everettpenne/WHAM-CONTROLLERS/firmware/hbridge/docs/command_reference.md

# WHAM-HBRIDGE-PFMG474 — Serial Command Reference

USART2, **115200 8N1** (raised from 9600 on 2026-09-04 — see `docs/changelog.txt`; WHAM-HBRIDGE-PFMG474-only, the sibling PFM-STM32G474 project still uses 9600). Commands are terminated by `\r`, `\n`, or `\r\n`.

## Protocol conventions

Replies (`OK` / `OK <values>` / `ERR <n> <msg>`), the error codes, mnemonic matching (short and long forms, `?`
queries) and the strict argument rules are common to both controllers and are described once, in
[`docs/scpi_conventions.md`](scpi_conventions.md). Codes are never renumbered or reused. Each command's own
section below says which errors it can return and how many decimals its numbers have.

### Unsolicited `!BOOT` banner (every boot)

Added 2026-09-29 (ported from WHAM-XREX-PFMG474). Sent once per boot,
after all initialization and right before the main loop — the exact
signal that a reset (including `FWUPdate:SWAP`/`ROLLback`) has completed
and the command link is live. `!BOOT` never collides with a reply
(`OK`/`ERR`). Three lines:

```
!BOOT WHAM-HBRIDGE-PFMG474 v0.7 2c272540 BANK=1 BFB2=0 STATE=IDLE tick=0
!BOOT diag boot=1 prev: stage=0 fault=0@0 cfsr=00000000 hfsr=00000000 err=0@0 nmi=0@0 eccr=00000000 rst=
!BOOT Rise and shine, controller's awake and ready to work 🌞
```

- Line 1: board, firmware version, git commit (`-dirty` if built from an
  uncommitted tree), the running flash bank, the `BFB2` option bit, the
  operating state (`IDLE`, or `FAULT` if a fault was already present at
  boot), and
  `HAL_GetTick()` at that point.
- Line 2 (`src/drivers/boot_diag.h`, `.noinit` RAM — survives every reset
  but not a power cycle): `boot` counts boots that reached `main()`
  since power-up. Everything after `prev:` describes the PREVIOUS boot:
  the last stage it reached (`1` main, `2` HAL init, `3` clock, `4`
  GPIO, `5` HRTIM, `6` USART2, `7` app init, `8` main loop, `9` about to
  reload option bytes for a swap), and whether it ended in
  `HardFault_Handler` (`fault=count@stage`, with `CFSR`/`HFSR`),
  `Error_Handler` (`err=`) or `NMI_Handler` (`nmi=`, with `FLASH->ECCR`
  — a flash ECC double error raises an NMI). `rst=` lists the reset
  sources since the previous boot (`OBL` option-byte reload, `PIN`
  NRST, `BOR` brown-out/power-on, `SFT` software, `IWDG`/`WWDG`,
  `LPWR`); a normal `FWUPdate:SWAP` reports `OBL,PIN,`.
- Line 3: a friendly greeting. The emoji is sent as raw UTF-8 bytes.

The first line can arrive with a garbage byte in front of it: the reset
itself glitches the TX line. `python/fw_update.py` allows for this.

## Mnemonic syntax

See [`docs/scpi_conventions.md`](scpi_conventions.md) ("Mnemonic matching"); the parser itself is
`src/middleware/scpi/scpi_parser.c`.

## Commands

### `*IDN?`

Board and firmware identification.

```
> *IDN?
< OK WHAM-HBRIDGE-PFMG474 REVA v0.7 2c272540
  (or, built from an uncommitted working tree:)
< OK WHAM-HBRIDGE-PFMG474 REVA v0.7 2c272540-dirty
```

Since 2026-10-07 the reply ends with two more fields that say which
PHYSICAL board answered: `SN=<serial>` (`SN=UNSET` until a serial is
provisioned) and `UID=<24 hex>` (the MCU's factory-programmed 96-bit unique
ID, different on every board). Hosts that read the earlier fields by
position are unaffected. The same two fields end the `!BOOT` banner. Full
identity: `SYS:ID?` below; design: `docs/device_identity_and_host_service.md`
at the top of the repository.

```
< OK WHAM-HBRIDGE-PFMG474 REVA v0.9 ad9a18ba-dirty SN=UNSET UID=0055002B4232500220343558
```

Reports, space-separated: `HW_BOARD_NAME`, `HW_BOARD_REV`,
`FW_VERSION_STRING` (compile-time constants, `src/config/ctrlr_config.h`),
then `FW_GIT_COMMIT` (added 2026-09-29, ported from WHAM-XREX-PFMG474) —
the short git commit hash this exact build was made from, with a `-dirty`
suffix if the working tree had uncommitted changes, or `unknown` if
`build/generated/git_version.h` was never generated. This answers "which
commit is actually running on this board" independently of what you think
you last flashed. Before 2026-09-29 the reply had only the first three
fields.

`HW_BOARD_REV` is currently a placeholder (`REVA`); update it to match
the actual PCB silkscreen revision.

**Build with `python3 python/wham_build.py`** (not a bare `make`) to get
an accurate `FW_GIT_COMMIT`: it regenerates `build/generated/git_version.h`
first. `git_version.h` is gitignored, so a fresh checkout has none until
`wham_build.py` (or `gen_git_version.py`) runs once.

### `SYS:ID?`

Which physical board this is, as `key=value` fields on one line (added
2026-10-07, identical in both products).

```
> SYS:ID?
< OK serial=WB-0001-8 uid=0055002B4232500220343558 flashuid=E4653C34CB172E22 product=WHAM-HBRIDGE-PFMG474 hw=REVA fw=v0.9 commit=e34e12ad label=bench.sim verified=1 identity=ok
```

- `serial`: the board's serial number; `UNSET` until one is provisioned (`SYS:SERial`).
- `uid`: the MCU's factory unique ID (24 hex). `flashuid`: the W25Q128's factory unique ID (16 hex), read once and kept;
  `0000000000000000` if the chip did not answer. Both are read-only and need no provisioning.
- `product`, `hw`, `fw`, `commit`: the same values as `*IDN?`.
- `label`: the optional label (`-` = none). `verified`: 1 when the stored serial was written for THIS MCU and THIS flash
  chip; 0 for a board with no serial, or one whose flash chip was moved from another board or whose image was copied.
- `identity`: `unset` (nothing provisioned), `ok`, `corrupt` (something stored, no copy passes its checks: provision
  again), `nochip` (the flash chip did not answer).
- Parse by key, not by position: new keys will be added at the end.
- Reported only; nothing in the controller depends on it.

### `SYS:SERial <sn>` / `SYS:SERial?`

Writes the board's serial number ONCE into the identity region of the external flash and binds it to this MCU and
this flash chip; the query returns it (`OK UNSET` before). `<sn>` is 3-16 characters of `A-Z 0-9 -`, whole token.
Normally done by `host/provision_board.py` (see the repository's `docs/device_identity_and_host_service.md`), which
picks `WB-NNNN-C` serials with a check digit and keeps the registry; the firmware checks only the format.

| Reply | When |
|---|---|
| `OK` | written and read back |
| `ERR 12 serial must be 3-16 characters ...` / `... needs one argument` | bad format, missing or extra argument |
| `ERR 13 identity can be changed only while IDLE` | the write stalls the command link for tens of ms, as `*SAV` does |
| `ERR 19 a serial is already provisioned (SYS:ID:CLEar CONFIRM first)` | one exists: it is never overwritten |
| `ERR 7 ...` | the flash write failed or the chip's unique ID could not be read (the previous record is intact) |

The record is two alternating copies in two reserved sectors (`0xFFD000`, `0xFFE000`), each CRC-protected: a power
cut during a write leaves the previous record. Firmware updates, `*SAV`/`*RCL`, `CONFig:PROFile:CLEar` and
`QSPI:SELFtest` never touch it, and the flash driver refuses any other write to those sectors.

### `SYS:LABel <text>` / `SYS:LABel?`

An optional label, 1-32 characters of `A-Z a-z 0-9 . _ -` (no spaces, so `SYS:ID?` stays parseable); `-` clears it.
Needs a serial first (`ERR 19` otherwise); IDLE only (`ERR 13`). The query returns the label or `-`.

### `SYS:ID:CLEar CONFIRM`

Erases the stored identity (both copies): the board is `UNSET` again and can be provisioned. The word `CONFIRM` is
required (`ERR 12` without it); IDLE only. The registry keeps the board's serial, so provisioning it again with
`host/provision_board.py` restores the same one.

### `BOOT`

Resets the MCU into the STM32 ROM serial bootloader (System memory), so
a new `.bin` can be written over the same USART2 link with no physical
BOOT0/NRST access. See `docs/serial_reflash_guide.md` for the full
mechanism and usage via `python/wham_serial_flash.py`.

```
> BOOT
< OK ENTERING BOOTLOADER
  (link drops — MCU has reset into the ROM bootloader)
```

Present only when `BOOT_JUMP_FEATURE_ENABLED` (`Core/Inc/boot_jump.h`)
is nonzero (the default). When disabled, `BOOT` is simply unrecognized
(`ERR 1 Unknown command`), like any other unknown mnemonic — see that
header for exactly what disabling the module does.

Refused with `ERR 13` while `ARMED` or `FIRING` (resetting under load would
drop the outputs uncontrolled); allowed in `IDLE` and `FAULT`.

### `SHOT:BEGin`, `SHOT:STEP`, `SHOT:END`, `SHOT:CLEar`, `SHOT?`, `SHOT:POINt?`

A shot is a **time series of setpoints**. The operator uploads, for each
setpoint, a time, a carrier frequency and a duty; the firmware ramps
frequency and duty **linearly in time** between setpoints, one switching
period at a time. Open-loop shots run from about 10 ms to 1 s.

```
> CONFig:MODE HVPS
< OK
> SHOT:BEGin
< OK
> SHOT:STEP 0 20000 40          t_us  freq_hz  duty_pct  -- always t = 0 first
< OK
> SHOT:STEP 10000 15000 60      at 10 ms: 15 kHz, 60 %
< OK
> SHOT:END
< OK 2 10000                    setpoints, shot length in microseconds
> ARM
< OK
> FIRE
< OK
```

- **One duty per phase** (2026-10-13): a setpoint may give each phase its own duty,
  `SHOT:STEP <t_us> <freq_hz> <duty_U> <duty_V> <duty_W>`. The time and the carrier frequency stay shared (the
  three phases are locked to one master timer); each phase's duty ramps linearly to its own next value and is checked
  against the mode's duty limits on its own (`ERR 10 duty of phase V is above ...`). The three-value form gives every
  phase that duty, exactly as before, and a shot made only of those plays exactly as before (the same per-period
  numbers; checked by the tests). Forms can be mixed from one setpoint to the next. `SHOT:POINt? <i>` answers
  `OK <t_us> <freq_hz> <duty>` when all phases have the same duty at that setpoint, else
  `OK <t_us> <freq_hz> <duty_U> <duty_V> <duty_W>`.
- **Units on the wire:** time is an integer number of microseconds; frequency
  is in Hz with up to 3 decimals (`20000.5`); duty is in percent with up to 2
  decimals (`47.25`).
- **Rules:** the **first setpoint must be at t = 0** (the shot starts at the
  first slot's frequency and duty); times strictly increase; the last
  setpoint's time is the end of the shot and may be at most
  `SHOT_MAX_DURATION_US` (1 s); at least two setpoints are needed
  (`SHOT:END` refuses otherwise); at most `SHOT_SETPOINT_MAX` (500).
- **Limits are checked at upload, per setpoint**, against the selected supply
  mode (`CONFig:LIMits?`): `ERR 10` for a frequency or duty (of any phase) outside the mode,
  `ERR 4` for an ordering/format error or a time beyond the longest shot,
  `ERR 3` when full, `ERR 13` with no supply mode or while `FIRING`. A straight
  line between two setpoints inside the limits stays inside them; the
  generator additionally clamps every period onto the mode's exact limits
  (so a `75000 Hz` setpoint, which is not exactly representable, plays as the
  nearest legal period).
- **The shot ends at the first period that starts at or after the last
  setpoint's time** (so it overshoots by less than one period), and the last
  setpoint's own values are approached, not held.
- `SHOT:BEGin` discards the previous shot; `SHOT:CLEar` drops it; a supply
  mode change drops it. None of them work while `FIRING`.
- `SHOT?` — `OK <setpoints> <duration_us> <PROFILE|TABLE>`: the last field is
  which source `FIRE` will play (the last upload that finished). `SHOT:POINt?
  <i>` — `OK <t_us> <freq_hz> <duty_pct>` for setpoint *i* (from 0).
- **How it plays:** a generator (`shot_profile.c`) turns the setpoints into
  one `{per, cmp}` entry per period and keeps a **ring table** of
  `PFM_TABLE_SIZE` entries (100 by default) full: the whole ring is filled
  inside `FIRE` before the first period, the per-period interrupt plays it, and
  a software-triggered, lower-priority interrupt refills it as it drains. So a
  shot can be far longer than the table. If the refill ever falls behind (the
  ring runs empty before the shot is over) the shot is **stopped and latched as
  a fault** (`STATE?` → `FAULT GENERAL`, `FAULT:SOURces?` → `TABLE=1`, cleared
  by `FAULT:CLEAR`) rather than holding a stale step.
- **What the CPU can sustain** (simulator, project built at `-O2`): the refill
  gets only what the per-period interrupt leaves. With 100 entries, every shot
  tried completes: 1 s shots in both modes (up to 125,000 periods), all Limiter
  shots from 75 to 125 kHz including duty and frequency ramps, and a 50 ms
  duty triangle 5 - 95 - 5 % at 125 kHz. The one case that still empties a
  100-entry ring is a step applied every period at 125 kHz (duty 5 to 95 % in
  10 ms), which needs ~1,300 entries (a whole 10 ms shot at 125 kHz).
- **Compile-time sizes** (`ctrlr_config.h`, rebuild the `.bin` to change, with
  the measurements behind them): `SHOT_SETPOINT_MAX` (500, 12 bytes each),
  `SHOT_MAX_DURATION_US` (1 s), `PFM_TABLE_SIZE` (100, 8 bytes each).
- **`PFM:DIAG?`** (diagnostic, last shot) — `OK <periods played> <max gap cycles>
  <max gap us> <busiest interrupt cycles> <total interrupt cycles> <fewest ring entries
  ready> <refills> <entries generated> <refill wall cycles> <longest refill wall
  cycles> <ring fill cycles>`. The "fewest ready" is counted only while the generator
  is still running (4294967295 if it never was: the whole shot fit in the ring); 0
  would be an underrun. Cycles are 170 MHz CPU cycles.
- The host tool `python/pfm_shot_test.py` has an exact Python port of the
  generator (`generate_profile()`), held to the C code by both test suites.

### `TABLE:BEGIN`, `TABLE:STEP`, `TABLE:END`, `TABLE?` (bench use)

The per-period table, entered one entry at a time. Since 2026-10-01 it holds
at most `PFM_TABLE_SIZE` entries and plays once, with no refill: it is
the engine's input format kept for bench work, and `SHOT:*` above is how a
shot is normally defined. The last upload to finish (`SHOT:END` or
`TABLE:END`) is what `FIRE` plays.

Uploads a complete PFM shot profile (a sequence of `(per, cmp0, ...,
cmp(N-1))` steps, N = `HRTIM_NUM_CHANNELS` — see `Core/Inc/pfm.h`'s
`PFM_Step_t` and `Core/Inc/ctrlr_config.h`), built entirely
off-controller. This firmware has no on-device table *construction*
logic (no frequency/duty math, no sweep builder) — see `pfm.h`'s
"ADDED" header note for why that's a deliberate project decision, not
a gap waiting to be filled in here. `python/pfm_table_upload.py` is
the reference host-side builder — it queries `CONFig:CHANnels?` itself
before uploading, rather than assuming N.

```
> TABLE:BEGIN
< OK
> TABLE:STEP 1699 850 850 850
< OK
> TABLE:STEP 1699 850 850 850
< OK
  ... (repeat for every entry -- example above is N=3) ...
> TABLE:END
< OK 500
```

- **`TABLE:BEGIN`** — clears the table (`PFM_TableReset()`) and opens
  an upload session. Safe to call again mid-upload to start over.
  Needs a supply mode (`ERR 13` until `CONFig:MODE` has been sent).
- **`TABLE:STEP <per> <cmp0> ... <cmp(N-1)>`** — appends exactly one
  entry: `per` plus exactly one compare value per channel (N =
  `HRTIM_NUM_CHANNELS`, a compile-time constant — query
  `CONFig:CHANnels?` rather than assuming it). All values are
  `uint16_t` (0-65535). Each step is checked against the selected supply
  mode (see "Supply mode" below): the carrier `170 MHz / (per + 1)` and
  every channel's duty `cmp / per` must be inside the mode's range, else
  `ERR 10` with a message naming the limit. (The apply-time
  `HRTIM1_ClampCompare()` in `hrtim.c` remains a backstop.) Rejects with `ERR 2` if no
  `TABLE:BEGIN` is open, `ERR 3` if the table is already at
  `PFM_TABLE_SIZE` (5000) capacity, `ERR 4` for a malformed line
  (including the wrong token count for this board's N).
- **`TABLE:END`** — closes the upload session and reports the final
  entry count (`OK <count>`). Table stays exactly as uploaded even if
  you never send this — it just stops enforcing "must call
  `TABLE:BEGIN` first" for a stray `TABLE:STEP`.
- **`TABLE?`** — reports the current entry count at any time
  (`OK <count>`), upload session open or not.

### Supply mode: `CONFig:MODE`, `CONFig:MODE?`, `CONFig:LIMits?`

Added 2026-09-29 (`src/app/control/supply_mode.h`). The same firmware drives
two supplies, and the operator selects which with `CONFig:MODE`:

| Mode | Drive | Carrier | Duty (per channel) |
|---|---|---|---|
| `LIMITER` (`LIM`) | PWM | 75–125 kHz (`per` 1359–2265) | 5–95 % |
| `HVPS` | PFM | 10–30 kHz (`per` 5666–16999) | 40–60 % |

The values are the older PFM-STM32G474 project's bounds
(`ctrlr_config.h`). The modes only narrow the hardware envelope (16-bit
period, compare clamp, 100 ns dead time). The boundary is exact: a step
exactly on a limit is accepted, one `per` count outside is refused.

```
> CONFig:MODE?
< OK NONE
> TABLE:BEGIN
< ERR 13 No supply mode selected -- send CONFig:MODE LIMiter|HVPS first
> CONFig:MODE HVPS
< OK
> CONFig:LIMits?
< OK HVPS FREQ 10000 30000 DUTY 40 60
> TABLE:STEP 1699 850 850 850
< ERR 10 per 1699 is above the HVPS range (10000-30000 Hz)
```

- **Boot state is `NONE`**: no table can be uploaded until a mode is
  selected, so a table built for one supply is never accepted for the other
  by default. (Saved profiles will restore it in a later phase.)
- **`CONFig:MODE`** is only accepted in `IDLE` (`ERR 13` otherwise). A mode
  *change* discards the uploaded table (`TABLE?` reads 0), so a table never
  outlives the limits it was checked against; re-selecting the current mode
  changes nothing.
- **`CONFig:LIMits?`** — `OK <mode> FREQ <min> <max> DUTY <min> <max>` (Hz,
  percent), or `OK NONE`.
- Duty is compare / period, the same relation `python/pfm_table_upload.py`
  uses. `pfm_table_upload.py --mode LIMITER|HVPS` selects the mode first.
- **Verification caveat:** the HRTIM SET/RESET-collision fix was confirmed on
  a logic analyzer only up to 100 kHz. `LIMITER` allows up to 125 kHz;
  100–125 kHz has not been scoped on real hardware.

### `FIRE`

Starts playback of the shot (`SHOT:*`, or a `TABLE:*` table if that was
uploaded last) from its start. Playback advances automatically, one entry per
PWM period, driven by the HRTIM1 master-repetition interrupt
(`PFM_CycleBoundaryHandler()` in `pfm.c`), and stops on its own, at a
coherent period boundary, at the end of the shot. `ERR 5` when nothing has
been uploaded.

**A rising edge on PF15 starts the same shot** (`EXTernal:TRIGger`, below): both go through one routine, `ShotStart_Run()`, so the checks and the start
are identical (since 2026-10-20).

**Needs `ARMED`** (gated 2026-09-29; before that `FIRE` took effect
immediately in any state). `FIRE` moves the state to `FIRING`; when the
table ends the state returns to `IDLE`, so every shot needs its own `ARM`.
See "Operating state" below.

```
> ARM
< OK
> FIRE
< OK
> STATE?
< OK FIRING
  ... plays back every uploaded (per, cmp0, ..., cmp(N-1)) entry ...
> STATE?
< OK IDLE
```

Checked in this order: `ERR 6` a fault is latched, `ERR 13` not `ARMED`,
`ERR 5` the table is empty. There is no `STOP` command; a shot ends at the
end of the table, or at once on any fault (including `GENERAL:TEST:FAULT`).
The table can't be changed while `FIRING` (`TABLE:BEGIN`/`STEP` give
`ERR 13`).

### External shot trigger: `EXTernal:TRIGger`, `EXTernal:TRIGger?`, `EXTernal:TRIGger:INPut?`, `EXTernal:TRIGger:STATus?`

Added 2026-10-20 (source: `src/app/control/shot_trigger.c`, `shot_start.c`; same command names and meaning as XREX's). A **rising edge on PF15**
(`Fiber_Enable` in `docs/pin_mapping_v4.csv`) **while the controller is `ARMED`** starts the shot exactly as `FIRE` would: the same checks and the same
start (`ShotStart_Run()`, which `FIRE` now also uses), open or closed loop alike. **On at every boot** (`SHOT_TRIGGER_DEFAULT_ENABLED`, `ctrlr_config.h`);
`EXTernal:TRIGger 0` turns it off for a session. It is not stored in saved profiles.

**It is handled by interrupts, not by polling.** PF15 is a digital input with a pull-down (an unwired or floating pin reads LOW) and an interrupt on the **rising
edge only** (EXTI line 15, `board_io.c`). The edge interrupt (priority 1, the fault tier) does a few instructions: it counts the edge, ignores it unless the trigger
is enabled, the state is `ARMED` and the pin **still reads HIGH** (a glitch shorter than the interrupt latency is rejected), and pends a software interrupt (the
unused CORDIC's vector, priority 2). That one starts the shot. The start is not done in the edge interrupt itself because it takes a few hundred microseconds (it
fills the ring of period entries and starts the HRTIM) and the EXTI vector is shared with the gate-driver fault inputs at the priority of the per-period interrupt;
at priority 2 a fault stop and the first period of the shot can both preempt it.

```
> EXTernal:TRIGger?
< OK 1
> EXTernal:TRIGger:INPut?
< OK 0                              the raw level of PF15 right now (whether or not the trigger is on)
> ARM
< OK
  ... PF15 rises ...
> STATE?
< OK FIRING                         the shot is running; it ends by itself as after FIRE
> EXTernal:TRIGger:STATus?
< OK enabled=1 input=1 edges=1 started=1 ignored_disabled=0 ignored_state=0 ignored_glitch=0 refused=0 busy=0 last=STARTED
```

- **`EXTernal:TRIGger <0|1>`** -- `OK`; `ERR 12` for anything but `0` or `1`.
- **`EXTernal:TRIGger?`** -- `OK <0|1>`.
- **`EXTernal:TRIGger:INPut?`** -- `OK <0|1>`: the raw level of PF15.
- **`EXTernal:TRIGger:STATus?`** -- `key=value` fields (parse by key): `enabled`, `input`, and counters since boot: `edges` (rising edges seen), `started` (shots
  started by an edge), `ignored_disabled`, `ignored_state` (not `ARMED`: idle, a shot running, faulted), `ignored_glitch` (the pin was LOW again), `refused` (an
  edge tried to start a shot and was refused) of which `busy`; and `last`, the result of the latest attempt: `NONE` (never tried), `STARTED`, `FAULT`, `NOT_ARMED`,
  `NO_SHOT`, `CONTROL:<n>` (a closed-loop refusal, `n` the control-runtime result code), `BUSY`, `CHANGED`. This is the only record of *why* a trigger did not start a
  shot, because nobody is waiting for a reply.

**Rules.**
- **Edge-triggered.** A level already HIGH when `ARM` is sent produces no edge and starts nothing. After a **refused** start (nothing uploaded, a latched fault, a
  closed-loop refusal) the controller stays `ARMED` and a **new** rising edge is needed; the level staying HIGH is not one.
- **Only from `ARMED`.** An edge in `IDLE`, `FIRING` or `FAULT` is counted and ignored.
- **A `FIRE` and a trigger cannot start two shots.** A claim taken with interrupts masked lets only one start run; an edge that arrives while a `FIRE` command is
  being processed is refused as `BUSY` (the `FIRE` is already starting the shot).
- **Everything else is `FIRE`'s:** a latched fault, `ARM` first, a shot (or closed-loop target) uploaded, a usable supply mode; and the shot, and the state going back
  to `IDLE` at its end, are the same.
- **No interlock input.** Unlike XREX there is no external-*enable* input (PF13) in this firmware: the trigger is the only external input.
- **Not yet verified with a real signal** (see `docs/changelog.txt`, 2026-10-20).

### The CHARGE output: `CHARGE:FREQuency`, `CHARGE:FREQuency?`, `CHARGE:STATus?`

One **50 % square wave on PG0** (`GPOut_01` on the board), made by its own timer (TIM20), with **no relation to the HRTIM phase outputs**. It drives a
frequency-to-voltage converter that charges a capacitor bank: the operator turns it on, leaves it running, and turns it off.

```
> CHARGE:FREQuency 100000
< OK
> CHARGE:FREQuency?
< OK 100000
> CHARGE:STATus?
< OK freq=100000 running=1 actual=100000.000 psc=0 arr=1699 ccr=850
> CHARGE:FREQuency 0
< OK
```

- **`CHARGE:FREQuency <hz>`** -- whole hertz: **`0` = off**, otherwise `1` to `100000`. Anything else (a fraction, text, a negative number, more than 100 kHz, a missing or extra
  argument) is `ERR 12` and changes nothing. A new frequency while it runs takes effect at once (the cycle restarts: one short or long cycle at the change).
- **`CHARGE:FREQuency?`** -- `OK <hz>`: the setpoint, `0` when off.
- **`CHARGE:STATus?`** -- `key=value` fields (parse by key): `freq` (the setpoint), `running` (`1` while the pin is driven by the timer), `actual` (the frequency the timer really
  produces, in Hz with three decimals: the timer divides its 170 MHz clock into whole counts, so it is within about 0.03 % of the setpoint at 100 kHz and better below), and the timer
  settings `psc`, `arr`, `ccr` (`0` when off).

**Rules.**
- **Any state.** It can be switched on and off in `IDLE`, `ARMED`, `FIRING` and `FAULT`. Nothing here looks at the state machine. (The operator is expected not to turn it on during `FIRING`;
  nothing prevents it.)
- **A latched fault does not turn it off.** Neither do `DISARM`, a shot ending, `FAULT:CLEar` or a general or protection trip. If it must stop, send `CHARGE:FREQuency 0`.
- **Off at every boot, and not stored in profiles** (`*SAV`/`*RCL`). Anything that resets the controller turns it off: power, the emergency-stop fibre (which resets the chip), `BOOT`, a firmware swap.
- **Off is a driven LOW pin**, not a floating one. Until the firmware starts after a reset the pin floats, so the converter's input needs a pull-down.
- **Dangerous to the hub** (it charges the bank): a nonzero frequency is announced to everyone and logged; `CHARGE:FREQuency 0` is not.
- Not yet verified on the board's pin with a scope or logic analyser (see `docs/changelog.txt`, 2026-10-27).

### Operating state: `ARM`, `DISARM`, `STATE?`, `GENERAL:TEST:FAULT`, `DEBUG:FAULT:BYPASS`

Added 2026-09-29 (`src/app/control/state_machine.h`, mirroring
WHAM-XREX-PFMG474's state machine).

```
IDLE  --ARM-->  ARMED  --FIRE-->  FIRING  --table ends-->  IDLE
  ^               |
  +----DISARM-----+
any state --fault--> FAULT --FAULT:CLEAR (inputs healthy)--> IDLE
```

| Command | Reply |
|---|---|
| `ARM` | `OK`; `ERR 6` if a fault is latched, `ERR 13` if not `IDLE`. Nothing electrical happens on `ARM` |
| `DISARM` | `OK` (`ARMED` -> `IDLE`; a harmless no-op in any other state) |
| `STATE?` | `OK IDLE`, `OK ARMED`, `OK FIRING` or `OK FAULT GENERAL` |
| `GENERAL:TEST:FAULT` | `OK`; enters `FAULT` exactly as a real fault would (output force-stopped). A bench test of the fault path; it can only stop output. Cleared by `FAULT:CLEAR` |

| `DEBUG:FAULT:BYPASS <0\|1>` | `OK`; `ERR 12` if the argument is missing or not `0`/`1`. Bench-only, see below |
| `DEBUG:FAULT:BYPASS?` | `OK 0` or `OK 1` |

**`DEBUG:FAULT:BYPASS`** (added 2026-11-09, the XREX command of the same name, narrower) lets the controller be driven with
nothing wired to its fault inputs: a bench board's floating GateDriverStatus pins read as an instant fault. While it is `1`:

- PC10/HRTIM1_FLT6 and the 12 GateDriverStatus inputs no longer put the controller in `FAULT`, refuse `ARM`/`FIRE`/`SOURce:RUN`/the
  PF15 trigger (`ERR 6`), or stop the output (a bad GateDriverStatus pin no longer force-stops from its interrupt);
- `FAULT:CLEAR` succeeds even if those inputs still read bad;
- `GENERAL:TEST:FAULT` does nothing.

Not bypassed, deliberately: the HRTIM's own PC10 gating of the outputs (silicon, independent of the firmware), and the faults the
controller finds in itself -- the closed-loop `OVERVOLTAGE` and `FEEDBACK` faults and a table underrun -- because the closed-loop
run has already been torn down when those are reported, so ignoring them would leave the output running uncontrolled. `FAULT?` and
`FAULT:SOURces?` keep reporting the true state of every source, so `FAULT? = 1` with `STATE? = IDLE` is normal under bypass. It is
`0` at every boot, never saved in a profile, and turning it off re-scans the GateDriverStatus pins at once. **Never enable it where a
real fault condition is physically possible.** (XREX returns `ERR 11` for a value that is not 0/1; here it is `ERR 12`, this
product's convention for a bad flag.)

**One fault type.** Every fault source — PC10/HRTIM1_FLT6, any of the 12
GateDriverStatus inputs, and `GENERAL:TEST:FAULT` — puts the controller in
`FAULT GENERAL`, from any state. The response is an immediate force-stop of
the output (no ramp-down). The output is already safe before the state
changes (PC10 gates the HRTIM in hardware; a GateDriverStatus edge
force-stops from its interrupt); the state machine keeps it latched until
`FAULT:CLEAR`. `FAULT:CLEAR` re-checks both inputs and returns to `IDLE`
only if both are healthy — never straight back to `ARMED`. A fault already
present at boot shows in the `!BOOT` banner as `STATE=FAULT`.

### `FAULT?`, `FAULT:CLEAR`, `FAULT:SOURces?`

`FAULT:SOURces?` — `OK PC10=<0|1> GATEDRV=<0|1> TABLE=<0|1> TEST=<0|1>`: which
sources hold a fault latched behind the single `FAULT GENERAL` state. `TABLE`
is the per-period table running empty before the shot was over (see `SHOT:*`).

Status/clear for **two independent fault sources**, combined into one
answer here (`cmd_common.c`'s `AnyFaultLatched()`, plus the `FAULT` state) — from an operator's
perspective, "is there a fault, and can I `FIRE`" is one question, not
two, even though the two mechanisms underneath stay structurally
separate:

1. **PC10/HRTIM1_FLT6** — a real HRTIM1 hardware fault input
   (`Core/Inc/hrtim.h`), active-low. The peripheral forces every
   fault-enabled channel's outputs to a safe (inactive) level
   autonomously, in silicon, the instant the pin trips — no CPU,
   interrupt, or polling latency, and it keeps working even if the CPU
   is hung.
2. **GateDriverStatus_01..12 EXTI interrupt** (`PE0`-`PE11`,
   `Core/Inc/gate_driver.h`) — software/interrupt-driven. Re-reads all
   12 pins on any edge and evaluates them against the compile-time
   `GDS_FAULT_POLARITY` (`Core/Inc/ctrlr_config.h`); on a fault, forces
   HRTIM output off and latches. Needs the EXTI ISR to actually run,
   unlike PC10's autonomous hardware path — a boot-time explicit check
   (`main.c`) covers the one gap that leaves (a pin already faulted
   before the interrupt is even armed produces no edge of its own).

```
> FAULT?
< OK 0
> ARM
< OK
> FIRE
< OK
   ... (a fault trips mid-shot; outputs go safe immediately) ...
> STATE?
< OK FAULT GENERAL
> FAULT?
< OK 1
> FIRE
< ERR 6 Fault latched -- send FAULT:CLEAR first
> FAULT:CLEAR
< OK
> STATE?
< OK IDLE
```

- **`FAULT?`** — `OK 0` (healthy) or `OK 1` (in `FAULT`, or either source latched).
- **`FAULT:CLEAR`** — clears both latches (clearing a source that was
  never tripped is a harmless no-op) and returns the state to `IDLE` if
  both are healthy; the reply is `OK` either way, so check `STATE?`.
  Does **not** itself reconnect/restart outputs — that needs `ARM` and
  `FIRE`. For the GateDriverStatus source specifically, clearing
  immediately re-validates by re-checking all 12 pins: if any pin is
  still in its fault state, `FAULT:CLEAR` re-latches before its own
  `OK` reply even goes out, rather than reporting success while the
  physical condition persists — confirmed on real hardware (see
  `docs/changelog.txt`, 2026-09-08).
- Latched-until-cleared by design, both sources — a fault silently
  clearing itself, with output resuming unnoticed, is the hazard this
  avoids.
- **Verified on real hardware, end to end**: a genuine GateDriverStatus
  fault (GateDriverStatus_03/PE2, present at boot) was correctly
  caught by the boot-time check, correctly blocked `FIRE` with `ERR 6`,
  and correctly re-latched on `FAULT:CLEAR` while still physically
  present — the full sequence above, not just the command-layer shape
  of it. The PC10/HRTIM1_FLT6 path is verified idle-safe (doesn't
  spuriously trip) and does not yet have its own real low-drive bench
  trip confirmed on scope/DSLogic — see `docs/changelog.txt` for what
  specifically remains open there.

### `CONFig:CHANnels?`

Reports `HRTIM_NUM_CHANNELS` (`Core/Inc/ctrlr_config.h`) — the
compile-time HRTIM channel count this specific firmware build was
configured for (1-5; see that file for why not 6). Added 2026-09-08
alongside the channel-count generalization specifically so host
tooling can confirm what a board actually is instead of assuming a
value that could silently drift after a rebuild with a different
channel count.

```
> CONFIG:CHANNELS?
< OK 3
```

Not modifiable at runtime — there is no corresponding `SET` command,
by design. Changing it means editing `ctrlr_config.h`, rebuilding, and
reflashing.

### `DAC:OUTPut`, `DAC:OUTPut?` — the two analog outputs

PA4 (`AnalogOut_01`, DAC1 channel 1) and PA5 (`AnalogOut_02`, DAC1 channel 2) are
12-bit DAC outputs with the DAC's output buffer on. Both are enabled at boot at
0 V and are independent of the operating state, faults and `FIRE`.

```
> DAC:OUTPut 1 1.65          channel 1 (PA4) to 1.65 V
< OK
> DAC:OUTPut? 1
< OK 1.650 2048 2048         volts, code commanded, code in the DAC's output register
> DAC:OUTPut 2 3.301
< ERR 12 voltage must be 0 to 3.300 V
```

- Voltage in volts, up to 3 decimals; channel 1 or 2. The value is rounded to the
  nearest of 4096 steps (0.8 mV at 3.3 V).
- Full scale is `ANALOG_VREF_MV` (`ctrlr_config.h`; 2.900 V in the current build, earlier builds 2.500 V): the voltage the
  internal reference buffer puts on VREF+ (see "Analog reference" below). The
  default range is therefore 0 to `ANALOG_VREF_MV` (2.900 V now), not 3.3 V.
- The last field of the query is read back from the DAC hardware; it equals the
  commanded code once the DAC has taken the value.

### `ADC:INPut?`, `ADC:VREF?` — the four analog inputs

`AnalogIn_01` to `AnalogIn_04` are PA0, PA1, PC0 and PB0 (ADC1 channels 1, 2, 6,
15). 12 bits, single-ended, each reading the average of 16 conversions with a
5.8 us sampling time per conversion (about 100 us in all, blocking the main loop
briefly; shots are unaffected). Full scale is `ANALOG_VREF_MV`.

```
> ADC:INPut? 1
< OK 1.234 2021                 volts, 12-bit code
> ADC:VREF?
< OK 2.505 1990 1662            measured VREF+ in volts, VREFINT code, factory code
```

- `ADC:INPut? <1-4>` — a pin with nothing connected reads near 0 V here.
- `ADC:VREF?` — measures the real voltage on VREF+ from the internal bandgap
  (about 1.21 V) and the chip's own factory calibration (the code recorded with
  VREF+ = 3.0 V): VREF+ = 3.0 V x factory code / measured code. It needs no pin, so it
  checks the whole ADC path, and it is how `ANALOG_VREF_MV` is verified. Measured on
  the simulator: 2.505 V against the 2.500 V configured (+0.2 %, within the bandgap's
  tolerance), repeatable to 2 mV.

**Analog reference.** This board has no external reference: pin 43 is "VREF+
Capacitor" (`docs/pin_mapping_v4.csv`), so the chip's internal reference buffer
(`vref.c`) drives VREF+ at start-up, at `ANALOG_VREF_MV` (2048, 2500 or 2900). Left
off, as it is at reset, VREF+ sits near 0 V: every ADC conversion reads 4095 and the
DAC outputs are scaled to nothing. This reference is the full scale of both the ADC
inputs and the DAC outputs.

### Closed loop: `PID:*`, `SOURce:*`, `TARGet:*`, `LOG:*`, `CONFig:FEEDback:*`, `CONFig:CLOSEDloop:*`, `SIM:PLANT:*`

The controller can hold the supply's output voltage to a time-series **target** by
reading it back over an ADC input and adjusting the output (HVPS: frequency, duty
fixed; Limiter: duty, carrier fixed). The command layout follows the XREX controller's.
All voltages are in the loop's own units ("process volts"): the target, the measurement
and `CONFig:MAXVolts` are the same unit, set by the feedback calibration below (ADC volts
by default, real supply volts once `CONFig:FEEDback:RANGE` or `SCALE`/`OFFSet` is set).

**Three loops, one per phase** (2026-10-13). The loop number `<ch>` is the phase: **1 = U, 2 = V, 3 = W**;
`0` means all three where a command takes it. Each loop has its own mode (open or closed), gains, feedback
input and calibration, hold setpoint and target series. Their feedback inputs default to **U on PA0, V on PA1,
W on PB0** (`CONFig:FEEDback:CHANnel`). The shared settings (rate, limits, plant parameters, filter, clip time,
slew) are set once for all. The HVPS has ONE loop, loop 1: its actuator, the frequency, is shared by every
phase, so loops 2 and 3 apply to the Limiter only (their settings are kept, and ignored in HVPS mode).

**Running it.** `CONFig:MODE`, then `PID:LOOPMODE <ch> 1` for each phase to close, then a target
(`TARGet:*`), then `ARM` and `FIRE` (or `SOURce:RUN`, which runs a constant `SOURce:SETpoint` per loop
instead of a profile). A phase whose loop is open (`PID:LOOPMODE <ch> 0`, the default) follows its duty in the
open-loop shot (`SHOT:*`), so a run can MIX them: closed phases are driven by their controllers, open phases by the
shot, at one carrier -- the shot's frequency when any enabled phase is open, otherwise the fixed closed-loop
carrier (`CONFig:CLOSEDloop:FREQuency`). The run lasts as long as the shot when any phase follows it, otherwise as
long as the target; a closed phase whose target ends earlier holds its last value. Disabled phases (`PHASe:ENAble`)
take no part: their loops do not run and their feedback inputs are not checked. With every loop open `FIRE` plays
the open-loop shot as before. Errors: no shot for an open phase (`ERR 5`); `SOURce:RUN` needs every enabled phase
closed (`ERR 13`). *Behaviour change:* before the three loops existed `PID:LOOPMODE 1 1` closed the one loop that
drove all phases; now it closes phase U only, and the other phases follow the shot (`PID:LOOPMODE 0 1` closes all).
The loop ticks at `CONFig:PIDRate` (default 10 kHz, one tick per ADC block: the sampler
timer starts the ADC, DMA fills the scan buffer, the block interrupt runs all the loops). A run
ends when its profile ends: the HRTIM outputs are disabled at a period boundary.

```
> PID:LOOPMODE 1 1                 loop (1-3, 0 = all), 0 = open loop, 1 = closed loop
> PID:LOOPMODE? 0                  OK 1 0 0   the three loops' modes
> PID:GAINS 1 0.167 6.667 0        loop, kp ki kd, up to 3 decimals; Hz per V (HVPS), % duty per V (Limiter)
< OK
> TARGet:BEGin
> TARGet:STEP 0 0                  t_us volts (every phase); the first setpoint must be t = 0; linear between setpoints
> TARGet:STEP 25000 720            ... or  TARGet:STEP 25000 720 -300 500  = a target per phase U, V, W
> TARGet:END
< OK 3 25000                       setpoints, duration in us
> LOG:ARM 1 1000 1               loop (0 = all three), max samples (<= 1000; <= 333 for all three), decimation (ticks per sample)
> ARM
> FIRE
> LOG:DATA? 1 0 40               loop, start, count (<= 40 per reply, SUM= check value)
< OK 1000 10000 SUM=... 3 0 50638 ...   count, tick rate, then target mV, measured mV, output (milli-Hz or milli-%)
> SOURce:STATus? 1
< OK 0 -0.003 0.228 65.02          running, target, measured, output (of that loop; an open phase shows its shot duty as the output)
> PID:FAULT?                       OK 2 CLIPPED_LOW   which loop stopped the last closed-loop run, and why (OK 0 NONE; cleared when the next closed-loop run starts)
> PID:DIAG?                        OK <ticks> <longest tick> <mean tick> <cycles per tick period>   the control tick's cost in CPU cycles
```

`TARGet:STEP` takes ONE voltage for every phase or one per phase (U, V, W) on a shared time grid, and refuses a
voltage beyond `CONFig:MAXVolts` (naming the phase). `TARGet:POINt? <i>` answers `OK <t_us> <volts>` when the
phases agree, else `OK <t_us> <volts_U> <volts_V> <volts_W>`. Other target commands:
`TARGet:CLEar`, `TARGet?`. `SOURce:RUN`, `SOURce:STOP`, `SOURce:SETpoint <ch> <volts>` (loop 0 = all).

**Verified on the simulator board (2026-10-13):** per-phase open-loop duties measured on the three phases' edges
(programmed 20/50/80 % reads 18.1/48.1/78.0 %: the same ~1.9-point offset on every phase, the known dead time; a ramp with U rising,
V falling and W flat reads as programmed, correlation 0.99); three closed loops against the firmware plants with a different
target each (U to +594 V, V to -594 V, W holding 300 V: rms error 0.6 V or less); a mixed run (U closed at 300 V, V 30 % and
W 70 % from the shot, carrier ramping 100 -> 108 kHz); a loop's fault stops the run and names the loop (W, V and U each alone on a
dead real ADC input: `PID:FAULT?` = 3, 2, 1, `CLIPPED_LOW`); a closed loop on a disabled phase takes no part; saved profiles from
the older firmware recall, and a per-phase profile round-trips through the real flash. The control tick, three simulated loops
at the fastest carrier (125 kHz): longest 13,670 of 17,000 CPU cycles (80 %) -- the per-period interrupt alone takes 31 % of the
CPU there and preempts it, so the margin is real but not large (`PID:DIAG?`). NOT verified: loops on the real analog inputs (the
DAC-to-ADC path of the board read 0 on every input when tried) -- the real-ADC tests wait for a live feedback signal.

**Feedback input and calibration** (`CONFig:FEEDback:*`; defaults U = PA0, V = PA1, W = PB0). `CHANnel`, `SCALE`,
`OFFSet` and `RANGE` belong to a loop: with one argument they set loop 1 (as before there were three loops), with a loop
first (`CONFig:FEEDback:RANGE 2 900`) that loop, and loop 0 sets all three (`CONFig:FEEDback:RANGE 0 900`); their queries take
an optional loop the same way. `SOURce SIM` simulates every closed loop; `DAC` and `LOOP` (below) apply to loop 1 (phase U) only,
the other loops read their real ADC inputs.

| Command | Meaning |
|---|---|
| `CHANnel <1-6 or PA0 PA1 PC0 PB0 PC1 PB1>` | the ADC input used as feedback |
| `SCALE <x>`, `OFFSet <adc volts>` | process volts = (ADC volts - offset) x scale |
| `RANGE <Vmax>` | sets scale and offset for a bipolar output: -Vmax -> 0 V at the ADC, +Vmax -> full scale, zero at mid-scale (offset = vref/2, scale = 2 Vmax / vref). `RANGE?` returns the process volts at the top of the ADC range. |
| `FILTer <Hz>` | low-pass on the measurement (0 = off); the overvoltage check ignores it |
| `CLIPTime <ms>` | how long the ADC may sit at either end of its range before a fault (10 ms; 0 = off) |
| `SOURce ADC\|SIM\|DAC` | the real ADC input; the firmware's simulated plant (nothing wired); or `DAC`, hardware in the loop: the plant model's voltage goes out on DAC PA5 and comes back through the board's amplifier into the real ADC input (one tick later) |
| `SOURce LOOP` | loopback: the duty (Limiter) or carrier frequency (HVPS) the HRTIM really produces is measured on PFM_Input_01 (Phase U wired to it; TIM2 in PWM-input mode, no interrupt, `duty_meter.h`), the plant model (Limiter: V = vscale (2D-1); HVPS: the resonance curve) turns it into a voltage, `SIM:PLANT:TAU` is the digital low-pass, and the result goes out on DAC PA5 and back in through the real ADC input as for `DAC`. Refuses (ERR 13) while a PFMIN capture owns TIM2; faults (FB) if PFM_Input_01 stops toggling for 20 ms. |
| `DACRatio <x>` | for `SOURce DAC`: ADC volts per DAC volt of that loopback (0.05-2, default 0.5; measured 0.552 on the bench) |

The Limiter's output swings -Vmax..+Vmax and the ADC reads only 0 to `ANALOG_VREF_MV`, so
its divider is expected to put zero volts at mid-scale; `CONFig:FEEDback:RANGE 900` is the
one command for that. `FEEDBACK_VMAX_DEFAULT_V` in `ctrlr_config.h` makes it the power-on
default (0 = uncalibrated). For an HVPS the offset stays 0 (its feedback is 0 V at the
start of a shot).

**Protection.** (`FAULT:SOURces?` bits `OVP` and `FB`.) Overvoltage: the unfiltered
measurement beyond +-`CONFig:MAXVolts` (default 4, range up to 10000 process volts) stops the
output immediately. Clipping: the ADC at full scale for `CLIPTime`. Dead feedback line: the
ADC at the bottom of its range (code <= 5) for `CLIPTime`, checked only when the offset is not 0
-- on a mid-scale-zero range a reading of code 0 means -Vmax or a broken line, and the loop
would otherwise drive the output up on nothing real. All three raise `FAULT GENERAL`.
A closed-loop start also refuses if VREF+ is more than 3 % from `ANALOG_VREF_MV`.

**Plant models** (what the controller assumes, for its feedforward; the loop corrects the rest):
`CONFig:CLOSEDloop:` `DUTY` (HVPS duty, within the HVPS limits), `FREQuency` (Limiter carrier),
`RESonance` and `VPEAK` (HVPS curve), `VSCALE` (Limiter volts at |2D-1| = 1; with `RANGE`
this is the capacitor-bank voltage), `BRANCH ABOVE|BELOW` (which side of the HVPS peak to
run on; gains stay positive either way). `CONFig:PIDRate`, `CONFig:SLEWRate <per tick>`,
`CONFig:ADC:AVERage`, `CONFig:ADC:SAMPle` set the loop rate, the output slew limit and the
sampling.

**HVPS output is power.** The HVPS feedback voltage stands in for power: never negative (a
negative HVPS target is refused at `TARGet:STEP` and at start), highest at the resonant frequency
(about 19 kHz) and falling away on both sides. To raise the output the drive frequency moves
toward resonance; a run typically starts around 20 kHz. The controller turns a target voltage into a
frequency with a lookup table of (frequency, volts) points, linearly interpolated, on the branch
chosen by `BRANCH`. Until a measured table is loaded it is linear: zero at the edge of the mode's
band (30 kHz above, 10 kHz below), `VPEAK` at `RESonance`, a straight line between.

```
> CONFig:CLOSEDloop:CURVe:BEGin
> CONFig:CLOSEDloop:CURVe:STEP 19000 1.5     Hz volts (Hz to 1 decimal, volts to 3), frequency strictly increasing, volts >= 0
> CONFig:CLOSEDloop:CURVe:STEP 24000 0.8     up to 32 points; one peak (rising then falling)
> CONFig:CLOSEDloop:CURVe:END
< OK 21 19000.0 1.500                         points, peak frequency, peak volts (the table's peak replaces RESonance)
> CONFig:CLOSEDloop:CURVe?                    OK LINEAR | OK TABLE <n> <peakHz> <peakV>
> CONFig:CLOSEDloop:CURVe:POINt? 3            OK <Hz> <volts>
> CONFig:CLOSEDloop:CURVe:CLEar               back to the linear default
```

**Simulated plant** (`CONFig:FEEDback:SOURce SIM`): the firmware answers its own commands
through a first-order lag, so the loop runs with nothing wired. The plant starts at the run's first target voltage. `SIM:PLANT:SHAPE LINEAR|LORENTZ` (HVPS; default LINEAR, zero at the band's edges, matching the controller's default; LORENTZ is a nonlinear resonance, to test a loaded CURVe table against). `SIM:PLANT:TAU`, `GAIN`
(a mid-shot disturbance knob; `SIM:PLANT:GAIN <loop> <x>` for one plant, loop 0 for all, one argument = loop 1), `RESonance`, `WIDTH`, `VPEAK`, `VSCALE`
(these apply to every loop's simulated plant). Set the simulated
plant differently from the controller's model to test it against a supply it does not know.

### `GDS?`

Raw `HIGH`/`LOW` snapshot of the 12 GateDriverStatus_01..12 pins
(`PE0`–`PE11`, `GPIOE` — `docs/pin_mapping_v4.csv`), added 2026-09-08
as a diagnostic while investigating why a fault wasn't being
registered. Direct, uncached `GPIOE->IDR` read at the moment of the
query — no debounce, no polarity interpretation, no fault-latching of
its own. This command itself is read-only visibility and cannot stop
PWM output by itself. (These same 12 pins DO now gate PWM output, via
a separate mechanism — the GateDriverStatus EXTI fault interrupt, see
`FAULT?`/`FAULT:CLEAR` below, added the same day — `GDS?` is
unaffected by and independent of that mechanism either way, just a raw
snapshot.)

```
> GDS?
< OK 01=LOW 02=LOW 03=HIGH 04=LOW 05=LOW 06=LOW 07=LOW 08=LOW 09=LOW 10=LOW 11=LOW 12=LOW
```

One `OK` line, one `NN=HIGH` or `NN=LOW` token per pin, space
separated, `NN` = `01`–`12` matching the `GateDriverStatus_01`..`_12`
numbering (`01` = `PE0`, `12` = `PE11`). Kept to this project's
existing single-`OK <value>`-line response convention rather than the
sibling PFM-STM32G474 project's multi-line/bitmask `GDS?` reply
shapes.

### `GDS:LAST?`

Which gate-driver status input(s) were in their fault state when the **last GateDriverStatus fault latched**: a record kept in RAM by the
fault check (`GateDriver_CheckFault()`, `gate_driver.c`), added to find which input tripped on the bench. `FAULT:SOURces?` says only that the
`GATEDRV` source tripped; this says which of the 12 inputs. XREX has no equivalent (it reports the channel and category in `STATE?`).

```
> GDS:LAST?
< OK 101 7
```

Reply: `OK <pins> <checks>`.

- `<pins>`: the **raw levels of all 12 pins** at the instant the fault latched, as hex digits with no `0x` prefix and at least three digits
  (`%03X`). Bit 0 is `GateDriverStatus_01` (`PE0`) and bit 11 is `GateDriverStatus_12` (`PE11`). A set bit is a pin that read HIGH, **not**
  necessarily one in its fault state: which level is the fault is the build's `GDS_FAULT_POLARITY` (`ctrlr_config.h`), currently
  `GDS_NORMALLY_LOW`, so under the current build a set bit **is** a faulted input. `101` above means inputs 01 (`PE0`) and 09 (`PE8`) were HIGH.
- `<checks>`: how many times the fault check has run since boot (every edge interrupt on the 12 pins, plus the explicit calls at boot and from
  `FAULT:CLEAR`), a rough measure of how active the pins have been.
- A `<pins>` of `000` means no gate-driver fault has latched since boot (`OK 000 <checks>`). The value is **not** cleared by `FAULT:CLEAR`: it keeps the
  record of the last latch until the next one overwrites it or the controller resets. If `FAULT:CLEAR` finds a pin still faulted and latches again,
  the record is overwritten with the pins as they read then.
- It reflects only the GateDriverStatus source. A fault from `PC10`, `TABLE`, `TEST`, `OVP` or `FB` (see `FAULT:SOURces?`) does not change it.
- Read-only, any state. Compare with `GDS?`, which is the live levels, not the levels at the last latch.
- The pin-to-phase wiring is not recorded anywhere in the firmware or in `docs/pin_mapping_v4.csv` (the pins are named only
  `GateDriverStatus_01`..`_12`), so this identifies the input, not the phase or gate driver it belongs to.

Typical use after `STATE?` reports `FAULT GENERAL` with `FAULT:SOURces?` showing `GATEDRV=1`: send `GDS:LAST?`, then read `<pins>` as a bit mask,
lowest bit = input 01.

### `DIAGnostic:LEDs?`

Which front-panel LEDs the firmware is driving lit (`led_indicators.h`; pins in `docs/pin_mapping_v4.csv`: `UART_TX_LED` PD2,
`UART_RX_LED` PD3, `STATE_IDLE_LED` PF14, `STATE_ARMED_LED` PF2, `STATE_FIRING_LED` PC3, `STATE_FAULT_LED` PC2). It reads the
output register, not the pin, so it works with no LEDs fitted.

```
> DIAGnostic:LEDs?
< OK TX=0 RX=1 IDLE=1 ARMED=0 FIRING=0 FAULT=0
```

- Exactly one of `IDLE`/`ARMED`/`FIRING`/`FAULT` is 1 and it is the state `STATE?` reports (all 0 only before start-up completes).
- `TX`/`RX` are the activity LEDs: lit by serial traffic and turned off 30 ms (`LED_ACTIVITY_MS`) after the last byte by a
  timer and DMA, not by the CPU. The query's own request lights `RX`, so a query sent right after another shows `RX=1` (and `TX=1` from
  the previous reply); one sent more than 30 ms later is likely to show `RX=1` only for its own request.
- All zeros when the firmware is built with `LED_INDICATORS_ENABLED 0`.

### `FWUPdate:*` — in-application firmware update (dual-bank)

Added 2026-09-29 (ported from WHAM-XREX-PFMG474, where it was verified on
both boards). Updates the firmware over this same serial link at 115200
8N1, so it works through the ethernet serial bridge, which can't carry the
ROM bootloader's 8E1. Host tool: `python/fw_update.py` (`--status`,
`--no-swap`, `--rollback`).

The STM32G474 runs in dual-bank mode (`OPTR.DBANK=1`, 2 x 256 KB). The
running bank is always mapped at `0x08000000` and the other ("inactive")
bank at `0x08040000`. A new image — the same `.bin` that would be flashed
at `0x08000000`, no relinking — is written into the inactive bank,
CRC-checked and sanity-checked, then booted by setting `OPTR.BFB2`: the ROM
bootloader's dual-bank boot starts that bank with the banks swapped. The
previous image stays in the other bank; `FWUPdate:ROLLback` boots it again.

Strict stop-and-wait: `uart.c` holds one line at a time, so wait for each
reply before sending the next line.

| Command | Reply | Notes |
|---|---|---|
| `FWUPdate:BEGin <size> <crc32hex>` | `OK ERASED <n> PAGES BANK <b>` | Needs `STATE IDLE`. `size` = image length padded with `0xFF` to a multiple of 8, at most 262144. CRC = standard CRC-32 (`zlib.crc32`) of the padded image. Erases only the inactive bank, then checks it reads blank |
| `FWUPdate:DATA <offsethex> <hex>` | `OK` | 8-48 bytes, a multiple of 8, offsets strictly in order from 0 |
| `FWUPdate:END` | `OK VERIFIED CRC=<crc>` | CRC over the written bank, then checks the initial stack pointer is in SRAM, the reset vector is a Thumb address inside the image, and the image contains this build's NUL-terminated product name (`HW_BOARD_NAME`), so another product's image can't be loaded |
| `FWUPdate:SWAP` | `OK SWAPPING -- rebooting into bank <b>` | Needs a verified image and `STATE IDLE`. Programs `BFB2`, then reloads option bytes (a full reset) |
| `FWUPdate:ROLLback` | same as `SWAP` | Boots the image already in the other bank, after the same sanity checks (no CRC — there's no reference). Refused mid-transfer |
| `FWUPdate:ABORt` | `OK` | Forgets a transfer. The inactive bank is left as is |
| `FWUPdate:STATus?` | `OK BANK=<1\|2> BFB2=<0\|1> DBANK=<0\|1> STATE=<IDLE\|RECEIVING\|VERIFIED> RX=<n>/<size>` | `BANK` = physical bank currently running |

Errors: `ERR 12` bad arguments/offset, `ERR 13` wrong state (not `IDLE`,
no transfer, nothing verified), `ERR 17` flash/CRC/image/option-byte
failure. Nothing before the final swap can affect the running image.

**Before flashing with the ST-Link**, check `FWUPdate:STATus?` shows
`BANK=1 BFB2=0` (or `fw_update.py --rollback` until it does). With
`BFB2=1` the board boots physical bank 2, so a normal ST-Link write to
`0x08000000` would not be the image that runs. **The board needs a firm
NRST pull-up for the swap's reset to be reliable** — see AGENTS.md,
hard-won invariant 4.

**Recovery with an ST-Link** if a swapped-to image won't run: clear `BFB2`
so the board boots physical bank 1 normally, then reflash bank 1. Attach with
SWD only (leave the ST-Link's NRST wire off) and `reset_config none`.

### `DIAGnostic:OPTBytes?`

Reports the boot-source bits of the live `FLASH->OPTR`:

```
> DIAGnostic:OPTBytes?
< OK OPTR=BBEFF8AA nBOOT0=1 nSWBOOT0=0 nBOOT1=1
```

`nSWBOOT0=1` means boot0 is read from the physical `BOOT0`/`PB8` pin;
`0` means boot0 is taken entirely from `nBOOT0` and the pin is never
sampled. `nBOOT0` is the option-byte boot0 value, used only when
`nSWBOOT0` is `0`; `nBOOT1` combines with the effective boot0 to pick the
boot target.

### `DIAGnostic:UART?`

`OK OVERRUN=<n> FRAMING=<n> NOISE=<n> PARITY=<n> REARMED=<n>` -- serial **receive** errors since boot (added
2026-11-09). A nonzero `OVERRUN` means the serial interrupt was served too late and a byte was lost: the partial
line is dropped and reception restarts (`REARMED` counts the restarts). Before 2026-11-09 an overrun switched
reception off until a power cycle: the controller kept sending its own `!EVT` lines but never answered again, and
the hub reported "the controller is not connected". Replies of `ERR 1 Unknown command` to a valid command are the
other symptom of a lost byte. All zero on a healthy link; read it after a shot.

### `DIAGnostic:RSTCause?` / `DIAGnostic:RSTCause:CLEar`

`RSTCause?` reports the `RCC->CSR` reset-cause flags:

```
> DIAGnostic:RSTCause?
< OK CSR=00000000 BOR=0 PIN=0 SFT=0 IWDG=0 WWDG=0 LPWR=0 OBL=0
```

`RSTCause:CLEar` zeroes them (`OK`). The boot banner already captures and
clears these flags at every boot, so this mostly shows resets since then.

### `QSPI:ID?`

QUADSPI connectivity test against the W25Q128JVS NOR flash wired to
`PE12`-`PE15`/`PB10`/`PB11` (all AF10 — `docs/pin_mapping_v4.csv`),
added 2026-09-08 as an **easily removable** module
(`Core/Src/Inc/qspi_test.c/.h`) — see `QSPI_TEST_FEATURE_ENABLED` in
`qspi_test.h`; when disabled, this command is entirely absent from the
table (`ERR 1 Unknown command`, like any unrecognized mnemonic), the
same removability pattern `BOOT` uses. Deliberately narrow: issues the
chip's standard JEDEC Read ID instruction (`0x9F`, plain 1-line mode,
no Quad Enable bit required) and reports the 3 raw ID bytes as
uppercase hex — nothing else. No program/erase, no memory-mapped
access.

```
> QSPI:ID?
< OK EF 40 18
```

No expected value is hardcoded or asserted anywhere in this
command — it reports whatever the chip actually says; compare against
the W25Q128JVS datasheet's own JEDEC ID table yourself (`EF` = Winbond
manufacturer ID; the other two bytes are memory type/capacity). `ERR 7`
on any `HAL_QSPI` command/receive failure or timeout — e.g. no chip
present, a wiring fault, or a wedged bus.

**Verified on real hardware**: `OK EF 40 18` — correct Winbond
manufacturer ID and correct W25Q128 memory type/capacity bytes,
confirmed repeatable (3x) after reflashing. A real bug was found and
fixed getting here: the first attempt returned a stable "DE 80 30"
instead, traced to a QUADSPI sample-timing setting
(`SampleShifting`) — see `docs/changelog.txt` and `qspi_test.c`'s own
bugfix comment for the full diagnosis (an exact 1-bit shift of the
correct value, not random noise) and fix.

### `PHASe:ENAble`, `PHASe:SELect` -- which phases drive their outputs

The H-bridge has three phases, U, V and W (each a main output and its complement with dead time). By default all
three run. These commands choose any combination -- U and W, only W, only V, ...

```
> PHASe:ENAble UW 1         switch phases U and W on; the others are left as they are
< OK
> PHASe:ENAble V 0          switch V off
> PHASe:ENAble ALL 0        switch every phase off
> PHASe:SELect W            exactly W on, U and V off
> PHASe:SELect NONE         every phase off (same as ENAble ALL 0)
> PHASe:ENAble?
< OK U=1 V=0 W=1
> PHASe:ENAble? V           one phase: OK <0|1>
< OK 0
> PHASe:SELect?             the enabled phases as letters
< OK UW                     (OK NONE if there are none)
```

- `<phases>` is letters in any order and case (`U`, `UW`, `wu`), channel numbers (`1`, `13`, `1,3`), or `ALL`
  (`NONE` as well for `SELect`). Letters and numbers are not mixed. `ERR 12` for anything else.
- **IDLE only** (`ERR 13` otherwise): the choice is read when a shot starts (`FIRE`, `SOURce:RUN`), so it cannot
  change a shot already running. Queries work in any state.
- `ARM` refuses (`ERR 13`) while no phase is enabled, so a shot never runs with nothing to drive.
- A disabled phase's outputs are never connected to the pins when a shot starts, so its gate drivers see no
  switching at all; its timer keeps running in step with the others, so the enabled phases keep their own places in
  the cycle (U at 0, V at 1/3, W at 2/3 of a period) whichever of the others are on. All three are enabled at every
  boot and the choice lasts until reset. It is **not part of a saved profile**: a recall must never change which legs
  of the bridge are driven.
- `SOURce LOOP` (the loopback test) measures Phase U on PFM_Input_01, so it refuses to start with U disabled.
  A PFM_Input capture of a disabled phase simply sees no edges.
- The twelve gate-driver status inputs (`GDS?`) are **not** masked for disabled phases: the pin map does not say
  which input belongs to which phase, so every one still raises a fault.

**Verified on the simulator** (PFM_Input 1/2/3 = U/V/W): for UVW, UW, W, V, U, VW and ALL, exactly the enabled
phases' inputs saw edges (300 of a 300-period capture, the others 0) and no combination faulted.

### `QSPI:SELFtest`

Bench proof of the external-flash driver (`nvstore.h`) against the real W25Q128JVS, ported from XREX
(2026-10-05). IDLE only. It works on the reserved scratch sector (the last 4 KiB of the chip) and leaves it erased:
reads the status registers, erases, programs a 300-byte pattern that crosses a page boundary, reads the whole
sector back (pattern plus everything else still `0xFF`), erases again.

```
> QSPI:SELFtest
< OK PASS sr=00,02,60 erase=59ms prog=1ms read=8ms
```

`ERR 7 selftest <step>: <reason>` names the first step that failed; `ERR 13` if not IDLE.

### Saved profiles: `*SAV`, `*RCL`, `CONFig:PROFile:*`

Eight numbered slots (1-8) in the external flash keep the operator-configurable settings **and** the shot,
target and HVPS-curve tables. Same commands and rules as XREX; design, what is stored and the differences:
`docs/saved_profiles.md`. Loading is always explicit -- nothing is applied at boot. `*SAV`, `*RCL` and `CLEar`
work only in IDLE (they erase or write flash, or change live settings); the read-only commands work in any
state. A save or recall takes a fraction of a second, during which the serial link is not serviced.

```
> *SAV 1 bench                     save everything live into slot 1 (label optional: 1-15 characters, no spaces)
< OK
> CONFig:PROFile:CATalog?
< OK 1=bench/v0.9 2=empty 3=empty 4=empty 5=empty 6=empty 7=empty 8=empty     <label>/<firmware that saved it>
> CONFig:PROFile? 1                preview: every saved value, then the tables' point counts
< OK label=bench fw=v0.9 MODE=2 PIDRate=8000 ... hvps.kp=4000 lim.kp=0.167 ... shot=500 target=8 curve=21
> CONFig:PROFile:DIFF? 1           what *RCL would change: <name>=<live>><saved>, or SAME
< OK PIDRate=10000>8000 ... shot=0>500 target=0>8 curve=0>21
> *RCL 1
< OK APPLIED=23 FAILED=0           [<names of what was refused>] [IGNORED=<records skipped>]
> CONFig:PROFile:CLEar 1
< OK
```

In `DIFF?` a table is compared by point count (`shot=500>500*` means the same count but different points);
`curve=0` is the linear default. `ERR 18` for an empty or corrupt slot or a flash failure, `ERR 12` for a bad slot
number or label, `ERR 13` when not IDLE. A recall that refuses a value still applies the rest; a table that fails
part way is left empty.

**Not saved:** run state (`ARM`, `FIRE`, `SOURce:*`), the DAC outputs, and the bench-simulation settings
(`CONFig:FEEDback:SOURce`, `DACRatio`, `SIM:PLANT:*`).

## Adding a command

From `cmd_parser.c`'s own header comment:

1. Implement the handler in `commands.c`.
2. Declare it in `commands.h`.
3. Add a `{ "PATTern:MNEMonic?", handler }` row to `command_table[]` in
   `cmd_parser.c`.

Nothing else changes — the table is flat, so a new leaf or a whole new
subsystem is always just one more row. Update this document when you do.
