everettpenne/WHAM-CONTROLLERS/firmware/xrex/docs/reports/memory_report.html

WHAM-XREX-PFMG474 · STM32G474QET6

# Memory footprint

As of ebe3098611-dirty — XREX: the live !EVT stream is off by default (SYS:EVENT 0 at every boot) · tracked every commit since 2026-09-09

Flash (512 KiB)

24.6%

125.9KB used

128,892 / 524,288 bytes

386.1 KB remaining

RAM (128 KiB)

85.0%

108.8KB used

111,368 / 131,072 bytes

19.2 KB remaining

Utilization over project lifetime

37 commits · 2026-09-09 – 2026-11-09

Flash

RAM

## Current breakdown by module

Flash — 125.9 KB

RAM — 108.8 KB

## Full history

Commit | Date | Subject | Flash | Flash % | RAM | RAM %

Generated by python/memory_report.py report from docs/memory_history.csv. Regenerate after any commit that changes flash/RAM usage: python3 memory_report.py history then python3 memory_report.py report, and commit both the CSV and this file. Per-module sizes are read from the linked ELF's own retained symbol table (arm-none-eabi-nm), not summed .o files, so dead code the linker strips (--gc-sections) is never counted.
