everettpenne/WHAM-CONTROLLERS/firmware/hbridge/docs/reports/memory_report.html

WHAM-HBRIDGE-PFMG474 · STM32G474QET6

# Memory footprint

As of 7577bf7d41-dirty — Serial receive can no longer be switched off by an overrun (XREX and HBRIDGE); USART2 priority raised; DIAGnostic:UART? · tracked every commit since 2026-09-09

Flash (512 KiB)

20.6%

105.5KB used

108,008 / 524,288 bytes

406.5 KB remaining

RAM (128 KiB)

91.6%

117.3KB used

120,104 / 131,072 bytes

10.7 KB remaining

Utilization over project lifetime

23 commits · 2026-09-09 – 2026-11-09

Flash

RAM

## Current breakdown by module

Flash — 105.5 KB

RAM — 117.3 KB

## Full history

Commit | Date | Subject | Flash | Flash % | RAM | RAM %

Generated by python/memory_report.py report from docs/memory_history.csv. Regenerate after any commit that changes flash/RAM usage: python3 memory_report.py history then python3 memory_report.py report, and commit both the CSV and this file. Per-module sizes are read from the linked ELF's own retained symbol table (arm-none-eabi-nm), not summed .o files, so dead code the linker strips (--gc-sections) is never counted.
