everettpenne/WHAM-CONTROLLERS/hardware/PFM-Controller_V4/PFMV4_Prelim_Files-main/V3_PDR/HVPS_V3_PDRz_260226.pdf

Everett Penne, Feb 26 ‘26

# HVPS V3 Controller

Preliminary Design Review

# Requirements

- Maintain & improve upon V2 controller functionality
- 3-phase PWM near 20kHz
- More adjustable dead time
- Better output on/off control
- Improved EMI compatibility
- MCU directly on-board
- Increased digital & analog I/O protection

# MCU Selection

STM32G474QET6

- 170 MHz clock (V2 STM32L4 has 80MHz clock)
- HRTIM functionality

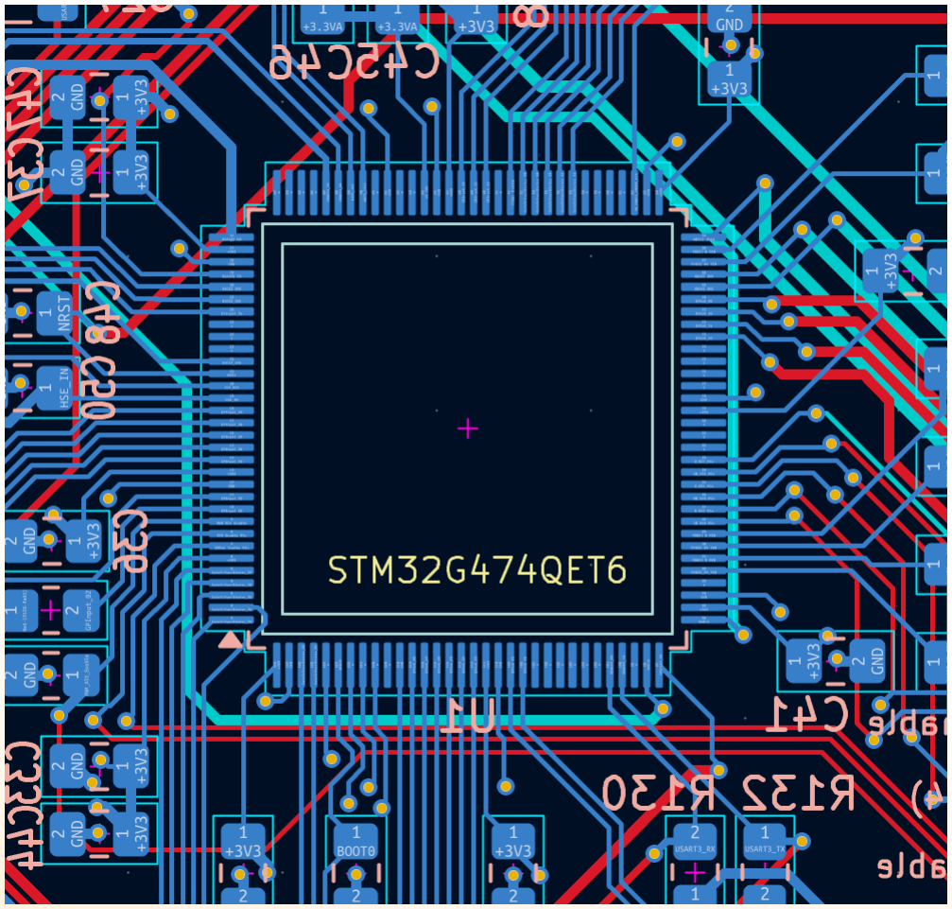
[picture p16: figure]

- 12 HR PWM outputs configurable for up to 6 complementary PWM outputs (eg: A, AN, B, BN, C, CN)
- Multiple 12-bit ADCs (we need 8 channels)
- 107 available GPIO pins (including ADC & Timer pins)
- 3 full USART serial communication channels

# V2 PWM Imperfections

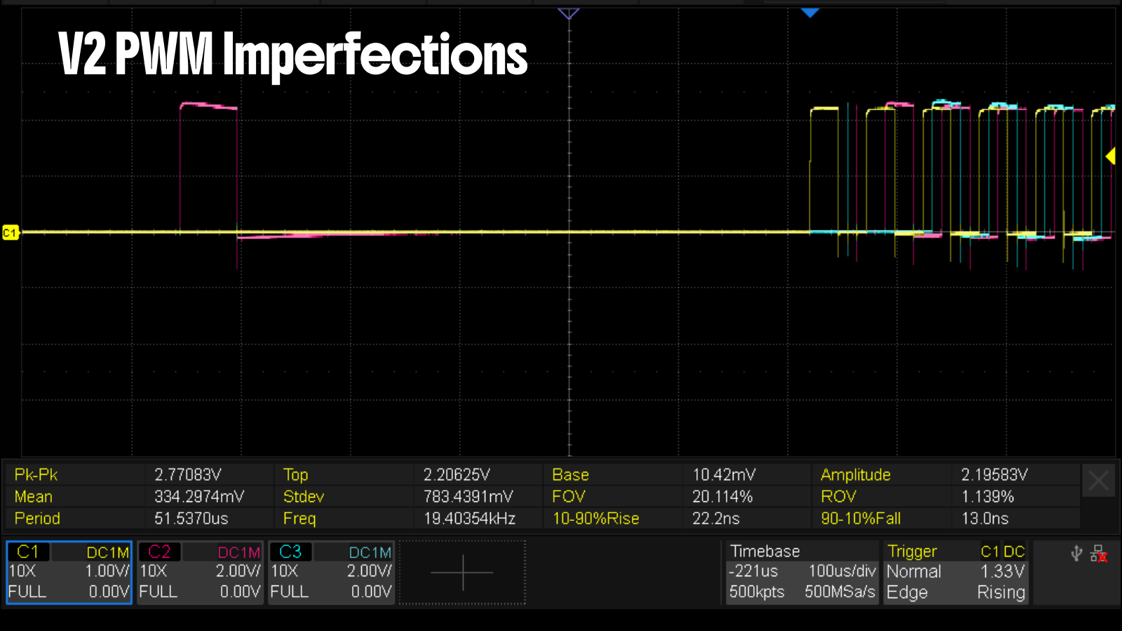
[picture p17: page 4]

# HRTIM (High-Resolution Timer)

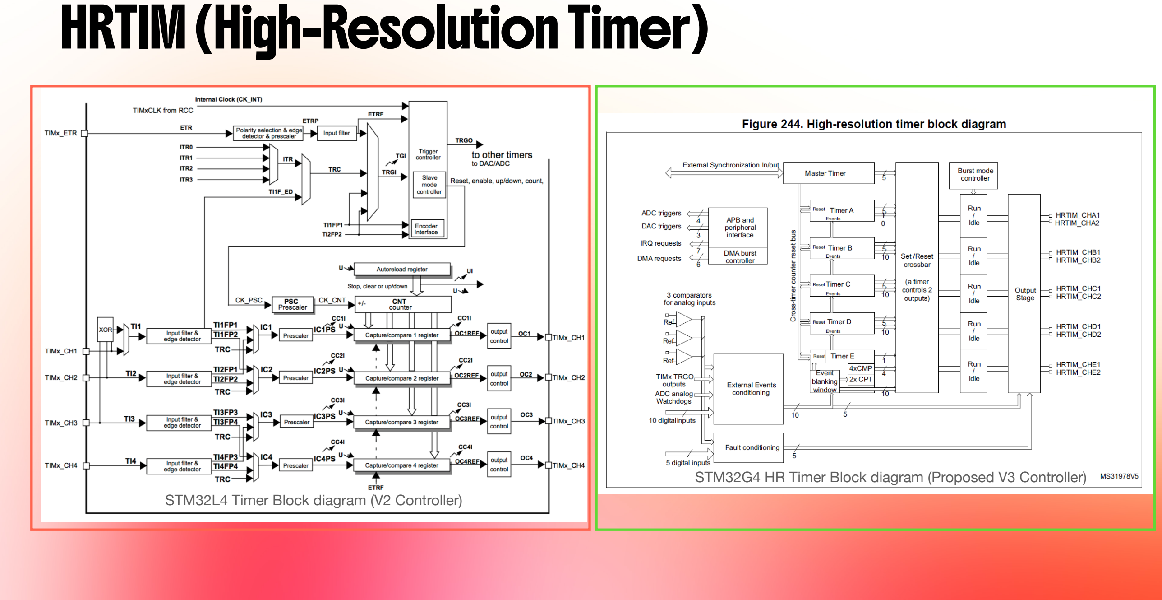
[picture p18: page 5]

STM32L4 Timer Block diagram (V2 Controller)

STM32G4 HR Timer Block diagram (Proposed V3 Controller)

# Better Output On/Off Control

- Connect PWM Fiber Output Gate Driver enable to pin + pull-down resistor on MCU
- Adds option to directly gate output with software

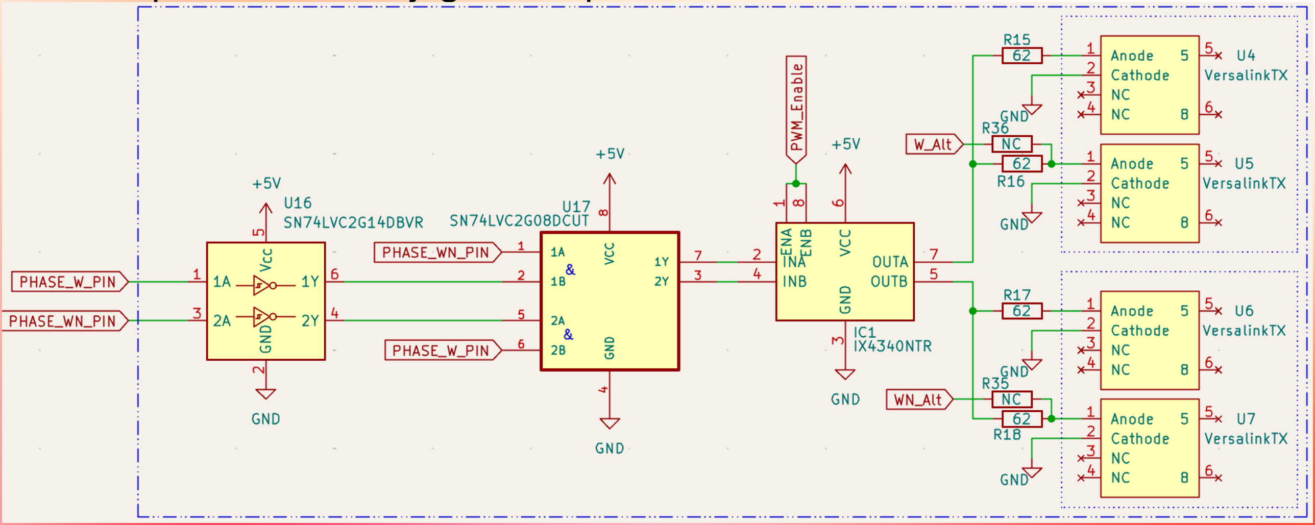
[picture p19: figure]

# GDStatus Fault Handling

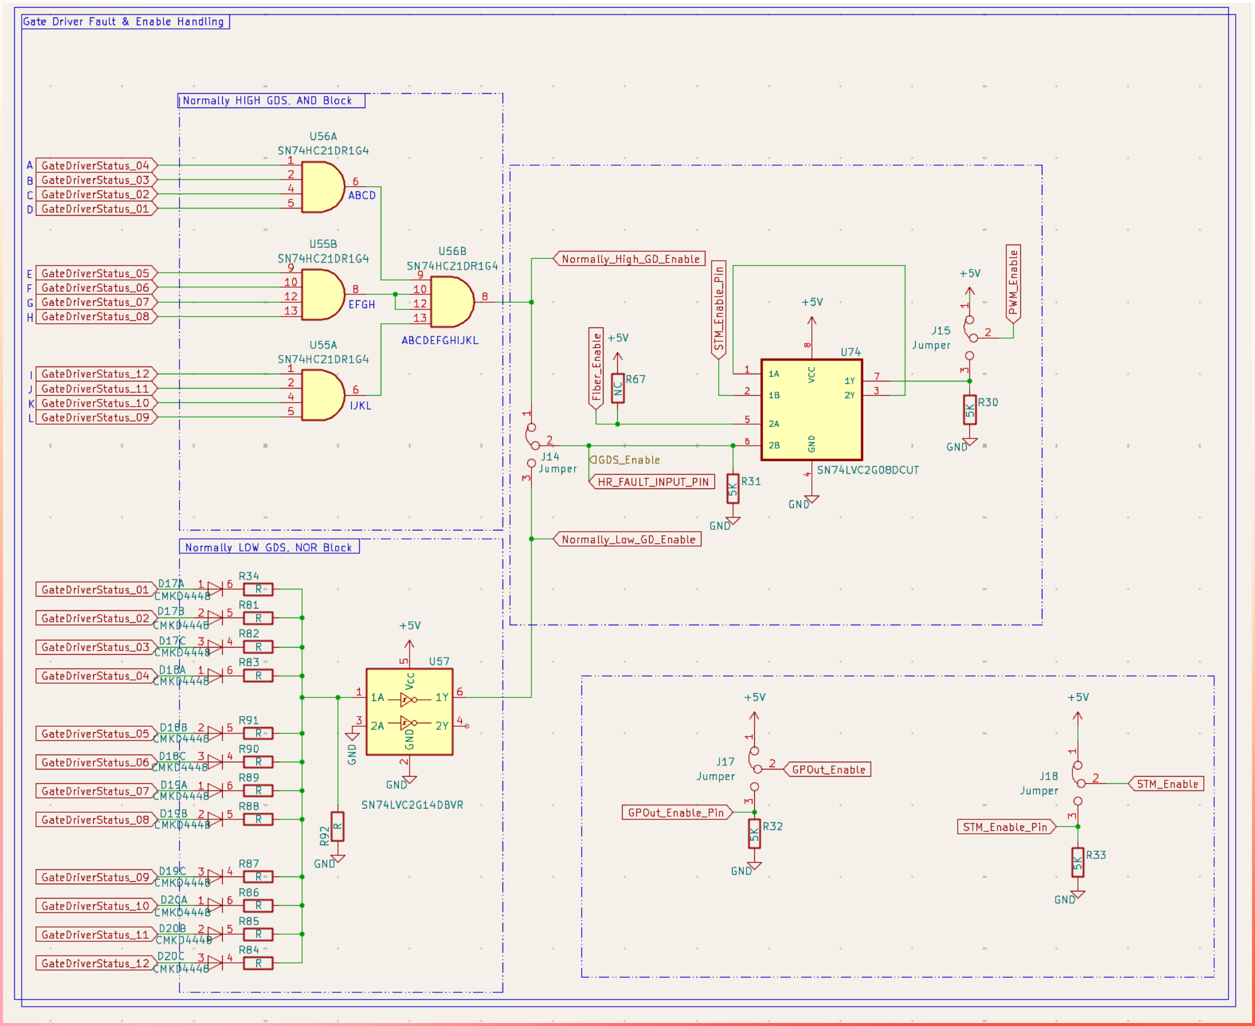
[picture p20: figure]

Many options now available

- Select for normally high, low or bypass
- Software fault disable available as well
- Fault handling is physically configurable

# Improved EMI Compatibility

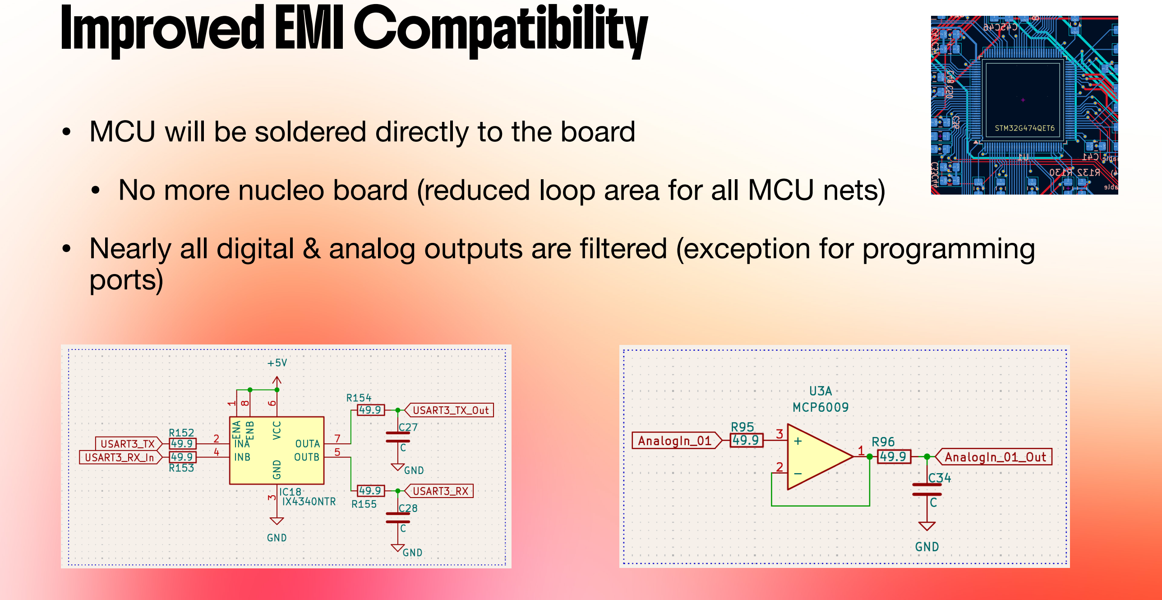
[picture p21: page 8]

- MCU will be soldered directly to the board
- No more nucleo board (reduced loop area for all MCU nets)
- Nearly all digital & analog outputs are filtered (exception for programming ports)

# V2 Actual vs V3 Model

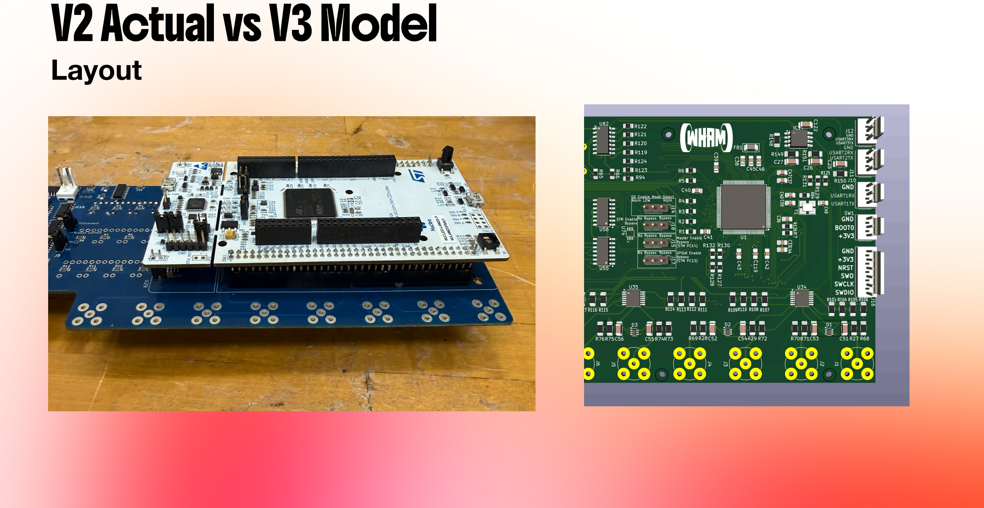
[picture p22: page 9]

Layout

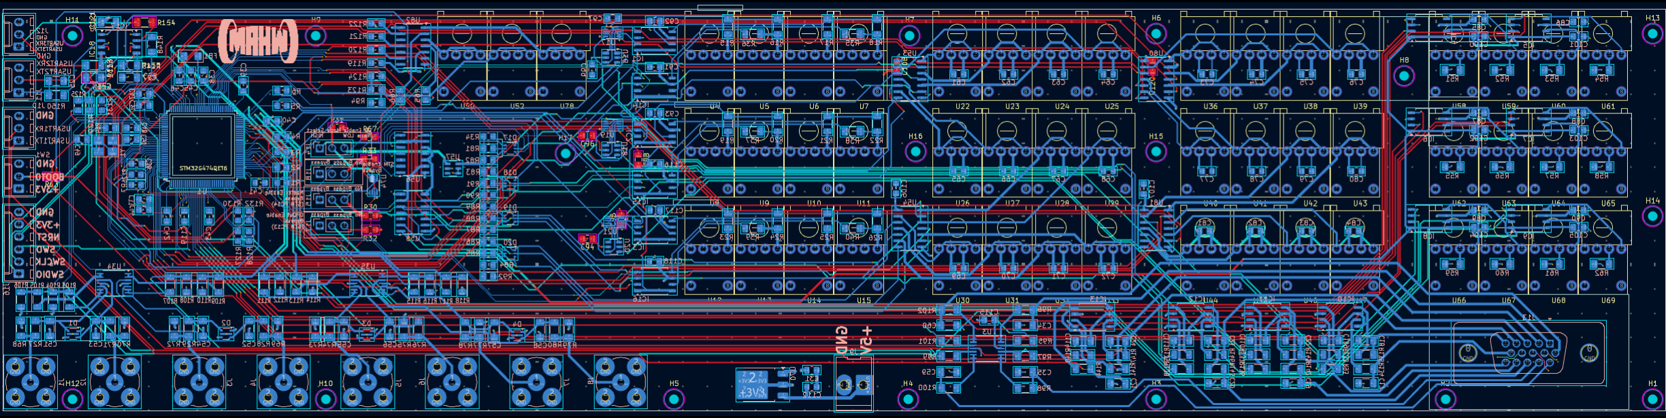
[picture p23: figure]
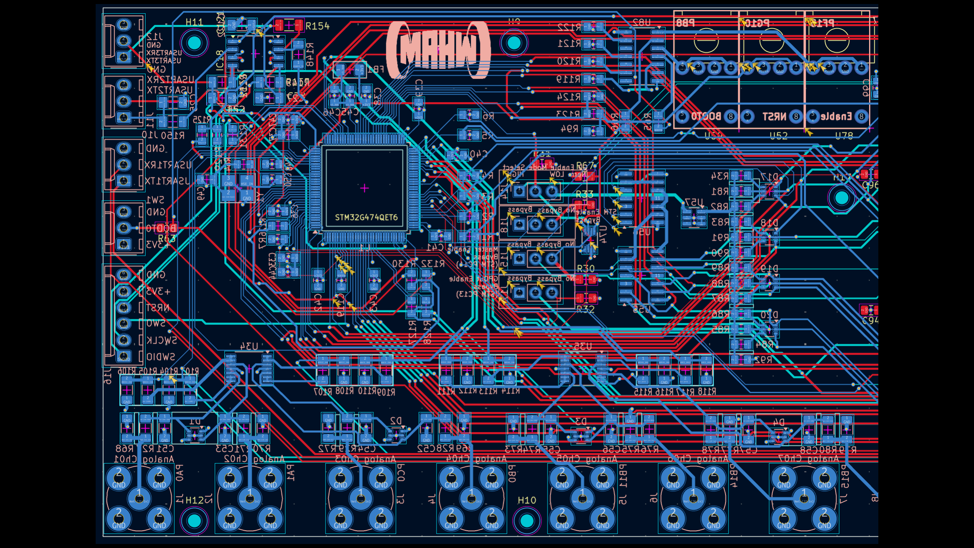
[picture p24: page 11]
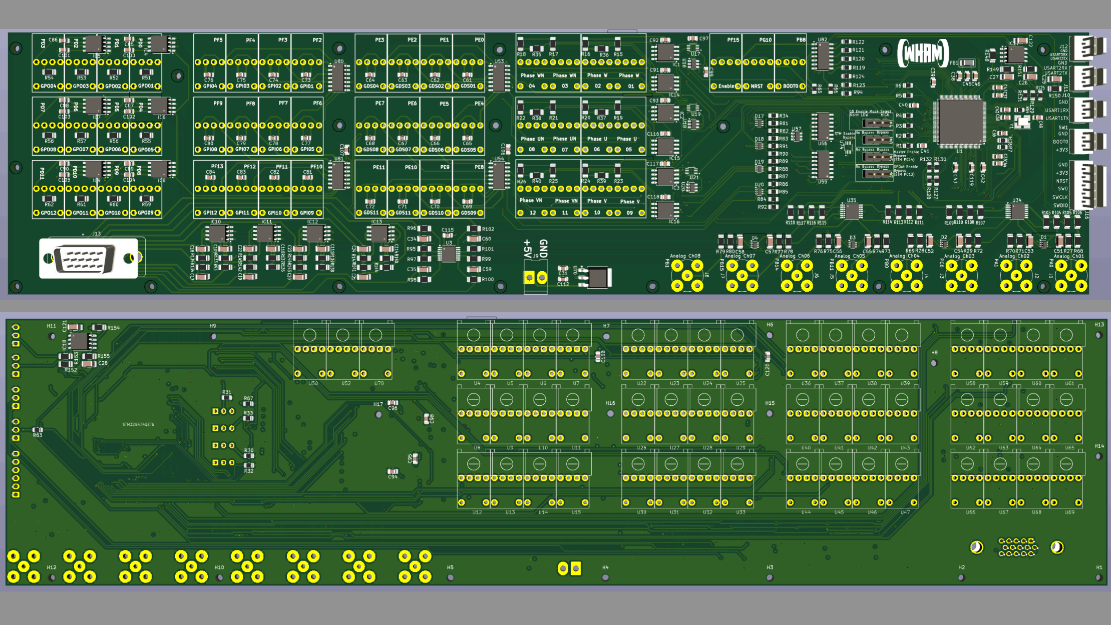
[picture p25: page 12]

# Other features not mentioned

- Potential to program over ethernet (the hardware is designed in, so this is theoretically possible)
- Dedicated fiber optic ENABLE
- Fiber optic BOOT0 signal (allows for MCU reset with fiber optic signal)
- Dedicated fiber optic channels for serial communication
- No more designing extra boards to handle this
- Physical hardware is reconfigurable to free up paired PWM fiber outputs for unique purposes
- Increases flexibility and application for other areas of the lab

# Unknowns/Possible Issues

- No built-in ST-LINK
- Have not attempted programming an MCU using external ST-LINK
- Design follows ST Application Note 5093 section 6
- HRTIM is designed for 3-phase motor control, power conversion, etc
- Programming should be simpler than V2 controller, but needs to be put into practice
- PCB design is extremely complicated

## Have a question?

### I have an answer, let’s see if they match!
