everettpenne/WHAM-CONTROLLERS/hardware/PFM-Controller_V4/jlc_fabrication/bom(1).xls

Comment | Designator | Footprint | JLCPCB Part #
1u | C45,C47 | 0603 | C15849
100n | C113,C119,C123,C33,C36,C37,C38,C39,C40,C41,C42,C43,C48 | 0603 | C14663
20 | R45 | 0603 | C22950
SN74LVC2G08DCUT | U17,U19,U21,U49,U71,U73,U74 | SOP50P310X90-8N | C91872
1N4148W | D5 | D_SOD-123 | C81598
110R@30MHz | FB10,FB11,FB12,FB13,FB14,FB15,FB16,FB17,FB18,FB19,FB2,FB20,FB21,FB22,FB23,FB24,FB25,FB26,FB27,FB3,FB4,FB5,FB6,FB7,FB8,FB9 | Ferrite_1206_3216Metric_Pad1.42x1.75mm_BigPads | C16902
10u | C44 | 0603 | C19702
5K | R104,R106,R108,R110,R112,R114,R117,R119,R27,R28,R29,R32,R33,R46,R47,R7,R71,R74,R76 | 1206 | C870818
R | R103,R105,R107,R109,R111,R113,R116,R118,R182,R183,R103,R105,R107,R109,R111,R113,R116,R118,R182,R183 | 1206 | C34577
74HC14 | U53,U54,U80,U81,U82 | SOIC-14_3.9x8.7mm_P1.27mm | C5356103
10n | C46 | 0603 | C57112
AMS1117CD-3.3 | U70 | TO-252-3_TabPin2 | C347249
100n | C106,C107,C108,C120 | 1206 | C24497
16pF | C49,C50 | 0805 | C519920
IX4340NTR | IC1,IC10,IC11,IC12,IC13,IC14,IC15,IC16,IC17,IC18,IC19,IC2,IC20,IC21,IC3,IC4,IC5,IC6,IC7,IC8,IC9 | SOIC-8_3.9x4.9mm_P1.27mm | C7588209
0 | R212,R49,R50 | 1206 | C17888
Conn_01x16_Pin | J22 | PinHeader_2x08_P2.54mm_Vertical | C68234
100n | C100,C101,C102,C103,C104,C105,C112,C116,C117,C118,C124,C125,C126,C127,C129,C130,C31,C61,C62,C63,C64,C65,C66,C67,C68,C69,C70,C71,C72,C73,C74,C75,C76,C77,C78,C79,C80,C81,C82,C83,C84,C85,C86,C87,C88,C89,C90,C91,C92,C93,C94,C95,C96,C97,C98,C99 | 0805 | C5137467
62 | R120,R121,R122,R133,R136,R137,R138,R139,R140,R141,R148,R149,R152,R153,R217,R219,R221,R222,R223,R224,R34,R66,R81,R82,R83,R84,R85,R86,R87,R88,R89,R90,R91,R93,R94 | 0805 | C17784
0 | R145,R147,R156,R157,R158,R159,R160,R161,R162,R163,R164,R165,R166,R167,R168,R169,R170,R171,R172,R173,R174,R175,R176,R177,R178,R179,R180,R181,R186,R187,R188,R189,R190,R191,R193,R194,R197,R198,R201,R202,R206,R213,R216,R64 | 0805 | C17477
BAV99S | D1,D2,D3,D4,D6,D7,D8,D9 | SOT-363_SC-70-6 | C20416655
STM32G474QET6 | U1 | LQFP-128_14x14mm_P0.4mm | C730129
SN74HC21DR1G4 | U55,U56 | SOIC-14_3.9x8.7mm_P1.27mm | C75398
Conn_01x30_Pin | J21 | PinHeader_2x15_P2.54mm_Vertical | C56496
SN74LVC2G14DBVR | U16,U18,U20,U48,U51,U57,U72 | SOT-23-6 | C19829673
CMKD4448 | D17,D18,D19,D20 | SOT-363_SC-70-6 | C5362113
62 | R100,R101,R102,R115,R123,R124,R15,R16,R17,R18,R19,R20,R204,R205,R207,R21,R22,R23,R24,R25,R26,R51,R52,R53,R54,R55,R56,R57,R58,R59,R60,R61,R62,R68,R69,R70,R72,R73,R75,R77,R78,R79,R80,R95,R96,R97,R98,R99 | 1206 | C17971
5K | R1,R10,R11,R12,R13,R14,R2,R209,R3,R30,R31,R4,R41,R5,R6,R63,R65,R9,R92 | 0805 | C2828783
W25Q128JVS | U2 | SOIC-8_5.3x5.3mm_P1.27mm | C97521
