everettpenne/WHAM-CONTROLLERS/hardware/PFM-Controller_V4/PFMV4_Prelim_Files-main/production/bom.csv

Designator | Footprint | Quantity | Value | LCSC Part #
C100, C101, C102, C103, C104, C105, C112, C116, C117, C118, C124, C125, C126, C127, C129, C130, C31, C61, C62, C63, C64, C65, C66, C67, C68, C69, C70, C71, C72, C73, C74, C75, C76, C77, C78, C79, C80, C81, C82, C83, C84, C85, C86, C87, C88, C89, C90, C91, C92, C93, C94, C95, C96, C97, C98, C99 | 0805 | 56 | 100n
C106, C107, C108, C109, C110, C111, C114, C120, C131, C132, C133, C134, C135, C136, C137, C147, C148, C149, C150, C151, C152, C153 | 1206 | 22 | 100n
C113, C119, C123, C33, C36, C37, C38, C39, C40, C41, C42, C43, C48 | 0603 | 13 | 100n
C44 | 0603 | 1 | 10u
C45, C47 | 0603 | 2 | 1u
C46 | 0603 | 1 | 10n
C59 | 1206 | 1 | 10n
C60 | 1206 | 1 | 1u
D1, D2, D3, D4, D6, D7, D8, D9 | SOT-363_SC-70-6 | 8 | BAV99S
D17, D18, D19, D20 | SOT-363_SC-70-6 | 4 | CMKD4448
D5 | D_SOD-123 | 1 | 1N4148W
IC1, IC10, IC11, IC12, IC13, IC14, IC15, IC16, IC17, IC18, IC19, IC2, IC20, IC21, IC3, IC4, IC5, IC6, IC7, IC8, IC9 | SOIC-8_3.9x4.9mm_P1.27mm | 21 | IX4340NTR
J13 | Molex_KK-396_5273-04A_1x04_P3.96mm_Vertical | 1 | Conn_01x04_Pin
J21 | PinHeader_2x15_P2.54mm_Vertical | 1 | Conn_01x30_Pin
J22 | PinHeader_2x08_P2.54mm_Vertical | 1 | Conn_01x16_Pin
R1, R10, R11, R12, R13, R14, R2, R209, R3, R30, R31, R4, R41, R5, R6, R63, R65, R9, R92 | 0805 | 19 | 5K
R100, R101, R102, R115, R123, R124, R15, R16, R17, R18, R19, R20, R204, R205, R207, R21, R22, R23, R24, R25, R26, R51, R52, R53, R54, R55, R56, R57, R58, R59, R60, R61, R62, R68, R69, R70, R72, R73, R75, R77, R78, R79, R80, R95, R96, R97, R98, R99 | 1206 | 48 | 62
R103, R105, R107, R109, R111, R113, R116, R118 | 1206 | 8 | 2.5K
R104, R106, R108, R110, R112, R114, R117, R119, R27, R28, R29, R32, R33, R46, R47, R7, R71, R74, R76 | 1206 | 19 | 5K
R120, R121, R122, R133, R136, R137, R138, R139, R140, R141, R148, R149, R152, R153, R217, R219, R221, R222, R223, R224, R34, R66, R81, R82, R83, R84, R85, R86, R87, R88, R89, R90, R91, R93, R94 | 0805 | 35 | 62
R145, R147, R156, R157, R158, R159, R160, R161, R162, R163, R164, R165, R166, R167, R168, R169, R170, R171, R172, R173, R174, R175, R176, R177, R178, R179, R180, R181, R186, R187, R188, R189, R190, R191, R193, R194, R197, R198, R201, R202, R206, R213, R216 | 0805 | 43 | 0
R182, R183 | 1206 | 2 | R
R212, R49, R50 | 1206 | 3 | 0
R42 | 1206 | 1 | 10K
R43, R44 | 1206 | 2 | 100K
R45 | 0603 | 1 | 20
U1 | LQFP-128_14x14mm_P0.4mm | 1 | STM32G474QET6
U10, U11, U12, U13, U14, U15, U4, U5, U6, U7, U8, U9 | Versalink-Vertical | 12 | VersalinkTX
U16, U18, U20, U48, U51, U57, U72 | SOT-23-6 | 7 | SN74LVC2G14DBVR
U17, U19, U21, U49, U71, U73, U74 | TSSOP-8_4.4x3mm_P0.65mm | 7 | SN74LVC2G08DCUT
U2 | SOIC-8_5.3x5.3mm_P1.27mm | 1 | W25Q128JVS
U22, U23, U24, U25, U26, U27, U28, U29, U30, U31, U32, U33, U36, U37, U38, U39, U40, U41, U42, U43, U44, U45, U46, U47, U50, U52, U78, U79 | Versalink-Vertical | 28 | VersalinkRX
U3, U34, U35, U75, U76, U77 | TSSOP-14_4.4x5mm_P0.65mm | 6 | MCP6009
U53, U54, U80, U81, U82 | SOIC-14_3.9x8.7mm_P1.27mm | 5 | 74HC14
U55, U56 | SOIC-14_3.9x8.7mm_P1.27mm | 2 | SN74HC21DR1G4
U58 | Versalink-Vertical | 1 | GPOut_01
U59 | Versalink-Vertical | 1 | GPOut_02
U60 | Versalink-Vertical | 1 | GPOut_03
U61 | Versalink-Vertical | 1 | GPOut_04
U62 | Versalink-Vertical | 1 | GPOut_05
U63 | Versalink-Vertical | 1 | GPOut_06
U64 | Versalink-Vertical | 1 | GPOut_07
U65 | Versalink-Vertical | 1 | GPOut_08
U66 | Versalink-Vertical | 1 | GPOut_09
U67 | Versalink-Vertical | 1 | GPOut_10
U68 | Versalink-Vertical | 1 | GPOut_11
U69 | Versalink-Vertical | 1 | GPOut_12
U70 | TO-252-3_TabPin2 | 1 | AMS1117CD-3.3
