everettpenne/WHAM-CONTROLLERS/hardware/HVPS_Controller_V3/production/bom.csv

Designator | Footprint | Quantity | Value | LCSC Part #
C100, C101, C102, C103, C104, C105, C106, C107, C108, C112, C115, C116, C117, C118, C119, C120, C31, C33, C36, C37, C38, C39, C40, C41, C42, C43, C48, C61, C62, C63, C64, C65, C66, C67, C68, C69, C70, C71, C72, C73, C74, C75, C76, C77, C78, C79, C80, C81, C82, C83, C84, C85, C86, C87, C88, C89, C90, C91, C92, C93, C94, C95, C96, C97, C98, C99 | 0805 | 66 | 100n
C109, C110, C111, C114, C121, C122, C17, C18, C19, C20, C21, C22, C23, C24, C25, C26, C27, C28, C34, C35, C59, C60 | 1206 | 22 | 100n
C44 | 0805 | 1 | 10u
C45, C47 | 0805 | 2 | 1u
C46 | 0805 | 1 | 10n
D1, D2, D3, D4 | SOT-363_SC-70-6 | 4 | BAV99S
D17, D18, D19, D20 | SOT-363_SC-70-6 | 4 | CMKD4448
IC1, IC10, IC11, IC12, IC13, IC14, IC15, IC16, IC17, IC18, IC2, IC3, IC4, IC5, IC6, IC7, IC8, IC9 | SOIC-8_5.3x5.3mm_P1.27mm | 18 | IX4340NTR
J14 | PinHeader_1x03_P2.54mm_Vertical | 1 | Jumper
J9 | Molex_KK-396_5273-02A_1x02_P3.96mm_Vertical | 1 | Molex 01x02
R1, R124, R2, R3, R30, R31, R32, R33, R4, R5, R6, R63, R65, R7, R8, R92, R94 | 0805 | 17 | 5K
R100, R101, R102, R133, R134, R135, R136, R137, R138, R139, R140, R141, R142, R143, R144, R145, R146, R147, R148, R149, R15, R150, R151, R152, R153, R154, R155, R16, R17, R18, R19, R20, R21, R22, R23, R24, R25, R26, R51, R52, R53, R54, R55, R56, R57, R58, R59, R60, R61, R62, R68, R69, R70, R72, R73, R75, R77, R79, R93, R95, R96, R97, R98, R99 | 1206 | 64 | 62
R103, R105, R107, R109, R111, R113, R115, R117 | 1206 | 8 | 2.5K
R104, R106, R108, R110, R112, R114, R116, R118, R27, R28, R29, R71, R74, R76, R78, R80 | 1206 | 16 | 5K
R119, R120, R121, R122, R125, R126, R127, R128, R129, R130, R131, R132, R34, R66, R81, R82, R83, R84, R85, R86, R87, R88, R89, R90, R91 | 0805 | 25 | 62
R123 | 0805 | 1 | 2.5K
U1 | LQFP-128_14x14mm_P0.4mm | 1 | STM32G474QET6
U10, U11, U12, U13, U14, U15, U4, U5, U6, U7, U8, U9 | Versalink-Vertical | 12 | VersalinkTX
U16, U18, U20, U57 | SOT-23-6 | 4 | SN74LVC2G14DBVR
U17, U19, U21, U74 | SOP50P310X90-8N | 4 | SN74LVC2G08DCUT
U22, U23, U24, U25, U26, U27, U28, U29, U30, U31, U32, U33, U36, U37, U38, U39, U40, U41, U42, U43, U44, U45, U46, U47, U50, U52, U78 | Versalink-Vertical | 27 | VersalinkRX
U3, U34, U35 | TSSOP-14_4.4x5mm_P0.65mm | 3 | MCP6009
U53, U54, U80, U81, U82 | SOIC-14_3.9x8.7mm_P1.27mm | 5 | 74HC14
U55, U56 | SOIC-14_3.9x8.7mm_P1.27mm | 2 | SN74HC21DR1G4
U58 | Versalink-Vertical | 1 | GPOut_01
U59 | Versalink-Vertical | 1 | GPOut_02
U60 | Versalink-Vertical | 1 | GPOut_03
U61 | Versalink-Vertical | 1 | GPOut_04
U62 | Versalink-Vertical | 1 | GPOut_05
U63 | Versalink-Vertical | 1 | GPOut_06
U64 | Versalink-Vertical | 1 | GPOut_07
U65 | Versalink-Vertical | 1 | GPOut_08
U66 | Versalink-Vertical | 1 | GPOut_09
U67 | Versalink-Vertical | 1 | GPOut_10
U68 | Versalink-Vertical | 1 | GPOut_11
U69 | Versalink-Vertical | 1 | GPOut_12
U70 | TO-252-3_TabPin2 | 1 | AMS1117CD-3.3
