everettpenne/WHAM-CONTROLLERS/hardware/PFM-Controller_V4/PFMV4_Prelim_Files-main/jlc_fabrication/cost-estimate.png

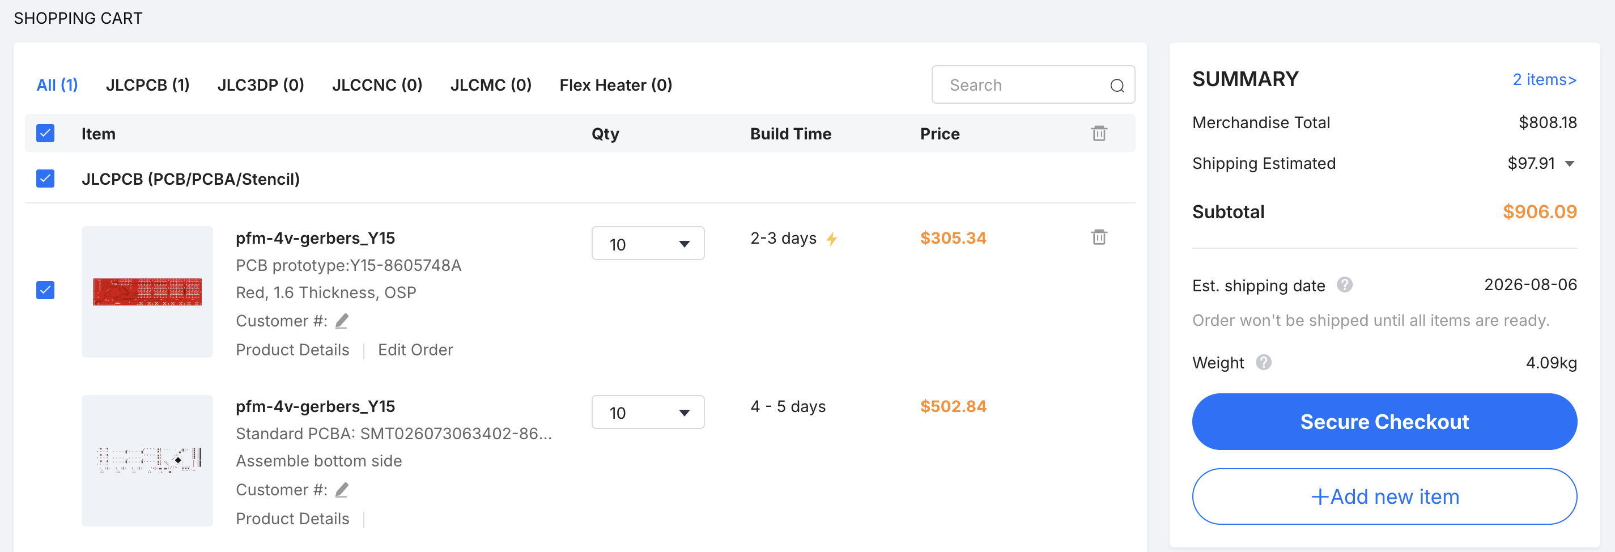
hardware/PFM-Controller_V4/PFMV4_Prelim_Files-main/jlc_fabrication/cost-estimate.png
