everettpenne/WHAM-CONTROLLERS/hardware/PFM-Controller_V4/PFMV4_Prelim_Files-main/KiCAD/PFM-Controller_V4/PFM-Controller_V4.step

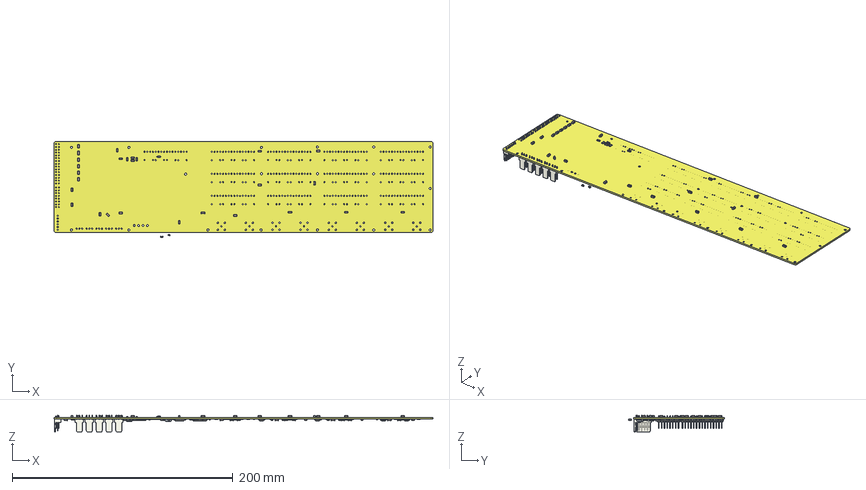
[picture p28: CAD file, 2026-10-29]
hardware/PFM-Controller_V4/PFMV4_Prelim_Files-main/KiCAD/PFM-Controller_V4/PFM-Controller_V4.step
343.6 x 87.2 x 15.3 mm
C_1206_3216Metric x 40
R_1206_3216Metric x 92
D_SOD-123
R_0805_2012Metric x 126
SOIC-14_3.9x8.7mm_P1.27mm x 7
C_0805_2012Metric x 58
SOT-363_SC-70-6 x 12
C_0603_1608Metric x 13
SOIC-8_5.3x5.3mm_P1.27mm
L_1206_3216Metric x 27
SOT-23-6 x 7
SOIC-8_3.9x4.9mm_P1.27mm x 21
TSSOP-14_4.4x5mm_P0.65mm x 6
TSSOP-8_4.4x3mm_P0.65mm x 7
LQFP-128_14x14mm_P0.4mm
Crystal_SMD_3225-4Pin_3.2x2.5mm_HandSoldering
PinHeader_2x15_P2.54mm_Vertical
R_0603_1608Metric x 5
Molex_KK-254_AE-6410-03A_1x03_P2.54mm_Vertical x 5
Molex_KK-254_AE-6410-06A_1x06_P2.54mm_Vertical
PFM-Controller_V4 1.412.1
PinHeader_2x08_P2.54mm_Vertical
PFM-Controller_V4_PCB
