everettpenne/WHAM-CONTROLLERS/hardware/PFM-Controller_V4/PFMV4_Prelim_Files-main/jlc_fabrication/product-detail.png

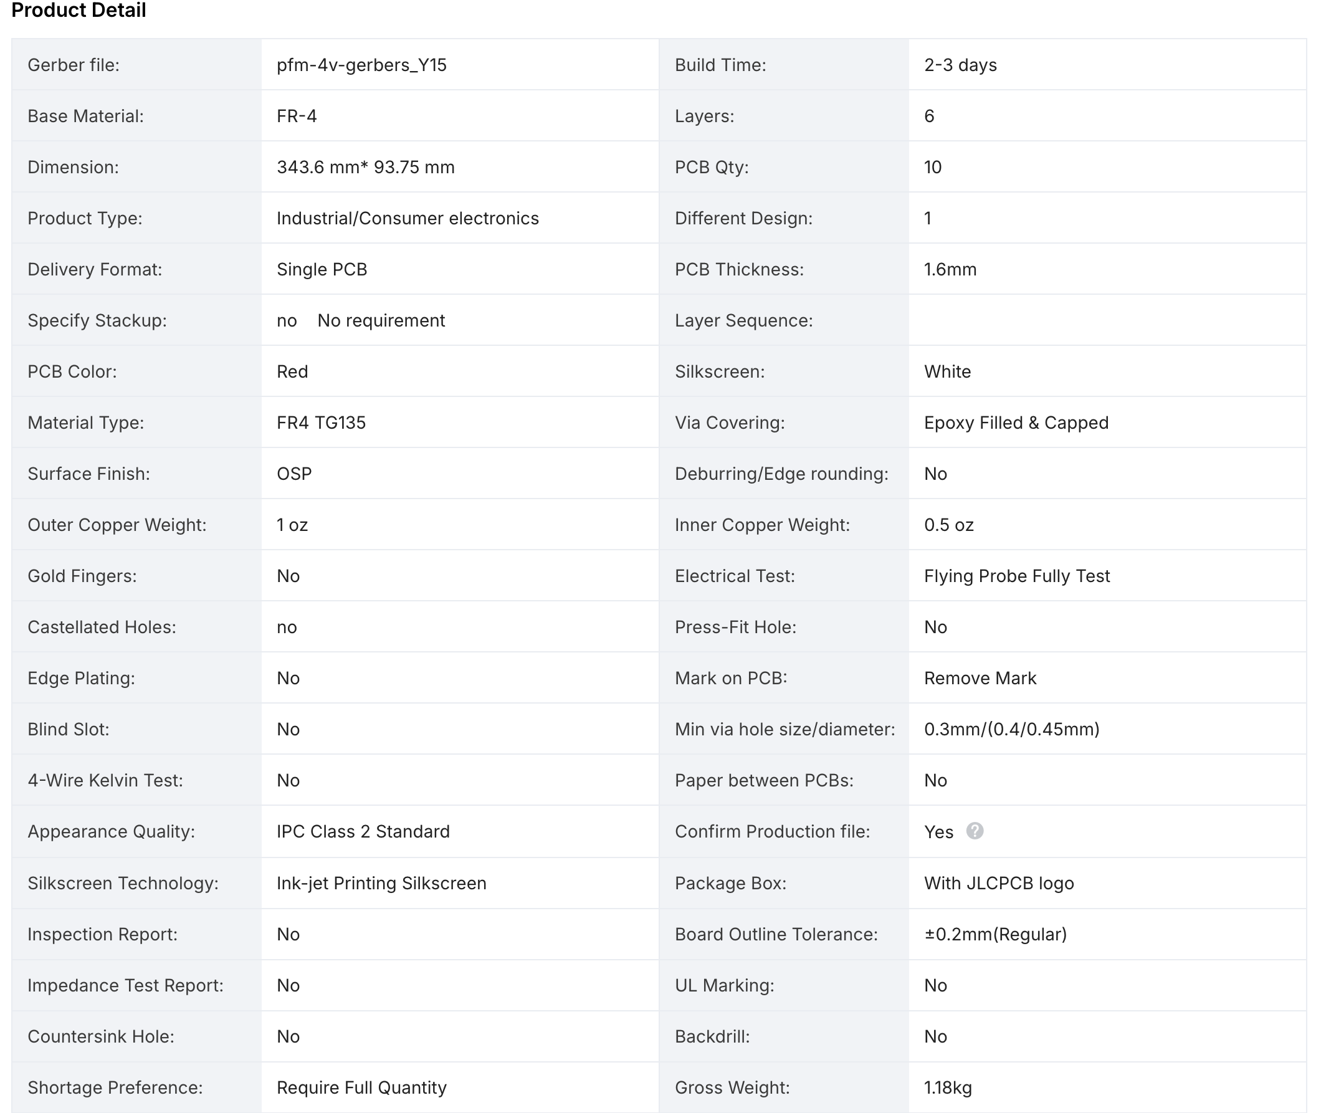
hardware/PFM-Controller_V4/PFMV4_Prelim_Files-main/jlc_fabrication/product-detail.png
