everettpenne/WHAM-CONTROLLERS/firmware/hbridge/docs/examples/limiter_per_phase_duty_shot/measured_duty.csv

phase | cycle | time_us | period_us | high_us | measured_duty_pct | measured_carrier_hz | programmed_duty_pct | flag
U | 0 | 0.0 | 15.7 | 7.5235 | 47.921 | 63694.3 | 20.0 | startup
U | 1 | 15.7 | 10.0 | 1.8176 | 18.176 | 100000.0 | 20.094
U | 2 | 25.7 | 9.9941 | 1.8176 | 18.187 | 100058.9 | 20.154
U | 3 | 35.694 | 9.9941 | 1.8235 | 18.246 | 100058.9 | 20.214
U | 4 | 45.688 | 9.9882 | 1.8353 | 18.375 | 100117.8 | 20.274
U | 5 | 55.676 | 10.0 | 1.8412 | 18.412 | 100000.0 | 20.334
U | 6 | 65.676 | 9.9941 | 1.8412 | 18.423 | 100058.9 | 20.394
U | 7 | 75.671 | 9.9941 | 1.8471 | 18.481 | 100058.9 | 20.454
U | 8 | 85.665 | 9.9941 | 1.8529 | 18.54 | 100058.9 | 20.514
U | 9 | 95.659 | 9.9941 | 1.8588 | 18.599 | 100058.9 | 20.574
U | 10 | 105.653 | 9.9941 | 1.8647 | 18.658 | 100058.9 | 20.634
U | 11 | 115.647 | 9.9941 | 1.8706 | 18.717 | 100058.9 | 20.694
U | 12 | 125.641 | 9.9941 | 1.8765 | 18.776 | 100058.9 | 20.754
U | 13 | 135.635 | 9.9941 | 1.8824 | 18.835 | 100058.9 | 20.814
U | 14 | 145.629 | 9.9941 | 1.8882 | 18.893 | 100058.9 | 20.874
U | 15 | 155.624 | 9.9941 | 1.8941 | 18.952 | 100058.9 | 20.934
U | 16 | 165.618 | 9.9941 | 1.9 | 19.011 | 100058.9 | 20.994
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
