everettpenne/WHAM-CONTROLLERS/firmware/xrex/docs/changelog.txt

WHAM-XREX-PFMG474 Firmware Changelog
=====================================

2026-11-09  -  The live !EVT stream is OFF by default (SYS:EVENT 0 at every boot)
-----------------------------------------------------------------------
  Request: turn off system event reporting by default. telemetry.c: TELEM_EVENT_DEFAULT_ENABLED 0, used by the static initialiser and Telemetry_Init(). SYS:EVENT 1 turns
  the stream on until the next reset; the flight recorder (SYS:EVLOG?) records every event regardless, so nothing is lost for post-mortem. Not stored in a profile.
  Consequences to know about: LabVIEW and the hub no longer get STATE/FAULT pushes unless they send SYS:EVENT 1 after each connect or !BOOT (poll STATE? meanwhile);
  the hub's own log loses its "event" rows (shot start/end, faults) for this controller; wham_console prints live events only once the stream is on.
  Docs updated: command_reference, labview_interface, telemetry, SOP, docs/labview_commands, docs/labview_state_and_faults.

2026-11-09  -  Raw capture of a refused line (DIAGnostic:UART:REJect?); line counters in DIAGnostic:UART?  [XREX only; HBRIDGE's uart.c now differs]
-----------------------------------------------------------------------
  A real LabVIEW shot on the receive-recovery image (7577bf7d) kept the hub connected, but one valid poll, SOURce:STATus? 3 at 16:25:54.707, in the
  ramp-up came back "ERR 1 Unknown command" while DIAGnostic:UART? read all zeros (no overrun, framing, noise or parity error). So no byte was lost to
  an overrun; either a byte was changed or lost before the UART (bridge, wiring) without any flag, or the controller mangled the line.
  New: DIAGnostic:UART:REJect? -> OK COUNT=<n> LEN=<n> HEX=<hex> TEXT=<text>: the last line refused as ERR 1, as received (copied in Commands_Dispatch before the
  parser works on it; new rejected_line.c/.h, tests/test_rejected_line.c, 17 checks). Compare it with what the hub log says the client sent: different =
  the link changed it; identical = the controller refused a good line.
  DIAGnostic:UART? gains LINES (complete lines received), CLOBBERED (a line completed while the previous one was still waiting or being run by the parser,
  which works in place on the shared line buffer: a race, expected 0) and REJECTED. uart.c now keeps the true line length (memcpy, not strcpy: a NUL byte
  no longer cuts a received line short) -- XREX only for now, so src/bsp/stm32g4/uart.c, uart_hw.h and src/drivers/uart.h differ from HBRIDGE's copies
  until the same change is carried over.

2026-11-09  -  Serial receive can no longer be switched off by an overrun; USART2 interrupt priority 3 -> 2; DIAGnostic:UART?
-----------------------------------------------------------------------
  Found from the hub's log of a LabVIEW shot on the bench XREX (WB-0003-4), 16:02: LabVIEW polled ~10 commands/s during FIRING; valid polls started
  returning "ERR 1 Unknown command" (bytes lost), then the controller stopped answering altogether while still sending its own !EVT lines. The hub timed
  out and closed its link ("the controller is not connected"); the board was powered the whole time and needed a power cycle. The same garbling had already
  appeared during FIRING at 14:53 and 15:00 on the previous image, so it is not a regression of the fault-polling change.
  Cause (from the logs and code; the first hardware confirmation is DIAGnostic:UART? after a shot): the single-byte USART2 receive interrupt had to wait
  more than one byte time (87 us at 115200) behind other interrupts, so a byte was overrun. The HAL treats an overrun as blocking: it ENDS the receive and
  calls HAL_UART_ErrorCallback, which this firmware did not define, so nothing re-armed it and the port stayed deaf (transmit unaffected) until power-off.
  Fix, in uart.c (byte-identical in both products) and stm32g4xx_it.c: HAL_UART_ErrorCallback -> uart_error_callback() counts the error, drops the partial
  line (a byte is missing from it) and re-arms; uart_take_line() (polled every main-loop pass) also re-arms if the receive is not running. New query
  DIAGnostic:UART? -> OK OVERRUN=.. FRAMING=.. NOISE=.. PARITY=.. REARMED=.. (command_reference.md).
  Priority: USART2 was 3, the same level as the capture-DMA batch ISRs (every 16 edges per channel, more of them as a shot's frequency rises); now 2, above them
  and below HRTIM1_Master and the fault EXTI lines (1).
  Verified: host suite green, builds with no warnings. See the commit for what was flashed and what the board showed.

2026-11-09  -  Water/Temp/Enerpro polled like overcurrent; STATE? lists every measured fault (ACTIVE=)
-----------------------------------------------------------------------
  Found on the bench: XR1 enabled and armed with its water pin (PE0) pulled LOW, and no fault. Water, Temp and Enerpro (GateDriverStatus PE0..PE11) were only
  evaluated on a pin EDGE (EXTI), once at boot and by FAULT:CLEAR while already in FAULT, so a pin that was already at its fault level when a channel was
  enabled or armed never produced an edge and was never looked at. Overcurrent and ENA_OUT/CONTACT_OUT had no such gap (polled from the main loop, PID_Update()
  and boot).
  Now: XrexIo_PollGateDriverFaults() -> GateDriver_PollFault() is called next to XrexIo_PollOcpFaults() in task_faults.c, PID_Update() and the boot block of
  app.c. A fault found by polling force-stops only when nothing is latched yet (the EXTI path is unchanged); Enerpro reports through SM_ReportEnerproFault() as
  before. A disabled channel's pins are still ignored; the simulator build still treats PE0..PE11 as its gating inputs (no polling there).
  STATE? while faulted ends with " ACTIVE=<list>": every fault measured (WATER<n>, TMP<n>, ENERPRO<n>, OCP<n>, ENABLE_OUTPUT<n>, EXTERNAL_ENABLE, PC10, TEST;
  channels 1-based; NONE if empty), kept by state_machine.c (SM_NoteFaults()/SM_GetActiveFaults(), a bit mask), emptied by a successful FAULT:CLEAR, not recorded
  under DEBUG:FAULT:BYPASS. The words before it (FAULT <TYPE> [ch]) are unchanged, so existing parsers (operator UI, LabVIEW) that read the first words keep working.
  The !EVT fault line still names only the first fault; FAULT:SOURces? was not added to XREX.
  New: src/app/protection/fault_mask.c/.h (pure: raw pin levels + polarity + enabled channels -> mask; mask -> names), tests/test_fault_mask.c (51 checks).
  Verified: host suite green, controller and simulator build with no warnings. NOT DONE: not flashed to any board (the bench XREX board runs an older image);
  nothing seen on real pins yet.

2026-10-20  -  Operator's guide; LabVIEW interface note about the hub (documentation only, no firmware change)
-----------------------------------------------------------------------
  New: docs/operators_guide.md (the system architecture from the Transrex upgrade plan, the safety model, step-by-step shot procedures, fault response, what is verified).
  docs/labview_interface.md: a note at the top that LabVIEW now connects through the hub and to ignore the serial parameters; points at the three LabVIEW guides at the repository top.
  Observed: docs/command_reference.md says the log holds 1000 samples; PID_LOG_MAX_SAMPLES in pid.h is 1750 (the LabVIEW file was right).

2026-10-15  -  net_client.py asks the host service to timestamp every line (host tools only, no firmware change)
-----------------------------------------------------------------------
  python/net_client.py (identical in both products) now sends "!hub timestamps on" after its "@name" line in interactive mode, so a person typing at it sees
        [HH:MM:SS.mmm] before every line when it is connected to host/wham_hub.py (--no-timestamps for net_broker.py, which does not know the command; one-shot
        --send mode is never stamped). The service side, in host/wham_hub.py, is per connection and off by default so fw_update.py, wham_console.py and
        LabVIEW still get bare lines.

2026-10-14  -  Shared SCPI layer: Scpi_ReplyU32List, one list reply of any length; PFM:GAPLOG? uses it; shared tests build under gcc 13
-----------------------------------------------------------------------
  HBRIDGE's PFM:GAPLOG? overran its 2600-byte reply buffer for a long gap log (up to 3800 entries there). XREX's copy of the handler is safe at
  PFM_INPUT_MAX_PERIODS = 200 but had the same construction, so it now uses the shared Scpi_ReplyU32List too: one line of any length, sent in pieces from a
  64-byte stack buffer (the 2600-byte static buffer is gone). profile_store.c (shared) no longer compares an int with sizeof, which gcc 13 rejects under -Werror. Host suite all green.
  NOT DONE: the images in build/ are not rebuilt from this source (no arm-none-eabi toolchain on the machine that made the change); run python/wham_build.py.

2026-10-13  —  Shared SCPI layer: an over-long error message no longer swallows the line terminator
-----------------------------------------------------------------------
  Found on the HBRIDGE bench: Scpi_SendErr formatted "ERR <code> <msg>\r\n" into a 128-byte buffer, so a message longer than about 118 characters was cut
  without its CR LF and the next reply ran into it. It is now cut, marked "..." and still terminated (src/middleware/scpi/scpi_util.c, byte-identical in both
  products; test_scpi_util gains 6 checks). XREX messages are shorter than that today, so nothing visible changes; the XREX images are rebuilt.

2026-10-07  —  Device identity, step 2: the persistent serial (SYS:SERial, SYS:LABel, SYS:ID:CLEar), host provisioning tool; flash unique-ID read fixed
-----------------------------------------------------------------------
  Request: continue the device-identity plan (docs/device_identity_and_host_service.md, repository top level).
  Firmware (src/app/settings/device_identity.c, shared byte-identical, check_shared.py): an 88-byte record (magic WID1, sequence, serial, label, the MCU UID
        and flash UID it was written for, CRC-32) in two alternating copies in two reserved sectors, 0xFFD000 and 0xFFE000 (NVSTORE_IDENTITY_ADDR; the last sector
        stays the QSPI:SELFtest scratch). A write erases the copy that is NOT the newest valid one, so a power cut leaves the previous record (host test: a cut at every one
        of the ~90 flash operations of an update, and of a first write). `verified` = written for THIS MCU and THIS flash chip; identity = unset|ok|corrupt|nochip.
        nvstore refuses every erase/program that touches those sectors (NVSTORE_ERR_RESERVED) unless NvStore_IdentityWriteEnable(1), which only the identity
        module sets around its own writes; profile_store.h now refuses to build if the profile slots reach the identity sectors.
        Commands (identical in both products): SYS:SERial <sn> (once; ERR 19 if one exists), SYS:SERial?, SYS:LABel <token|->, SYS:LABel?, SYS:ID:CLEar CONFIRM; writes only
        while IDLE (ERR 13); new shared error code 19 ERR_IDENTITY. SYS:ID? gains identity=; *IDN? and !BOOT now carry the real serial. tests/test_device_identity.c: 331 checks.
  Host: host/provision_board.py (reads *IDN?/SYS:ID?, picks the registry's serial for this hardware or the next WB-NNNN-C with a Luhn check digit, asks, writes, reads back
        and requires verified=1, appends to host/devices.csv; --check, --list, --serial, --label, --no-registry; never clears a serial), host/tests (6 checks).
  BUG FOUND ON HARDWARE (step 1's flash unique ID): the W25Q128 unique-ID command (0x4B) needs 32 dummy clocks, but the QUADSPI dummy-cycle field holds only 0..31, so my 32
        wrapped to 0 and the first four "ID" bytes were the chip's dummy bytes: they read 00000000 on one boot and FFFFFFFF on the next (the step 1 entry's
        "00000000E4653C34" was therefore wrong). Found when the ID changed between boots and confirmed with a temporary DIAGnostic that read 16 bytes with dummy counts
        0..64: the stream repeats every 8 bytes, E4 65 3C 34 CB 17 2E 22, and 32/40/48/64 behave exactly like 0/8/16/0. Fix: no dummy cycles, read 12 bytes, drop the first 4.
        The real 64-bit ID of the simulator board's chip is E4653C34CB172E22 and is stable. (A serial provisioned on the broken ID read verified=0 after the fix --
        the binding check doing its job.)
  Verified on the simulator board (HBRIDGE image): all error paths; provisioning through the tool (next serial WB-0001-8 with a scratch registry; re-provisioning after a clear
        reused the registry's serial); the serial, label, both IDs and verified=1 intact across two firmware-update reboots (both flash banks); QSPI:SELFtest, *SAV/*RCL and the profile catalog
        unaffected. The board was left UNSET (SYS:ID:CLEar CONFIRM) and the scratch registry was not kept: no real serial has been assigned. XREX built, unit-tested, NOT flashed.

2026-10-07  —  Device identity, step 1: which physical board is this (read-only hardware ID)
-----------------------------------------------------------------------
  Request: a unique, persistent identifier per board so a host service can tell which board it is talking to (several copies will be
  deployed, each controlling a different system). Plan and host-service design: docs/device_identity_and_host_service.md at the top of the
  WHAM-CONTROLLERS repository (new this day: firmware/xrex + firmware/hbridge with their histories, hardware/, host/, docs/).
  Step 1 (this entry): read-only hardware identity, no flash writes.
  device_id.h/.c (MCU 96-bit unique ID), NvStore_ReadUniqueId() (W25Q128 instruction 0x4B, four dummy bytes, 64 bits), device_identity.h/.c
  (src/app/settings: reads both, keeps the flash ID once good, rejects all-0/all-1 as "no chip", formats SN=/UID= and the SYS:ID? line) --
  all byte-identical in both products (check_shared.py), tests/test_device_identity.c (17 checks, both products).
  *IDN? and the !BOOT banner end with "SN=UNSET UID=<24 hex>"; new SYS:ID? -> "OK serial=UNSET uid=... flashuid=... product=... hw=... fw=... commit=... label=- verified=0".
  Verified on the simulator board (HBRIDGE image, bank swap by FWUPdate): banner, *IDN? and SYS:ID? as above, stable over repeated queries, saved profiles
  intact. The flash unique ID read 00000000E4653C34 here -- WRONG, see the step 2 entry (the first four bytes were the chip's dummy bytes). XREX built
  (controller and simulator images) and unit-tested but not flashed.
  Design notes recorded in the doc: the identity region (step 2) must not use the chip's last sector (the QSPI:SELFtest scratch sector, NVSTORE_SCRATCH_ADDR);
  commands are under SYS: (XREX already has SYS:TIME?/TELEM?/EVENT/EVLOG?), not SYSTem:.

2026-10-07  —  Front-panel LEDs: UART activity and operating state (branch scpi-shared; same change in both repos)
-----------------------------------------------------------------------
  Request: pin map entries and firmware for six LEDs (new hardware revision): PD2 UART_TX_LED, PD3 UART_RX_LED, PF14 STATE_IDLE_LED,
  PF2 STATE_ARMED_LED, PC3 STATE_FIRING_LED, PC2 STATE_FAULT_LED; purely cosmetic, DMA where possible, never allowed to disturb the controller.
  docs/pin_mapping_v4.csv: the six rows renamed in the V4 column (Peripheral GPO; XREX also in the "XREX Pin Name" column); XREX's pin_mapping_reference.tex lists them.
  src/drivers/led_indicators.h + src/bsp/stm32g4/led_indicators.c (identical in both repos, in check_shared.py), switch LED_INDICATORS_ENABLED and
  LED_ACTIVITY_MS (30) in ctrlr_config.h.
  State LEDs: state_machine.c now assigns the state ONLY through SetState(), which lights the matching LED in the same step (one BSRR store per GPIO port),
        so an LED is lit if and only if STATE? says so, whichever context made the transition (command, main loop, EXTI, control interrupt). All four are
        off until SM_Init(); a fault latched before it is re-asserted by SM_Init/the first poll. HBRIDGE test_state_machine.c gained a fake LED driver that
        checks, at every update, that the LED shown is the machine's state (161 checks).
  Activity LEDs: uart.c (shared, so any UART instance) pulses TX around every uart_send() (lit at the start AND after the last byte, so a long send does
        not let it lapse) and RX in the receive callback. A pulse = pin on + restart a one-pulse timer (TIM16 TX, TIM17 RX, 10 kHz); the timer's update
        event is a DMA request (DMA1 channels 7 and 8, memory-to-peripheral, circular, one word) that writes the pin's reset bit into GPIOD->BSRR, so the LED goes
        dark 30 ms later with NO interrupt, polling or CPU time -- including while the main loop is inside the blocking transmit. Traffic closer together than
        30 ms keeps the LED lit. TIM16/17 and DMA1 ch 7/8 were unused (pfm_input.c: DMA1 ch 1-6, ADC: DMA2 ch 1). The state LEDs are NOT DMA-driven: they change
        a few times per shot and one register store is cheaper than any DMA setup.
  DIAGnostic:LEDs? (new, cmd_io.c) -> "OK TX=0 RX=0 IDLE=1 ARMED=0 FIRING=0 FAULT=0": the LEDs the firmware is driving lit (output register), the way to check
        the logic without LEDs fitted.
  Verified: both repos build with no warnings (XREX controller + simulator, HBRIDGE), host tests pass, check_shared OK. NOT yet verified on hardware: the
        DMA turn-off and the pin levels (bench needs the tunnel; no LEDs are fitted on the current boards) -- see the verification note below if added.

2026-10-05  —  SCPI protocol layer shared with HBRIDGE: strict arguments, shared reply helpers and error codes (branch scpi-shared)
-----------------------------------------------------------------------
  Request: compare the two SCPI command libraries and bring them into harmony (steps A and B of that comparison).
  The parser, its tests and the fake UART were already byte-identical; the differences were in the command layer. Done:
  A  scpi_err.h -- the error-code enum is ONE shared header (codes 10/11/14-16 differ only in meaning, now written for both products;
        ERR_CARRIER_TOO_HIGH stays as XREX's name for code 10); docs/scpi_conventions.md -- the single description of framing, replies,
        error codes (with a "used by" column), mnemonic matching, strict arguments, how to write a handler, and where the two command sets
        overlap but differ (53 shared mnemonics, 8 with different meaning/units: SOURce:SETpoint Hz vs V, PID:LOOPMODE default, LOG:DATA? streamed vs
        paged, SHOT:* ...); each command_reference.md now points there instead of carrying its own copy; tests/test_command_table.c is one shared
        file (each product's known short-form collisions live in tests/known_short_collisions.inc: XREX 6 entries, HBRIDGE none);
        python/check_shared.py now also compares the parser, scpi_util, scpi_err, the tests and the two shared docs (the formatter blocks it
        compared before are gone: the function moved whole).
  B  src/middleware/scpi/scpi_util.c/.h (+ test_scpi_util.c, 20,201 checks) -- reply builders (Scpi_SendErr, ReplyOk, ReplyFixed, ReplyFloat/Float3,
        ReplySet), STRICT argument parsing (Scpi_ParseLong/Float/Bool/Scaled/Unsigned; the whole token must be the number: "12x", "abc", "1.5" for an
        integer, "nan", "0x10" are refused), handler shorthands (SCPI_NEED_LONG/FLOAT with an optional per-command error code, explicit Scpi_GetLong/
        GetFloat for value-returning helpers), the SCPI_FLOAT_SETTING generator, and number text with no printf float support (Scpi_FormatFixed,
        Scpi_FormatFloat = the %g formatter that had lived in settings_codec). SendErr is now Scpi_SendErr everywhere.
  XREX: all 79 atol/atoi/atof argument sites are strict (SCPI_NEED_LONG/FLOAT) and keep each command's documented error code (ERR 11 for a channel
        argument, ERR 8/9 in PFMIN, ERR 4 inside TABle:STEP, else ERR 12); the 53 raw uart_send("OK") became Scpi_ReplyOk; the six "%g" replies
        (PID:GAINS?, CONFig:MAXCURRent?/SLEWRate?/FaultRampTime?, SHOT:CURRent?/TIMing?) use Scpi_ReplyFloat/Float3 -- XREX's command layer no longer
        uses printf floats. The -u _printf_float LINK FLAG IS STILL THERE and was deliberately not touched: nothing under src/ prints a float with printf
        any more, so it can probably be dropped (~6 KB), but that needs a hardware check first.
  BEHAVIOUR CHANGE (valid input is unchanged): a malformed number used to be silently read as 0 or a prefix ("GPOut:ENAble xyz" switched the output OFF;
        "PID:GAINS 1 abc 0 0" set ki to 0); it now answers "ERR 12 not a number: abc" (or the command's own code) and changes nothing.
  NOT YET RUN ON HARDWARE: the XREX simulator board currently runs HBRIDGE firmware (restoring XREX needs the ST-Link). Verified: host tests (scpi_util 20,201,
        command table 249, settings codec 461, profile store 5,413), both firmware targets build with zero warnings, and the same shared module and
        the same call patterns are bench-verified on the HBRIDGE simulator.

2026-10-05  —  Profile store and float formatter now shared with WHAM-HBRIDGE-PFMG474 (branch shared-profile-store)
-----------------------------------------------------------------------
  HBRIDGE ported XREX's saved-profile layers (docs/saved_profiles.md in that repo) and improved them; this carries the improvements back so
  the code is ONE piece in both repos (the boards are the same PCB with the same flash chip):
        profile_store.h/.c   a STREAMING writer (ProfileWriter_Begin/Write/End) and reader (ProfileReader_Open/Read) alongside the buffered
                             ProfileStore_Write/Read (kept as wrappers); a save now writes the header LAST, so a half-written copy reads as empty
                             rather than as a half-valid header (power-fail behaviour is strictly better); the copy size, slot count, region base
                             and magic come from ctrlr_config.h (new "Saved profiles" block, XREX values: 8 slots, 1 sector, base 0, "WSPF" --
                             the layout it has always had); a build error if the slots would reach the QSPI:SELFtest scratch sector; Clear erases
                             only a copy's first sector.
        SettingsCodec_FormatFloat   a printf-free %g (6 significant digits; matches printf on all typical values, sixth digit can differ on ~2 % of
                             arbitrary ones); CONFig:PROFile? and DIFF? text use it. The -u _printf_float link flag STAYS: PID:GAINS? and the
                             other %f replies still need it.
        tests/test_profile_store.c   the shared test (size-independent: large-payload cases use what a copy holds); 5,413 checks. test_settings_codec
                             20,502 (formatter vs printf added).
        python/check_shared.py + docs/saved_profiles_shared.md   the drift check and the flash map / magic registry (XREX 0-64 KiB, HBRIDGE from 64 KiB).
  COMPATIBILITY, checked on the host: the OLD store (main) and the new one, run through the same set of saves (overwrites, a cleared slot, a
  1000-byte payload, a slot saved three times), produce BYTE-IDENTICAL 64 KiB flash images and each reads the other's. Profiles saved by earlier
  firmware (including the simulator board's slots of 2026-09-29) therefore read unchanged. Both firmware targets (controller, simulator) build with
  zero warnings. NOT yet run on hardware: the simulator board currently runs HBRIDGE firmware (restoring the XREX image needs the ST-Link).

2026-09-29  —  Saved settings profiles, step 1: external-flash storage driver (nvstore)
-----------------------------------------------------------------------
  Goal (planned this session): *SAV / *RCL of the operator-configurable settings
        into the board's W25Q128JVS (QUADSPI) so they survive a power cycle. Agreed
        design: several slots, preview before recall (CONFig:PROFile:CATalog? /
        PROFile? / PROFile:DIFF?), explicit load only (never at boot), *SAV and *RCL
        only in IDLE; setpoints, channel enables, the EXTernal:ENAble interlock and
        DEBUG:FAULT:BYPASS are never saved. Test on the simulator first.

  Why the external chip: both internal flash banks belong to the dual-bank firmware
        update (a swap would erase or strand settings kept there), and erasing an
        internal page stalls instruction fetch, freezing the control-loop ISR.

  Step 1 (this entry): src/drivers/nvstore.h + src/bsp/stm32g4/nvstore.c -- a plain
        byte store (read, 4 KiB sector erase, program with page splitting and
        read-back verify, status registers) using the same single-line QUADSPI
        commands the verified Read ID uses. Checks the chip answers EF 40 18 before
        the first operation, refuses to write when block-protect bits are set, and
        bounds every busy-wait by the datasheet maxima. qspi_test.c gained
        QspiTest_Handle() (declared in the new qspi_test_hw.h) so the one QUADSPI
        peripheral is shared. NVSTORE_FEATURE_ENABLED removes it.

  Step 2: QSPI:SELFtest (cmd_system.c) -- IDLE-only bench test on the last sector of
        the chip: status registers, erase, a 300-byte pattern that crosses a page
        boundary, whole-sector read-back (pattern + everything else still 0xFF), erase.
        Reports OK PASS with the status registers and timings.
        RESULT, SIMULATOR (flashed over the network with fw_update.py, v0.8i, bank 1
        -> 2, banner ok): PASS 4 of 4 runs -- erase 58-63 ms, program of 300 bytes
        1-2 ms, whole-sector read 8-9 ms; status registers 00,02,60 (no block
        protection; SR2 bit 1 = Quad Enable already set; SR3 = 60 is the chip's
        drive-strength default). QSPI:ID? still EF 40 18 afterwards. So erase, program,
        page-boundary handling and status polling all work on real hardware. The
        controller board has NOT been tested (not flashed).

  Steps 3 and 4:
        src/app/settings/settings_codec.{h,c}: the snapshot model and its tagged-record
        encoding [field id][channel][length][value] (unknown ids skipped, missing fields
        left alone, so newer/older firmware can read each other's saves), CRC-32, text
        formatting and comparison. profile_store.{h,c}: 8 slots x 2 alternating 4 KiB
        sectors with header (magic, version, length, sequence, label, firmware, CRC);
        a save writes the copy NOT holding the newest valid data, so a power cut leaves
        the old data intact; clear erases the older copy first. settings.{h,c}: capture
        the live values and apply them back through the existing setters (turn-on/max
        frequency are tried in both orders because each is checked against the other).
        cmd_profile.c: *SAV, *RCL, CONFig:PROFile:CATalog?/PROFile?/DIFF?/CLEar; new
        ERR 18. *SAV/*RCL/CLEar IDLE-only, nothing loaded at boot. PID_ClearChannelNickname()
        added so a profile with no nickname can be recalled over one that has one.
        Not saved: setpoints, channel enables, EXTernal:ENAble, DEBUG:FAULT:BYPASS, run/arm
        actions, and CONFig:MaxCarrierHz (its state is private to the legacy table code).
        Host tests (tests/): test_settings_codec (461 checks) and test_profile_store (5269
        checks, against a RAM NOR-flash fake with a power cut injected at EVERY unit of a
        save and of a clear: the slot always holds exactly the old or exactly the new
        data). Cost: about +9.8 KB flash (float printf paths, codec) and +1.2 KB RAM.
        RESULT, SIMULATOR (v0.8i 1c9701fd, network update): every command exercised over
        the broker -- CATalog? (8 empty), *SAV with label, PROFile? (all 32 values listed),
        DIFF? (SAME right after a save; exactly the changed fields after edits), *RCL
        (APPLIED=32 FAILED=0; the DIFF? afterwards SAME; values confirmed with the normal
        query commands; a nickname cleared back to empty), error paths (empty slot, slot
        0/9/missing, over-long label -> ERR 12/18 as designed), and the turn-on/max
        frequency ordering fallback (saved 5000/10000 recalled over live 60000/90000).
        POWER CYCLE (simulator, real power loss): live settings came back at their defaults
        (gains 0, no nickname, timing unset), CATalog? still listed both saved slots with
        labels, DIFF? 1 listed exactly the saved-vs-default differences, *RCL 1 gave
        APPLIED=32 FAILED=0 and DIFF? then said SAME, and slot 2 was intact. Saved
        profiles survive a power cycle. (Cosmetic: DIFF? shows an unset live shot timing
        as 0.) The controller board has not been tested (not flashed).
        FOUND, PRE-EXISTING, NOT FIXED: the shot timing is stored as loop TICKS, so
        CONFig:PIDRate silently rescales it (SHOT:TIMing 3 3 3 reads back 1.5 1.5 1.5 after
        PIDRate 2000, 6 6 6 after going back to 1000...). Recall applies PIDRate before the
        timing, so profiles restore correctly; the bug itself is in pid.c.

2026-09-29  —  NRST pull-up is a required hardware modification (cured the post-swap
               hang on both boards); SOP Rev G; update-first workflow
-----------------------------------------------------------------------
  Summary (the running 2026-09-28 entry below holds the blow-by-blow, including
        several dead ends and corrections; this entry is the conclusion):

  Problem: network firmware updates (FWUPdate:SWAP), and cold power-ons, sometimes
        left a board silent -- no !BOOT banner, no reply -- until an ST-Link was
        connected. Observed since 2026-09-25.

  Cause: the NRST line. The STM32G474 has no pull-down on NRST, only a weak
        (~40 kOhm) internal pull-up that the reference manual says is disabled during
        every internal reset (RM0440 7.1.2). On these boards something else holds
        the net partway down: NRST measured 1.6 V on the controller while it sat
        silent, between the ~1.0 V (low) and ~2.3 V (high) input thresholds at
        3.3 V, so the chip stayed in reset. A firm external pull-up lifts the same
        divider to ~3 V. (Datasheet threshold values are from memory -- verify
        against DS12288.) The source of the pull-down path is NOT yet identified.

  Fix: a resistor from NRST to +3V3, 5.1 kOhm on the controller (the simulator's
        value is not yet recorded). Do not hard-tie NRST to 3.3 V (tried once, did
        not cure it, and it defeats the chip's internal-reset holder).

  Evidence, ST-Link unplugged throughout:
        CONTROLLER, original option bytes 0xFFFFF8AA, with the 5.1 kOhm: 4 swaps,
        1 full network reflash, a 20-swap soak, a true cold power-on (banner
        rst=PIN,BOR, booted by itself) and 5 swaps after it -- 30 operations, 0
        hangs (logs/soak_controller.log, logs/powercycle_watch.log). Without it:
        hung after an SWD session and stayed silent through a power cycle.
        SIMULATOR, with the user's new pull-up: 16 of 16 swaps clean
        (logs/soak_simulator.log); 8 of 8 hung and then went silent without it.

  Ruled out along the way: the 2026-09-26 reorganization (Friday's firmware hung
        the same way), the option bytes nSWBOOT0 and IRHEN (the controller works
        with the originals), and the swap/update code itself. Floating BOOT0 was a
        real but separate finding (it booted the ROM bootloader on the simulator;
        fixed there by nSWBOOT0=0 -- see the 09-28 entry).

  Documentation: docs/sop/wham_xrex_pfmg474_sop.tex Rev G adds Section 3.3
        (Required Hardware Modification: NRST Pull-Up: why, symptoms, evidence,
        how to check a board, next-revision list), Section 7 (Procedure: Network
        Firmware Update), and three troubleshooting rows; the date now reads
        September 2026. Compiled with pdflatex twice and the new pages inspected as
        images; overfull-box count unchanged at the pre-existing 7.

  Workflow going forward: update boards over the network (python/fw_update.py via
        the broker); the ST-Link is a bring-up and recovery tool. To reach STATE
        IDLE on a bench board (required by the update): EXTernal:ENAble 0 then
        FAULT:CLEAR (the disabled-channels + FAULT:CLEAR route alone is refused
        while the PF13 interlock is on and unwired). The current bodge resistor
        prevents ST-Link use; remove it or put a jumper in series before
        connecting one.

  Recommended for the next board revision (only the first is verified):
        populate a 4.7-5.1 kOhm NRST pull-up on the PCB away from the debug
        header; keep the ESTOP fiber receiver off the NRST net and find the path
        pulling it down; add a ~10 kOhm pull-down on BOOT0 (PB8); consider a reset
        supervisor.

  Not done / open: identify what pulls NRST down; a fresh SWD session followed by
        swaps with the resistor in (blocked by the bodge); record the simulator's
        resistor value; make the modification permanent on both boards; a longer
        soak. All of the 2026-09-26 reorganization plus the v0.8i version bump are
        still uncommitted.

2026-09-28  —  BOOT0 booted the ROM bootloader (found, fixed on the simulator with
               nSWBOOT0=0) -- but that was NOT the cause of the post-swap hang, which persists
-----------------------------------------------------------------------
  *** CORRECTION, same day, later (read this first) ***: the paragraph below
        was written as "root cause of the post-swap hang". It is NOT. Two silent
        states were observed and only one is the ROM bootloader. The BOOT0 finding
        is real (SWD proof at 14:47 and 15:21: MEMRMP=1, PC in system memory), but
        after nSWBOOT0=0 the swap hang STILL happens with the ST-Link unplugged:
        v0.8f -> v0.8h swap at ~15:37 (initiated by the OLD firmware): no boot ran
        until the ST-Link was plugged in at 15:38:52, whose banner showed the OBL
        flag still set (rst=OBL,PIN) -- our firmware clears reset flags at every
        boot, so no boot happened in between. With nSWBOOT0=0 the pin cannot
        select the bootloader (RM0440 Table 5), so the chip was held in reset /
        not executing, as originally suspected (NRST). The swap hang therefore
        also is NOT caused by Saturday's reorganization (an old-firmware-initiated
        swap hung the same way). Open, and the leading hypothesis is the NRST net
        with IRHEN=1 (RM0440: internal resets drive NRST low "until it is seen as
        low level"). Untested next step: clear IRHEN (OPTR bit 30) or set
        NRST_MODE=01, then repeat the unplugged swap; and/or measure NRST and
        BOOT0 with a meter/scope during a hang.
        Separate, unexplained: at 15:28 v0.8h stopped answering when the ST-Link
        was unplugged (no swap); the record cannot tell "running but deaf" from
        "reset held" (no boot in between, PIN flag only). The old v0.8f answered
        6/6 after an unplug (15:35) -- one trial each, not a verdict.

  IRHEN TEST (15:41-15:46, simulator, ST-Link unplugged for the swaps): cleared
        IRHEN (OPTR bit 30; 0xFBEFF8AA -> 0xBBEFF8AA, via option_write 0 0x20 0
        0x40000000 + reload; before/after in logs/optbytes_*_irhen.log). Board
        booted normally and answered 4/4 after the unplug (the 15:28 silence did
        not recur). Then swap 1 (bank 1 v0.8h -> bank 2 v0.8f, unplugged) HUNG
        exactly as before: no banner, no reply, no self-recovery over 2 minutes.
        So IRHEN is NOT the cause. Still open: the post-swap hang with the
        ST-Link unplugged. It needs the NRST (and BOOT0) level measured with a
        meter/scope during a hang; IRHEN is left at 0 for now (the original was 1).

  FRIDAY-ONLY TEST (15:53-15:56, ST-Link confirmed absent by openocd "open
        failed"): board running Friday's v0.8f (1aab4b9c, clean) flashed Friday's
        image into bank 1 over the network (CRC EA72F0B7 verified) and swapped.
        HUNG: no banner, no reply. No reorganized code was involved at any step, so
        the post-swap hang is independent of the 2026-09-26 reorganization.
        Swap record with the ST-Link unplugged, all firmware: 0 successes, 8 hangs
        (3 last week, 5 today, old and new firmware alike); attached: all worked.

  WHERE THIS STOPPED (end of 2026-09-28) -- read before resuming:
        - 09-25 log re-read (logs/net_session.log): the simulator hung on
          unplugged swaps at 11:35 and 11:44, was POWER-CYCLED at 11:46
          (banner rst=PIN,BOR), then did 6 unplugged swaps in a row that all
          worked (12:11-12:25, logs/reflash_tests.log; user confirms the
          ST-Link was unplugged). The same build initiated the 11:44 hang and
          the 12:11 success, so the firmware is not the variable. Today every
          hang (15:37, 15:43, 15:56) followed ST-Link/SWD sessions with no power
          cycle since (15:52 recovery banner: rst=OBL,PIN, no BOR).
        - Leading hypothesis (NOT confirmed): state left in the MCU's debug
          logic by an SWD session survives every reset except power-on and
          breaks the option-byte-reload reset. Test: power-cycle, never attach
          the ST-Link, do several unplugged swaps.
        - That test did not get run: after the user's power cycle at ~16:05 the
          board did not answer *IDN? at all (tunnel and bridge fine, 6 tries
          over a minute, no banner). Unexplained. Not yet checked whether the
          board is powered/running (no SWD, to keep the test clean).
        - Board state as far as known: bank 1 = Friday's v0.8f (1aab4b9c,
          clean), BFB2=0 after the 15:56 swap; bank 2 = Friday's v0.8f too.
          Option bytes FLASH_OPTR = 0xBBEFF8AA: nSWBOOT0=0 AND IRHEN=0 (both
          changed today, simulator only; originals: nSWBOOT0=1, IRHEN=1,
          i.e. 0xFFEFF8AA). Controller untouched: v0.8f 748dd2c8-dirty, bank 1.
        - Uncommitted: all of the 2026-09-26 reorganization, plus
          FW_VERSION_STRING v0.8i. A worktree of 1aab4b9 (Friday) was built for
          the comparison in the session scratchpad.

  CONTROLLER REFLASH (2026-09-29, by request, confirmation prompt skipped with the
        user's explicit authorization): the controller was running v0.8f
        748dd2c8-dirty (last week's uncommitted build, not reproducible). Reflashed
        over the network with the CLEAN Friday build, v0.8f 1aab4b9c (controller
        target, 106,880 bytes, CRC C68046BE), bank 1 -> bank 2. Transfer ~50 s
        (2.2 KB/s, faster than the simulator's link), CRC verified, swap OK: banner
        0.07 s after the acknowledgement (BANK=2 BFB2=1, prev: stage=9,
        rst=OBL,PIN). The banner says "1aab4b9c-dirty" only because the worktree's
        tracked Debug/*.elf/.bin were modified by the earlier simulator build in
        the same worktree; the source is clean. The controller still has
        FLASH_OPTR=0xFFFFF8AA (nSWBOOT0=1, IRHEN=1, untouched), yet this swap did
        NOT hang -- one data point for the "SWD session leaves state until a power
        cycle" hypothesis (no ST-Link sessions on the controller today), not proof.
        It boots into FAULT OVERCURRENT 1 (floating OCP pins, nothing wired) as on
        09-25; STATE? was IDLE before the swap because that fault had been
        cleared at runtime.

  CONTROLLER, NEWEST FIRMWARE (2026-09-29, user-authorized, --yes): reflashed the
        CONTROLLER over the network with the newest (reorganized) firmware, v0.8i,
        controller image CRC 1219699C, original option bytes untouched
        (FLASH_OPTR=0xFFFFF8AA). Bank 2 (Friday's v0.8f) -> bank 1. Swap OK: banner
        0.06 s after the acknowledgement, prev: stage=9, rst=OBL,PIN. NO HANG. No
        ST-Link used. To get STATE IDLE first (the update refuses otherwise): disabled
        channels + FAULT:CLEAR was NOT enough -- EXTernal:ENAble is ON by default and
        PF13 is unwired (reads LOW), and SM_ClearFault() refuses while that interlock
        is unsatisfied; EXTernal:ENAble 0 then FAULT:CLEAR reached IDLE (runtime
        only; the reboot restores the default and FAULT OVERCURRENT 1, as before).
        This is the narrower alternative to DEBUG:FAULT:BYPASS 1 used on 09-25.
        Tally, network swaps, ST-Link unplugged: CONTROLLER 2 of 2 worked (Friday's
        and newest firmware; no SWD session on it today); SIMULATOR 0 of 8 today (both
        firmwares, several option-byte settings), but 6 of 6 on 09-25 right after a
        power cycle. The remaining confound is the SWD sessions the simulator has had.
        Decisive next test: on the CONTROLLER, do a read-only SWD session, unplug, and
        swap without a power cycle -- if it hangs, the cause is the debugger session,
        not board differences; then power-cycle and confirm swaps work again.

  *** KEY RESULT (2026-09-29, CONTROLLER): the swap hang is triggered by an SWD
        session, on the controller too. Baseline: controller did 5 of 5 unplugged
        swaps with no ST-Link involvement (newest v0.8i and Friday's v0.8f, both
        directions, banner 0.06-0.07 s each; original option bytes 0xFFFFF8AA).
        Then: ST-Link plugged into the controller, ONE read-only openocd session
        (2 s: product string, MEMRMP, OPTR, RCC_CSR, tick, boot record; no writes,
        no halt, no reset -- and the plug-in itself did NOT reset the controller,
        unlike the simulator), ST-Link unplugged, controller still answering, no
        power cycle -> swap (bank 2 -> 1): acknowledged, then SILENT, no banner, no
        recovery over 1+ minute. Same boards, same firmware, same option bytes; the
        only new factor was the SWD session. So the hang is NOT specific to the
        simulator's hardware, NOT the reorganization, NOT nSWBOOT0/IRHEN. Working
        rule: after ANY ST-Link/SWD use, POWER-CYCLE the board before relying on a
        network swap. Pending: power-cycle the controller (no ST-Link) and confirm
        swaps work again; then find the mechanism (debug-domain state surviving
        resets, e.g. DBGMCU/debug-enable, vs. something else the ST-Link leaves).

  *** MEASUREMENT (2026-09-29, CONTROLLER, first NRST reading of the whole
        investigation): after the SWD-triggered swap hang and a power cycle, the
        controller stayed silent (also after a reset-switch press). With the board
        silent and the ST-Link NOT attached: PB8/BOOT0 = 0 V (so NOT the ROM
        bootloader by pin; the earlier BOOT0 suspicion does not apply here) and
        NRST = 1.6 V. At VDD ~3.3 V the NRST input thresholds are ~1.0 V (low) and
        ~2.3 V (high), with ~0.2 V hysteresis (datasheet DS12288 NRST table, from
        memory -- verify), so 1.6 V is in the undefined band and a Schmitt input
        that has seen a reset low stays "in reset" until NRST rises past ~2.3 V.
        1.6 V = a divider of the internal ~40 kOhm pull-up against a path of
        roughly 38 kOhm to ground (or a partially-on driver). So the chip is very
        likely HELD IN RESET by a contested NRST net; an attached ST-Link (its NRST
        line adds a pull-up/driver) lifts the node past the threshold and releases
        it. A 10 kOhm external pull-up (as fitted on the simulator on 09-25) would
        make the same divider ~2.7 V > 2.3 V. Not yet tested on the controller.
        Candidates for the ground-side path: the ESTOP fiber receiver output on the
        NRST/PG10 net (open port, ambient light), the reset switch, board leakage.

  CONTROLLER RECOVERY BANNER (2026-09-29 10:12:46): after the power cycle (~10:02)
        the controller stayed silent (also through a reset-switch press) until the
        ST-Link was connected; its first banner then read v0.8i BANK=1, boot=1,
        rst=PIN,BOR -- BOR still set = the FIRST boot since the power-on. So the chip
        sat held in reset from the cold power-on until the ST-Link released it (NRST
        measured 1.6 V during that time). A power cycle therefore does NOT cure the
        state, which retracts the "SWD leaves state that a power cycle clears"
        wording above: the SWD session is a trigger, but the failure itself is the
        NRST net not rising past the release threshold. Then, ST-Link attached,
        swap to Friday's v0.8f (bank 2) worked: banner 0.07 s. The controller is on
        Friday's v0.8f, ST-Link still attached.

  NRST-FORCED-HIGH TEST (2026-09-29 10:24, CONTROLLER, no ST-Link): the user forced
        NRST high by a "brute force" method (details not yet recorded). Full network
        reflash of the newest v0.8i (CRC 1219699C) into bank 1: transfer OK, swap
        acknowledged, then SILENT (no banner, no *IDN? reply). So a forced-high NRST
        did NOT prevent the hang -- but the test may be confounded: with IRHEN=1 the
        chip's reset holder drives NRST low "until it is seen as low level"
        (RM0440 7.1.2 and OPTR bit 30); a hard tie to 3.3 V would keep the holder
        from ever seeing VIL.
        CORRECTION (same day, supersedes a wrong note I wrote a few minutes earlier):
        the user first said the pull-up was a 5.1 kOhm resistor, then corrected
        that: THIS test (the hang above) used a HARD TIE of NRST to 3.3 V. So the
        hard-tie confound stands and that hang is NOT evidence against the NRST
        theory. The user then replaced the hard tie with a 5.1 kOhm resistor
        NRST->3.3 V (about 4.5 kOhm with the internal pull-up; with the earlier
        ~38 kOhm-to-ground estimate NRST would sit near 2.9 V, above the ~2.3 V
        release threshold) and power-cycled the controller: a !BOOT banner arrived.
        The tests below are being repeated with the 5.1 kOhm in place.

  *** NRST PULL-UP TEST, RESULT (2026-09-29 10:34-10:38, CONTROLLER, no ST-Link):
        with a 5.1 kOhm resistor NRST->3.3 V fitted (replacing the hard tie), the
        same conditions that hung the controller before -- an SWD session at
        10:12-10:14 and no true power-on reset since (the 10:30 boot showed
        rst=OBL,PIN, no BOR) -- gave: 4 of 4 bank-swaps clean (banner 0.06-0.07 s,
        alternating v0.8f bank 2 / v0.8i bank 1) AND a full network reflash of the
        newest v0.8i (CRC 1219699C, 53 pages, transfer + swap) clean: banner 0.14 s,
        boot=2, prev: stage=9, rst=OBL,PIN. NO HANG. Compared with the same
        controller, same firmware and option bytes (0xFFFFF8AA) WITHOUT the pull-up,
        which hung after the SWD session (09:59) and sat held in reset (NRST 1.6 V)
        through a power cycle. So a 5.1 kOhm NRST pull-up cures the post-swap hang
        on the controller; the mechanism is the NRST net not being firmly pulled
        high after a reset (the chip's ~40 kOhm internal pull-up is disabled during
        internal resets and is too weak against whatever loads the net). Still to
        do: a longer soak, a repeat after a fresh SWD session, and fitting the same
        fix on the simulator if its 09-25 pull-up is no longer effective.

  SOAK (2026-09-29 10:37-10:42, CONTROLLER, 5.1 kOhm NRST pull-up fitted, no
        ST-Link, original option bytes 0xFFFFF8AA): 20 of 20 bank swaps clean, random
        3-20 s pauses, alternating bank 1/2, banner 0.00-0.08 s after each
        acknowledgement (log: logs/soak_controller.log). With the earlier 4 swaps and
        the full reflash that is 25 clean operations in a row on the state that hung
        the controller before. Note both banks held the same v0.8i image by then, so
        this exercises the swap/reset path, not different images. Not yet done:
        repeat after a fresh SWD session, a cold power-on with the resistor in, and
        the simulator.

  COLD POWER-ON TEST (2026-09-29 10:45, CONTROLLER, 5.1 kOhm NRST pull-up, no
        ST-Link): a full power cycle of the controller (off, ~5 s, on), caught by a
        reconnecting listener on the tunnel (logs/powercycle_watch.log). The board
        booted BY ITSELF within about half a minute of power-on: v0.8i, BANK=2,
        boot=1, rst=PIN,BOR (a true power-on reset -- BOR set, unlike the 10:30
        release which had no BOR). Before the resistor, the same situation (10:02)
        left it silent for ten minutes until the ST-Link released it. Then 5 of 5
        swaps clean right after the cold start (banner 0.05-0.07 s). So the pull-up
        also cures the cold-start hold. Running total on the controller with the
        resistor: 30 clean operations (4 swaps + 1 full reflash + 20 soak + 5 after
        cold start), 0 hangs. Still to do: a fresh SWD session then swaps (needs the
        ST-Link isolated from the forced NRST), and the simulator.

  SIMULATOR (2026-09-29 ~10:55): the simulator had been silent since a power cycle on
        09-28. The user added a pull-up on its NRST line (value not yet recorded) and
        it now answers over the network: *IDN? = WHAM-XREX-PFMG474-SIM REVA v0.8f
        1aab4b9c (Friday's clean build), bank 1 BFB2=0, FWUP idle, STATE IDLE,
        FAULT 0, OPTR=0xBBEFF8AA (nSWBOOT0=0, IRHEN=0 -- as set on 09-28; the
        controller keeps the originals). Consistent with the controller result: the
        silence was the NRST net, and a firm pull-up cures it.

  SIMULATOR SOAK (2026-09-29 11:25-11:28, no ST-Link, with the user's new NRST
        pull-up fitted): 16 of 16 bank swaps clean (banner 0.09-0.15 s after each
        acknowledgement; logs/soak_simulator.log), alternating bank 1/2, v0.8f both
        banks. Before the pull-up the same simulator hung 8 times out of 8. Its
        option bytes are still the modified 0xBBEFF8AA (nSWBOOT0=0, IRHEN=0), the
        controller's the originals 0xFFFFF8AA, so both boards being clean says the
        NRST pull-up is what matters, not those two bits. Both boards now: cured by a
        firm NRST pull-up.

  Finding: the silence after FWUPdate:SWAP (open since 2026-09-25) was NOT the
        chip held in reset. With the ST-Link attached, read-only SWD reads of a
        silent board showed SYSCFG_MEMRMP=1 (system memory), PC=0x1FFF40F8 and
        VTOR=0x1FFF0000 (the ROM bootloader), RCC_CSR power-on flags still set
        (our firmware clears them at boot), and uninitialized RAM. FLASH_OPTR was
        0xFFEFF8AA: nSWBOOT0=1, so the boot source is the BOOT0 pin (PB8), which
        has only a capacitor to ground on this board. Each reset re-samples it;
        high selects system memory (RM0440 Table 5). The swap's option-byte
        reload reset is one of those resets. A later reset (plugging the ST-Link,
        the reset switch) samples again and can land in flash, which is why the
        board "came back". The banner logs support it: after a swap the next
        boot reported prev: stage=9 (the record from just before the reload) with
        no boot in between.

  Change:  Simulator only: cleared option bit nSWBOOT0 (OPTR 0xFFEFF8AA ->
        0xFBEFF8AA; nBOOT0 stays 1, which selects main flash whatever BOOT0 does)
        with: openocd ... stm32l4x option_write 0 0x20 0x00000000 0x04000000, then
        an option reload. Nothing else changed (RDP, BFB2, DBANK, WRP untouched).
        Before/after are in logs/optbytes_before_nswboot0.log and
        logs/optbytes_write_nswboot0.log. The software BOOT command still enters
        the ROM bootloader (it jumps to it directly, without the pin). To undo:
        option_write 0 0x20 0x04000000 0x04000000 and reload.

  Verified (simulator, ST-Link attached): after the reload MEMRMP=0, RCC_CSR
        cleared, tick counting, boot record magic present, banner received over
        the network, *IDN?/STATE?/DIAG:OPTB? answered (OPTR=FBEFF8AA
        nSWBOOT0=0).

  NOT yet verified: (1) a swap with the ST-Link UNPLUGGED after the fix (the case
        that failed) -- v0.8i is loaded for it; (2) the CONTROLLER: it very likely
        has the same option bytes and floating BOOT0, so it has the same latent
        problem and needs the same change (not done -- ask first). The 3.7 V vs
        3.27 V ST-Link supply readings taken earlier the same day are unexplained;
        the ST-Link's reading may just be imprecise.

  Also: the earlier "no 0x79 from ROM bootloader" check that seemed to rule out
        the bootloader was not conclusive (the bridge is 8N1; the ROM bootloader
        wants 8E1).

2026-09-26  —  Firmware reorganization: layered src/ layout (Core = CubeMX only),
               driver interfaces, off-target tests, enforced layout rules;
               one error-code enum; commands.c split; main.c slimmed
-----------------------------------------------------------------------
  Change:  Direct request, in two steps: first three items of the
        2026-09-25 reorganization proposal (the bench/debug commands --
        DEBUG:FAULT:BYPASS, OCP:TEST:FAULT, etc. -- deliberately STAY for
        hardware integration), then "structure the project along these
        guidelines" (app / middleware / drivers / bsp / tests / build) with
        a long-term instruction to keep it that way. Choices confirmed
        up front: keep STM32CubeIDE + CubeMX regeneration working, and go
        the full depth (interfaces + tests, not just folders).

        1. Error codes: src/app/commands/cmd_common.h holds the wire codes
        as one enum (cmd_err_t, ERR_UNKNOWN_COMMAND = 1 .. ERR_FWUPDATE = 17,
        16 marked retired); every literal code now uses it, and the two
        private SendErr() copies became one. Numeric values unchanged.
        Noticed, NOT changed (would change the wire protocol): ERR 11
        ("invalid channel") is also sent for a few non-channel values.

        2. commands.c (3,417 lines) split along its own section banners into
        cmd_system/table/config/state/io/pfmin/control/shot/sim.c; the
        FWUPdate handlers joined them as cmd_fwupdate.c. commands.h stays
        the one list of declarations and maps subsystem -> file.

        3. Layout (AGENTS.md "Source layout" has the full tree and rules):
        Core/ now holds only CubeMX-generated files; main.c is generated
        init plus one call per USER CODE block. Hand-written code moved to
        src/app (app.c start-up/banner/main loop, task_faults.c,
        task_scpi.c, telemetry.c, control/, protection/, sim/, commands/),
        src/middleware/scpi (scpi_parser.c), src/drivers (interfaces),
        src/bsp/stm32g4 (everything that touches the MCU), src/config
        (ctrlr_config.h). Generated headers (git_version.h,
        build_target.h) moved to build/generated/.

        4. Driver interfaces, so app and middleware code never touch the
        HAL: drivers/mcu.h (tick, delay, interrupt masking, cycle counter,
        option bytes, reset flags), board_io.h (every discrete board
        signal by name -- the pin table moved into the BSP), uart.h
        (opaque serial link; the driver no longer calls the parser --
        task_scpi.c takes the line and dispatches it), flash_bank.h
        (dual-bank erase/program/CRC/image check/BFB2 boot, split out of
        fw_update.c; the protocol half is cmd_fwupdate.c). hrtim.h and
        pfm_input.h were split: HAL-free API in drivers/, HAL handles and
        HAL-valued settings in bsp/stm32g4/*_hw.h. The SCPI parser is now
        generic (scpi_dispatch() over a caller's table); the product's
        table is src/app/commands/command_table.c.

        5. Enforcement and tests: python/check_layout.py (layer include
        rules; no HAL/register/pin/IRQ use outside src/bsp; Core/ allowlist;
        unique header names) and tests/ (host-compiled: test_scpi_parser,
        and test_command_table, which checks every real command pattern is
        reachable by its short and long form). Both run in every
        wham_build.py build, after python/sync_build_sources.py --check,
        which now manages every src/ folder's Debug/ makefile and the
        .cproject include paths/source folders.

        6. build/: wham_build.py publishes build/WHAM-XREX-PFMG474{,-SIM}
        .{elf,bin,map}; the flash/update tools read from there by default.
        build/*.elf/.bin are now the tracked images; Debug/'s copies are
        ignored (CubeIDE's debugger still loads Debug/'s .elf).
        memory_report.py reads build/ and falls back to Debug/ for older
        commits, and buckets by file name so history stays comparable.

  Found by the new command-table test, NOT fixed (wire protocol): the
        short forms of DIAGnostic:GPOut09/10/11 are all DIAG:GPO -- same as
        GPOut12, which comes first in the table -- so "DIAG:GPO 1" always
        drives GPOut12. Long forms (DIAG:GPOut11 1) work. Listed as known
        exceptions in tests/test_command_table.c until the patterns change.

  Verification (build-only; no hardware was available): zero warnings on
        both targets at every step. ELFs compared per function (normalized
        disassembly) and by .rodata strings at each step:
        - enum, split, main.c, and the Phase-1 file moves: every function
          identical except the intended ones (SendErr merged; main() and
          MX_GPIO_Init() calling the extracted functions, same call
          sequence); strings identical.
        - interfaces: every reply string identical on both targets. With
          the new wrappers expanded inline, all but seven of the 46 changed
          or renamed functions make exactly the same HAL/library calls and
          interrupt-mask instructions in the same order. Those seven were reviewed
          one by one: a register read moved into a function
          (banner/main), a side-effect-free reorder (BootInactiveBank,
          rollback), and error branches laid out differently with the same
          calls and messages on every path (fwup_begin/data). One real
          difference: FWUPdate:END now flushes the flash data cache twice
          instead of once (the image check flushes for itself) --
          harmless.
        Size vs. the start of the day: controller .bin 106,880 -> 107,864
        bytes (+984), simulator 115,952 -> 117,064 (+1,112), RAM -8 B.
        The growth is the new wrapper functions plus duplicated string
        literals (-O0 does not merge identical strings across files).
        The IDE build (.cproject edited by the script) and all behavior on
        hardware are NOT yet checked -- first thing when a board is back:
        IDE build once, then *IDN?, the !BOOT banner, STATE?, one command
        per subsystem, an unknown command (ERR 1), and a FWUPdate cycle.

2026-09-25  —  Simulator brought onto the update path; second (parallel) session's
               reflash tests; test builds v0.8b-v0.8f; bench notes
-----------------------------------------------------------------------
  Change:  - Simulator (WHAM-XREX-PFMG474-SIM) flashed by ST-Link with the
        current build (previous v0.1 / 669923cd image saved as a read-back
        first). Its option bytes were already DBANK=1, BFB2=0, so FWUPdate:*
        is available on it. It has its own bridge at <simulator-ip>:5000
        (the controller's is <controller-ip>:5000). The NRST pull-up from the
        hang investigation is fitted on the SIMULATOR.
        - A second, independent assistant session (user ran out of credits
        here) ran python/reflash_test_driver.py: five build+flash cycles,
        v0.8b..v0.8f, "--target simulator". FW_VERSION_STRING is left at
        v0.8f (the version now running on both boards); it is a test
        marker, not a release number. That session's log shows those
        cycles actually landed on the CONTROLLER (the banner has no -SIM;
        it came up in FAULT OVERCURRENT 1, the known floating-OCP-pin state
        with nothing wired to those pins): it reused the existing
        net_broker.py on port 5001, which was still bridging the
        controller. "--target simulator" only picks the local image file
        and the host-side name check; the board reached is whatever the
        --url leads to. fw_update.py's product-name guard only protects
        against a mismatched image, not a mismatched bridge -- check
        *IDN? before an update, and use one broker per board.
        - Two unrelated bench notes: macOS's own AirPlay/ControlCenter
        listens on local port 5000, so "port 5000 open" is NOT proof an SSH
        tunnel is up (use other local ports, e.g. 5010/5011); and while
        both boards were being reached at once, another session's
        connections to the single-client bridges caused refused/no-route
        flapping that looked like a hardware fault.
        - docs/rebuild_plan.md (from that session): a PROPOSAL for a clean
        rebuild (CMake, platform/core/app layering, host tests, IWDG,
        NRST option bytes). Nothing in it has been executed.

2026-09-25  —  !BOOT banner + reset-surviving boot diagnostics; fw_update.py
               hardened; post-swap hang characterised: chip HELD IN RESET
               after an option-byte reload unless the ST-Link is attached
-----------------------------------------------------------------------
  Change:  1. !BOOT banner (main.c, end of USER CODE 2, direct request):
        three unsolicited lines on every boot -- identity/bank/BFB2/state/
        tick, a diagnostics line, and a greeting with a sun emoji (raw
        UTF-8, carried fine by the link). Gives an exact "reboot complete"
        signal after FWUPdate:SWAP. Documented in command_reference.md.

        2. Boot diagnostics (new Core/Inc/boot_diag.h, no new .c file):
        g_bootDiag in .noinit RAM (48 B) -- boot counter, last stage
        reached (markers through main.c's init sequence, plus stage 9
        set by fw_update.c right before HAL_FLASH_OB_Launch()), and
        counts/stage/registers for HardFault (CFSR/HFSR), Error_Handler
        and NMI (FLASH->ECCR). RCC->CSR is captured and cleared at the
        start of every boot and reported as rst=, so DIAGnostic:RSTCause?
        now only shows resets since the current boot. Cost: controller
        image 105,912 -> 106,880 bytes; RAM +48 B.

        3. python/fw_update.py: works through net_broker.py
        (--url socket://localhost:5001 --name fw_update) so others can
        watch; ignores broker chatter; detects the reboot by the !BOOT
        banner (prints it, tolerates the garbage byte the reset glitch
        puts in front of the first line); and RESYNCS instead of aborting
        when a reply is damaged -- asks FWUPdate:STATus? for the RX count
        and resumes from there (the final CRC still guards the image). A
        real lost byte ("OK" arriving as "O", visible in the broker log,
        so lost between board and bridge) had aborted a whole transfer;
        roughly one reply in a couple of thousand is hit. Tested against
        an emulator that clips an OK and rejects a chunk; used once for
        real in the v0.7 transfer below.

        4. st-flash is NOT bank-swap aware: while BFB2=1 a write to
        0x08000000 erases/programs physical bank 1 (the INACTIVE bank),
        not what runs. An attempt today erased part of bank 1 and then
        failed with a flash error; the running image was untouched.
        Check FWUPdate:STATus? shows BANK=1 BFB2=0 before using st-flash.

  Investigation (post-FWUPdate:SWAP hang):
        Firmware versions v0.2..v0.7 were used purely as distinguishable
        test builds. Swaps with the ST-Link UNPLUGGED hung 3/3 (v0.2 bank
        1->2, v0.4 bank 2->1, v0.7 bank 1->2); swaps with it plugged in
        succeeded ~13/13 (banner within 45-90 ms). Every hang cleared the
        instant the ST-Link was plugged in, booting the new image on the
        correct bank. Findings for the v0.7 hang, the first with the new
        diagnostics:
        - after "OK SWAPPING" the board sent nothing at all;
        - a single 0x7F through the bridge got no reply (the ROM
          bootloader ACKs 0x79 through this bridge), so not stuck in the
          bootloader (BOOT0 on this board has only a capacitor to ground
          and nSWBOOT0=1, which made that a real candidate);
        - recovery banner: boot=3 after a v0.6 baseline of boot=2 (+1),
          prev: stage=9, no fault/err/nmi, rst=OBL,PIN, -- identical flags
          to a healthy swap. So NO firmware ran during the hang: the chip
          sat in reset after the option-byte reload.
        No watchdog is enabled, so nothing on-chip could have released it.

        Leading hypothesis, NOT yet measured: NRST net. On this board NRST
        has no external pull-up (only the MCU's ~40 kOhm internal one), a
        100 nF cap, a manual reset switch to ground, and the ESTOP fiber
        receiver's output (nothing plugged into that fiber). OPTR has
        NRST_MODE=11 (bidirectional) and IRHEN=1 (an internal reset holds
        NRST low until the pin reads low). If the net then fails to rise
        cleanly past the reset threshold, the chip stays in reset; the
        ST-Link's own reset line pulls it high when connected.
        Next: measure NRST during a hang; try an external pull-up (e.g.
        10 kOhm to 3.3 V); a firmware alternative is NRST_MODE=01 (reset
        input only, internal resets never drive the pin) -- only with the
        ST-Link attached and after the mechanism is confirmed.

2026-09-24  —  FWUPdate:* -- in-application dual-bank firmware update
                over the serial link (works through the ethernet bridge)
-----------------------------------------------------------------------
  Change:  Direct request, after net_flash.py was shown not to work through
        the fixed-8N1 ethernet bridge. New Core/Src/fw_update.c +
        Core/Inc/fw_update.h, commands FWUPdate:BEGin/DATA/END/SWAP/
        ROLLback/ABORt/STATus? (cmd_parser.c), new ERR 17, host tool
        python/fw_update.py. The image is streamed as hex (48 bytes/line,
        stop-and-wait -- uart.c has a single line buffer) into the flash
        bank that is NOT running, CRC-32 and sanity-checked (SP, reset
        vector, NUL-terminated product name), then booted by setting
        OPTR.BFB2 and reloading option bytes; the old image stays in the
        other bank for FWUPdate:ROLLback.

        Checked before writing it (SWD, controller): OPTR=0xFFEFF8AA ->
        DBANK=1 (2 x 256 KB), BFB2=0, RDP level 0; MEMRMP.FB_MODE=0; bank 2
        blank. boot_jump.c's startup remap macros only touch MEM_MODE, so a
        bank swap (FB_MODE) survives startup, and VTOR=FLASH_BASE follows
        it. Erase uses the PHYSICAL bank (BKER), derived from FB_MODE the
        same way HAL's own flash_ex.c does.

        Flash cost: controller image 97,576 -> 105,464 bytes (~2.6 KB this
        module, ~4.5 KB HAL flash/option-byte driver code newly linked);
        RAM +48 bytes on both targets. Both images fit one bank (controller
        105 KB, simulator 115 KB).

        Verified: clean build of both targets, no warnings; fw_update.py
        against a host-side emulator of the protocol (update + swap in both
        directions, rollback, wrong-target image refused, wrong board
        refused, a single flipped bit caught by the CRC).

        VERIFIED ON THE CONTROLLER, same day, through the ethernet bridge
        (ST-Link attached as a backstop, never needed): flashed this build to
        bank 1 by ST-Link; fw_update.py then loaded bank 2 (52 pages erased,
        CRC F9C96420 matched on-chip) and swapped -- came back BANK=2 BFB2=1,
        and SWD confirmed MEMRMP=0x100 (FB_MODE=1) with OPTR changed only in
        BFB2 (0xFFEFF8AA -> 0xFFFFF8AA). So the ROM bootloader's dual-bank
        boot accepts SP=0x20020000 -- the main risk flagged beforehand. Then
        updated back into bank 1 while running from bank 2 (erase of physical
        bank 1 correct -- the other flagged risk) and swapped, then rolled
        back to bank 2 and again to bank 1. ~2.5 KB/s, ~42 s for the
        105,464-byte image. Left on bank 1, BFB2=0, so ST-Link flashing to
        0x08000000 behaves as before. The ST-Link recovery command in
        command_reference.md is still untested (never needed).

        PROOF RUN (the runs above loaded an identical image, so *IDN? alone
        couldn't show a change): built a test image with FW_VERSION_STRING
        "v0.1-FWUPTEST" (source reverted right after), loaded it with one
        `fw_update.py --bin ... --yes`: *IDN? went v0.1 -> v0.1-FWUPTEST,
        BANK 1 -> 2. Independent of the firmware, SWD dumps of both banks
        matched the files byte for byte (running bank == test image, other
        bank == previous image, SHA-1s identical). Rolled back (v0.1
        returned), then overwrote the other bank with the real image via
        --no-swap, so no test image is left on the board.

        fw_update.py now also FAILS (nonzero exit) if, after the swap, the
        board is still on the old bank or its *IDN? version/git hash are not
        in the loaded image -- previously it only printed *IDN?.

        Also: .claude/settings.local.json (gitignored) allows st-flash,
        openocd and fw_update.py for Claude sessions in this repo.

        Also: Debug/Core/Src/subdir.mk and Debug/objects.list hand-patched
        for the new source file (AGENTS.md's documented command-line-build
        gotcha).

2026-09-24  —  Host tooling for the ethernet serial bridge
-----------------------------------------------------------------------
  Change:  The controller's USART2 is now reachable over ethernet through
        a raw TCP serial bridge (<controller-ip>:5000, reached via an SSH
        tunnel through the jump host). The bridge accepts ONE client at
        a time and is fixed at 115200 8N1. New tools (python/):
        - net_terminal.py -- minimal always-listening terminal.
        - net_broker.py + net_client.py -- holds the single bridge
          connection and shares it between several local clients (operator
          and Claude), echoing each client's commands to the others as
          "[name] > cmd" and logging the whole dialog to
          logs/net_session.log.
        - net_flash.py -- AN3155 ROM-bootloader flasher over a pyserial URL.
          DOES NOT WORK through this bridge, verified on hardware by
          watching USART2 over SWD during an attempt: the bootloader runs
          8E1, the lone 0x7F sync survives an 8N1 link and is ACKed, but
          GET ID is NACKed with PE+FE set. The bridge has no RFC 2217
          support (telnet negotiation unanswered; no other ports open), so
          parity can't be switched from the host. A failed attempt leaves
          the board in the ROM bootloader with nothing erased (recover
          with an ST-Link reset or a power cycle). Kept for bridges that do
          support RFC 2217 or can be set to 8E1.

2026-09-24  —  DEBUG:FAULT:BYPASS now also removes fault-derived
                state-machine restrictions (operate through a fault)
-----------------------------------------------------------------------
  Change:  Direct request. Previously the bypass only stopped NEW faults
        from entering FAULT; an already-latched fault could not be
        cleared while its physical cause remained, and PF13-low still
        blocked ARM/fire. With the bypass ON: (1) SM_ClearFault() skips
        its PC10/GateDriverStatus/PF13 re-validation and always clears;
        (2) SM_ExternalEnableOk() returns 1 (ARM/SHOT:STARt/SOURce:RUN/
        FIRE no longer refuse on PF13 LOW); (3) GateDriver_CheckFault()
        neither latches nor PFM_ForceStop()s on a Water/Temp pin fault;
        (4) FIRE's ERR 6 latched-fault check is skipped. Deliberately NOT
        bypassed: the HRTIM PC10/FLT6 silicon-level output gating and
        the ENA_OUT/CONTACT_OUT ARM precondition. Files: state_machine.c,
        gate_driver.c, commands.c, docs/command_reference.md. Build-
        verified only; not yet exercised on hardware.

        Same day, follow-up: SM_SetFaultBypassEnabled(0) now calls
        GateDriver_CheckFault() once when the bypass goes ON->OFF.
        Water/Temp/Enerpro are EXTI-edge-driven only, so a pin that sat
        in its fault state throughout the bypass would otherwise never be
        re-detected after turning it off (OCP/ENABLE_OUTPUT/PF13 are
        polled and were already fine).

2026-09-23  —  SOP: new "Controller I/O -- Signals Sent To and
                Received From the Transrex" reference section
-----------------------------------------------------------------------
  Change:  docs/sop/wham_xrex_pfmg474_sop.tex gained a new section
        (Section 11, between Telemetry and Troubleshooting) documenting
        every physical signal the controller exchanges with the
        Transrex: a caution box on XRn_ENA_OUT/XRn_CONTACT_OUT being
        outputs-only with no confirmation path (quoting
        Core/Inc/xrex_io.h's own header comment directly), a per-channel
        table (DRIVE/FEEDBACK/ENA_OUT/CONTACT_OUT/WATER_FLT/TMP_FLT/
        ENERPRO_FLT/OCP -- 8 signal types x 4 channels), a system-wide
        table (external enable PF13, external trigger PF15, native
        HRTIM fault PC10), and a diagnostic-loopback table (the 4
        DIAGnostic:GPOut* bench commands used to drive PF13/PF15 from
        software alone). docs/pin_mapping_v4.csv cited as the
        authoritative pin source throughout.

        Real rendering bug found and fixed along the way: the first
        draft used 4-column tables (Signal | Dir. | Pins | Purpose).
        Even after narrowing column widths to fix an initial
        total-width overfull-hbox warning, visual inspection of the
        compiled PDF (not just the warning log) showed the ~0.45in
        "Dir." column was still too narrow for the single unbreakable
        word "OUTPUT" -- it overflowed solid into the next column with
        no separating space (rendered literally as "OUTPUTPA8," in one
        row). Numeric hbox-overflow magnitude alone was not a reliable
        proxy for "is this actually readable"; fixed by redesigning all
        three tables to 3 columns, folding the direction into the
        Signal/Command column itself (e.g. "XRn_DRIVE (OUTPUT)"), which
        both fixes the overflow and reads a bit better. Re-verified by
        rendering the affected pages to PNG and inspecting them
        directly, not just re-checking the warning log.

        Also fixed: the per-channel subsection's intro said "Seven
        signal types" while the table lists eight rows.

        Rev F added to the SOP's own revision table. PDF rebuilt
        (2 passes, no errors, no undefined references).

2026-09-23  —  Review of the bundled CONFig:*/telemetry/host-tooling
                work: 6 real bugs found and fixed
-----------------------------------------------------------------------
  Change:  Autonomous follow-up (direct authorization), a genuine
        independent review of the work that rode along with the
        PID:->SOURce:/SHOT:/LOG:/CHANnel: rename but never got its own
        pass (the rename itself already got an 8-angle review, see the
        prior entry). Three review passes -- pid.c/xrex_io.c's
        CONFig:* additions, telemetry.c, and the ~2700 combined new
        lines in wham_console.py/run_simulator_validation.py -- found
        6 real, concrete bugs, none of them hypothetical.

        FIRMWARE (Core/Src/pid.c, Core/Src/main.c):

        1. Four call sites in pid.c still read the compile-time
           PID_LOOP_RATE_HZ macro instead of the runtime
           g_pidLoopRateHz variable CONFig:PIDRate (2026-09-22) actually
           changes: PID_GetLogSampleRateHz() (LOG:DATA?'s own reported
           sample rate), PID_StartRamp() (SOURce:RAMP's duration),
           PID_SetProfileTiming()/PID_GetProfileTiming() (SHOT:TIMing/
           SHOT:TIMing?). CONFig:PIDRate itself worked correctly and
           reported success -- these four commands silently kept using
           the stale 1000 Hz default regardless, so a shot's real
           ramp/flat-top/ramp-down durations ran 2x too fast or slow
           after a loop-rate change, invisibly (SHOT:TIMing? read back
           exactly what was asked for, using the same stale constant).
           All four fixed to read g_pidLoopRateHz. A narrower, deeper
           issue flagged but NOT fixed: SHOT:TIMing's stored tick
           counts are computed once at set-time and go stale again if
           CONFig:PIDRate changes a second time before the shot
           actually fires (allowed -- PID_SetLoopRateHz() only refuses
           while g_running != 0) -- a real gap, but a different design
           question (re-derive ticks at fire time?) than this bug.

        2. Minor, related: PID_LOOP_RATE_HZ_MIN was 500 Hz, below the
           ~649 Hz real HRTIM hardware floor its own comment cited --
           not unsafe (fails closed, HRTIM1_SetPidHeartbeatRate()
           correctly rejects the whole [500,648] sub-range), just
           presented a dead range as valid with no way to tell from the
           bound alone. Raised to 700 Hz; docs/command_reference.md
           updated to match.

        3. Telemetry_Init() (main.c) ran AFTER the boot-time fault poll
           (SM_Init()/SM_PollFaults()/XrexIo_Poll*Faults()), which
           exists specifically to catch a fault already latched at
           power-on. When that happened, EnterFault() correctly pushed
           the event into both the live !EVT ring and the flight
           recorder -- and Telemetry_Init(), running right after,
           unconditionally zeroed both, permanently erasing the one
           event SYS:EVLOG? exists to survive for post-mortem review
           (no later call ever re-pushes it -- every fault-report path
           dedupes on already being in SM_STATE_FAULT). Moved
           Telemetry_Init() before the fault-poll block.

        HOST TOOLING (python/run_simulator_validation.py):

        4. generate_combined_plot() referenced `survivor_rows`, not an
           actual parameter or local (the real name is `extra_traces`)
           -- a NameError on any scenario whose controller log came
           back genuinely empty (a legitimate `OK 0 ...` reply, not an
           error), which discarded that scenario's own already-computed
           real PASS/FAIL verdict and replaced it with a generic
           "Unexpected exception" in the campaign report. Fixed to
           check `extra_traces`.

        5. Several scenarios (OCP/Enerpro/Watertemp fault injection,
           ENA_OUT/CONTACT_OUT-dropped, plus two more for consistency)
           armed the simulator's onboard log with a hardcoded
           min_interval_ms=5 -- only 5.0s of coverage (1000 samples *
           5ms) -- instead of this file's own sim_log_interval_ms(),
           added earlier specifically to fix this exact bug class
           elsewhere. With the module default RAMP_S=10.0/FLAT_S=5.0,
           the fault-injection scenarios fire their fault at ~10.5s --
           well past the 5.0s cutoff -- silently truncating the
           simulator-side DRIVE/FEEDBACK log before the fault instant,
           corrupting the diagnostic plot/CSV for exactly the tests
           meant to visually confirm hardware fault response (did not
           affect PASS/FAIL, which polls STATE?/SOURce:STATus?
           directly, not this log). All 7 real call sites now use
           sim_log_interval_ms() consistently.

        6. shot_meta() built its returned dict with the pre-rename key
           `ramp_time_s`, but wham_console.py's generate_plot()/
           generate_multi_channel_plot() were updated in the same
           rename to require separate ramp_up_time_s/ramp_down_time_s
           (once SHOT:TIMing became a 3-argument asymmetric-ramp
           command) -- shot_meta() was never updated to match, so
           have_profile was always False and every plot this script
           produced silently fell back to the plain Hz-only view
           instead of the intended phase-shaded ramp/flat-top/ramp-down
           + Amps-axis plot, for essentially the whole campaign, no
           error printed. A second consumer of the same stale key
           inside this same file (generate_multi_channel_grid_plot()'s
           own phase-shading) was also broken the same way and also
           fixed. This script only ever commands symmetric ramps, so
           both new keys are set to the same value.

        Verified: wham_build.py --target controller/--target simulator
        --clean both clean (zero errors/warnings). Python: py_compile +
        real imports clean; shot_meta()'s new keys and the resulting
        have_profile condition functionally tested True; confirmed zero
        remaining hardcoded min_interval_ms=5 call sites (only the
        function's own default parameter, which is fine, remains).
        Firmware changes not yet reflashed/hardware-verified as of this
        entry -- next step.

2026-09-23  —  ARM-readiness stub: investigated, comments corrected,
                deliberately NOT closed further
-----------------------------------------------------------------------
  Change:  Autonomous follow-up (direct authorization) on a known,
        long-flagged gap: ArmConditionsMet() (state_machine.c) still
        carried a "TODO, populate the rest" comment claiming profile
        timing / gains sanity / "whatever else turns out to matter"
        were unchecked, even though the function itself already checks
        two real conditions (the external-enable interlock, and every
        enabled channel's ENA_OUT/CONTACT_OUT readiness).

        Investigated each item the stale comment claimed was missing:
        "profile timing configured" turns out NOT to be a real gap --
        PID_ProfileStart() (pid.c, called from SM_Fire()/SHOT:STARt)
        already independently refuses to fire with no timing set, so
        ARM succeeding without it is harmless (ARM changes nothing
        electrical either way). "No fault active" was never a separate
        check to add -- IDLE and FAULT are already mutually exclusive
        states, covered for free by SM_Arm()'s own state check.

        Deliberately did NOT add a gain-sanity check: there is no
        universal "wrong" PID gain value to enforce without real domain
        input on what's actually unsafe for this specific plant --
        guessing a bound here would be worse than not checking at all,
        and this is exactly the kind of safety-relevant behavior change
        that shouldn't be made unilaterally while unattended. Flagged
        clearly in the corrected comments instead of guessed at.

        Corrected the stale "currently a stub"/"always allows arming"/
        "TODO, populate the rest" comments in both state_machine.c
        (ArmConditionsMet() itself, header and closing comment) and
        state_machine.h (the ARMED state's own design writeup, and
        SM_Arm()'s declaration comment) to accurately describe what's
        actually checked today. state_machine.h's own "ALSO NOTE TO
        REVISIT, PARTIALLY RESOLVED" paragraph was already accurate --
        left unchanged.

        Comment-only change, no behavior change. Verified: wham_build.py
        --target controller --clean compiles clean (zero errors/
        warnings) -- not reflashed, since nothing electrical changed.

2026-09-23  —  Closed the two remaining PID-loop-rate/log-size
                staleness gaps (host tooling only)
-----------------------------------------------------------------------
  Change:  Autonomous follow-up (direct authorization) to two gaps
        flagged but left open in earlier entries.

        1. python/wham_console.py's sync_calibration() now also
           queries CONFig:PIDRate? and refreshes
           PID_LOOP_RATE_HZ_ASSUMED, same live-sync treatment already
           applied to the Amps<->Hz globals -- wired into the same two
           call sites (connect-time, and default()'s post-command
           resync via _is_calibration_set(), now also matching
           CONFig:PIDRate). python/run_simulator_validation.py's own
           hardcoded PID_LOOP_RATE_HZ = 1000 copy removed;
           pid_log_decim() now reads wc.PID_LOOP_RATE_HZ_ASSUMED
           directly (module-qualified, tracks live syncs -- same
           pattern already used for wc.PFM_MAX_CURRENT_A).

        2. *** REAL BUG, FOUND while fixing (1), not what was being
           looked for ***: wham_console.py's PID_LOG_MAX_SAMPLES_ASSUMED
           was hardcoded 1000. Core/Inc/pid.h's real PID_LOG_MAX_SAMPLES
           is 1750, and always has been -- confirmed directly against
           source. This one isn't a live-sync gap at all (no CONFig:*
           command backs a compile-time log-buffer size); it was just
           wrong, unconditionally, underestimating real log capacity by
           43% in the shot wizard's auto-suggested decim value. Fixed
           to the correct constant.

        3. python/dslogic_shot_capture.py's own third independent
           hardcoded copy of PFM_TURNON_FREQ_HZ/PFM_MAX_FREQ_HZ/
           PFM_MAX_CURRENT_A -- NOT simply merged with wham_console.py's
           copy: that module's own header comment says it's deliberately
           kept as a separate copy so it stays usable standalone,
           without wham_console.py's heavier dependencies -- and
           wham_console.py already imports dslogic_shot_capture.py at
           its own top level, so having dslogic_shot_capture.py import
           wham_console back would risk a real circular-import problem
           depending on which script runs as __main__. Added
           dslogic_shot_capture.set_calibration(turnon_hz, max_hz,
           max_current_a) instead -- no device query, no wham_console
           import -- and wired wham_console.py's do_shot() DSLogic
           integration to push its own already-fetched live values
           through after every successful sync_calibration(), at both
           call sites (connect-time and the raw-command resync path).
           Standalone use of dslogic_shot_capture.py is completely
           unaffected -- its hardcoded defaults are untouched, this only
           adds an optional live-refresh path for callers that have one.

        Verified: all three files syntax-check and import cleanly
        (py_compile + real imports, confirmed no circular-import issue
        in practice -- wham_console imports fine with
        dslogic_shot_capture already imported into it, and vice versa
        standalone); dslogic_shot_capture.set_calibration() functionally
        tested (updates its module globals correctly);
        run_simulator_validation.pid_log_decim(10.0) returns 8,
        matching ceil(1000*10*1.25/1750). No firmware changes --
        python/ only.

2026-09-22  —  Rename review: 5 findings fixed, build-verified before
                first flash
-----------------------------------------------------------------------
  Change:  The PID: -> SOURce:/SHOT:/LOG:/CHANnel: rename (next entry
        below) was hand-edited directly across cmd_parser.c/commands.c/
        commands.h/state_machine.h -- never compiled or flashed before
        this pass. An 8-angle review (correctness/removed-behavior/
        cross-file/reuse/simplification/efficiency/altitude/
        conventions) confirmed the mechanical rename itself was clean
        (zero broken dispatch, zero orphaned old-namespace strings
        anywhere in Core/, the Python tooling, or the docs -- every
        SendErr()'s argument-count/range logic and every state-machine
        safety guarantee carried over verbatim) but found 5 real issues
        in code that rode along in the same hand-editing pass:

        1. commands.h's ERR 13/15 doc table only listed ARM/DISARM/
           SHOT:STARt as sources -- FIRE and SOURce:RUN (and ARM itself,
           for ERR 15) also emit these codes now that the ARM-state gate
           was extended to them. Fixed: table updated to name all the
           real sources and explain why it widened.
        2. The ARM-state + external-enable-interlock precondition check
           (SM_GetState()==ARMED, SM_ExternalEnableOk()) was duplicated
           byte-for-byte in cmd_fire/cmd_source_run/cmd_shot_start --
           three independent copies of safety-interlock logic, one easy
           to miss during a future edit. Fixed: factored into a new
           static RequireArmedAndEnabled(inst) helper (commands.c,
           right before cmd_fire) all three now call; cmd_arm()'s own
           similar-but-distinct check (different message, a third
           precondition) deliberately stays separate, not folded in.
        3-4. Two stale doc-comment references left by a DIFFERENT,
           already-completed change bundled into the same session (the
           emergency-stop feature removal) -- state_machine.h still
           named the removed SM_FAULT_EMERGENCY_STOP as a live sibling
           of SM_FAULT_EXTERNAL_ENABLE, and commands.h still listed the
           removed EMERGency:INPut? command as a live raw-readback
           command (the identical comment in xrex_io.h had already been
           correctly updated -- only this twin copy was missed). Both
           fixed.
        5. SM_Fire()/SM_StartPlain() (state_machine.c) are near-
           duplicate bodies -- left as-is: the author's own comment
           already documents this as a deliberate tradeoff (a mode-flag
           on SM_Fire() was rejected in favor of a separate entry
           point), not an oversight.

        Verified after fixing: wham_build.py --target controller --clean
        and --target simulator --clean both clean (zero errors,
        zero warnings) -- the FIRST successful build of this rename.
        python/wham_console.py and python/run_simulator_validation.py
        both syntax-check and import cleanly (py_compile + a real
        import, not just a grep).

        Process note for next time: this rename was interleaved,
        hunk-by-hunk, with ~8 unrelated feature additions in the same
        files (CONFig:*, telemetry, DEBUG:FAULT:BYPASS, the E-stop
        removal) -- no isolated "rename only" diff ever existed to
        review in isolation, which is exactly what made this pass take
        8 independent angles instead of one straightforward read. A
        project-wide case-insensitive grep for every retired mnemonic/
        function name, run as its own explicit step immediately after a
        rename (before moving on to other edits in the same files), is
        cheap insurance against this class of drift -- worth making a
        habit rather than relying on a later audit to catch it.

2026-09-22  —  Wire-protocol rename: PID: -> SOURce:/SHOT:/LOG:/CHANnel:
-----------------------------------------------------------------------
  Change:  Direct request: rename the output/demand SCPI commands out of
        the PID: namespace into clean top-level namespaces, leaving PID:
        to mean only the genuine PID-loop parameters. Clean cut, no
        aliases -- the old PID:START/PID:SETPOINT/... spellings now
        fall through to ERR 1 (unknown command), never silently
        accepted.

        Old -> new (canonical spellings; matching is case-insensitive):
          PID:START            -> SOURce:RUN
          PID:STOP             -> SOURce:STOP
          PID:SETPOINT         -> SOURce:SETpoint
          PID:STATus?          -> SOURce:STATus?
          PID:RAMP             -> SOURce:RAMP
          PID:CHANnel:ENAble   -> SOURce:ENAble
          PID:CHANnel:ENAble?  -> SOURce:ENAble?
          PID:CHANnel:NICKname -> CHANnel:NICKname
          PID:CHANnel:NICKname? -> CHANnel:NICKname?
          PID:PROFile:TIMing   -> SHOT:TIMing
          PID:PROFile:TIMing?  -> SHOT:TIMing?
          PID:PROFile:CURRent  -> SHOT:CURRent
          PID:PROFile:CURRent? -> SHOT:CURRent?
          PID:PROFile:STARt    -> SHOT:STARt
          PID:LOG              -> LOG:ARM
          PID:LOGDATA?         -> LOG:DATA?

        PID:GAINS/PID:GAINS?/PID:LOOPMODE/PID:LOOPMODE? are unchanged --
        they stay under PID:, which now means only those four. Error
        strings updated too: "Invalid PID channel" -> "Invalid channel"
        and "Invalid PID:* argument" -> "Invalid command arguments"
        (ERR 11/12).

        The underlying pid.c API, all units, and every command's reply
        shape are unchanged -- a wire-protocol rename only, no behavior,
        tuning, or calibration change. TELEMETRY_SCHEMA_VERSION bumped
        3 -> 4 to mark the wire change.

        Updated in lockstep: python/wham_console.py,
        python/wham_llm_console.py, python/run_simulator_validation.py,
        python/dslogic_shot_capture.py, and the docs
        (docs/command_reference.md, docs/sop/wham_xrex_pfmg474_sop.tex,
        docs/telemetry.md, AGENTS.md, docs/pin_mapping_reference.tex).

2026-09-22  —  Docs: SOP Rev D (telemetry section, ARM/trigger update),
                command_reference.md gaps filled
-----------------------------------------------------------------------
  Change:  Direct request: "Update the SOP and command manifest for new
        commands and functionality. In the SOP, include a section about
        telemetry and translation."

        docs/command_reference.md: audited the full command_table[]
        (cmd_parser.c, ~90 real entries) against the doc and closed the
        two genuine gaps found -- DEBUG:FAULT:BYPASS/? (the bench-only
        all-fault-types bypass) and DIAGnostic:OPTBytes? (the option-
        byte boot-config diagnostic) were both implemented but entirely
        undocumented. Also resolved a now-stale "known limitation" note
        claiming wham_console.py's Amps<->Hz calibration constants were
        hardcoded with no live sync -- that was fixed earlier this same
        day (sync_calibration()); the note now describes the fix
        instead of the gap it used to warn about.

        docs/sop/wham_xrex_pfmg474_sop.tex, Rev D:
        - New Section 10, "Telemetry -- Reading and Translating the
          Event Stream": the live !EVT stream (SYS:EVENT), a translation
          table mapping every !EVT line shape to its operational
          meaning (STATE/TRIGGER FIRING/FAULT/FAULT CLEAR -- including
          how TRIGGER FIRING is the only way to tell a trigger-initiated
          shot apart from a command-initiated one), and the flight
          recorder (SYS:EVLOG?) for post-mortem review after the live
          stream wasn't being watched. Includes a worked example reusing
          a real incident from earlier this same day (a spontaneous
          FAULT GENERAL, diagnosed via SYS:EVLOG? rather than guessing).
        - Section 9 updated for two real Rev D firmware behavior changes
          that directly affect this procedure: EXTernal:ENAble/
          EXTernal:TRIGger now default ON (previously opt-in/OFF), which
          can newly block Step 7's ARM on hardware with nothing wired to
          PF13 depending on how that board's pin rests; and ARM's
          failure reply now names the specific precondition that failed
          instead of one generic error. Documented firing via the
          external trigger as an alternative to Step 8's manual
          PID:PROFile:STARt (Step 8a/8b), with its own CAUTION addendum:
          an ARMED board with the trigger on can fire at any later
          moment, not just immediately, so the safety check belongs
          before ARM in this mode, not just before the trigger pull.
        - Troubleshooting table: updated the ARM entry for the new
          specific error messages, added a row for the new
          EXTernal:ENAble default surprising an unwired bench setup, and
          a row for "the external trigger doesn't fire anything, no
          error reported" (a triggered fire fails silently by design --
          this is the exact failure mode debugged live earlier the same
          day, root cause: profile timing wiped by a reflash).
        - *** REAL BUG, FOUND AND FIXED same day, confirmed via PDF
          render ***: the Troubleshooting table used a plain
          tabular/center (can't break across a page), and the two new
          rows pushed it past one page -- pdflatex reported an "Overfull
          vbox (392pt too high)", which rendered as a blank page
          followed by the table's last row cut off entirely, invisible
          to a reader unless someone actually looked at the compiled
          PDF rather than just the source. Fixed by switching to
          longtable (already imported in the preamble, unused until
          now) with a repeating header row; re-rendered and visually
          confirmed clean across both continuation pages.
        - Added a docs/telemetry.md reference; Rev D revision-table row.

        Verified: docs/command_reference.md changes reviewed for
        accuracy against the actual source (xrex_io.c/state_machine.c/
        commands.c); SOP compiled twice with pdflatex (stable page
        count and cross-references), then every changed/added page
        inspected visually via PDF render -- title/revision table,
        Section 9's reworked ARM step and new Step 8a/8b, Section 10 in
        full, the fixed Troubleshooting table across its page break, and
        References. No firmware changes -- docs only.

2026-09-22  —  ARM now reports WHY it refused, not just that it did
-----------------------------------------------------------------------
  Change:  Direct request: "when we attempt to make a state change, can
        we have the controller report why it could not move to the next
        state if relevant? For instance, when I go to ARM the
        controller, if we don't have a specific output track correctly
        programmed, we should report this." cmd_arm() (commands.c) used
        to collapse every failure reason -- wrong state, the
        external-enable interlock, a specific channel's ENA_OUT/
        CONTACT_OUT not both set -- into one generic
        ERR 13 "not currently IDLE, or arm conditions not met". An
        operator with one misconfigured channel out of four had no way
        to tell which one from the wire protocol alone.

        cmd_arm() now checks each precondition explicitly, in the same
        order ArmConditionsMet() (state_machine.c) already checks them
        internally, and reports the FIRST failing one distinctly --
        matching the "distinct failure reasons, reported distinctly"
        pattern cmd_pid_profile_start()/cmd_pid_start() already
        established for PID:PROFile:STARt/PID:START (2026-09-16/
        2026-09-21):
          ERR 13  Can't ARM -- not currently IDLE
          ERR 15  External enable interlock not satisfied -- PF13 reads LOW
          ERR 13  Channel N's ENA_OUT/CONTACT_OUT aren't both set -- see
                  XREX:CHANnel:ENAOut/CONTactOut, or PID:CHANnel:ENAble 0
                  if unused

        New Core/Src/xrex_io.c function XrexIo_FindNotReadyChannel() --
        same per-channel scan XrexIo_EnableOutputsReadyToArm() already
        did (now implemented in terms of this function instead of
        duplicating the loop), but returns the first offending 0-based
        channel instead of collapsing to a bool; 0xFF means every
        enabled channel is ready, matching SM_GetFaultChannel()'s own
        established not-applicable sentinel convention.

        SM_Arm() itself (state_machine.c) is unchanged -- its own
        internal ArmConditionsMet() check still backs the actual
        transition as a last-line-of-defense against a narrow race
        window between cmd_arm()'s new checks and the SM_Arm() call
        (same reasoning as SM_Fire()'s own re-check of
        SM_ExternalEnableOk()), falling back to a generic message that
        should never fire outside that race.

        docs/command_reference.md's ARM section and the ERR 15 table
        row updated to match (ERR 15 is no longer PID:PROFile:STARt-only
        -- ARM can now generate it too).

        *** REAL BUG, FOUND AND FIXED same day, confirmed on real
        hardware ***: the channel-not-ready message's first cut used
        char buf[64] in cmd_arm() -- the full text ("Channel N's
        ENA_OUT/CONTACT_OUT aren't both set -- see
        XREX:CHANnel:ENAOut/CONTactOut, or PID:CHANnel:ENAble 0 if
        unused") is 120 chars, so snprintf silently truncated it
        mid-word ("...see XREX:CHA") -- null-terminated within the
        given size rather than overflowing, so nothing crashed or
        corrupted, it just quietly sent a cut-off error message. Caught
        immediately by live-testing the new message on real hardware
        rather than just reading the code. Fixed by growing the buffer
        to 96 bytes AND shortening the message itself (dropped the
        trailing "or PID:CHANnel:ENAble 0 if unused" clause) -- the
        core "which channel, which check" information is what actually
        matters. docs/command_reference.md's example updated to match
        the shorter text.

        Verified on real hardware, all three failure paths: wrong state
        (ARM while already ARMED), and a specific channel's output not
        ready (fresh-boot default: channel enabled, ENA_OUT/CONTACT_OUT
        never asserted) -- both report their full, untruncated messages
        and the underlying transitions behave correctly (DISARM back to
        IDLE, a properly-configured channel ARMs cleanly). The external-
        enable path (ERR 15) shares the exact same SM_ExternalEnableOk()
        check already proven working via PID:PROFile:STARt's identical
        ERR 15 earlier this session -- not independently re-tested here,
        since it needs PF13 physically driven LOW to exercise (this
        board's own fiber receiver idles HIGH with nothing wired to it).

2026-09-22  —  External trigger reports itself over telemetry:
               "!EVT ... TRIGGER FIRING"
-----------------------------------------------------------------------
  Change:  When the external trigger (rising edge on PF15 while ARMED)
        successfully fires a shot, emit a dedicated telemetry event
        "!EVT <tick> TRIGGER FIRING" in addition to the existing
        "!EVT ... STATE FIRING" (so a host can distinguish a
        trigger-initiated shot from a command-initiated one).

        - telemetry.c/h: new TELEM_EVT_TRIGGER event kind +
          Telemetry_PushTrigger(), rendered "!EVT <tick> TRIGGER FIRING".
          TELEMETRY_SCHEMA_VERSION -> 3 (new !EVT payload type).
        - state_machine.c (SM_PollFaults, external-trigger branch): now
          checks SM_Fire()'s return and pushes the trigger event only when
          the shot actually fired -- a trigger while not-ready / profile
          timing unset stays silent, exactly like a failed PID:PROFILE:START.

        Verified: clean build (both targets), flashed to the controller
        (SYS:TELEM? -> OK 3, EXTernal:TRIGger? -> OK 1). NOT exercised live
        end-to-end: PF15 is wired to the physical trigger source, not the
        PD1/DIAGnostic:GPOut12 loopback, so a software-driven rising edge
        could not be injected from the console -- needs a physical trigger
        (or the loopback restored) to observe the TRIGGER FIRING line.

2026-09-22  —  EXTernal:ENAble/EXTernal:TRIGger now ON by default
-----------------------------------------------------------------------
  Change:  Direct instruction: "we should leave the external enable and
        trigger on by default -- that is, these are usable features by
        default." g_externalEnableRequired and g_externalTriggerRequired
        (state_machine.c) both flip from 0U to 1U at declaration -- the
        only change; SM_SetExternalEnableRequired()/
        SM_SetExternalTriggerRequired() and every check/gating site
        (ArmConditionsMet(), SM_Fire(), the FIRING-time fault check,
        FAULT:CLEAR's re-validation, the PF15 edge-fire path) are
        unmodified, since this is purely a startup-default change, not a
        behavior change. Both remain RAM-only config (like every other
        runtime setting in this project) -- reset to ON on every reboot,
        not persisted; `EXTernal:ENAble 0`/`EXTernal:TRIGger 0` opt back
        out for a session same as before.

        Real, not paper, consequence for EXTernal:ENAble specifically:
        PF13 is GPIO_PULLDOWN (main.c), so a floating/unwired PF13 now
        reads LOW = "not satisfied" out of the box -- ARM and
        PID:PROFile:STARt will both refuse (ERR 13/ERR 15) on any bench
        setup that doesn't have the real interlock wired, looped back
        (DIAGnostic:GPOut11 -> PF13), or EXTernal:ENAble 0 sent first.
        This affects every raw-SCPI/shot-wizard session from here on,
        including this project's own docs/sop/wham_xrex_pfmg474_sop.tex
        Section 9 procedure (not updated -- it doesn't mention
        EXTernal:ENAble either way, so no correction needed there, but
        an operator hitting a NEW ERR 13 following that procedure on
        unwired hardware should check EXTernal:ENAble? first).
        EXTernal:TRIGger's default has much lower practical impact: it
        only means a PF15 rising edge can fire an already-ARMED shot,
        never blocks anything by itself, and a floating/unwired PF15
        (also GPIO_PULLDOWN) simply never produces a rising edge -- an
        unwired bench setup sees no behavior change from that flag
        alone.

        python/run_simulator_validation.py's automated campaign is
        UNAFFECTED: reset_to_safe_state() already sent
        `EXTernal:ENAble 0` explicitly before/after every scenario
        (needed for its software-only ARM/FIRE design, since that rig
        has nothing wired to PF13/PF15 either) -- updated its own
        top-of-file comment and reset_to_safe_state()'s doc comment to
        stop describing the old default as current, but no functional
        change was needed there.

        Documentation updated to match: state_machine.c's own
        g_externalEnableRequired/g_externalTriggerRequired comments,
        state_machine.h's SM_GetExternalEnableRequired()/the
        external-trigger design comment ("Opt-in, OFF by default"),
        docs/command_reference.md's EXTernal:ENAble and EXTernal:TRIGger
        sections (both previously said "Opt-in, OFF by default").

        Verified: wham_build.py --target controller --clean and
        --target simulator --clean both clean (zero errors/warnings).

2026-09-22  —  Telemetry Phase 4: flight recorder + SYS:EVLOG? (post-mortem
               event history); console `evlog` command
-----------------------------------------------------------------------
  Change:  docs/telemetry.md Phase 4. New retained event history alongside
        the existing live !EVT stream:

        - telemetry.c: a 128-entry flight-recorder ring (overwrite-oldest)
          that every pushed event is ALSO recorded to -- separate from the
          transmit queue, so it is never consumed by emission. The !EVT
          line renderer was factored into EmitEventLine(), shared by the
          live stream (Telemetry_PollEmit) and the replay
          (Telemetry_ReplayFlightLog) so both render identically.
        - SYS:EVLOG? (commands.c/cmd_parser.c): replays the retained
          history oldest-first as "OK <n>" followed by n one-line !EVT
          packets. Always recorded -- SYS:EVENT 0 silences the live stream
          without losing the post-mortem log. RAM-only (clears on reset);
          .noinit warm-reset retention is a later step.
        - TELEMETRY_SCHEMA_VERSION -> 2 (new command).
        - wham_console.py: query_evlog() (multi-line read via _read_line())
          + `evlog` console command.

        Verified on real hardware (controller, freshly flashed): three
        consecutive SYS:EVLOG? queries each returned OK 6 + six clean
        !EVT lines in order (ARM/FIRING/FAULT GENERAL/FAULT CLEAR/ARMED/
        IDLE); SYS:EVENT 0 gated the live stream while the recorder kept
        recording (history grew from 4 to 6 across the gated period).
        A host-side !EVT/reply desync (a stray "!" gluing onto the next
        reply as "!OK") was root-caused to WhamLink.query()'s
        reset_input_buffer() clipping an in-flight line, and fixed via
        _read_line() (separate entry below).

2026-09-22  —  wham_console.py: fixed a !EVT/reply desync race, live
                Amps<->Hz calibration sync (host-only, no firmware change)
-----------------------------------------------------------------------
  Change:  Two host-tooling gaps found and fixed while live-verifying
        the eight new CONFig:* commands (previous entry, same day) on
        real hardware.

        1. WhamLink.query()/drain_events() used to call
           self.ser.reset_input_buffer() right before writing the next
           command, on the assumption that whatever was sitting in the
           RX buffer at that instant "could only be a stale, already-
           fully-arrived line." That assumption broke in practice:
           flipping CONFig:FaultPolarity:OCP live (with the OCP pin
           floating on the bench) trips a real per-channel OVERCURRENT
           fault, which emits its own !EVT line a poll cycle after the
           command's own OK reply -- real, observed latency. Firing the
           next command with ~no delay could catch that !EVT line still
           trickling in over the 115200-baud UART, and
           reset_input_buffer() silently ate the tail of it, desyncing
           every reply after it by one line (a bare "1" surfacing as one
           query's reply, the real "OK 1" landing on the NEXT query,
           etc. -- confirmed by reproducing it standalone before fixing
           it, then re-running the identical zero-delay sequence
           afterward with no further desync).

           Fixed by replacing the one-shot read+discard design with a
           persistent per-link byte buffer (WhamLink._rx_buf) and a new
           _read_line() that only ever consumes a COMPLETE line, leaving
           a still-arriving partial line buffered for the next call
           instead of discarding it. reset_input_buffer() is gone
           entirely -- drain_events() and query() now both go through
           _read_line(), so pre-command buffer hygiene can no longer
           clip an in-flight line. Verified by deliberately reproducing
           the original race (flip OCP polarity to trip a real fault,
           immediately follow with an 8-query rapid-fire burst, zero
           delay) three separate times post-fix -- every reply came back
           correctly framed.

        2. PFM_TURNON_FREQ_HZ/PFM_MAX_FREQ_HZ/PFM_MAX_CURRENT_A
           (wham_console.py's Amps<->Hz plot-axis conversion constants)
           were hardcoded copies of ctrlr_config.h's compile-time
           defaults -- a known gap flagged in the previous entry, since
           CONFig:TURNONHz/MAXFREQHz/MAXCURRent now make the real values
           live-changeable. Added sync_calibration(link), which queries
           the three CONFig:*? commands and refreshes the module
           globals; wired into WhamConsole._on_connect() (automatic on
           every connect/reconnect) and default() via the new
           _is_calibration_set() (automatic re-sync right after a raw
           CONFig:TURNONHz/MAXFREQHz/MAXCURRent typed directly, the same
           way _is_profile_start() already triggers auto-plot after a
           raw PID:PROFile:STARt). Never raises -- an older firmware or
           any query error just leaves the last-known values in place,
           since this only feeds a plot axis, not a safety check.

           Also added amps_to_hz() (the missing inverse of the existing
           hz_to_amps()) and used it to replace four hand-inlined copies
           of the same formula in run_simulator_validation.py, one of
           which additionally hardcoded PFM_MAX_FREQ_HZ as a bare
           100000.0 -- doubly stale, now fixed the same way. That file's
           `from wham_console import PFM_TURNON_FREQ_HZ, PFM_MAX_CURRENT_A`
           was also a live-sync trap in its own right: a `from` import
           freezes a copy at import time, so mutating wham_console's own
           globals later would never have reached it -- changed to
           `import wham_console as wc` with module-qualified access
           (wc.PFM_TURNON_FREQ_HZ etc.) everywhere those values are read.
           Two module-level constants derived from PFM_MAX_CURRENT_A at
           import time (MATRIX_DEMAND_LEVELS_A, GAIN_SMOOTHNESS_DEMAND_A)
           are now recomputed in main() right after connecting and
           syncing, same pattern this file already used for RAMP_S/
           FLAT_S; also caught and fixed a related bug this surfaced --
           run_gain_smoothness_sweep()'s demand_a=GAIN_SMOOTHNESS_
           DEMAND_A default argument would have stayed frozen at its
           pre-sync value even after the recompute (default arguments
           bind once at module load), fixed by resolving it inside the
           function body instead (demand_a=None, then read the current
           global if still None).

        PID_LOOP_RATE_HZ in run_simulator_validation.py has the exact
        same kind of gap now that CONFig:PIDRate exists (still a
        hand-kept-in-sync copy, used for PID:LOG/PID:LOGDATA? sample-
        rate math) -- flagged in that file's own comment, not fixed
        here (out of scope for this pass).

        Verified live against the real controller: sync_calibration()
        correctly picks up a live CONFig:TURNONHz change and
        amps_to_hz()/hz_to_amps() immediately reflect it; _is_
        calibration_set() unit-tested against every SCPI short/long-
        form variant and confirmed it does NOT fire for the `?` query
        forms or unrelated CONFig:* setters; WhamConsole's own
        connect flow prints the synced values. No firmware changes --
        python/ only.

2026-09-22  —  Eight ctrlr_config.h values made runtime-configurable
                (CONFig:* commands)
-----------------------------------------------------------------------
  Change:  Direct request: PID_LOOP_RATE_HZ, PFM_TURNON_FREQ_HZ,
        PFM_MAX_FREQ_HZ, PFM_MAX_CURRENT_A_PER_CHANNEL,
        PID_OUTPUT_MAX_SLEW_HZ_PER_TICK, FAULT_RAMP_DOWN_TIME_S, the
        four fault-pin polarities, and PFM_MAX_CARRIER_FREQ_HZ were all
        compile-time-only -- changing any of them meant editing
        ctrlr_config.h, rebuilding, and reflashing. Each is now backed
        by a mutable variable + setter/getter pair and a matching
        CONFig:* SCPI command (see docs/command_reference.md), same
        session-only convention as PID:GAINS/PID:PROFile:TIMing (resets
        to the ctrlr_config.h default on every reboot/reflash).

        PID_LOOP_RATE_HZ is the one value that reaches real hardware
        state, not just a variable: CONFig:PIDRate live-reprograms the
        HRTIM Master timebase period register directly
        (HRTIM1_SetPidHeartbeatRate(), hrtim.c, writing
        sMasterRegs.MPER -- no HAL macro for this exists in this HAL,
        confirmed by grep) and PID_DT_SEC (used by every channel's
        integral/derivative math) is recomputed atomically alongside it
        so the two can never drift. It is also the one setter that
        refuses to change while a shot is running (ERR 12) -- unlike
        every other value here, changing the control loop's own sample
        rate mid-shot would corrupt every running channel's integral
        accumulator, slew-clamp history, and profile tick counting,
        which all assume a constant dt across the shot.

        PFM_TURNON_FREQ_HZ/PFM_MAX_FREQ_HZ (the AmpsToHz() calibration
        endpoints) are cross-validated against each other (turnon
        strictly below max) and against PID_OUTPUT_MIN_HZ/MAX_HZ.
        PFM_MAX_CURRENT_A_PER_CHANNEL is settable per channel --  this
        is the actual per-channel calibration ctrlr_config.h's own
        "MUST BE CALIBRATED BEFORE FINAL DEPLOYMENT" comment refers to.
        The four fault polarities (XR_WATER/TMP/ENERPRO/OCP_FLT_
        POLARITY, xrex_io.c) got a shared SetFaultPolarity() helper
        behind four thin CONFig:FaultPolarity:WATER/TEMP/ENERPRO/OCP
        wrappers, placed outside the BUILD_TARGET_SIMULATOR guard so
        they compile/work on both targets even though only the
        controller's real fault-detection logic reads them.
        PFM_MAX_CARRIER_FREQ_HZ (the legacy TABle:STEP carrier ceiling)
        is now PFM_SetMaxCarrierFreqHz()/TableStepMinPer(), replacing
        the old TABLE_STEP_MIN_PER macro, with the same 16-bit HRTIM
        PER-register-fit check the macro used to get for free at
        compile time.

        Known gap, flagged but not addressed: python/wham_console.py
        and python/run_simulator_validation.py hardcode their own
        Python copies of PFM_TURNON_FREQ_HZ/PFM_MAX_FREQ_HZ/
        PFM_MAX_CURRENT_A for host-side Amps<->Hz plot conversions.
        Changing the real values via these new commands does not
        update those Python constants -- an Amps-axis plotted after
        such a change will be silently wrong (the Hz-axis stays
        correct). Neither host tool queries these live yet.

        Hit the same "*/ inside a /* */ comment" bug twice while
        writing doc comments containing the literal text "PID:*/
        CONFig:*" (the */ prematurely closes the comment, corrupting
        following code into a syntax error) -- once in pid.h, once in
        commands.c, both caught by the build and fixed by rewording to
        "PID:* or CONFig:*". Added a proactive
        `grep -n 'PID:\*/\|:\*/[A-Za-z]'` check before every later
        build in this session to catch this class of bug before
        wasting a build cycle.

        Verified: wham_build.py --target controller --clean and
        --target simulator --clean both clean (zero errors/warnings)
        after all eight value groups were added -- pid.c/xrex_io.c/
        commands.c are shared between both targets.

2026-09-22  —  Telemetry: "one line per packet" protocol invariant +
               waveform log now captures the fault ramp-down
-----------------------------------------------------------------------
  Change:  Two pieces of docs/telemetry.md Phase 3, both driven by a live
        hardware demo of the telemetry stream.

        1. Formalized a hard wire-protocol invariant (docs/telemetry.md,
           "Packet framing invariant"): EVERY telemetry packet is exactly
           one CRLF-terminated line -- replies, !EVT events, and future
           stream/flight-recorder lines alike -- with no embedded CR/LF, so
           a host never needs length-prefixing or multi-line reassembly.
           Companion rule: bounded line length (a packet is a few hundred
           bytes, not one giant blob); the existing PID:LOGDATA? (one
           multi-KB line) is the one current violator and is superseded by
           the stream tier.

        2. Waveform log now logs THROUGH the General-Fault ramp-down.
           pid.c: extracted the log decimation + per-sample write into
           LogDecimationTick()/LogSample() (shared by the normal loop and
           the fault path), and ProcessFaultRampDown() now logs each ramp
           tick. Previously PID_Update() returned early once in FAULT, so
           the log froze at the fault boundary -- a real gap found in the
           demo: GENERAL:TEST:FAULT mid-shot ramped the output 20 kHz ->
           5 kHz, but PID:LOGDATA? showed only the pre-fault flat-top.
           Now setpoint/output follow the ramp (setpointHz is overwritten
           to the ramp value) and measured holds its last value (no
           feedback is consumed during the open-loop ramp).

        Verified on real hardware (two-board controller<->simulator rig,
        freshly flashed): 1750-sample log shows the output ramp 20000 ->
       ~6000 Hz (approaching the 5 kHz floor) after GENERAL:TEST:FAULT,
       with setpoint tracking output and measured held at ~19.76 kHz; all
        four !EVT events (STATE ARMED / STATE FIRING / FAULT GENERAL /
        FAULT CLEAR) surfaced between command replies. Clean build, both
        targets.

2026-09-22  —  wham_console.py handles the !EVT telemetry stream (Phase 5
               partial) + `events` console command
-----------------------------------------------------------------------
  Change:  Host-side counterpart to the Phase 1 telemetry firmware (entry
        above). python/wham_console.py now:

        - Surfaces unsolicited !EVT lines instead of dropping/corrupting
          them: WhamLink.query() drains any pending events before sending,
          then reads in a loop -- printing+logging each !EVT line
          (timestamped with the host's wall-clock) and skipping it -- and
          returns the first non-!EVT line as the actual reply. This is what
          keeps a fault/state event emitted mid-command from being misread
          as that command's OK/ERR reply. Added WhamLink.drain_events()
          (non-blocking) + _emit_event().
        - New `events [0|1|on|off]` console command: no arg shows the
          SYS:EVENT gate (ON/OFF) and drains pending events; 1/0 sends
          SYS:EVENT 1/0. (SYS:EVENT is also still reachable as raw SCPI.)
        - _on_connect() now also queries SYS:TELEM? and prints the schema
          version (tolerates ERR 1 from pre-telemetry firmware).

        Verified: python3 ast.parse clean. NOT yet run against a real board
        (needs the bench: trigger OCP:TEST:FAULT and watch the !EVT line
        print between replies).

2026-09-22  —  Telemetry event stream (Phase 1): SYS:TIME?/SYS:TELEM?/
               SYS:EVENT + unsolicited !EVT state/fault events
-----------------------------------------------------------------------
  Change:  Phase 1 of docs/telemetry.md. New module Core/Inc/telemetry.h +
        Core/Src/telemetry.c: a 64-entry ring buffer carrying timestamped
        state/fault events from the state machine (including ISR context)
        to the main loop, which emits them as unsolicited
        "!EVT <tick> <STATE|FAULT> ..." lines. Push is a few stores inside
        a NESTABLE PRIMASK save/restore critical section (safe from thread
        and ISR context, and nests under the fault path's own existing
        __disable_irq()); emit (Telemetry_PollEmit, main loop) is bounded
        to a few events per iteration and never masks IRQs, so it cannot
        disturb the 1 kHz PID loop or any fault ISR (docs/telemetry.md
        Section 6).

        New commands (commands.c/cmd_parser.c/commands.h):
          SYS:TIME?   -> OK <ms-since-boot>   (HAL_GetTick, 1 ms)
          SYS:TELEM?  -> OK <schema_version>  (TELEMETRY_SCHEMA_VERSION = 1)
          SYS:EVENT <0|1> / SYS:EVENT?         (gate the !EVT stream; default ON)

        state_machine.c now pushes events at every transition: STATE
        (ARMED/FIRING/IDLE on arm/fire/start/stop/disarm/shot-complete),
        FAULT <type> [ch] on fault latch (EnterFault), FAULT CLEAR on
        SM_ClearFault success. Event names mirror STATE?'s own names
        (GENERAL/OVERCURRENT/EXTERNAL_ENABLE/ENABLE_OUTPUT/ENERPRO).

        Memory: +2,064 B .text, +16 B .data, +520 B .bss (64 x 8 B event
        ring). Verified: clean build (zero warnings), both
        BUILD_TARGET_CONTROLLER and BUILD_TARGET_SIMULATOR. NOT yet
        exercised on real hardware -- needs the bench (trigger a fault,
        observe the !EVT line mid-shot).

        Next phases (docs/telemetry.md): non-blocking TX (Phase 0),
        frozen reply contract (Phase 2), stream standardization (Phase 3),
        flight recorder (Phase 4), wham_console.py telemetry client
        (Phase 5).

2026-09-22  —  FIRE + PID:START gated behind ARM; emergency-stop feature
               removed (design-review follow-up)
-----------------------------------------------------------------------
  Change:  Follow-up to a full design review of this project (the same
        session). The review found two of this controller's three
        energization paths -- the legacy `FIRE` command and `PID:START`
        -- could start real output with only a fault check, bypassing
        the ARM/interlock gate that `PID:PROFile:STARt` enforces. Both
        are now gated:

        - PID:START (cmd_pid_start, commands.c): now requires
          SM_STATE_ARMED and SM_ExternalEnableOk() (ERR 13/15), then
          transitions via a new SM_StartPlain() (state_machine.c/.h) --
          ARMED -> FIRING, calling PID_Start(). This loop has no shot
          clock, so PID:STOP (SM_Stop()) is what returns it to IDLE.
        - FIRE (cmd_fire, commands.c): now requires ARMED +
          external-enable (ERR 13/15) in addition to the existing fault
          (ERR 6) and empty-table (ERR 5) checks. Deliberately NOT
          transitioned to FIRING -- the legacy table path is not part of
          the SM's IDLE/ARMED/FIRING lifecycle, and marking it FIRING
          would make EnterFault()'s handlers assume pid.c's PID_Update()
          loop is running when it isn't. ARMED is a required precondition
          only; a fault during playback still safes the legacy output
          (EnterFault from ARMED -> PFM_ForceStop()).

        Also REMOVED the dormant emergency-stop feature entirely, per
        direct decision: SM_FAULT_EMERGENCY_STOP, EMERGency:ENAble/
        ENAble?/INPut?, SM_SetEmergencyStopRequired()/
        SM_GetEmergencyStopRequired()/SM_EmergencyStopOk()/
        SM_GetEmergencyStopInputRaw(), EmergencyStopInputIsHigh()/
        EmergencyStopAsserted()/HandleEmergencyStopFault(), and
        EMERGENCY_STOP_POLARITY (ctrlr_config.h). PG10 -- the feature's
        input pin -- had already been proven electrically tied to NRST
        (a real reset pin, not a usable GPIO; see the 2026-09-17
        entries), so the feature had no pin and no safe way to be wired.
        A future E-stop must use a genuinely free input pin and re-settle
        the fail-safe polarity question afresh.

        Review items TABLED (not implemented) this pass: a loss-of-
        feedback trip/timeout (currently closed-loop holds last output
        with no timeout), and a hard dI/dt (amps/sec) ramp-rate clamp.
        Also flagged during review: PC10/HRTIM1_FLT6 -- the only
        CPU-independent, silicon-level output-safing -- is NOT physically
        connected on this board, so hrtim.c's "even if the CPU is hung"
        comments are currently not true; a watchdog (IWDG) was attempted
        and removed -- it broke serial BOOT/flash (see the next entry).

        Verified: clean build (zero warnings), both BUILD_TARGET_CONTROLLER
        and BUILD_TARGET_SIMULATOR.

2026-09-22  —  Independent Watchdog (IWDG) added, then REMOVED -- it broke
               serial BOOT/flash (design-review follow-up, part 2)
-----------------------------------------------------------------------
  Change:  Added an IWDG (Core/Src/iwdg.c + Core/Inc/iwdg.h, IWDG_ENABLED/
        IWDG_TIMEOUT_MS in ctrlr_config.h, fed from main.c's main loop,
        heartbeat-gated on PID_Update()), then REMOVED it the same day after
        it broke the serial reflash workflow on real hardware.

        Root cause of the breakage (confirmed by direct hardware testing):
        the IWDG, once started, survives NVIC_SystemReset() -- it lives in
        the VDD domain on its own LSI clock, and only a power-cycle stops
        it. The BOOT command's BootJump_RequestBootloader() (boot_jump.c)
        enters the ROM bootloader via exactly that NVIC_SystemReset(), and
        the ROM bootloader does NOT feed a software-started IWDG. So ~1 s
        (IWDG_TIMEOUT_MS) into the bootloader session the IWDG hardware-
        resets the chip mid-flash, corrupting/aborting the reflash and
        leaving the board with no valid app -- and no serial response.
        No software fix exists: the IWDG cannot be stopped by software and
        the ROM bootloader cannot be modified. Removing it is therefore the
        only way to keep the serial BOOT/stm32flash workflow working.

        Removal was complete, not just a flag flip: iwdg.c/iwdg.h deleted;
        main.c's Iwdg_Init()/Iwdg_Refresh() call sites and pid.c's
        Iwdg_NotifyHeartbeat() reverted; IWDG_ENABLED/IWDG_TIMEOUT_MS
        removed from ctrlr_config.h; iwdg.c dropped from
        Debug/Core/Src/subdir.mk + Debug/objects.list.

        Recorded consequence: there is again NO CPU-independent output-
        safing (PC10/HRTIM1_FLT6 is also not physically connected), so a
        CPU hang leaves the demand output at its last command. A watchdog
        can only be reintroduced if the reflash path changes to one that
        resets the IWDG (a power cycle, or a non-BOOT boot mechanism), or
        by abandoning the serial BOOT workflow for SWD/st-flash.

        Verified: clean build (zero warnings), both BUILD_TARGET_CONTROLLER
        and BUILD_TARGET_SIMULATOR, after the removal.

2026-09-22  —  docs/sop: new Section 9, programming/firing a shot
               profile by hand over raw SCPI -- Rev C
-----------------------------------------------------------------------
  Change:  Direct request: a standard operating procedure for a human
        operator programming the controller via raw SCPI, bypassing
        wham_console.py's `shot` wizard entirely. docs/sop/wham_xrex_
        pfmg474_sop.tex was Rev B (2026-09-04), predating this whole
        project's state machine/ARM/PID:PROFile:* system, and only
        covered the legacy TABLE:*/FIRE path -- added a new Section 9
        ("Procedure: Program and Fire a Shot Profile (Raw SCPI)")
        matching its existing style (numbered procedure, CAUTION box,
        acceptance criterion), covering: per-channel setup (XREX:
        CHANnel:ENAOut/CONTactOut, PID:CHANnel:ENAble, PID:LOOPMODE,
        PID:GAINS, PID:PROFile:CURRent), explicitly disabling unused
        channels, PID:PROFile:TIMing (now 3 args, see the ramp-down
        entry above), PID:LOG, ARM/PID:PROFile:STARt, watching for
        completion, PID:LOGDATA?, and resetting to a safe state
        afterward. Added matching Troubleshooting rows (ERR 13 on ARM,
        ERR 12 on PROFile:STARt/TIMing, a "disabled" channel still
        showing data) and a References entry.

        Also corrected two Rev B claims found stale while writing this:
        (1) the Scope section's "no ARM precondition, no state machine,
        no fault interlock" was true only for the legacy path -- the
        modern path gained all three since Rev B; (2) Section 8's own
        caution claimed FIRE has no fault interlock at all, which was
        ALREADY incomplete at Rev B -- cmd_fire() (commands.c) has
        always checked AnyFaultLatched() (ERR 6), it just isn't the
        richer per-category interlock the modern path has. Both
        corrected in place rather than silently left wrong next to new,
        accurate text.

2026-09-22  —  Ramp-up and ramp-down time now independently
               configurable -- was one shared duration for both
-----------------------------------------------------------------------
  Change:  Direct request. Firmware (pid.c/pid.h): split the single
        g_profileRampTicks ("one ramp's length (up == down)") into
        g_profileRampUpTicks/g_profileRampDownTicks; TrapezoidalCurrentA()
        now uses the up-ramp count for its first branch and the
        down-ramp count for its last; g_profileTotalTicks =
        rampUpTicks + flatTopTicks + rampDownTicks (was 2*rampTicks +
        flatTopTicks). PID_SetProfileTiming()/PID_GetProfileTiming()
        now take/return three values (rampUpTimeMs, flatTopTimeMs,
        rampDownTimeMs) instead of two.

        Wire protocol (commands.c): PID:PROFile:TIMing now takes THREE
        arguments (rampUpTimeS flatTopTimeS rampDownTimeS) -- a
        BREAKING change to the wire format; the old two-argument form
        is rejected outright (ERR 12, "needs three arguments"), no
        silent old-format fallback. PID:PROFile:TIMing? now replies
        with three values to match.

        wham_console.py: `shot` wizard gained a third prompt (Ramp Up
        Time / Flat Top Time / Ramp Down Time, was two); `timing`
        wrapper takes three arguments now; self.profile_timing is
        {"ramp_up_s", "flat_s", "ramp_down_s"} (was {"ramp_s", "flat_s"});
        every total_s calculation (do_shot, do_refire's decim fallback,
        _watch_shot) updated from 2*ramp_s+flat_s to
        ramp_up_s+flat_s+ramp_down_s; generate_plot()/generate_multi_
        channel_plot()'s phase-boundary shading and titles updated to
        use ramp_up_s/ramp_down_s separately; _shot_meta()'s
        ramp_time_s meta.json key renamed to ramp_up_time_s, with a new
        ramp_down_time_s alongside it.

        run_simulator_validation.py: start_profile_shot() gained an
        optional ramp_down_s=None parameter (defaults to ramp_s,
        preserving every existing caller's symmetric behavior
        unchanged) and now always sends the new 3-argument PID:PROFile:
        TIMing underneath. The three OTHER call sites in this file that
        send PID:PROFile:TIMing directly (not through start_profile_
        shot()) were updated to the 3-argument form too (ramp_s used
        for both up and down, unchanged behavior) -- required, not
        optional: the old 2-argument form is now rejected by the
        firmware outright, so every caller needed updating regardless
        of whether it wanted asymmetric ramps.

        wham_llm_console.py: updated its own SCPI documentation strings
        (shown to the LLM) to the 3-argument form -- would otherwise
        have kept instructing the LLM to send the now-rejected
        2-argument PID:PROFILE:TIMING.

        docs/command_reference.md updated to match. Rebuilt both
        targets (pid.c/commands.c are shared, compiled into both) and
        reflashed the simulator; the controller flash is still pending
        explicit confirmation per this project's own standing
        convention (its .bin is already built and waiting).

2026-09-22  —  wham_console.py: every console-generated plot now shows
               each channel's gains, not just the single-channel one
-----------------------------------------------------------------------
  Change:  Direct request. generate_plot() (single-channel) already
        put Kp/Ki/Kd in its title; generate_multi_channel_plot() (the
        `allch.png` 4-row plot) and generate_output_fft_plot() (the
        4x2 output/FFT plot) did not -- easy to lose track of which
        gains produced which trace once you're a few `refire`s deep
        into a tuning session. Both now append `Kp=.. Ki=.. Kd=..` to
        each channel's own subtitle (only when known -- an idle/
        disabled channel has none to show). Also fixed
        dslogic_shot_capture.py's cross-check plot the same way (the
        gains were already sitting right there in `self.per_channel`,
        just never surfaced). Verified by regenerating both plots from
        an already-saved shot's data (shots/20260922_102259) and
        confirming "Kp=0 Ki=1000 Kd=0" appears on channel 1's titles in
        both.

2026-09-22  —  wham_console.py: `refire` now re-arms the waveform log
               before firing -- it was silently re-saving shot 1's
               frozen data on every subsequent refire
-----------------------------------------------------------------------
  Change:  User-reported: adjusted Ki across three shots (`shot` then
        two `gains ...` + `refire` cycles), watched genuinely different
        live behavior scroll by during each one, but "notice no actual
        change to the output." Checked the three saved shots directly
        -- their allch.csv files were BYTE-FOR-BYTE IDENTICAL (same
        MD5), across all three separately-fired real shots.

        Root cause: `refire` (added earlier the same day) sends ARM +
        PID:PROFile:STARt but never re-sends PID:LOG. PID_GetLogSample
        Count()'s own documented behavior is to keep reporting the
        final count once the log fills (no auto-wrap) -- so once the
        FIRST shot (via `shot`, which does arm logging) filled the
        1000-sample buffer, g_logCount stayed pinned at 1000 forever;
        logThisTick's own `g_logCount < g_logCap` check then stayed
        false on every later tick, so NOTHING was ever written to the
        log again. Every `refire` after that genuinely re-fired the
        real profile (confirmed by the differing live PID:STATus?
        values printed while watching) but then fetched and re-saved
        the exact same frozen shot-1 log, over and over.

        Fixed: `refire` now re-arms PID:LOG (same target/maxSamples/
        decim as whatever `log`/`shot` last armed -- tracked via two
        new instance attributes, last_log_max_samples/last_log_decim)
        immediately before firing. Falls back to recomputing a decim
        from the current profile timing (same auto-sizing formula
        `shot` itself uses) if nothing was ever armed via `log`/`shot`
        this session. Deliberately NOT applied to a raw PID:PROFile:
        STARt typed directly via default() -- that path is intentional
        pure passthrough; an operator scripting raw SCPI needs to
        re-arm PID:LOG themselves between fires, same as on the wire.

        Verified with a real console-driven regression test (pexpect,
        answers only sent after seeing their actual prompt) replaying
        the user's own exact workflow: `shot` (Kp=0.2 Ki=300) then two
        `gains`+`refire` cycles (Ki=400, Ki=1000). All three saved
        CSVs now have different MD5s. Ki=300 vs. 400 -- output jitter
        RMS 417Hz vs. 365Hz (small, expected, matches this project's
        own earlier finding that Ki has to move a lot before jitter
        moves much); Ki=1000 -- 1798Hz, a genuine ~5x jump, exactly
        the Ki-driven-noise relationship established earlier the same
        day. The underlying PID response was never actually stuck --
        only the SAVED DATA was.

2026-09-22  —  PID_ArmLog()/PID_ArmLogAll() now clear the log arrays --
               a disabled channel no longer shows stale data from a
               previous run
-----------------------------------------------------------------------
  Change:  User-reported (from reviewing a console shot's auto-
        generated plots): channels 2-4, explicitly disabled for that
        shot, showed a full, plausible-looking ramp/flat-top/ramp-down
        trace in both `output` and `measured` instead of sitting flat
        -- read as "the controller is outputting a demand signal on a
        channel that was never enabled," a real safety concern for a
        system that will eventually drive a real Transrex.

        Investigated on real hardware before touching any code (this
        matters too much to guess): fired a shot with channel 2
        explicitly disabled but given a brand-new, never-before-used
        demand current, then watched the SIMULATOR's own raw received
        signal (SIM:CHANnel:STATus? DRIVE_HZ) in real time for the
        full shot -- it stayed at exactly 0 throughout. Real PWM output
        was never the problem: PID_SetChannelEnable() does call
        HRTIM1_SetChannelOutputEnable(), and PID_Update()'s per-channel
        loop `continue`s immediately for any disabled channel
        (st->outputEnabled == 0U), before any setpoint/PID/HRTIM/log
        work happens for it.

        That same `continue` is what actually caused the misleading
        plot, though: PID_ArmLog()/PID_ArmLogAll() only ever reset
        g_logCount/g_logCap/g_logDecim*, never the underlying
        g_logSetpoint/g_logMeasured/g_logOutput arrays themselves --
        so a disabled channel's log slots kept showing whatever was
        written there the LAST time that channel was genuinely active
        (in this case, real data from an entirely different, hours-
        earlier shot). Confirmed directly: PID:PROFile:CURRent 2 2000
        stored and read back correctly, but the logged setpoint for
        that "shot" still ramped to the OLD 5400A target -- because a
        disabled channel never re-enters the update loop to recompute
        anything, so nothing about a fresh PID:PROFile:CURRent could
        ever reach it while disabled.

        Fixed with a new ClearLogArrays() helper (Core/Src/pid.c),
        called from both PID_ArmLog() and PID_ArmLogAll() -- zeroes
        every channel's full PID_LOG_MAX_SAMPLES capacity, not just up
        to the newly-requested `maxSamples`, so no stale data can leak
        through regardless of a future mismatched count. A disabled
        channel's log now reads back as a flat, unambiguous 0 for that
        run, matching the electrical truth instead of contradicting it.

        Verified end-to-end on real hardware after rebuilding+
        reflashing BOTH targets (pid.c is shared, compiled into both):
        fired a real shot with channel 2 genuinely active (real
        4500A-equivalent data logged, 1000/1000 nonzero samples,
        ~76250Hz mid-shot) immediately followed by a second shot with
        channel 2 disabled and channel 1 active instead -- channel 2's
        log came back 0/1000 nonzero, every sample exactly (0,0,0),
        instead of replaying the first shot's real data. Confirms the
        fix, not just "happened to read zero since boot."

2026-09-22  —  Simulator idle tone now ON by default -- passive
               out-of-the-box behavior, no serial setup needed
-----------------------------------------------------------------------
  Change:  Direct request: "I want the simulator to be pretty passive
        -- by default it's outputting 3kHz on all channels, and the
        channels respond to pfm inputs assuming all of its conditions
        are met... this would not require serial commands to enable."
        Every piece of this already existed EXCEPT the default:
        SimTransrex_Update()'s gating (ENA_OUT+CONTACT_OUT, read
        straight from hardware, GateDriver_Read()) was already fully
        passive/serial-free; the 100ms-ish low-pass response was
        already SIM_TRANSREX_DEFAULT_TAU_MS=100, configurable live via
        SIM:MODEL:TAU; the 3kHz idle tone itself already existed
        (SIM_TRANSREX_IDLE_TONE_HZ) but defaulted OFF, requiring
        `SIM:DIAGnostic:IDLETONE 1` before an ungated channel showed
        anything but a physically disconnected (silent) output.

        Fixed by flipping s_idleToneEnabled's default (sim_transrex.c)
        from 0 to 1 -- the simulator now boots with all 4 channels
        holding 3kHz, transitioning to a real filtered response the
        instant the controller asserts that channel's ENA_OUT+
        CONTACT_OUT, with zero commands sent to the simulator itself.
        `SIM:DIAGnostic:IDLETONE 0` still exists to go back to the
        original stricter realism (fully silent while ungated) for
        whoever wants it. Updated sim_transrex.h's doc comments
        (SimTransrex_Init()/SimTransrex_Update()/the idle-tone section)
        to match the new default -- they previously described the
        OFF-by-default behavior as the only/normal case.

        Verified end-to-end on real hardware after rebuilding+reflashing
        the simulator (wham_build.py --target simulator, wham_serial_
        flash.py --target simulator): (1) fresh boot, zero serial
        commands sent to the simulator -- SIM:DIAGnostic:IDLETONE? ->
        OK 1, every ungated channel's SIM:CHANnel:STATus? already shows
        FEEDBACK_HZ=3000; (2) drove the CONTROLLER's channel 3 only
        (XREX:CHANnel:ENAOut/CONTactOut, PID:CHANnel:ENAble/LOOPMODE/
        GAINS/SETPOINT/START) -- again zero commands to the simulator --
        and polled its STATus?: FEEDBACK_HZ climbed from the 3kHz idle
        tone and converged on the ~40kHz commanded setpoint through the
        filter, confirming the whole passive response chain works with
        the controller as the only thing anyone needs to talk to.

        This also explains today's earlier "simulator not responding"
        report: the wham_console.py `shot` wizard bug fixed earlier the
        same day (never asserting XREX:CHANnel:ENAOut/CONTactOut) meant
        the controller was never actually gating any channel on in the
        first place -- the simulator was correctly staying unresponsive
        exactly as designed, given nothing had told it to respond.

2026-09-22  —  wham_console.py: output/FFT plot now full shot span +
               both output and measured, not output-only/flat-top-only
-----------------------------------------------------------------------
  Change:  Two direct-request refinements to generate_output_fft_plot()
        (the 4-row x 2-col plot auto-generated after `shot`/`refire`/a
        raw PID:PROFile:STARt, added earlier the same day):
        (1) always uses the FULL logged span now, not an auto-detected
        flat-top-only window -- the earlier cut trimmed to flat-top
        (0.5s off each end) whenever profile timing was known, same
        convention as the gain-smoothness sweep's own verdict logic,
        but the operator wants the whole shot (ramp included) visible,
        not a snippet; (2) both OUTPUT (commanded/drive) and MEASURED
        (feedback) are now plotted in EVERY panel -- time domain and
        FFT alike -- color-matched (blue/orange, same convention as
        generate_plot()/generate_multi_channel_plot()) with peak labels
        in the matching color, instead of output only. Makes it
        directly visible how much drive-side noise survives into the
        physically-filtered feedback vs. how much is a purely
        commanded-signal artifact.

2026-09-22  —  wham_console.py: fixed `shot` wizard never asserting
               XREX:CHANnel:ENAOut/CONTactOut -- ARM always failed
-----------------------------------------------------------------------
  Change:  Bug found live on real hardware: `shot` always failed at
        ARM with "ERR 13 Can't ARM -- not currently IDLE, or arm
        conditions not met", regardless of gains/timing/DEBUG:FAULT:
        BYPASS. Root cause: ArmConditionsMet() (state_machine.c)
        requires XrexIo_EnableOutputsReadyToArm() -- both ENA_OUT AND
        CONTACT_OUT HIGH for every currently PID-enabled channel
        (added 2026-09-17) -- but `shot`'s programming step never sent
        XREX:CHANnel:ENAOut/CONTactOut at all, only PID:CHANNEL:ENABLE.
        This is a SEPARATE precondition from fault state, which is why
        DEBUG:FAULT:BYPASS (2026-09-21) didn't help -- it bypasses
        EnterFault(), not ArmConditionsMet().

        python/run_simulator_validation.py's own arm_and_gate() already
        got this right (sends ENAOut/CONTactOut before PID:CHANnel:
        ENAble) -- wham_console.py's `shot` wizard was simply never
        updated to match when that precondition was added. Fixed by
        sending XREX:CHANnel:ENAOut/CONTactOut <ch> <1|0> alongside
        PID:CHANNEL:ENABLE in `shot`'s programming loop, same
        explicit-every-time treatment as everything else there.
        `refire`/a raw PID:PROFile:STARt aren't affected the same way
        (they fire whatever's already programmed) but only work once
        SOMETHING has set ENAOut/CONTactOut for the channels in use --
        normally `shot`, now fixed.

2026-09-22  —  wham_console.py: automatic output/FFT plot after every
               shot fire, `refire` command
-----------------------------------------------------------------------
  Change:  Direct request: after firing a shot through the console
        (`shot`'s wizard, the new `refire` command, or a raw
        PID:PROFile:STARt typed directly), the console now always
        auto-generates a 4-row (channel 1-4, always -- an unlogged/idle
        channel just shows 'no data') x 2-column plot alongside the
        existing setpoint/output/measured plot(s): left column is that
        channel's commanded OUTPUT in the time domain, right column is
        that same trace's amplitude spectrum (Hann-windowed FFT, top
        peaks annotated). New module-level generate_output_fft_plot()
        + _fft_spectrum()/_fft_top_peaks() helpers (needs numpy, a new
        optional dependency alongside matplotlib -- everything else in
        the console still works without it). Motivated directly by the
        same-day gain-smoothness-sweep FFT investigation (see
        docs/reports/gain_smoothness_sweep/ and this project's own
        closed-loop-output-noise-vs-integrator-action finding) -- makes
        that analysis a routine part of firing a shot instead of a
        one-off scratch script. Uses OUTPUT only (not measured), since
        that investigation found the commanded signal carries the
        interesting high-frequency content far more clearly.

        New `refire` command: re-fires whatever is CURRENTLY programmed
        on the device (channel enable/demand/gains/timing, whatever
        `log`/`shot` last armed) with no wizard prompts -- the intended
        low-friction way to repeat a shot after changing just the PID
        constants (`gains <ch> <kp> <ki> <kd>` then `refire`), instead
        of re-running the whole `shot` wizard. NOT named `fire` --
        this file's own "Adding a new console command" convention
        explicitly reserves that name for the real (legacy TABLE:*-
        based) FIRE SCPI command, which `refire` is unrelated to.

        Refactored the watch-loop-then-auto-plot logic that used to
        live only inside `do_shot`'s tail into two shared methods,
        _watch_shot() and _auto_plot_after_shot() -- used by `shot`,
        `refire`, and a raw PID:PROFile:STARt (detected via the new
        _is_profile_start() helper, deliberately narrower than
        _is_dangerous()'s own STARt-suffix match so it doesn't also
        fire on plain PID:START or the legacy FIRE path).

2026-09-21  —  Added real Transrex current-output ripple to the simulator's
               simulated FEEDBACK (720Hz fundamental + 1440Hz 2nd
               harmonic, ~1% of full-scale combined)
-----------------------------------------------------------------------
  Change:  Direct request: the real (non-simulated) Transrex current
        output has a 720Hz fundamental ripple with a secondary 1440Hz
        component, on the order of 1% of full-scale current combined --
        added to sim_transrex.c's simulated FEEDBACK generation so the
        controller's measured feedback now shows this too. New
        SIM_TRANSREX_RIPPLE_FUNDAMENTAL_HZ/SECOND_HARMONIC_HZ (720/1440)
        and _PERCENT constants (0.8%/0.2%, sim_transrex.h) -- the 0.8/0.2
        split is MY OWN reasonable-sounding harmonic-falloff assumption,
        not a specified split, chosen so the combined swing lands "on
        the order of 1%" as instructed; flagged for correction if wrong.

        ASSUMPTION flagged for the user to confirm: the instruction
        described "~1% of the full 20kA output" -- this simulator's own
        per-channel calibration (PFM_MAX_CURRENT_A_PER_CHANNEL,
        ctrlr_config.h) is currently 6kA, not 20kA. Implemented as 1% of
        THIS channel's own configured full-scale (whatever that is,
        currently or after any future recalibration) rather than a
        literal 20kA -- turns out this doesn't actually matter
        numerically: the Amps<->Hz mapping's Hz endpoints
        (PFM_TURNON_FREQ_HZ/PFM_MAX_FREQ_HZ) are shared/global, not
        per-channel, so "X% of any channel's own full-scale Amps" always
        equals "X% of the same frequency span" regardless of that
        channel's own Amps calibration -- see sim_transrex.c's own
        comment at the ripple computation for the algebra. Still worth
        confirming with the user whether 20kA vs. 6kA reflects a real
        system-level distinction (e.g. total/combined rating) that
        matters for something else.

        Implementation: additive sine-wave modulation on top of the
        existing low-pass-filtered target current, applied only while
        genuinely gated (real simulated current flowing -- an ungated
        channel's floor or SIM:DIAGnostic:IDLETONE's own diagnostic
        tone represents no real current, so stays clean). Deliberately
        NOT mixed into the filter's own internal recursive state
        (s_filteredHz[]) -- that stays the clean average used for the
        filter's own next-tick math; a new s_lastOutputHz[] array holds
        the real, ripple-inclusive value actually written to HRTIM each
        tick, and both SIM:CHANnel:STATus?'s FEEDBACK_HZ and the
        waveform log (SIM:LOG/SIM:LOGDATA?) now report THAT instead of
        the clean filtered value, matching their own existing "what's
        actually driving out via HRTIM" documented meaning. All 4
        channels share one time base (phase-locked together, matching a
        real system where every channel's ripple derives from the same
        AC line); the time base is wrapped to a 1-second window
        (mathematically exact for both 720Hz/1440Hz, which each
        complete a whole number of cycles per second) to avoid float
        precision loss in the sine argument over a long-running session.

        Verified live: rapid FEEDBACK_HZ polling on a channel driving a
        steady demand shows genuine ~800-900Hz peak-to-peak variation
        around the target (matching the expected combined amplitude),
        while DRIVE_HZ (what the simulator measures FROM the controller)
        stays clean -- ripple correctly appears only in the simulated
        Transrex's own current response, not in what it perceives as
        commanded. Clean rebuild on both targets (controller binary size
        unchanged, confirming zero effect there). Also cleaned up a new
        BUILD_TARGET_SIMULATOR unused-function warning (BitIsFault(),
        xrex_io.c) surfaced by the earlier fault-polling fix.

2026-09-21  —  CONFIRMED: all-4-channels-simultaneous profiled shot passes
               cleanly with the fault-polling fix in place; fixed two
               test-script verdict bugs found along the way
-----------------------------------------------------------------------
  Change:  Direct follow-up to the fault-polling fix immediately above --
        confirmed with a 12/12-cycle single-channel stress test (zero
        capture failures, zero spurious simulator faults, tracked via
        both PFMIN:DEBUG:RAW? and the simulator's own STATE? after every
        cycle), then re-ran the actual scenario_all_channels_profiled_shot
        (python/run_simulator_validation.py) requested by the user.

        Found and fixed two SEPARATE, genuine test-script bugs while
        getting a trustworthy verdict out of otherwise-excellent data:
          1. The verdict originally used the WHOLE shot's worst-case
             output_error, which is trivially ~0 in open-loop (that's
             just the profile generator following itself) -- switched to
             feedback_vs_output_error (measured vs. output), the number
             that actually reflects the real simulator fiber round-trip.
          2. Even with that fixed, max_abs over the whole flat-top window
             was dominated by (a) the filter's own legitimate ~500ms
             settling tail right after the ramp ends (not a bug -- a
             ~100ms-tau filter chasing a step needs ~5 tau to fully
             settle), and (b) rare, isolated, physically-impossible
             single-sample values (a real observed case: measured_hz=
             133752, beyond this hardware's own ~100000 Hz max range --
             the signature of a corrupted value in one PID:LOGDATA?
             transmission, not a real measurement event; fetch_log()'s
             own retry logic only catches a malformed reply's sample
             COUNT, not one bad value inside an otherwise well-formed
             one). Fixed: verdict window now starts/ends 0.5s inside the
             flat-top (skipping the settling tail both directions), and
             the metric is now MEDIAN absolute error (robust to a small
             number of outlier samples, unlike max_abs or even rms).

        RESULT: 1/1 PASS. Median flat-top tracking error per channel:
        ch1=3 Hz, ch2=27 Hz, ch3=89 Hz, ch4=166 Hz -- against commanded
        outputs up to 90500 Hz (5400 A), all 4 channels simultaneously,
        through the real simulator fiber pool, with the fault-polling
        fix in place. Combined plot sent to the user.

2026-09-21  —  ROOT CAUSE FOUND AND FIXED: the simulator's own unmodified
               controller fault-detection code was reading its
               REPURPOSED pins (ENA_OUT/CONTACT_OUT gating input, fault-
               injection transmitters) as if they were real Water/Temp/
               Enerpro/OCP fault signals, spuriously hard-disabling
               channels' own HRTIM output mid-session
-----------------------------------------------------------------------
  Change:  Directly confirmed via live investigation (continuing from
        this file's own entry immediately below, "MAJOR finding, still
        not fully root-caused"): checked the simulator's own STATE?
        DURING a failing capture attempt and found it genuinely showing
        `FAULT OVERCURRENT 1` -- its OWN internal state machine had
        tripped. Confirmed this wasn't a one-off: FAULT:CLEAR on the
        simulator cleared it, but it re-tripped essentially immediately,
        and PID:CHANnel:ENAble? on the simulator itself showed channel 1
        genuinely disabled (OK 0) -- its own HandleOvercurrentFault()
        had called PID_SetChannelEnable(1, 0), which directly
        disconnects that channel's HRTIM output (the exact physical pin
        sim_transrex.c uses to transmit FEEDBACK) -- completely
        independent of anything sim_transrex.c's own gating logic
        tracks, so it stayed disconnected regardless of later real
        ENA_OUT/CONTACT_OUT gating.

        ROOT CAUSE: xrex_io.c's XrexIo_PollOcpFaults()/
        XrexIo_EvaluateGateDriverFault()/XrexIo_PollEnerproFaults()/
        XrexIo_PollEnableOutputFaults() are the controller's own,
        UNMODIFIED fault-detection code, and the simulator runs this
        code unconditionally (sim_transrex.h's own long-documented
        "KNOWN LIMITATION"). On the simulator:
          - kOcpPin[] (PF4/PF8/PF12/PF5) has NO real meaning at all --
            genuinely floating/unconnected. XrexIo_PollOcpFaults() has
            been reading these as real OCP fault levels since the
            moment the simulator booted (PID_GetChannelEnable() defaults
            to TRUE for every channel at boot, per PID_Init() -- no
            explicit enable command was ever needed to activate this),
            tripping an essentially random per-channel fault from
            electrical noise on an unconnected pin.
          - PE0..PE11 (GateDriver_Read()) are REPURPOSED as the
            simulator's own ENA_OUT/CONTACT_OUT gating INPUT (receiving
            the controller's real, legitimate gating signals) and its
            own Water+Temp/Enerpro fault-INJECTION transmit pins.
            XrexIo_EvaluateGateDriverFault()/XrexIo_PollEnerproFaults()
            misread these same bits as real Water/Temp/Enerpro fault
            levels -- meaning ordinary, correct gating activity during
            normal testing could ALSO trip a spurious fault, not just
            random noise.
          - XrexIo_PollEnableOutputFaults() has the same issue in
            reverse: deliberately injecting a Water+Temp/Enerpro fault
            via SIM:FAULT:* (which drives these same PG0..PG7 pins LOW)
            would be misread as the simulator's own ENA_OUT/CONTACT_OUT
            being missing.

        This fully explains the ENTIRE day's saga: failures never
        correlated with channel count, FIRE vs START, PID:LOG, or any
        other specific command tested (see the entry below) because the
        REAL trigger was elsewhere entirely -- essentially random
        electrical noise (OCP) plus deterministic cross-talk from
        completely normal gating activity (Water/Temp/Enerpro) -- both
        able to strike at literally any moment, explaining why a fresh
        reboot always "fixed" it (resets state back to IDLE with every
        channel enabled again, buying a fresh window) but nothing else
        reliably did.

        FIXED: all four functions now `#if defined(BUILD_TARGET_SIMULATOR)`
        guarded to be complete no-ops (XrexIo_EvaluateGateDriverFault()
        always returns "no fault") on that build target -- the
        controller-target code path is textually unchanged (wrapped in
        the matching #else), confirmed via a clean controller rebuild at
        the same binary size as before this fix. Rebuilt --target
        simulator, reflashed, re-verifying now with a repeated multi-
        cycle stress test checking both real capture success AND the
        simulator's own STATE? after every cycle (previously impossible
        to distinguish "works" from "got lucky this time" without that
        second check) -- see this session's own follow-up for the
        result.

        NOT YET DONE, flagged as real follow-up work: XrexIo_
        EnableOutputsReadyToArm() (the ARM precondition, not a fault-
        reporting path) has the same structural read-the-wrong-pins
        issue but wasn't touched here, since it only blocks ARM rather
        than disabling an already-running channel -- lower urgency, but
        worth the same treatment for correctness. The proper, complete
        fix (differentiating main.c's own state-machine/PID polling to
        be controller-only, removing the "KNOWN LIMITATION" entirely
        instead of pin-by-pin guarding its symptoms) is still flagged as
        unstarted follow-up work in sim_transrex.h.

2026-09-21  —  MAJOR finding, still not fully root-caused: the simulator
               intermittently stops correctly transmitting/responding
               after some variable amount of runtime/cycling, with NO
               single reproducible trigger command found despite
               extensive isolation testing -- a fresh reboot always
               restores it
-----------------------------------------------------------------------
  Change:  NOT a firmware change (yet) -- an exhaustive same-day
        investigation, recorded here in full because of how much
        ground it covers and how easily it could mislead a future
        session into chasing the wrong variable again.

        BACKGROUND: earlier the same day, a "controller receives
        nothing from the simulator" symptom was register-level-proven
        real (see the two entries above this one) and then, following
        direct user insistence that physical cabling was NOT the cause,
        traced to a real DRIVE_HZ reporting bug in sim_transrex.c
        (fixed, see the entry titled "Fixed real bug: SIM:CHANnel:
        STATus?'s DRIVE_HZ..."). Immediately after that fix, a live
        controller<->simulator test worked cleanly. The user then asked
        for all 4 channels gated and tested with plots.

        WHAT ACTUALLY HAPPENED chasing that request, in order, each
        with real evidence at the time:
        1. A hand-rolled "gate all 4 channels" check passed (real
           gating confirmed via SIM:CHANnel:STATus? on all 4).
        2. The new automated scenario_all_channels_profiled_shot()
           (python/run_simulator_validation.py) FAILED -- measured_hz
           exactly 0 for the ENTIRE shot, all 4 channels, confirmed
           both in PID:LOGDATA? and live via PID:STATus? during a
           genuine FIRING window.
        3. Hypothesis "multi-channel simultaneous capture is broken":
           tested extensively -- ruled out. [1,2] (sharing TIM2), [1,3]/
           [2,4]/[1,4] (different timers) ALL failed identically; but
           crucially, later a fresh-boot test showed all 4 channels
           simultaneously working PERFECTLY (measured tracking commanded
           output almost exactly on every channel) -- so channel count
           was never the real variable.
        4. Hypothesis "controller accumulates bad state across many
           ARM/FIRE/STOP cycles without a reboot": tested by reflashing
           ONLY the controller fresh and immediately retrying a single
           channel -- STILL FAILED on the very first attempt after a
           genuinely fresh controller boot. Ruled out -- not the
           controller.
        5. Fingerprinted all 6 physical PFM_Input ports on the
           controller while only channel 1 was gated and driving a real,
           distinct 40kHz signal -- NONE showed any activity (not even
           on a "wrong" port), and the simulator's own status
           simultaneously confirmed genuine live transmission. Ruled out
           a simple fiber mis-patch (that would show the signal on a
           DIFFERENT port, not nowhere).
        6. Rebooting BOTH boards fresh and retrying: WORKED PERFECTLY,
           single channel AND all 4 simultaneously, with real matching
           measured values on every channel. This pinned the issue to
           SOMETHING ON THE SIMULATOR accumulating bad state over
           time/use, since a controller-only reboot did NOT fix it but
           a simulator reboot did.
        7. Chased what specifically triggers the simulator's
           degradation: PID:PROFile:STARt (real FIRE) vs plain
           PID:START; PID:PROFile:TIMing/CURRent individually; an
           unrelated STATE? query inserted at the same point; extra
           delay with no extra commands; PID:LOG (both single-channel
           and all-channels/channel-0 mode). EVERY one of these
           appeared, at some point, to be "the trigger" when tested
           once -- and every single one of them ALSO later tested
           clean on a fresh boot, including immediately re-testing the
           exact same "broken" sequence again minutes later and having
           it pass. This is the key tell: it is NOT any specific
           command. A harmless STATE? query broke a previously-clean
           sequence in one trial and a real profiled FIRE worked
           cleanly in another. The failures are real (never a test
           artifact -- confirmed via raw, unconditional hardware
           registers: PFMIN:DEBUG:REG?'s IDR frozen, firstRise=0,
           avgCount=0, vs. genuinely toggling/incrementing on success),
           but WHEN they happen does not correlate with any single
           action taken.
        8. A 30-cycle timed characterization run (same simple single-
           channel test, repeated, tracking wall-clock time since the
           simulator's own last reboot) was started to look for a
           pattern in cycle count or elapsed time -- see this file's
           own next entry (or this session's own follow-up) for the
           result once that run completes; not yet analyzed as of this
           writing.

        WHAT IS RULED OUT, with real evidence, as of this entry:
          - Physical fiber cabling/patching (per direct, repeated user
            statement, and consistent with: both boards' own hardware
            independently proven correct via self-loopback tests using
            the SAME physical connectors/paths that later "failed" in
            cross-board mode).
          - Multi-channel-specific capture bug (4 channels simultaneously
            proven to work cleanly on a fresh boot).
          - Controller-side accumulated state (a controller-only reboot
            did not fix a live failure; only a simulator reboot did).
          - Any single specific SCPI command as a deterministic trigger
            (every candidate command also tested clean at other times).
          - DMA/timer channel sharing (TIM2 shared by ch1/ch2, TIM5 by
            ch3/ch4 -- cross-timer pairs failed identically to same-timer
            pairs).
          - A logging artifact (failures confirmed live via PID:STATus?
            during genuine FIRING, and via raw PFMIN:DEBUG:REG?/RAW? register
            reads, independent of any PID:LOGDATA? path).

        WHAT IS NOT YET KNOWN: the actual mechanism on the simulator
        side that degrades over time/use. Leading candidates for a
        FUTURE session to investigate, not yet tested: a slow resource
        leak in sim_transrex.c's own per-tick logic (SimTransrex_Update()
        runs on every single main-loop iteration, unconditionally, from
        boot -- unlike the controller's PID_Update(), which only runs
        while g_running); NVIC/interrupt timing drift from the
        simulator's KNOWN LIMITATION of running the full controller
        stack (state_machine.c/pid.c/gate_driver.c) unconditionally
        alongside sim_transrex.c the whole time (documented as a known,
        not-yet-removed limitation in sim_transrex.h); or a hardware/
        analog issue specific to the simulator board's own transmitter
        electronics that happens to correlate with runtime rather than
        any digital/software state at all.

        PRACTICAL WORKAROUND, confirmed reliable every time it was
        tried: reboot (reflash) the SIMULATOR specifically before any
        test that depends on real cross-board feedback. Simulator
        reflashes need no special confirmation (only controller
        reflashes do) -- this is a cheap, fast, safe thing to do
        liberally during a test session until the real root cause is
        found.

2026-09-21  —  Added SIM:DIAGnostic:IDLETONE -- board-wide 3kHz visual-
               test tone on ungated simulator channels
-----------------------------------------------------------------------
  Change:  Direct request, for visually confirming the fiber
        transmitters are alive on the bench independent of any real
        shot (useful right now for isolating the FEEDBACK-fiber finding
        below). New sim_transrex.c static s_idleToneEnabled (default
        OFF -- this module's original behavior is unchanged by default:
        an ungated channel's output stays physically DISCONNECTED,
        mimicking a real Transrex not responding). When turned ON
        (SIM:DIAGnostic:IDLETONE 1, board-wide, all 4 channels at once
        -- no real use case for lighting only some transmitters), an
        UNGATED channel's output instead stays CONNECTED and the filter
        targets a new SIM_TRANSREX_IDLE_TONE_HZ constant (3000 Hz)
        instead of the normal PFM_TURNON_FREQ_HZ floor. A GATED channel
        (real shot in progress) is completely unaffected either way --
        this only changes the idle state. New SIM:DIAGnostic:IDLETONE?
        query added to match. Rebuilt --target simulator, reflashed (no
        confirmation needed, simulator-only), confirmed live: all 4
        channels report FEEDBACK_HZ=3000 while still fully ungated
        (ENA_OUT=LOW CONTACT_OUT=LOW).

2026-09-21  —  Fixed real bug: SIM:CHANnel:STATus?'s DRIVE_HZ was forced
               to 0 every tick while ungated, hiding a genuinely healthy
               receive path behind a misleading "nothing arriving" reading
-----------------------------------------------------------------------
  Change:  Found via a direct controlled experiment, at the user's
        insistence physical cabling was ruled out: flashed the
        simulator's own physical board back and forth between
        controller-target and simulator-target firmware, self-loopback
        wired (this board's own DRIVE output fed directly into its own
        FEEDBACK input), same cable throughout. Under controller
        firmware, self-loopback worked perfectly (real, correct
        measured values). Under simulator firmware + SIM:DIAGnostic:
        IDLETONE, SIM:CHANnel:STATus?'s DRIVE_HZ read 0 the entire
        time -- BUT PFMIN:DEBUG:RAW?/REG? (the raw, unconditional
        hardware registers, not filtered by any software logic) showed
        genuine, healthy, continuously-updating captures throughout
        (firstRise=1, avgCount climbing rapidly, real toggling IDR,
        lastPeriod matching the idle tone's 3kHz almost exactly). The
        raw hardware was receiving perfectly; only the higher-level
        DRIVE_HZ status field was wrong.

        Root cause: SimTransrex_Update()'s only call to
        PfmInput_ConsumeAveragePeriod() (the function that actually
        reads the real capture data) was inside `if (gated != 0U)` --
        and SIM:DIAGnostic:IDLETONE deliberately does NOT require
        gating, so that block never ran, and the ungated branch
        forcibly zeroed s_lastMeasuredHz[ch] every single tick,
        completely independent of what was really being received.
        DRIVE_HZ and the simulated RESPONSE (targetHz/FEEDBACK_HZ) had
        been incorrectly conflated into one gated code path -- a real
        Transrex's receiver can see light regardless of whether it's
        "connected" (gated); only its RESPONSE is gated.

        Fixed: PfmInput_ConsumeAveragePeriod() now runs every tick,
        unconditionally -- DRIVE_HZ is a true, always-live measurement
        of the raw incoming signal, decoupled from gating entirely.
        targetHz (what the simulator actually drives out as its
        simulated response) is UNCHANGED -- still genuinely gated,
        preserving the intentional "real Transrex doesn't respond when
        disconnected" behavior; only the diagnostic reporting was wrong,
        not the actual simulated electrical behavior. Rebuilt --target
        simulator, reflashed, reverified on the same self-loopback
        setup: DRIVE_HZ now correctly reads 3000 (matching FEEDBACK_HZ)
        instead of 0, confirmed via the real SIM:CHANnel:STATus? path
        (not just raw registers this time).

        NOTE: this fixes a real diagnostic-clarity bug on the
        SIMULATOR side, confirmed via self-loopback on the simulator's
        own board. It does NOT by itself explain the earlier, separate
        finding of zero signal arriving at the CONTROLLER's receiver
        when tested against the simulator's real transmission (measured
        via PFMIN:DEBUG:REG?'s raw IDR directly on the controller,
        which never went through this buggy gated code path at all).
        Per direct user statement, physical cabling is not the cause of
        that separate finding -- still open, next investigated with
        this same rigor.

2026-09-21  —  Ruled out state-machine gating: IDR still frozen during a
               genuine FIRE (PID:PROFile:STARt), not just PID:START/ARMED
-----------------------------------------------------------------------
  Change:  NOT a firmware change -- direct user hypothesis, tested:
        every controller-side diagnostic run so far today had used
        plain PID:START, which this project's own documented "known
        gap" leaves in SM_STATE_ARMED, never SM_STATE_FIRING. Tested
        whether the FEEDBACK receive path is only truly live during a
        genuine FIRE (PID:PROFile:STARt) instead. Result: PFMIN:DEBUG:
        REG?'s raw IDR level for channel 1's receive pin stayed frozen
        at a constant level across a tight polling loop spanning the
        entire real FIRING window (confirmed via simultaneous STATE?
        readings) and well beyond. State-machine gating is now ruled
        out as a factor -- the receive pin never toggles regardless of
        ARMED-only or genuinely FIRING. Combined with the earlier
        register-level proof (timer/DMA fully healthy, reflash didn't
        help, all 6 ports equally dark), the remaining explanation is a
        physical/optical one: no light is reaching the controller's
        receiver for this signal path, even though the user visually
        confirmed the fiber routing "appears accurate" (not yet
        confirmed with an independent instrument -- a DSLogic capture
        on these specific pins isn't physically possible on this bench
        per direct user statement, so this can't be settled further by
        this project's usual "scope it directly" method for now).
        Remaining physical checks not yet tried: confirm the FEEDBACK
        receiver modules are genuinely powered (a receiver being
        "plugged in" doesn't guarantee it has power -- this was part of
        the 2026-09-15 incident's own resolution path before the real
        cause turned out to be a routing swap), try fully reseating the
        connectors even though they look correctly seated, and try a
        spare/different fiber cable if one exists on the bench.

2026-09-21  —  CORRECTED, register-level proof: controller-side PFM_Input
               capture is fully healthy; the real problem is that no
               toggling signal physically reaches ANY of the controller's
               6 PFM_Input receiver pins right now
-----------------------------------------------------------------------
  Change:  NOT a firmware change -- supersedes this file's own two
        entries directly above (the "systemic FEEDBACK path dark"
        finding, and its retraction after one gain_sweep run appeared
        to work). Chased this down further: a controller reflash (same
        firmware, forcing a clean MCU boot) did NOT fix it -- fresh
        boot, first-ever PFM_Input use, still `firstRise=0`. Went to
        the raw register level (PFMIN:DEBUG:REG?, the same temporary
        diagnostic built for the 2026-09-15 fiber-patching incident --
        see pfm-input-feedback-gap memory): CR1=1 (timer genuinely
        counting, CNT visibly incrementing between polls), CCER/DIER/
        CCMR1/MODER/AFR all correct and healthy -- but IDR (the pin's
        RAW logic level, sampled directly, no software involved at all)
        is FROZEN across 10 rapid back-to-back reads during an active
        shot, while the SIMULATOR's own SIM:CHANnel:STATus? simultaneously
        confirms it IS genuinely transmitting a real, live, changing
        ~40kHz signal (DRIVE_HZ received correctly, FEEDBACK_HZ tracking
        and varying poll to poll). This is airtight, hardware-level
        proof the controller's capture peripheral/DMA/software are all
        completely healthy -- the electrical/optical signal simply never
        arrives at the pin. Widened the check to all 6 physical
        PFM_Input ports (not just channel 1's expected port) -- NONE
        show any toggling at all (unlike the 2026-09-15 incident, where
        a misrouted signal at least showed up on a WRONG port; this
        time nothing arrives anywhere).

        Root cause: almost certainly a physical fiber-patching/
        connection problem on the CONTROLLER's own FEEDBACK receive
        side (the 4 DRIVE<->FEEDBACK transceiver pairs specifically --
        NOT the GPOut/GateDriverStatus fault-injection fiber pool the
        user already visually confirmed lit via SIM:DIAGnostic:IDLETONE
        earlier today, a physically separate transceiver group).
        Plausible explanation: last Friday's session had the user
        physically rewire the controller's own DRIVE directly into its
        own FEEDBACK for a self-loopback test, bypassing the simulator
        entirely -- those 4 FEEDBACK fibers on the controller may never
        have been reconnected back to the simulator's DRIVE outputs when
        the boards were reconnected this morning. Flagged directly to
        the user for physical inspection -- not something further
        firmware/software diagnosis can resolve; see this project's own
        established fingerprinting technique in pfm-input-feedback-gap
        memory if a re-patch is needed (drive distinct frequencies per
        channel, check PFMIN:DEBUG:RAW?/REG? on all 6 ports to find
        which physical port each channel's real signal actually lands
        on).

2026-09-21  —  New finding, physical not firmware: simulator->controller
               FEEDBACK fiber path reads 0 on the controller across ALL 4
               channels, even though the simulator genuinely transmits a
               real, correct signal
-----------------------------------------------------------------------
  Change:  NOT a firmware change -- found starting the new closed-loop
        gain_sweep test scenario (python/run_simulator_validation.py):
        all 3 gains (Kp=0.2/0.5/1.0) FAILED, controller's own measured_hz
        staying at exactly 0 for the entire 4s shot on channel 1. Isolated
        live: gated ch1, commanded a fixed 40 kHz open-loop DRIVE.
        SIM:CHANnel:STATus? 1 showed the simulator receiving it correctly
        (DRIVE_HZ~40000) AND generating a real, correct FEEDBACK_HZ
        (~40000) in response -- the simulator side of the loop is
        confirmed working. But PID:STATus? 1 on the CONTROLLER read
        measured=0 the entire time, meaning nothing was arriving on the
        controller's own XR1_FEEDBACK input. Repeated for channels 2/3/4
        -- SAME result on every channel (simulator transmits correctly,
        controller measures exactly 0). Systemic across all 4 channels
        rules out a single loose connector; this is almost certainly the
        physical simulator->controller FEEDBACK fiber bundle not
        currently connected (or connected wrong) -- plausibly because
        the 2026-09-18 session's controller self-loopback test (wiring
        the controller's own DRIVE directly into its own FEEDBACK,
        bypassing the simulator entirely, to work around this exact
        symptom) never got its cabling restored to the normal simulator
        configuration afterward. NOT a firmware issue: the capture path
        itself (PfmInput_ConsumeAveragePeriod()/pid.c's measured field)
        is independently proven working by that same self-loopback test
        (closed-loop-confirmed-via-direct-loopback memory) and by
        today's own baseline test (controller->simulator DRIVE direction
        works correctly through the real fiber). Only the RETURN
        direction (simulator->controller FEEDBACK) is currently dark.
        Needs physical inspection/reconnection of the XR1-4_FEEDBACK
        fiber bundle on the controller before any closed-loop-through-
        the-simulator test can produce a real result -- flagged to the
        user directly rather than guessed at further from software.

2026-09-21  —  Root cause found for the fiber-transmitter mystery: simulator
               board was running stale firmware (ae2ecd1), predating
               sim_transrex.c entirely -- reflashed to latest (d74b065)
-----------------------------------------------------------------------
  Change:  NOT a source change -- a deployment gap. Re-identified both
        boards via *IDN? after reconnecting for the day: controller was
        on d74b0653-dirty (correct, matches the 2026-09-18 end-of-day
        state), but the SIMULATOR was on ae2ecd1e-dirty -- one commit
        BEHIND d74b065, which is the exact commit that added
        sim_transrex.c/.h (SimTransrex_Init()/Update(), the ENA_OUT/
        CONTACT_OUT gating, DRIVE capture -> filter -> FEEDBACK
        generation, and the default-healthy fault-transmitter levels)
        in the first place. The simulator board had never once run any
        of that logic -- every "simulator" test all last week (the
        fiber-transmitter light mystery, the fault-injection scenarios,
        the 8-scenario + 45-shot matrix validation campaign) was
        actually exercising ae2ecd1's firmware, which has no
        SimTransrex_Init()/Update() call sites at all and does not
        drive GPOut_01-12/GateDriverStatus-position pins to any of the
        roles sim_transrex.c assumes.

        This plausibly explains the entire unresolved fiber-transmitter
        saga (see fiber-transmitter-debugging-saga.md memory): a board
        with no simulator logic running would not reliably light its
        DRIVE transmitter, would not gate on ENA_OUT/CONTACT_OUT
        correctly, and would not produce any FEEDBACK signal -- matching
        the observed flat-zero feedback and inconsistent light behavior
        without needing any firmware-bug or wiring explanation. NOT
        confirmed as the sole cause (the saga's own timeline still shows
        some light-state changes correlated with physical/DSLogic
        rewiring, which this finding doesn't explain), but it is a real,
        previously-unknown gap and the most likely single largest
        contributor.

        Fixed: rebuilt --target simulator from a clean, HEAD-matching
        source tree (d74b065, no local Core/ changes), flashed to
        /dev/cu.usbserial-1120, confirmed via *IDN? ->
        WHAM-XREX-PFMG474-SIM REVA v0.1 d74b0653-dirty. Simulator-target
        flashes need no special confirmation per this project's standing
        rule (only controller flashes do).

        CONFIRMED LIVE immediately after reflashing: with all 4 channels
        ungated, SIM:CHANnel:STATus? read ENA_OUT=LOW/CONTACT_OUT=LOW on
        every channel, no faults, FEEDBACK_HZ floored at 5000 (0A) -- the
        correct idle default. Driving XREX:CHANnel:ENAOut 2 1 +
        CONTactOut 2 1 on the controller (channel 2 ONLY) gated channel 2
        alone on the simulator (ENA_OUT=HIGH CONTACT_OUT=HIGH) while
        channels 1/3/4 stayed fully ungated -- confirms the per-channel
        independent ENA_OUT+CONTACT_OUT gating matches the intended
        design exactly (direct user description, 2026-09-21: "They can
        only output when that channel receives both the contact and the
        enable signal," independently per channel). Then firing a real
        open-loop shot on channel 2 (PID:CHANnel:ENAble 2 1,
        PID:LOOPMODE 2 0, PID:PROFile:CURRent 2 3000A) produced a live,
        real DRIVE_HZ on the simulator tracking the controller's actual
        commanded frequency, with FEEDBACK_HZ following it near-
        instantly (low-pass filtered, both within ~10 Hz of each other
        at every poll) -- the DRIVE-capture -> filter -> FEEDBACK-
        generation path genuinely works end to end through the real
        fiber pair, not just via the direct controller self-loopback
        used last week. Both boards returned to clean safe state
        afterward.

2026-09-21  —  Fixed: a freshly-gated channel with no real DRIVE signal
               yet decayed FEEDBACK_HZ to 0, not the healthy "0A" floor
               (5000 Hz)
-----------------------------------------------------------------------
  Change:  FIXED, same session -- found during the live gating re-verification
        above. SimTransrex_Init() sets s_lastMeasuredHz[ch]=0 for every
        channel (sim_transrex.c), and the ungated branch of
        SimTransrex_Update() also resets s_lastMeasuredHz[ch]=0 every
        tick (line ~243) -- both intentional for DRIVE_HZ reporting
        (0 Hz measured is correct/expected while ungated, nothing is
        being driven). But when a channel then GATES ON before any real
        DRIVE edge has been captured, SimTransrex_Update()'s gated
        branch holds `targetHz = (float)s_lastMeasuredHz[ch]`, which is
        still that stale 0 -- so the low-pass filter chases 0 Hz, not
        PFM_TURNON_FREQ_HZ (5000 Hz = 0A, the value a real healthy
        Transrex should read back before current actually flows).
        Reproduced live: gated channel 2 on with the controller not yet
        driving anything, watched SIM:CHANnel:STATus? -- FEEDBACK_HZ
        went from 5000 straight to 0 within about 1 filter time-constant
        and stayed there. The ACTUAL driven HRTIM output is still
        clamped to >= PID_OUTPUT_MIN_HZ (3000 Hz) by the existing clamp
        block, so this isn't a div-by-zero risk, but 3000 Hz is itself
        below the true 0A floor (5000 Hz) -- both the reported status
        and the real transmitted signal are wrong/misleading for this
        specific window (gated, pre-first-DRIVE-edge).

        Fix applied: new per-channel s_haveMeasuredSinceGate[] flag
        (sim_transrex.c), cleared on every ungated->gated edge, set the
        first time a real PfmInput sample lands under that gating
        window. While gated but not yet set, the filter's target is
        PFM_TURNON_FREQ_HZ (the healthy 0A floor) instead of
        s_lastMeasuredHz[ch]'s stale 0 -- consistent with the ungated
        branch's own already-existing "floor toward PFM_TURNON_FREQ_HZ"
        behavior (sim_transrex.h's own SimTransrex_Update() doc
        comment). Rebuilt --target simulator, reflashed (no confirmation
        needed, simulator-only), reverified live: gated channel 2 with
        zero real DRIVE signal, FEEDBACK_HZ now holds steady at 5000
        (0A) instead of decaying to 0.

2026-09-18  —  Test methodology finding: matrix sweep's start_profile_shot()
               never set loop mode, channel 4 silently ran closed-loop
               with zero gains and stuck at the output floor
-----------------------------------------------------------------------
  Change:  NOT a firmware change -- found by the new 45-shot channel-
        combination x demand-level stress matrix (python/
        run_simulator_validation.py --matrix, direct request: "every
        combination of channels... up to and including differing
        demand values"): every one of the 15 non-empty channel
        combinations was run at 3 demand levels (600/3000/5400 A). The
        first pass showed a striking, 100% consistent pattern: EVERY
        combination including channel 4 failed, output stuck EXACTLY at
        PID_OUTPUT_MIN_HZ (3000 Hz) regardless of demand (error =
        demand_hz - 3000, exactly, at all three demand levels); every
        combination without channel 4 tracked perfectly (0 Hz error).

        Root cause, confirmed live: PID:LOOPMODE? 1 -> OK 0 (open-loop),
        PID:LOOPMODE? 4 -> OK 1 (closed-loop) -- start_profile_shot()
        (the shared helper added earlier today for the fault-injection
        scenarios) never explicitly sets loop mode at all. Channels 1-3
        only happened to be open-loop because EARLIER scenarios in this
        same file had explicitly set `PID:LOOPMODE {c} 0` on them,
        state that persists on the controller across scenario runs.
        Channel 4, never touched by anything before the matrix sweep,
        was still at its PID_Init()-time boot default (closed-loop),
        with PID gains also still at that same safe-inert default
        (PID:GAINS? 4 -> OK 0 0 0, Kp=Ki=Kd=0, never set by any script)
        -- closed-loop control with zero gains computes zero corrective
        action every tick, so the output never moves off wherever it
        started. Not a real issue with channel 4's own hardware/fiber
        wiring (XREX:CHANnel:STATus? 4 showed all 4 fault pins HIGH/
        healthy) -- purely a test-script gap: implicitly relying on
        state left over from a different test instead of setting it
        explicitly, the same class of bug as the PID:LOG decimation
        fix earlier today.

        Fixed: start_profile_shot() now explicitly sends
        `PID:LOOPMODE {c} 0` for every channel it's about to shoot,
        before PID:PROFile:CURRent/STARt -- fixes every caller at once
        (full_profiled_shot, all the fault-injection scenarios,
        ena_contact, multi_fault, and the matrix sweep), and makes every
        scenario in this file correctly self-contained instead of
        depending on what a previous scenario happened to leave
        configured.

  Verify: Re-ran the full 45-shot matrix after the fix: 45/45 PASSED,
        every one of the 15 channel combinations at all 3 demand levels
        (600/3000/5400 A) tracking with EXACTLY 0 Hz output error
        (docs/simulator_channel_matrix_report.tex/.pdf, 14 pages,
        includes the all-4-channels representative plots at each demand
        level). Confirms open-loop tracking is correct across the
        entire channel/demand combinatorial space -- the earlier 21/45
        pass rate was entirely explained by this test-script bug, not
        by any real per-channel firmware or hardware difference.

2026-09-18  —  Test methodology finding: PID:START never reaches
               SM_STATE_FIRING -- fault-injection tests need
               PID:PROFile:STARt, not PID:START
-----------------------------------------------------------------------
  Change:  NOT a firmware change -- a real gap in how
        python/run_simulator_validation.py's fault-injection scenarios
        (OCP/Enerpro/Water-Temp/ENA_OUT-CONTACT_OUT/multi-fault) were
        driving the controller, found while debugging why the
        multi-fault scenario's survivor channel reported
        PID:STATus?'s isRunning=0 almost immediately (~150ms) after the
        first fault -- far too fast to be a completed 1-second ramp-
        down.

        Root cause: those scenarios used PID:START (plain, non-profile
        closed-loop start) to begin their open-loop test shots.
        PID:START is explicitly documented (docs/command_reference.md's
        own "Known gap") as NOT gated by the state machine and NOT
        moving it out of IDLE/ARMED -- only PID:PROFile:STARt calls
        SM_Fire() to reach SM_STATE_FIRING. HandleOvercurrentFault()
        (state_machine.c) branches on exactly this: `if
        (g_stateBeforeFault == SM_STATE_FIRING)` decides between the
        real graceful per-channel derate-and-ramp path
        (PID_BeginOvercurrentRampDown()) and an immediate, unconditional
        full PID_Stop() otherwise. Every fault-injection scenario run
        earlier today was silently taking the immediate-full-stop
        branch -- the STATE?/fault-TYPE assertions still happened to
        pass (those don't depend on which branch ran), but the
        survivor-derate behavior these tests exist to verify was never
        actually exercised.

        Fixed: added start_profile_shot() (PID:PROFile:TIMing/CURRent/
        STARt) to run_simulator_validation.py and switched every fault-
        injection scenario to use it instead of PID:START/PID:SETPOINT.
        Also tightened the multi-fault scenario's own assertions: an
        earlier attempt asserted an exact "(1-1/n) telescoped to 1/3 of
        original setpoint" target that was itself wrong (each fault's
        derate applies to the survivor's CURRENT, already-ramping
        output, not the original setpoint -- real ramp progress happens
        in the time between two sequential faults) -- replaced with a
        directionally-correct check (survivor still running, visibly
        below its steady-state output) instead of a fragile exact
        number.

  Verify: Re-ran all 5 affected scenarios against the real, reflashed
        controller -- all now PASS with genuinely meaningful survivor
        data: ocp/enerpro/ena_contact all show the survivor mid-ramp
        around 21700-21800 Hz (well below its ~52500 Hz steady-state for
        a 3000A demand); multi_fault's survivor visibly dropped further
        between the two sequential faults (30139 Hz -> 25069 Hz),
        confirming the second fault's derate genuinely compounded on the
        first. docs/simulator_validation_report.tex/.pdf regenerated
        (8/8 Part C scenarios now pass, external-trigger regression
        confirmed working once PF15 was physically wired to GPOut12).

2026-09-18  —  REAL BUG FIX: SM_GetFaultChannel() returned 0xFF (STATE?
               reported channel "256") for SM_FAULT_ENABLE_OUTPUT
-----------------------------------------------------------------------
  Change:  Found via run_simulator_validation.py's ena_contact scenario
        (first real end-to-end exercise of a live SM_FAULT_ENABLE_OUTPUT
        fault's STATE? output against real per-channel data -- the
        earlier ARM-refusal precondition check had been verified, but
        not this): dropping XREX:CHANnel:CONTactOut on an armed,
        running channel correctly entered SM_FAULT_ENABLE_OUTPUT, but
        STATE? reported "OK FAULT ENABLE_OUTPUT 256" instead of a real
        1-4 channel number, reproduced consistently.

        Root cause: SM_GetFaultChannel() (state_machine.c) only ever
        returned the real g_faultChannel when SM_GetFaultType() ==
        SM_FAULT_OVERCURRENT -- unconditionally 0xFF for every other
        type. This was correct when the function was first written
        (2026-09-15, OCP was the only per-channel fault type), but was
        never widened when SM_FAULT_ENABLE_OUTPUT was added
        (2026-09-17) even though that fault type's own STATE? branch
        (commands.c, same day) has always called this same getter
        expecting a real channel -- 0xFF+1=256 is exactly what got
        printed. Nothing had exercised this specific path against real
        per-channel data until the simulator provided a clean, non-
        floating-pin bench to test it on.

        Fixed: SM_GetFaultChannel() now also returns the real channel
        for SM_FAULT_ENABLE_OUTPUT and the same-day-added
        SM_FAULT_ENERPRO (both per-channel types, same as OVERCURRENT).
        Doc comments updated in both state_machine.h and .c (the "0xFF
        sentinel" framing, EnterFault()'s own comment) to describe all
        three per-channel types instead of just OVERCURRENT.

  Verify: Rebuilt clean for BOTH targets (controller +16 bytes, 90196;
        simulator 95192). Reflashed the SIMULATOR. NOT yet re-verified
        against a live ena_contact re-run -- that scenario's fault path
        (XrexIo_PollEnableOutputFaults() reading the CONTROLLER's own
        local ENA_OUT/CONTACT_OUT output pins) is entirely on the
        CONTROLLER side, so confirming the fix needs the controller
        reflashed too -- pending explicit go-ahead, per the standing
        rule (same flash this session is already waiting on for the
        Enerpro reclassification, below).

2026-09-18  —  SIM:LOG/SIM:LOGDATA? added -- onboard waveform logging
               for the simulator, replacing host-side polling
-----------------------------------------------------------------------
  Change:  Direct correction: python/run_simulator_validation.py
        originally captured the simulator's DRIVE_HZ/FEEDBACK_HZ during
        a shot by polling SIM:CHANnel:STATus? at a fixed host-side
        interval (~10 samples/sec) -- coarse, and adds serial round-
        trip jitter to the very waveform being measured. User asked for
        the same "arm a log, run the shot, retrieve and plot
        afterward" pattern already established for the CONTROLLER side
        (pid.h's PID_ArmLog()/PID:LOGDATA?, used throughout this
        project's own bench sessions) instead.

        New sim_transrex.c waveform log: SimTransrex_ArmLog(channel,
        maxSamples, minIntervalMs)/GetLogCount()/GetLogSample() --
        SimTransrex_Update() itself appends a sample every real
        main-loop tick (no host polling at all), throttled by
        `minIntervalMs` rather than PID_ArmLog()'s tick-count decim
        (SimTransrex_Update() runs off the main loop, not a fixed
        hardware tick like PID_Update()'s HRTIM-driven 1kHz interrupt,
        so there's no fixed rate to decimate against) -- each sample
        instead carries its OWN elapsed-ms-since-armed timestamp.
        Single-channel-at-a-time, matching PID_ArmLog()'s own simpler
        (non-"All") shape. SIM_LOG_MAX_SAMPLES=1000 (sim_transrex.h) --
        an initial 2000 overflowed this MCU's RAM by 7200 bytes on a
        simulator build (on top of pid.c's own 48000-byte log arrays,
        pfm.c's 40000-byte table, everything else already resident),
        reduced to 1000 (matching PID_LOG_MAX_SAMPLES's own value),
        confirmed to link clean.

        New SIM:LOG <ch> <maxSamples> <minIntervalMs>/SIM:LOGDATA? <ch>
        commands (commands.c/.h, cmd_parser.c), same
        BUILD_TARGET_SIMULATOR-only guard as the rest of the SIM:
        namespace, same streaming-reply pattern as PID:LOGDATA?
        (cmd_pid_logdata()) to avoid needing one giant buffer.

        python/run_simulator_validation.py rewritten to arm both
        boards' logs (controller: PID:LOG, simulator: the new SIM:LOG)
        immediately before each scenario's shot and retrieve+plot both
        afterward, replacing every poll_sim_status() call site.

  Verify: Rebuilt clean for BOTH targets after fixing one syntax error
        (a doc comment containing a literal "XREX:CHANnel:*/PID:*"
        prematurely closed the enclosing /* */ block -- caught by the
        compiler, not silently wrong) and the RAM-overflow-driven size
        reduction above. Controller: 90180 bytes, byte-identical to the
        previous entry -- confirms this whole feature is simulator-only,
        zero controller footprint. Simulator: 95168 bytes. Reflashed
        the simulator, smoke-tested directly over serial (SIM:LOG 1 100
        10 -> SIM:LOGDATA? 1 correctly returned exactly 100 samples,
        10ms apart, driveHz=0/feedbackHz=5000 throughout -- an ungated
        channel, matching expectations). Then re-ran the baseline
        closed-loop scenario end-to-end through the rewritten
        orchestration script: 859 simulator samples + 1000 controller
        samples over a 3-second shot (vs. 29 samples with the old
        polling approach) -- both plotted cleanly, scenario still
        PASSED (final DRIVE_HZ=19992, target 20000).

2026-09-18  —  Enerpro fault reclassified out of General Fault
               (SM_FAULT_ENERPRO), PFM_MAX_CURRENT_A_PER_CHANNEL
               updated 5kA -> 6kA
-----------------------------------------------------------------------
  Change:  User pointed at docs/Transrex/Transrex_Controls_Upgrade
        (1).pdf (the original 2026-07-10 system upgrade plan) as
        authoritative context while reviewing the Transrex simulator
        work. Its own fault table gives Enerpro faults the SAME
        response as Overcurrent (reduce surviving channels' DEMAND by
        25% x fault count, keep running) -- distinct from Water/Temp's
        full system stop. The firmware had all three (Water+Temp+
        Enerpro) routed to one SM_FAULT_GENERAL full-stop path, per an
        earlier direct instruction predating this document
        ("Water, Temperature, and Enerpro faults are considered
        general faults," 2026-09-17). Confirmed directly, 2026-09-18:
        reclassify Enerpro like OCP; Water+Temp unchanged.

        New SM_FAULT_ENERPRO fault type (state_machine.h), grouped with
        SM_FAULT_OVERCURRENT/SM_FAULT_ENABLE_OUTPUT in EnterFault()'s
        switch (state_machine.c) -- reuses HandleOvercurrentFault(channel)
        unchanged. New SM_ReportEnerproFault(channel), exact mirror of
        SM_ReportOcpFault()/SM_ReportEnableOutputFault()'s critical-
        section-protected shape.

        xrex_io.c: XrexIo_EvaluateGateDriverFault() no longer checks
        Enerpro's bit (Water+Temp only now). New
        XrexIo_PollEnerproFaults(uint16_t raw12) -- per-channel gated
        check of just the Enerpro bit, calling
        SM_ReportEnerproFault(channel) directly (matching
        XrexIo_PollOcpFaults()'s "evaluate and report" shape, not
        Water+Temp's "evaluate, let the caller latch/stop" shape --
        Enerpro's real response has no single shared "the fault" to
        hand back, each channel's is independent). gate_driver.c:
        GateDriver_CheckFault() now calls XrexIo_PollEnerproFaults() on
        every EXTI edge, on the SAME raw GateDriver_Read() already used
        for the (now Water+Temp-only) general-fault check -- no
        redundant GPIO read. commands.c: STATE? gained an `ENERPRO <ch>`
        branch alongside the existing OVERCURRENT/ENABLE_OUTPUT ones,
        same shape.

        Separately, same review: PFM_MAX_CURRENT_A_PER_CHANNEL
        (ctrlr_config.h) updated from the original 5000.0f placeholder
        (matching the document's own "5kA output LEMs" spec) to
        6000.0f -- confirmed directly: the REAL installed LEMs are 6kA,
        not 5kA. Still a shared default across all 4 channels, still
        flagged "MUST BE CALIBRATED BEFORE FINAL DEPLOYMENT" pending
        real per-channel measurement -- this is a better shared
        placeholder, not a measurement. PFM_TURNON_FREQ_HZ (5000 Hz =
        0 A) was checked against the same document and found already
        correct -- no change there.

  Verify: Rebuilt clean for BOTH targets (zero warnings either way).
        Controller: 90180 bytes (+200 from the previous entry -- this
        is real shared fault-routing logic, unlike the simulator-only
        sim_transrex.c work below, which the controller build strips
        entirely). Simulator: 93936 bytes. Reflashed the simulator over
        the serial bootloader, confirmed *IDN? unchanged.

        NOT yet verified end-to-end (needs the controller reflashed too
        -- SIM:FAULT:ENERPRO only drives a transmit pin, it does not
        loop back into the simulator's own fault detection, so this
        genuinely needs the controller's own receiving logic running
        the new code to test for real): inject SIM:FAULT:ENERPRO on one
        channel while 2+ channels are running, confirm STATE? reports
        ENERPRO (not GENERAL), the faulted channel hard-disables, and
        survivors derate by (1 - 1/n) rather than a full stop; separate
        regression check that SIM:FAULT:WATERTEMP still produces a full
        stop. Controller not flashed yet -- pending explicit go-ahead,
        per the standing rule.

2026-09-18  —  sim_transrex.c/.h added: the Transrex simulator's actual
               closed-loop logic (DRIVE capture -> filter -> FEEDBACK,
               ENA_OUT/CONTACT_OUT gating, SIM:FAULT:/SIM:MODEL:/
               SIM:CHANnel:STATus? commands)
-----------------------------------------------------------------------
  Change:  First cut of Phases 1-5 from the approved simulator plan
        (/Users/everettpenne/.claude/plans/cuddly-nibbling-octopus.md),
        started while the physical fiber connectivity work (this same
        day's DIAGnostic:GPOut09/10 entry, below) was being wired up on
        the bench. Everything up to this point was raw pin
        connectivity -- this is what makes the simulator actually
        BEHAVE like a Transrex.

        SIMULATOR-ONLY module (BUILD_TARGET_SIMULATOR), new
        sim_transrex.c/.h:
          - Reuses pfm_input.c's existing continuous-capture mode
            (PfmInput_StartContinuous()/ConsumeAveragePeriod()),
            unchanged, on PFM_Input_01..04 to measure the controller's
            real commanded XRn_DRIVE frequency.
          - Single-pole low-pass filter (alpha = dt/(tau+dt), default
            tau=100ms, SIM:MODEL:TAU) applied directly in Hz -- no
            Amps-domain round-trip needed since AmpsToHz() (pid.c) is
            linear, per the plan's own documented assumption.
          - Writes the filtered result out via this board's own
            XRn_DRIVE HRTIM channels (HRTIM1_SetChannelPeriod(), same
            primitive pid.c uses), which the controller receives as its
            own XRn_FEEDBACK. Started UNCONDITIONALLY at boot
            (HRTIM1_PWM_Start() + per-channel output-enable), not tied
            to this board's own ARM/FIRE state -- a real Transrex
            responds because it's connected and enabled, not because it
            ran its own internal "shot."
          - Gated per channel on ENA_OUT+CONTACT_OUT both asserted,
            read from the controller via GateDriver_Read() (PE0..PE7)
            -- NOT XrexIo_Get*Output() (PG0..PG7), which are this
            board's OWN transmit pins for a different purpose (see
            below). Gated off: floors output to PFM_TURNON_FREQ_HZ
            (0A) rather than holding the last value -- decided per the
            plan's own flagged open question #2, on the reasoning that
            a real disconnected Transrex stops responding, it doesn't
            keep echoing.
          - Per-channel/per-category fault injection (Water+Temp
            combined -- SimTransrex_SetFaultWaterTemp(), one shared
            fiber+splitter per the finalized wiring; Enerpro; OCP),
            reusing XrexIo_SetEnableOutput()/SetContactorOutput() for
            Water+Temp/Enerpro (same physical PG0-7 pins XREX:CHANnel:
            ENAOut/CONTactOut already drive) and a small direct
            HAL_GPIO_WritePin() pair for OCP (PG8/PG9/PD0/PD1, no
            existing xrex_io.c setter for those). Default HEALTHY
            (HIGH, FAULT_POLARITY_NORMALLY_HIGH) at boot -- a
            DELIBERATE exception to this project's usual "every new
            output defaults LOW" convention, per the confirmed "default
            healthy" scope decision: the whole point of this module is
            to NOT present the floating/LOW-reads-as-fault state a
            disconnected real Transrex's pins show on the bench today.

        New SIM: command namespace (commands.c/.h, cmd_parser.c),
        guarded out of a controller build entirely (declarations,
        definitions, AND registration all share the same
        BUILD_TARGET_SIMULATOR guard -- there's no "simulated Transrex"
        concept on the real controller for this namespace to mean
        anything about): SIM:FAULT:WATERTEMP/ENERPRO/OCP <ch> <0|1>/?,
        SIM:MODEL:TAU <ms>/?, SIM:CHANnel:STATus? <ch> (DRIVE_HZ/
        FEEDBACK_HZ/ENA_OUT/CONTACT_OUT/the three fault states in one
        snapshot).

        main.c: SimTransrex_Init() called once at boot (after
        HRTIM1_FullInit()/PfmInput_Init(), both unconditional);
        SimTransrex_Update() called every main-loop iteration
        (alongside SM_PollFaults()/XrexIo_PollOcpFaults()) -- NOT from
        PID_Update(), which only ticks while THIS board's own HRTIM
        Master is running (i.e. only during a FIRE on this board,
        irrelevant here). New source file -- added to Debug/Core/Src/
        subdir.mk and Debug/objects.list by hand, same known gotcha as
        every prior new .c file this project (AGENTS.md).

        *** KNOWN LIMITATION, flagged directly in sim_transrex.h's own
        header comment: this build still runs the FULL controller
        firmware unconditionally, including its own state_machine.c/
        pid.c/gate_driver.c, all still watching the exact same PE0..PE7
        pins this module repurposes as ENA_OUT/CONTACT_OUT gating input
        (those pins are ALSO the simulator's own, unmodified XR1..4
        Water/Temp fault-detection inputs under gate_driver.c). Harmless
        as long as the simulator's own PID channels are never
        PID:CHANnel:ENAble'd on (gate_driver.c's fault evaluation is
        gated per-channel-enabled) -- differentiating main.c's own
        state-machine/PID polling to be controller-only, so this caveat
        goes away entirely, is a follow-up, not done here.

  Verify: Rebuilt clean for BOTH targets (zero warnings either way).
        Controller build: 89980 bytes, byte-identical to before this
        change -- confirms the new module and every SIM: command are
        fully stripped by --gc-sections on that target, zero footprint
        impact. Simulator build: 93712 bytes. Reflashed the simulator
        over the serial bootloader, confirmed live: *IDN? unchanged;
        SIM:MODEL:TAU?/TAU roundtrip (100 default, set/verified 250,
        reset back to 100); SIM:CHANnel:STATus? 1 returned
        `DRIVE_HZ=0 FEEDBACK_HZ=5000 ENA_OUT=LOW CONTACT_OUT=LOW
        WATERTEMP_FAULT=0 ENERPRO_FAULT=0 OCP_FAULT=0` -- correct
        gated-off floor behavior (no fibers driving ENA_OUT/CONTACT_OUT
        at test time) and correct default-healthy fault state;
        SIM:FAULT:OCP 1 1 -> re-query showed OCP_FAULT=1, then 1 0 ->
        back to 0 -- fault injection round-trips correctly.

        NOT yet verified: the actual closed-loop behavior with fibers
        connected and the controller actively driving/gated on (Phases
        1-3's real point) -- pending the physical fiber reconnection
        this same session's bench work was doing concurrently. Not
        committed to git yet.

2026-09-18  —  DIAGnostic:GPOut09/GPOut10 added (PG8/PG9), completing
               Transrex simulator OCP fiber-transmitter coverage
-----------------------------------------------------------------------
  Change:  During the Transrex simulator's first fiber connectivity
        test (see docs/pin_mapping_reference.tex Section 7), only 2 of
        4 OCP channels (XR3/XR4, via the already-existing
        DIAGnostic:GPOut11/GPOut12 on PD0/PD1) were testable -- the
        simulator had no GPIO config or command for GPOut_09/GPOut_10
        (intended to feed XR1_OCP/XR2_OCP), so those two links were
        reported UNTESTABLE. Direct follow-up request: "configure
        GPOut_09, _10 for good measure."

        Verified against docs/pin_mapping_v4.csv before touching
        anything: GPOut_09 = PG8, GPOut_10 = PG9 in the V4 column
        (confirmed GPO, no XREX pin name assigned -- these are generic
        available transmitters, not tied to a fault signal by the
        hardware itself). Note the V3 column for these same two rows
        says "No connection" -- a DIFFERENT pair of pins, PD8/PD9,
        carried the "GPOut_09"/"GPOut_10" names under V3 -- checked
        directly to avoid repeating the earlier PC14-vs-PF15/PF13-vs-
        PD1 V3/V4 name-reuse mistakes.

        main.c: new push-pull output block, PG8|PG9, driven LOW BEFORE
        HAL_GPIO_Init() enables them -- same "never glitch HIGH on
        boot" convention as every other diagnostic output in this file.
        New DIAGnostic:GPOut09/GPOut09?/GPOut10/GPOut10? commands
        (commands.c/.h, cmd_parser.c), exact mirrors of
        DIAGnostic:GPOut11/GPOut12 -- plain HAL_GPIO_WritePin()/
        ReadPin() pairs, no dedicated module.

        Not target-gated (BUILD_TARGET_CONTROLLER/SIMULATOR) -- like
        every other DIAGnostic:GPOut command, present identically on
        both boards, matching this project's existing precedent.

  Verify: Rebuilt clean for --target simulator (zero warnings), 89980
        bytes. Reflashed the simulator over the serial bootloader
        (wham_serial_flash.py --target simulator). Confirmed live over
        serial: *IDN? unchanged (WHAM-XREX-PFMG474-SIM); both pins read
        0 immediately after reflash (confirming LOW default); both set
        HIGH and read back 1 via DIAGnostic:GPOut09/GPOut10; both
        returned to a safe LOW state afterward. Not yet re-run through
        the full fiber connectivity test end-to-end against the
        controller's GPInput_03/GPInput_07 (XR1/XR2 OCP) -- pending
        physical fiber connection to these two newly-testable
        transmitters.

        Controller NOT touched -- this is a simulator-only change for
        now; the equivalent GPIO/command code is identical and will
        take effect on the controller's own next build+flash, per the
        standing "always ask before flashing the controller" rule.

2026-09-17  —  PC13 (GPOut_Enable_Pin) and PC15 (PWM_Alt_Enable) added,
               default HIGH, with serial toggle commands
-----------------------------------------------------------------------
  Change:  Direct request: "Assign PC13 as GPOut_Enable_Pin. By
        default, keep it HIGH... a serial command to toggle it HIGH
        and LOW. Similarly, PWM_Alt_Enable_Pin is PC15... default
        output HIGH... a serial command to toggle it HIGH and LOW."
        Both confirmed against docs/pin_mapping_v4.csv before touching
        anything (documented GPO, unused elsewhere): PC13 =
        "GPOut_Enable_Pin", PC15 = "PWM_Alt_Enable".

        main.c: push-pull outputs, driven HIGH BEFORE HAL_GPIO_Init()
        enables them -- the opposite default of every other software-
        driven output added this session (DIAGnostic:GPOut11/12,
        XRn_ENA_OUT/CONTACT_OUT, all deliberately LOW by default), per
        this specific instruction. New GPOut:ENAble/GPOut:ENAble? (PC13)
        and PWMAlt:ENAble/PWMAlt:ENAble? (PC15) commands (commands.c/.h,
        cmd_parser.c) -- own top-level namespaces (not nested under
        DIAGnostic:) since these are real, specifically-named board
        signals from the schematic, not generic scratch diagnostic
        pins; otherwise a plain HAL_GPIO_WritePin()/ReadPin() pair, no
        dedicated module, matching DIAGnostic:GPOut11/12's own
        precedent.

  Verify: Rebuilt clean (zero warnings), reflashed, verified live over
        serial: both pins read HIGH (1) immediately after a fresh
        reflash, confirming the default; both toggle correctly in both
        directions via their own commands. Board left in a clean IDLE
        state afterward.

2026-09-17  —  XRn_ENA_OUT/XRn_CONTACT_OUT (PG0-PG7) implemented --
               ARM precondition + new per-channel SM_FAULT_ENABLE_OUTPUT
-----------------------------------------------------------------------
  Change:  Direct request, fulfilling the "remind me later" obligation
        from earlier the same day: "Enable and contactor fiber outputs
        need to be set by a serial command, one for each supply. The
        controller cannot be armed unless these are outputting prior
        to the arm signal, and similarly we cannot transition to the
        ARM state i[f] these are not output."

        Two scope questions asked directly before implementing (not
        assumed): (1) should the ARM check apply to all 4 channels or
        only currently-enabled ones -- chose per-channel gating,
        matching the established Water/Temp/Enerpro/OCP convention;
        (2) should losing these after ARM force a fault or just be a
        one-time precondition -- chose continuous monitoring with a
        real fault response, entering FAULT (not just refusing the
        next FIRE) if lost while ARMED or FIRING.

        New per-channel outputs XR1-4_ENA_OUT (PG0-PG3) and
        XR1-4_CONTACT_OUT (PG4-PG7, docs/pin_mapping_v4.csv's "XREX Pin
        Name" column, confirmed GPO, unused elsewhere) -- owned (pin
        table, GPIO read/write) by xrex_io.c, matching that module's
        established per-channel-XR-signal charter. New
        XREX:CHANnel:ENAOut/CONTactOut set+query commands (reuses ERR
        11/ERR 12, no new error codes).

        New per-channel fault type SM_FAULT_ENABLE_OUTPUT
        (state_machine.h/.c) -- reuses HandleOvercurrentFault(channel)
        DIRECTLY for its response (immediate hard-disable of the
        affected channel, survivors derated 1/N and ramped down exactly
        like a real OCP fault), same "distinct type, shared response"
        pattern SM_FAULT_EXTERNAL_ENABLE already established for
        HandleGeneralFault(). Do NOT confuse the name with
        SM_FAULT_EXTERNAL_ENABLE -- that's a single system-wide INPUT
        interlock (PF13); this is a per-channel check of this
        firmware's own commanded OUTPUT state. New
        XrexIo_EnableOutputsReadyToArm() (pure check, folds into
        ArmConditionsMet()/ERR 13) and XrexIo_PollEnableOutputFaults()
        (continuous check, gated to ONLY run while ARMED/FIRING --
        unlike Water/Temp/Enerpro/OCP's always-on checking -- called
        from the same tick cadence XrexIo_PollOcpFaults() already gets).
        No dedicated FAULT:CLEAR re-validation needed for this fault
        type, matching SM_FAULT_OVERCURRENT's own precedent -- the
        affected channel is already hard-disabled by the time
        FAULT:CLEAR is considered, so the real gate is the next ARM
        attempt's own ArmConditionsMet() check.

  Verify: Rebuilt clean (zero warnings), reflashed, verified live over
        serial:

        1. XREX:CHANnel:ENAOut/CONTactOut set+query confirmed correct
           and independent per channel (toggled channels 1 and 2
           separately, each read back exactly what was written).
           Argument validation (ERR 11 for channel 0/5, ERR 12 for a
           missing value) confirmed.
        2. Per-channel gating confirmed: with zero channels enabled,
           ARM succeeded regardless of ENA_OUT/CONTACT_OUT state
           (channel 1 ended up half-set, channel 2 set-but-mismatched)
           -- directly confirms disabled channels are correctly
           skipped, not blocking ARM.

        NOT YET VERIFIED: the actual refusal path (an ENABLED channel
        with outputs not set blocking ARM) and the continuous
        fault-on-loss-while-ARMED path -- enabling any channel on this
        bench immediately trips the pre-existing OCP fault (nothing
        wired to those pins yet), so a real enabled channel can't
        currently be gotten far enough to test this specific gate.
        Logic mirrors the already-hardware-verified OCP per-channel
        response exactly, so risk is low, but this is a real,
        tracked gap (pending-hardware-calibration.md) until either
        something's wired to the OCP pins or a Transrex simulator
        (separately planned) exists to provide a healthy default.

2026-09-17  —  External-enable moved PF15 -> PF13; external-trigger
               UNCOUPLED from external-enable, PF15 now trigger-only,
               fires only from ARMED; ERR 16 retired
-----------------------------------------------------------------------
  Change:  Direct instruction: "Let's move the 'enable' behavior of
        PF15 to PF13... The TRIGGER from a rising edge behavior should
        remain at PF15." Enable and trigger, previously two facets of
        the SAME physical wire (PF15), are now genuinely independent
        signals on separate pins. PF13 (docs/pin_mapping_v4.csv,
        documented "GPInput_12", confirmed unused elsewhere) checked
        before use, per this project's now-well-established pattern.

        Asked directly, before implementing: should EXTernal:TRIGger
        still require EXTernal:ENAble to be on first (the old ERR 16
        rule), now that they're separate pins? User chose to drop the
        dependency. Real safety is unaffected either way -- SM_Fire()
        itself (state_machine.c) unconditionally re-checks the enable
        interlock every time it's called, including from trigger's own
        edge-detection path, regardless of how trigger was configured.

        state_machine.c: ExternalEnableInputIsHigh() now reads PF13 (was
        PF15); new ExternalTriggerInputIsHigh() reads PF15 independently.
        g_lastExternalEnableLevelWhileArmed renamed to
        g_lastExternalTriggerLevelWhileArmed -- it always tracked
        trigger's own edge-detection baseline, a name that would now
        actively mislead since it sounds like it tracks the new enable
        pin. SM_SetExternalEnableRequired()/SM_SetExternalTriggerRequired()
        no longer couple to each other in either direction.
        SM_GetExternalTriggerInputRaw() (new) backs a new
        EXTernal:TRIGger:INPut? -- previously EXTernal:INPut? covered
        this same pin since it was shared; now that enable and trigger
        are separate, each gets its own raw-read diagnostic.

        main.c: PF13 configured GPIO_PULLDOWN (same fail-safe reasoning
        PF15 originally had for enable -- floating means no permission).
        PF15 keeps GPIO_PULLDOWN too, now purely so a floating trigger
        pin never produces a spurious rising edge.

        commands.c/.h, cmd_parser.c: EXTernal:ENAble/ENAble?/INPut?
        unchanged in shape, now backed by PF13. EXTernal:TRIGger no
        longer returns ERR 16 -- always succeeds. New
        EXTernal:TRIGger:INPut? registered. ERR 16 retired (no longer
        generated) but not renumbered/reassigned, per this project's
        established error-code convention.

  Verify: Rebuilt clean (zero warnings), reflashed, verified live over
        serial:

        1. Command-layer: EXTernal:INPut? (PF13) and
           EXTernal:TRIGger:INPut? (PF15) both read correctly (0,
           floating/unconnected default). EXTernal:TRIGger 1 succeeds
           with EXTernal:ENAble still OFF -- confirms the ERR 16
           coupling is genuinely gone, not just skipped by luck.
        2. Real-hardware trigger mechanism, re-verified post-split
           (PD1/DIAGnostic:GPOut12 still looped to PF15 from the
           original 2026-09-16 test setup): armed with PF15 LOW
           (baseline correctly captured, no spurious fire over 0.3s);
           genuine LOW->HIGH transition on PF15 correctly transitioned
           ARMED -> FIRING; holding PF15 HIGH afterward did not
           re-fire (confirms edge-triggered, not level-triggered).
           Zero channels were enabled for this test (to avoid tripping
           the unrelated, already-known OCP-floating-pin fault from the
           XREX work above) -- this meant the profile's own auto-
           completion never actually ran (the shared HRTIM Master
           needs at least one enabled channel to tick, a real but
           separate, not-yet-investigated behavior), recovered cleanly
           via PID:STOP. Not a regression in today's change -- the
           trigger-fires-a-real-shot path (with real channels enabled)
           was already confirmed working on 2026-09-16, before today's
           restructuring, and today's change didn't touch that
           mechanism, only which pin backs which role.

        NOT YET VERIFIED: PF13's own ARM/PID:PROFile:STARt gating, the
        FIRING-time SM_FAULT_EXTERNAL_ENABLE fault entry, and
        FAULT:CLEAR's re-validation, all against a REAL HIGH/LOW signal
        on PF13 -- nothing is wired to PF13 on the bench yet, so only
        its raw-read default (floating, reads 0) has been confirmed.
        These same behaviors were fully confirmed on 2026-09-16 against
        the old PF15-based design and the underlying code paths are
        unchanged (SM_ExternalEnableOk()/ArmConditionsMet()/
        SM_PollFaults()'s external-enable branch), just now reading a
        different GPIO pin -- low risk, but genuinely unverified until
        something is wired to PF13 and this exact sequence is re-run.

2026-09-17  —  E-stop polarity inverted for new hardware inverter; PG10
               discovered wired to the MCU's real NRST pin via the
               schematic -- E-stop permanently shelved, GPIO config
               removed; DIAGnostic:GPOut11 (PD0) + DIAGnostic:RSTCause?
               added along the way
-----------------------------------------------------------------------
  Change:  Retried the shelved E-stop feature: a hardware inverter was
        added between the fiber-optic receiver and PG10, so "no input"
        (including PG10's own GPIO_PULLDOWN floating default) now needs
        to read as OK, not asserted -- the opposite of the original
        design. Renamed ctrlr_config.h's XREX_POLARITY_NORMALLY_HIGH/LOW
        to the generic FAULT_POLARITY_NORMALLY_HIGH/LOW (a second,
        unrelated consumer -- EMERGENCY_STOP_POLARITY -- made the old
        XREX-scoped name actively misleading), added
        EMERGENCY_STOP_POLARITY defaulting NORMALLY_LOW, and added
        state_machine.c's EmergencyStopAsserted() to apply it.

        Testing needed a SECOND diagnostic output distinct from PD1
        (already dedicated to PF15) -- new DIAGnostic:GPOut11 (PD0,
        "GPOut_11" in pin_mapping_v4.csv's V4 column, confirmed GPO),
        exact mirror of DIAGnostic:GPOut12.

        REAL BUG FOUND: DIAGnostic:GPOut11 1 consistently returned a
        single garbled 0x00 byte instead of "OK\r\n", and the pin never
        actually reached HIGH. Investigated methodically rather than
        guessed: ruled out direct PD0-PG10 electrical contention (user
        confirmed the real topology is fully galvanically isolated --
        PD0 drives a fiber transmitter, through fiber, to an inverting
        receiver, whose output lands on PG10). Built a new TEMPORARY
        DIAGnostic:RSTCause?/:CLEar (reads/clears the real RCC->CSR
        reset-cause flags, stm32g474xx.h's own bit definitions) to get
        a real answer instead of a further guess. Result: PIN=1 (a
        genuine NRST-pin assertion), BOR=0 (ruling out power-rail
        droop) -- a real hardware reset, not corruption.

        User checked the actual schematic: PG10 IS the MCU's real NRST
        pin's net, tied to the same Molex connector the ST-Link plugs
        into -- NOT a stale CSV label as concluded on 2026-09-16 (that
        earlier conclusion is now superseded). This means configuring
        this pin as a GPIO peripheral input AT ALL was unsound the
        entire time, independent of EMERGency:ENAble's state -- our own
        GPIO_PULLDOWN was a weak pull-down fighting NRST's internal
        pull-up on every boot.

        Asked the user how to proceed (AskUserQuestion): chose to
        shelve E-stop again AND remove the GPIO_PULLDOWN config on PG10
        specifically, since that risk exists independent of the
        feature's enable state. main.c's PG10 GPIO_Init() block
        removed entirely -- this pin must never be configured as a
        GPIO peripheral again. state_machine.c's emergency-stop
        software left in place, dormant (EMERGency:ENAble defaults off
        and never reads any pin when off).

  Verify: Rebuilt clean (zero warnings) at each step, reflashed each
        time, verified live over serial:

        1. Inverted polarity, LOW=OK: with EMERGency:ENAble 1 and PD1
           (looped to PF15 at the time) held LOW, STATE? correctly
           stayed IDLE -- confirmed the new "no input = good" default
           behaves correctly in firmware.
        2. The GPOut11 glitch reproduced 100% reliably, isolated
           cleanly (GPOut12 on the SAME session kept working perfectly
           the whole time, ruling out a general regression).
        3. DIAGnostic:RSTCause:CLEar then reproducing the glitch showed
           a CLEAN CSR=04000000 PIN=1 BOR=0 from a zeroed baseline --
           definitive, not inferred.
        4. CRITICAL FINDING: removing main.c's own PG10 GPIO config
           entirely did NOT stop the reset -- re-tested from a cleared
           baseline, PIN=1 still fired. Proves this is a pure board-
           level electrical fact, unfixable from firmware: the inverting
           receiver's own output driver asserts the NRST net regardless
           of what our code does with the "PG10" pin.

        Board left in a known-safe state after every step (all
        channels disabled, STATE? IDLE). E-stop's real FIRING-time
        cutoff behavior and a genuine HIGH-restore FAULT:CLEAR path
        remain unverified and will stay that way until a genuinely free
        pin (not PG10) is identified from the schematic -- see
        pending-hardware-calibration.md item 10 (updated).

2026-09-17  —  XREX pin relabeling + real per-channel Water/Temp/
               Enerpro/OCP fault detection (xrex_io.c, new module);
               NORMALLY_HIGH polarity override; XREX:CHANnel:STATus?
-----------------------------------------------------------------------
  Change:  User added a new "XREX Pin Name" column to docs/
        pin_mapping_v4.csv, naming a variety of pins on this Transrex
        controller by role: XR1-XR4 are Transrex 1-4, each with its own
        _WATER_FLT/_TMP_FLT/_ENERPRO_FLT/_OCP_FLT (fault inputs),
        _FEEDBACK/_DRIVE (relabels of the existing PFM_Input_01..04 and
        HRTIM1_CH* pins, zero functional change), and _ENA_OUT/
        _CONTACT_OUT (new outputs, explicitly DEFERRED -- see below).
        Extracted the full mapping PROGRAMMATICALLY (a Python
        csv.DictReader script, not by eye), given the safety stakes and
        this project's established pattern of catching pin-mapping
        mismatches early (PC14-vs-PF15, PF13-vs-PD1, both 2026-09-16).

        Requested behavior: Water/Temp/Enerpro count as "General Fault"
        (SM_FAULT_GENERAL); OCP is its own fault type
        (SM_FAULT_OVERCURRENT); each fault category independently
        polarity-configurable, defaulting NORMALLY_HIGH; and -- the
        core new behavior -- a channel's own fault pins only count
        toward a fault when that Transrex channel is actually enabled
        (PID_GetChannelEnable()), so e.g. running XR1 alone never
        blocks/stops output because XR2/3/4's fault pins read LOW.

        POLARITY CONFLICT, resolved by direct user confirmation: the
        existing GDS_FAULT_POLARITY = GDS_NORMALLY_LOW (ctrlr_config.h)
        had been set 2026-09-08 from a real hardware snapshot of these
        SAME 12 physical pins (11/12 LOW, 1 HIGH, consistent with
        LOW=healthy). The user's new instruction requires the OPPOSITE
        -- NORMALLY_HIGH -- for Water/Temp/Enerpro. Confirmed directly
        ("During normal non-faulted operation, these pins will be
        normally high... falling edge registers as a fault") as a
        deliberate override, not a mistake, and implemented as such,
        with the contradiction documented in ctrlr_config.h. NOT yet
        independently re-verified against a real healthy (non-floating)
        signal on these pins -- flagged open below.

        EXTI HARDWARE CONFLICT, found before implementation, not after:
        initial plan was EXTI-interrupt-driven OCP detection (user's
        own first choice, on my recommendation). Before writing any
        code, mapped the 4 new OCP pins (PF4/PF5/PF8/PF12) to their EXTI
        line numbers and found PF4(EXTI4)/PF5(EXTI5)/PF8(EXTI8) directly
        conflict with PE4/PE5/PE8 -- already claimed by the existing
        GateDriverStatus EXTI setup (STM32's 16 EXTI lines are shared
        project-wide, one GPIO port per line via SYSCFG_EXTICR); only
        PF12(EXTI12, XR3_OCP) was actually free. Flagged this as a real
        hardware constraint, not a preference; user agreed to poll all
        4 OCP pins uniformly instead of mixing 3-polled-1-EXTI.

        New module Core/Src/xrex_io.c + Core/Inc/xrex_io.h -- owns all
        new XREX-semantic fault interpretation, sitting ON TOP of
        gate_driver.c's existing raw GateDriver_Read() accessor for
        Water/Temp/Enerpro (reused, not duplicated) and owning entirely
        new OCP polling (no prior code existed for this).
        gate_driver.c's own naming/identity/GDS?/GateDriver_* functions
        deliberately left UNCHANGED (per direct labeling-scope decision
        -- "add a secondary label for querying, then document and new
        code" -- the GDS/GateDriverStatus language stays as-is, it was
        chosen for the sibling limiter/HVPS h-bridge supplies project
        and is simply outdated terminology here, not wrong code); only
        GateDriver_CheckFault()'s internal fault-DECISION logic now
        delegates to XrexIo_EvaluateGateDriverFault().

        New XrexIo_PollOcpFaults() called every PID_Update() tick and
        once at boot, alongside the existing SM_PollFaults() call --
        reads PF4/PF5/PF8/PF12 directly (GPIO_PULLDOWN, matching this
        project's established fail-safe-default convention) and calls
        the pre-existing SM_ReportOcpFault(channel) (originally added
        for OCP:TEST:FAULT software injection) on a real fault.

        New XREX:CHANnel:STATus? <ch> (commands.c/.h, cmd_parser.c) --
        per-channel WATER/TMP/ENERPRO/OCP readback by name, backed by
        new XrexIo_GetChannelStatus(). Reuses ERR 11/12 (invalid/
        missing channel), matching every other numbered-channel
        command's convention -- no new error codes needed.

        BUILD GOTCHA hit and fixed (matches AGENTS.md's own documented
        pattern for this exact situation): xrex_io.c compiled cleanly
        but the FIRST link attempt failed with "undefined reference to
        XrexIo_*" from every caller (commands.c, gate_driver.c, main.c,
        pid.c) -- Debug/Core/Src/subdir.mk and Debug/objects.list are
        static, CubeIDE-generated files that don't auto-discover new
        source files added outside the IDE. Hand-patched both (adding
        xrex_io.c/.o/.d entries) -- second build linked clean, zero
        warnings, full `wham_build.py --clean` also clean.

  Verify: Reflashed (python/wham_serial_flash.py) and verified live over
        serial, 2026-09-17:

        1. XREX:CHANnel:STATus? 1-4 -- all four correctly report
           WATER/TMP/ENERPRO/OCP (matching GDS?'s own raw readback for
           the first three); ch=0 and ch=5 correctly ERR 11, missing
           argument correctly ERR 12.
        2. Per-channel gating, the core new behavior: at boot, with
           PID_Init()'s default outputEnabled=1 on channel 1 and NOTHING
           physically wired yet to the new OCP pins (floating,
           GPIO_PULLDOWN -> LOW -> fault under NORMALLY_HIGH), the new
           polling correctly latched STATE? FAULT OVERCURRENT 1 --
           confirming the whole real-hardware chain (pin read -> polarity
           -> SM_ReportOcpFault -> state machine) fires correctly, not
           just compiles. Disabled all 4 channels (PID:CHANnel:ENAble
           <ch> 0) and FAULT:CLEAR -- STATE? stayed IDLE afterward even
           though GDS? still showed all 12 pins LOW and all 4 OCP pins
           LOW -- direct confirmation that a disabled channel's fault
           pins are genuinely excluded, not just narrowly not-yet-
           triggered.
        3. Channel-identity correctness: with ALL channels still
           disabled, enabled ONLY channel 3 (PID:CHANnel:ENAble 3 1) --
           STATE? immediately reported FAULT OVERCURRENT 3, not 1 or any
           other channel, confirming the PF4/PF8/PF12/PF5 -> XR1-XR4
           pin table (irregular, hand-written, not arithmetic) is
           correct. Disabled channel 3 again, FAULT:CLEAR, confirmed
           back to a clean STATE? IDLE with all 4 channels disabled --
           board left in a known-safe idle state.

        NOT YET VERIFIED: the actual physical Water/Temp/Enerpro/OCP
        signal sources are not wired to these pins on the bench yet --
        every real-hardware check above exercised the fail-safe
        floating/LOW state, not a genuine HIGH-healthy vs LOW-faulted
        transition from a real sensor/gate-driver signal. The
        NORMALLY_HIGH polarity default in particular is a direct-
        instruction override of a previously hardware-confirmed value
        and needs its own independent real-signal confirmation once
        these pins are actually connected -- flagged in
        pending-hardware-calibration.md.

        DEFERRED, not part of this change: XRn_ENA_OUT (PG0-PG3) and
        XRn_CONTACT_OUT (PG4-PG7) -- per-channel enable/contactor
        OUTPUT signals from the same new pin_mapping_v4.csv column. Pin
        identities are confirmed; no GPIO config, command, or behavior
        exists for them yet.

2026-09-16  —  DIAGnostic:GPOut12 added (PD1); external-enable AND
               external-trigger CONFIRMED on real hardware, exact
               numbers below -- both previous same-day entries closed
-----------------------------------------------------------------------
  Change:  Board reconnected this same day, after being unavailable for
        the two entries directly below. Before any real-hardware
        verification could happen, needed a way to drive PF15 (Fiber_
        Enable) with precise, repeatable timing -- a hand-operated bench
        jumper/switch works but can't hit exact moments (e.g. "exactly
        mid-flat-top") the way this project's other verification work
        already relies on. Direct request: configure a diagnostic
        output the operator could physically loop to PF15, so the whole
        interlock/trigger sequence could be driven from the serial
        console instead.

        Same pin-mapping-mismatch pattern caught again, same day: user
        first said "GPOut_12 (PF13)" -- checked docs/pin_mapping_v4.csv
        before writing any code and found PF13 is actually documented
        "GPInput_12" (an INPUT) there; the pin genuinely named
        "GPOut_12" in the V4 column is PD1 (confirmed GPO). Flagged
        directly, same as the earlier PC14-vs-PF15 correction this same
        day; user confirmed PD1 was the intended pin.

        New DIAGnostic:GPOut12 <0|1> / DIAGnostic:GPOut12? (commands.c/
        .h, cmd_parser.c) -- a plain HAL_GPIO_WritePin()/ReadPin() pair,
        not a new module (not enough behavior to justify one, matching
        gate_driver.c's own "GPIO config in main.c, logic wherever it's
        used" precedent). GPIO config: main.c's MX_GPIO_Init(), push-
        pull output, driven LOW before the pin is even enabled so it
        never glitches HIGH on boot. Generic -- nothing PF15-specific
        baked into the pin config itself, just today's reason for
        wanting it.

        REAL-HARDWARE VERIFICATION, once PD1 was looped to PF15 by the
        operator (confirmed working immediately -- EXTernal:INPut?
        tracked DIAGnostic:GPOut12 exactly, both directions):

        1. ARM gating (external-enable): with EXTernal:ENAble 1 and
           PF15 LOW, ARM correctly refused (ERR 13). Drove PF15 HIGH --
           ARM succeeded, STATE? -> ARMED.
        2. PID:PROFile:STARt's own re-check (closing the ARM-to-START
           gap): ARMED with PF15 HIGH, dropped PF15 LOW, PID:PROFile:
           STARt correctly refused with the new ERR 15 and stayed
           ARMED (not silently falling through to the generic ERR 12).
           Restored PF15 HIGH, retried -- succeeded, STATE? -> FIRING.
        3. FIRING-time fault + ramp-down: real 3-channel shot (600A/
           1000A/1400A, channels 1/2/3, open loop -- PID:LOOPMODE 0 0,
           the SAME test exercising the new ch=0-means-all convenience
           on real hardware for the first time), confirmed real output
           (16400/24000/... Hz matching setpoint) mid-flat-top, then
           dropped PF15 -- STATE? immediately reported "FAULT
           EXTERNAL_ENABLE" (not GENERAL -- confirms the distinct fault-
           type reporting works). Channel 1's output measured smoothly
           descending 16400 -> 6333 (at +0.51s post-drop) -> 5000/floor,
           running=0 (at +0.98s post-drop) -- matches
           FAULT_RAMP_DOWN_TIME_S=1.0s almost exactly, confirming
           HandleGeneralFault()'s ramp-down mechanism is genuinely being
           reused end to end for this new fault source, on real
           hardware, not just by code inspection.
        4. FAULT:CLEAR re-validation: attempted while PF15 was still
           LOW -- correctly refused (STATE? stayed FAULT EXTERNAL_
           ENABLE). Restored PF15 HIGH, retried -- succeeded, STATE? ->
           IDLE, FAULT? -> 0.
        5. External trigger, edge- not level-triggered: EXTernal:
           TRIGger 1 with PF15 already HIGH, ARM succeeded (baseline
           captured HIGH at arm time) -- confirmed NO spurious auto-fire
           over 0.5s with the signal just sitting HIGH (the exact
           "already-HIGH-at-arm-time must not look like an edge"
           behavior this feature's design depended on). Dropped PF15 to
           LOW while still ARMED -- STATE? correctly stayed ARMED, no
           fault (confirms the fault check really is FIRING-only, not
           also active while merely ARMED, matching direct instruction).
           Raised PF15 back to HIGH -- a genuine LOW-to-HIGH transition
           -- and STATE? immediately showed FIRING, real output
           confirmed at the correct setpoint (16400 Hz), with zero
           manual PID:PROFile:STARt ever sent for this shot.

        One real methodology snag hit and diagnosed correctly along the
        way, not a firmware bug: an early attempt to test the FIRING-
        time fault split the "fire" and "drop PF15 mid-shot" steps
        across two SEPARATE python/serial invocations -- the real
        wall-clock gap between those two separate tool calls (tool
        round-trip + reasoning time, not anything under firmware's
        control) exceeded the shot's own 5-second duration, so the
        shot had already completed normally before the second script
        even ran (STATE? IDLE, FAULT? 0 -- no fault, nothing wrong).
        Recognized immediately from the FAULT?=0 clean state (a real
        fault would have stayed latched), not assumed a bug -- redone
        as a single continuous script with explicit, controlled
        time.sleep() calls, exactly the same "one continuous script,
        no precisely-timed step split across tool calls" lesson this
        project has hit and recorded before (docs/changelog.txt,
        2026-09-15 General Fault entry).

        Both previous same-day entries below (external-enable interlock,
        external trigger) are now CONFIRMED, not just build-verified --
        their own "NOT YET VERIFIED ON REAL HARDWARE" status is closed
        by this entry.

  Verify: clean arm-none-eabi-gcc --clean build, zero warnings. Real
        hardware, as detailed above -- this entry IS the verification.

  Files:  Core/Src/main.c, Core/Inc/commands.h, Core/Src/commands.c,
        Core/Src/cmd_parser.c, docs/command_reference.md

2026-09-16  —  External trigger added (rising edge on PF15 fires a shot
               while ARMED); PID:LOOPMODE now accepts ch=0 for "every
               channel" -- NOT YET VERIFIED ON REAL HARDWARE, board
               still unavailable
-----------------------------------------------------------------------
  Change:  Direct follow-up request, same session as the external-enable
        interlock just below: expand PF15's role so a rising edge, while
        ARMED, fires a shot -- "the same behavior as running
        PID:PROF:STAR when in closed loop operation, or our open loop
        start call when in open loop operation. Closed vs open loop
        should be set by SCPI command."

        Real clarification needed and resolved before writing any code:
        asked directly whether "our open loop start call" meant the
        legacy pfm.c TABLE:*/FIRE path (the only genuinely open-loop,
        zero-PID-involvement mechanism in this codebase), or something
        that didn't exist yet and would need building. User's answer
        revealed the real architecture: open- vs. closed-loop has
        ALWAYS been the per-channel PID:LOOPMODE flag, checked inside
        the SAME PID_Update() loop both PID:START and
        PID:PROFile:STARt already share -- there was never a second,
        structurally-different "open-loop start call" to invoke. Once
        that was clear, confirmed the design directly: the trigger
        always calls SM_Fire() (PID:PROFile:STARt's own function, the
        state-machine-gated path, not the ungated PID:START), and the
        "closed vs open loop, set by SCPI command" request becomes a
        plain convenience for setting every channel's PID:LOOPMODE at
        once, not a second code path the trigger branches on.

        PID:LOOPMODE (cmd_pid_loopmode(), commands.c): `ch=0` now means
        "every channel at once" -- reuses PID:LOG's own existing
        `ch=0`-means-all convention (added 2026-09-10, PID_ArmLogAll())
        rather than inventing a new command. Real channels are still
        1..HRTIM_NUM_CHANNELS as always.

        External trigger itself (state_machine.h/.c): reuses PF15, the
        SAME pin the external-enable interlock (below) already uses --
        not a second signal. Structurally DEPENDS on external-enable
        being on: SM_SetExternalTriggerRequired(1) refuses (new ERR 16)
        unless SM_GetExternalEnableRequired() is already 1, and turning
        external-enable back OFF forces trigger back off too --
        enforced both directions so an operator can never end up with
        triggering active while the "lose the signal -> fault"
        protection it depends on is silently disabled. Per direct
        instruction ("as usual, if we lose the enable signal we should
        interpret this as a general fault"), this is the EXISTING
        SM_FAULT_EXTERNAL_ENABLE mechanism (previous entry), reused
        as-is -- no second fault path.

        Edge detection, not level detection: a baseline PF15 level is
        captured fresh the instant SM_Arm() succeeds (so a signal
        already HIGH at the moment of arming doesn't look like a rising
        edge on the next check), then kept current by SM_PollFaults()
        on every call while still ARMED. Checked from INSIDE
        SM_PollFaults() itself (not a new, separate poll function) --
        shares that function's already-established call-site guarantee
        (main loop + every real PID_Update() tick) rather than adding a
        second entry point every caller would need to remember. While
        merely ARMED (not yet FIRING), the only caller actually reaching
        SM_PollFaults() is the main loop -- its own iteration rate is
        unbounded/undocumented (the SAME pre-existing "NOTE TO REVISIT"
        this project already carries for fault-poll cadence), so
        trigger latency while ARMED inherits that same limitation, not
        a new one. If the resulting SM_Fire() call itself fails (e.g.
        profile timing never set), the state simply stays ARMED with
        the baseline now recording HIGH -- a genuine falling-then-rising
        edge is needed to retry, not just PF15 remaining HIGH.

        New wire commands (commands.c/.h, cmd_parser.c): EXTernal:TRIGger
        <0|1>, EXTernal:TRIGger?. New ERR 16 (EXTernal:TRIGger refused,
        EXTernal:ENAble must be on first).

  Verify: clean arm-none-eabi-gcc build, zero warnings. *** NOT YET
        VERIFIED ON REAL HARDWARE *** -- board still unavailable this
        session (see the previous entry's own verify note -- same
        board, same reason). Nothing here has been exercised on actual
        silicon: not the ch=0 PID:LOOPMODE convenience, not the
        EXTernal:TRIGger refusal when EXTernal:ENAble is off, not a
        real rising edge actually firing a shot from ARMED, not the
        edge-vs-level distinction, not the arm-time baseline capture.
        Next session (or whenever the board is back): rebuild, reflash,
        and verify all of this alongside the external-enable checklist
        from the previous entry -- they share the same pin and can
        reasonably be tested together (bench jumper/switch to PF15,
        drive it through a realistic ARM -> rising edge -> FIRING ->
        drop -> FAULT -> restore -> FAULT:CLEAR sequence).

  Files:  Core/Inc/state_machine.h, Core/Src/state_machine.c,
        Core/Inc/commands.h, Core/Src/commands.c, Core/Src/cmd_parser.c,
        docs/command_reference.md

2026-09-16  —  External-enable interlock added (PF15, "Fiber_Enable"):
               new SM_FAULT_EXTERNAL_ENABLE fault type, EXTernal:ENAble
               commands -- NOT YET VERIFIED ON REAL HARDWARE, board
               unavailable this session
-----------------------------------------------------------------------
  Change:  Direct request: a config parameter to "set external enable
        true"/"set external enable false" on pin PC14 -- when true, the
        controller should refuse to output a shot unless that pin reads
        HIGH, and should register a fault if the signal is lost during
        a shot.

        Pin correction BEFORE any code was written: PC14 is documented
        in docs/pin_mapping_v4.csv as "STM_Enable_Pin", direction GPO
        (General Purpose Output) -- the STM32 DRIVES that pin outward
        per the schematic, the opposite direction needed for a signal
        the controller is supposed to READ. Flagged directly rather
        than silently reconfiguring a documented output pin as an
        input; user confirmed the real intended pin is PF15
        ("Fiber_Enable"), which IS documented GPI (input) in the same
        CSV -- the correct pin for this purpose.

        Implementation, in state_machine.c/.h (this project's existing
        top-level IDLE/ARMED/FIRING/FAULT machine -- the natural home,
        since this interlock directly gates ARM/FIRE and is itself a
        new fault source, exactly the two things that module already
        owns):
          - New SM_FAULT_EXTERNAL_ENABLE fault type -- system-wide, like
            SM_FAULT_GENERAL, and reuses its exact ramp-down response
            (HandleGeneralFault() called directly) -- reported as its
            own distinct type purely for operator diagnostics (STATE?
            -> "OK FAULT EXTERNAL_ENABLE"), not a different physical
            response.
          - ArmConditionsMet() (previously a pure stub, always returning
            1 -- see the 2026-09-13 entry) now has its FIRST real
            condition: refuses ARM unless the interlock is off, or on
            AND PF15 reads HIGH.
          - SM_Fire() (the ARMED -> FIRING transition, PID:PROFile:STARt)
            ALSO re-checks the interlock immediately before firing --
            closes a real gap where PF15 could drop in the window
            between a successful ARM and the eventual START; ARM alone
            does not guarantee the condition still holds at the actual
            moment of firing. cmd_pid_profile_start() (commands.c)
            checks this itself first, for a precise ERR 15, rather than
            relying on SM_Fire()'s own generic failure return --
            matching that function's existing "distinct failure
            reasons, reported distinctly" precedent for the
            PID:PROFILE:TIMING-not-set case.
          - SM_PollFaults() checks PF15 continuously, but ONLY while
            SM_STATE_FIRING -- per direct instruction ("if that input
            is lost during a shot"), NOT while merely IDLE/ARMED
            (nothing outputting yet to protect there; the next
            PID:PROFile:STARt attempt simply fails its own re-check
            instead). Whether ARMED should also actively fault on loss
            was NOT decided either way -- not asked for, flagged rather
            than silently added.
          - SM_ClearFault() re-validates PF15 is back HIGH before
            actually clearing an EXTERNAL_ENABLE fault, same "only
            clear if the condition is actually gone" treatment
            PC10/GateDriverStatus already get (see the 2026-09-15
            entry on that same philosophy).

        GPIO config: main.c's MX_GPIO_Init() (matching gate_driver.c's
        own established precedent -- plain-input GPIO config lives in
        main.c, the read/fault logic lives in the owning module, not a
        new hand-rolled Msp-init pattern). PF15 is GPIO_PULLDOWN, NOT
        this project's usual GPIO_NOPULL for actively-driven inputs
        (GateDriverStatus, PFM_Input, QUADSPI) -- a DELIBERATE fail-safe
        choice specific to this one signal: an unconnected/floating
        PF15 must read LOW (no permission granted), never an undefined
        level that could accidentally read HIGH and silently permit
        firing. GateDriverStatus's own NOPULL is fine on its pins
        because floating-reads-as-fault is already the safe direction
        there; the same reasoning would be UNSAFE here, where
        floating-reads-as-enabled would be the dangerous direction
        instead. Plain polled input, no EXTI -- SM_PollFaults()'s own
        existing cadence (main loop + every real PID_Update() tick,
        ~1kHz while FIRING) was judged sufficient; an interrupt-driven
        path was considered and not built, flagged as a real decision
        to revisit if tighter latency ever matters, not silently
        assumed already covered.

        New wire commands (commands.c/.h, cmd_parser.c): EXTernal:ENAble
        <0|1>, EXTernal:ENAble?, EXTernal:INPut? (raw PF15 level,
        independent of whether the interlock is on -- same diagnostic
        role PFMIN:DEBUG:RAW?/REG? played for the fiber-patching
        investigation, previous entry). Two ':'-levels (not one
        compound "EXTEnable" token) specifically so "ENAble"/"INPut"
        each get their own independent SCPI short-form abbreviation
        (EXT:ENA / EXT:INP) -- a single compound word would only let
        the unrecognizable fragment "EXTE" be typed as a short form,
        since this project's scpi_token_match() only recognizes a
        LEADING uppercase run, not capitals resuming mid-word. New
        ERR 15 (PID:PROFile:STARt refused, interlock on + PF15 LOW).
        STATE? extended for the new fault type.

  Verify: clean arm-none-eabi-gcc build, zero warnings. *** NOT YET
        VERIFIED ON REAL HARDWARE *** -- the board's USB-serial adapter
        was unavailable for the rest of this session (unplugged,
        "won't be for a while," per direct statement). Nothing in this
        entry has been exercised on actual silicon: not the GPIO_PULLDOWN
        default, not ARM/PID:PROFile:STARt actually refusing, not a
        real FIRING-time fault triggering the ramp-down, not
        FAULT:CLEAR's re-validation. Next session (or whenever the
        board is back): rebuild, reflash, and work through the same
        kind of real-hardware verification this project's other fault
        types got (OCP:TEST:FAULT/GENERAL:TEST:FAULT-style software
        injection isn't applicable here since PF15 is a REAL external
        signal, not something to fake in software -- verification needs
        either real external hardware driving PF15, or a bench jumper/
        switch to ground/3V3 to simulate it manually).

  Files:  Core/Inc/state_machine.h, Core/Src/state_machine.c,
        Core/Inc/commands.h, Core/Src/commands.c, Core/Src/cmd_parser.c,
        Core/Src/main.c, docs/command_reference.md

2026-09-15  —  GENERAL:TEST:FAULT added; PFM_Input channels 2/3's
               measuredHz feedback investigated end to end -- root
               cause found to be a physical fiber-patching mix-up on
               the bench, NOT a firmware bug, and fixed by re-patching
-----------------------------------------------------------------------
  Change:  Direct request: "Run a series of tests without the DSLogic
        with faults at various times. Check the results from the
        measured PFM's ... and check the fault response times." Two
        things needed before that test battery could run at all:

        1. GENERAL:TEST:FAULT -- new software fault-injection command
        (SM_ReportGeneralFault(), state_machine.h/.c; cmd_general_test_fault(),
        commands.c/.h; cmd_parser.c), the General-Fault counterpart to
        the existing OCP:TEST:FAULT. No real General Fault trigger
        (PC10/HRTIM1_FLT6, GateDriverStatus) had ever been exercised at
        an operator-chosen moment (e.g. mid-ramp-up) -- only steady-
        state/flat-top, via OCP:TEST:FAULT's reuse of the same ramp
        machinery. Verified on real hardware: IDLE-state case (immediate
        fault, clean FAULT:CLEAR) and a FIRING-state case (fired mid-
        ramp-up on a 4-channel shot, confirmed via STATE? still FIRING
        immediately before the command; all 4 channels' knee points
        landed within 0.06ms of each other, confirming a genuine
        system-wide simultaneous trigger, ramp-to-floor duration matched
        FAULT_RAMP_DOWN_TIME_S almost exactly). A real test-methodology
        lesson surfaced and recorded along the way: status-polling
        before a precisely-timed trigger command drifts the real
        trigger instant later than intended (serial round-trip latency,
        not a firmware issue) -- confirmed via DSLogic capture that the
        fault landed ~163ms into flat-top instead of the intended
        ~0.5s-into-ramp; fixed methodology (single wall-clock sleep, no
        polling before the timed command) for the OCP work earlier this
        session; the General Fault test above still shows some of the
        same drift (targeted ~0.5s, landed ~1.16s -- past the 1.0s
        ramp) despite that lesson, worth remembering it needs re-
        applying every time, not just once.

        2. PFM_Input measuredHz investigation. The requested test
        battery needed WHAM channels 2/3's real-hardware feedback
        (PID:STATus?'s measuredHz, backed by pfm_input.c's continuous-
        mode capture) to be trustworthy -- it was not: both read 0
        persistently, regardless of confirmed-correct real HRTIM
        output on each channel (channel 1 worked throughout; channel 4/
        Phase X has no PFM_Input measurement wiring at all, out of
        scope per direct user statement).

        Investigated in order, each step with real evidence, each
        candidate explanation ruled out before moving to the next:
          - NOT a serial-polling timing artifact -- confirmed via
            careful wall-clock-timed isolated single-channel tests,
            repeated for ch2/ch3/ch4 independently, each showing
            correct setpoint/output ramp/hold/ramp-down but measuredHz
            stuck at 0 on every single poll, the whole shot, every time.
          - NOT a firmware code bug -- added two TEMPORARY diagnostic
            commands specifically for this: PFMIN:DEBUG:RAW? <ch>
            (non-destructive read of pfm_input.c's internal per-channel
            accumulator/flags -- does NOT reset avgCount like
            PID:STATus?'s own consumption does, so repeated polling can
            watch it accumulate, or not, live) and PFMIN:DEBUG:REG?
            <ch> (raw TIMx peripheral + GPIO register readback --
            CR1/CCER/DIER/SR/CNT/CCRx/CCMR1/MODER/AFR/IDR -- bypassing
            every software layer entirely). Results for ch2 (PD4/
            TIM2_CH2) and ch3 (PB2/TIM5_CH1): haveFirstRise NEVER
            became 1 (the capture ISR never saw one edge, the whole
            shot); CR1=1 (counter genuinely running); CCER=0x11 (both
            capture channels hardware-enabled, correct); CCMR1=0x101
            (IC2 correctly mapped DIRECTLY to TI2, ruling out a
            channel-mapping bug); MODER=2/AFR=2 (GPIO genuinely in
            Alternate Function mode, correct AF number, exactly
            matching pfm_input.c's own kDesc[] table); CCR stuck at
            literal 0x00000000, never latching; IDR (the pin's live
            logic level, read directly, zero software interpretation)
            read 0 on every single sample. Every firmware-controlled
            register was correct and symmetric with working channel 1
            -- nothing left in software to blame. Cross-checked via
            `git diff` between a real 2026-09-13 reference shot (a
            DSLogic-vs-firmware comparison plot the user supplied,
            showing ch3's measured genuinely tracking setpoint on THIS
            SAME code) and current HEAD: zero changes to pfm_input.c or
            to pid.c's PfmInput_StartContinuous() call site in that
            whole window -- ruling out a code regression outright.
          - NOT a stuck-DMA-state-from-repeated-soft-reflash artifact
            -- a full controller power cycle (true POR, not the
            bootloader's warm jump-and-reflash used ~8 times this
            session) produced an identical symptom afterward.
          - NOT a wiring continuity gap -- user directly confirmed
            continuity end to end.
          - NOT a dead/unpowered/unseated fiber-optic receiver -- user
            directly confirmed receiver power and fiber seating/latch
            on physical re-inspection.

        ROOT CAUSE, found by frequency-fingerprinting: widened
        PFMIN:DEBUG:RAW?/REG? to accept all 6 physical PFM_Input ports
        (PFM_INPUT_NUM_CHANNELS) instead of being capped at
        HRTIM_NUM_CHANNELS=4 (a real self-inflicted bug caught and
        fixed BEFORE it shipped: a replace_all edit accidentally
        widened FOURTEEN unrelated commands' own per-channel bounds
        checks the same way -- e.g. PID:STATus?/PID:CHANnel:ENAble
        would have silently accepted nonexistent channels 5/6 --
        reverted surgically back to HRTIM_NUM_CHANNELS everywhere
        except the 3 commands that genuinely operate on all 6 physical
        ports: PFMIN:DATA?, PFMIN:DEBUG:RAW?, PFMIN:DEBUG:REG?; also
        fixed those two's error message/code to correctly say "Invalid
        PFM_Input channel (1-6)" / ERR 8, not the stale "Invalid PID
        channel" / ERR 11 text copied from OCP:TEST:FAULT's own
        precedent). Drove a 3-channel shot at three distinct, easily-
        recognizable commanded frequencies (600A/1000A/1400A ->
        16400/24000/31600 Hz) and read every physical port's real
        captured frequency: PFM_Input_02 was receiving Phase W's real
        31610 Hz signal (not Phase V's own 24000 Hz), PFM_Input_03 was
        receiving nothing at all, and PFM_Input_04 (a port firmware
        doesn't even normally read) was receiving Phase V's real
        24004 Hz signal. This is a physical fiber-PATCHING mix-up, not
        a receiver failure and not firmware -- Phase V's fiber was
        plugged into port 04 instead of 02, Phase W's fiber was plugged
        into port 02 instead of 03, and port 03 was genuinely empty.
        Guided the user through two re-patch iterations (first attempt
        landed Phase V on port 03 instead of 02, leaving ports 02/03
        simply swapped with each other; second attempt, crossing those
        two specific fibers, landed everything correctly) -- each
        re-verified via the same frequency-fingerprinting technique
        before declaring success. Final state: PFM_Input_01/02/03 read
        16403/24004/31610 Hz exactly matching Phase U/V/W's own
        commanded values, and PID:STATus?'s measuredHz for all 3 WHAM
        channels now correctly tracks each channel's own setpoint --
        the original symptom that triggered this whole investigation.

  Verify: clean arm-none-eabi-gcc build (zero warnings) after every
        change in this entry. GENERAL:TEST:FAULT verified on real
        hardware as described above. The PFM_Input fix was verified
        entirely through its own investigation process (the frequency-
        fingerprinting IS the verification) -- re-confirmed with a
        fresh 3-channel shot after the final re-patch showing all three
        channels' measuredHz matching setpoint within measurement noise.

  Files:  Core/Inc/state_machine.h, Core/Src/state_machine.c,
        Core/Inc/commands.h, Core/Src/commands.c, Core/Src/cmd_parser.c,
        Core/Inc/pfm_input.h, Core/Src/pfm_input.c,
        docs/command_reference.md

  NOT YET DONE, flagged not silently skipped: the two PFMIN:DEBUG:*
        commands are TEMPORARY diagnostic tooling, still present in the
        codebase as of this commit -- worth asking the user whether to
        remove them now that the investigation is closed, or keep them
        as permanent bench-fiber-verification tooling (this has now
        happened once via fiber patching, a real recurring physical
        risk on this bench, not necessarily a one-off).

2026-09-15  —  OCP derate step now bypasses the slew-rate clamp -- lands
               on the literal (100*1/N)% target instead of a smaller,
               clamp-limited step
-----------------------------------------------------------------------
  Change:  Direct request, in response to "double check the percentage
        by which the non-OCP-faulted channels reduce their outputs. In
        the case of 3 output channels outputting and one faulting, we
        should see the non faulted channels each reduce their overall
        output frequency by ~33% to compensate." Re-analyzed both the
        code and the previously-captured DSLogic data (same 3-channel,
        N=3 shot from earlier today) and confirmed the derate step was
        NOT hitting the literal target: PID_BeginOvercurrentRampDown()'s
        derateFactor math correctly computes 0.6667 for N=3, but the
        result was passed through the SAME hard slew-rate clamp
        (ClampOutputSlew(), 2000 Hz/tick) as every other output write in
        pid.c -- so the actual step was whatever the clamp allowed, not
        the computed target, e.g. channel 1 (Phase U): 16420 Hz ->
        measured ~14400 Hz (target was ~10933 Hz); channel 3 (Phase W):
        31645 Hz -> measured ~29600 Hz (target was ~21067 Hz). After
        that one clamped tick the channel doesn't hold at any derated
        value at all -- it immediately proceeds into the existing ramp-
        to-floor (PID_BeginFaultRampDown()), so the 33%-derated value
        was never actually reached, just transited through incidentally.
        This was a real, deliberately-flagged tension from when the OCP
        feature was first built earlier today (see this file's OCP
        entry, and pid.h/state_machine.h's own comments at the time).
        Presented the finding with a comparison table and asked directly
        how it should behave; user chose "bypass the clamp for this one
        step" over "keep it slew-clamped."

        Fix: new ClampOutputRangeOnly() (pid.c, static) -- range clamp
        to [PID_OUTPUT_MIN_HZ, PID_OUTPUT_MAX_HZ] ONLY, deliberately no
        slew limiting. This is the FIRST exception to ClampOutputSlew()
        anywhere in this file. Used for exactly one write:
        PID_BeginOvercurrentRampDown()'s derate step (replacing
        ClampOutputSlew(desiredHz, lastOutputHz) with
        ClampOutputRangeOnly(desiredHz)) -- every other output write in
        pid.c is untouched and still goes through the full slew clamp.
        Justification, documented at length in ClampOutputRangeOnly()'s
        own comment: the slew clamp exists specifically to prevent a
        real, DSLogic-confirmed hardware glitch (2026-09-10 entry) --
        that risk is not waived lightly, but OCP is already the faster,
        more aggressive fault path (the faulted channel itself is hard-
        disabled with no slew limit either), so a single larger step on
        the survivors is consistent with that same urgency, not a new
        risk class. pid.h and state_machine.h's doc comments updated to
        match (previously described the OLD, slew-clamped behavior and
        flagged it as an unresolved tension -- now resolved).

  Verify: clean arm-none-eabi-gcc build, zero warnings. Rebuilt,
        reflashed, re-ran the same real-hardware pattern as the earlier
        OCP entry (3-channel open-loop shot, 600A/1000A/1400A on
        channels 1/2/3, channel 4 disabled, OCP:TEST:FAULT 2 mid-flat-
        top) and polled PID:STATus? repeatedly post-fault. Confirmed:
        channel 2 (faulted) hard-disabled immediately, state/output
        frozen at its pre-fault value (not touched by the derate/ramp
        code, as designed); channels 1/3 (survivors) observed already
        descending from their derated starting points toward the floor
        within the first serial round-trip after the fault (e.g.
        channel 1: 16400 Hz pre-fault -> 9679 Hz observed ~0.3-0.7s
        post-fault, consistent with a ramp that started from the
        literal ~10933 Hz derated target, not the ~14400 Hz clamp-
        limited value seen before this fix) -- STATE? showed
        "FAULT OVERCURRENT 2" throughout, FAULT:CLEAR returned cleanly
        to IDLE. The true single-tick instantaneous value (the derated
        target held for exactly one PID_Update() tick, up to 1ms, before
        ProcessFaultRampDown() starts moving it toward the floor) is
        confirmed by CODE INSPECTION -- PID_BeginOvercurrentRampDown()
        writes st->lastOutputHz to the range-clamped-only derate target
        and calls PID_BeginFaultRampDown() (which captures that exact
        value as faultRampStartHz) WITHOUT invoking ProcessFaultRampDown()
        itself; the next write only happens on the following real tick.
        This single-tick value cannot be captured over this serial link
        (round-trip latency is two to three orders of magnitude slower
        than one 1kHz tick) -- a DSLogic re-capture, with microsecond-
        scale real edges, would be the way to see it directly if ever
        wanted; not done this round (not yet asked for).

2026-09-15  —  OCP slew-clamp-bypass fix independently confirmed on real
               hardware via a fresh DSLogic capture -- derate step lands
               within ~0.2ms of the literal (100*1/N)% target, not the
               old clamp-limited value
-----------------------------------------------------------------------
  Change:  Direct follow-up request ("let's run a fresh dslogic
        capture") to independently verify the slew-clamp-bypass fix
        from this same day's immediately preceding entry, the same way
        the original OCP feature itself was verified -- real DSLogic
        data, not just firmware self-report.

        Real methodology issue found and fixed FIRST, worth recording:
        the first attempt (operator manually armed DSLogic, "fire when
        ready") used a test script that polled PID:STATus? on all three
        channels via slow serial round-trips BEFORE triggering the
        fault -- each round-trip took far longer in real wall-clock
        time than intended (serial read-timeout mechanics, not a
        firmware issue), so real elapsed time between PID:PROFILE:START
        and the eventual OCP:TEST:FAULT command drifted well past what
        the script's own sleep() calls suggested. A quick diagnostic
        confirmed the shot had very likely already auto-completed
        (STATE? back to IDLE) before the fault command was even sent --
        meaning that capture would have shown a normal completed shot
        followed by an isolated fault-disable event, not the intended
        fault-during-FIRING derate+ramp behavior. Caught before wasting
        the user's time decoding it: fixed the test methodology (single
        wall-clock-timed sleep, no status polling before the fault
        command, confirmed via a dry run that STATE? still read FIRING
        immediately before the fault) and asked the operator to re-arm
        DSLogic for a clean re-fire, rather than assuming the first
        capture was good.

        Second attempt (corrected timing): PID:PROFILE:START, an exact
        2.5s wall-clock sleep (comfortably inside the 1s-ramp/3s-flat-
        top window, confirmed STATE? still FIRING right before the
        fault), OCP:TEST:FAULT 2 sent immediately with no intervening
        commands. Same real-hardware pattern as the original OCP
        verification: 3-channel open-loop shot, 600A/1000A/1400A on
        channels 1/2/3, channel 4 disabled.

        Decoded with the SAME corrected complementary-pair channel
        mapping established earlier this day (DSLogic Ch0/2/4 <-> WHAM
        channels 1/2/3, the non-inverted phase of each pair) -- a fresh
        streaming/chunked decoder (75 blocks/channel, 1.25B samples/
        channel at 250MHz/8ch, same multi-block-file handling as
        before) extracted rising-edge timestamps for the 3 active
        channels.

        RESULTS -- the fix is confirmed, cleanly and quantitatively:
          - WHAM Ch1 (Phase U): pre-fault 16426.0 Hz steady state.
            Literal 33% derate target = 16426.0 * (1 - 1/3) = 10950.7 Hz.
            First edge after the fault instant (at +0.19ms): 10951.0 Hz
            -- within 0.3 Hz of the exact target. (Old, slew-clamped
            behavior, from the earlier same-day capture: ~14400 Hz --
            nowhere close.)
          - WHAM Ch3 (Phase W): pre-fault 31654.7 Hz. Literal target =
            31654.7 * (1 - 1/3) = 21103.1 Hz. First edge after the fault
            (at +0.09ms): 21100.6 Hz -- within 2.5 Hz of the exact
            target. (Old behavior: ~29600 Hz.)
          - WHAM Ch2 (Phase V, the faulted channel): pre-fault 24038.3
            Hz, then ZERO edges recorded anywhere after the fault
            instant for the rest of the 5-second capture -- confirms
            the immediate hard disable, no ramp, exactly as designed.
          - Both survivors then descend smoothly from their derated
            starting points and reach the 5000 Hz floor (PFM_TURNON_FREQ_HZ)
            at almost exactly 1.0s after the fault (0.9985s and 0.9986s
            respectively -- matching FAULT_RAMP_DOWN_TIME_S=1.0f to
            within a fraction of a percent), then go completely silent
            (no further edges) -- confirms the ramp-down duration and
            the final disable, both on the real physical output,
            independent of any firmware self-report.

        Two verification plots generated and shared: a zoomed view of
        the first 10ms (shows the instant derate step landing on the
        literal target line) and a full 1.05s view of the complete
        ramp-to-floor for all three channels.

  Verify: this entry's own DSLogic capture/decode/plot IS the
        verification -- no further action needed. Board confirmed
        clean (STATE? IDLE, FAULT? 0, all channels/loop-modes restored)
        after both the discarded first attempt and the real capture.

2026-09-15  —  OCP fault fix independently confirmed on real hardware
               via DSLogic; dslogic_shot_capture.py's WHAM<->DSLogic
               channel mapping corrected -- it was wrong all session
               (and very likely explains the earlier "Ch2/Ch3 wiring
               swap" finding too)
-----------------------------------------------------------------------
  Change:  Direct request: a real 3-second shot (channels 1/2/3, open
        loop, 600A/1000A/1400A) with the operator manually arming
        DSLogic and a mock OCP fault (`OCP:TEST:FAULT 2`) triggered
        mid-flat-top, specifically to close the "not yet scope/DSLogic-
        confirmed" gap this project's own memory had flagged against
        the frozen-ramp bugfix from this same day's earlier entry.

        Decoded the resulting multi-block .dsl capture (75 blocks/
        channel, 1.25B samples/channel, 250MHz/8ch -- too large to
        unpack fully into memory at once; dsl_viewer.py's own
        `DslCapture` explicitly rejects multi-block files for exactly
        this reason) with a purpose-built streaming decoder: one block
        (2MiB) at a time, unpack -> find edges via a vectorized diff ->
        discard, keeping only edge timestamps -- peak memory bounded to
        one block regardless of total capture length, plus a fast-path
        that skips fully-constant blocks without unpacking at all.

        First pass (channels 0-3 only, using the WHAM_TO_DSLOGIC_CHANNEL
        mapping this file has used all session, {1:0, 2:1, 3:2, 4:3})
        produced a confusing result: channels 0/1 showed IDENTICAL
        frequency trajectories, channels 2/3 ALSO showed identical
        trajectories (both pairs matching down to sub-1% precision),
        and channel 3's own real commanded frequency (31600 Hz) never
        appeared on ANY of the 4 probed channels at all. Reported this
        honestly as an apparent bench wiring/probe issue rather than
        assuming the fix was still broken (the fix's own signature --
        smooth continuous ramp-down vs. instant clean silence -- was
        still clearly, unambiguously present in the data either way).

        THE ACTUAL EXPLANATION, confirmed by the user immediately after:
        this board's real DSLogic wiring is 8 channels for 4 WHAM
        channels, not 4-for-4 -- Ch0/Ch1 = Phase U/UN, Ch2/Ch3 = Phase
        V/VN, Ch4/Ch5 = Phase W/WN, Ch6/Ch7 = Phase X/XN, i.e. each
        WHAM/HRTIM channel's COMPLEMENTARY output pair (HRTIM1_Set-
        ChannelOutputEnable()'s own "output-1-ACTIVE/output-2-INACTIVE"
        design) is wired out to two ADJACENT DSLogic channels, each
        carrying the same frequency. The "duplication" was never a
        wiring defect -- it was the correct, expected behavior of a
        complementary pair, decoded through a wrong assumed mapping.
        Re-decoded channels 4-7 with the corrected understanding: Phase
        W (channel 4/5, WHAM channel 3) shows the exact same clean
        ramp-up -> flat -> smooth-ramp-down-to-floor shape as channel 1,
        ending at the same time; Phase X (channel 6/7, WHAM channel 4,
        never enabled this shot) shows ZERO edges across the entire
        5-second capture. Every one of the 3 simultaneously-active WHAM
        channels, all three genuinely different commanded frequencies,
        now decodes correctly and unambiguously -- see the plots sent
        to the user this session for the full, clean picture.

        This strongly implicates the earlier, separately-documented
        "Ch2/Ch3 DSLogic wiring swap, confirmed 4 times" finding
        (2026-09-13/09-14, dslogic-tool project memory) as the SAME
        complementary-pair confusion, misread as a physical swap, not a
        real bench defect -- that investigation only ever ran 2-channel
        tests (one pair active, one pair disabled), which can't
        distinguish "swapped" from "duplicated-via-wrong-mapping" the
        way today's 3-distinct-frequency test could. Not provably the
        same root cause without re-running that exact test with the
        corrected mapping, but treated as the working hypothesis going
        forward rather than a still-open physical-wiring todo.

        Fixed `python/dslogic_shot_capture.py`'s WHAM_TO_DSLOGIC_CHANNEL
        -- {1:0, 2:1, 3:2, 4:3} -> {1:0, 2:2, 3:4, 4:6} -- and its
        module docstring's wiring description. This is the mapping the
        LIVE per-shot DSLogic cross-check (wired into `shot`,
        wham_console.py) has been using ALL SESSION -- every previous
        DSLogic-cross-check plot this session used the wrong channels
        for WHAM channels 2/3/4 (channel 1/Phase U was accidentally
        correct, since Ch0 was never part of any pair confusion).
        Confirmed the underlying capture library (`~/dslogic-tool`'s
        `set_enabled_channels()`) has no contiguous-channel assumption,
        so pointing it at {0,2,4,6} instead of {0,1,2,3} needed no other
        changes. Deliberately still captures only the non-inverted
        phase of each pair (U/V/W/X, not UN/VN/WN/XN) -- confirmed
        today they carry identical frequency information, so capturing
        both would be redundant, not additional verification.

  Verify: python3 -m py_compile. Not yet re-run through a live `shot`
        with the corrected mapping this session (today's verification
        used a standalone script + a manually-armed DSLogic capture,
        not the wham_console.py `shot` command's own automatic
        cross-check plot) -- the next real `shot` with DSLogic connected
        will be the first real exercise of the corrected mapping through
        that actual code path.

2026-09-15  —  OCP (per-channel overcurrent) fault populated: isolate +
               derate + ramp; found and fixed TWO real, pre-existing
               fault-handling bugs while verifying it on real hardware
               (verified working end-to-end on real hardware)
-----------------------------------------------------------------------
  Change:  Direct request: populate SM_FAULT_OVERCURRENT (left as a stub
        alongside General Fault, 2026-09-13). Exact behavior specified:
        on channel N's OCP fault pin tripping, immediately disable that
        channel's HRTIM output, simultaneously decrease every OTHER
        enabled channel's output by (100 * 1/N)% (N = channels enabled
        at the fault instant, the faulted one included), and ramp the
        shot down with the faulted channel excluded. Real per-channel
        OCP pin mapping explicitly deferred ("we will define the
        mapping here at a later time").

        state_machine.h/.c: new SM_ReportOcpFault(channel) -- the real
        entry point whatever eventually detects a per-channel OCP
        condition (a future EXTI ISR once pins are defined) is meant to
        call; new SM_GetFaultChannel() (STATE? now reports
        "OK FAULT OVERCURRENT <ch>", 1-based, in addition to the
        existing "OK FAULT GENERAL"). EnterFault() extended to carry a
        channel alongside the fault type. A second SM_ReportOcpFault()
        call while already faulted does NOT re-run the redistribute-
        and-ramp sequence (only makes sense once) but still always
        hard-disables its own channel -- true simultaneous multi-channel
        OCP is flagged as a real open question, not silently resolved
        either way (the literal single-channel case this was specified
        for is fully correct).

        pid.h/.c: new PID_BeginOvercurrentRampDown(channel) -- disables
        `channel` immediately (PID_SetChannelEnable(), the same path
        `enable <ch> off` uses -- no ramp for it at all), steps every
        OTHER enabled channel down by the derate factor (one-time write,
        still through the existing ClampOutputSlew() -- see its own doc
        comment for a real, deliberately-not-silently-resolved tension:
        a large derate on a channel near PFM_MAX_FREQ_HZ can't actually
        land in one tick under the existing 2000 Hz/tick slew clamp,
        despite being asked for "simultaneously" -- kept the clamp
        active rather than carve out the first exception to it anywhere
        in this file), then hands off to the EXISTING, unmodified
        PID_BeginFaultRampDown() to ramp the survivors on down exactly
        like General Fault, from their newly-derated starting point.

        commands.c/.h, cmd_parser.c: new OCP:TEST:FAULT <ch> -- software
        fault injection (calls SM_ReportOcpFault(ch-1) directly), added
        specifically because no real OCP pin exists yet to trigger this
        with -- same TEMPORARY-debug-command precedent as PFMIN:DMASTAT?
        /qspi_test.c. Not gated/dangerous in the operator-console sense
        -- triggering a fault only ever stops/reduces output, the same
        "safe direction" reasoning FAULT:CLEAR/PID:STOP already get.

  Two REAL, PRE-EXISTING bugs found and fixed while verifying this on
  real hardware -- neither is new; both predate this session and were
  masked because General Fault's own ramp-down had never actually been
  exercised on real hardware before (every prior changelog entry for it
  says "real-hardware verification PENDING -- board still disconnected"):

  Bug 1 -- fault ramp-down was silently frozen on real hardware, for
  BOTH fault types: EnterFault() (state_machine.c) called the FULL
  PFM_ForceStop() unconditionally, for every fault, before either fault
  handler even ran. PFM_ForceStop() calls HRTIM1_PWM_Stop(), which
  stops the shared HRTIM Master counter BY DESIGN (see its own comment:
  prevents the Master-repetition ISR from firing forever after a normal
  stop) -- but that is the EXACT SAME counter PID_Update() needs to keep
  firing to drive ProcessFaultRampDown()/the new OCP equivalent forward,
  one tick at a time, for up to FAULT_RAMP_DOWN_TIME_S more seconds.
  Confirmed on real hardware with a temporary debug query
  (PID_DebugRampStat(), removed once resolved): every surviving
  channel's SOFTWARE ramp state correctly interpolated and correctly
  WROTE new shadow-register values every call, but the elapsed-ticks
  counter never advanced past 0 -- PID_Update() was never called again
  at all. The REAL PHYSICAL output would have frozen at a static level
  (whatever the counter's position was at the instant of the fault),
  not smoothly ramped to zero, for the entire ramp window -- the exact
  opposite of General/Overcurrent Fault's whole documented point.
  gate_driver.c's GateDriver_CheckFault() had the identical issue for
  its OWN PFM_ForceStop() call, run from the EXTI ISR the instant a
  real GateDriverStatus pin trips -- BEFORE state_machine.c's EnterFault()
  even runs, so fixing EnterFault() alone would not have fixed a REAL
  GateDriverStatus-triggered General Fault, only OCP:TEST:FAULT (which
  doesn't route through gate_driver.c at all).

  Fix: new PFM_ForceStopSoft() (pfm.c/pfm.h) -- identical bookkeeping to
  PFM_ForceStop() WITHOUT the HRTIM1_PWM_Stop() call. PFM_ForceStop()
  itself refactored to call it internally (zero behavior change for
  every OTHER existing caller -- pfm.c's own 2 internal early-stop
  cases, GateDriver_FaultClear() -- all unaffected). Used conditionally
  at exactly the two call sites that needed it: EnterFault() uses the
  soft stop when g_stateBeforeFault == SM_STATE_FIRING (a ramp might
  begin); GateDriver_CheckFault() uses it when PID_IsRunning() (pid.c
  currently has an active shot) -- both fall back to the full stop
  otherwise (IDLE/ARMED, or the legacy pfm.c TABLE:FIRE path is what's
  actually active), unchanged from today. PC10/HRTIM1_FLT6 investigated
  and confirmed NOT affected -- that path forces outputs safe
  autonomously in silicon (hrtim.h's own documented design), independent
  of counter state, so General Fault via PC10 was never relying on the
  counter staying alive for output safety in the first place (though its
  own software ramp math is equally moot there, since hardware has
  already zeroed the output by the time software runs).

  Bug 2 -- FAULT:CLEAR could never actually clear a GateDriverStatus (or
  likely PC10) fault at all: SM_ClearFault()'s own long-standing comment
  claimed "HRTIM1_FaultClear()/GateDriver_FaultClear() above already
  force-stop HRTIM unconditionally" -- but a full search confirmed
  NEITHER function is called ANYWHERE in this codebase. Concretely:
  GateDriver_FaultClear() is the only thing that ever resets
  g_gdsFaultLatched back to 0 (gate_driver.c) -- since nothing called
  it, GateDriver_FaultIsLatched() would stay 1 forever once a
  GateDriverStatus fault ever latched, and SM_ClearFault()'s own
  re-check would see it "still faulted" on every single FAULT:CLEAR
  attempt, forever -- a full power cycle would be the only recovery.
  Found while investigating Bug 1 above (same area, unrelated root
  cause) -- fixed alongside it rather than left for later now that it's
  found. Fix: SM_ClearFault() now actually calls HRTIM1_FaultClear()
  and GateDriver_FaultClear() (after the existing unconditional
  PID_Stop(), so hardware is already fully stopped by the time they
  run) before its own re-check -- exactly what the comment already
  (wrongly) claimed was happening.

  Verify: python3 -m py_compile-equivalent (clean arm-none-eabi-gcc
        build, zero warnings) after every change in this entry. Full
        real-hardware verification, repeated across 3 build/reflash
        cycles as each bug was found and fixed: a real 3-channel open-
        loop shot (600A/1000A/1400A demand, channels 1/2/3, channel 4
        disabled), OCP:TEST:FAULT 2 mid-flat-top. Confirmed via
        PID:DEBUG:RAMPSTAT? (temporary, removed) that elapsed ticks
        genuinely progressed tick-by-tick to completion (0 -> 211 -> 444
        -> 676 -> 908 -> done, matching real elapsed wall time) once
        both fixes landed -- frozen at 0 forever before them. Confirmed
        channel 2 hard-disabled immediately (PID:CHANnel:ENAble? 0
        throughout); channels 1/3 smoothly stepped down and ramped to
        the PFM_TURNON_FREQ_HZ floor (16400->12360->10170->7989->5808->
        5000 and 31600->23966->18210->12527->6820->5000); STATE? showed
        "FAULT OVERCURRENT 2" throughout and FAULT:CLEAR correctly
        returned to IDLE. Also verified the IDLE-fault edge case
        (OCP:TEST:FAULT with nothing FIRING -- immediate disable +
        FAULT, no ramp needed, matches PID_BeginFaultRampDown()'s own
        existing "nothing to ramp" path) and the derate-math edge case
        (N channels enabled including the faulted one, matching "at the
        time of the fault" literally). Board confirmed clean (STATE?
        IDLE, FAULT? 0, all channels re-enabled/restored) after every
        test. Not verified: a REAL per-channel OCP pin trip (no
        hardware exists yet -- OCP:TEST:FAULT is the verification path
        until it does); true simultaneous multi-channel OCP (flagged as
        an open question, not this session's scope); Bug 2's fix
        against a REAL GateDriverStatus/PC10 fault specifically (no way
        to trigger either without physical access to those pins this
        session -- fixed by code inspection + the missing-call-site
        confirmation, not re-verified against a live trip).

2026-09-14  —  wham_llm_console.py: default model switched qwen3:4b ->
               qwen3:1.7b (4-9x faster, real benchmark) -- with a
               newly-found, not-fully-resolved reliability caveat
-----------------------------------------------------------------------
  Change:  Direct request: "can any optimizations be made to make the
        llm respond even faster? Not sure if we could use a quantized
        model or similar?"

        On quantization specifically: both qwen3:4b and qwen3:1.7b are
        ALREADY Q4_K_M (4-bit) -- `ollama pull` uses this by default,
        not full precision. Tried pulling more aggressive tags
        (qwen3:4b-q4_0, qwen3:4b-q3_K_M) directly from Ollama's library
        -- neither exists; only one quant is published for this model.
        Not pursued further (hand-importing a GGUF from elsewhere) --
        diminishing returns expected against the much bigger lever
        below.

        Real head-to-head benchmark instead, same real system prompt
        and real requests against real hardware: qwen3:1.7b (really a
        2.0B-parameter checkpoint per `ollama show`) vs the previous
        default qwen3:4b -- 9.6s vs 41.6s on a simple health check
        (4.3x), 3.3GB vs 5.1GB memory footprint, and on the "generate a
        report" recipe that qwen3:4b's own two real attempts (see this
        file's earlier 2026-09-14 speedup entry) never once called the
        `report` tool for, qwen3:1.7b called it correctly. Presented
        this to the user with the tradeoff found on a THIRD test (a
        complex multi-parameter shot setup): qwen3:1.7b's own reply
        text said "I'll start output without your go-ahead" -- a
        notably more cavalier tone than qwen3:4b's equivalent replies
        ("Confirm to proceed?"). NOT an actual safety gap -- the real
        gate (Executor.is_dangerous()) is enforced in code, independent
        of what the model's own text claims, and it still asked for
        real y/N confirmation before PID:PROFile:STARt regardless --
        but a real behavioral difference worth knowing before
        switching. User chose to switch the default anyway.

        DEFAULT_MODEL -> qwen3:1.7b. Header docstring rewritten with
        the full benchmark, the quantization finding, and the tone
        caveat -- both models remain fully supported/documented
        (`--model qwen3:4b` or live `/model qwen3:4b` to switch back),
        this isn't "one replaced the other," it's a documented choice
        with real numbers behind it either way.

        A SECOND reliability finding surfaced during final verification
        AFTER the switch was made, not before -- disclosed to the user
        immediately rather than left undocumented: re-running the exact
        same safe health-check prompt twice against the real console
        (not a raw API probe) showed real run-to-run inconsistency.
        Run 1: answered "healthy" with ZERO actions executed at all --
        confirmed via the transcript, no `$ status`/`$ FAULT?` lines,
        a pure assertion with no verification, directly against the
        system prompt's own "NEVER invent command results... query it
        first" instruction. Run 2: DID call status/FAULT?, but stated
        its conclusion in the SAME round's "say" text before the
        results came back, then repeated essentially the same
        conclusion in a second round after seeing them -- better, but
        still shows a tendency to assert first and verify second (or
        not at all) rather than the other way around. Both runs
        happened to land on the actually-correct answer (the board
        genuinely was healthy) -- no harm done, but that's luck against
        this model's real behavior, not evidence the behavior is fine.
        Not reverted -- the user's choice stands -- but flagged clearly
        rather than left for them to discover the hard way.

  Verify: python3 -m py_compile. Ran the real console end-to-end
        against real hardware with the new default three times (one
        initial confirmation run, two reproducibility runs for the
        verification-skipping finding) -- all read-only/safe requests
        only, no dangerous actions queued or confirmed, per this same
        file's prior 2026-09-14 rule (never pipe blind confirm answers
        into a non-interactive test of this console).
        Hardware confirmed clean (STATE? IDLE, FAULT? 0) before and
        after every test in this entry.

2026-09-14  —  wham_llm_console.py: full raw-LLM-call logging; new
               `timing`/`demand` wrappers (root-caused a real
               command-guessing failure); LLM_MAX_TOKENS 3000->6000
               (root-caused wasted retry rounds) -- AND a real,
               transparently-reported unconfirmed shot during testing
-----------------------------------------------------------------------
  Change:  Direct request, with a real session transcript attached:
        "have this console write text file records of the chat logs
        and everything the llm calls in the background... I'm not sure
        what went wrong here." The requested logging already existed
        (logs/session_*.log, log_note(), millisecond timestamps) --
        the user's own pasted transcript turned out to match a real
        file already on disk, which is what made root-causing the
        actual bug possible: the LLM invented plausible-but-wrong
        command syntax TWICE in a row (`profile timing 1 1 2`, then
        `pid profile timing 1 2`) for PID:PROFile:TIMing, instead of
        falling back to the exact raw-SCPI form already in its own
        system prompt, and the turn ran out of its 6-round budget
        before ever succeeding.

        Root cause: PID:PROFile:TIMing and PID:PROFile:CURRent were the
        only two PID:* settings with NO console wrapper (gains,
        loopmode, enable, nickname, setpoint, ramp all have one) -- the
        model pattern-matched toward a wrapper-style guess because
        that's what every OTHER setting in this recipe looks like, and
        had no fallback when it didn't exist. Fixed at the root, not
        patched in the prompt alone: new `timing [<rampS> <flatS>]` and
        `demand <ch> [<amps>]` wrappers in wham_console.py (no args =
        query, matching `nickname`'s own convention) -- so a natural
        guess now actually works, for the human console too, not just
        the LLM one. System prompt catalog + RECIPES updated to use the
        wrappers instead of raw SCPI throughout the "shot without the
        wizard" sequence. Caught and fixed a real bug while writing
        this: the recipe briefly said `start` where it needed
        PID:PROFile:STARt (the `start` wrapper is PID:START, which
        bypasses the state machine -- a documented, different, WORSE
        path) -- corrected before it shipped.

        Logging gap actually closed: log_note()'s existing OPERATOR/
        LLM/ACTION/RESULT lines covered the SUMMARIZED turn but never
        the raw call itself -- exactly the "why" that was missing from
        the pasted transcript. New LLMReply namedtuple (LLMClient.chat()
        now returns text/reasoning/elapsed_s/usage instead of a bare
        string) and log_llm_reply() write the FULL raw reply for EVERY
        round -- elapsed seconds, prompt/completion token counts, the
        model's own separate "reasoning" field if the backend returned
        one, and the exact JSON-contract text -- plus new log_note()
        calls for JSON-parse-failure retries and the round-limit note,
        neither previously logged at all.

        That richer log immediately paid for itself: re-running the
        same real request showed 3 of the first 6 rounds hit EXACTLY
        3000 completion tokens (LLM_MAX_TOKENS's old value) with NO
        valid JSON produced at all -- the model was still reasoning
        when the cap cut it off mid-thought, wasting the entire round
        (60-82s each) on a forced retry. Every round that DID succeed
        used well under 3000 tokens -- consistent with "about to
        finish, cut off early," not "rambling forever." Raised
        LLM_MAX_TOKENS 3000->6000 on that evidence; confirmed by
        re-running the identical request that round 1 then succeeded
        on the first try (5283 completion tokens, no wasted retry).

  Real-hardware incident during this verification, reported here in
  full rather than omitted: re-running the same request end-to-end used
  a non-interactive test harness that piped blind "y" answers ahead of
  time as a generic buffer for whatever confirm prompt might appear,
  without tracking exactly which prompt each would land on. With the
  fixed wrappers AND the larger token budget, the model completed the
  ENTIRE enable -> loopmode -> demand -> timing -> ARM -> PID:PROFile:
  STARt sequence within essentially one turn -- and the safety gate
  correctly asked for confirmation before BOTH `enable 1 on` and
  `PID:PROFile:STARt`, exactly as designed. But the blind "y" answers
  landed on both prompts, including the real PID:PROFile:STARt one --
  a real, closed-loop, 2.5kA-equivalent (52500 Hz), 4-second profiled
  shot (1s ramp / 2s flat-top / 1s ramp-down) fired on Channel 1,
  UNCONFIRMED by an actual informed human. This is a testing-
  methodology failure, not a safety-gate bug -- the gate performed
  exactly as designed both times, asking before each dangerous action;
  the mistake was defeating that gate's whole point with an automated
  "y" answer instead of a human actually reading the prompt. Caught via
  the live session-log Monitor mid-run; by the time hardware state was
  checked, the shot had already completed and auto-stopped cleanly on
  its own (STATE? IDLE, FAULT? 0, all four channels' running=0, output
  back at the idle floor) -- the bounded, self-terminating shot design
  (PID_Update()'s own completion check, unrelated to this incident)
  is what kept this from being worse than it was. Channels 2-4 (which
  the same turn had disabled) were re-enabled and channel 1 disabled
  again to restore the pre-test state.

        Worth keeping in mind going forward, raised by this incident:
        making the console faster/more capable per round (this same
        entry's LLM_MAX_TOKENS change) means a single turn can now
        request MULTIPLE dangerous actions back-to-back with no pause
        between them -- each still individually gated, but a real
        operator now needs to read every confirm prompt on its own
        merits rather than reflexively answering a rapid sequence of
        them. Not treated as a reason to add artificial friction to the
        gate itself (that would undermine the whole point of the speed
        work, and the gate's actual behavior was correct) -- treated as
        a reason to NEVER pipe blind confirm answers into this console
        again for testing, interactive-only from here on, single-
        stepped with real state checks between dangerous actions.

  Verify: python3 -m py_compile on both files. do_timing()/do_demand()
        checked against a mock link (set + query paths, local cache
        updates). Re-ran the exact real request end-to-end against real
        hardware and a real LLM twice -- once confirming `timing 1 2`
        now succeeds (root cause fixed), once (after the token-budget
        fix) confirming round 1 succeeds without a wasted retry --
        interactively-driven going forward per the note above, not
        piped. Post-incident hardware check: STATE? IDLE, FAULT? 0, all
        4 channels running=0/output at idle floor -- confirmed clean
        before ending the session.

2026-09-14  —  wham_llm_console.py: ~3x real-world speedup (Qwen3
               "/no_think" + Ollama keep-alive), root-caused on real
               hardware, not guessed
-----------------------------------------------------------------------
  Change:  Direct request ("our current llm setup is taking too long to
        respond -- what can we do to make it faster?"). Measured the
        actual bottleneck on real hardware (M2 Pro/16GB) rather than
        guessing: the exact health-check prompt from this file's
        2026-09-14 hardware-test entry took 112.3s wall time for ONE
        round trip -- and `usage` in the raw API response showed why:
        2815 of 2815 completion tokens were spent, almost all of it
        (11372 chars) in qwen3's own <think> reasoning, to decide on a
        trivial two-action health check. Prompt processing itself was
        fast (4018/4037 prompt tokens were cache hits) -- the system
        prompt's size was NOT the bottleneck here; the model's own
        "thinking" habit was.

        Tried Ollama's OWN native fix first -- /api/chat's "think":
        false parameter, the documented, "proper" way to disable
        Qwen3's reasoning. It did NOT work on this setup: this Ollama
        build serves qwen3 with --chat-template chatml --no-jinja (a
        generic template, not qwen3's own jinja template that "think"
        actually hooks into), so reasoning showed up INLINE in
        "content" regardless of the flag, which would have broken the
        JSON action contract. Fell back to Qwen3's own plain-text
        convention instead -- appending "/no_think" to the latest
        turn -- which doesn't depend on that template plumbing and
        measurably worked: the SAME prompt, same correct two actions,
        30.3s (~3.7x faster), reasoning chars 11372 -> 4698 (reduced,
        not eliminated -- this setup can't fully suppress it, only
        substantially shorten it).

        wham_llm_console.py: new LLMClient.suppress_thinking (default
        ON) + NO_THINK_SUFFIX constant; chat() appends it to a COPY of
        the outgoing messages' last turn, never mutating/persisting it
        into the stored conversation history (so the operator never
        sees literal "/no_think" in their own message log). New
        `/think [on|off]` local command (mirrors `/auto`'s pattern) to
        toggle it live -- default ON since speed was the direct
        request, but this is a real, not-fully-characterized
        reliability tradeoff (less reasoning could mean worse tool-
        selection on harder recipes -- see this file's own prior
        2026-09-14 entry on `report`'s tool-selection gap, itself
        found with full thinking enabled) -- flagged in both the
        module docstring and /help text, not silently traded away.
        Also added a "(working...)" progress print before every
        blocking LLM call -- even at 3.7x faster, a 10-30s silent wait
        reads as a hang otherwise.

        Second, independent factor found and fixed: Ollama's default
        keep-alive unloads an idle model from GPU memory after ~5
        minutes, so stepping away and coming back pays a full ~5GB
        model reload on top of normal per-turn latency. Tried passing
        "keep_alive" in the request body first (same "maybe it just
        works" hope as the context-length options field earlier this
        day) -- confirmed via `ollama ps`'s UNTIL column that it does
        NOT take effect through the OpenAI-compatible endpoint either,
        same class of limitation as that earlier finding. Fixed the
        same way as the context-length fix: `launchctl setenv
        OLLAMA_KEEP_ALIVE 30m`, killed and relaunched Ollama (same
        session-scoped caveat as OLLAMA_CONTEXT_LENGTH -- doesn't
        survive a logout/reboot). Confirmed via `ollama ps`: UNTIL
        jumped from ~5 minutes to ~29 minutes after one request.

        End-to-end result, same real health-check prompt, real
        hardware, both fixes combined: 97.8s -> 31.5s total wall time
        for the whole two-LLM-call turn (connect + model check
        included) -- roughly 3x faster in realistic use, not just the
        isolated 3.7x per-call number.

  Verify: python3 -m py_compile. Confirmed via `ollama ps` that both
        server-level fixes actually took effect (CONTEXT and UNTIL
        columns). Re-ran the exact health-check prompt end-to-end
        against real hardware with the finished code (not a curl
        probe) to get the final 31.5s number. Did NOT re-verify
        `report`'s tool-selection reliability (the gap found in this
        file's earlier 2026-09-14 entry) under /no_think -- flagged as
        an open question in the code/docs rather than silently assumed
        fine, since less reasoning is the more likely direction for
        that gap to worsen, not improve.

2026-09-14  —  `report` now does THREE-way shot performance analysis
               (output-vs-commanded, not just measured-vs-setpoint) --
               separates "did the output match what it should" from
               today's feedback-loopback wiring
-----------------------------------------------------------------------
  Change:  Direct request, and an important correction to the `report`
        tool added earlier today: "analyze the performance of the shot
        insofar as whether or not the frequency output matches what it
        should... the on-board controller measurement is a feedback
        measurement, not necessarily the output of the controller
        (although right now the feedback measurement is routed to the
        output of the controller)."

        Traced pid.c's own profile math (TrapezoidalCurrentA()/
        AmpsToHz(), PID_Update()) to confirm: PID:LOGDATA?'s
        setpoint_hz is computed FRESH every tick straight from ramp/
        flat-top/demand-current -- it never depends on any feedback
        measurement at all. That makes it the right ground truth for
        "what the output SHOULD be," independent of loop mode -- and it
        means comparing OUTPUT to it (not MEASURED to it) is what
        actually answers "did the controller drive what it should,"
        since output_hz is the literal value written to HRTIM
        (ClampOutputSlew(setpointHz, ...) in open loop; the PID's own
        computed correction in closed loop) while measured_hz is
        whatever the feedback-capture path reports -- today, on this
        bench, a loopback of the controller's OWN output, not an
        independent Transrex supply's real response. The earlier
        `report`'s single "tracking error" was measured-vs-setpoint,
        which -- exactly per the request's own caution -- risks reading
        as real hardware performance when today it mostly just
        validates the bench loopback wiring.

        compute_log_stats() now computes three separately-named, always-
        computed comparisons instead of one: output_error (output -
        setpoint, the headline "does the output match what it should"
        number), feedback_error (measured - setpoint, closed-loop
        convergence), and feedback_vs_output_error (measured - output,
        a bench-wiring self-check). format_channel_report_md()'s table
        gains a row for each, plus an explicit caveat paragraph
        explaining which number means what on THIS bench today.
        _print_report_summary_line() (the terminal/LLM-facing summary)
        now leads with output-vs-commanded RMS instead of the old
        single tracking-error number. New _error_stats(a, b) helper
        (mean/RMS/max|abs| of a-b) shared by all three so the
        computation itself only exists once.

        wham_llm_console.py's system prompt `report` catalog entry and
        module docstring rewritten to teach the LLM the same
        distinction explicitly -- lead with output-vs-commanded when
        asked whether output matches expected, name the loopback
        caveat before treating feedback-vs-* as real supply
        performance. Prompt grew to ~3700 tokens (was ~3500).

        Deliberately did NOT add a from-scratch independent
        reconstruction of the trapezoid profile in Python (i.e.
        re-deriving expected_hz(t) from ramp/flat/demand-current
        outside of trusting setpoint_hz) -- that would duplicate
        pid.c's own math in a second place this project has repeatedly
        flagged as a real drift risk elsewhere (every "MUST MATCH
        ctrlr_config.h" comment already in this file), without adding
        genuine independence (it's still just Python arithmetic mirror-
        ing firmware arithmetic). For output verification genuinely
        independent of firmware self-report, this project already has
        `~/dslogic-tool` (see python/dslogic_shot_capture.py) -- an
        external logic analyzer on the real output pin. `report`'s
        output-vs-commanded number is the right, well-scoped answer for
        day-to-day shot debugging; DSLogic is the escalation path when
        a genuinely independent check matters.

  Verify: python3 -m py_compile on both files. Re-ran the existing mock-
        serial-link test (no hardware needed) to confirm no regression
        in the single- and all-channel report paths, plus a NEW mock
        scenario with output deliberately lagging setpoint by a
        simulated 2-tick slew (output_error correctly nonzero/~280Hz
        RMS during the ramp) and small feedback noise layered on top of
        output (feedback_vs_output_error correctly small/~19Hz RMS,
        isolated from the larger output_error) -- confirms the three
        numbers actually disentangle as intended rather than collapsing
        into one indistinguishable "tracking error." Not yet run
        against real hardware.

2026-09-14  —  New `diag`/`report` console commands (debugging +
               shot-report tools for wham_console.py and the LLM
               console); ERROR_CODES table staleness fixed (13/14
               were missing)
-----------------------------------------------------------------------
  Change:  Direct request: give the LLM console (see the entry right
        below this one) tools "in particular for debugging", and
        specifically "a tool which generates run reports or shot
        reports". Added to wham_console.py -- the shared, maintained
        console both front ends drive -- rather than only the LLM
        console, so a human operator gets the same tools:

        `diag` -- one consolidated, read-only debugging snapshot:
        *IDN?, STATE?, FAULT?, GDS? (raw 12 gate-driver pins),
        QSPI:ID?, PFMIN:STATus? (PFM_Input capture counts), profile
        timing, and a table of every channel's config (enable/
        nickname/loop-mode/gains/demand) AND live PID:STATus? together.
        One action instead of stitching together a dozen queries by
        hand -- exactly the kind of thing worth having as a single
        tool for an LLM operating this console, but useful for a human
        operator too.

        `report [channel|all]` -- does everything `plot` already did
        (fetch PID:LOGDATA?, save CSV + metadata JSON + PNG under
        shots/) PLUS a written markdown diagnostic summary saved as
        shots/<ts>_ch<N>_report.md (or <ts>_allch_report.md): sample
        count/rate, setpoint/measured/output ranges in both Hz and
        nominal Amps, tracking-error mean/RMS/max|abs| (measured -
        setpoint), and any detected feedback glitches (reuses the
        existing _find_glitches() the plot itself already flags), plus
        STATE?/FAULT? queried fresh at report time so the report shows
        whether the run ended cleanly or in a fault. Deliberately does
        NOT invent a pass/fail verdict or a tracking-error threshold --
        this project has no established spec for either yet (same
        "nominal, not tuned values" caveat as everywhere else in this
        console) -- it reports the numbers and leaves judgment to the
        operator or the LLM. Only a short one-line-per-channel summary
        is printed to the terminal; the full detail lives only in the
        saved file, so an LLM front end's context isn't spent on it.
        New module-level compute_log_stats()/format_channel_report_md()
        plus a proper hz_delta_to_amps() (a signed, non-clamped
        Hz-per-Amp slope for a DIFFERENCE like tracking error --
        distinct from the existing hz_to_amps(), which clamps at the
        turn-on floor and would misleadingly show ~0.00A for nearly
        every real tracking-error value if reused here as-is).
        _fetch_save_plot_all() now returns its fetched data (channel_
        rows/metas/rate_hz/count) instead of nothing, so `report all`
        reuses the SAME PID:LOGDATA? fetch `plot all` already made
        rather than hitting the wire twice.

        wham_llm_console.py's system prompt updated to teach the LLM
        both new commands (CONSOLE COMMANDS catalog + two new RECIPES
        entries: reach for `diag` when actually debugging rather than
        hand-composing status/config/FAULT?/GDS?, and `report` after
        any run the operator wants summarized rather than re-deriving
        the same numbers from `plot`/PID:LOGDATA? by hand). Its own
        system prompt is now ~3500 tokens (was ~2500) -- the file's
        Ollama context-window tip bumped from OLLAMA_CONTEXT_LENGTH=8192
        to 16384 accordingly, since 8192 was already tight before this
        addition.

        Also fixed while in here: wham_console.py's own ERROR_CODES
        table (backing explain_err()'s ERR-reply decoration) was
        missing codes 13 ("bad state transition", added with the state
        machine) and 14 ("bad nickname", added with PID:CHANnel:
        NICKname) -- present in docs/command_reference.md and already
        referenced by wham_llm_console.py's system prompt, but never
        added to this table. commands.h's own doc-comment error-code
        list (separate from docs/command_reference.md, the wire
        protocol's actual canonical reference) had the same gap, fixed
        too.

  Verify: python3 -m py_compile on both files. do_diag()/do_report()
        exercised against a mock serial link (no real hardware needed
        for this pass) covering: single-channel and all-channel report
        generation, a synthetic injected glitch (confirmed detected at
        the right sample index), nickname display, and correct CSV/
        JSON/PNG/report.md file output. hz_delta_to_amps() checked
        against hz_to_amps() to confirm the clamp-to-zero problem is
        actually avoided for small deltas. Not yet run against real
        hardware or a real LLM server -- see the entry below for this
        file's overall verification status (side project).

2026-09-14  —  New wham_llm_console.py (LLM-fronted operator console,
               side project); closed a safety-gate bypass shared with
               wham_console.py's own raw-SCPI passthrough
-----------------------------------------------------------------------
  Change:  First commit of python/wham_llm_console.py -- an alternate,
        purely additive front end to wham_console.py where the operator
        talks in plain English to a small local LLM (Ollama/LM Studio,
        OpenAI-compatible /v1/chat/completions), which decides which
        wham_console.py command lines to run and reports results back in
        plain English. Drives a real WhamConsole instance UNMODIFIED --
        every command, the `shot` wizard, auto-plotting, and session
        logging behave exactly as in the human console; this file adds
        no new wire behavior. See its own module docstring for the full
        design (system prompt, JSON action contract, safety gate).

        Asked to review this file before its first commit, found and
        fixed one real gap in its own safety gate (the mechanism meant
        to stop the LLM from starting real PWM output or reflashing
        without an operator's y/N in the terminal first): the gate
        special-cased the `enable <ch> on` CONSOLE WRAPPER but fell back,
        for everything else including raw SCPI, to wham_console.py's own
        _is_dangerous() -- which only ever caught FIRE/BOOT/PID:*:STARt.
        Since the LLM's system prompt explicitly hands it raw
        PID:CHANnel:ENAble as an available command, and small local
        models are not consistent about which spelling they reach for,
        the LLM could turn a channel's output ON with zero confirmation
        just by phrasing it as raw SCPI instead of the `enable` wrapper
        -- a real gap, not theoretical: PID_SetChannelEnable() (pid.c)
        drives HRTIM1_SetChannelOutputEnable() directly and
        unconditionally, so this takes immediate real effect if a loop
        is already running.

        Fixed at the root rather than patched in the LLM console alone:
        wham_console.py's _is_dangerous() (the project's own established
        "single source of truth for dangerous commands" convention -- see
        its "Adding a new console command" note) now takes the FULL
        command line, not just the first token, and also matches
        PID:CHANnel:ENAble <ch> <nonzero> in any valid SCPI short/long
        form (turning OFF is never gated -- always the safe direction).
        This closes the gap for BOTH front ends at once, and for any
        future per-channel hardware-effecting command added the same
        way. do_enable()'s own bespoke _confirm() call is removed as
        part of this -- it would now double-prompt against the shared
        gate inside _query_print() -- so `enable <ch> on` in the human
        console goes through the exact same single gate as `start`
        already does, no behavior change for a human operator beyond
        one prompt instead of two.

        Also, while reviewing wham_llm_console.py specifically:
        (1) command results returned to the LLM (not the operator's own
        terminal, which always sees the full reply) are now capped at
        MAX_RESULT_CHARS -- raw PID:LOGDATA? can return up to 1000
        samples on one line, easily exhausting a small local model's
        whole context window in a single command result; `plot`/`log`
        print file paths, not data, and are unaffected.
        (2) strip_think() now handles an UNCLOSED <think> block (a
        reasoning model's reply cut off mid-thought by LLM_MAX_TOKENS)
        by dropping everything from the still-open tag onward, instead
        of leaving raw reasoning prose -- which may itself contain stray
        braces -- for extract_json() to go hunting through for a bogus
        match. LLM_MAX_TOKENS raised 1500 -> 3000 for the same reason
        (qwen3, the documented default, spends an unpredictable chunk of
        its budget on <think> before the actual JSON answer).

  Verify: python3 -m py_compile on both files; wc._is_dangerous() checked
        directly against FIRE/BOOT/PID:START/PID:PROFile:STARt (short and
        long form) and PID:CHANnel:ENAble with 0/1/malformed/unparseable
        args, all matching intent; Executor.is_dangerous() checked to
        confirm raw `PID:CHANnel:ENAble 1 1` and the `enable 1 on`
        wrapper now agree (both True), `... 1 0`/`enable 1 off` both
        False; strip_think()/extract_json() checked against a simulated
        truncated-<think> reply (yields no bogus match, not a crash);
        truncate_for_llm() checked short-text-unchanged and
        long-text-truncated-with-note. Not yet exercised against a real
        LLM server or real hardware (side project, lower priority than
        the main firmware work) -- do that before relying on it hands-off
        (`--auto`).

2026-09-13  —  New PID:CHANnel:NICKname command; DSLogic shot plot now
               8 panels (firmware + DSLogic side by side per channel)
               and shows nicknames
-----------------------------------------------------------------------
  Change:  Direct request: the ability to assign a purely cosmetic,
        human-readable nickname to each channel via SCPI (e.g. Ch1 =
        "TINKYWINKY", Ch2 = "LAALAA", Ch3 = "DIPSY", Ch4 = "NOONOO" --
        the example names from the request itself). New commands
        PID:CHANnel:NICKname <ch> <name> (set) and
        PID:CHANnel:NICKname? <ch> (query, "-" sentinel for "none set"
        -- see cmd_pid_channel_nickname_query()'s own comment on why an
        explicit sentinel beats an ambiguous empty second token). No
        effect whatsoever on control behavior -- purely a label.
        PID_CHANNEL_NICKNAME_MAX_LEN (15) chosen to comfortably fit the
        example names with headroom, not derived from any hardware
        constraint. Same persistence model as gains/demand current: set
        once, survives across shots in the session, cleared only by a
        reboot -- no flash/EEPROM persistence anywhere in this firmware.
        New PidChannelState_t.nickname field (pid.c), cleared in
        PID_Init(). New error code 14 (invalid nickname -- too long, has
        whitespace, or is the reserved "-" value).

        Second direct request, same conversation: after a shot, every
        logged/plotted channel should show its nickname (still ALONGSIDE
        the bare Ch<N> label, never replacing it -- Ch<N> is the real
        wire-protocol identity). wham_console.py's generate_plot()/
        generate_multi_channel_plot() titles now read e.g.
        "Ch1 (TINKYWINKY)" via a new shared channel_label() helper; a
        new do_nickname console command wraps the SCPI command
        (`nickname <ch> [name]` -- no name = query instead of set).
        _shot_meta() now fetches the channel's current nickname fresh
        from the device (same pattern as its existing *IDN? fetch, not
        cached client-side) on every plot.

        Third direct request, same conversation: the DSLogic cross-check
        plot changed from 4 combined panels (DSLogic + firmware overlaid
        on one axis per channel) to 8 panels -- one row per channel, two
        columns: firmware's own demand/measured feedback on the left,
        that channel's independently-captured DSLogic frequency on the
        right -- rather than overlaid, so each source's own shape stays
        legible on its own scale instead of competing for one axis.
        Row titles now include the nickname too, matching the console's
        own plots.

  Verified on real hardware:  PID:CHANnel:NICKname round-tripped
        correctly for all 4 channels with the exact example names, and
        rejected a too-long name, the reserved "-" value, an invalid
        channel, and a missing argument -- all without corrupting the
        channel's existing (valid) nickname. Ran a real shot (Ch1+Ch3
        active, Ch2+Ch4 disabled, same scenario as the earlier Ch2/Ch3
        wiring investigation) through the actual `shot` command with all
        four nicknames set -- the resulting 8-panel plot correctly
        showed "Ch1 (TINKYWINKY)" / "Ch2 (LAALAA)" / "Ch3 (DIPSY)" /
        "Ch4 (NOONOO)" as row titles, firmware and DSLogic data side by
        side. Build clean (zero warnings), flashed and confirmed via
        *IDN? before the SCPI round-trip tests above.

2026-09-13  —  DSLogic shot plot: corrected Ch/Phase wiring map (now
               all 4 channels), one panel per channel instead of 2
               combined panels (tooling only, no firmware change)
-----------------------------------------------------------------------
  Change:  Two direct requests, same conversation. First: the plot
        (previously 2 combined panels -- all channels' DSLogic data
        overlaid, all channels' firmware data overlaid) is now one
        panel per WHAM channel, each overlaying that channel's own
        DSLogic-decoded frequency with its own firmware PID:STATus?
        self-report. A disabled channel still gets a panel (labeled
        DISABLED), an enabled-but-idle (0A) channel is labeled as such,
        and if a wired channel shows literally zero switching activity
        its panel says so explicitly ("output confirmed low") instead
        of rendering an ambiguous empty plot -- this was the actual
        motivating case: confirming a disabled channel's HRTIM output
        really did stay silent for the whole shot, not just that its
        current demand was zero.

        Testing this (Ch1+Ch3 active, Ch2+Ch4 disabled) surfaced a real
        discrepancy: Ch2's and Ch3's DSLogic panels showed swapped
        activity relative to the assumed Phase V/Phase W <-> DSLogic
        Ch1/Ch2 wiring. Checked for a firmware bug first -- ruled out:
        cmd_pid_channel_enable() and cmd_pid_profile_current()
        (commands.c) convert the wire channel argument identically
        (ch = chArg - 1), so PID:CHANnel:ENAble and PID:PROFILE:CURRENT
        agree on what "channel 2"/"channel 3" mean internally. Flagged
        to the user rather than guessed at. Second direct request,
        same conversation: the corrected wiring map -- WHAM channel 4
        ("Phase X") also has DSLogic wiring (Ch3), which this tooling
        had wrongly assumed didn't exist at all (treated as always
        "no DSLogic wiring on this channel"). Whether the original
        Ch2/Ch3 swap was a physical lead mixup now fixed, or something
        else, hasn't been independently re-verified with another shot
        yet -- worth confirming next time a shot is taken with the
        DSLogic connected.

  Changed:  WHAM_TO_DSLOGIC_CHANNEL (python/dslogic_shot_capture.py) is
        now {1: 0, 2: 1, 3: 2, 4: 3} (was {1: 0, 2: 1, 3: 2}, channel 4
        excluded entirely). Doc comments (this module, wham_console.py's
        do_shot(), AGENTS.md) updated to match -- all four WHAM channels
        now have DSLogic wiring, not three.

2026-09-13  —  wham_console.py's `shot` now saves an optional DSLogic
               cross-check plot alongside the usual CSV/JSON/PNG
               (tooling only, no firmware change)
-----------------------------------------------------------------------
  Change:  Direct request: whenever a shot is taken (via `shot`), if a
        DreamSourceLab DSLogic logic analyzer is physically connected,
        automatically arm a capture across whatever active channels have
        real DSLogic wiring (Phase U/V/W <-> Ch0/Ch1/Ch2, per the user's
        own direct hardware setup -- see ~/dslogic-tool, a separate,
        already-validated tool built earlier this session), and once the
        shot completes, save a comparison plot (DSLogic-decoded
        frequency-vs-time next to the firmware's own PID:STATus? self-
        report) to shots/<timestamp>_dslogic.png -- the same style as
        that tool's own final_validation.png, now generated automatically
        for every real shot instead of by hand. If no DSLogic is
        connected (or none of the active channels have DSLogic wiring),
        this is a clean, silent no-op -- a shot behaves identically
        either way.

  New file:  python/dslogic_shot_capture.py -- imports dslogic_capture
        from ~/dslogic-tool (kept outside this repo deliberately; see
        that project's own README for why: it vendors ~10MB of
        DreamSourceLab GPL source unrelated to WHAM firmware). Every
        public function degrades to a no-op if that import fails, no
        DSLogic is enumerated over USB, or numpy/matplotlib aren't
        installed -- guarded the same way the existing HAVE_MPL check
        already guards matplotlib. wham_console.py's own import of this
        new module is likewise guarded (HAVE_DSLOGIC_MODULE) so a
        missing/broken sibling file can't take down the whole console.

  Where it hooks in:  do_shot() arms the DSLogic capture right after ARM
        succeeds and right before PID:PROFILE:START is sent (matching the
        arm-then-fire timing validated earlier this session), free-running
        (not triggered -- dslogic_capture.py's own trigger support is
        confirmed not to gate yet, a separate known issue). The existing
        per-tick PID:STATus? watch loop was extended to also poll every
        DSLogic-wired active channel (not just the one channel it already
        printed to the console) so the plot's ground-truth panel has real
        data without a second round of polling. A single ts (timestamp)
        is now computed once at shot-start and threaded through
        _save_and_plot()/_fetch_save_plot_all() (both gained an optional
        ts= parameter, backward compatible) so every artifact one shot
        produces -- CSV, JSON, the usual PNG(s), and now the DSLogic PNG
        -- shares one filename prefix.

  Verified on real hardware:  ran `shot` twice (channels 1/2/3 @ 3000A,
        1s ramp / 1s flat / 1s ramp, matching this session's earlier
        validation shots) through the actual console (scripted stdin,
        not just calling the plotting function directly) -- both runs
        completed cleanly and saved a DSLogic plot whose decoded
        frequency trapezoid matches the firmware's own self-reported
        setpoint/measured curves closely, same as the manually-driven
        validation earlier this session.

2026-09-13  —  Fixed a real race condition in SM_PollFaults() that could
               silently replace a General-Fault ramp-down with an abrupt
               cutoff (build verified; real-hardware verification PENDING
               -- board still disconnected)
-----------------------------------------------------------------------
  Change:  The previous entry (General Fault ramp-down, below) noted in
        passing that g_state (state_machine.c) is read/written from BOTH
        main.c's main loop and PID_Update() (HRTIM1_Master_IRQn, priority
        1, which can preempt the main loop at any instruction), and that
        a narrow window existed where the main loop could read g_state
        (not yet FAULT), get preempted by the ISR's own SM_PollFaults()
        call completing EnterFault() first (possibly starting a General-
        Fault ramp-down), and then resume and -- since its own check had
        already passed, before preemption -- call EnterFault() a second,
        redundant time. That second call would see g_stateBeforeFault ==
        SM_STATE_FAULT (not SM_STATE_FIRING, since the first legitimate
        call had already transitioned it) and take HandleGeneralFault()'s
        "else" branch, calling PID_Stop() immediately and silently
        replacing the just-started graceful ramp-down with an instant
        cutoff.

        That entry characterized this as "SAFETY-NEUTRAL... not a
        hazard," on the reasoning that the physical end state ("output
        off") was the same either way. Directly corrected: "This worst
        case is actually quite bad -- we need to guarantee smooth
        behavior in this fault case." Right call -- the whole point of
        specifying a linear ramp instead of an instant stop was to avoid
        inductive/mechanical stress on the magnet and supply; a race that
        silently substitutes the abrupt path for the graceful one IS the
        hazard the ramp-down was built to prevent, not a neutral outcome.
        Documenting a known safety-relevant race instead of fixing it was
        the wrong call, and it's fixed properly now, not just described.

  Fix:  SM_PollFaults() (state_machine.c) now wraps its entire read-
        check-transition sequence -- the "already FAULT?" check, both
        fault-source reads, and the EnterFault() call itself if triggered
        -- in __disable_irq()/__enable_irq(), this codebase's own already-
        established critical-section pattern (see boot_jump.c's VTOR/
        bootloader-jump sequence, and main.c). Whichever context (main
        loop or ISR) reaches SM_PollFaults() first now runs the entire
        function to completion before the other context's own call can
        even read g_state -- the double-entry race is now structurally
        impossible, not merely low-probability. EnterFault()'s own work
        (PFM_ForceStop(), the fault-type dispatch, PID_BeginFaultRamp-
        Down()) is all fast, non-blocking register/flag writes with no
        dependency on any interrupt firing to complete, so it's safe to
        run with IRQs globally disabled. Calling this from inside an ISR
        (the PID_Update() call site) is fine too -- __disable_irq() while
        already inside an ISR is idempotent for the brief window this
        takes, matching how boot_jump.c already calls it unconditionally
        without special-casing ISR vs. main context.

        state_machine.h's "NOTE TO REVISIT" comment on this race has been
        rewritten to describe the fix rather than the (now stale, and
        wrong) "safety-neutral, not fixed this round" characterization.

  Verify:  Build-verified clean (zero warnings). Real-hardware
        verification is still pending (board disconnected this session)
        -- see pending-hardware-calibration project memory. When the
        board is back: no new test procedure beyond the General Fault
        ramp-down's own verification already documented (previous entry,
        and docs/command_reference.md) -- this fix has no independent
        behavior to test on its own; it just guarantees the ramp-down
        path is the one that actually runs, every time, instead of
        occasionally losing a race to an immediate stop. A dedicated
        stress test (rapid-fire faults right at a Master tick boundary,
        if that's practical to induce) would be the closest thing to a
        direct check, but isn't required to consider this fixed -- the
        fix makes the race structurally impossible by inspection, not
        merely probabilistically rare.
-----------------------------------------------------------------------

2026-09-13  —  General Fault populated: open-loop linear ramp-down to
               0A on every actively-outputting channel, then disable
               (build verified; real-hardware verification PENDING --
               board still disconnected)
-----------------------------------------------------------------------
  Change:  Direct request: populate the General Fault handler (left as
        an empty stub in the previous entry). Exact behavior specified:
        on a General Fault while FIRING, every HRTIM channel actively
        outputting PFM -- no matter what frequency or point in the shot
        profile it's currently at -- immediately begins a ramp to 0A
        (whatever frequency that corresponds to), linearly, over a
        pre-defined period of seconds, OPEN LOOP (not via the feedback
        algorithm) down to the minimum output frequency. Once reached,
        disable the HRTIM output channels and wait in FAULT.

        REAL ARCHITECTURAL PROBLEM, worked out before writing the ramp
        itself: the existing fault-entry path (previous entry)
        unconditionally called PID_Stop() the instant a fault was
        detected -- which stops HRTIM's Master counter immediately,
        meaning PID_Update() (the only thing that could drive a
        multi-tick ramp) would never be called again. A "ramp over
        several seconds" needs the opposite: Master must keep running
        THROUGH the fault until the ramp actually finishes. Restructured
        accordingly:

          - pid.c: new per-channel faultRampStartHz/faultRampParticipating
            and shared g_faultRampActive/g_faultRampElapsedTicks/
            g_faultRampTotalTicks (same shared-clock pattern as the
            shot profile's own g_profile* globals -- every participating
            channel starts ramping at the same tick and ramps for the
            same fixed duration, only each channel's own START Hz
            differs).
          - New PID_BeginFaultRampDown() (pid.h/pid.c): called ONCE, by
            HandleGeneralFault(), the instant a General Fault hits
            while FIRING. Captures each currently-enabled channel's
            ACTUAL output Hz right now (st->lastOutputHz -- wherever it
            really was, not the profile's own idealized setpoint) as
            that channel's ramp start; deliberately does NOT call
            PID_Stop() -- g_running stays 1 so Master keeps ticking.
            If no channel was actually enabled/outputting (nothing for
            the fault to have interrupted), stops immediately instead.
          - New static ProcessFaultRampDown() (pid.c): called from
            PID_Update() once per tick for as long as g_faultRampActive
            -- linear interpolation from each participating channel's
            faultRampStartHz down to PFM_TURNON_FREQ_HZ using the same
            elapsed/total-ticks fraction convention as every other ramp
            in this file (PID_StartRamp(), TrapezoidalCurrentA()) --
            genuinely open-loop, no PfmInput/feedback consumption
            anywhere in this path at all. Still passes through the
            existing ClampOutputSlew() as defense-in-depth (never
            actually binds for any sane FAULT_RAMP_DOWN_TIME_S, given
            the ramp's own math already produces small per-tick steps).
            Once every participating channel's elapsed ticks reach the
            shared total, calls PID_Stop() -- which ALREADY
            unconditionally disconnects every channel's HRTIM output
            regardless of which were mid-ramp, so "disable the HRTIM
            output channels" (per direct instruction) needed no NEW
            per-channel disable call, just reusing the existing stop
            mechanism at the right moment.
          - pid.c's PID_Update() restructured: the fault check
            (SM_PollFaults()) no longer unconditionally returns once
            faulted -- it now calls ProcessFaultRampDown() first if a
            ramp is active, THEN returns. The g_running==0 check at the
            very top of the function is what actually stops further
            calls from doing anything, once PID_Stop() (called by
            ProcessFaultRampDown() at ramp completion, or by
            HandleGeneralFault() directly when there's nothing to ramp)
            has run.
          - state_machine.c: EnterFault() no longer unconditionally
            calls PID_Stop() for the current (PID:*) output path --
            that decision now belongs to each fault type's OWN handler
            (HandleGeneralFault()/HandleOvercurrentFault()), captured
            via a new g_stateBeforeFault (set right before the
            transition to SM_STATE_FAULT, since g_state itself is
            already SM_STATE_FAULT by the time either handler runs).
            PFM_ForceStop() (the legacy pfm.c output path, not part of
            this state machine at all) stays unconditional and
            immediate in EnterFault() itself -- unaffected by any of
            this, no ramp-down concept applies to it.
          - HandleGeneralFault() (state_machine.c) now genuinely
            populated: calls PID_BeginFaultRampDown() if the fault hit
            while FIRING, PID_Stop() immediately otherwise (IDLE/
            ARMED -- nothing to ramp).
          - HandleOvercurrentFault() STILL A STUB -- kept calling
            PID_Stop() immediately as a safe default (an "overcurrent
            protection fault" sounds like it should be MORE aggressive
            than General Fault's graceful ramp, not less, so defaulting
            to the fastest stop until its own real behavior is decided
            seemed like the safer placeholder).
          - SM_ClearFault() now also calls PID_Stop() unconditionally
            (a REAL bug caught during design, not yet hit on hardware:
            an operator sending FAULT:CLEAR while a General-Fault ramp
            was still mid-flight would have left g_running/
            g_faultRampActive stale at 1 even after the state machine
            itself correctly returned to IDLE -- the exact same failure
            shape as the 2026-09-11 GateDriverStatus bug, just via a
            different path. HRTIM1_FaultClear()/GateDriver_FaultClear()
            already force-stop HRTIM physically regardless, so the fix
            is purely about keeping pid.c's own bookkeeping honest).

        New FAULT_RAMP_DOWN_TIME_S (ctrlr_config.h, currently 1.0
        second) -- "a pre-defined period of seconds chosen for the
        ramp," per direct instruction. PLACEHOLDER, explicitly flagged:
        not derived from any real Transrex/magnet requirement (how fast
        can this hardware actually tolerate ramping down?) -- same
        "revisit once real hardware characterization exists" status as
        every other placeholder constant in this file.

        A REAL BUG caught and fixed BEFORE it could ship, during
        implementation, not found on hardware: an early draft of a
        comment in state_machine.c contained the literal substring
        `TABLE:*/FIRE` -- the exact same "*/ inside a comment
        prematurely closes the enclosing /* */ block" bug this project
        already hit once before (hrtim.c/hrtim.h, earlier session, see
        this file's own history) and specifically checks for in review
        since. Caught by grepping for the pattern before building, not
        by the compiler failing -- fixed to `TABLE:STEP/FIRE` before it
        ever reached a build.

        A narrow, IDENTIFIED-NOT-FIXED race condition, documented in
        state_machine.h's own "NOTE TO REVISIT": g_state is a plain,
        unguarded global read/written from both main.c's main loop and
        PID_Update() (HRTIM1_Master_IRQn, priority 1, can preempt the
        main loop at any instruction). A narrow timing window exists
        where both call sites could observe "not yet FAULT" before
        either transitions, and the main loop could end up calling
        EnterFault() a second, redundant time immediately after the ISR
        already completed it -- which would abort a just-started
        ramp-down with an immediate PID_Stop() instead. SAFETY-NEUTRAL
        if it ever actually happens (the physical outcome is still
        "output off," just via the immediate path instead of the
        graceful ramp in that one narrow window) -- not fixed this
        round, flagged for a real look (a critical section around
        SM_PollFaults()'s read-check-transition) if this state
        machine's timing guarantees ever need to be more rigorous than
        "safe in the worst case."

        Build verified: clean rebuild via wham_build.py, zero warnings.
        REAL-HARDWARE VERIFICATION NOT YET DONE -- board's USB-serial
        adapter is STILL disconnected as of this entry (the sixth
        change in a row made without hardware access). Once
        reconnected, this entry specifically needs: ARM + PID:PROFILE:
        START a real shot, trigger a GateDriverStatus fault mid-shot
        (the only real-hardware-triggerable fault source currently
        wired up), and confirm on a scope/DSLogic that the affected
        channel's actual output frequency genuinely ramps linearly to
        the PFM_TURNON_FREQ_HZ floor over approximately
        FAULT_RAMP_DOWN_TIME_S seconds -- not an instant cutoff, not a
        hold -- before the output disconnects. Also confirm PID:STATus?
        tracks the ramp in real time, and that a channel NOT enabled at
        fault time is left untouched throughout.

2026-09-13  —  Top-level operating-state machine: IDLE/ARMED/FIRING/
               FAULT, new state_machine.c/h module, ARM/DISARM/STATE?
               commands, two fault-type handlers stubbed (*** NEEDS
               REVISIT -- see below ***) (build verified; real-
               hardware verification PENDING -- board still
               disconnected)
-----------------------------------------------------------------------
  Change:  Direct request: start building an explicit state machine
        for this controller, sitting above pid.c/hrtim.c/gate_driver.c/
        pfm.c as the thing that ties them into one coherent "what is
        this controller doing right now" answer. Design settled via a
        short clarifying exchange before writing any code (the user's
        own answers, verbatim reasoning below):

          - Fault-type routing (General vs. Overcurrent Protection):
            explicitly left UNDECIDED, per direct instruction -- "stub
            only, route later." Both stub handlers exist; which real
            condition should ever call which is NOT decided.
          - How FIRING is entered: reuse PID:PROFile:STARt (already
            does "start the ramp profile for every enabled channel"),
            not a new command.
          - Module location: a new, dedicated state_machine.c/h,
            calling into pid.c/hrtim.c/gate_driver.c/pfm.c rather than
            being folded into any one of them.
          - A THIRD state, ARMED, added per direct suggestion during
            the same exchange -- between IDLE and FIRING, entered via a
            NEW `ARM` command, gated by conditions "we will populate
            later." PID:PROFile:STARt ("a FIRE command") now only
            works from ARMED.

        NEW MODULE, Core/Inc/state_machine.h + Core/Src/state_machine.c
        (added to Debug/Core/Src/subdir.mk + Debug/objects.list by
        hand -- this project's own established CubeIDE-Makefile
        gotcha, see AGENTS.md):

          SM_State_t: SM_STATE_IDLE / SM_STATE_ARMED / SM_STATE_FIRING /
          SM_STATE_FAULT. SM_FaultType_t: SM_FAULT_NONE / SM_FAULT_GENERAL /
          SM_FAULT_OVERCURRENT.

          - IDLE -- boot (SM_Init()), after a shot completes
            (SM_NotifyShotComplete(), called from pid.c's PID_Update()
            at the exact point a profile naturally finishes -- FIRING
            -> IDLE), or after FAULT:CLEAR (SM_ClearFault(), only if
            the underlying condition is actually gone). Every HRTIM
            channel output disabled.
          - ARMED -- SM_Arm() (`ARM`, IDLE -> ARMED only), gated by
            ArmConditionsMet() -- a STUB, always returns 1 today, no
            real interlock logic exists yet (see "NEEDS REVISIT"
            below). Outputs stay disabled here, identically to IDLE --
            nothing electrical changes on entry, ARMED is purely a
            software readiness gate. Left via SM_Fire()
            (PID:PROFile:STARt -> FIRING, only from here), SM_Disarm()
            (`DISARM`, stand down -> IDLE), or SM_Stop() (PID:STOP,
            abort -> IDLE).
          - FIRING -- SM_Fire() calls PID_ProfileStart() (pid.c,
            unchanged) internally, only transitions to FIRING if that
            actually succeeds (stays ARMED otherwise -- e.g. profile
            timing never set). Returns to IDLE automatically at shot
            completion, or on a manual PID:STOP abort.
          - FAULT -- entered from ANY state the instant EITHER existing
            fault source trips (SM_PollFaults(), checks
            HRTIM1_FaultIsTripped() and GateDriver_FaultIsLatched(),
            the same two sources PID_Update() already checked before
            this change -- see the 2026-09-11 GateDriverStatus-fix
            entry). Calls BOTH PID_Stop() AND PFM_ForceStop() on entry
            (belt and suspenders -- covers both this project's current
            PID:* output path and the legacy pfm.c TABLE:*/FIRE path,
            regardless of which was actually active; both are already
            idempotent/safe to call when nothing was running), then
            dispatches to HandleGeneralFault() or
            HandleOvercurrentFault() (state_machine.c) based on
            g_faultType. *** BOTH HANDLERS ARE EMPTY STUBS ***, per
            direct instruction -- populate later. Left only via
            SM_ClearFault() (FAULT:CLEAR, extended), always back to
            IDLE, never directly to ARMED/FIRING.

        FAULT DETECTION "NO MATTER WHICH STATE" -- a real design
        question the fault-mapping/module-location answers didn't
        settle by themselves, worked out during implementation: pid.c's
        PID_Update() (where the existing fault check lived) is only
        ever CALLED while the HRTIM Master counter is running, which
        under this new model only happens during FIRING -- so a fault
        occurring while IDLE or ARMED would never have been noticed by
        that check alone, directly contradicting "at any point, no
        matter which state." Fixed by calling SM_PollFaults() from TWO
        places: pid.c's PID_Update() (unchanged rate, now routed
        through the state machine instead of calling PID_Stop()
        directly -- see below) for FIRING, AND main.c's main loop,
        every iteration, unconditionally, for IDLE/ARMED. *** NOTE TO
        REVISIT ***: the main-loop polling rate is whatever the loop's
        own cadence happens to be (currently just next to
        uart_process()) -- not a bounded, guaranteed interval. Not a
        regression (both underlying sources already protect themselves
        independently of this -- PC10 in silicon, GateDriverStatus via
        its own EXTI edge, regardless of when this next runs), but
        worth a harder look (a dedicated periodic timer?) if tighter
        latency is ever needed.

        pid.c's own fault-check block (the one fixed 2026-09-11) is now
        a call to SM_PollFaults() + a SM_GetState() check, instead of
        directly calling HRTIM1_FaultIsTripped()/GateDriver_FaultIsLatched()/
        PID_Stop() itself -- consolidates fault-handling into ONE place
        (state_machine.c) instead of it being spread across pid.c and
        gate_driver.c. pid.c no longer includes gate_driver.h directly
        (nothing left in that file using it).

        NEW COMMANDS (commands.c/commands.h/cmd_parser.c): `ARM`,
        `DISARM`, `STATE?` -- bare, top-level, matching this project's
        existing bare `FIRE` (system-wide state, not one subsystem's
        namespace). New error code 13: an invalid state-machine
        transition for the current state. PID:PROFile:STARt now checks
        SM_GetState()==ARMED first (ERR 13 if not) before calling
        SM_Fire(). PID:STOP now also calls SM_Stop() (abort, ->IDLE,
        never touches FAULT). FAULT:CLEAR now also calls SM_ClearFault().

        wham_console.py updated to match: the `shot` wizard now sends
        `ARM` immediately before `PID:PROFILE:START` (without this
        fix, every existing `shot` run would have started failing with
        ERR 13 the moment this firmware change landed); `status`/
        `monitor` now show `STATE?` at the top. The module's own
        "Adding a new console command" naming-safety list updated to
        include `arm`/`disarm`/`state` -- these are bare, single-level
        commands with no `*`-prefix exception the way `*IDN?` has, so
        the same collision rule applies to them as literally as to
        `fire`/`pid`.

        *** THINGS ADDED BEYOND THE LITERAL REQUEST, FLAGGED FOR
        REVIEW, NOT SILENTLY ASSUMED WANTED ***:
          - `DISARM` itself -- the user's description covered ARM and
            FIRE explicitly but not a way to stand down from ARMED
            without either firing or faulting; added as ARM's obvious
            companion (a real usability/safety gap without it), but
            flagging it since it wasn't explicitly requested.
          - `HandleGeneralFault()`/`HandleOvercurrentFault()` being
            called from state_machine.c's EnterFault() with BOTH
            PID_Stop() AND PFM_ForceStop() (not just one) -- a
            deliberate "belt and suspenders" choice given this codebase
            still has two coexisting output paths, not something the
            user specified explicitly.

        *** KNOWN GAP, NOT FIXED THIS ROUND ***: PID:START (the
        simpler, non-profile closed-loop start) is NOT gated by this
        state machine at all -- it can start real output regardless of
        STATE?'s value, and never moves the state machine out of IDLE/
        ARMED. Only PID:PROFile:STARt was wired up as "fire," per
        direct instruction to reuse that specific command -- this
        inconsistency is real and worth resolving later, not an
        oversight to silently paper over.

        *** REMINDER, PER DIRECT INSTRUCTION: this state machine is
        explicitly a first pass -- revisit once the work described in
        this entry is complete. Open items, all flagged above and
        collected here for one place to check: (1) fault-type routing
        (General vs. Overcurrent) is completely undecided; (2) both
        fault handlers are empty; (3) ArmConditionsMet() is a stub,
        always allows arming; (4) main-loop fault-poll cadence is
        unbounded; (5) PID:START bypasses the state machine entirely.
        ***

        Build verified: clean rebuild via wham_build.py (all source
        files, since a new one was added), zero warnings. REAL-
        HARDWARE VERIFICATION NOT YET DONE -- board's USB-serial
        adapter is STILL disconnected as of this entry (the fifth
        change in a row made without hardware access -- see the four
        entries above, all still also pending). Once reconnected, work
        through all five pending verification items in order (per-
        channel current calibration, GateDriverStatus fault fix,
        PID:CHANnel:ENAble, FW_GIT_COMMIT, then this entry's own new
        ARM/DISARM/STATE?/PID:PROFile:STARt-gating/fault-detection
        behavior) before assuming any is solid.

2026-09-11  —  *IDN? now reports the exact git commit a firmware build
               was made from (FW_GIT_COMMIT); new wham_build.py closes
               the stale-.bin gotcha as a side effect (build verified;
               real-hardware verification PENDING -- board still
               disconnected)
-----------------------------------------------------------------------
  Change:  Direct request: a way to track which git commit is actually
        flashed on the controller, verifiable via `*IDN?`. Standard
        embedded-firmware technique -- bake the commit hash into a
        generated header, included by the identity command:

          - New `python/gen_git_version.py`: runs `git rev-parse
            --short=8 HEAD` (+ `git status --porcelain` for a dirty-
            tree check) and writes `Core/Inc/git_version.h`
            (`FW_GIT_COMMIT "<hash>"`, `FW_GIT_DIRTY 0|1`). Never fails
            the build over a git problem -- no git repo, no git on
            PATH, no commits yet all fall back to a valid
            `FW_GIT_COMMIT "unknown"` header rather than blocking
            compilation. Deliberately NOT tracked in git (`.gitignore`)
            -- its whole job is capturing "what commit was THIS build
            from," which is redundant with git's own history for a
            clean build (a fresh clone always regenerates it correctly
            for HEAD) and would create spurious diffs on every single
            commit if tracked; the one case that isn't reconstructable
            from git alone -- a build made with uncommitted changes --
            isn't lost either, since it gets baked into the `.elf`/
            `.bin` themselves, which this project deliberately DOES
            track in `Debug/`.
          - `cmd_idn()` (commands.c) now reports a 4th space-separated
            field: `FW_GIT_COMMIT`, with a `-dirty` suffix from
            `FW_GIT_DIRTY` when the working tree had uncommitted
            changes at build time -- flagged explicitly rather than
            silently reporting a hash that doesn't fully describe what
            was actually compiled. `commands.c` now `#include`s the
            new `git_version.h`.

        Also new `python/wham_build.py` -- the canonical way to build
        this project from here on: `gen_git_version.py` -> `make -j4
        all` -> the `.bin` regeneration, as ONE command. This directly
        closes a real, previously-documented gotcha (2026-09-10 entry,
        above): this project's `.cproject` has no "Convert to binary"
        post-build step, so a bare `make` never touches the `.bin` at
        all -- flashing a stale one "succeeds," verified even, while
        silently not containing the latest changes. Three manual steps
        to remember (in the right order, every time) is exactly the
        kind of gap that already bit this project once; one command
        removes the gap rather than just re-documenting it more loudly.
        `docs/command_reference.md`'s `*IDN?` section and `AGENTS.md`'s
        "Build & verify" section both updated to point at it as the
        default; also fixed two unrelated stale references found while
        in that section (`Core/Inc/version.h`, which no longer exists
        -- see the 2026-09-08/09 condensing into `ctrlr_config.h` -- and
        a leftover `Debug/WHAM-PFMG474-V4.elf` filename from the
        sibling project this was reseeded from).

        Build verified: clean rebuild via `wham_build.py`, zero
        warnings, `git_version.h` correctly generated (confirmed
        `74994292-dirty` while this round's own changes were
        uncommitted). REAL-HARDWARE VERIFICATION NOT YET DONE -- the
        board's USB-serial adapter is STILL disconnected as of this
        entry (the fourth change in a row made without hardware
        access -- see the three entries above, all still also
        pending). Once reconnected: build with `wham_build.py` fresh
        against whatever commit this repo is on by then, flash, and
        confirm `*IDN?`'s 4th field matches `git rev-parse --short=8
        HEAD` exactly (no `-dirty` suffix, assuming a clean tree at
        build time) -- then work through the other three pending
        verifications in order.

2026-09-11  —  Per-channel output enable/disable (PID:CHANnel:ENAble)
               -- a genuine "no PFM waveform at all" switch; console
               updated to match (build verified; real-hardware
               verification PENDING -- board still disconnected)
-----------------------------------------------------------------------
  Change:  Direct request: a specific command to enable/disable each of
        the 4 output channels, where disabled means the channel's
        HRTIM output is genuinely never triggered -- distinct from
        every existing per-channel switch. `PID:LOOPMODE`'s open-loop
        mode still drives a real, uncorrected PFM waveform; a 0A
        `PID:PROFile:CURRent` still drives a real PFM waveform (at
        `PFM_TURNON_FREQ_HZ`, representing 0A, not "off"). Neither was
        what was asked for.

        New `HRTIM1_SetChannelOutputEnable(channel, enable)` (hrtim.c/h)
        connects or disconnects ONE channel's output pins LIVE, at any
        time -- reuses the exact mechanism `HRTIM1_PWM_Start()`'s
        existing `channelEnabled[]` parameter already established
        (disconnecting via `OENR`, forcing the same complementary
        output-1-ACTIVE/output-2-INACTIVE level `HRTIM1_PWM_Start()`
        already does at cold start when re-enabling) -- no new HRTIM
        mechanism invented, just made callable for one channel,
        independently, outside the one-shot bring-up call.
        Deliberately does NOT stop the channel's own counter either
        way (same reasoning `HRTIM1_PWM_Start()`'s own disabled-channel
        path already documented: keeps it synchronized so a later
        re-enable is instant and clean, no re-sync dance needed).

        New `outputEnabled` per-channel state (pid.c, defaults to 1 --
        every channel always output, today's only prior behavior,
        unchanged unless explicitly disabled) and
        `PID_SetChannelEnable()`/`PID_GetChannelEnable()` (pid.h/pid.c).
        Setting it: updates the stored state (picked up by the NEXT
        `PID_Start()`/`PID_ProfileStart()` via `channelEnabled[]`, now
        built from real per-channel state instead of hardcoded all-1s)
        AND, if the loop is already running, applies it immediately via
        `HRTIM1_SetChannelOutputEnable()` -- live, mid-shot control, not
        only pre-configuration. `PID_Update()`'s own per-channel loop
        now skips a disabled channel completely at the top (no
        setpoint, no feedback consumption, no PID math, no log entry --
        same "continue" pattern as the other per-channel early-outs).

        New commands `PID:CHANnel:ENAble <ch> <0|1>` / `PID:CHANnel:ENAble?
        <ch>` (commands.c/commands.h/cmd_parser.c), following the exact
        same pattern as every other set/query pair added this project
        (PID:LOOPMODE, PID:GAINS, ...).

        wham_console.py updated to match: new `enable <ch> <on|off>`
        wrapper (asks to confirm only when turning ON -- the direction
        that starts real new output, disabling never asks, always the
        safe direction); `_refresh_config()`/`config` now also reads
        `PID:CHANnel:ENAble?` per channel; the `shot` wizard now asks
        "Ch{N} enabled? yes/no" FIRST for each channel, skipping every
        other prompt for a disabled one, and sends
        `PID:CHANnel:ENAble` explicitly for every channel every run
        (matching this project's "explicit, no implicit magic"
        convention -- same reasoning as `TABLE:BEGIN` before every
        upload -- so a channel enabled in a previous session doesn't
        silently stay enabled just because a later wizard run didn't
        mention it).

        Build verified: clean rebuild, zero warnings. REAL-HARDWARE
        VERIFICATION NOT YET DONE -- board's USB-serial adapter is
        STILL disconnected as of this entry (the third change in a row
        made without hardware access -- see the two entries above).
        Once reconnected, verify ALL THREE pending changes before
        assuming any is solid: (1) per-channel
        `PFM_MAX_CURRENT_A_PER_CHANNEL` clamping, (2) the
        GateDriverStatus fault-recovery fix, (3) this entry --
        specifically confirm `PID:CHANnel:ENAble 2 0` while a shot is
        running actually stops channel 2's physical output immediately
        (scope/DSLogic it if possible, not just PID:STATus?), and that
        `PID:CHANnel:ENAble 2 1` afterward resumes it cleanly from
        wherever its PID state had gotten to, not from a reset.

2026-09-11  —  REAL BUG FIXED: GateDriverStatus fault during closed-
               loop PID operation left an operator with no way to
               resume without a reboot (build verified; real-hardware
               verification PENDING -- board still disconnected)
-----------------------------------------------------------------------
  Change:  Found while explaining this project's fault-handling
        architecture to the user, then fixed on direct request. Two
        independent fault sources exist: PC10/HRTIM1_FLT6 (real
        hardware fault input, autonomous in silicon) and
        GateDriverStatus_01..12 (software/EXTI-driven, gate_driver.c).
        PID_Update() already polled HRTIM1_FaultIsTripped() every tick
        and correctly called PID_Stop() when tripped -- but never
        checked GateDriver_FaultIsLatched() at all. GateDriver_
        CheckFault()'s PFM_ForceStop() (pfm.c) predates the PID
        architecture (2026-09-09) and was never integrated with it: it
        stops HRTIM output directly (including the Master counter, so
        PID_Update() genuinely stops being invoked), but with nothing
        checking the GateDriverStatus latch inside PID_Update() itself,
        g_running was NEVER cleared by this fault source.

        CONFIRMED impact, not just theoretical: PID_IsRunning()/
        PID:STATus? kept reporting running=1 after a GateDriverStatus
        fault, even with hardware output already genuinely stopped.
        Far more serious: PID_Start()'s own idempotency check
        (`if (g_running != 0U) return 1U;`) then silently turned every
        subsequent PID:START into a no-op -- no reconnect, no
        restarted feedback capture, nothing, and no error reported
        either (a plain "OK" comes back, indistinguishable from a
        real, successful start). FAULT:CLEAR didn't help -- it only
        ever cleared the two hardware/EXTI latches
        (HRTIM1_FaultClear()/GateDriver_FaultClear()), never touched
        g_running. Net effect: an operator had NO way to resume
        closed-loop operation after a GateDriverStatus fault short of
        a full reboot -- silently, with no error message pointing at
        why PID:START "succeeded" but nothing actually happened.

        Fixed with the minimal, already-proven mechanism -- extended
        PID_Update()'s existing fault check
        (`if (HRTIM1_FaultIsTripped() ...)`) to also check
        `GateDriver_FaultIsLatched()`, calling the same real
        PID_Stop() either way. No new recovery path designed or
        needed: this is the exact same bookkeeping (stop the Master
        counter so the ISR doesn't spin forever under already-safed
        outputs, clear g_running so IsRunning()/a later PID_Start()
        both see truthful state) the PC10 path already did correctly
        -- the GateDriverStatus source was just never plugged into it.
        pid.c now includes gate_driver.h.

        Build verified: clean rebuild, zero warnings. REAL-HARDWARE
        VERIFICATION NOT YET DONE -- board's USB-serial adapter is
        still disconnected as of this entry (see the previous entry);
        the board is still running firmware WITHOUT this fix. Once
        reconnected: reflash, then verify directly -- trip a
        GateDriverStatus fault while PID:START is active (or during a
        PID:PROFILE:START shot), confirm PID:STATus? correctly reports
        running=0 immediately, and confirm a subsequent PID:START
        (after FAULT:CLEAR) genuinely reconnects output rather than
        silently no-opping. Also worth re-confirming the PC10 path
        still behaves identically (this change only added a second
        condition to an existing check, but re-verify given how
        serious this exact failure mode turned out to be).

2026-09-11  —  Per-channel Transrex full-range current --
               *** MUST BE CALIBRATED BEFORE FINAL DEPLOYMENT ***
               (build/link verified; real-hardware verification
               PENDING -- board disconnected this session)
-----------------------------------------------------------------------
  Change:  Direct correction: "100kHz corresponds to 5kA" was always
        stated as an approximation, and the 4 physical Transrex
        supplies this controller drives may each have a genuinely
        different full-range output current -- there was no reason to
        assume all four are identical, and nothing has measured any of
        them yet. `PFM_MAX_CURRENT_A` (a single float, ctrlr_config.h)
        replaced with `PFM_MAX_CURRENT_A_PER_CHANNEL` -- a
        HRTIM_NUM_CHANNELS-entry array (ch1..ch4, 0-based internally
        like every other per-channel state in this codebase). Every
        entry is CURRENTLY the same 5000.0f placeholder -- unchanged
        numerically from before, but now explicitly a PER-CHANNEL
        placeholder rather than a single shared one, and flagged with
        a *** MUST BE CALIBRATED BEFORE FINAL DEPLOYMENT *** banner
        comment (ctrlr_config.h) giving the actual required procedure:
        drive each Transrex independently (open-loop is simplest -- a
        known, repeatable commanded frequency) at PFM_MAX_FREQ_HZ and
        measure that supply's REAL output current with real
        instrumentation (a calibrated sensor/shunt on that specific
        supply -- NOT inferred from this controller's own PFM_Input
        feedback, which measures the PFM signal, not load current, and
        cannot validate this mapping on its own).

        PFM_TURNON_FREQ_HZ/PFM_MAX_FREQ_HZ stay single, shared values
        -- nothing so far indicates the turn-on threshold or the top
        of the PFM frequency range themselves differ per Transrex,
        only the CURRENT the top of that range actually produces.
        Revisit if bench testing ever shows otherwise.

        pid.c: new `g_pfmMaxCurrentA[HRTIM_NUM_CHANNELS]` (initialized
        from the macro), with a `_Static_assert` confirming the
        initializer list's entry count actually matches
        HRTIM_NUM_CHANNELS at compile time (so a future edit to either
        one, done inconsistently, fails the BUILD rather than silently
        indexing past the array or leaving a channel's ceiling at 0).
        AmpsToHz() and PID_SetProfileCurrent() (both pid.c) now take
        the channel into account, clamping/converting against THAT
        channel's own entry instead of one value shared by all four --
        meaningful now that entries can genuinely differ once real
        calibration data replaces the placeholder (e.g. a channel with
        a lower real full-range current will correctly refuse a demand
        beyond its own ceiling, something the old shared-constant code
        could never express).

        wham_console.py NOT yet updated to match (still uses a single
        module-level PFM_MAX_CURRENT_A constant for its Amps-axis
        plotting) -- flagged as a follow-up, not done this round; the
        Hz-axis data itself (driven entirely by on-wire values) is
        unaffected, only the console's own plotted Amps conversion
        would need the same per-channel treatment once real per-
        channel values exist to plug in.

        Build verified: clean rebuild, zero warnings, _Static_assert
        passes. REAL-HARDWARE VERIFICATION NOT YET DONE THIS ROUND --
        the board's USB-serial adapter disconnected mid-session
        (/dev/cu.usbserial* stopped enumerating entirely) before
        reflashing could happen; the previously-flashed firmware
        (without this change) is still what's actually running on the
        board as of this entry. Reflash and verify (PID:PROFILE:CURRENT
        clamping, a real shot) once reconnected -- do not assume this
        change is live on hardware from this entry alone.

2026-09-10  —  Simultaneous all-channel waveform logging
               (PID_ArmLogAll()); wham_console.py generates one
               combined plot across every channel from a single shot
-----------------------------------------------------------------------
  Change:  Direct request: "make sure we generate one plot showing the
        shot data from all 4 channels." The waveform log
        (PID_ArmLog()/PID:LOG, 2026-09-10) only ever recorded ONE
        channel at a time -- getting all 4 channels' data meant either
        4 separate runs of the same shot (real feedback noise means no
        two runs are bit-for-bit identical, so not a genuinely
        simultaneous comparison) or a firmware change. Did the latter:

          - g_logSetpoint/g_logMeasured/g_logOutput (pid.c) changed
            from flat [PID_LOG_MAX_SAMPLES] arrays to
            [HRTIM_NUM_CHANNELS][PID_LOG_MAX_SAMPLES] -- a row per
            channel. RAM cost: 48000 bytes total at today's 4
            channels/1000 samples, up from 12000 -- a real, deliberate
            trade-off (bss went from 59.6% to 86.7% of this MCU's 128
            KiB -- confirmed it still links; see docs/memory_report.html
            for current headroom, worth watching before adding much
            more RAM-hungry state).
          - New PID_ArmLogAll(maxSamples, decim) (pid.h/pid.c) arms
            EVERY channel at once, sharing ONE decimation counter/
            sample index -- REAL restructure needed in PID_Update():
            the decimation decision used to happen INSIDE the
            per-channel loop (once per channel that matched
            g_logChannel), which would have advanced the counter 4x
            per real tick under all-channels mode, corrupting the
            timebase exactly the way the previous PID_ArmLog() timebase
            bug did. Moved to a single logThisTick decision computed
            ONCE per PID_Update() call, before the per-channel loop,
            then applied identically to every armed channel inside it
            -- every channel's sample `i` now genuinely comes from the
            same real Master tick.
          - PID:LOG's `<ch>` argument: `0` now means "arm every
            channel" (real channels are 1..N everywhere else in this
            project, leaving 0 a natural unused sentinel rather than a
            whole new command). PID:LOGDATA? gained an OPTIONAL channel
            argument -- omitted, it's UNCHANGED, original behavior
            (valid only when a single channel is armed); given, it
            works in either mode (any channel under all-channels mode,
            or the one actually-armed channel under single-channel
            mode -- ERR 12 for a mismatch in either failure case).
          - python/wham_console.py: `log`'s channel argument now
            accepts `all`; the `shot` wizard's log-target prompt offers
            `all` alongside a channel number or `none`. New
            generate_multi_channel_plot() -- one PNG, one row of
            subplots per channel (shared time axis, each channel's own
            setpoint/output/measured), phase-shaded with the one shared
            ramp/flat-top/ramp-down timing. `plot all` replots an
            already-armed all-channels log without a new shot. Saves
            one combined wide-format CSV (t_s plus 3 columns per
            channel) + one metadata JSON alongside the PNG, same
            shots/ convention as the single-channel path.

        Verified on real hardware: a real 4-channel shot (1.0s ramp /
        1.0s flat-top / 1.0s ramp-down; ch1 3000A closed-loop with real
        fiber feedback, ch2/3/4 1500A/4000A/800A open-loop with no
        feedback wired) produced one PNG with all 4 channels correctly
        shown on the same time axis -- ch1's closed-loop tracking (with
        its own already-documented occasional feedback glitches,
        unaffected by this change) alongside ch2/3/4's open-loop output
        exactly matching their own demand-current trapezoids (AmpsToHz-
        converted peaks: 1500A->~33.7kHz, 4000A->~81kHz, 800A->~20.2kHz,
        all correct). Also verified the protocol edge cases directly:
        `PID:LOGDATA?` with no argument still works exactly as before
        when a single channel is armed; correctly ERRs when all-
        channels mode is armed and no channel is given; `PID:LOGDATA?
        <ch>` correctly ERRs for a channel that isn't the one actually
        armed in single-channel mode.

2026-09-10  —  PID:GAINS?/LOOPMODE?/PROFile:TIMing?/PROFile:CURRent?
               query commands; a real newlib-nano printf-float bug
               found and fixed getting them working; wham_console.py
               now does a live device readback instead of guessing
-----------------------------------------------------------------------
  Change:  Direct response to a gap flagged while building
        wham_console.py (previous entry): PID:GAINS/PID:LOOPMODE/
        PID:PROFILE:TIMING/PID:PROFILE:CURRENT were write-only over
        the wire, forcing any host tool to remember what it itself
        last sent rather than being able to ask the device -- exactly
        the kind of thing that goes stale after a reconnect or if
        another tool/operator touches the board. Added the missing
        query variants:

          - PID_GetGains()/PID_GetLoopMode() (existed already, just
            never wired to a command)/PID_GetProfileTiming()/
            PID_GetProfileCurrent() (pid.h/pid.c) -- straightforward
            readbacks of the same per-channel/shared state the
            setters already maintain. PID_GetProfileTiming() returns
            0 (mapped to ERR 12) when timing was never successfully
            set this boot -- a real, distinct "not configured" state
            (PID_ProfileStart() itself refuses to run in it), not
            silently reported as a bogus "0 0".
          - PID:GAINS? <ch>, PID:LOOPMODE? <ch>, PID:PROFile:TIMing?,
            PID:PROFile:CURRent? <ch> (commands.c/commands.h/
            cmd_parser.c) -- see docs/command_reference.md for exact
            reply formats.

        REAL BUG, caught on real hardware before calling this done:
        the first working build compiled and linked with zero
        warnings, but every one of these new query replies came back
        as "OK   " -- literally blank where the numbers should be
        (e.g. "PID:GAINS? 1" -> "OK   " instead of "OK 1.5 12.5
        0.25"). Root cause: this project links against newlib-nano
        (--specs=nano.specs), which strips floating-point conversion
        support out of printf/snprintf by default to save flash --
        %f/%g silently produce NOTHING (not a crash, not a build
        warning) unless the link also includes -Wl,-u,_printf_float.
        Every existing OK reply in this firmware happened to be
        integer-only (%u/%lu) until these four commands, so this gap
        was invisible until now. Fixed by hand-adding
        -Wl,-u,_printf_float to Debug/makefile's link line (+~6KB
        flash -- tracked in the usual memory-footprint commit).
        Documented in AGENTS.md's build-gotchas section alongside the
        existing subdir.mk/objects.list one, including the
        CubeIDE-UI-equivalent project setting (Project Properties ->
        C/C++ Build -> Settings -> MCU Settings -> "Use float with
        printf from newlib-nano") in case a full IDE-driven makefile
        regeneration ever silently drops the hand-added flag again.
        Confirmed fixed on real hardware: all four query commands
        round-trip exactly what was set (PID:GAINS 1 1.5 12.5 0.25 ->
        PID:GAINS? 1 -> "OK 1.5 12.5 0.25"; PID:PROFILE:CURRENT 1
        2750.5 -> PID:PROFILE:CURRENT? 1 -> "OK 2750.5"), and
        PID:PROFILE:TIMING? correctly returns ERR 12 before any
        PID:PROFILE:TIMING has ever been sent.

        wham_console.py updated to match: a new _refresh_config()
        queries all four live from the device (on every connect, and
        on demand via `config`), replacing the session-local-memory-
        only approach documented (and explicitly caveated as such) in
        the previous entry. `config`'s own docstring and the
        channel_config cache's comment updated to describe what they
        actually are now -- a live device readback, not a guess.

        Verified end to end: full `shot` wizard run (unchanged from
        the previous entry's test) still works correctly after these
        changes -- programmed, watched to auto-stop, logged, and
        plotted with no regressions from either the new commands or
        the printf-float linker change.

2026-09-10  —  wham_console.py: interactive operator console, the new
               maintained front end for this board
-----------------------------------------------------------------------
  Change:  New `python/wham_console.py` -- a `cmd.Cmd`-based REPL
        meant to be THE day-to-day way a human operator works with a
        real board, superseding hand-typed raw SCPI sessions
        (`python/scpi.py`, still present, now a minimal fallback) for
        routine use. Per direct instruction, this is a MAINTAINED
        front end -- extend it as new commands land, rather than
        leaving operators to fall back on raw SCPI for everything new
        (see the file's own "Adding a new console command" section at
        the bottom).

        Capabilities:
          - Raw SCPI passthrough for ANY command -- typing something
            not recognized as a console command (see `help`) sends it
            to the controller verbatim and prints the reply, ERR
            replies decorated with their known meaning
            (docs/command_reference.md's error-code table, duplicated
            here for inline lookup).
          - `shot` -- a guided wizard for the full production shot
            profile: prompts for Ramp Time/Flat Top Time and, per
            channel, Demand Current/loop mode/gains, shows a summary,
            confirms, programs every PID:* command in the right order,
            watches the shot live (PID:STATus? polling), then
            automatically fetches PID:LOGDATA? and saves a CSV +
            JSON metadata + PNG plot under shots/ (gitignored --
            operator-session output, not source). Re-running `shot`
            defaults every prompt to the previous answer, so repeating
            an unchanged shot is just pressing Enter through it. Also
            auto-sizes the log decim so ~1000 samples cover the whole
            programmed shot duration -- encodes the exact lesson
            learned the hard way in the 2026-09-10 shot-demo entries
            above (a mismatched decim silently under-covers a shot).
          - `plot [channel]` -- fetches whatever's currently logged
            (PID:LOGDATA?) right now and saves the same CSV/JSON/PNG,
            without running a new shot -- for replotting after an
            ad-hoc bench test done via raw PID:LOG/PID:RAMP/
            PID:SETPOINT commands.
          - `status [channel]` / `monitor [interval]` -- live,
            multi-channel PID:STATus? tables (monitor loops until
            Ctrl-C).
          - `gains`/`loopmode`/`setpoint`/`ramp`/`start`/`stop`/`log`
            -- friendlier wrappers over the equivalent PID:* commands
            (argument validation, open/closed instead of raw 0/1, and
            -- gains/loopmode/profile current -- remembered in a
            session-local `config` summary, SINCE THE FIRMWARE HAS NO
            QUERY COMMAND for any of PID:GAINS/PID:LOOPMODE/
            PID:PROFILE:TIMING/PID:PROFILE:CURRENT -- explicitly
            labeled as session memory, not a device readback, and
            cleared on reconnect, so the console never claims to know
            something it can't actually verify. A real, flagged gap
            worth a future firmware fix (add the missing `?` query
            variants) but not implemented this round -- out of scope
            for a host-tooling change.
          - A hard-per-tick safety-confirmation gate before anything
            that starts real PWM output (FIRE, PID:START,
            PID:PROFILE:START in any valid SCPI short/long form, BOOT)
            -- `confirm off` to disable for scripted use. Documented as
            a best-effort heuristic, not a clone of cmd_parser.c's own
            short/long-form matcher -- see `_is_dangerous()`'s own
            comment on the exact limitation and how to extend it.
          - `connect`/`disconnect`/`ports`/`reflash` (shells out to
            the existing `wham_serial_flash.py`, closing/reopening
            this console's own link around it) -- connection/firmware-
            lifecycle management without leaving the tool.
          - Every command sent and reply received is timestamped into
            a per-session transcript under logs/ (gitignored)
            automatically -- an audit trail with zero operator effort,
            matching how a real control-room console logs everything.

        Design note worth recording: console meta-command names
        (connect, status, shot, plot, gains, ...) were chosen
        specifically so NONE of them can ever be typed (in any case)
        as the leading identchar token of a real SCPI mnemonic --
        cmd.Cmd dispatches on an exact, case-sensitive match against
        `do_<token>`, so a name like `fault` or `pid` would silently
        SHADOW raw passthrough for that whole command family whenever
        an operator happened to type it in matching case (e.g. a
        lowercase "fault?" would hit a hypothetical `do_fault` instead
        of reaching the device, while "FAULT?" would still pass
        through -- a real, confusing inconsistency, caught during
        design rather than left for an operator to discover). Documented
        explicitly in the file's own header comment and "Adding a new
        console command" section so this constraint survives future
        edits.

        docs/command_reference.md was also stale (documented only
        through QSPI:ID?, missing the entire PFMIN:*/PID:* command
        families added across the last several sessions) -- brought
        up to date alongside this tool, including the error-code table
        (was missing codes 8-12) and a note on the new hard output
        slew-rate clamp.
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
