everettpenne/WHAM-CONTROLLERS/firmware/hbridge/docs/changelog.txt

WHAM-HBRIDGE-PFMG474 Firmware Changelog
========================================

2026-11-09  -  Same fix as XREX: serial receive can no longer be switched off by an overrun; USART2 priority 3 -> 1; DIAGnostic:UART?
-----------------------------------------------------------------------
  Found from the hub's log of a LabVIEW shot on the bench XREX (WB-0003-4), 16:02: LabVIEW polled ~10 commands/s during FIRING; valid polls started
  returning "ERR 1 Unknown command" (bytes lost), then the controller stopped answering altogether while still sending its own !EVT lines. The hub timed
  out and closed its link ("the controller is not connected"); the board was powered the whole time and needed a power cycle. The same garbling had already
  appeared during FIRING at 14:53 and 15:00 on the previous image, so it is not a regression of the fault-polling change.
  Cause (from the logs and code; the first hardware confirmation is DIAGnostic:UART? after a shot): the single-byte USART2 receive interrupt had to wait
  more than one byte time (87 us at 115200) behind other interrupts, so a byte was overrun. The HAL treats an overrun as blocking: it ENDS the receive and
  calls HAL_UART_ErrorCallback, which this firmware did not define, so nothing re-armed it and the port stayed deaf (transmit unaffected) until power-off.
  Fix, in uart.c (byte-identical in both products) and stm32g4xx_it.c: HAL_UART_ErrorCallback -> uart_error_callback() counts the error, drops the partial
  line (a byte is missing from it) and re-arms; uart_take_line() (polled every main-loop pass) also re-arms if the receive is not running. New query
  DIAGnostic:UART? -> OK OVERRUN=.. FRAMING=.. NOISE=.. PARITY=.. REARMED=.. (command_reference.md).
  Whether the HBRIDGE boards actually lose bytes is NOT known: the same uart.c and the same priority 3 were there, so the same failure was possible.
  Priority here is 1, not XREX's 2: the heavier HBRIDGE interrupts (ADC DMA, the software table refill on the FMAC vector) are at 2, so 2 would only tie with
  them. 1 ties with HRTIM1_Master and the fault EXTI lines; the USART2 handler is a few microseconds, at most one per 87 us.

2026-11-09  -  DEBUG:FAULT:BYPASS on the HBRIDGE controllers (Limiter, ECH-HVPS)  [host-tested, builds clean; NOT YET FLASHED]
-----------------------------------------------------------------------
  Request: add the XREX fault bypass to the Limiter and ECH-HVPS controllers (both run this firmware). Bench boards with nothing wired to PC10 / the 12 GateDriverStatus pins latch FAULT at boot.
  DEBUG:FAULT:BYPASS <0|1> / DEBUG:FAULT:BYPASS? (cmd_state.c). RAM-only, 0 at every boot, not in profiles. While 1 (state_machine.c g_faultBypass):
    - the state machine ignores PC10/HRTIM1_FLT6 and GateDriverStatus: no FAULT, no ERR 6 on ARM/FIRE/SOURce:RUN/PF15 trigger (ShotStart_FaultLatched()), a shot finishes normally even though a source is latched;
    - GateDriver_CheckFault() neither force-stops nor latches; FAULT:CLEar succeeds with the input still bad; GENERAL:TEST:FAULT is ignored (not latched, so it cannot appear when the bypass goes off);
    - turning it off re-scans the GateDriverStatus pins once (they are edge-triggered), as XREX does.
  DELIBERATELY NARROWER THAN XREX ("nothing behaves as faulted regardless of source"): the closed-loop OVERVOLT and FEEDBACK faults and a table underrun still fault. When control_runtime.c reports an OVP/feedback fault it has already ended
  the run (EndRun), and it relies on the state machine to stop the output; ignoring the report would leave the output running with no control. The bypass exists for missing external fault wiring, which these are not.
  Not bypassed either: the HRTIM's own PC10 output gating (silicon). FAULT? now reads SM_GetFaultSources() (the true latches), so FAULT? can be 1 while STATE? is IDLE under bypass; FAULT:SOURces? is unchanged.
  Error code for a bad argument is ERR 12 (this product's flag convention; XREX uses ERR 11 for a non-0/1 value).
  Tests: test_state_machine (TestFaultBypass: external inputs ignored, shot completion, own faults still fault, clear, re-scan on disable), test_shot_trigger (start check under bypass). All host tests pass; the ARM build is clean.
  NOT YET DONE: flash to the Limiter (WB-0002-6) and ECH-HVPS (WB-0001-8) and try it on the bench; no version bump yet (v0.11 string unchanged) -- bump it when the image is released.

2026-10-27  -  CHARGE output: a 50 % square wave on PG0 for the capacitor-bank charger (CHARGE:FREQuency), v0.11  [host-tested, builds clean; NOT YET FLASHED, NOT YET SEEN ON THE PIN]
-----------------------------------------------------------------------
  Request: for the Limiter, a single PWM output at 50 % duty, independent of the HRTIM outputs, driving a frequency-to-voltage converter that charges a capacitor bank. The operator turns it on,
  leaves it on in any state (not expected during FIRING), turns it off in any state. 0 Hz (off) to ~100 kHz. Pin choice: PG0 (user's decision after the survey below). Name: CHARGE. A fault leaves it ON (user's decision).
  Pin survey (CubeMX database, STM32G474QETx): of PG0-PG7 and PD9-PD12 only PG0..PG3 reach a timer output (TIM20_CH1N..CH4N; AF2 on PG0-PG2, AF6 on PG3). PG4-PG7, PD9, PD10, PD11 have none
  (PD11's TIM5_ETR is an input); PD12 is TIM4_CH1 but is the PFM_Input_06 capture input. PG0 = GPOut_01 (docs/pin_mapping_v4.csv). Nothing in the HBRIDGE firmware used port G or TIM20 before.
  Design: TIM20 channel 1, complementary output only (CC1NE=1, CC1E=0, no dead time: the pin carries OC1REF, PWM mode 1, so CCR1 = period/2 is 50 %), MOE=1; counter clock = APB2 timer clock (170 MHz).
    - src/drivers/charge_out.h + src/bsp/stm32g4/charge_out.c: pin and timer. Off = the pin switched to a plain output at LOW FIRST, then the timer stopped (the pin can never stay HIGH because the counter
      stopped mid-cycle). Start/retime writes PSC, ARR, CCR1 (buffered) and forces an update event so the new frequency applies at once, even from 1 Hz.
    - src/app/control/charge.c: Charge_Plan() turns Hz into psc/arr/ccr (rounded counts per period; the smallest prescaler that fits a 16-bit period; 100 kHz = 1700 counts exactly, 850 high; 1 Hz = psc 2593);
      Charge_SetFrequency(0..100000). Whole hertz. No state-machine, fault or HRTIM dependency, so it works in IDLE/ARMED/FIRING/FAULT and a latched fault, DISARM, a shot ending and FAULT:CLEar leave it alone.
    - src/app/commands/cmd_charge.c: CHARGE:FREQuency <hz> (0 = off; anything else outside 1-100000, or not a whole number, is ERR 12), CHARGE:FREQuency?, CHARGE:STATus? (freq, running, actual in Hz, psc, arr, ccr).
    - Off at every boot (Charge_Init() in App_Init()); not stored in profiles. The hub treats a nonzero CHARGE:FREQuency as dangerous (host/dangerous_commands.py); 0 is not.
  Tests: tests/test_charge.c (160 checks): every frequency in a sweep from 1 Hz to 100 kHz within 0.05 %, 16-bit period, a 50 % high count, the refusals, off/stop, re-timing a running output, the start-up state.
  Build: clean; the image is 107,324 bytes (was 106,032). FW_VERSION_STRING v0.10 -> v0.11.
  NOT YET DONE: flash to a board; look at PG0 with a scope or logic analyser (the complementary-only mode and the 50 % duty are from the reference manual, not yet seen); check the converter's input has a pull-down.

2026-10-23  -  Firmware version v0.10; first image for a new board (ECH-HVPS)
-----------------------------------------------------------------------
  FW_VERSION_STRING v0.9 -> v0.10 (ctrlr_config.h: bump on every release). The PF15 shot trigger (2026-10-20 below) had been flashed to the bench simulator board
  as "v0.9", the same string as the image before it, so two different images carried one version; the commit hash in *IDN? told them apart, the version did not.
  The first board to receive v0.10 is a new, blank controller (ECH-HVPS, a gyrotron controller): flashed over the ST-Link with openocd (image built clean, commit
  ad7483f1, 106,032 bytes, verified), then given serial WB-0001-8 and label ECH-HVPS by host/provision_board.py (first entry of host/devices.csv). Read back after a
  reset: identity=ok verified=1, STATE IDLE, FAULT 0, EXTernal:TRIGger on, PF15 low. Bank 2 is still blank. Also: gen_git_version.py now marks an image dirty only for
  uncommitted changes under the product's own folder (it used to count the whole repository).

2026-10-20  -  External shot trigger: a rising edge on PF15 while ARMED starts the shot (interrupt-driven)  [FLASHED to the bench board; command layer verified; NOT YET TESTED WITH A REAL EDGE]
-----------------------------------------------------------------------
  Request: the HBRIDGE should fire on a rising edge at PF15 like the XREX; handled as an interrupt, not polled; "assuming all shot conditions are met".
  Design (src/app/control/shot_trigger.c, shot_start.c; board_io.c, mcu.c, Core/Src/stm32g4xx_it.c):
    - PF15 (Fiber_Enable): input, pull-down (floating reads LOW), interrupt on the RISING edge only, EXTI line 15 on the EXTI15_10 vector shared with
      the gate-driver inputs PE10/PE11 (priority 1). The handler clears the line and calls ShotTrigger_OnEdge(): count the edge, ignore it unless the trigger
      is enabled, the state is ARMED and the pin still reads HIGH (rejects a glitch shorter than the interrupt latency), then pend a software interrupt.
    - The start runs in that software interrupt (the unused CORDIC's vector, priority 2, Mcu_StartIrqInit/Pend), NOT in the edge handler: the start fills
      the ring of period entries (~200 us) and starts the HRTIM, and the EXTI vector is at the priority of the per-period interrupt, so doing it there would
      hold up a gate-driver fault stop and the first period of the shot. At priority 2 both preempt it.
    - cmd_fire()'s body moved to ShotStart_Run() (shot_start.c) so FIRE and the trigger run the SAME checks and start: a latched fault, ARMED, closed loop
      (Control_Prepare / SM_Fire / Control_Go) or the open-loop shot (PFM_RestoreOpenSource / PFM_ShotReady / SM_Fire). A claim flag taken with interrupts masked
      lets only one start run: a trigger arriving while a FIRE command is being processed is refused as BUSY. AnyFaultLatched() is now ShotStart_FaultLatched().
    - EXTernal:TRIGger <0|1>, EXTernal:TRIGger?, EXTernal:TRIGger:INPut? (raw PF15), and EXTernal:TRIGger:STATus? (counters and the last result: the only
      record of why a trigger did not start a shot). On at every boot (SHOT_TRIGGER_DEFAULT_ENABLED = 1, ctrlr_config.h), as on XREX; not stored in profiles.
    - Not ported: the external ENABLE interlock (PF13). XREX is unchanged (it still POLLS PF15 in its 1 kHz control tick).
  Tests: tests/test_shot_trigger.c (50 checks): the order and results of ShotStart_Run, closed loop and its rollback, one start at a time (a nested start is BUSY), an edge
        starts nothing itself (the software interrupt does), disabled / not ARMED / glitch edges ignored, a refused start leaves it ARMED and needs a new edge, a trigger
        during FIRE is BUSY. All host tests pass; wham_build.py clean (the image is 106,048 bytes, was 104,684).
  Flashed 2026-10-20 to the bench board (the simulator board running HBRIDGE) through the hub with fw_update.py, user-confirmed bench check first: CRC verified, bank 2,
        back in 0.16 s, bb7f3af5-dirty. Verified on it: EXTernal:TRIGger? = 1 at boot; :INPut? = 0 with nothing connected; :STATus? all zero and last=NONE (no spurious edge at boot);
        EXTernal:TRIGger 0/1 and the short form EXT:TRIG:STAT?; ERR 12 for a bad or missing argument. The old image is still in bank 1 (python/fw_update.py --rollback).
  NOT DONE: a test with a real rising edge on PF15 (needs a source: a wire from a 3.3 V output, or the fibre receiver's signal); the memory report; the commit.

2026-10-20  -  LabVIEW interface guide and operator's guide (documentation only, no firmware change)
-----------------------------------------------------------------------
  New: docs/labview_interface.md (the front-end contract for this controller, the HBRIDGE counterpart of XREX's file of the same name) and docs/operators_guide.md
        (architecture, safety model, procedures, fault response, verification status; site-specific tables left to fill in).
  Corrected in docs/command_reference.md: the analog full scale is ANALOG_VREF_MV, 2.9 V in the current build (the DAC/ADC section still said 2.500 V).
  New: docs/examples/limiter_per_phase_duty_shot/ -- a worked example for operators: a Limiter shot with a different duty profile on each phase, run through the hub on the simulator
        board (script, plot, measured data, client transcript and the hub's own log). Measured duty reads ~2 points below programmed on every phase (the known dead-time offset), constant across
        the shot, spread 0.02-0.04 points. One cycle of phase V (cycle 222, ~2.2 ms) has a 20 us period (a missing edge): not understood, flagged in the data, no fault raised.
  Found while writing: ARM does not check the supply mode (cmd_arm refuses on a latched fault, not IDLE, or no phase enabled); with no mode there is no shot, so FIRE answers ERR 5.

2026-10-15  -  net_client.py asks the host service to timestamp every line (host tools only, no firmware change)
-----------------------------------------------------------------------
  python/net_client.py (identical in both products) now sends "!hub timestamps on" after its "@name" line in interactive mode, so a person typing at it sees
        [HH:MM:SS.mmm] before every line when it is connected to host/wham_hub.py (--no-timestamps for net_broker.py, which does not know the command; one-shot
        --send mode is never stamped). The service side, in host/wham_hub.py, is per connection and off by default so fw_update.py, wham_console.py and
        LabVIEW still get bare lines.

2026-10-15  -  GDS:LAST? documented (docs only, no firmware change)
-----------------------------------------------------------------------
  GDS:LAST? existed in the command table and cmd_io.c (added while chasing the bench fault of 2026-10-13) but was in neither command_reference.md nor the
        operator documents. It answers "OK <pins hex, %03X> <fault checks since boot>": the raw 12 GateDriverStatus levels (bit 0 = input 01 = PE0) when the
        last gate-driver fault latched. Now in command_reference.md after GDS?, and in docs/labview_state_and_faults.md (section 4.4) at the top of the repository.
        It is not cleared by FAULT:CLEAR, covers only the GateDriverStatus source, and cannot name a phase (no pin-to-phase map exists).

2026-10-14  -  PFM:GAPLOG? streams its reply, so a long gap log no longer overruns RAM; shared tests build under gcc 13
-----------------------------------------------------------------------
  BUG: cmd_pfm_gaplog built "OK <count> <gap> ..." in a 2600-byte buffer sized for XREX's 200 entries, but HBRIDGE logs up to PFM_INPUT_MAX_PERIODS (3800)
        gaps of about 5-6 digits each. Past about 450 entries snprintf truncated, the remaining size underflowed and later entries were written past the buffer
        (RAM corruption), and the reply went out with no CR LF, so the next reply ran into it. The handler now sends the list through Scpi_ReplyU32List
        (src/middleware/scpi/scpi_util.c, shared): one line of any length, sent in pieces from a 64-byte stack buffer; the 2600-byte static buffer is gone.
  Shared: profile_store.c compared an int with sizeof, which gcc 13's -Wsign-compare rejects under -Werror, so the host tests did not build there.
  Tests: host suite all green (test_scpi_util 20,211 checks, incl. a 300-value list checked against the reference string, one line). check_shared OK.
  NOT DONE: the images in build/ are not rebuilt from this source (no arm-none-eabi toolchain on the machine that made the change); run python/wham_build.py.

2026-10-13  —  Independent per-channel duty profiles and three closed loops (U on PA0, V on PA1, W on PB0)   (branch per-channel-profiles)
-----------------------------------------------------------------------
  Request: each channel should be able to output its own PWM duty profile, in open loop and in closed loop with its own feedback: phase U on the ADC at PA0,
  V on PA1, W on PB0.
  Open loop: SHOT:STEP <t> <f> <duty> (all phases, as before) or <t> <f> <dU> <dV> <dW>; time and frequency stay shared (one master timer). shot_profile.c
        generates a compare per channel (a fast path when the channels are equal), checked per channel against the one-duty generator it must equal; the
        per-period numbers of an ordinary shot are unchanged (the old GOLDEN values still hold). ShotEval_At() evaluates the shot at any time (mixed runs);
        the live mailbox PFM_LiveSet(per, cmp[]) is a two-buffer ping-pong published by one byte store. python/pfm_shot_test.py has the matching Python port.
  Closed loop: control_runtime.c now runs CTL_LOOPS = 3 loops (one closed_loop_t per phase, own mode, gains, feedback input and calibration, hold setpoint, simulated
        plant); the shared plant settings are copied to all. A run may MIX them: closed phases from their controllers, open phases from the shot, the carrier from the
        shot when any phase is open (else CONFig:CLOSEDloop:FREQuency); the run lasts as long as the shot, else as long as the target. TARGet:STEP takes one voltage per
        phase on a shared time grid. The HVPS keeps ONE frequency loop (loop 1). Commands take the loop 1-3 (0 = all): PID:LOOPMODE, PID:GAINS, SOURce:SETpoint/STATus?,
        LOG:ARM/DATA? (one pool: 1000 samples for one loop, 333 for all three), CONFig:FEEDback:CHANnel/SCALE/OFFSet/RANGE (optional loop, default loop 1). New PID:FAULT?
        (which loop stopped the run) and PID:DIAG? (the control tick's cost in cycles). The loop controllers are compiled at -O2 like the generator.
  BEHAVIOUR CHANGE: PID:LOOPMODE 1 1 used to close the one loop that drove every phase; it now closes phase U only and the other phases follow the shot
        (PID:LOOPMODE 0 1 closes all three). The default feedback input of loop 1 is PA0 (was PA1).
  Saved profiles: loop 1 keeps its ids; loops 2 and 3 have ids 19-22 and 35-37; shot and target have per-phase formats (ids 70-73) used only when the phases differ, so
        ordinary profiles are saved byte for byte as before. Worst case (both series full, different on every phase, plus the HVPS curve): 15,656 of 16,336 bytes.
  Tests: host suite all green (shot 47,853 checks incl. per-channel equality with the one-duty reference and the evaluator; target 668; codec 570; settings 355 incl.
        per-phase round trip, old-format recall into every phase, the worst case). Firmware builds with no warnings: RAM +7 KB (bss 122,216; about 7 KB free), flash 104,248.
  VERIFIED ON THE SIMULATOR BOARD (same day, real hardware through the tunnel): open loop -- each phase plays its own duty (programmed 20/50/80 %
        measured 18.1/48.1/78.0 % from the PFM_Input edges, the same ~1.9-point dead-time offset on every phase; a ramp U up, V down, W flat measures as
        programmed, correlation 0.99); closed loop against the firmware plants, a different target on each phase -- U to +594 V, V to -594 V, W holding 300 V,
        rms error <= 0.6 V; a mixed run (U closed at 300 V, V 30 % and W 70 % open from the shot, carrier 100 -> 108 kHz) measured 64.8 / 28.0 / 68.0 %;
        FIRE with an open phase and no shot -> ERR 5, SOURce:RUN with an open phase -> ERR 13; each loop alone on a dead real ADC input stops the run and
        PID:FAULT? names it (3, 2, 1: CLIPPED_LOW); a closed loop on a disabled phase takes no part; the two profiles saved by the OLDER firmware recall with
        0 failures, a per-phase profile saves and recalls identically through the real flash (CONFig:PROFile:DIFF? SAME). Control tick (PID:DIAG?): three
        simulated loops at 125 kHz, longest 13,670 of 17,000 cycles (80 %), mean 12,718; the per-period interrupt uses 31 % of the CPU at 125 kHz (PFM:DIAG?).
        Compiling BuildStep/OnBlock at -O2 changed nothing measurable and was dropped. NOT verified: loops on the real analog inputs -- every ADC input read
        exactly 0 with the DAC at 0.5-2 V (VREF 2.906 V and the sampler were fine), i.e. the board's DAC-to-ADC path is not live at the moment.
  BUG FOUND AND FIXED (shared SCPI layer, both products): Scpi_SendErr formatted into a 128-byte buffer, so an error message longer than ~118 characters lost its
        CR LF and the next reply ran into it (several existing messages were that long; the new closed-loop ones made it visible). Now a long message is cut,
        marked "..." and still ends its line; test_scpi_util 20,207 checks. XREX gets the same file.

2026-10-07  —  Device identity, step 2: the persistent serial (SYS:SERial, SYS:LABel, SYS:ID:CLEar), host provisioning tool; flash unique-ID read fixed
-----------------------------------------------------------------------
  Request: continue the device-identity plan (docs/device_identity_and_host_service.md, repository top level).
  Firmware (src/app/settings/device_identity.c, shared byte-identical, check_shared.py): an 88-byte record (magic WID1, sequence, serial, label, the MCU UID
        and flash UID it was written for, CRC-32) in two alternating copies in two reserved sectors, 0xFFD000 and 0xFFE000 (NVSTORE_IDENTITY_ADDR; the last sector
        stays the QSPI:SELFtest scratch). A write erases the copy that is NOT the newest valid one, so a power cut leaves the previous record (host test: a cut at every one
        of the ~90 flash operations of an update, and of a first write). `verified` = written for THIS MCU and THIS flash chip; identity = unset|ok|corrupt|nochip.
        nvstore refuses every erase/program that touches those sectors (NVSTORE_ERR_RESERVED) unless NvStore_IdentityWriteEnable(1), which only the identity
        module sets around its own writes; profile_store.h now refuses to build if the profile slots reach the identity sectors.
        Commands (identical in both products): SYS:SERial <sn> (once; ERR 19 if one exists), SYS:SERial?, SYS:LABel <token|->, SYS:LABel?, SYS:ID:CLEar CONFIRM; writes only
        while IDLE (ERR 13); new shared error code 19 ERR_IDENTITY. SYS:ID? gains identity=; *IDN? and !BOOT now carry the real serial. tests/test_device_identity.c: 331 checks.
  Host: host/provision_board.py (reads *IDN?/SYS:ID?, picks the registry's serial for this hardware or the next WB-NNNN-C with a Luhn check digit, asks, writes, reads back
        and requires verified=1, appends to host/devices.csv; --check, --list, --serial, --label, --no-registry; never clears a serial), host/tests (6 checks).
  BUG FOUND ON HARDWARE (step 1's flash unique ID): the W25Q128 unique-ID command (0x4B) needs 32 dummy clocks, but the QUADSPI dummy-cycle field holds only 0..31, so my 32
        wrapped to 0 and the first four "ID" bytes were the chip's dummy bytes: they read 00000000 on one boot and FFFFFFFF on the next (the step 1 entry's
        "00000000E4653C34" was therefore wrong). Found when the ID changed between boots and confirmed with a temporary DIAGnostic that read 16 bytes with dummy counts
        0..64: the stream repeats every 8 bytes, E4 65 3C 34 CB 17 2E 22, and 32/40/48/64 behave exactly like 0/8/16/0. Fix: no dummy cycles, read 12 bytes, drop the first 4.
        The real 64-bit ID of the simulator board's chip is E4653C34CB172E22 and is stable. (A serial provisioned on the broken ID read verified=0 after the fix --
        the binding check doing its job.)
  Verified on the simulator board (HBRIDGE image): all error paths; provisioning through the tool (next serial WB-0001-8 with a scratch registry; re-provisioning after a clear
        reused the registry's serial); the serial, label, both IDs and verified=1 intact across two firmware-update reboots (both flash banks); QSPI:SELFtest, *SAV/*RCL and the profile catalog
        unaffected. The board was left UNSET (SYS:ID:CLEar CONFIRM) and the scratch registry was not kept: no real serial has been assigned. XREX built, unit-tested, NOT flashed.

2026-10-07  —  Device identity, step 1: which physical board is this (read-only hardware ID)
-----------------------------------------------------------------------
  Request: a unique, persistent identifier per board so a host service can tell which board it is talking to (several copies will be
  deployed, each controlling a different system). Plan and host-service design: docs/device_identity_and_host_service.md at the top of the
  WHAM-CONTROLLERS repository (new this day: firmware/xrex + firmware/hbridge with their histories, hardware/, host/, docs/).
  Step 1 (this entry): read-only hardware identity, no flash writes.
  device_id.h/.c (MCU 96-bit unique ID), NvStore_ReadUniqueId() (W25Q128 instruction 0x4B, four dummy bytes, 64 bits), device_identity.h/.c
  (src/app/settings: reads both, keeps the flash ID once good, rejects all-0/all-1 as "no chip", formats SN=/UID= and the SYS:ID? line) --
  all byte-identical in both products (check_shared.py), tests/test_device_identity.c (17 checks, both products).
  *IDN? and the !BOOT banner end with "SN=UNSET UID=<24 hex>"; new SYS:ID? -> "OK serial=UNSET uid=... flashuid=... product=... hw=... fw=... commit=... label=- verified=0".
  Verified on the simulator board (HBRIDGE image, bank swap by FWUPdate): banner, *IDN? and SYS:ID? as above, stable over repeated queries, saved profiles
  intact. The flash unique ID read 00000000E4653C34 here -- WRONG, see the step 2 entry (the first four bytes were the chip's dummy bytes). XREX built
  (controller and simulator images) and unit-tested but not flashed.
  Design notes recorded in the doc: the identity region (step 2) must not use the chip's last sector (the QSPI:SELFtest scratch sector, NVSTORE_SCRATCH_ADDR);
  commands are under SYS: (XREX already has SYS:TIME?/TELEM?/EVENT/EVLOG?), not SYSTem:.

2026-10-07  —  Front-panel LEDs: UART activity and operating state (branch scpi-shared; same change in both repos)
-----------------------------------------------------------------------
  Request: pin map entries and firmware for six LEDs (new hardware revision): PD2 UART_TX_LED, PD3 UART_RX_LED, PF14 STATE_IDLE_LED,
  PF2 STATE_ARMED_LED, PC3 STATE_FIRING_LED, PC2 STATE_FAULT_LED; purely cosmetic, DMA where possible, never allowed to disturb the controller.
  docs/pin_mapping_v4.csv: the six rows renamed in the V4 column (Peripheral GPO; XREX also in the "XREX Pin Name" column); XREX's pin_mapping_reference.tex lists them.
  src/drivers/led_indicators.h + src/bsp/stm32g4/led_indicators.c (identical in both repos, in check_shared.py), switch LED_INDICATORS_ENABLED and
  LED_ACTIVITY_MS (30) in ctrlr_config.h.
  State LEDs: state_machine.c now assigns the state ONLY through SetState(), which lights the matching LED in the same step (one BSRR store per GPIO port),
        so an LED is lit if and only if STATE? says so, whichever context made the transition (command, main loop, EXTI, control interrupt). All four are
        off until SM_Init(); a fault latched before it is re-asserted by SM_Init/the first poll. HBRIDGE test_state_machine.c gained a fake LED driver that
        checks, at every update, that the LED shown is the machine's state (161 checks).
  Activity LEDs: uart.c (shared, so any UART instance) pulses TX around every uart_send() (lit at the start AND after the last byte, so a long send does
        not let it lapse) and RX in the receive callback. A pulse = pin on + restart a one-pulse timer (TIM16 TX, TIM17 RX, 10 kHz); the timer's update
        event is a DMA request (DMA1 channels 7 and 8, memory-to-peripheral, circular, one word) that writes the pin's reset bit into GPIOD->BSRR, so the LED goes
        dark 30 ms later with NO interrupt, polling or CPU time -- including while the main loop is inside the blocking transmit. Traffic closer together than
        30 ms keeps the LED lit. TIM16/17 and DMA1 ch 7/8 were unused (pfm_input.c: DMA1 ch 1-6, ADC: DMA2 ch 1). The state LEDs are NOT DMA-driven: they change
        a few times per shot and one register store is cheaper than any DMA setup.
  DIAGnostic:LEDs? (new, cmd_io.c) -> "OK TX=0 RX=0 IDLE=1 ARMED=0 FIRING=0 FAULT=0": the LEDs the firmware is driving lit (output register), the way to check
        the logic without LEDs fitted.
  Verified: both repos build with no warnings (XREX controller + simulator, HBRIDGE), host tests pass, check_shared OK. NOT yet verified on hardware: the
        DMA turn-off and the pin levels (bench needs the tunnel; no LEDs are fitted on the current boards) -- see the verification note below if added.

2026-10-05  —  SCPI protocol layer shared with XREX: strict arguments, shared reply helpers and error codes (branch scpi-shared)
-----------------------------------------------------------------------
  Request: compare the two SCPI command libraries and bring them into harmony (steps A and B of that comparison).
  The parser, its tests and the fake UART were already byte-identical; the differences were in the command layer. Done:
  A  scpi_err.h -- the error-code enum is ONE shared header (codes 10/11/14-16 differ only in meaning, now written for both products;
        ERR_CARRIER_TOO_HIGH stays as XREX's name for code 10); docs/scpi_conventions.md -- the single description of framing, replies,
        error codes (with a "used by" column), mnemonic matching, strict arguments, how to write a handler, and where the two command sets
        overlap but differ (53 shared mnemonics, 8 with different meaning/units: SOURce:SETpoint Hz vs V, PID:LOOPMODE default, LOG:DATA? streamed vs
        paged, SHOT:* ...); each command_reference.md now points there instead of carrying its own copy; tests/test_command_table.c is one shared
        file (each product's known short-form collisions live in tests/known_short_collisions.inc: XREX 6 entries, HBRIDGE none);
        python/check_shared.py now also compares the parser, scpi_util, scpi_err, the tests and the two shared docs (the formatter blocks it
        compared before are gone: the function moved whole).
  B  src/middleware/scpi/scpi_util.c/.h (+ test_scpi_util.c, 20,201 checks) -- reply builders (Scpi_SendErr, ReplyOk, ReplyFixed, ReplyFloat/Float3,
        ReplySet), STRICT argument parsing (Scpi_ParseLong/Float/Bool/Scaled/Unsigned; the whole token must be the number: "12x", "abc", "1.5" for an
        integer, "nan", "0x10" are refused), handler shorthands (SCPI_NEED_LONG/FLOAT with an optional per-command error code, explicit Scpi_GetLong/
        GetFloat for value-returning helpers), the SCPI_FLOAT_SETTING generator, and number text with no printf float support (Scpi_FormatFixed,
        Scpi_FormatFloat = the %g formatter that had lived in settings_codec). SendErr is now Scpi_SendErr everywhere.
  HBRIDGE: cmd_control.c's private ParseUnsigned/Fixed/ReplyOk/ReplyFixed/ReplySet and the FLOAT_SETTING macro are gone in favour of the shared ones
        (FLOAT_SETTING is now a one-line alias of SCPI_FLOAT_SETTING); ShotProfile_ParseScaled was the same code as Scpi_ParseScaled and is removed
        (its checks moved to test_scpi_util); the 7 remaining atol sites (PFMIN, TABle:STEP) and the slot parser are strict, keeping their own error codes.
  Verified on the simulator: the full profile round trip (30 queried values, shot/target/curve points) is identical before/after; bad arguments now
        answer e.g. "PFMIN:DATA? 1x -> ERR 8 not a number: 1x", "PFMIN:CAPTURE abc -> ERR 9 ...", "TABle:STEP 1 2 x 4 -> ERR 4 ...", "*RCL 1x -> ERR 12";
        valid forms, set/query pairs, DAC/ADC/PHASe/SHOT commands unchanged. Flash 92.6 KB (was 97 KB: the formatter and helpers deduplicated).

2026-10-05  —  PHASe:ENAble / PHASe:SELect: choose which of the three phases U, V, W drive their outputs
-----------------------------------------------------------------------
  Branch phase-enable. Request: a command so an operator can output with only U and W, only W, or any combination.
  The mechanism already existed (pfm.c's durable per-channel enable array -> HRTIM1_PWM_Start(), which leaves a disabled
  channel's pins unconnected while its timer keeps running in step with the Master); nothing exposed it. Added:
        PHASe:ENAble <phases> <0|1> / PHASe:ENAble? [<phase>]   switch the named phases, others unchanged; OK U=1 V=0 W=1 or OK <0|1>
        PHASe:SELect <phases> / PHASe:SELect?                   exactly these on, the rest off; OK UW / OK NONE
        <phases>: letters in any order/case (UW, wu), channel numbers (13, 1,3), ALL (NONE for SELect). phase_mask.c: the pure parser and
        formatter, host-tested (48 checks); PFM_GetPhaseMask/SetPhaseMask.
  Rules: IDLE only for changes (the mask is read at shot start), queries any time; ARM refuses while no phase is enabled (ERR 13);
  all three on at every boot; NOT saved in profiles (a recall must not change which legs are driven); SOURce LOOP (measures Phase U)
  refuses to start with U disabled. GDS fault inputs are NOT masked per phase: the pin map does not say which input belongs to which phase.
  Verified on the simulator with PFM_Input 1/2/3 = U/V/W: for UVW, UW, W, V, U, VW, "1,3" and ALL, exactly the enabled phases' inputs saw edges
  (300 of 300 periods, the others 0), no combination faulted; ENAble/SELect adding and removing, NONE refusing ARM, IDLE gating (ERR 13 while
  ARMED) and argument errors (ERR 12) as designed; the loopback refused with U disabled and ran with it. Not done: a scope check of the phase
  angles for each combination (the design keeps each phase at its fixed place; only the edge counts were measured).

2026-10-05  —  Saved profiles in the external flash (nvstore, QSPI:SELFtest, *SAV / *RCL / CONFig:PROFile:*), ported from XREX
-----------------------------------------------------------------------
  Branch flash-profiles. Design, what is stored and the XREX comparison: docs/saved_profiles.md.
  Step 1-2: nvstore (read / 4 KiB sector erase / page program + verify on the W25Q128, shared QUADSPI handle) and QSPI:SELFtest ported
        unchanged from XREX. Real chip: QSPI:ID? EF 40 18, SELFtest PASS (sr=00,02,60, erase 59 ms, program 1 ms, read 8 ms) -- the same numbers XREX saw.
  Step 3: profile_store (slots, alternating copies, 48-byte header with CRC) generalized: copy size in sectors, region base and product
        magic are config (PROFILE_COPY_SECTORS 4, PROFILE_STORE_BASE 64 KiB, magic "HSPF"); a STREAMING writer (header written LAST) and
        reader so a payload need not fit in RAM (free RAM is ~14 KB). settings_codec: HBRIDGE's scalar snapshot (18 system fields, kp/ki/kd per
        plant, frozen ids) in the same tagged-record framing, plus chunked table records (shot 64/65, target 66/67, HVPS curve 68/69).
  Step 4: settings (capture, apply through the same setters as the commands, streamed table save/recall), cmd_profile (same commands,
        replies and rules as XREX), ERR 18. The closed-loop plant setters moved from cmd_control.c into control_runtime.c and per-plant gain
        accessors were added so commands and profiles share them. Recall order: mode, ADC/PIDRate (retried in the other order when refused
        against each other), calibration/limits/plant parameters, gains, loop mode, then tables; a rejected value is named, the rest apply;
        a table failing part way is left EMPTY; a good shot recall selects the PROFILE source like SHOT:END (found on the bench: without it
        the recalled shot would not have played on FIRE).
  Not saved: run state, DAC outputs, bench-simulation knobs (SOURce/DACRatio/SIM:PLANT:*) -- a profile must not switch a real loop onto a model.
  Also: SettingsCodec_FormatFloat, a printf-free %g (the first bench run of CONFig:PROFile? printed blanks for every float: the newlib-nano
        printf-float trap AGENTS.md documents for XREX; no linker flag added). HBRIDGE and XREX now use separate flash regions and magics
        (XREX 0-64 KiB, HBRIDGE from 64 KiB) so a board that ran both keeps both products' profiles.
  Host tests: test_profile_store 5,567 checks (RAM fake flash; a power cut at every step of small saves and at a spread of steps of a 9 KB
        multi-sector save; streaming, magic, usage errors), test_settings_codec 20,366 (frozen ids, round trip, stream reader, float text vs printf),
        test_settings 260 (whole-profile round trip incl. a 500-point shot, failure rules, timing-order retry, a cut during a save).
  Real flash (simulator board, v0.9): the whole test state -- 20 scalars, a 500-point shot, an 8-point target and a 21-point curve -- saved to slot 2
        (*SAV 173 ms; CATalog/PROFile?/DIFF? SAME), every setting scrambled, *RCL 2 -> APPLIED=23 FAILED=0 (65 ms), DIFF? SAME, and all 30 queried values
        (including shot points 0/1/250/499, target and curve points) identical. A saved slot survived three firmware updates (each reboots the
        board): after one, the live state was back at defaults, DIFF? listed exactly the differences, *RCL restored everything. The recalled shot
        played for its full 0.998 s on FIRE (FIRING for 1.02 s, no fault). Error paths (empty slot, slot 0/9/missing, bad label -> ERR 12/18) and IDLE
        gating (ERR 13 in ARMED for *SAV/*RCL/CLEar, CATalog? still answers) as designed; three saves into one slot alternate copies and the newest
        wins; CLEar empties it. Cost: about +12 KB flash, +0.6 KB RAM. The controller board has not been tested.

2026-10-05  —  HVPS output is power: frequency -> volts lookup table (CONFig:CLOSEDloop:CURVe:*), linear default, no negative targets
-----------------------------------------------------------------------
  Everett's description of the HVPS plant: the feedback voltage stands in for POWER, which is never negative, peaks at the resonant
  frequency (about 19 kHz) and falls on both sides; raising the output means moving the drive frequency toward resonance (typically a
  start around 20 kHz); the relationship may be assumed linear for now, but a lookup table will be needed because the real one is
  nonlinear and cannot be measured yet.
  Found: the controller's feedforward was ALREADY linear (V = 0 at the band's far edge, Vpeak at resonance); the Lorentzian curve was
  only in the simulated plant, so the earlier HVPS loopback (129/85 mV rms above/below) was a linear controller against a nonlinear
  plant. Changes:
        hvps_curve.h/.c   a table of (Hz, volts) points (up to 32, frequency strictly increasing, volts >= 0, one peak), linear
                          interpolation, inversion on either branch (HvpsCurve_FreqFor), and the linear default builder.
                          Host test test_hvps_curve (125 checks); closed-loop tests added for a loaded table and for refusal.
        CONFig:CLOSEDloop:CURVe:BEGin/STEP/END/CLEar and CURVe? / CURVe:POINt? <i>   (mirrors TARGet:*): a loaded table replaces
                          the linear default for the feedforward and its peak defines where the band starts (RESonance is then
                          ignored); an invalid table is refused at start.
        negative HVPS targets   refused at TARGet:STEP (ERR 4) and again at start (Cl_Start); the Limiter's bipolar target is unchanged.
        SIM:PLANT:SHAPE LINEAR|LORENTZ   default LINEAR (zero at the HVPS band's edges, set from the mode's limits at each start);
                          LORENTZ is the old nonlinear shape, to test a loaded table against.
        simulated plant starts at the first target voltage instead of 0 V (no 20 ms start-up transient in HVPS runs; the DAC loopback
                          sets that level before the first tick).
  HVPS loopback, ABOVE resonance, target 1.0 -> 1.4 -> 0.6 -> 1.4 -> 1.0 V over 100 ms, gains 4000 Hz/V / 200000 unchanged, tau 3 ms,
  Phase U -> PFM_Input_01 -> model -> DAC PA5 -> amplifier -> ADC PA1; all ended IDLE, no fault (error after 5 ms):
        linear plant, linear table       51 mV rms / 78 mV max   (output 19.4-26.0 kHz)   [BELOW: 48 / 77 mV, 13.3-18.7 kHz]
        nonlinear plant, linear table   110 mV rms / 254 mV max  (reaches the 19 kHz floor; overshoots and undershoots)
        nonlinear plant, matching table  37 mV rms / 69 mV max   (19.4-23.0 kHz)
  The matching table (a Lorentzian sampled every kHz, uploaded over CURVe:*) cut the error to a third of the linear-table figure with
  the same gains: the lookup table is what a nonlinear plant needs; gains were not touched.

2026-10-05  —  HVPS loopback: SOURce LOOP now works for the HVPS (measured carrier frequency -> resonance model -> DAC -> real ADC)
-----------------------------------------------------------------------
  The loopback source (entry of 2026-10-02) was Limiter-only (duty). For the HVPS the duty meter's frequency output feeds the
  resonance model, V = gain x vpeak / (1 + ((f - resonance) / width)^2), then the plant lag, the DAC and the real ADC input
  (SimPlant_HvpsSteady; the Limiter/HVPS choice follows the supply mode). Same wiring: Phase U -> PFM_Input_01, DAC PA5 -> amplifier
  -> ADC PA1 (re-checked after the overnight gap: 0.552 x DAC, +18 mV).
  Run: HVPS, SCALE 1 / OFFSet 0, controller and plant VPEAK 1.5 V at 19 kHz (the amplifier path only reaches 1.6 V at the ADC), width
  3 kHz, tau 3 ms, gains 4000 Hz/V / 200000 (untuned, as in the simulated runs), target 0.5 -> 1.2 -> 0.5 -> 1.2 -> 0.5 V over 100 ms.
  Both branches ended IDLE with no fault. ABOVE (output 19.7-24.6 kHz): 129 mV rms / 322 mV max after 5 ms; BELOW (13.9-18.1 kHz):
  85 mV rms / 224 mV max. Both include a start-up transient (the model plant starts at 0 V, the target at 0.5 V; it takes about 20 ms to
  catch up). From 25 ms on: ABOVE 98 mV rms / 198 mV max, BELOW 67 mV rms / 141 mV max; the feedback lags the demand by up to about
  100-200 mV mid-ramp and overshoots the demand by up to 157 mV (ABOVE) / 124 mV (BELOW) at the second 1.2 V peak. The loop is stable;
  the gains are simply not tuned for this plant (nonlinear: gain falls toward the peak and rises away from it).
  Not tested: HVPS duty other than the 50 % default; PFMIN captures and this meter cannot run together (as before).

2026-10-02  —  Loopback test with a stronger low-pass (SIM:PLANT:TAU 6 and 10 ms)
-----------------------------------------------------------------------
  Same loopback run as the entry below (Phase U -> PFM_Input_01 -> model -> DAC PA5 -> amplifier -> ADC PA1, Limiter, +-0.5 V
  triangle over 100 ms, gains 214.286 / 8571.429 unchanged), with the plant low-pass lengthened. No faults in any run.
        tau 3 ms    error 30 mV rms / 44 mV max    duty 8.7-95.0 %
        tau 6 ms    error 46 mV rms / 75 mV max    duty 5.0-95.0 % (touches both limits)
        tau 10 ms   error 59 mV rms / 137 mV max   duty at 95 % for about 5 ms before each positive peak and at 5 % for about 6 ms
                    before each negative one; the feedback only reaches about +0.40 / -0.44 V of the +-0.5 V target
  The limit is physical, not tuning: a 12.5 ms ramp of 1 V through a 10 ms lag needs more than a 95 % duty can deliver, so the
  output saturates and the loop is blind to the rest. Anti-windup behaved: after each saturated stretch the error recovers in a few
  ms with no overshoot. A longer lag needs a slower target (or a bigger vscale), not different gains.

2026-10-02  —  Loopback test: the plant measured off the controller's own output (CONFig:FEEDback:SOURce LOOP)
-----------------------------------------------------------------------
  Bench: Phase U wired to PFM_Input_01 (PA15); DAC PA5 -> amplifier -> ADC PA1 as before. The loop commands the Limiter duty; the
  HRTIM produces it on Phase U; the firmware measures that duty on PFM_Input_01, turns it into a voltage with the Limiter model
  (V = gain x vscale x (2D - 1)), applies the digital low-pass (the plant model's lag, SIM:PLANT:TAU 3 ms), puts it on the DAC, and
  the loop reads it back through the real ADC input. Everything but the supply is real.
  New: duty_meter.h / bsp duty_meter.c -- TIM2 in PWM-input mode on PA15 (TI1FP1 resets the counter, CCR1 = period, CCR2 = high
  time), read by polling, no interrupt, no DMA; it borrows TIM2 from the PFM_Input capture and saves/restores TIM2's registers
  around a run (Start refuses while a capture has TIM2's DIER on). SimPlant_StepSteady / SimPlant_LimiterSteady split out of
  SimPlant_Step. SOURce LOOP faults (FB) if no new period arrives for 20 ms, releases the meter whenever a run ends.
  Run: Limiter, SCALE 1 / OFFSet 0.8, VSCALE 0.7, DACRatio 0.552, gains 214.286 / 8571.429, +-0.5 V triangle, 100 ms: ended IDLE,
  no fault, error 30 mV rms / 44 mV max after 5 ms (the constant ramp lag of a PI loop plus the 3 ms plant lag). The duty ran
  8.7-95.0 %, reaching the 95 % limit at the peaks: the 3 ms low-pass makes the loop lead it. Measured duty recovered from the logged
  feedback (inverting the 3 ms lag) = 1.003 x commanded - 2.2 points: slope 1, a constant offset of the order of the dead time
  (open-loop PFM_Input demos showed -1.4 points). Not a test of HVPS; PFMIN captures and this meter cannot run together.

2026-10-02  —  Closed loop on the real ADC path: CONFig:FEEDback:SOURce DAC (hardware in the loop), first real-ADC run
-----------------------------------------------------------------------
  Bench: DAC PA5 -> buffer amplifier(s) with a divider -> ADC PA1 (AnalogIn_02). Sweep after the amplifier was fixed: PA1 =
  0.552 x DAC (+18 mV at 0 V), linear to 11 mV, 1.60 V at the DAC's 2.9 V; the other five inputs read 0. (Earlier iterations of this
  wiring read 0.47 x DAC, a constant 1.66 V, and all-mid-rail; PA1 confirmed as ADC:INPut? 2 with a known voltage for the first time.)
  The loop's actuator is the HRTIM output, which the DAC is not connected to, so a real-ADC test needs the plant emulated:
        CONFig:FEEDback:SOURce DAC   each tick the firmware plant model (SIM:PLANT:*) computes the supply voltage, puts it on
                                     DAC PA5 (process volts -> ADC volts by the feedback calibration -> DAC volts by DACRatio),
                                     and the loop reads the REAL ADC input; the ADC, the amplifier path and the loop are real,
                                     only the supply is a model. It reaches the ADC one tick later than SOURce SIM would.
        CONFig:FEEDback:DACRatio <x> ADC volts per DAC volt of the loopback (default 0.5, 0.05-2; 0.552 measured here)
  Run: Limiter, SCALE 1 / OFFSet 0.8 (the amplifier path only reaches 1.6 V at the ADC, so zero sits at 0.8 V), plant and model
  VSCALE 0.7, gains 214.286 / 8571.429, a +-0.5 V triangle (12.5 ms/ramp, 100 ms). Ended IDLE, no fault; tracking error 30 mV rms,
  43 mV max after 5 ms; the error is the usual constant ramp lag of a PI loop (about +-30 mV, sign flipping with the slope),
  not noise. Duty swung 6.9-93.4 % (the model says 14-86 %): the real path's gain/delay differs from the model, which the loop
  absorbed. Logged with LOG:ARM/LOG:DATA? and plotted (demand vs feedback). Not yet done on this path: HVPS.

2026-10-02  —  Bipolar feedback range (CONFig:FEEDback:RANGE) and the dead-feedback-line fault; the bench fault was miscabling
-----------------------------------------------------------------------
  The "every shot ends in FAULT GENERAL (PE0/PE8 high)" bench problem recorded in the entry below was a MISCABLING on the
  bench, found and fixed by Everett; no firmware change was involved. Re-verified the same day on the simulator, closed-loop
  build: 5 x 50 ms Limiter shots, 0 faults; closed-loop Limiter and HVPS (both branches) against the simulated plant ran to
  IDLE with FAULT:SOURces? all 0 (Limiter 23 mV rms on a 0.8 V triangle; HVPS above/below 125/76 mV rms with untuned gains);
  open-loop HVPS and Limiter 50 ms demos measured on the PFM inputs matched the programmed frequency (mean error < 3 Hz) and
  duty (about -1.4 points).
  Everett's correction of the Limiter feedback: V_out = V_cap (2D - 1) with V_cap about 900 V, and the divider maps -Vmax -> 0 V,
  +Vmax -> 2.9 V (zero volts at 1.45 V), so the ADC never sees a negative voltage. The existing scale/offset calibration already
  expresses this; tested on the simulator with scale 2 Vmax / 2.9 and offset 1.45: a +-720 V triangle in a +-900 V range tracked
  to 20 V rms, 34 V max, shot ended IDLE. Added (decided with Everett: keep every voltage in the loop's own units):
        CONFig:FEEDback:RANGE <Vmax> / RANGE?   one command for the calibration above (scale 2 Vmax / vref, offset vref / 2);
                                                 RANGE? = process volts at the top of the ADC range
        FEEDBACK_VMAX_DEFAULT_V (ctrlr_config.h) compile-time default for it; 0 (uncalibrated) for now -- the real divider
                                                 does not exist yet
        low-end clip fault   an ADC reading at code <= 5 for CLIPTime (10 ms) faults (FAULT:SOURces? FB), but ONLY when the
                             offset is non-zero. On a mid-scale-zero range code 0 means -Vmax or a dead/shorted/wrong-channel
                             feedback line, which the loop would read as a huge negative voltage and answer by driving the output
                             up with nothing behind it. HVPS (offset 0, feedback 0 V at the start of every shot) is not affected.
        CONFig:MAXVolts range raised from 1000 to 10000 (it is in process volts and a 900 V supply needs it above 900).
  Verified on hardware (simulator): RANGE 900 -> SCALE 620.6897, OFFSet 1.4500; bipolar closed loop as above; ADC source with
  nothing wired + RANGE 900 -> FAULT GENERAL with FB=1 after exactly 10 ms (duty had run up to 95 % in that time -- lower
  CLIPTime for a real supply); HVPS with offset 0 and the same unwired ADC -> no fault, ran to IDLE. Host tests added to
  test_feedback (range, low clip counted only with an offset) and test_closed_loop (+-900 V triangle, 52 V worst / 35 V rms =
  exactly the 1 V version times 900; low-clip fault and its reset). Note for tests: +-800 V against Vscale 900 is 98.8 % of what
  a 95 % duty reaches, so the output saturates at the turnarounds; use targets inside about +-0.9 x Vscale x 0.9.
  Gotchas found: FIRE follows PID:LOOPMODE (leave it at 1 0 for open-loop shots, or the closed-loop target plays instead);
  gains are per process volt, so for a 900 V range they are about 900 times smaller than for a 1 V range.
  Closed-loop commands are now documented in command_reference.md.

2026-10-02  —  Closed-loop control: ADC DMA sampler, PID, target profile, live output (hardware outputs were blocked by a bench fault -- miscabling, see the entry above)
-----------------------------------------------------------------------
  Branch closed-loop. Decisions of 2026-10-02 (Everett): reference 2.9 V if possible else 2.5 V; six inputs PA0 PA1 PC0 PB0 PC1 PB1
  with an operator-chosen feedback channel, default PA1; sampling time in config AND settable at run time; HVPS duty fixed
  (default 50 %, within the mode's range) and frequency controlled; HVPS peaks near 19 kHz and falls either side (operate on one
  branch); Limiter V ~ 2D - 1; hard overvoltage 4 V = immediate stop; a closed-loop shot ends by disabling the HRTIM outputs; the
  target voltage is a SEPARATE command set (TARGet:*) because open loop may be used alone.
  Built (all hardware-independent parts host-tested, 3,300+ checks):
        pid_core.c        PID, fixed dt, derivative on the measurement, back-calculation anti-windup at the hard limit and
                          conditional integration at the slew limit (back-calculating at the slew limit stalls the ramp: found by test)
        feedback.c        raw ADC code -> process volts (scale, offset for a bipolar output, low-pass), full-scale clip count
        target_profile.c  target voltage time series (signed, t=0 first, linear, limit per setpoint)
        closed_loop.c     feedforward + PID per supply (HVPS: frequency, either branch of the resonance, polarity from the branch;
                          Limiter: duty, V = Vscale (2D - 1)), overvoltage and clipping faults, profile end. Against simulated plants:
                          Limiter tracks +-0.8 V triangle to 58 mV, both HVPS branches settle to ~5 mV, a 30 % mid-shot plant-gain
                          loss is absorbed.
        shot_profile.c    ShotProfile_StepFor(): the same period/duty clamp the open-loop generator uses (one shared helper; a refactor
                          advanced time by the unclamped period at a mode limit: caught by the test count changing 22017 -> 22016)
  Hardware layer:
        adc.c (rewritten) TIM6-triggered scan of 7 channels (6 inputs + VREFINT) -> DMA2 ch1 circular, block-complete interrupt =
                          the control tick; sampling time settable; VERIFIED on the simulator: 9,999 ticks/s for 10,000 configured,
                          VREFINT 2.906 V, unwired inputs read 0.
        pfm.c             PFM_SOURCE_LIVE: no ring, the per-period interrupt applies the last {per, cmp} the controller stored (one
                          atomic 32-bit store); a stop request ends the shot at a period boundary
        control_runtime.c the loop's runtime, settings, logging; sim_plant.c a firmware plant model so the whole loop runs with nothing
                          wired (CONFig:FEEDback:SOURce SIM)
        Commands (XREX pattern): PID:LOOPMODE, PID:GAINS, SOURce:RUN/STOP/SETpoint/STATus?, TARGet:*, LOG:ARM/DATA? (paged, SUM),
                          CONFig:PIDRate/SLEWRate/MAXVolts/FEEDback:*/ADC:SAMPle/AVERage/CLOSEDloop:*, SIM:PLANT:*; FIRE plays the
                          shot closed-loop when PID:LOOPMODE is 1. New faults OVP and FB in FAULT:SOURces?.
  Reference: VREFBUF at 2.9 V works on this board: VREF+ measured 2.907 V (+0.24 %). It needs VDDA >= 3.15 V; Control_Prepare() refuses a
        closed-loop start on the ADC if VREF+ is more than 3 % from ANALOG_VREF_MV.
  FOUND, NOT RESOLVED -- a bench fault blocks every shot on the simulator today: GateDriverStatus_01 (PE0) and _09 (PE8) read HIGH
        (GDS:LAST? = 0x101) within 40 ms of FIRE, in both modes, open loop or closed, so every shot ends in FAULT GENERAL. The LAST
        KNOWN-GOOD IMAGE (commit 58e8951, which ran shots cleanly yesterday) does the same, and the fault is independent of the ADC
        scan rate and of the 2.9 V reference, so it is NOT this firmware: something on the bench changed. The inputs read LOW whenever
        the outputs are off. Not bypassed: PE0/PE8 may be wired to something real. Needs the user.
  Not yet done: the closed-loop run with REAL output verified through the PFM_Input capture (blocked by the above), the demo/plot tool,
        the closed-loop section of docs/command_reference.md, memory report.

2026-10-02  —  PA0 / PA1 / PB0 / PC0 configured as the four ADC inputs; the analog reference found and fixed
-----------------------------------------------------------------------
  Change:  AnalogIn_01..04 = PA0 (ADC1_IN1), PA1 (IN2), PC0 (IN6), PB0 (IN15). src/drivers/adc.h,
        src/bsp/stm32g4/adc.c (GPIO analog, ADC12 clock HCLK/4, regulator, calibration,
        enable; 12 bit, single-ended, software-triggered, 16x hardware oversampling with a
        4-bit shift, 247.5-clock sampling; registers, no HAL ADC driver),
        src/app/commands/cmd_adc.c: ADC:INPut? <1-4> and ADC:VREF? (the internal bandgap
        against the factory calibration: the real VREF+). Adc_Init() from App_Init().
        New src/drivers/vref.h + src/bsp/stm32g4/vref.c: the internal reference buffer
        (VREFBUF), enabled in App_Init() before the DAC and ADC.
  FINDING -- the board has no external analog reference. docs/pin_mapping_v4.csv: pin 43
        VREF+ is "VREF+ Capacitor". VREFBUF is off at reset, which left VREF+ near 0 V:
        every ADC conversion, even the internal 1.2 V reference, read 4095, a perfectly flat
        value (found with a register read-back: the conversions ran, EOC set, correct
        channel -- the reference was the problem). It also means the DAC change earlier today
        (PA4/PA5, entry below) could not have produced meaningful voltages: its reference was
        the same VREF+, and I had ASSUMED 3.3 V. Corrected here: ANALOG_VREF_MV
        (ctrlr_config.h, 2500) replaces DAC_VREF_MV and ADC_VREF_MV and is the full scale of
        both; the DAC range is 0-2.500 V, not 0-3.3 V.
  Verified on the simulator: ADC:VREF? 2.505 V (30 reads, 2.504-2.506) against 2.500 V
        configured, +0.2 %; unwired inputs read 0.000-0.002 V; bad channel rejected with ERR
        12; DAC full scale 2.500 V, 2.501 V rejected; 14 ADC reads during a 500 ms shot left it
        untouched (10,000 periods played, ring minimum 51); the HVPS reference ramp still gives
        residual -1 tick and exact duty movement.
  A mistake worth recording: I first programmed VREFBUF's voltage select with 2.5 V and 2.048 V
        swapped (code 00 is 2.048 V on the G4, 01 is 2.5 V). ADC:VREF? measured 2.053 V against
        2.5 V configured, which is how it was caught; a DAC scaled for 2.5 V would have been
        22 % wrong.
  NOT verified: any voltage applied to the four input pins (none are driven on this bench) and
        the DAC pin voltages (no meter): the DAC code reaching its output register and the
        reference it scales to are both now verified, the analog pins themselves are not.

2026-10-02  —  PA4 / PA5 configured as the two DAC outputs
-----------------------------------------------------------------------
  Change:  PA4 (AnalogOut_01, DAC1_OUT1) and PA5 (AnalogOut_02, DAC1_OUT2) are analog
        outputs. src/drivers/dac.h (interface), src/bsp/stm32g4/dac.c (GPIO analog, DAC1
        clock, channels 1 and 2 enabled, output buffer on, no trigger/DMA, 0 V at boot --
        driven through the registers like hrtim.c; the HAL DAC driver is not in the
        project), src/app/commands/cmd_dac.c: DAC:OUTPut <1|2> <volts> and DAC:OUTPut?
        <1|2> (volts, code commanded, code read back from the DAC output register).
        Dac_Init() is called from App_Init(). DAC_VREF_MV (ctrlr_config.h) is the full
        scale.
  Verified on the simulator: both outputs at 0 V after boot; 1.65 V -> code 2048, 3.3 V
        -> 4095, 0.5 V -> 620, channels independent; out-of-range voltage and bad
        channel/arguments rejected with ERR 12 and nothing changed; a 0-3.3 V sweep in
        50 mV steps found the DAC output register equal to the commanded code at every
        point (0 mismatches).
  CORRECTION (same day, see the ADC entry above): DAC_VREF_MV = 3.3 V was WRONG. This board has
        no external reference (pin 43 is a capacitor); the internal buffer must drive VREF+ and
        the DAC full scale is ANALOG_VREF_MV = 2.5 V. Not verified at the pin (no meter). The .ioc does not know about the DAC (hand-written, like HRTIM).

2026-10-02  —  Global -O2 build; PFM_Input capture holds a full 50 ms shot; 50 ms demonstrations
-----------------------------------------------------------------------
  Change:  - The project is now built at -O2 (CubeIDE Debug configuration; .cproject and
        every Debug/**/subdir.mk, which sync_build_sources.py takes its flags from).
        Image 74 kB -> 50 kB. Verified on the simulator after the switch: boot and
        update path, the 20->15 kHz HVPS ramp (residual -1 tick, duty movement exact),
        the LIMITER worst cases, both-edge capture, the 1 s shots. The per-function
        -O2 attributes added on 2026-10-01 are now redundant and left in place.
        - Effect on the ring table: with -O2 a 100-entry ring (the original request)
          sustains every shot tried, including 125->75.5 kHz ramps with 10->90 % duty
          in 10 ms and a 5 -> 95 -> 5 % duty triangle over 50 ms at 125 kHz. Only a
          step applied EVERY period at 125 kHz (duty 5 -> 95 % in 10 ms) still empties
          it (309 of 1250 periods, fault TABLE=1); that needs ~1,300 entries. So the
          default PFM_TABLE_SIZE is back to 100.
        - PFM_Input capture depth: PFM_INPUT_MAX_PERIODS (ctrlr_config.h) 200 -> 3,800.
          Timestamps are stored as 16 bits (the DMA's memory size is HALFWORD: it reads the
          capture register as a word and stores the low half; a period is always far below
          65,536 clocks, so differences are taken modulo 65,536), arrays exist only for the
          active inputs (PFM_INPUT_ACTIVE_CHANNEL_MASK now 0x0F = inputs 1-4), and the
          period cache is gone (periods are differences, computed when read). 61 kB for
          4 inputs; RAM 92 kB of 128 kB, 35 kB left above it for heap and stack.
          PFMIN:DATA? pages like PFMIN:RAW? (PFMIN:DATA? <ch> [<start> [<count>]], at most
          400 values per reply) and its reply gained SUM= after OVERCAP=. pfm_shot_test.py
          reads pages and checks every SUM.
        - python/pfm_profile_demo.py: the two 50 ms demonstrations below.
  Demonstrations (simulator, fibre loop, both-edge capture on inputs 1-3, every page
        checksum-verified; regenerate the plots with the tool):
        HVPS  -- duty 50 %, frequency a triangle 10 -> 30 -> 10 kHz, four cycles in
          50 ms (9 setpoints): 1,000 periods played, ring never below 51, 18 refills. U
          follows the programmed frequency to a mean error of +3 Hz (worst 5 Hz); V and W
          show a +-100 Hz offset that flips with the ramp direction, the phase lock
          shifting those phases' edges while the period changes (the same effect the
          residual model in pfm_shot_test.py accounts for), 0.3 % at 30 kHz.
        LIMITER -- 75 kHz, duty a triangle 5 -> 95 -> 5 %, four cycles in 50 ms: 3,752
          periods played, ring never below 51, 55 refills. All three phases follow the
          programmed duty with a constant -1.41 / -1.50 / -1.45 point offset (U/V/W) and
          no spread: the high time is the programmed compare minus the fixed 32-34 clocks
          already established (output SET on CMP3 + dead time).
        W is captured by a different timer than U and V, so its phase to them is not
        measured; the plots say so.

2026-10-01  —  Time-series shot (SHOT:*), interpolating generator, per-period ring table
-----------------------------------------------------------------------
  Change:  A shot is now uploaded as time/frequency/duty setpoints and played through a
        ring table of per-period entries. Branch shot-profile.
        - SHOT:BEGin / SHOT:STEP <t_us> <freq_hz> <duty_pct> / SHOT:END, SHOT:CLEar,
          SHOT?, SHOT:POINt? <i>. First setpoint must be t=0; times strictly increase,
          last time = shot length (<= SHOT_MAX_DURATION_US, 1 s); >= 2 and <=
          SHOT_SETPOINT_MAX (500) setpoints. Frequency (Hz, 3 decimals) and duty (%, 2
          decimals) are checked per setpoint against the supply mode (ERR 10).
        - shot_profile.c: storage, validation and the generator. Linear in time between
          setpoints, one {per, cmp} entry per switching period, all integer math (Q32
          slopes, a 32-bit-divide-only round(CLK*1000/f)), clamped onto the mode's exact
          integer limits. Host-tested (tests/test_shot_profile.c, 22,017 checks incl. the
          division against the 64-bit formula at 79,175 frequencies in both modes) and
          ported exactly to Python (pfm_shot_test.py generate_profile(), held to the C
          golden values by its selftest).
        - pfm.c: the table is a ring (PFM_TABLE_SIZE); head/tail counters with one writer
          each, so the per-period interrupt (priority 1) preempts the refill (priority 2,
          the unused FMAC vector as a software interrupt, mcu.h Mcu_RefillIrqPend())
          without a lock. The ring is filled inside FIRE before the first period. An
          empty ring before the shot is over stops the shot and latches a fault (new
          source for FAULT GENERAL; FAULT:SOURces? reports PC10/GATEDRV/TABLE/TEST).
          TABle:* stays as a <=PFM_TABLE_SIZE bench path; the last upload to finish is
          what FIRE plays.
        - ctrlr_config.h: SHOT_SETPOINT_MAX 500, SHOT_MAX_DURATION_US 1 s, PFM_TABLE_SIZE
          (compile-time, with #error range checks). The old 5000-entry table (40 kB) is
          gone; RAM is 42.8 kB of 128 kB with the default ring.
        - PFM:DIAG? grew: interrupt busy cycles, ring minimum, refills, entries generated,
          refill wall time, fill time. pfm_shot_test.py / pfm_edge_test.py now upload
          SHOT:* (--duration-ms); pfm_table_upload.py is marked legacy.
  Verified on the simulator: command rules and limits (all of them, plus 500 setpoints
        and the ERR 3 beyond); a 176-period HVPS ramp played exactly as the Python
        generator predicted (residual -1 tick, duty movement +3335 programmed = +3335
        measured); 1 s shots, 20,000-125,000 periods, in both modes and across ramps;
        every 10 ms LIMITER worst case with the 1,300 ring.
  FINDING, shapes the default: the project builds at -O0 (CubeIDE Debug). The refill gets
        only the CPU the per-period interrupt leaves. Measured: the interrupt body costs
        ~590 cycles with nothing to apply and ~1,270 when every period applies a step; the
        generator started at ~1,620 cycles per entry. Done here, narrowly and measured at
        each step: generator + FillRing at -O2 (pragma/attribute; the pure logic is
        host-tested identically), a 3-divide period computation (240 cycles per entry),
        the playback path (PFM_CycleBoundaryHandler/ApplyCurrentStep, HRTIM1_Master_
        IRQHandler, HRTIM1_ApplyPfmStep and its register-address helpers) at -O2. Result:
        with a 100-entry ring, HVPS is fine everywhere and LIMITER shots that change nothing
        or change slowly are fine to 125 kHz, but a step applied EVERY period (a duty or
        frequency ramp) is sustainable by refill only to ~80 kHz (duty 20->80 %: 75 kHz ok,
        85 kHz stopped at 468 of 850 periods, 95 kHz at 177). A 600-entry ring covered
        125->75.5 kHz but not duty 5<->95 % at 125 kHz; 1,300 entries (10 ms at 125 kHz =
        1,250 periods) held every worst case, so that is the default (it was 100 as first
        requested: the Limiter is the PWM supply, where duty ramps above 80 kHz are the
        main use). 1 s at 125 kHz constant finished with the ring's low-water mark at 1:
        no margin. NOT changed: the project-wide optimization level (a decision with
        effects on all the timing-critical HRTIM code); a global -O2/-Os build is the real
        lever for a smaller ring.
  Not fixed: the HRTIM register writes of a step (~680 cycles at -O2) remain the per-step
        cost; profiling them is the next step if a small ring is wanted for the Limiter.

2026-09-30  —  PFM_Input capture rewritten: bounded DMA into the result array (fixes capture loss at high rate)
-----------------------------------------------------------------------
  Symptom: from 100 kHz up, inputs 3 and 4 (TIM5) lost most of a both-edge shot
        (frequency sweep entry above: UN 14 of ~100 edges at 125 kHz, some with
        stale or out-of-order data), TIM2 inputs held up.
  Diagnosis (measured on the simulator, not guessed): rising-only and both-edge runs
        showed NO DMA overrun (worst backlog 8-11 of 32 entries) and the master
        interrupt at 40-65 % CPU, but channel 4's half-transfer callback never ran
        (0 callbacks, 53 edges stored, flags pending) while channels 1-3 ran in
        rotation. An event trail (timestamped callback entry/exit) showed each
        16-edge chunk costing about 24 us wall time (HAL DMA handler + chunk loop,
        preempted by the per-period interrupt). Four channels x one chunk per 80 us
        asks for more CPU than exists, so the last channel in line is starved.
        Secondary: capture was started AFTER the outputs and each of the four
        Start_DMA calls took ~20 us with the master interrupt running, so the fourth
        channel started ~80 us (8 periods at 100 kHz) late.
  Fix (src/bsp/stm32g4/pfm_input.c, rewritten): the capture is bounded (M periods =
        M+1 edges, or 2M+1 both-edge, at most PFM_INPUT_MAX_EDGES), so each DMA
        channel is NORMAL mode and writes the capture register straight into the
        channel's result array g_stamp[] and stops itself when full. No ring buffer,
        no chunk processing, no tail flush, no wrap/stale-data handling; the edge count
        is (requested - CNDTR) read when the shot ends or the DMA completes. Periods
        are computed from the stamps when PFMIN:DATA? asks. Two DMA interrupts per
        capture per channel, nothing per edge. PFM_Restart() now starts the capture
        immediately BEFORE HRTIM1_PWM_Start(), so nothing is missed and the capture
        includes the shot's start-up period.
  Result (simulator, fibre loop, checksum-verified readback): 27 shots x 4 inputs,
        75/100/125 kHz x 5-95 % duty, 50 and 200 periods: 17,934 edge deltas, none
        out of order, none stale, none out of pattern except the first pulse (the
        real start-up pulse, now visible) and the last (truncated where the outputs
        are forced off); 97-100 % of the requested edges on every channel (was 14-48 %
        on inputs 3/4 at 125 kHz). High-time offsets exactly U -32, V -34, W -33 (-32
        once), UN 0 ticks at every point. Rising-only (PFMIN:DATA?) re-checked with
        the HVPS 20->15 kHz ramp: 200/200/200/199 periods, residual -1 tick, duty
        movement +1397 programmed vs +1397 measured.
  Also:  - PFMIN:RAW? <ch> [<start> [<count>]] pages the reply and adds SUM= (sum of
           the numbers in the reply, mod 2^32). The ethernet serial bridge loses a
           character at a FIXED place in replies of about 1.7 kB or more (token 379 of
           a 401-value reply, 7 of 8 reads) and randomly elsewhere; the firmware sends
           with a plain blocking transmit and has no buffer limit. The earlier "two
           identical reads" check could be fooled by the fixed-place loss and is gone;
           the 366-vs-3366 V pulse in the first edge test was this, not a capture
           effect. pfm_edge_test.py reads 100-value pages and accepts one only if SUM
           matches.
         - PFM:DIAG? gained two fields: worst-case and total cycles spent inside the
           per-period table interrupt.
         - pfm_shot_test.py: the normal alignment is now 2 (was 1) and the first
           (start-up) period is exempt from the readback sanity check.
         - OVERCAP is reported only for a capture the shot end cut short, and is not a
           reliable loss detector (set on ~1 in 10 of those, data clean).
  NOT fixed, found on the way (pre-existing, unrelated to the capture): the per-period
        table interrupt takes ~1,700 cycles on a ramp (every step rewrites PER and all
        compares) against a 1,360-cycle period at 125 kHz, so the CPU saturates in it
        and the table advances at about 93 kHz worth of steps, not one per period: a
        125 -> 75.5 kHz 200-step ramp came out ~36 periods behind (residual mean -75
        ticks). Constant-table shots cost ~600 cycles. The same circular-buffer design
        still sits in WHAM-XREX-PFMG474 (not touched).
  Verified: simulator over the network, branch pfm-input-edges.

2026-09-30  —  PFM_Input both-edge capture across the LIMITER range (75-125 kHz, 5-95 %)
-----------------------------------------------------------------------
  Test:    python/pfm_edge_test.py --mode LIMITER --freqs 75000,100000,125000
        --duties 5,15,35,50,65,85,95 (50-period shots, simulator, U/V/W/UN by fibre
        on inputs 1-4); python/pfm_edge_plot.py draws it. (75 kHz is not exactly
        representable: period rounded down, 75.03 kHz; duty clamped into 5-95 % with
        the board's own exact integer rule.)
  Measurement: wherever an edge stream was captured cleanly, high + low equals the
        period to the tick and the high time is compare - 32 (U), - 34 (V), - 33 (W),
        UN exactly per - compare, with NO dependence on frequency or duty, down to a
        36-tick (212 ns) pulse at 125 kHz / 5 % and a 100-tick gap at 95 %. Duty is
        therefore recoverable to 1 tick across the whole LIMITER range.
  Capture quality (NOT good at the top of the range): edges captured per channel,
        of ~100 in the shot, mean over duties:
            75 kHz   U 89  V 97  W 93  UN 92
           100 kHz   U 97  V 94  W 86  UN 54
           125 kHz   U 96  V 91  W 48  UN 14 (0-36; 0 edges at 50 and 95 %)
        Inputs 1/2 (TIM2) hold up; inputs 3/4 (TIM5, DMA1 ch 3/4, the higher IRQ
        numbers) lose edges from 100 kHz and OVERCAP=1 is common from 75 kHz.
        Corrupt data seen at 125 kHz, not just missing data: negative deltas on V
        (timestamps out of order, e.g. 4294964578), and UN at 125 kHz / 5 % holds the
        PREVIOUS shot's 85/1614 pattern (stale buffer contents, sum 1699 not 1359).
        Consistent with DMA/ISR servicing falling behind (the HRTIM master interrupt
        runs every period, at a higher priority than the DMA interrupts, and the
        32-entry buffers are read a half at a time) -- the cause is NOT yet measured.
        The stale-data case also says the end-of-shot flush can hand back old buffer
        contents when the channel's DMA made no real progress; the same hole exists
        in rising-only mode. Not fixed in this entry.
  Ideas, untried: larger DMA buffers; DMA interrupt priority above the master
        interrupt; clear the buffer at capture start; reject a flush whose data
        predates the capture; time the master ISR to see the actual CPU load.

2026-09-30  —  PFM_Input raw both-edge mode: duty-cycle re-exploration
-----------------------------------------------------------------------
  Change:  New PFMIN:EDGes <ch> RISING|BOTH / PFMIN:EDGes? / PFMIN:RAW? <ch>.
        A channel in BOTH mode captures every edge by DMA and keeps the raw timer
        values; the host decodes rise/fall by alternation from LEVEL (the pin
        level before the first captured edge). Polarity is set only while the
        channel is stopped (at PFMIN:CAPTURE); no polarity flip in an ISR, no GPIO
        read to classify edges, no per-edge interrupts -- none of the mechanisms
        of the 2026-09-08 XREX attempts. PFMIN:DATA? refuses a BOTH channel (ERR 13).
        Tool: python/pfm_edge_test.py.
  Result (HVPS 20 kHz, 80 steps, constant duty, simulator, U/V/W/UN by fibre on
        inputs 1-4): the old "period doubled / one period late" failure does NOT
        reproduce. High + low = 8499 ticks on every channel (period - 1 tick, as
        with period-only capture), high and low each steady to 0-1 tick.
        Programmed cmp 3400 / 4250 / 5099 read as: U high 3368 / 4218 / 5067
        (cmp - 32), V cmp - 34, W cmp - 33, UN high per - cmp (5099 / 4249 / 3400)
        and low = cmp. So duty is measurable to a tick from one input, with a
        fixed, explained offset (SET at CMP3 = 16 ticks plus dead time, and the
        fibre link's edge asymmetry is not visible above the 1-tick noise).
  Bugs found and fixed on the way (both were in this session's new code path,
        the second also latent in rising-only mode):
        - level was sampled BEFORE starting DMA; V's rising edge landed in that
          window (starting the channels takes microseconds), so LEVEL read low with
          V already high and high/low came out swapped. Now sampled after capture
          is enabled and corrected by the edges already captured.
        - the end-of-shot tail flush treated a wrapped DMA write position as "no
          new edges" and dropped up to 15 edges (144 of 161 on inputs 1/3). Now
          handles the wrap; 161/159/160/159 captured.
  Not explained: PFM_Input_2 still reports OVERCAP=1 every run and inputs 2/4 end
        two edges short (159 vs 161); one V high read 366 instead of 3366 in one run
        (position 139 of 158, twice-identical readback) -- a real short pulse or a
        repeatable serial-bridge character loss, not resolved. The last pulse of a
        shot is truncated where the outputs are forced off (U 1008, W 3839), as
        expected. 100-125 kHz (LIMITER) not tried: edge spacing at 2x rate is the
        thing to check next for DMA overrun.
  Verified: simulator over the network, v0.9 build with these changes (image not
        yet published as a release; branch pfm-input-edges).

2026-09-29  —  Renamed WHAM-SWITCH-PFMG474 -> WHAM-HBRIDGE-PFMG474; port plan started
-----------------------------------------------------------------------
  Change:  The firmware drives the Limiter (PWM) and HVPS (PFM) H-bridge supplies
        (3 channels U/V/W with complements and dead time, 12 gate-drive fault
        inputs), so "switching supply" was too vague and the repo is renamed to say
        what the hardware is. Pure rename, no functional change: project name in
        .project/.cproject/.ioc/.launch, HW_BOARD_NAME ("*IDN?" now reports
        WHAM-HBRIDGE-PFMG474), the Debug/ artifact names, python/ tool defaults, the
        SOP file names, README and AGENTS.md. FW_VERSION_STRING stays v0.6. The
        project folder was renamed with it (the Debug makefile embeds the absolute
        project path). Clean rebuild: no warnings; the image is 4 bytes larger than
        the old-name build (the longer name string), nothing else differs.
        docs/memory_history.csv / docs/memory_report.html still carry the old name
        in their history; python/memory_report.py's backfill looks for the NEW
        artifact name, so it only sees commits from this one on until Phase 1 moves
        images to build/ (as in WHAM-XREX-PFMG474) with a fallback for older commits.
        Historical entries below predate the rename and are kept verbatim.

2026-09-30  —  python/pfm_shot_test.py: programmed shot vs PFM_Input measurement, with plot
-----------------------------------------------------------------------
  Change:  New host tool. Builds a table (frequency and duty ramp, up to the 200 periods the
        capture holds), uploads it, arms PFMIN:CAPTURE, ARM + FIRE, reads PFMIN:DATA? back
        and plots programmed vs measured frequency. Replies damaged by the ethernet bridge
        (a dropped digit turns 10473 into 1473) are detected and re-read; the tool found
        one or two damaged replies per shot. The analysis finds each capture's alignment
        (the capture starts a period before the table) and removes the phase-lock shift a
        changing period puts on V, W and the complement (V/W at 1/3, 2/3 of the period,
        UN at duty + 17 ticks dead time). --selftest (no hardware), --from-json replay.
  Measured on the simulator board (U,V,W,UN over fiber into PFM_Input_1..4), HVPS:
        20 -> 15 kHz ramp: every channel follows the table; residual vs the model -1 tick
        (U spread 0.00, V 0.29, W 0.65, UN 0.10 ticks). 40 -> 60 % duty ramp at 20 kHz:
        the duty MOVEMENT reconstructed from (UN period - U period) matched the table,
        +1682 ticks programmed vs +1682 measured, worst step 1 tick (6 ns). The duty LEVEL
        is not measurable: the capture stores periods only.

2026-09-30  —  Operator-selectable supply mode: LIMITER / HVPS frequency and duty limits
-----------------------------------------------------------------------
  Change:  CONFig:MODE LIMiter|HVPS, CONFig:MODE?, CONFig:LIMits? (cmd_config.c) and a new
        src/app/control/supply_mode.{h,c}. LIMITER (PWM): 75-125 kHz, 5-95% per-phase
        duty. HVPS (PFM): 10-30 kHz, 40-60% duty -- the older PFM-STM32G474 project's
        bounds, confirmed by the maintainer. Duty is compare/period. Every TABle:STEP is
        checked against the selected mode (exact integer math: a step on a limit is
        accepted, one per count outside is refused, ERR 10 with a message naming the
        limit). Decisions (asked, 2026-09-30): boot mode NONE -- TABle:BEGIN/STEP are
        refused (ERR 13) until a mode is selected -- and duty limits are enforced too,
        not only frequency. CONFig:MODE is IDLE-only; a mode CHANGE discards the table.
        The old fixed 100 kHz ceiling (PFM_MAX_CARRIER_FREQ_HZ, ERR 10) is gone:
        that constant now equals the Limiter maximum (125 kHz). ERR 10 renamed
        ERR_OUT_OF_MODE_LIMITS (same number). python/pfm_table_upload.py gained --mode
        and refuses to upload with no mode selected; its profiles 6-10 start at 60 kHz and
        so fit neither mode (profiles 1-5, 100 kHz / 10-90% duty, fit LIMITER).
        CAUTION recorded in ctrlr_config.h, AGENTS.md and the command reference: the HRTIM
        SET/RESET-collision fix was confirmed on a logic analyzer only to 100 kHz, so
        100-125 kHz is unverified. Host test tests/test_supply_mode.c (51 checks).
        Also fixed: python/sync_build_sources.py now takes the vendor/startup objects for
        Debug/objects.list from their tracked subdir.mk files instead of the old, untracked
        list -- after it lost them the link silently produced a ~100-byte image.

  Verified on the WHAM-XREX simulator board (network update to v0.9, then over the
        bridge; 80 command checks, all as designed): boot mode NONE (MODE?/LIMits? -> NONE,
        TABle:BEGin -> ERR 13); MODE with no/bad argument -> ERR 12; both modes' limits
        read back correctly; every boundary exact -- LIMITER per 1359 (125.000 kHz) and 2265
        accepted, 1358 and 2266 refused, duty 5%/95% per channel (each channel checked on its
        own) accepted at the limit and refused one count outside; HVPS per 5666 and 16999
        accepted, 5665 and 17000 refused, duty 40%/60% likewise; a step for the other mode's
        range is refused; wrong token count still ERR 4. A mode change emptied the table
        (TABle? 0); re-selecting the same mode kept it; CONFig:MODE while ARMED -> ERR 13,
        mode and table untouched; while in FAULT -> ERR 13. Short shots ran through the state
        machine: HVPS 20 steps at 20 kHz (PFM:DIAG? 20 periods, max gap 8607 cycles) and
        LIMITER 20 steps at 125 kHz (20 periods, max gap 1361 cycles = one 125 kHz period).
        (One check in the test script had a wrong expected count; the firmware's value was
        correct.) NOT verified: the actual waveform at 100-125 kHz -- only the interrupt
        timing was observed, no logic analyzer or scope.

2026-09-29  —  Phase 3: operating-state machine and fault handling (v0.8)
-----------------------------------------------------------------------
  Change:  New src/app/control/state_machine.{h,c} (mirrors WHAM-XREX-PFMG474's API
        and names), src/app/task_faults.c (TaskFaults_Poll, first in App_Poll), and
        cmd_state.c's ARM / DISARM / STATE? / GENERAL:TEST:FAULT. IDLE -> ARM -> ARMED
        -> FIRE -> FIRING -> table ends -> IDLE; every shot needs its own ARM.
        ONE fault type (SM_FAULT_GENERAL, per direct instruction): PC10/HRTIM1_FLT6,
        any GateDriverStatus input, or GENERAL:TEST:FAULT -> FAULT from any state,
        immediate PFM_ForceStop() (no ramp). FAULT:CLEAR goes through SM_ClearFault(),
        which clears both sources (each re-checks its input) and returns to IDLE only
        if both are healthy. Shot completion and fault latching are both found by
        SM_PollFaults() in the main loop with interrupts masked, so no ISR calls into
        the state machine; the hardware/EXTI paths still make the output safe first.
        Behavior changes on the wire: FIRE needs ARMED (ERR 13), TABLE:BEGIN/STEP
        refused while FIRING (ERR 13), BOOT refused while ARMED/FIRING (ERR 13),
        FWUPdate:* needs STATE IDLE (was "output stopped"), FAULT? also reports 1 in
        the FAULT state, the !BOOT banner's STATE= is the real state (FAULT if a fault
        was present at boot). Not ported: PF13/PF15 external enable/trigger (skipped
        per instruction), DEBUG:FAULT:BYPASS, ramp-downs, per-channel fault types,
        telemetry events. New host test tests/test_state_machine.c (146 checks: normal
        shot, disarm, empty table, fault from every source in every state, clear
        refused while the input is still bad, ARM/FIRE refused with a latched source,
        fault beats shot completion, no nested critical sections). SOP Rev D.

  Verified on the WHAM-XREX simulator board (network update to v0.8, then over the
        bridge, with a 5000-step / 1.9 s shot so every "while FIRING" check was made
        after STATE? had just read FIRING):
        - boot: STATE? IDLE, FAULT? 0; FIRE unarmed -> ERR 13; ARM twice -> ERR 13;
          FIRE with an empty table -> ERR 5 (stays ARMED); DISARM -> IDLE
        - while FIRING: TABLE:BEGIN -> ERR 13 (table kept: TABLE? 5000 afterwards),
          FWUPdate:BEGin -> ERR 13, ARM -> ERR 13, FIRE -> ERR 13; the shot then ran
          to the end by itself (PFM:DIAG? 5000 periods) and STATE? returned to IDLE
        - GENERAL:TEST:FAULT from IDLE, ARMED and FIRING -> FAULT GENERAL each time;
          in FAULT, ARM -> ERR 6, FIRE/FWUPdate -> ERR 13, FAULT? 1; FAULT:CLEAR -> IDLE
        - fault mid-shot stopped the output at once: PFM:DIAG? 356 periods, unchanged
          0.5 s later
        - a full 5000-period shot after recovery
        Not exercised on hardware: a real PC10 or GateDriverStatus trip (the simulator's
        gate-drive inputs read healthy; the host test covers both sources), and BOOT's
        ARMED/FIRING refusal (host-tested only -- an earlier test run sent BOOT after a
        too-short shot had already ended, so the board correctly entered the ROM
        bootloader and needed a power cycle; nothing was erased).

2026-09-29  —  Phase 2: in-application firmware update, boot diagnostics, !BOOT banner
-----------------------------------------------------------------------
  Change:  Ported from WHAM-XREX-PFMG474 (see AGENTS.md "Current functionality" and
        docs/command_reference.md): FWUPdate:* dual-bank update over the serial link,
        .noinit boot record + three-line !BOOT banner, DIAGnostic:OPTBytes?/RSTCause?/
        RSTCause:CLEar, git commit as the 4th *IDN? field. New interfaces flash_bank.h,
        boot_diag.h; mcu.h extended. Until the Phase 3 state machine exists the update
        gates on "output stopped" (PFM_GetState() == STOPPED) instead of STATE IDLE.
        Error codes 12/13/17 keep the XREX numbers (11, 14-16 reserved). Host tools:
        fw_update.py (single product), net_broker/net_client/net_terminal. SOP Rev C.
        FW_VERSION_STRING v0.7. Compared with the Phase 1 image: 323 functions identical,
        9 changed (the hooked callers, command table, *IDN?, main).

  Verification on the WHAM-XREX simulator board (same PCB), all over the ethernet
        bridge after one ST-Link flash of the first Phase 2 image:
        - load + verify into bank 2 without swapping; then SWAP -> banner
          "BANK=2 BFB2=1", diag "prev: stage=9 ... rst=OBL,PIN," (as designed)
        - full update from bank 2 (erasing/rewriting physical bank 1) and swap: banner
          0.14 s after the swap ack, [ok] running v0.7 008dc35d from bank 1
        - ROLLback back to bank 2: banner 0.14 s after the ack
        - error paths: DATA/END/SWAP with no transfer -> ERR 13; bad BEGin args -> ERR 12
        - gate: FIRE of a 1300-step table, then FWUPdate:BEGin 0.11 s later -> ERR 13
          "firmware update needs the output stopped"; after the shot BEGin is accepted
        - DIAGnostic:OPTBytes? OPTR=BBEFF8AA (bank 1) / BBFFF8AA (bank 2, only BFB2
          differs); RSTCause? after the banner cleared the flags: all 0
        Board left running v0.7 008dc35d from bank 2 (BFB2=1), the same image verified
        in bank 1, so ROLLback works.

  Observed, not a firmware fault: during a long table upload the board reset once
        with "rst=PIN," and "prev: stage=8" (i.e. it was running normally in the main
        loop). The NRST pull-up was off and the ST-Link's NRST wire disconnected at the
        time, so NRST was floating -- exactly the condition hard-won invariant 4
        describes. The reset also cleared the uploaded table, so the first gate-test
        run fired nothing and its FWUPdate:BEGin (8-byte probe) was accepted and erased
        one page of the inactive bank; that bank was rewritten and re-verified with
        fw_update.py --no-swap. Refit the NRST pull-up before relying on this board.

2026-09-29  —  Phase 1: restructured onto the layered src/ layout (behavior-preserving)
-----------------------------------------------------------------------
  Change:  Ported the source layout, host tests and build tooling from
        WHAM-XREX-PFMG474 (AGENTS.md "Source layout" now applies here). Core/ is
        CubeMX-generated code only; hand-written code moved to src/{config,drivers,
        bsp/stm32g4,middleware/scpi,app}. HAL types and handles moved behind *_hw.h
        headers (uart_hw.h, hrtim_hw.h, pfm_input_hw.h); new HAL-free interfaces
        mcu.h (cycle counter, SysTick priority) and board_io.h (the 12
        GateDriverStatus inputs: pin/EXTI setup moved verbatim out of MX_GPIO_Init()
        into BoardIo_Init(), plus the raw read). cmd_parser.c became the generic
        scpi_parser.c (middleware) plus command_table.c; commands.c was split into
        cmd_system/table/config/state/io/pfmin.c with SendErr() and the error codes
        (cmd_err_t, values 1-10 unchanged) in cmd_common.*. main.c is generated code
        plus uart_bind()/App_Init()/App_Poll(); start-up and the main loop are
        src/app/app.c, and the SCPI poll is a task (task_scpi.c). No command,
        reply, error code, or hardware sequence changed.
        Tooling: python/wham_build.py (single target), sync_build_sources.py,
        check_layout.py, gen_git_version.py, tests/ (SCPI matching 36 checks,
        command-table reachability 37 checks); images are published to build/ and the
        Debug/ build byproducts (.o/.d/.list/.map/objects.list) are no longer tracked
        (Debug/ makefiles stay tracked). memory_report.py replaced by XREX's version
        (reads build/, falls back to Debug/ and the old-name artifact for history).

  Verification: the pre-restructure image (built from the rename commit) was
        compared with the new one function by function (normalized disassembly),
        the data objects, the vector table and the string set. 314 of 323 functions
        are byte-identical; the 9 that differ are exactly the expected ones:
        removed FixSysTickPriority / dispatch_command / uart_init / uart_process,
        new App_Init/App_Poll/BoardIo_*/Mcu_*/Commands_Dispatch/TaskScpi_Poll/
        scpi_dispatch/uart_bind/uart_start/uart_take_line, and 5 changed callers
        (GateDriver_Read now calls BoardIo_ReadGateDriverStatus, whose body is the
        old inline read instruction for instruction; MX_GPIO_Init calls BoardIo_Init
        -- the HAL call sequence is identical; PFM_Init/PFM_CycleBoundaryHandler call
        Mcu_CycleCounterStart/Mcu_CycleCount instead of touching the DWT inline --
        one extra call in the diagnostic path; main). main()'s call order is
        identical. All 66 data objects match; the only vector-table difference is
        Reset_Handler's address. The one string difference is "ERR 1 Unknown command"
        (now built by SendErr from "Unknown command"; same bytes on the wire).
        HARDWARE SMOKE TEST (2026-09-29, on the WHAM-XREX simulator board -- same PCB --
        flashed with the ST-Link, then driven over the network bridge): PASSED.
        *IDN? "OK WHAM-HBRIDGE-PFMG474 REVA v0.6"; CONFig:CHANnels? 3; TABle?/FAULT?/
        GDS? (12 x LOW)/QSPI:ID? (EF 40 18)/PFMIN:STATus?/PFM:DIAG? all as expected;
        unknown commands -> ERR 1; short (TAB?) and long (table?) forms accepted;
        TABle:STEP before BEGin -> ERR 2, wrong count -> ERR 4, value > 65535 -> ERR 4,
        per below the carrier limit -> ERR 10, FIRE with an empty table -> ERR 5; a
        10-step 100 kHz table uploaded (TABle? 10), FIRE twice: PFM:DIAG? "10 1700 10"
        (10 interrupt calls, max gap 1700 cycles = one 100 kHz period, i.e. the same
        timing the pre-restructure firmware showed), gap log 1654..1701. Not exercised:
        the fault-latch path (the simulator's gate-drive inputs are not driven) and
        PFM_Input capture (no loopback wired). The option bytes were unchanged
        (0xBBEFF8AA). The SOP still describes Debug/ paths and needs a rewrite for
        build/ and wham_build.py.

        Incident, for the record: the first ST-Link flash attempt failed midway through
        the erase (the SWD link dropped) and left bank 1 partly erased. The chip was
        recoverable; it could not be halted while NRST floated (pull-up lifted, ST-Link
        NRST wire not driving it). Attaching with the ST-Link's NRST wire DISCONNECTED and
        openocd "reset_config none" (SWD only, core halted through the debug port) worked
        at once: erase, program and verify OK, then a soft reset and a normal boot.
        Bank 2 (the XREX image) was never touched.

  Plan (agreed 2026-09-29), porting from WHAM-XREX-PFMG474, each phase verified:
        Phase 1  restructure onto the layered src/ layout (behavior-preserving,
                 proven by comparing images), host tests, build tooling
        Phase 2  in-application dual-bank firmware update + boot diagnostics; the
                 NRST pull-up / BOOT0 / option-byte hardware notes
        Phase 3  operating-state machine (IDLE/ARMED/FIRING/FAULT); every fault
                 source is one fault type; latched, FAULT:CLEAR re-checks the pins
        Phase 4  saved-profile architecture (QSPI flash, *SAV/*RCL/preview) with no
                 application-specific field table yet
        Phase 5  telemetry architecture (!EVT stream, flight recorder, SYS:TIME?)
                 with no application-specific events yet
        Not ported: the PID loop, Transrex ENA_OUT/CONTACT_OUT, per-channel OCP
        derate, the simulator.

2026-09-09  —  Renamed/relocated from WHAM-PFMG474-V4 (no functional
               change)
-----------------------------------------------------------------------
  Change:  Reseeded (not a GitHub fork -- see AGENTS.md's "Provenance")
        from WHAM-PFMG474-V4 at commit de83324, full working snapshot,
        fresh git history. Pure rename, not a new architecture or a new
        board: this repo's firmware is byte-for-byte the same switching-
        supply application WHAM-PFMG474-V4 already was, just given its
        own explicit name now that a real sibling project exists doing a
        DIFFERENT application on the same hardware
        (WHAM-XREX-PFMG474 -- closed-loop PID control for the Transrex
        magnet supplies, reseeded from this same de83324 commit the same
        day). "Switching supplies" / "Transrex supplies" is the intended
        naming going forward, rather than one project implicitly
        carrying the legacy "V4" name and the other not.

        Board/firmware identity renamed and re-verified with a clean
        rebuild: .project/.cproject/.ioc/.launch project name,
        HW_BOARD_NAME, the Debug/ build artifact name.
        FW_VERSION_STRING deliberately left at v0.6 (NOT reset to v0.1
        the way WHAM-XREX-PFMG474's was) -- this is a continuation of
        the same firmware's version history, not a fresh start.
        HW_BOARD_REV left alone -- same physical PCB. Historical entries
        below this one predate the rename and describe this exact
        codebase's own development under its old name -- kept verbatim,
        they're still genuinely this project's own history.
        docs/memory_history.csv / docs/memory_report.html were NOT
        carried over (they reference WHAM-PFMG474-V4's own commit SHAs
        under the old repo identity, which won't match this repo's new
        commit history going forward) -- python/memory_report.py itself
        was kept and will build fresh history from this repo's own
        commits from here on.

        WHAM-PFMG474-V4 itself was not modified by any of this -- it
        continues to exist under its original name; whether it's kept
        as an archival copy or retired is open, not decided here.

  Files:  none functionally -- identity/rename only.

2026-09-09  —  Memory footprint tracking: python/memory_report.py, tracked
               per commit since project start
-----------------------------------------------------------------------
  Change:  Requested: visualize flash/RAM usage, what it's for, and what
        remains, tracked over the project's lifetime and kept current in
        future commits. New python/memory_report.py, two pieces:

          1. `history` -- reads a built .elf with arm-none-eabi-size (total
             flash/RAM) and arm-none-eabi-nm --print-size -l (per-symbol,
             with DWARF file:line from this project's -g3 builds) and
             appends one row to docs/memory_history.csv: totals plus a
             byte count per source-file "module" bucket (PFM table engine,
             PFM_Input capture, HRTIM driver, ST HAL library, etc.), split
             into flash and RAM. `--backfill` rebuilds the whole CSV in one
             pass from every past commit that has a Debug/WHAM-PFMG474-V4.elf
             checked in (this project tracks Debug/ build output in git,
             confirmed useful here beyond its original purpose) -- no
             rebuilding needed, `git show <rev>:Debug/WHAM-PFMG474-V4.elf`
             pulls each historical binary directly. Backfilled all 5
             commits with a tracked elf, back to the initial commit
             (2026-09-04).

          2. `report` -- renders docs/memory_report.html from that CSV: a
             self-contained dashboard (Google Fonts is the only external
             request; everything else inline, no build step) with a
             utilization-over-lifetime trend chart (Flash % / RAM % per
             commit, hand-rolled SVG with a crosshair tooltip), two stat
             tiles (used/remaining + sparkline), and two current-breakdown
             bar charts (Flash by module, RAM by module, hover tooltips).
             Both light and dark themes defined as CSS custom properties
             (verified via computed-style, not just eyeballed, since a
             local-file preview forces light rendering regardless of CSS).

        Design decision, the one non-obvious part: per-module attribution
        reads the LINKED elf's own retained symbol table, not a per-.o
        `size` sum. This project's Makefile builds with
        -ffunction-sections/-fdata-sections and links with --gc-sections;
        a raw .o's size includes every function the compiler emitted for
        that translation unit, even ones the linker later discards as
        unreachable -- checked directly: summing every HAL driver .o in
        this build totals ~94 KB of .text for HAL alone, while the FINAL
        linked .text is only ~48.5 KB for the ENTIRE firmware. Reading
        attribution off the linked elf's nm output avoids this: every
        symbol counted is genuinely in the binary. One real wrinkle
        handled explicitly: ~84 unimplemented IRQ vector names are weak
        aliases of one shared Default_Handler (same address) -- deduped by
        (address, size, type) before summing, or that alone would have
        been counted ~84 times over. The nm-vs-`size` gap that remains
        (alignment padding, the raw .isr_vector table, a few anonymous/
        mergeable symbols -- ~1.7 KB flash, ~1.6 KB RAM at the current
        commit) is rolled into an explicit "Padding / unattributed" bucket
        rather than silently dropped, so a breakdown chart's total always
        equals `size`'s own authoritative number.

        Current snapshot (a764a01, this commit): flash 51,312 / 524,288 B
        (9.8%), RAM 55,368 / 131,072 B (42.2%) -- RAM dominated by
        g_pfmTable (PFM table engine, ~39.9 KB, PFM_TABLE_SIZE=5000 *
        (2+2*HRTIM_NUM_CHANNELS) bytes/entry) and PFM_Input's per-channel
        capture buffers (~6.4 KB); flash dominated by the ST HAL library
        (~27.4 KB, mostly stm32g4xx_hal_tim.c/_uart.c/_hrtim.c).

        Standing instruction added (AGENTS.md, and this session's own
        memory) to regenerate both files after any commit that changes
        flash/RAM usage -- same "proactive, not just when asked"
        convention as this changelog itself.

  Files:  python/memory_report.py (new), python/memory_report_template.html
        (new), docs/memory_history.csv (new), docs/memory_report.html (new,
        generated -- do not hand-edit), AGENTS.md

2026-09-09  —  Real PFM output falls ~77 periods behind on a long table
               hold: root-caused to a stale NVIC priority inversion,
               FIXED and CONFIRMED on real hardware
-----------------------------------------------------------------------
  Change:  Found while stress-testing the DMA-based PFM_Input capture
        below with progressively less trivial waveforms (an extreme
        zigzag, then a slower ramp/hold(100 periods)/ramp profile). The
        ramp/hold/ramp shot's real HRTIM output was confirmed, via a
        DSLogic ground-truth capture (all 6 channels agreeing, U vs UN
        median error 0.0), to genuinely stall on the wire: it holds one
        frequency for ~187 real periods instead of the table's
        programmed 100, then cleanly resumes the correct sequence ~77
        periods late. PFM:DIAG?'s existing single max-gap diagnostic
        (added the same day for a different, now-closed dead end) could
        not distinguish "one big stall" from "many small repeated
        delays," so a new diagnostic was added: PFM_GetDiagGapLog()
        (pfm.c/pfm.h) logs the raw DWT-cycle gap between every single
        PFM_CycleBoundaryHandler() call for the current shot (up to
        PFM_INPUT_MAX_PERIODS of them), exposed over serial as
        PFM:GAPLOG? (commands.c/commands.h/cmd_parser.c) -- TEMPORARY,
        same debug-command convention as PFMIN:DMASTAT?, meant to be
        removed once this investigation closed.

        The raw gap log immediately showed the real mechanism: not one
        stall, but a spike of ~15000-18500 cycles (~88-109 us) recurring
        roughly every 8-10 table entries, each followed by an
        anomalously short next gap (the classic signature of a single
        delayed ISR entry, not an accumulating one). The recurrence
        interval (~8 periods) matches PFM_Input's DMA capture design
        exactly: a 32-entry circular buffer with a half/full-transfer
        interrupt every 16 captured edges, i.e. every 8 periods at 2
        edges/period.

        Root cause: PFM_Input's DMA1_ChannelN_IRQn (the interrupt whose
        callback batch-processes those 16 edges, pfm_input.c) was left
        at NVIC priority 1 -- a decision inherited from the OLD, now-
        superseded per-edge interrupt-driven capture design, where
        TIMx capture interrupts genuinely needed to preempt
        HRTIM1_Master_IRQn (demoted to priority 2 on 2026-09-08) to
        avoid a real overcapture race. That reasoning stopped applying
        the moment capture became DMA-driven (2026-09-09, entry below):
        the DMA controller grabs each CCRx value in hardware with zero
        CPU/IRQ involvement, so nothing about capture fidelity depends
        on IRQ priority anymore -- only the periodic 16-edge batch-
        processing ISR still runs on the CPU, and leaving IT above
        HRTIM1_Master let its own real (non-trivial) processing time
        repeatedly steal cycles from the table-advance ISR, which is
        what a long run of identical hold entries made visible as a
        large, compounding real-time lag.

        Fix: HRTIM1_Master_IRQn restored to priority 1 (hrtim.c,
        HRTIM1_EnableMasterInterrupt()); PFM_Input's DMA1_ChannelN_IRQn
        demoted to priority 3 (pfm_input.c, PfmInput_Init()), below
        both HRTIM1_Master and the GateDriverStatus EXTI/TIMx_IRQn tier
        (priority 2). Safe because the ~8-period window before the
        circular buffer would actually wrap and lose data is orders of
        magnitude larger than HRTIM1_Master's own ISR execution time.

        CONFIRMED on real hardware, same ramp/hold/ramp shot, before/
        after:
          PFM:DIAG? max gap    18547 cycles (109 us)  ->  5152 cycles
                                                            (30 us -- this
                                                            IS the table's
                                                            own longest
                                                            programmed
                                                            period, not a
                                                            stall)
          PFM:GAPLOG? (full)   repeating ~15-18k-cycle spikes every
                                8-10 entries  ->  every single one of
                                200 entries within normal jitter of its
                                own programmed period, zero anomalies
          PFMIN:DATA? (all 3   198-199/200 captured, OVERCAP=0 -- capture
          active channels)     fidelity unaffected by the IRQ demotion

        Also explains the "max gap grows roughly linearly with channel
        count" note in the DMA capture entry below (1 ch ~17-30 us ...
        6 ch ~100 us) -- that WAS this same priority inversion the whole
        time, just below the threshold to visibly stall output until a
        long-enough run of identical table entries made the accumulated
        effect obvious.

  Files:  Core/Src/hrtim.c, Core/Src/pfm_input.c, Core/Src/pfm.c,
        Core/Inc/pfm.h, Core/Src/commands.c, Core/Inc/commands.h,
        Core/Src/cmd_parser.c, python/pfm_table_upload.py (added
        PROFILE 9 "extreme zigzag" and PROFILE 10 "ramp/hold/ramp" test
        profiles used to find this)

2026-09-09  —  DMA-based PFM_Input capture: implemented, two real bugs
               found and fixed, CONFIRMED on real hardware at all 6
               channels simultaneously (the exact config that hard-
               locked the board under the old design)
-----------------------------------------------------------------------
  Change:  Implemented the DMA-based capture redesign planned in the
        entry below. Each active channel's TIMx now DMAs its captured
        CCRx value directly into a small RAM ring buffer (g_dmaBuf[],
        32 entries/channel) with NO per-edge ISR at all -- the CPU only
        wakes on a DMA half/full-transfer interrupt
        (HAL_TIM_IC_CaptureHalfCpltCallback()/HAL_TIM_IC_CaptureCallback(),
        pfm_input.c), once per 16 edges instead of once per edge.
        Everything downstream (period computation, the 16-bit
        wraparound mask, target-count stopping) moved into
        ProcessDmaChunk(), called once per batch. Wire protocol
        (PFMIN:CAPTURE/STATus?/DATA?) unchanged -- purely an internal
        capture-mechanism swap. One DMA channel per PFM_Input channel
        (DMA1_Channel1..6, DMAMUX request IDs from stm32g4xx_hal_dma.h
        -- DMA_REQUEST_TIM2_CH1/CH2, _TIM3_CH1, _TIM4_CH1,
        _TIM5_CH1/CH2), all newly used -- nothing else in this project
        used any DMA channel before this (confirmed via grep before
        choosing them).

        Two real bugs found and fixed during real-hardware bring-up,
        neither existing before this redesign:
          1. DMAMUX1's own peripheral clock was never enabled (only
             DMA1's was) -- HAL_TIM_IC_Start_DMA() reported HAL_OK
             (confirmed via a temporary PFMIN:DMASTAT? debug command)
             but no request ever actually reached the DMA controller,
             so capture silently reported 0 periods with no error
             anywhere. Fixed: __HAL_RCC_DMAMUX1_CLK_ENABLE() added
             alongside the existing DMA1 clock enable.
          2. A shot ending mid-chunk (before the next half/full DMA
             interrupt) silently lost up to 15 real edges already
             sitting in the buffer but never processed -- confirmed on
             real hardware, a 200-period capture reaching only 191.
             Fixed: PfmInput_OnShotEnd() now reads the DMA channel's
             CNDTR register to compute exactly how much unprocessed
             data is sitting in the buffer and flushes it via
             ProcessDmaChunk() before actually stopping DMA.

        CONFIRMED on real hardware, incremental channel-count test
        (same philosophy as the interrupt-driven design's own
        incremental re-test, but this time scaling all the way up):
        1, 2, 3, 4, 5, then all 6 channels, each with a full 100->60
        kHz decreasing sweep, checked for lockup/fault/PFM:DIAG? max
        gap at every step:

          channels   max gap (PFM:DIAG?)   result
          1          ~17-30 us              clean, 197-200/200
          2          ~42 us                 clean, 200/200 both
          3          ~57 us                 clean, 200/200 all 3
          4          ~74 us                 clean, 200/200 all 4
          5          ~91 us                 clean, 200/200 all 5
          6 (all)    ~100 us                clean, 200/200 all 6

        Max gap grows gently and roughly linearly with channel count,
        nowhere near the ~734 us starvation threshold the old
        interrupt-driven design hit at just 2 channels -- and the final
        6-channel run is the EXACT configuration that caused a real
        board lockup requiring a power cycle under that old design.
        No lockup, no fault, board fully responsive throughout and
        after, at every step. This appears to be a complete, real fix
        for the interrupt-starvation root cause, not another
        mitigation.

        PFM_INPUT_ACTIVE_CHANNEL_MASK left at 0x3F (all 6) as of this
        entry, reflecting the confirmed-working end state.

        Added python/pfm_input_plot.py usage throughout this test
        (--channel 1,2,3,4,5,6 / all) to visually confirm each step,
        not just trust the numeric OK/count replies.

  Files:   Core/Src/pfm_input.c, Core/Inc/pfm_input.h,
        Core/Src/commands.c, Core/Inc/commands.h, Core/Src/cmd_parser.c,
        Core/Src/stm32g4xx_it.c

2026-09-09  —  PFM:DIAG? diagnostic CONFIRMS interrupt starvation as
               the table-advance stall's root cause (734us max gap,
               ~67x a normal period, with just 2 capture channels
               active) -- DMA-based capture redesign now planned
-----------------------------------------------------------------------
  Change:  Added PFM:DIAG? (commands.c's cmd_pfm_diag(), pfm.c's
        PFM_GetDiagCounters()) to test the interrupt-starvation theory
        for the table-advance stall found in the entries just below --
        NOT a plain call counter (a completed shot's call count is
        always exactly the table's entry count regardless of whether
        stalling happened along the way, since PFM_CycleBoundaryHandler()
        only stops once g_pfmIndex reaches it -- that number alone
        can't distinguish "ran on schedule" from "was starved, then
        caught up"). Instead tracks the largest REAL TIME gap between
        two consecutive calls, using the Cortex-M4 DWT free-running
        cycle counter (170 MHz, confirmed same clock as
        HRTIM_TIMER_CLK_HZ) -- reset at every PFM_Restart(), read back
        as "OK <callCount> <maxGapCycles> <maxGapUs>".

        Result, same 100->60kHz decreasing sweep, only PFM_Input_01+02
        active (2 real channels, both genuinely wired): PFM:DIAG? ->
        "OK 200 124818 734" -- 200 calls (as expected either way), but
        a MAXIMUM GAP of 734 us between two consecutive calls. Normal
        gap at ~91-95 kHz should be ~11 us (one real period) -- 734 us
        is ~67x that. This is direct, quantitative proof that
        HRTIM1_Master_IRQHandler() (which runs PFM_CycleBoundaryHandler(),
        priority 2 -- deliberately BELOW every TIM2-5 capture channel's
        priority 1, so real edges are never missed) was starved for
        roughly 67 real periods straight, with just 2 real capture
        channels active -- not a logic bug in the table-advance code,
        and not something that requires many/floating channels to
        trigger.

        DECISION: since capture-channel interrupt load is confirmed as
        the actual mechanism, the planned fix is a DMA-based capture
        redesign -- configure each TIMx to auto-transfer its captured
        CCRx value into a RAM ring buffer via DMA on every edge, with
        ZERO CPU/ISR involvement per edge (versus one full ISR entry/
        exit + HAL dispatch + capture logic per edge today). The CPU
        would only wake up occasionally (a DMA half/full-buffer
        interrupt) to process a BATCH of already-timestamped edges,
        removing capture-channel interrupt PRIORITY/LOAD from
        competing with HRTIM1_Master almost entirely. Not yet
        implemented -- this entry documents the confirmed root cause
        and the planned direction, not a landed fix.

  Files:   Core/Src/pfm.c, Core/Inc/pfm.h, Core/Src/commands.c,
        Core/Inc/commands.h, Core/Src/cmd_parser.c

2026-09-09  —  Added python/pfm_input_plot.py; all-6-channel test finds
               a NEW real issue: floating capture channels can starve
               the PFM table-advance ISR itself (output side, not just
               capture)
-----------------------------------------------------------------------
  Change:  Added python/pfm_input_plot.py -- pulls PFMIN:DATA? for one
        or more channels (--channel 1 / 1,3,5 / all) and plots period
        (raw ticks) + derived frequency (kHz) on one figure per
        request, multiple channels overlaid with a shared, OUTLIER-
        ROBUST y-axis (90th-percentile-based, not plain autoscale) so
        one noisy channel's spikes don't flatten a real channel's data
        out of view -- see the script's own header comment. Also
        --csv and --save (headless) options.

        Used it for a real-hardware "full test" requested directly:
        temporarily re-enabled ALL 6 PFM_Input channels
        (PFM_INPUT_ACTIVE_CHANNEL_MASK = 0x3F, pfm_input.h) and
        repeated the 100->60 kHz decreasing sweep. Only PFM_Input_01
        (phase U) is physically wired to anything on this bench; the
        other 5 are floating. Result revealed something NEW and real,
        not just "floating pins read garbage" (expected) but a
        genuine OUTPUT-side side effect:

        Channel 1's own captured sequence got stuck: 1699x12, 1736x13,
        1774x11, then 1814 repeated for 160+ consecutive periods
        straight through to the end of its 200-period capture (should
        have been ~10 periods/step, cleanly advancing through all 20
        steps to 2832). This is NOT a pfm_input.c capture bug -- it
        faithfully reported a REAL signal that itself got stuck.
        Mechanism: HRTIM1_Master_IRQHandler() (calls
        PFM_CycleBoundaryHandler(), which advances the table and
        writes the next per/cmp registers) runs at NVIC priority 2,
        deliberately BELOW all 4 TIM2-5 capture-channel IRQs' priority
        1 (that's what makes capture always preempt it and never miss
        a real edge -- see hrtim.c's HRTIM1_EnableMasterInterrupt()).
        With 5 channels now floating and picking up electrical noise
        as spurious rising edges at a high, UNCONTROLLED rate
        (PFM_Input_06 alone logged OVERCAP=66 out of 200 -- edges
        arriving faster than even ITS OWN ISR could keep up), those
        higher-priority capture ISRs can consume enough CPU time to
        genuinely starve the lower-priority table-advance ISR --
        stalling the REAL PWM output's progression through the table,
        not just corrupting capture data for the floating channels.

        No fault, no hang, no crash -- board stayed fully responsive
        (FAULT? OK 0, *IDN? normal) throughout; this is a live timing
        degradation, not a stability failure.

        Reverted PFM_INPUT_ACTIVE_CHANNEL_MASK back to 0x01 (channel 1
        only) -- this real risk (an unconnected/floating capture
        channel can degrade PFM OUTPUT timing, not just its own
        capture data) is worth keeping in mind for any future work
        that wires up and enables channels 2-6: a genuinely floating
        pin should stay disabled in this mask until it's actually
        connected to something, not just left enabled "in case."

  Files:   python/pfm_input_plot.py, Core/Inc/pfm_input.h

2026-09-09  —  Decreasing-frequency sweep + PFM_Input re-verification --
               both confirmed clean, no code changes needed
-----------------------------------------------------------------------
  Change:  Two real-hardware checks requested after the HRTIM SET/RESET
        fix landed, neither of which had been tested yet:

        1. Added PROFILE 8 to python/pfm_table_upload.py: the exact
           reverse of PROFILE 6 -- 100 kHz -> 60 kHz (per INCREASING
           step to step, the opposite direction of every ramp tested
           so far). Fired, DSLogic-captured all 6 channels
           (/Users/everettpenne/DSLogic U3Pro32-la-260909-102352.dsl):
           U/UN/V/VN/W/WN all show ZERO anomalies. The CMP3 SET/RESET
           fix is confirmed direction-agnostic, not just verified on
           the shrinking-per case it was found and fixed on.

        2. Re-verified pfm_input.c's on-board capture (PFM_Input_01,
           the only active channel) against this same decreasing
           sweep -- new territory for it too (never fed an
           increasing-per signal before). Initial look at PFMIN:DATA?
           appeared to show drift/anomalies (run lengths of 11-13
           instead of 10, occasional out-of-sequence single values) --
           traced to comparing against the wrong assumed index offset
           (every prior test happened to line up at firmware
           period[i] == DSLogic rise[i+1]; this shot's real alignment
           was rise[i+2], a harmless which-edge-is-"first" labeling
           difference between the two independent instruments, not a
           capture defect). Once compared at the correct offset: all
           200 captured periods matched DSLogic ground truth within
           5.6 ticks -- same quality as every previous successful
           test. PFM_Input capture confirmed still correct.

  Files:   python/pfm_table_upload.py (no firmware changes this entry)

2026-09-09  —  HRTIM SET/RESET collision fix EXTENDED to channel 0 (U)
               after real-hardware re-test showed it wasn't actually
               immune -- cold-start settling logic updated to match
-----------------------------------------------------------------------
  Change:  The V/W-only version of the CMP3 SET fix (entry just below)
        was reflashed and re-tested with a full 6-channel (U/UN/V/VN/
        W/WN) DSLogic capture of the same 60-100 kHz ramp. Result:
        V/VN/W/WN -- 0 anomalies, fix fully confirmed. But U/UN newly
        showed 6 anomalies each, same exact "measured = old + new"
        merged-period signature V/W had -- and at almost the identical
        per-value transitions (steps 12-16, ~1993-1814 ticks, plus the
        final 100 kHz step) V/W used to fail at before their fix. This
        means channel 0 was never actually immune to whatever the
        underlying HRTIM hazard is -- it was just rarer/narrower than
        V/W's own additional SET/RESET-crossbar vulnerability, and
        probably got statistically masked by V/W's much-more-frequent
        failures in every earlier test.

        Extended fix: apply the same CMP3-based SET (see the entry
        below for the full ST-community-sourced mechanism) to channel
        0 too, not just channels 1..N-1. Its ResetTrigger stays
        MASTER_PER (counter still resets exactly on the Master
        boundary); only the output's SET SOURCE moves off TIMPER onto
        CMP3, same 16-tick fixed offset as V/W.

        Caught before testing, not after: this broke an existing
        assumption in HRTIM1_WaitForPhaseAndConnect()'s cold-start
        settling logic (HRTIM1_PWM_Start()), which explicitly skipped
        the "reforceActive" output re-assert for channel 0 specifically
        BECAUSE its SET source used to BE its own reset event (TIMPER
        = MASTER_PER, the same instant). With SET now on a separate
        CMP3 event, channel 0 needs the same reforceActive=1 treatment
        channels 1..N-1 already get, or the very first pulse of every
        shot risks the same garbled-cold-start failure mode this
        function was built to prevent back on 2026-09-04. Fixed by
        passing reforceActive=1 for channel 0's call too, with both
        call sites' comments updated to match.

        CONFIRMED FIXED, real hardware, same day: reflashed, repeated
        the 60-100 kHz ramp with a full 6-channel DSLogic capture
        (/Users/everettpenne/DSLogic U3Pro32-la-260909-101706.dsl).
        Result: U/UN/V/VN/W/WN -- ALL SIX channels, 0 anomalies. Cold
        start (each channel's very first pulse) also checked directly
        and reads a normal-length period, not garbled -- the
        reforceActive=1 fix for channel 0 holds. This appears to be the
        actual root-cause fix for the frequency-ramp glitch investigated
        across this whole 2026-09-09 session, not another mitigation.

        Generalization check (requested directly, not assumed):
        confirmed every place this fix lives -- the CMP3 compare-
        register config loop, the per-channel output SetSource
        selector, and HRTIM1_PWM_Start()'s cold-start reforceActive
        handling -- is keyed off HRTIM_NUM_CHANNELS (ctrlr_config.h),
        not a hardcoded channel count, so raising N in the future
        automatically brings any newly-active channel under this fix
        with no further code changes. Also confirmed no register
        conflict: each channel's own local CMP3 (used here) is a
        separate hardware resource from the Master's MCMP3R/MCMP4R
        (already used for channels 3/4's phase offsets) -- same name,
        different registers. Documented directly on
        HRTIM_NUM_CHANNELS's own comment in ctrlr_config.h so this is
        discoverable, not just implicit.

  Files:   Core/Src/hrtim.c, Core/Inc/ctrlr_config.h

2026-09-09  —  HRTIM SET/RESET collision fix for phase-shifted channels
               (V/W) -- root cause found, real fix applied, pending
               hardware re-verification
-----------------------------------------------------------------------
  Change:  Root-caused the frequency-ramp glitch from the entries just
        below: a real-hardware sweep with PFM_Input_01 restricted to
        phase U (clean, 0 anomalies) alongside a full 6-channel DSLogic
        capture (U/UN/V/VN/W/WN) found V and W BOTH glitching --
        starting as low as ~68-69 kHz, well inside the range U alone
        had suggested was safe -- while U/UN stayed perfectly clean.
        Every glitch's measured duration matched (old period + new
        period) almost exactly (ratio 0.988-1.005 across all 16
        glitches checked), on BOTH V and W -- i.e. one complete real
        SET/rising-edge event is being silently dropped, not a garbled
        or partial one.

        Found the exact documented mechanism via ST's own community
        engineering forum (search "HRTIM PWM transients greater than a
        period"): when a timer's output SET and RESET events fall
        within ~3 HRTIM clock cycles of each other, RESET always wins
        and SET is silently dropped, leaving the output low for one
        extra full cycle. U's output SET is tied to TIMPER = MASTER_PER
        (its ResetTrigger), always far from its own mid-cycle CMP1
        (duty, its ResetSource) -- no collision possible. V/W's SET is
        ALSO tied to TIMPER, but for them TIMPER = MASTER_CMP1/CMP2
        (their own ResetTrigger) -- a point that itself shifts every
        table entry as per changes (phase = k*(per+1)/N), and during a
        fast ramp can land within a few clocks of the PREVIOUS cycle's
        own CMP1 (duty) event, exactly the documented collision.

        FIX (the same one documented in that thread): V/W's output SET
        moved off the un-prioritized TIMPER event onto a dedicated
        CMP3 compare (HRTIM's collision rule favors the higher-numbered
        compare register, so SET now wins ties against RESET's CMP1
        instead of losing). CMP3xR set once at init to a small fixed
        16-tick offset (not duty-dependent, no per-cycle updates
        needed) -- negligible against real period lengths (1200+
        ticks). Deliberately narrow: only channels 1..HRTIM_NUM_
        CHANNELS-1 change; channel 0 and the unused channels beyond
        HRTIM_NUM_CHANNELS (free-running, no MASTER_CMPk race possible)
        keep SetSource = TIMPER.

        Rebuilt clean (zero warnings, text 47140 -> 47252 bytes).
        NOT YET RE-VERIFIED ON REAL HARDWARE as of this entry -- next
        step is reflashing and repeating the 6-channel DSLogic capture
        to confirm V/W actually stop glitching. Be prepared to revert
        this specific change (the SetSource/CMP3 edit in
        HRTIM1_FullInit(), hrtim.c) if it doesn't hold up or causes any
        new real-hardware issue -- everything else in this session
        stays regardless of this fix's outcome.

  Files:   Core/Src/hrtim.c

2026-09-09  —  100 kHz hard carrier-frequency limit; PFM_Input reduced
               to the one wired channel; HRTIM shadow/preload
               architecture reviewed (correct, root cause still open)
-----------------------------------------------------------------------
  Change:  Direct response to the frequency-ramp findings just above/
        below this entry (real, intermittent missing-pulse glitches on
        the wire above ~85 kHz on a frequency-CHANGING table):

        1. ctrlr_config.h: new PFM_MAX_CARRIER_FREQ_HZ (100000) --
           hard compile-time ceiling. Enforced in commands.c's
           cmd_table_step() (new TABLE_STEP_MIN_PER bound, same
           per_from_freq() formula as python/pfm_table_upload.py) --
           any TABLE:STEP whose `per` implies a faster carrier is
           rejected with new ERR 10, not silently accepted. 100 kHz is
           the documented, tested-clean boundary, not a guess -- every
           constant-100kHz test this project has run has been clean,
           and the ramp's own first ~5 steps (all below 85 kHz) never
           glitched either. python/pfm_table_upload.py's PROFILE 6
           FREQ_RAMP_END_HZ lowered from 140_000 to 100_000 to match
           (would otherwise immediately hit ERR 10 on re-upload).

        2. pfm_input.h: new PFM_INPUT_ACTIVE_CHANNEL_MASK (0x01 --
           PFM_Input_01 only), the one channel actually wired to a
           real signal (phase U) on this bench. pfm_input.c reworked
           so a timer with no active channel is left COMPLETELY
           untouched by PfmInput_Init() -- no HAL_TIM_IC_Init(), no
           clock enable, no NVIC IRQ enable, no GPIO AF config -- not
           merely armed with M=0. TIM3/TIM4/TIM5 and TIM2_CH2 are now
           fully idle. Motivation: cut CPU/interrupt load while the
           frequency-transition timing investigation is open (load is
           exactly what's under suspicion), and shrink the variables
           in play. Re-enable a channel by setting its bit in the
           mask; nothing else needs to change.

        3. Investigated hrtim.c's HRTIM shadow/preload register
           architecture (HRTIM1_FullInit(), HRTIM1_ApplyPfmStep(),
           HRTIM1_SoftwareUpdate(), PFM_ApplyCurrentStep()) end to end
           looking for a misconfiguration that could explain the
           glitch. Found it CORRECTLY implements ST's own reference
           multiphase design (STM32CubeF3 HRTIM_Multiphase): PreloadEnable
           = ENABLED on both the Master and every active timer;
           UpdateTrigger = MASTER for every phase-locked channel (ties
           every channel's shadow->active promotion to one single,
           coherent Master update event, not per-timer independent
           events); RepetitionCounter = 0 (updates apply every single
           period, not gated to every Nth); PFM_ApplyCurrentStep()
           writes next-period values into shadow registers during the
           CURRENT period (a full period's worth of margin, not a
           last-instant race), relying on the natural hardware update
           event to promote them -- NOT an explicit software-forced
           update mid-period (that WOULD be capable of glitching; this
           design correctly avoids it, using HRTIM1_SoftwareUpdate()
           only once, for the very first period of a shot in
           PFM_Restart(), before the counters are even running).
           CONCLUSION: this is not a "forgot to use preload" bug --
           the architecture is sound on paper. Root cause remains
           OPEN. Refined clue, not yet confirmed: the glitched value
           each time measures almost exactly 2x the NEW (post-
           transition) period, not old+new -- i.e. the counter really
           is running at the new, faster rate by the time of the
           glitch, but ONE real toggle/edge at the exact transition
           instant is being suppressed for one cycle. This may be
           specific to channel 0 (phase U / PFM_Input_01), which
           resets on MASTER_PER directly (the same event that also
           promotes the Master's own shadow PER) rather than a
           phase-shifted MASTER_CMPk trigger the other channels use --
           unconfirmed. Resolving this further needs either STM32G4
           reference-manual-level detail on Master PER shadow-register
           promotion relative to its own counter-reset event, or live
           timing instrumentation -- deliberately NOT attempted this
           session given this project's history of real board hangs
           chasing this exact flavor of timing bug aggressively.

  Files:   Core/Inc/ctrlr_config.h, Core/Src/commands.c,
        Core/Inc/commands.h, Core/Inc/pfm_input.h, Core/Src/pfm_input.c,
        python/pfm_table_upload.py

2026-09-09  —  PFM_Input: frequency-ramp test finds two real bugs --
               one fixed (buffer overflow), one open (dropped edges
               at fast transitions)
-----------------------------------------------------------------------
  Change:  Added PROFILE 6 to python/pfm_table_upload.py: a 200-entry,
        20-step frequency ramp (60 kHz -> 140 kHz, constant 50% duty,
        10 periods/step -- sized to exactly match PFM_INPUT_MAX_PERIODS
        so a single PFMIN:CAPTURE 200 covers the whole shot), to verify
        pfm_input.c's rising-edge capture tracks a CHANGING period, not
        just the constant 100 kHz carrier every prior real-hardware
        test used.

        Real-hardware result: fired 3 times, cross-checked against two
        DSLogic captures (a narrow one covering the first 3 steps, then
        a widened ~5 ms window covering the full 200-period shot:
        /Users/everettpenne/DSLogic U3Pro32-la-260909-091458.dsl).
        DSLogic's ground truth is CLEAN across all 200 real periods --
        every one of the 20 programmed frequency steps lands correctly
        on the real PA15 wire, no glitches, no doubled pulses anywhere.

        But the firmware's own PFMIN:DATA? reply does NOT match this
        cleanly: 9 of its 200 entries come back as almost exactly 2x
        the correct value for that point in the ramp (e.g. one entry
        read 3986, exactly 2x the real 1993-tick period at that step).
        Cross-referencing index-for-index against the DSLogic ground
        truth (accounting for a fixed, well-understood 1-index offset
        between the two data sets -- firmware's period[0] is the
        interval AFTER its reference-only first rise, so it's one
        real edge ahead of DSLogic's own rise[0]) confirms: this is a
        REAL missed capture, not a real signal artifact -- the
        firmware's ISR is silently failing to register one specific
        rising edge, always right at a frequency-transition boundary,
        and increasingly often as the ramp's periods shorten (none in
        the first ~5 steps at 2000+ ticks/period, then at nearly every
        transition once periods drop below ~1700 ticks). NOT YET
        ROOT-CAUSED. Leading hypothesis, unconfirmed: an ISR
        service-time margin issue that only bites when the capture
        callback's own turnaround time becomes comparable to the
        (now much shorter) real period, possibly worsened by
        contention with HRTIM1_Master_IRQHandler/
        PFM_CycleBoundaryHandler firing at the same moment to load the
        new per/cmp values for the transition. This is a DIFFERENT
        bug from the 2026-09-08 duty-cycle one (which corrupted every
        single measurement, not just transitions, and is confirmed
        gone -- see below) -- it only affects period tracking of a
        FAST-CHANGING signal, not a constant one.

        Separately, and unrelated: PFMIN:DATA? 1 was observed to
        report 201 entries against an armed target of 200, with the
        201st value being pure garbage (64250 = 0xFAFA). Root cause:
        HAL_TIM_IC_Stop_IT() does not take effect instantaneously: a
        capture already in flight when capturedCount reaches
        targetCount can still race it and reach HAL_TIM_IC_
        CaptureCallback() one more time, writing period[targetCount]
        -- one past this channel's array -- which silently overflows
        into the START of the NEXT channel's PfmInputState_t in
        g_state[] (g_state[] is a plain contiguous array). FIXED:
        the callback now bails out immediately if
        capturedCount >= targetCount, before touching anything else,
        making "already finished" a true no-op regardless of how the
        stop race lands. Rebuilt clean (zero warnings); NOT yet
        re-verified on hardware.

  Files:   Core/Src/pfm_input.c, python/pfm_table_upload.py

2026-09-08  —  PFM_Input: duty-cycle measurement dropped, rising-edge
               period-only capture (bug sidestepped, not root-caused)
-----------------------------------------------------------------------
  Change:  Two independent duty-cycle capture designs (BOTHEDGE +
        live-GPIO disambiguation, then an alternating-single-polarity
        redesign with a disassembly-confirmed CCxE-toggle fix) both
        gave a real signal wired to PFM_Input_01 consistently ONE FULL
        REAL PERIOD LATE readings (reported high == real period + real
        high; reported period == 2x real period, 20/20 captures both
        times) -- see the two entries below for the full diagnostic
        history. A follow-up PWM-Input-Mode isolation test caused two
        real board hangs (recovered via physical power-cycle both
        times) and was abandoned before producing data; that
        diagnostic code was written, tested, and then fully removed
        again in the same session.

        Decision: duty-cycle (time-high) measurement is dropped
        entirely rather than continuing to chase an unexplained bug.
        pfm_input.c now measures period only, via plain
        TIM_ICPOLARITY_RISING armed once at PfmInput_Init() and never
        touched again -- ArmPolarity()/the WAIT_RISE/WAIT_FALL phase
        state machine are gone. The one thing every failed duty-cycle
        attempt had in common was an in-ISR polarity change; rising-
        edge-only capture has none, which should sidestep the bug
        entirely rather than fix it -- NOT yet re-verified on real
        hardware (next step: repeat the phase-U-into-PFM_Input_01
        test from the entry below and confirm period reads correctly
        this time).

        Wire-format change: PFMIN:DATA? <ch> now replies
        "OK <count> OVERCAP=<n> <per1> <per2> ..." (dropped the
        per-period "<hi>" field). PfmInput_GetHighTicks() removed from
        pfm_input.h's API.

  Files:   Core/Src/pfm_input.c, Core/Inc/pfm_input.h,
        Core/Src/commands.c, Core/Inc/commands.h, AGENTS.md

  CONFIRMED FIXED, real hardware, same day: reflashed, uploaded the
        identical 100-entry/100 kHz/40%-duty table used in the earlier
        broken test (per=1699, cmp=680, all 3 channels), phase U wired
        to PFM_Input_01 exactly as before, PFMIN:CAPTURE 20, FIRE.
        PFMIN:DATA? 1 -> "OK 20 OVERCAP=0" followed by 1699 twenty
        times, no exceptions -- the exact real period, not 3398.
        Independently confirmed against a fresh DSLogic capture of the
        same shot (/Users/everettpenne/DSLogic
        U3Pro32-la-260909-090119.dsl): 50 real rising edges captured,
        and (excluding one cold-start-settling first period, already
        documented elsewhere in this project) the other 48 average
        1697.1 ticks at 170 MHz (range 1695.9-1698.0, sigma ~0.55) --
        matching the firmware's 1699 within ordinary 250 MHz-sample-
        into-170-MHz-tick quantization/clock-tolerance noise, nothing
        like the old bug's clean, exact 2x signature. Root cause of
        the original bug is still not explained -- it was sidestepped,
        not fixed -- but the measured data is now correct.

2026-09-08  —  PFM_Input real-hardware test: data corruption found,
               root cause NOT yet found -- diagnostic writeup
-----------------------------------------------------------------------
  Change:  First real-signal test of pfm_input.c (see the entry below
        for the feature itself): phase U's HRTIM output (per=1699,
        cmp=680 -- 100 kHz, 40% duty, this exact per/cmp pair already
        hardware-verified via DSLogic in earlier sessions) wired
        directly to PFM_Input_01 (PA15), a 100-entry constant table
        fired, PFMIN:CAPTURE 20 armed beforehand.

        Result: the capture mechanism itself works exactly as designed
        -- channel 1 reliably reached its armed count of 20 promptly
        after FIRE, confirming the shot-synchronized arm/start/stop
        plumbing end to end on real hardware, not just in isolation.
        But the MEASURED VALUES are wrong: high-time (duty) values
        consistently read correctly (~664 ticks, matching the
        expected ~40% duty minus the same ~90-100 ns dead-time
        shortfall already characterized in this project's earlier
        DSLogic work), but period values consistently read as
        roughly 2-3x the expected single-period tick count (~1700) --
        i.e. real periods are being merged/undercounted.

        Diagnosed with real instrumentation added to pfm_input.c
        specifically for this (PfmInput_GetOvercaptureCount(),
        PfmInput_DebugGetUnexpectedRise()/Fall(), all reported via a
        temporary OVERCAP=/URISE=/UFALL= prefix on PFMIN:DATA?'s
        reply -- not yet in docs/command_reference.md, this is
        diagnostic-only for now), not guessed:
          - Hardware overcapture (CCxOF) stayed near zero (0-1 across
            20 captured periods) -- rules out simple CPU/ISR
            starvation silently overwriting CCR values before the ISR
            could read them.
          - The other 5 armed-but-unconnected channels showed ZERO
            capture activity (0 overcaptures, 0 captured periods each)
            -- rules out floating-pin noise on the other channels
            (e.g. PD4, sharing TIM2 with the pin under test)
            interfering with channel 1's own servicing.
          - UFALL (WAIT_CLOSING_RISE seeing an unexpected extra
            falling-type capture) was consistently high (34-36 across
            20 periods) -- the state machine IS reliably being handed
            genuine extra capture events while waiting for the single
            expected closing rise.
          - Raising ICFilter (the timer's built-in digital
            deglitch/noise filter, left at 0 in the first version) to
            0x3 then 0xF did NOT converge toward correct -- 0x3 showed
            no measurable change from 0, and 0xF made the corruption
            categorically worse (high-time readings jumped to ~1700,
            nearly a full period, instead of the correct ~664). This
            is inconsistent with simple debounce-able signal ringing
            (which more filtering should improve, not worsen) and is
            more consistent with the filter's own sampling delay
            desynchronizing HAL_TIM_ReadCapturedValue() (which goes
            through the filter) from the separate, always-instantaneous
            HAL_GPIO_ReadPin() this module uses to disambiguate BOTHEDGE
            captures (which does not) -- a real mechanism, but one that
            doesn't explain the ORIGINAL filter=0 corruption, which
            has no filter delay to desync against in the first place.
          - ICFilter reverted to 0 (neither 0x3 nor 0xF showed a real
            improvement, and higher values add the GPIO-read/filter-
            delay mismatch risk above for no confirmed benefit).

        Root cause NOT found. What remains genuinely unknown, flagged
        honestly rather than guessed: whether this is a real electrical
        signal-integrity problem on the physical U-to-PFM_Input_01
        connection (this session has no scope/logic analyzer access to
        see the actual waveform) or a logic bug in pfm_input.c's
        BOTHEDGE-plus-GPIO-level-read disambiguation approach itself
        (e.g. a genuine race between an edge landing in CCR and this
        module's separate GPIO read of the "current" pin state, if the
        real signal is doing something other than this module's
        two-edges-per-period assumption). Next step needs the bench:
        a scope or DSLogic capture of the actual PA15/U signal during
        a shot, to see the real waveform directly rather than infer it
        indirectly through capture behavior.

        Diagnostic instrumentation (PfmInput_GetOvercaptureCount() in
        pfm_input.h; PfmInput_DebugGetUnexpectedRise()/Fall(), not in
        the header, reached via local externs in commands.c) left in
        place, not reverted -- the investigation isn't finished. Board
        left flashed with ICFilter=0 (the original, unmodified value)
        plus this diagnostic instrumentation.

2026-09-08  —  PFM_Input period/duty capture (pfm_input.c/.h),
               synchronized to PFM shot lifetime
-----------------------------------------------------------------------
  Change:  New module measuring period + duty (time-high) per period,
        for a runtime-chosen count M of periods, independently on each
        of the 6 PFM_Input_01..06 pins (docs/pin_mapping_v4.csv --
        PA15/TIM2_CH1, PD4/TIM2_CH2, PB2/TIM5_CH1, PC12/TIM5_CH2,
        PB4/TIM3_CH1, PD12/TIM4_CH1). Requested as a plan first
        (plan mode used directly); the plan's first draft had
        PFMIN:CAPTURE both arm AND immediately start-and-block on its
        own, with no tie to FIRE at all -- corrected per direct
        follow-up request before implementation: capture must begin
        exactly when a PFM output shot begins, not at some arbitrary
        later moment.

        Design, as corrected: PFMIN:CAPTURE <M> now only ARMS a target
        period count per channel (PfmInput_Arm(), pfm_input.c) -- pure
        bookkeeping, touches no TIMx hardware, returns OK immediately.
        The actual HAL_TIM_IC_Start_IT() calls happen inside
        PFM_Restart() (pfm.c), the same function that calls
        HRTIM1_PWM_Start() for the shot itself, via a new
        PfmInput_OnShotStart() call added right alongside it -- so
        input capture and PWM output begin at the literal same call,
        not a separately-timed command. A capture also can never run
        longer than the shot that started it: PfmInput_OnShotEnd() is
        called from every place pfm.c stops a shot (PFM_ForceStop(),
        shared with both fault sources, AND the normal
        end-of-table-exhaustion branch in PFM_CycleBoundaryHandler(),
        which stops inline rather than via PFM_ForceStop() and so
        needed its own explicit call) -- stops any channel still
        running, leaving its partial count intact. This means there is
        no separate, arbitrarily-chosen capture timeout to invent: the
        shot's own already-deterministic duration is the bound.
        New PFMIN:STATus? (current captured-period count per channel,
        the way to know when an armed capture has finished without
        PFMIN:CAPTURE itself blocking) and PFMIN:DATA? <ch> (raw
        per-period ticks, self-describing its own count rather than
        assuming the armed M was reached, matching TABLE:END's own
        `OK <count>` precedent). New ERR 8/9.

        Channel/pin/AF mapping verified before writing any code, not
        assumed: docs/pin_mapping_v4.csv + the same datasheet
        column-position method already trusted in this project (Table
        13), cross-checked against known-good reference points on the
        same rows (TIM2_CH1 on PA15 -> AF1, matching the universally-
        known STM32 TIM1/TIM2=AF1 convention; SPI4/USART3/HRTIM1_FLTx
        landing on their own already-expected AF numbers on nearby
        rows). All 6: PA15/TIM2_CH1=AF1, PD4/TIM2_CH2=AF2,
        PB2/TIM5_CH1=AF2, PC12/TIM5_CH2=AF1, PB4/TIM3_CH1=AF2,
        PD12/TIM4_CH1=AF2. PA15 and PB4 both default to JTAG-debug-port
        pins at reset (JTDI, JTRST) -- reclaiming them as plain
        AF-muxed GPIO is standard given this project's SWD-only debug
        link, not a real risk, just noted.

        Key hardware constraint confirmed before designing the capture
        mechanism: TIM2 hosts BOTH PFM_Input_01 (CH1) and PFM_Input_02
        (CH2); TIM5 hosts BOTH PFM_Input_03 (CH1) and PFM_Input_04
        (CH2) -- a fixed PCB trace-routing fact, not a software choice.
        This rules out STM32's classic "PWM Input Mode" (which
        cross-connects a timer's CH1+CH2 to measure ONE input's
        rising+falling edges together) for those two timers, since each
        channel here must independently measure its own, possibly
        unrelated signal. Used TIM_ICPOLARITY_BOTHEDGE independently on
        every one of the 6 channels instead, with the live GPIO pin
        level read at each capture interrupt to disambiguate rising
        from falling -- applied uniformly across all 6 channels
        (including the two solo ones on TIM3/TIM4) for one consistent
        mechanism rather than mixing PWM Input Mode in where it would
        happen to fit.

        TIM2 and TIM5 are 32-bit counters; TIM3 and TIM4 are 16-bit
        (confirmed via stm32g474xx.h's IS_TIM_32B_COUNTER_INSTANCE
        macro). At this board's confirmed ~100 kHz-ish PFM_Input signal
        range and the 170 MHz timer kernel clock (APB1 undivided, same
        derivation already documented for HRTIM), no prescaler is used
        on any of the 4 counters -- full resolution (~1700 ticks/period
        at 100 kHz), and even the 16-bit counters' ~385 us/~2.6 kHz
        overflow floor is comfortably below this signal range. A real
        ceiling, not assumed to hold forever if actual signals turn out
        slower than expected -- flagged in pfm_input.c.

        stm32g4xx_hal_tim.c/.h (+ _tim_ex) did not exist in this
        project's Drivers/ tree at all (HAL_TIM_MODULE_ENABLED was
        commented out) -- copied from STM32Cube_FW_G4_V1.6.3, same
        exact-HAL-version-match reasoning as the QSPI driver copy last
        session (HAL Driver V1.2.7). Debug/Drivers/.../subdir.mk and
        Debug/objects.list hand-patched again (Core/Src/pfm_input.c,
        the two new Drivers/ source files).

        HAL_TIM_IC_MspInit()/MspDeInit() live in pfm_input.c itself,
        not stm32g4xx_hal_msp.c, matching hrtim.c/qspi_test.c's
        precedent for hand-added (non-CubeMX) peripherals.
        stm32g4xx_it.c's TIM2/TIM3/TIM4/TIM5_IRQHandler()s use the
        generic HAL_TIM_IRQHandler() + overridden
        HAL_TIM_IC_CaptureCallback() dispatch, the same style already
        used for USART2 (HAL_UART_IRQHandler()/RxCpltCallback(),
        uart.c) -- a better fit than HRTIM1_Master_IRQHandler()'s
        hand-rolled raw-flag style for 4 instances x up to 2 channels
        each. NVIC priority tied with HRTIM1_Master_IRQn and the
        GateDriverStatus EXTI interrupts (1,0), above USART2 (2,0).

        Self-contained and removable (PFM_INPUT_FEATURE_ENABLED,
        pfm_input.h), matching boot_jump.h/qspi_test.h's established
        pattern -- including a real gap caught and fixed before it ever
        shipped: the first version unconditionally declared
        `extern TIM_HandleTypeDef htim2..htim5` in the header and
        referenced them unconditionally in stm32g4xx_it.c's 4 new
        IRQHandler()s, but pfm_input.c only DEFINES them inside its own
        `#if PFM_INPUT_FEATURE_ENABLED` block -- building with the
        feature disabled would have failed to link (undefined
        references) despite compiling cleanly, a real hole the "does it
        actually still build with everything else here" habit this
        project already has caught before it needed a bug report. Fixed
        by guarding both the extern declarations and the 4 IRQHandler()
        definitions on the same macro -- confirmed by actually building
        both ways (see Verified below), not just re-reading the fix.

        Buffer sizing note: PFMIN:DATA?'s reply can be large (up to
        PFM_INPUT_MAX_PERIODS=200 entries, ~4.4 KB of text) -- this
        project's linker script reserves only 1 KB (_Min_Stack_Size,
        STM32G474QETX_FLASH.ld) for the stack, so that buffer is
        `static` in commands.c, not a stack-local array, even though
        the actual runtime stack has much more room in practice (see
        AGENTS.md's own already-flagged, still-deferred note on stack
        sizing) -- not worth adding a multi-KB stack frame to a
        codebase that has already flagged this as an open question
        rather than a settled one.

        Verified on real hardware: clean rebuild (zero warnings) with
        PFM_INPUT_FEATURE_ENABLED both 1 and 0 (confirms genuine
        removability -- disabling drops 14704 bytes of .bss, and fixes
        the extern/IRQHandler linkage gap described above, confirmed by
        the disabled build actually linking cleanly). With it enabled:
        reflashed, PFMIN:CAPTURE 20 with no FIRE yet -> PFMIN:STATUS?
        correctly reads all zeros (arming alone touches no hardware);
        M=0 and M=9999 both correctly rejected with ERR 9; channel 0
        and 7 both correctly rejected with ERR 8 on PFMIN:DATA?; a
        normal TABLE upload + FIRE with an armed-but-unconnected
        capture completed normally (FIRE still replies OK immediately,
        no blocking) and PFMIN:STATUS?/DATA? afterward correctly showed
        all-zero counts (no signal present on any PFM_Input pin on this
        bench right now, the expected result, not a hang). NOT yet
        verified on real hardware: an actual signal's period/duty
        values coming back correctly, the TIM2/TIM5 shared-channel
        independence claim, and a fault-triggered stop mid-capture --
        all need a real signal source (function generator, or an HRTIM
        output looped back to a PFM_Input pin) and are the bench's own
        work, not something this session could do standalone.
        docs/command_reference.md not yet updated with
        PFMIN:CAPTURE/STATus?/DATA?/ERR 8/9 -- deferred until that
        bench verification lands, so the write-up reflects fully
        confirmed behavior, not just the command-layer shape of it.

2026-09-08  —  QUADSPI test module (qspi_test.c/.h) -- W25Q128JVS
               connectivity confirmed on real hardware
-----------------------------------------------------------------------
  Change:  Requested as an easily removable module, following
        boot_jump.h's own "self-contained and removable" pattern
        exactly: QSPI_TEST_FEATURE_ENABLED (qspi_test.h) is the single
        point of control. Scope, per direct confirmation: connectivity
        only -- one command, the W25Q128JVS's standard JEDEC Read ID
        instruction (0x9F, plain 1-line mode, no Quad Enable required)
        -- not a general QUADSPI driver, not program/erase, not
        memory-mapped access.

        HAL enablement: stm32g4xx_hal_qspi.c/.h did not exist in this
        project's Drivers/ tree at all (QUADSPI was never enabled via
        CubeMX here). Copied from STM32Cube_FW_G4_V1.6.3's package,
        chosen specifically because it bundles HAL Driver V1.2.7 -- an
        exact version match against every other driver file already in
        this project (confirmed via each file's own version banner
        before copying, not assumed) -- to avoid any HAL-version API
        mismatch. HAL_QSPI_MODULE_ENABLED uncommented in
        stm32g4xx_hal_conf.h. Both Debug/Drivers/.../subdir.mk and
        Debug/objects.list needed the same hand-patching gotcha
        AGENTS.md already documents for Core/Src additions -- this is
        the first time it applied to Drivers/ instead.

        Pin/AF mapping verified before writing any code, not assumed
        from the HAL header's existence: docs/pin_mapping_v4.csv lists
        PE12-PE15 (BK1_IO0-3) and PB10/PB11 (CLK/BK1_NCS). The HAL only
        exposes two QUADSPI-capable AF constants (AF3, AF10) and which
        one applies is pin-specific -- confirmed via the same datasheet
        column-position method already trusted in this project (Table
        13), calibrated against three independent already-known-good
        reference points on the same table rows (TIM1_CH3N->AF2,
        SPI4_SCK->AF5, FMC_D9->AF12 on the PE12 row; USART3_TX->AF7,
        HRTIM1_FLT3->AF13 on the PB10 row -- that last one an exact
        cross-check against this session's own already-hardware-verified
        PC10/HRTIM1_FLT6->AF13 result). All 6 pins landed on AF10
        (GPIO_AF10_QUADSPI) -- confirmed, not guessed.

        qspi_test.c: HAL_QSPI_MspInit()/MspDeInit() live here, not in
        stm32g4xx_hal_msp.c, matching hrtim.c's own precedent for
        hand-added (non-CubeMX-generated) peripheral pin config -- see
        AGENTS.md's "NOT REGEN-SAFE" HRTIM/CubeMX collision history for
        why. QUADSPI kernel clock explicitly set to SYSCLK
        (HAL_RCCEx_PeriphCLKConfig(), RCC_QSPICLKSOURCE_SYSCLK) rather
        than relying on the POR default being correct. ClockPrescaler
        chosen for a conservative 5 MHz first-bring-up rate (170 MHz
        SYSCLK / 34). NCS pin gets GPIO_PULLUP (flagged assumption, no
        external pull confirmed -- idle-deselected-by-default before
        the peripheral drives it); CLK/IO0-3 get GPIO_NOPULL.

        New QSPI:ID? command (commands.c/commands.h, cmd_parser.c),
        gated on QSPI_TEST_FEATURE_ENABLED the same way BOOT is gated
        on BOOT_JUMP_FEATURE_ENABLED -- entirely absent from the
        command table when disabled. Reports the 3 raw ID bytes as hex
        ("OK EF 40 18"), no hardcoded expected value asserted -- the
        command reports what the chip says, doesn't claim to validate
        it. New ERR 7 (QUADSPI command/receive failure or timeout).

        BUGFIX, found and fixed via real-hardware testing, not
        docs/guesswork: the first QSPI:ID? attempt against actual
        silicon returned a stable, repeatable "DE 80 30" instead of the
        expected Winbond "EF 40 18". Confirmed this was not noise or a
        wiring fault: EF4018 left-shifted by exactly 1 bit (as one
        continuous 24-bit stream) == DE8030, an exact match. Root cause:
        QSPI_InitTypeDef.SampleShifting was QSPI_SAMPLE_SHIFTING_HALFCYCLE
        (the usually-recommended default, meant to compensate for
        signal propagation delay) -- switching to
        QSPI_SAMPLE_SHIFTING_NONE fixed it immediately and repeatably.
        Plausible explanation (not chased further): at this
        deliberately conservative 5 MHz and whatever this board's
        QUADSPI trace length actually is, the extra half-cycle of
        sample delay overshoots past the valid data window instead of
        centering in it. Documented inline in qspi_test.c; worth
        revisiting if the clock rate is ever raised well past 5 MHz.

        Verified on real hardware, end to end: clean rebuild (zero
        warnings) both with the module enabled and with
        QSPI_TEST_FEATURE_ENABLED forced to 0 (confirms genuine
        removability, not just a claim -- disabling drops 2308 bytes of
        .text and the command disappears from the table). With it
        enabled and the SampleShifting fix applied: QSPI:ID? returned
        "OK EF 40 18" -- correct Winbond manufacturer ID, correct
        W25Q128 memory type/capacity bytes -- repeatably (3x) after
        reflashing. This confirms the new QUADSPI hardware (pins,
        traces, the W25Q128JVS itself) is wired and responding
        correctly, beyond just the firmware compiling.

        docs/command_reference.md updated with QSPI:ID?/ERR 7 -- and,
        since this session's real-hardware verification of the
        GateDriverStatus fault path (see the entry below) was already
        thorough enough to stand on its own, FAULT?/FAULT:CLEAR/ERR 6
        got written up in the same pass rather than staying deferred
        any longer, with the PC10-specific low-drive bench trip
        clearly flagged there as the one still-open item.

2026-09-08  —  GateDriverStatus fault interrupt (PE0-PE11) + version.h/
               ctrlr_config.h re-condensed
-----------------------------------------------------------------------
  Change:  Two changes requested together, both in ctrlr_config.h:

        1. version.h condensed back into ctrlr_config.h. Briefly split
        earlier the same day (identity in version.h, behavior in
        ctrlr_config.h) on the reasoning that identity and behavior are
        different kinds of thing -- re-condensed per direct request,
        back to one config file, matching the sibling PFM-STM32G474
        project's single supply_config.h. version.h deleted;
        HW_BOARD_NAME/REV, FW_VERSION_STRING now live in
        ctrlr_config.h. Only one includer existed (commands.c); updated,
        plus doc-comment references in commands.h/commands.c/AGENTS.md.

        2. GateDriverStatus_01..12 (PE0-PE11) promoted from GDS?'s
        read-only diagnostic (see the entry below) to a real fault
        interrupt that can stop PWM output on its own, independent of
        PC10/HRTIM1_FLT6. New GDS_FAULT_POLARITY (ctrlr_config.h,
        NORMALLY_HIGH/NORMALLY_LOW, naming matches the sibling
        PFM-STM32G474 project's supply_config.h exactly) -- set to
        NORMALLY_LOW after direct confirmation against this board's
        actual gate driver ICs. Single source of truth in one file,
        avoiding the sibling project's own documented history of this
        same setting once being defined twice (supply_config.h and
        gate_driver.h, with gate_driver.h's #ifndef always silently
        winning) -- not a risk here structurally, since gate_driver.h
        includes ctrlr_config.h rather than defining anything itself.

        main.c: PE0-PE11 upgraded from GPIO_MODE_INPUT to
        GPIO_MODE_IT_RISING_FALLING (both edges -- the fault/healthy
        determination happens in software against GDS_FAULT_POLARITY,
        not by picking a trigger edge), plus __HAL_RCC_SYSCFG_CLK_ENABLE()
        (required for HAL_GPIO_Init() to actually route EXTI lines) and
        NVIC priority/enable for all 7 vectors PE0-PE11 spans
        (EXTI0-EXTI4 individually, EXTI9_5, EXTI15_10 -- tied with
        HRTIM1_Master_IRQn's priority, above USART2's).

        stm32g4xx_it.c: 7 new IRQ handlers, each clearing only its own
        pin's pending bit then calling gate_driver.c's
        GateDriver_CheckFault() -- which re-reads and evaluates ALL 12
        pins itself regardless of which specific edge woke the CPU, per
        the literal ask ("bitwise read PE0 through PE11" -- see below
        for why PE11, not PE12 as originally asked; confirmed with the
        user before implementing).

        gate_driver.c/.h: new GateDriver_CheckFault() (bitwise mask
        against GDS_FAULT_POLARITY: NORMALLY_LOW faults on any HIGH bit,
        NORMALLY_HIGH faults on any LOW bit; on a fault, immediately
        PFM_ForceStop() + latch) and GateDriver_FaultIsLatched()/
        GateDriver_FaultClear(). GateDriver_FaultClear() clears the
        latch then immediately re-validates by calling
        GateDriver_CheckFault() again -- deliberate, and load-bearing:
        unlike PC10/HRTIM1_FLT6's hardware latch (which re-trips on its
        own if the condition is still physically present),
        GateDriver_CheckFault() only ever runs from an EXTI edge (or the
        one explicit boot-time call, next paragraph) -- without the
        recheck, clearing a still-bad pin would silently report FAULT?
        OK 0 until the next incidental toggle.

        main.c also gained one explicit GateDriver_CheckFault() call at
        boot, before uart_init(). EXTI is edge-triggered: a pin already
        in its fault state at the moment PE0-PE11 are configured for
        interrupt mode produces no edge of its own and would otherwise
        go undetected until something happened to toggle it later. This
        was not a hypothetical concern -- see Verified below.

        pfm.h/pfm.c: new PFM_ForceStop() (HRTIM1_PWM_Stop() +
        g_pfmState = STOPPED), extracted from the two places
        PFM_CycleBoundaryHandler() already did exactly this inline (the
        PC10-fault and empty-table branches), so GateDriver_CheckFault()
        -- running from EXTI context, independent of the HRTIM
        master-repetition ISR -- can force the same clean stop without
        leaving g_pfmState stale at RUNNING.

        commands.c: FAULT?/FAULT:CLEAR/FIRE's ERR 6 check now consider
        BOTH fault sources via a new AnyFaultLatched() helper
        (HRTIM1_FaultIsTripped() || GateDriver_FaultIsLatched()) --
        combined only at this command layer; the two detection
        mechanisms stay structurally independent underneath. FAULT:CLEAR
        clears both latches unconditionally.

        Pin range clarified before implementing, not assumed: the
        request said "PE0 through PE12," but docs/pin_mapping_v4.csv
        shows PE12 is unconnected on this board (QUADSPI_BK1_IO0, "No
        connection") while PE0-PE11 are exactly the 12 GateDriverStatus
        pins already confirmed by GDS?. Confirmed PE0-PE11 (12 pins) was
        intended before writing any pin-mask/EXTI code -- including an
        unconnected, floating PE12 in the fault-OR logic would have
        risked either a spurious permanent fault-lock or, depending on
        how it happened to float, silently masking a real fault.

        Verified on real hardware, end-to-end: clean rebuild (zero
        warnings), reflash. GDS? read GateDriverStatus_03 (PE2) already
        HIGH -- under the confirmed NORMALLY_LOW polarity, that's a real
        fault condition, present before this change ever existed to
        detect it. Immediately after flashing: FAULT? read OK 1 (the
        boot-time explicit check caught it, confirming that fix was not
        just theoretical), FIRE was correctly rejected with ERR 6, and
        FAULT:CLEAR correctly re-latched (FAULT? back to OK 1 right
        after) rather than clearing a fault that was still physically
        present -- confirming the recheck-on-clear behavior end to end,
        not just by inspection.

2026-09-08  —  GateDriverStatus diagnostic (GDS?, PE0-PE11)
-----------------------------------------------------------------------
  Change:  Added a raw HIGH/LOW readback of the 12 GateDriverStatus_01
        through _12 pins (PE0-PE11, GPIOE -- docs/pin_mapping_v4.csv),
        requested while investigating why a fault wasn't being
        registered. New Core/Src/Inc/gate_driver.c/.h -- deliberately
        narrow (unlike the sibling PFM-STM32G474 project's
        gate_driver.c/fault_pins.c): just GateDriver_Read(), a direct
        GPIOE->IDR read with no debounce, no fault-latching, no per-pin
        polarity/callback table. These 12 pins are gate-driver-IC status
        outputs and were never wired into HRTIM's native fault input
        (HRTIM1_FLT6/PC10, see the entry below) -- this command cannot
        stop PWM by itself; it's read-only visibility.

        These pins had never been configured as GPIO inputs at all
        before this change -- MX_GPIO_Init() (main.c) only enabled
        GPIOA. Added GPIOE clock enable + GPIO_MODE_INPUT/GPIO_NOPULL
        config for PE0-PE11 there, matching the sibling project's
        gpio.c precedent for these same 12 pins exactly (plain input,
        no pull -- actively driven by the gate driver ICs).

        New GDS? command (commands.c/commands.h, cmd_parser.c) reports
        all 12 states on a single OK line ("OK 01=HIGH 02=LOW ...",
        NN = 01-12 matching the GateDriverStatus_01..12 numbering,
        space-separated, PE0 first) -- kept to this project's existing
        single-"OK <value>"-line convention rather than adopting the
        sibling project's multi-line/bitmask GDS? reply shapes.

        Build note: gate_driver.c is a source file added directly (not
        via CubeIDE's UI), so Debug/Core/Src/subdir.mk and
        Debug/objects.list both needed hand-patching to pick it up from
        the command line -- see AGENTS.md's "Adding a new source file
        from outside CubeIDE" note (already documented there from
        earlier files; not new guidance).

        Verified on real hardware: clean rebuild (zero warnings),
        reflash, GDS? read twice back-to-back -- stable, repeatable
        result (11 of 12 pins LOW, one HIGH) on this board's current
        as-wired state. What that particular pattern means electrically
        (which pin, what it indicates) was not interpreted here -- raw
        readback only, by design.

2026-09-08  —  HRTIM native hardware fault input (PC10 / HRTIM1_FLT6)
-----------------------------------------------------------------------
  Change:  Wired up PC10, wired on this board directly to HRTIM1's own
        FLT6 fault input (docs/pin_mapping_v4.csv), as a real silicon-
        level fault mechanism -- the peripheral forces every fault-
        enabled channel's outputs to a safe (INACTIVE) level
        autonomously, in hardware, the instant the pin trips, with no
        CPU/interrupt/polling latency and no dependency on the CPU
        being alive. Deliberately NOT the sibling PFM-STM32G474
        project's HRTIM1_EmergencyStop()/fault_pins.c approach (a
        GPIO-polled pin, software-forced off after the fact) -- this
        project's hrtim.h had flagged that as "port verbatim when fault
        handling is added"; the real ask turned out to be stronger than
        a port, so it wasn't ported.

        Active-low (fault = pin driven low), per direct confirmation
        against the fault-sensing circuit. AF13 (GPIO_AF13_HRTIM1)
        confirmed via the same datasheet column-position method already
        trusted in this project, re-calibrated against the already-known
        -good PC8/AF3 result before trusting the new PC10 result.

        hrtim.c: HAL_HRTIM_MspInit() configures PC10 (AF13, GPIO_PULLUP
        -- a flagged defensive-default assumption, no external pull
        confirmed). HRTIM1_FullInit() adds HAL_HRTIM_FaultConfig() +
        HAL_HRTIM_FaultModeCtl() for FLT6 (DIGITALINPUT source, LOW
        polarity), pTimerCfg.FaultEnable = HRTIM_TIMFAULTENABLE_FAULT6
        for every timer, pOutputCfg.FaultLevel =
        HRTIM_OUTPUTFAULTLEVEL_INACTIVE for every output (the field that
        actually does the output-safing; FaultEnable alone does not).
        New HRTIM1_FaultIsTripped() (reads the ISR flag directly, no
        software cache) and HRTIM1_FaultClear() (stops counters, clears
        the flag -- deliberately does NOT re-issue
        HAL_HRTIM_WaveformOutputStart() itself; reconnecting outputs is
        left entirely to the next explicit FIRE -> PFM_Restart() ->
        HRTIM1_PWM_Start(), which already does a complete from-scratch
        reconnect with no assumption about prior state, so duplicating
        any part of it here would be unnecessary risk -- a deliberate
        simplification of this feature's own plan, reasoning recorded in
        the code comment).

        pfm.c: PFM_CycleBoundaryHandler() gains a bookkeeping check --
        if HRTIM1_FaultIsTripped(), stop the counters and get
        PFM_GetState() out of RUNNING (the hardware has already safed
        the outputs by the time this ever runs; this just stops the
        table from silently continuing to advance).

        commands.c/commands.h/cmd_parser.c: new FAULT? (OK 0|1) and
        FAULT:CLEAR (OK) commands, and FIRE now rejects with a new
        ERR 6 ("Fault latched -- send FAULT:CLEAR first") if a fault is
        latched, checked before the existing empty-table ERR 5 check.
        Latched-until-cleared by design (matching the sibling project's
        Lockout/CLEARFAULTS convention) -- FAULT:CLEAR must be sent
        explicitly even after the physical fault condition has gone
        away; a fault silently clearing itself with output resuming
        unnoticed is the hazard this avoids.

        Verified on real hardware so far: clean rebuild (zero warnings),
        reflash, command-layer pass with no fault forced -- FAULT? reads
        OK 0 at idle (PC10's idle-high state does not read as a spurious
        trip, the key regression risk from this change), FIRE still
        works normally. NOT yet verified: an actual PC10-low trip
        observed on scope/DSLogic, and the FAULT:CLEAR recovery sequence
        (whether clearing the flag alone is sufficient to resume PWM on
        the next FIRE) -- both need the pin physically driven low on the
        bench, still pending. docs/command_reference.md not yet updated
        with these commands/ERR 6 -- deferred until that bench
        verification is done, per the original plan's own verification
        checklist.

2026-09-08  —  Configurable HRTIM channel count (compile-time, 1-5)
-----------------------------------------------------------------------
  Change:  Requested as a planned, reviewed change (plan mode used
        directly): make version.h's PWM_NUM_CHANNELS -- documentation-
        only since it was added, "NOT read by hrtim.c today" -- into a
        real, working setting. New Core/Inc/ctrlr_config.h holds
        HRTIM_NUM_CHANNELS (1-5, #error-guarded outside that range),
        superseding PWM_NUM_CHANNELS; version.h now holds board/
        firmware IDENTITY only, a deliberate split from the prior "one
        config file" decision (both files' headers explain why).

        Range is 1-5, not 1-6, because the HRTIM Master timer has
        exactly 4 compare registers (5 total trigger points incl. its
        own PER event) -- confirmed against the HAL headers before
        committing to this scope, along with confirming real (if
        unused here) HAL support exists for a 6th phase-locked channel
        via cross-timer HRTIM_TIMRESETTRIGGER_OTHERx_CMPy reset
        triggers -- deliberately left as a follow-up, not bundled in,
        since it needs new phase math with no existing pattern to
        extend.

        Generalized (every hardcoded A/B/C block became a loop over
        0..N-1, or in HRTIM1_FullInit()'s case 0..5 with the
        phase-locked/free-running split moving to depend on N instead
        of being hardcoded per timer):
          - pfm.h/pfm.c: PFM_Step_t's cmpA/cmpB/cmpC -> cmp[N], sized
            exactly per build (N=3 stays 8 B/entry, unchanged;
            N=4->10 B, N=5->12 B). PFM_Phase120()/PFM_Phase240() ->
            PFM_PhaseForChannel(). PFM_Phase_t/PFM_SetPhaseEnabled()/
            PFM_GetPhaseEnabled() -> plain 0..N-1 channel index, same
            durability contract (not reset by PFM_Init() after the
            first call -- see that function's own comment for why a
            GCC __attribute__((constructor)) approach was tried and
            rejected in favor of a portable static-flag pattern, no
            dependency on __libc_init_array() actually running).
          - hrtim.h/hrtim.c: HRTIM1_FullInit()'s A/B/C-phase-locked +
            D/E/F-free-running blocks -> one loop, channel < N gets
            MASTER_PER (channel 0) or MASTER_CMP1..4 (channels 1..N-1),
            channel >= N gets ResetTrigger=NONE (identical to the old
            D/E/F treatment). HRTIM1_PWM_Start()'s per-phase cold-start
            settling (see the 2026-09-04 entries below) generalizes
            directly, unchanged in mechanism -- HRTIM1_WaitForPhase
            AndConnect() now called in a loop (channels 1..N-1 ascending,
            channel 0 last) instead of 3 named calls.
            HRTIM1_ApplyPfmStep() takes (per, cmp[], phase[]) instead of
            6 named scalars. Per-channel register-address getters
            (HRTIM1_GetTimerAPerRegAddress() etc.) -> single indexed
            getters (HRTIM1_GetTimerPerRegAddress(channel) etc.) backed
            by lookup tables confirmed against the HAL headers
            (HRTIM_TIMERINDEX_TIMER_A..F sequential 0x0-0x5;
            HRTIM_OUTPUT_Tx1/2 bitmasks arithmetic but looked up via
            named-constant tables anyway rather than relied on as raw
            bit tricks, since this path isn't latency-critical the way
            HRTIM1_PWM_Start()'s cold-start settling is).
          - commands.c: TABLE:STEP's fixed 4-token parse -> 1+N tokens
            (per + one compare per channel). New CONFig:CHANnels?
            (OK <N>) so host tooling can confirm a board's actual N
            instead of assuming it.
          - python/pfm_table_upload.py: build_table()/_ramp() build
            (per, *cmp[0..N-1]) tuples via a new _entry() helper instead
            of hardcoded 4-tuples; queries CONFIG:CHANNELS? at startup
            and refuses to upload on a mismatch against its own
            HRTIM_NUM_CHANNELS constant.

        A real bug was found and fixed during this work, not just
        designed around: cmd_table_step()'s first version tried to
        stringify TABLE_STEP_TOKEN_COUNT (= 1 + HRTIM_NUM_CHANNELS)
        with the standard #x/two-level preprocessor stringification
        idiom -- which only works on plain literals, not expressions,
        so the ERR 4 message printed the literal unevaluated text
        "(1U + (4U))" instead of "5". Caught by actually reading the
        real device reply during hardware testing, not just compiling.
        Fixed with a runtime snprintf() (SendTableStepCountErr())
        instead of compile-time stringification.

        Verified: full clean rebuild at the default N=3, zero warnings,
        .bss unchanged from before this change (PFM_Step_t stays
        exactly 8 B/entry at N=3 -- confirms the generalization adds no
        overhead at the project's actual current channel count).
        Reflashed over serial, *IDN? and the new CONFig:CHANnels? both
        correct, a real 500-entry table uploaded (with the new
        mismatch-check passing) and FIRE'd twice, board stayed fully
        responsive throughout.

        Then temporarily rebuilt at N=4 specifically to prove the
        generalization works at a DIFFERENT channel count, not just
        N=3 restated: .bss grew by exactly the predicted +10,000 B
        (2 B/entry x 5000 entries -- real .map numbers, not estimated),
        CONFig:CHANnels? correctly reported 4, a hand-built 4-wide
        table uploaded and FIRE'd cleanly, and the wrong-token-count
        rejection (ERR 4, with the now-fixed message) was confirmed
        against a deliberately-3-wide TABLE:STEP. Also confirmed the
        ctrlr_config.h #error guard actually fires for an out-of-range
        N=6, not just that the comment claims it does. Reverted to the
        real N=3 default before committing -- N=4/5 are proven to
        compile, flash, and respond correctly at the command layer;
        they are not the shipped setting.

        NOT done as part of this entry: a DSLogic capture confirming
        N=4/5's actual electrical waveform (even spacing at the new
        angle, correct dead time on the added channel) -- this
        project's physical probes have only ever been wired to 3
        channels, so that verification needs new wiring plus a bench
        pass, out of scope for a from-the-desk implementation session.
        Command-layer + RAM-math verification above is real and
        thorough, but it is not a substitute for that.

2026-09-04  —  New tool: python/dsl_viewer.py
------------------------------------------------
  Change:  Requested directly: an easier way to visualize/interact with
        saved DSLogic .dsl captures, specifically to zoom the time axis
        -- every .dsl decode this session up to now was a one-off
        script (unzip, parse the INI header, unpack the bit-packed
        L-<channel>/0 files, print edge timestamps by hand). Generalized
        that into a real, reusable interactive viewer instead of
        re-deriving it next time.

        Renders every channel as a stacked digital trace (matplotlib),
        picks up channel names already set in DSView's own session JSON
        automatically (or via --labels), and skips all-zero/disabled
        channels by default (e.g. this project's usual unconnected
        4/5) unless --all-channels is passed. Two custom interactions
        on top of matplotlib's own pan/zoom toolbar: scroll wheel zooms
        the time axis only, centered on the cursor (the actual ask --
        dragging a zoom box every time was the friction point); and a
        two-cursor measurement readout (left-click = cursor A,
        right-click = cursor B, delta time + implied frequency shown in
        the title) -- directly mirrors the manual edge-timing math this
        session kept doing by hand for dead time, phase spacing, and
        duty cycle.

        .dsl format handling documents its own scope honestly: only
        device mode 0 (plain digital capture) and single-block files
        are supported, both confirmed by every real capture decoded
        this session -- multi-block or oscilloscope-mode captures raise
        a clear error instead of silently misdecoding, since neither
        has ever actually been seen to verify against.

        Verified against a real capture (the 50176-sample profile-3
        capture from the per-phase cold-start fix, see the entry
        further below): decoded and rendered correctly headlessly
        (--save) at both the full 5ms view (a dense, expected "brush"
        pattern at 100 kHz) and a zoomed 22us window, matching the
        hand-decoded values from that same file earlier in this
        session exactly. Also caught and fixed a real argparse bug
        during testing: a single --window "start,end" argument silently
        failed on any negative start time (argparse mistook the leading
        "-" for another flag) -- replaced with separate --window-start/
        --window-end float arguments instead of working around it.

2026-09-04  —  Documentation: SOP Rev B (TABLE/FIRE procedure)
------------------------------------------------------------------
  Change:  docs/sop/wham_pfmg474_v4_sop.tex Rev A (2026-08-31) predated
        TABLE:*/FIRE entirely and explicitly stated "this firmware
        currently implements no PWM, HRTIM, or power-stage control" --
        no longer true. Requested directly: update it to explain the
        new functionality (one-time pass, not itself an ongoing
        changelog-style update).

        Added Section 8, "Procedure: Upload and Fire a PFM Table"
        (build a table with python/pfm_table_upload.py, confirm via
        TABLE:END/TABLE?, send FIRE, note auto-stop and the ERR 5
        empty-table guard) with a CAUTION callout matching the
        severity of what changed: this firmware now drives real HRTIM
        PWM output the instant FIRE is sent, with no ARM step, state
        machine, or fault interlock. Section 2 (Scope) rewritten to
        acknowledge this rather than continue asserting the old "no
        PWM" claim -- the SOP's prior blanket exclusion of power-stage
        operation is now backed by an explicit caution instead of a
        (now false) statement that nothing is being driven. Also
        picked up the 115200 baud change (Section 7 and the revision
        table) while in there, since Rev A's "9600" text would
        otherwise mislead the very next person to follow it.

        Revision table: added Rev B row. References section: added
        pfm_table_upload.py and test_protocol.md.

        Verified: recompiled to PDF (pdflatex, 2 passes -- all
        cross-references resolved clean, only benign font-substitution
        warnings), visually reviewed the rendered output page by page,
        confirmed the CAUTION box and section numbering render
        correctly. Build artifacts (.aux/.log/.out) cleaned up,
        matching how this repo doesn't track those elsewhere.

2026-09-04  —  Baud rate raised 9600 -> 115200 (real-hardware experiment)
-----------------------------------------------------------------------------
  Change:  Requested directly: "can we experiment with increasing the
        baud rate?" -- motivated by table uploads still taking a few
        seconds even after the earlier read_until() fix (see the
        pfm_table_upload.py entry further below), since a meaningful
        chunk of that time is genuinely wire time at 9600 baud, not
        avoidable per-call overhead.

        Method: real hardware, not a guess -- edited main.c's
        huart2.Init.BaudRate, rebuilt, reflashed, and measured a full
        500-entry TABLE:STEP upload at each step.
          9600    -> ~20 s   (established baseline, see earlier entry)
          115200  -> 3.3 s   clean *IDN?, clean upload, OK 500. ~6x.
          921600  -> FAILED  consistently garbled replies (same length,
                              wrong content, re-tried 3x -- a real baud
                              mismatch/reliability failure, not a fluke)

        921600 also broke serial recovery: BOOT needs a working link to
        even request the ROM bootloader, so a board stuck at a bad baud
        can't reflash itself back to a good one over serial. Recovered
        with an ST-Link connected mid-session: `st-info --probe`
        confirmed detection (STM32G47x_G48x, chipid 0x469), then
        `st-flash write Debug/WHAM-PFMG474-V4.bin 0x08000000` flashed
        the 115200 build directly over SWD, completely bypassing the
        broken serial link. *IDN? at 115200 confirmed recovery
        immediately after.

        Settled on 115200 (explicit decision, not further tuned) --
        clearly a large win (~6x) and clearly reliable, without chasing
        the exact ceiling between 115200 and 921600 (230400/460800
        untested, left as a real gap if anyone wants to push further
        later). This is a WHAM-PFMG474-V4-only change -- the sibling
        PFM-STM32G474 project still uses 9600, and this doesn't imply
        porting it there.

        Updated everywhere the old convention was written down: main.c
        (with an updated regen-hazard comment -- HAL's own CubeMX
        default now happens to BE 115200, so a future .ioc regen
        wouldn't visibly break this by coincidence, which is not the
        same as it being safe on principle), python/wham_serial_flash.py
        (APP_BAUD_DEFAULT + docstring), python/pfm_table_upload.py
        (APP_BAUD + comment), python/scpi.py (BAUD, flipping which of
        the file's own two candidate lines was already active),
        docs/command_reference.md, docs/test_protocol.md,
        docs/serial_reflash_guide.md, AGENTS.md.

        Verified: full clean rebuild at 115200, zero warnings.
        Reflashed (via the recovered ST-Link path), *IDN? clean,
        500-entry table re-uploaded and confirmed (OK 500) at the new
        baud and measured speed.

2026-09-04  —  Per-phase cold-start settling (real fix, not just jitter reduction)
-----------------------------------------------------------------------------------
  Change:  A fresh DSLogic capture of profile 3 (90% -> 10% ramp) exposed
        that the previous two entries below, while a real improvement,
        hadn't actually gotten the phase-lock settling right -- they
        eliminated the catastrophic U/V/W collision, but connected all
        three outputs together after waiting for a single event (one
        full Master period). Since V/W's own ResetTrigger (MASTER_CMP1/
        CMP2) fires much earlier (1/3, 2/3 of a period), by the time all
        three connected together V/W were already mid-way through
        whatever their comparators had been doing since that earlier,
        still-hidden reset -- exposing a stale/in-progress duty cycle,
        not a clean pulse, and what looked like a "recovery" edge near
        120/240 deg was actually just each timer's own natural TIMPER
        rollover after its hidden reset -- which only lands near there
        by coincidence of that particular duty value, not by design.
        Confirmed by decoding the .dsl capture's raw per-channel data
        directly (per-channel bit-packed L-N/0 files inside the archive).

        Real fix: HRTIM1_PWM_Start() now waits for and connects each
        phase SEPARATELY, at its own reset-trigger event -- new static
        helper HRTIM1_WaitForPhaseAndConnect(), called three times (V at
        MASTER_CMP1, W at MASTER_CMP2, U at MASTER_PER/MREP, in that
        chronological order within one masked critical section). V/W
        additionally re-force output1 ACTIVE/output2 INACTIVE (direct
        SETx1R/RSTx2R writes, same reasoning as the direct OENR write)
        at the exact moment their flag is observed -- necessary because
        an externally-triggered counter reset does NOT itself generate
        a fresh SET event (confirmed against the capture data), so
        without this the output would still reflect whatever the
        original pre-counter-start force-ACTIVE call left it in, not a
        clean restart. Timer A needs no such re-force: MASTER_PER
        coincides with its own natural rollover, a genuine TIMPER
        SET-source event that already transitions the output correctly
        on its own. Net effect: nothing visible on V/W until 120/240 deg
        after U's first edge, then a clean, correctly-timed,
        correctly-dutied pulse -- not a snapshot of an in-progress cycle.

        Considered and rejected: reverting to relying solely on
        pre-loading step 0's per/compare values (raised directly, in
        chat) instead of delaying output connection at all. Doesn't
        work -- PFM_Restart() already pre-loads those values via
        PFM_ApplyCurrentStep()/HRTIM1_SoftwareUpdate() BEFORE
        HRTIM1_PWM_Start() runs, unchanged since before any of these
        fixes existed, and the original bug happened anyway with that
        pre-loading already in place. The defect was never stale
        register content; it's genuine counter-timing settling that
        only resolves once real time has elapsed, which register values
        can't substitute for.

        Verified: full clean rebuild, zero warnings (text 34904->35036
        bytes vs. the masked-interrupt entry below). Reflashed, table
        re-uploaded, FIRE -> OK twice back to back, board stayed fully
        responsive to *IDN?/TABLE? throughout.

        CONFIRMED on real hardware the same day: a ~5 ms DSLogic capture
        spanning nearly the entire shot (499 of 500 periods) shows
        phase spacing holding rock-solid at ~3300 ns/~6600-6700 ns
        (target 3333/6667 ns for 120/240 deg) consistently from the
        cold-start edge all the way to the last period, and U's duty
        tracking profile 3's 90% -> 10% ramp cleanly throughout (86% ->
        73% -> 56% -> 41% -> 24% -> exactly 10.0% on the final sampled
        period) -- confirms PFM_CycleBoundaryHandler() advancing the
        table stays correctly phase-locked for the whole shot, not just
        at the exact startup instant. This closes out the cold-start
        phase-lock investigation that started with the first DSLogic
        capture earlier today.

2026-09-04  —  Masked interrupts during the settling wait's critical section
---------------------------------------------------------------------------
  Change:  Second follow-up to the cold-start phase-lock fix. A fresh
        DSLogic capture after the loop-tightening entry directly below
        showed real improvement (first pulse 200 ns -> 600 ns; U/V/W
        edge-timing error ~700 ns -> ~230-270 ns off target) but a
        genuine, non-shrinking residual remained -- and it varied run
        to run (200 ns, then 600 ns), which pointed away from a fixed
        software-latency floor and toward interrupt preemption:
        HRTIM1_PWM_Start()'s poll runs with global interrupts enabled,
        and SysTick (priority 0, the HIGHEST in this firmware -- see
        FixSysTickPriority()) or USART2 (priority 2, this very FIRE
        command's own reply path) can legitimately preempt the tight
        poll loop for a handful of cycles at exactly the wrong moment.

        Fix: wrapped the poll and the OENR write in __disable_irq()/
        __enable_irq() -- a short, bounded critical section (worst case
        ~385 us for a uint16_t `per`'s longest representable period,
        typically ~10 us at 100 kHz). Since HAL_GetTick() can't advance
        while global interrupts are masked (it's SysTick-driven, and
        SysTick is masked too), the previous entry's wall-clock timeout
        doesn't work here -- replaced with a plain 1,000,000-iteration
        spin-count ceiling, deliberately loose (many milliseconds of
        real time even pessimistically) rather than tuned, so it can
        only ever trip on a genuine hang, never in normal operation.

        Verified: full clean rebuild, zero warnings. Reflashed, table
        re-uploaded, FIRE -> OK repeatedly (fired twice back to back),
        board stayed fully responsive to *IDN?/TABLE? throughout -- no
        hang, and no UART data loss from the masked window (a ~10 us,
        worst-case ~385 us mask is far shorter than the ~1 ms/byte
        margin at 9600 baud, so an in-flight RX byte just sits in the
        UART's hardware data register a little longer, unaffected).
        Re-capturing with DSLogic to confirm the residual actually
        shrank is the next step, not yet done as of this writing.

2026-09-04  —  Tightened the cold-start settling wait's reaction latency
--------------------------------------------------------------------------
  Change:  Follow-up to the cold-start phase-lock fix directly below,
        after a fresh DSLogic capture confirmed it worked (U/V/W
        genuinely staggered, ~120/240 deg spacing accurate to a few
        counts in steady state) but also showed a small residual: the
        very first visible pulse still read ~200 ns instead of the
        clean ~1000 ns steady-state width -- software reaction latency
        between the MREP flag actually going true in hardware and
        HRTIM1_PWM_Start() acting on it, not a phase-lock problem.

        Two changes to HRTIM1_PWM_Start(), same function, no new
        approach:
          - The polling loop's inner spin no longer calls HAL_GetTick()
            on every iteration -- that's a real function call, added
            avoidable cycles to the exact latency being chased. The
            wall-clock timeout (still 5 ms, still Error_Handler() on
            expiry) is now sampled only every 256 spins; the inner loop
            itself is just a register read, compare, and branch.
          - Connecting the outputs on flag-observed now writes OENR
            directly (hhrtim1.Instance->sCommonRegs.OENR |= outputMask)
            instead of calling HAL_HRTIM_WaveformOutputStart(), which
            does the identical single register write wrapped in
            __HAL_LOCK/State=BUSY/__HAL_UNLOCK bookkeeping this call
            site doesn't need. Same precedent already used by
            HRTIM1_SoftwareUpdate()'s direct CR2 write elsewhere in
            this file. Re-arming HRTIM_MASTER_IT_MREP (needed before
            this function returns, not before) now happens AFTER the
            OENR write, not before -- it isn't time-critical, and
            keeping it out of the way removes two more register
            round-trips from the critical path.

        Verified: full clean rebuild, zero warnings (text +16 bytes net
        vs. the previous entry). Reflashed over serial, re-uploaded the
        table, FIRE -> OK promptly, board stayed responsive to *IDN?
        afterward -- the tightened spin loop and reordering introduced
        no hang or regression. Re-capturing with DSLogic to confirm the
        first-pulse width actually improved is the next step, not yet
        done as of this writing.

2026-09-04  —  Bugfix: cold-start phase-lock glitch on every FIRE
------------------------------------------------------------------
  Change:  Found via a real DSLogic U3Pro32 capture (decoded by hand --
        no capture-analysis tooling in this repo, just the .dsl
        archive's raw bit-packed channel data). Symptom: on every
        `FIRE`, U/V/W's first-ever output edges all landed on the
        exact same sample -- not staggered 120°/240° apart as
        intended -- producing ~1-2 garbled cycles (one phase measured
        holding ON ~7.4x too long; that first "period" reading as low
        as ~60 kHz) before self-correcting from cycle 2 onward. Matches
        what the user had independently noticed as "~60 kHz garbage for
        the first ~2 periods" on a real scope.

        Root cause: HRTIM1_PWM_Start()'s HAL_HRTIM_WaveformSetOutputLevel()
        calls (needed, per ST's own HAL guidance, to avoid an undefined
        complementary-pair state when DeadTimeInsertion is enabled)
        force TA1/TB1/TC1 all ACTIVE at the same instant, with no
        regard for their intended stagger. Timer A's ResetTrigger
        (MASTER_PER) happens to coincide with its own natural period
        rollover, but Timers B/C (ResetTrigger = MASTER_CMP1/CMP2)
        aren't genuinely phase-locked until they've received their
        first Master-CMPx-triggered reset -- which hasn't happened yet
        at the moment the counters first start.

        Fix: HRTIM1_PWM_Start() now starts the counters as before, but
        delays connecting the outputs to the pins (WaveformOutputStart())
        until the Master's own MREP (repetition) flag confirms one full
        period has genuinely elapsed in hardware -- by then every
        timer has already received its first phase-defining reset, so
        the first VISIBLE edge is already correctly phase-locked.
        Waiting on the hardware flag rather than computing a busy-wait
        from `per`/HRTIM_TIMER_CLK_HZ makes this automatically correct
        for whatever period is currently loaded -- no hardcoded 100 kHz
        assumption, so it stays correct if/when variable-frequency
        tables exist (per user request, 2026-09-04). HRTIM_MASTER_IT_MREP
        (armed at boot by HRTIM1_EnableMasterInterrupt(), and still
        armed from any previous shot) is masked for the duration of
        this wait and any stale flag discarded first -- otherwise
        PFM_CycleBoundaryHandler() would fire for real during the
        settling wait and silently advance the table to step 1 before
        step 0 was ever visible on the pins. Bounded to 5 ms
        (>12x margin over the ~385 us worst-case period a uint16_t
        `per` can represent) with an Error_Handler() fallback, matching
        this file's existing defensive-timeout convention (see
        HAL_HRTIM_PollForDLLCalibration() in HRTIM1_FullInit()).

        Verified: full clean rebuild (make clean && make all -j4, zero
        warnings; text grew 88 bytes). Verified on real hardware:
        reflashed over serial, re-uploaded a 500-entry table, sent
        FIRE -> OK promptly (no hang from the new bounded poll -- the
        real risk this change introduced), board stayed responsive to
        *IDN? immediately after. Re-capturing with DSLogic to confirm
        the actual edge timing is now clean is the next step, not yet
        done as of this writing.

2026-09-04  —  pfm_table_upload.py: reverted profiles 4/5's 0%-duty pad
--------------------------------------------------------------------------
  Change:  Reverted the leading 0%-duty pad added in the entry directly
        below, per project decision. Profiles 4 (10% -> 90%) and 5
        (90% -> 25%) are now plain full-500-period ramps, built the
        same way as profiles 2/3 (_ramp(), RAMP_STEPS=50 x
        RAMP_DWELL_PERIODS=10) -- no separate padded code path.
        PAD_PERIODS/PAD_RAMP_STEPS/PAD_RAMP_DWELL_PERIODS and
        _padded_ramp() removed as dead code.

        Verified offline (module import) before re-uploading: both
        profiles land at exactly 500 entries with clean start/end duty
        (profile 4: 10.01% -> 89.99%; profile 5: 89.99% -> 25.01%), no
        pad segment. Re-uploaded profile 4 to the board to replace the
        padded version from the entry below (TABLE:END -> OK 500).

2026-09-04  —  pfm_table_upload.py: profiles 4/5 (padded ramps)
-----------------------------------------------------------------
  Change:  Added two more fixed profiles, following a real-hardware
        DSLogic/scope bring-up session (see the FIRE entry below):
        PROFILE 4 (10% -> 90% ramp) and PROFILE 5 (90% -> 25% ramp),
        each preceded by 5 periods held at 0% duty as a clearly-zero
        baseline before the ramp starts -- useful for unambiguously
        marking a shot's actual start on a capture. Total entries
        still exactly 500 (5ms), matching profiles 1-3: the pad is
        carved out of the existing 500-period budget (5 pad + 495
        ramp, via new PAD_RAMP_STEPS=45 x PAD_RAMP_DWELL_PERIODS=11),
        not appended on top of it -- profiles 1-3's own math/behavior
        is untouched.

        Note: "0% duty" is approximate -- cmp_from_duty()'s existing
        [2, per-2] clamp (matching hrtim.c's HRTIM1_ClampCompare()
        margin) floors it to cmp=2, i.e. ~0.12% duty at per=1699, not
        a literal zero. Close enough to read as "off" on a scope, but
        worth knowing if reading exact numbers off a capture.

        Verified offline (module import, no serial connection) before
        touching hardware: both profiles land at exactly 500 entries,
        pad entries all identical at the cmp=2 floor, ramp endpoints
        within ~0.02% of the intended targets. Verified on real
        hardware: profile 4 uploaded and confirmed (TABLE:END -> OK
        500) over the actual serial link.

2026-09-04  —  Bugfix: pfm_table_upload.py ~25-50x slower than it
                should have been
------------------------------------------------------------------
  Change:  Found while running the first real end-to-end bench pass
        (flash -> upload -> FIRE) of the FIRE command below.
        send_and_expect_ok() read replies with a manual
        `while time.time() < deadline: chunk = ser.read(128)` poll
        loop against a Serial(..., timeout=1.0) port. pyserial's
        read(size) keeps trying to fill the *entire* requested size
        until the port's own timeout elapses, even once a short reply
        (every firmware reply here is a handful of bytes, e.g.
        "OK\r\n") has already fully arrived -- so every single
        TABLE:STEP round-trip was costing close to the full 1 s
        timeout instead of the real ~20-30 ms wire time at 9600 baud.
        500 entries were taking 8+ minutes; this was mistakable for
        "9600 baud is just slow", but the baud rate was never the
        problem.

        Fix: replaced the poll loop with ser.read_until(b"\n"), which
        returns the instant the terminator arrives (falling back to
        the port's timeout only on a genuine no-reply failure, which
        still needs to time out and raise). No protocol or firmware
        change. Verified: a real 500-entry upload (profile 1) dropped
        from 500-1000+ s to 20.2 s measured wall-clock, same successful
        `TABLE:END -> OK 500` result.

        Considered and deferred (see the FIRE entry below's own
        real-hardware pass for why 20 s was accepted as fine for now):
        batching multiple TABLE:STEP entries per line (needs a
        firmware/protocol change; marginal win once the read-loop bug
        is fixed, since ~30 s of raw payload at 9600 baud is close to
        the real floor for 500 entries either way) and pipelining
        without waiting for each ACK (real risk of silently overrunning
        uart.c's single-line RX buffer without first checking its
        buffering model -- not done without that check).

2026-09-04  —  FIRE command + HRTIM master-interrupt wiring, verified
                end-to-end on real hardware
-------------------------------------------------------------------------
  Change:  Closed the gap flagged in the previous entry and in
        AGENTS.md's "Known gaps": added a FIRE command that actually
        plays back an uploaded table. Two pieces, both ported from the
        sibling PFM-STM32G474 project:

          - hrtim.c gained HRTIM1_EnableMasterInterrupt() (enables
            HRTIM1_Master_IRQn, unmasks HRTIM_MASTER_IT_MREP), called
            once at boot from main.c -- the ISR is armed and ready
            before the first FIRE, not enabled reactively at fire
            time. stm32g4xx_it.c gained HRTIM1_Master_IRQHandler(),
            which clears the MREP flag and calls
            PFM_CycleBoundaryHandler() once per PWM period while the
            Master counter runs -- ported with the state-machine/
            fault-pin calls stripped out (SM_CycleBoundaryTick(),
            FaultPins_Poll()), since neither exists in this project.

          - main.c also gained FixSysTickPriority() (ported), called
            immediately after HAL_Init(), which raises SysTick's NVIC
            priority off HAL's default lowest value. Matches the
            sibling project's exact interrupt-priority scheme:
            SysTick=0 (highest), HRTIM1_Master=1, USART2=2 (USART2 was
            already at priority 2 here from the original serial-
            command-architecture port, so this completes a scheme that
            was already half in place). main.c now also calls
            PFM_Init() at boot (previously never called anywhere in
            this project) to bring the table module to a known-empty,
            known-stopped state before any command can touch it.

        commands.c/commands.h gained cmd_fire() -- wraps PFM_Restart()
        (resets to step 0, forces a software register update, starts
        HRTIM1_PWM_Start() for phases A/B/C), registered as FIRE in
        cmd_parser.c's command_table[]. One guard: rejects with the new
        ERR 5 ("Table is empty") if PFM_GetEntryCount() == 0 --
        otherwise an empty-table FIRE would silently blip outputs on
        and back off at the very first master-repetition interrupt
        (PFM_CycleBoundaryHandler()'s own defensive empty-table check),
        with no error ever reaching the operator.

        Deliberately NOT added, per project decision (scope stayed to
        exactly what was asked): no ARM/state-machine interlock (FIRE
        always takes effect immediately), no STOP command (playback
        only stops on its own at table exhaustion), no fault gating.
        See docs/command_reference.md's FIRE entry.

        Verified via a full Debug/ rebuild (make all -j4, clean) and
        `nm` confirming HRTIM1_Master_IRQHandler linked as a strong
        symbol overriding the startup file's weak Default_Handler
        alias (the vector table entry already existed there --
        HRTIM1 was never enabled via CubeMX's own IRQ-handler
        generation for this project, but the STM32G474 startup file
        lists every peripheral vector regardless of .ioc content).
        Verified end-to-end on real hardware the same day: flashed over
        serial (python/wham_serial_flash.py, `*IDN?` replying
        immediately post-flash, confirming the Go-jump/VTOR fix still
        holds), uploaded a real 500-entry table
        (python/pfm_table_upload.py, profile 1), then `FIRE` -> `OK`
        with no `ERR`. Command-layer round trip confirmed only --
        no scope was available in this pass, so the actual waveform
        (dead time, 120/240 deg phase spacing, duty accuracy) per
        docs/test_protocol.md's T4.5-T4.8 is still an open item, not
        yet observed on an instrument.

2026-09-04  —  PFM table upload (TABLE:BEGIN/STEP/END/?)
----------------------------------------------------------
  Change:  Added a serial command set for uploading a complete PFM
        shot profile from a host script -- pfm.c gained three minimal,
        generic primitives (PFM_TableReset()/PFM_AppendStep()/
        PFM_GetEntryCount(), no construction logic, no validation
        beyond "does it fit") and commands.c gained the four TABLE:*
        handlers that drive them over the wire. See pfm.h's "ADDED"
        header note and docs/command_reference.md for the full
        protocol.

        Table CONSTRUCTION deliberately stays off-controller, per
        project decision: python/pfm_table_upload.py is the reference
        builder, with exactly three fixed profiles for now (constant
        50% duty; duty ramping 25%->75%; duty ramping 90%->10%; all
        three at a constant 100 kHz carrier, all three ~5 ms total
        shot length), selected by editing a PROFILE constant before
        running -- explicitly not meant to be read as "the design" for
        how profiles will eventually be specified; that's undecided.

        Verified the math independently of any serial connection:
        loaded the script as a module and checked all three profiles'
        entry counts, period consistency, per-phase-always-equal
        invariant, and start/end duty percentages land where expected
        (profile 1: 500 entries @ 50.03% constant, matching hrtim.c's
        own hardcoded init default of 850/1699 exactly; profile 2:
        25.01%->74.99%; profile 3: 89.99%->10.01% -- all within
        rounding of the intended targets). Not yet verified against
        real hardware (no on-host test suite for this firmware -- see
        AGENTS.md); the actual serial round-trip and PFM_AppendStep()
        error paths (ERR 2/3/4) still need a bench pass.

        No command exists yet to fire an uploaded table (no ARM/FIRE,
        no state machine) -- this covers upload and verification
        (TABLE?) only.

2026-08-31  —  Documentation: AGENTS.md + docs/
-------------------------------------------------
  Change:  First documentation pass for this project. Added AGENTS.md
        (orientation file, mirroring the sibling PFM-STM32G474 project's
        convention), docs/command_reference.md, docs/serial_reflash_guide.md,
        and this changelog. Everything below this entry documents work
        that happened before the docs existed to record it as it went;
        dated to when it actually happened, reconstructed from the
        session it was done in.

2026-08-31  —  Bugfix: ROM bootloader Go-jump left interrupts dead
---------------------------------------------------------------------
  Change:  Found and fixed on real hardware while first testing
        wham_serial_flash.py end-to-end. Root cause, symptom, and fix
        are documented in full in boot_jump.c's BootJump_CheckAndEnter()
        and in docs/serial_reflash_guide.md Section 4 -- summary:

        Symptom: a serial reflash reported success (write + verify both
        passed via stm32flash), but the newly-flashed firmware was
        completely unresponsive over USART2 afterward -- *IDN? got no
        reply -- until the board was power-cycled, at which point it
        worked immediately and correctly.
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
