everettpenne/WHAM-CONTROLLERS/firmware/xrex/docs/reports/memory_history.csv

commit | date | subject | flash_used | flash_total | ram_used | ram_total | flash:Bootloader jump | flash:CMSIS | flash:CMSIS system init | flash:Firmware update | flash:Gate driver / faults | flash:HAL MSP config | flash:HRTIM driver | flash:IRQ vector dispatch | flash:Newlib syscalls | flash:Other | flash:PFM table engine | flash:PFM_Input capture | flash:Padding / unattributed (alignment, vector table, anon symbols) | flash:QUADSPI test | flash:ST HAL library | flash:Serial commands | flash:Startup/vector table |
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
