everettpenne/WHAM-CONTROLLERS/hardware/HVPS_Controller_V3/HVPS_Controller_V3.pdf

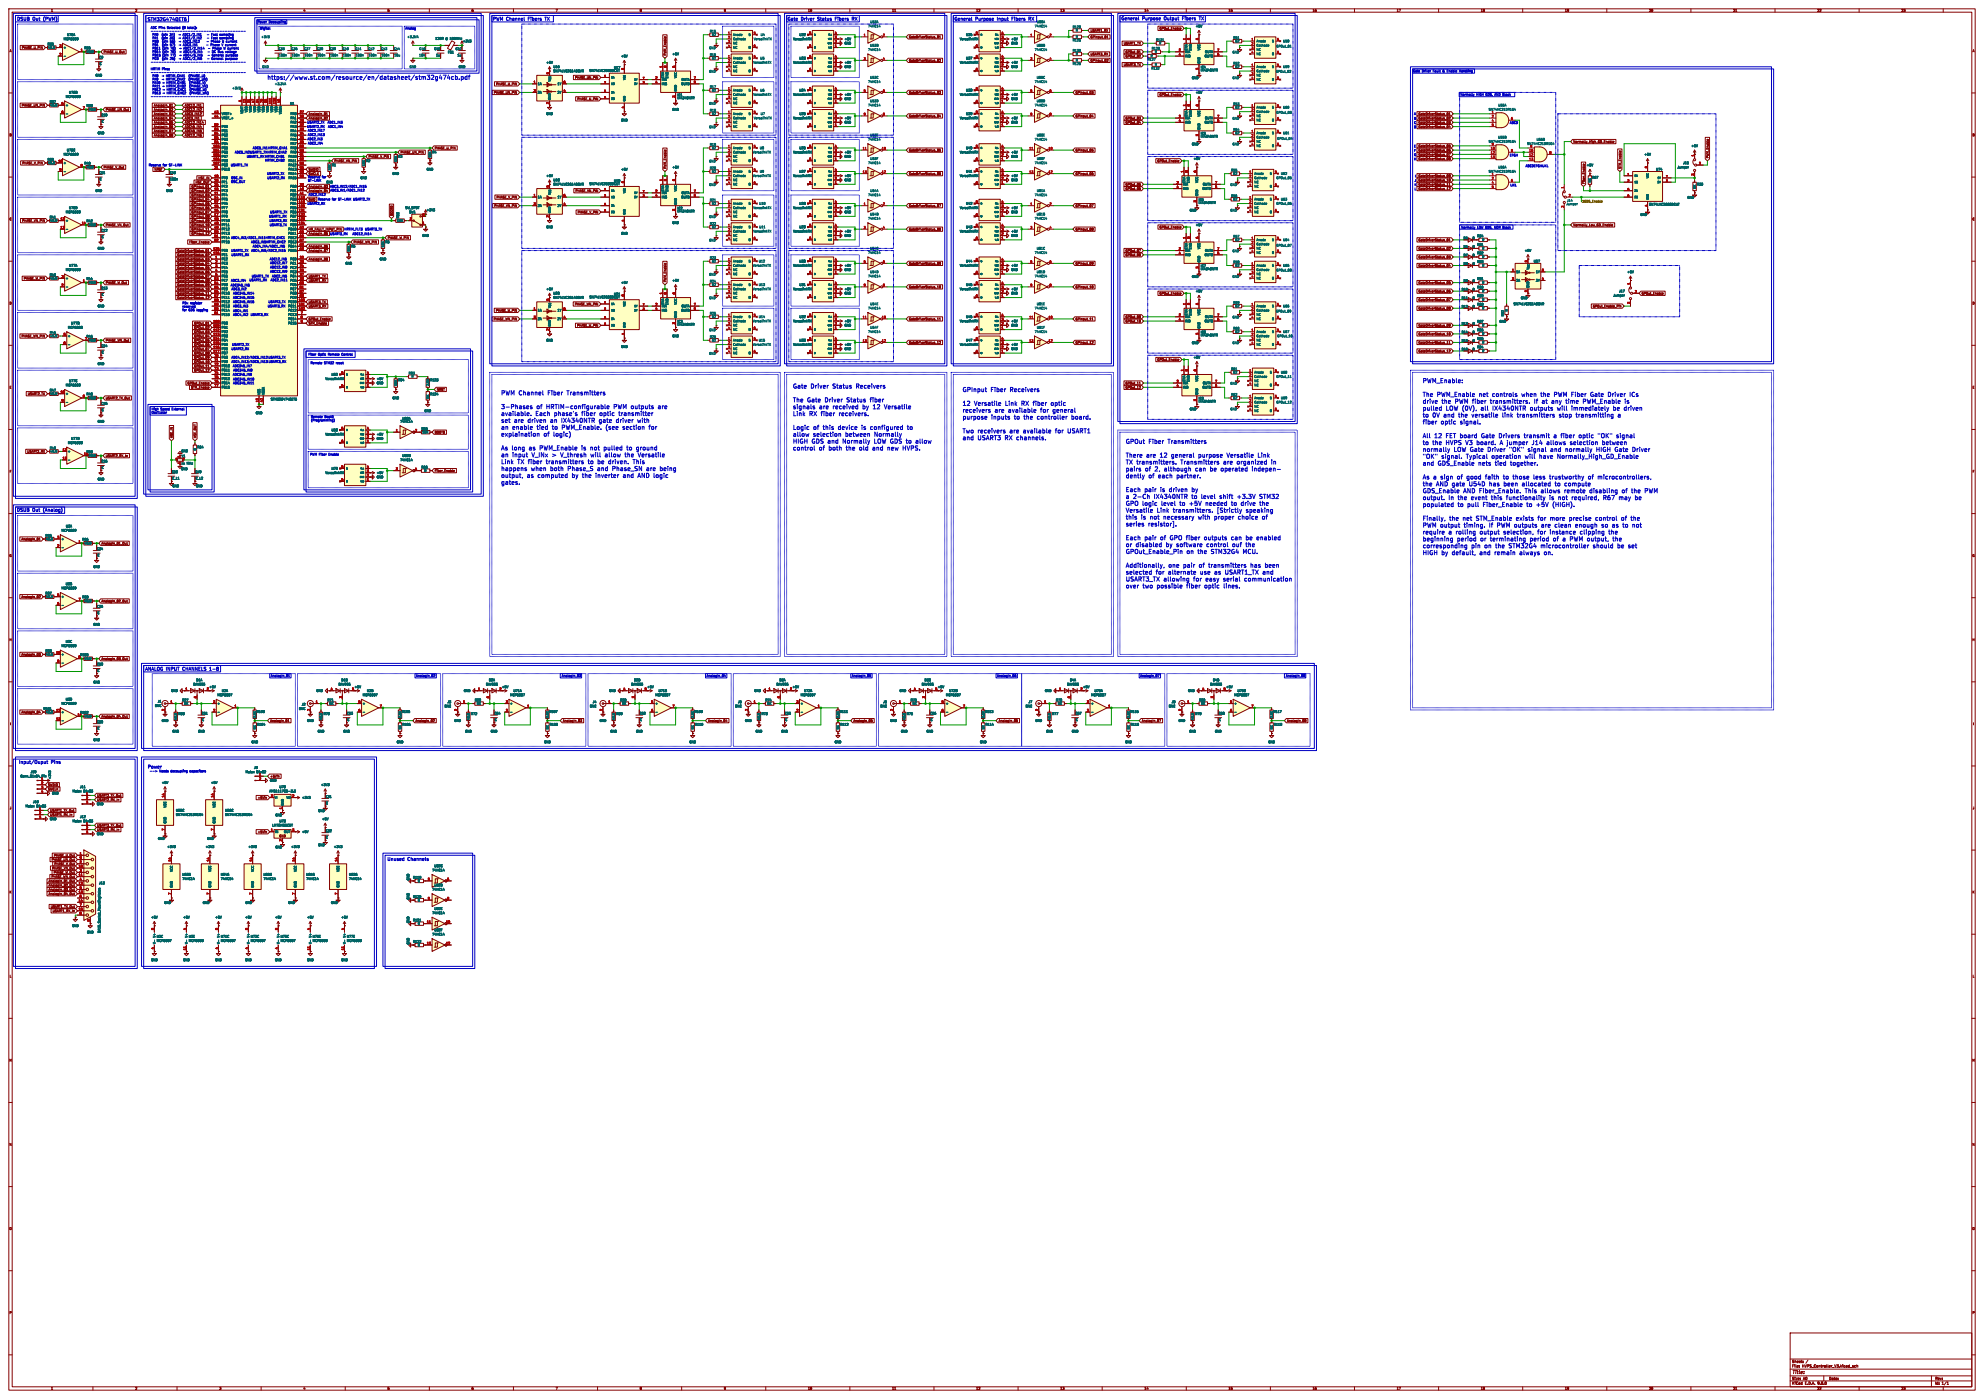
[picture p31: page 1]

PWM Channel Fibers TX

General Purpose Input Fibers RX

General Purpose Output Fibers TX

GND
https://www.st.com/resource/en/datasheet/stm32g474cb.pdf

Gate Driver Fault & Enable Handling

6 VDD 13 VDD 31 VDD 47 VDD 64 VSS 12 VDD 79 VSSA 42 VDD 95 VDD 111 VDD 128 VDDA 45 PA0 27 PA1 28 PA2 29 PA3 32 PA4 33 PA5 34 PA6 35 PA7 36 PA8 89 PA9 90 PA10 91 PA11 92 PA12 93 PA13 96 PA14 98 PA15 99 PB0 39 PB1 40 PB2 41 PB3 118 PB4 119 PB5 120 PB6 121 PB7 122 PB8 123 PB9 124 PB10 62 PB11 65 PB12 66 PB13 67 PB14 68 PB15 69 PC0 22 PC1 23 PC2 24 PC3 25 PC4 37 PC5 38 PC6 80 PC7 81 PC8 87 PC9 88 PC10 100 PC11 101 PC12 102 PC13 7 PC14 8 PC15 9 C48

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

Fiber Optic Remote Control

The Gate Driver Status fiber
signals are received by 12 Versatile
Link RX fiber receivers.

12 Versatile Link RX fiber optic

set are driven an IX4340NTR gate driver with
an enable tied to PWM_Enable. (see section for

HIGH GDS and Normally LOW GDS to allow
control of both the old and new HVPS.

and GDS_Enable nets tied together.

As long as PWM_Enable is not pulled to ground
an input V_INx > V_thresh will allow the Versatile
happens when both Phase_S and Phase_SN are being

There are 12 general purpose Versatile Link
pairs of 2, although can be operated indepen-
dently of each partner.

output, as computed by the inverter and AND logic
gates.

Each pair is driven by
a 2-Ch IX4340NTR to level shift +3.3V STM32
GPO logic level to +5V needed to drive the
this is not necessary with proper choice of
series resistor].

Finally, the net STM_Enable exists for more precise control of the
PWM output timing. If PWM outputs are clean enough so as to not
HIGH by default, and remain always on.

Each pair of GPO fiber outputs can be enabled
or disabled by software control ouf the

USART3_TX allowing for easy serial communication
over two possible fiber optic lines.
