everettpenne/WHAM-CONTROLLERS/hardware/HVPS_Controller_V3/HVPS_Controller_V3.kicad_pcb

## KiCad design hardware/HVPS_Controller_V3/HVPS_Controller_V3.kicad_pcb (2026-10-08)

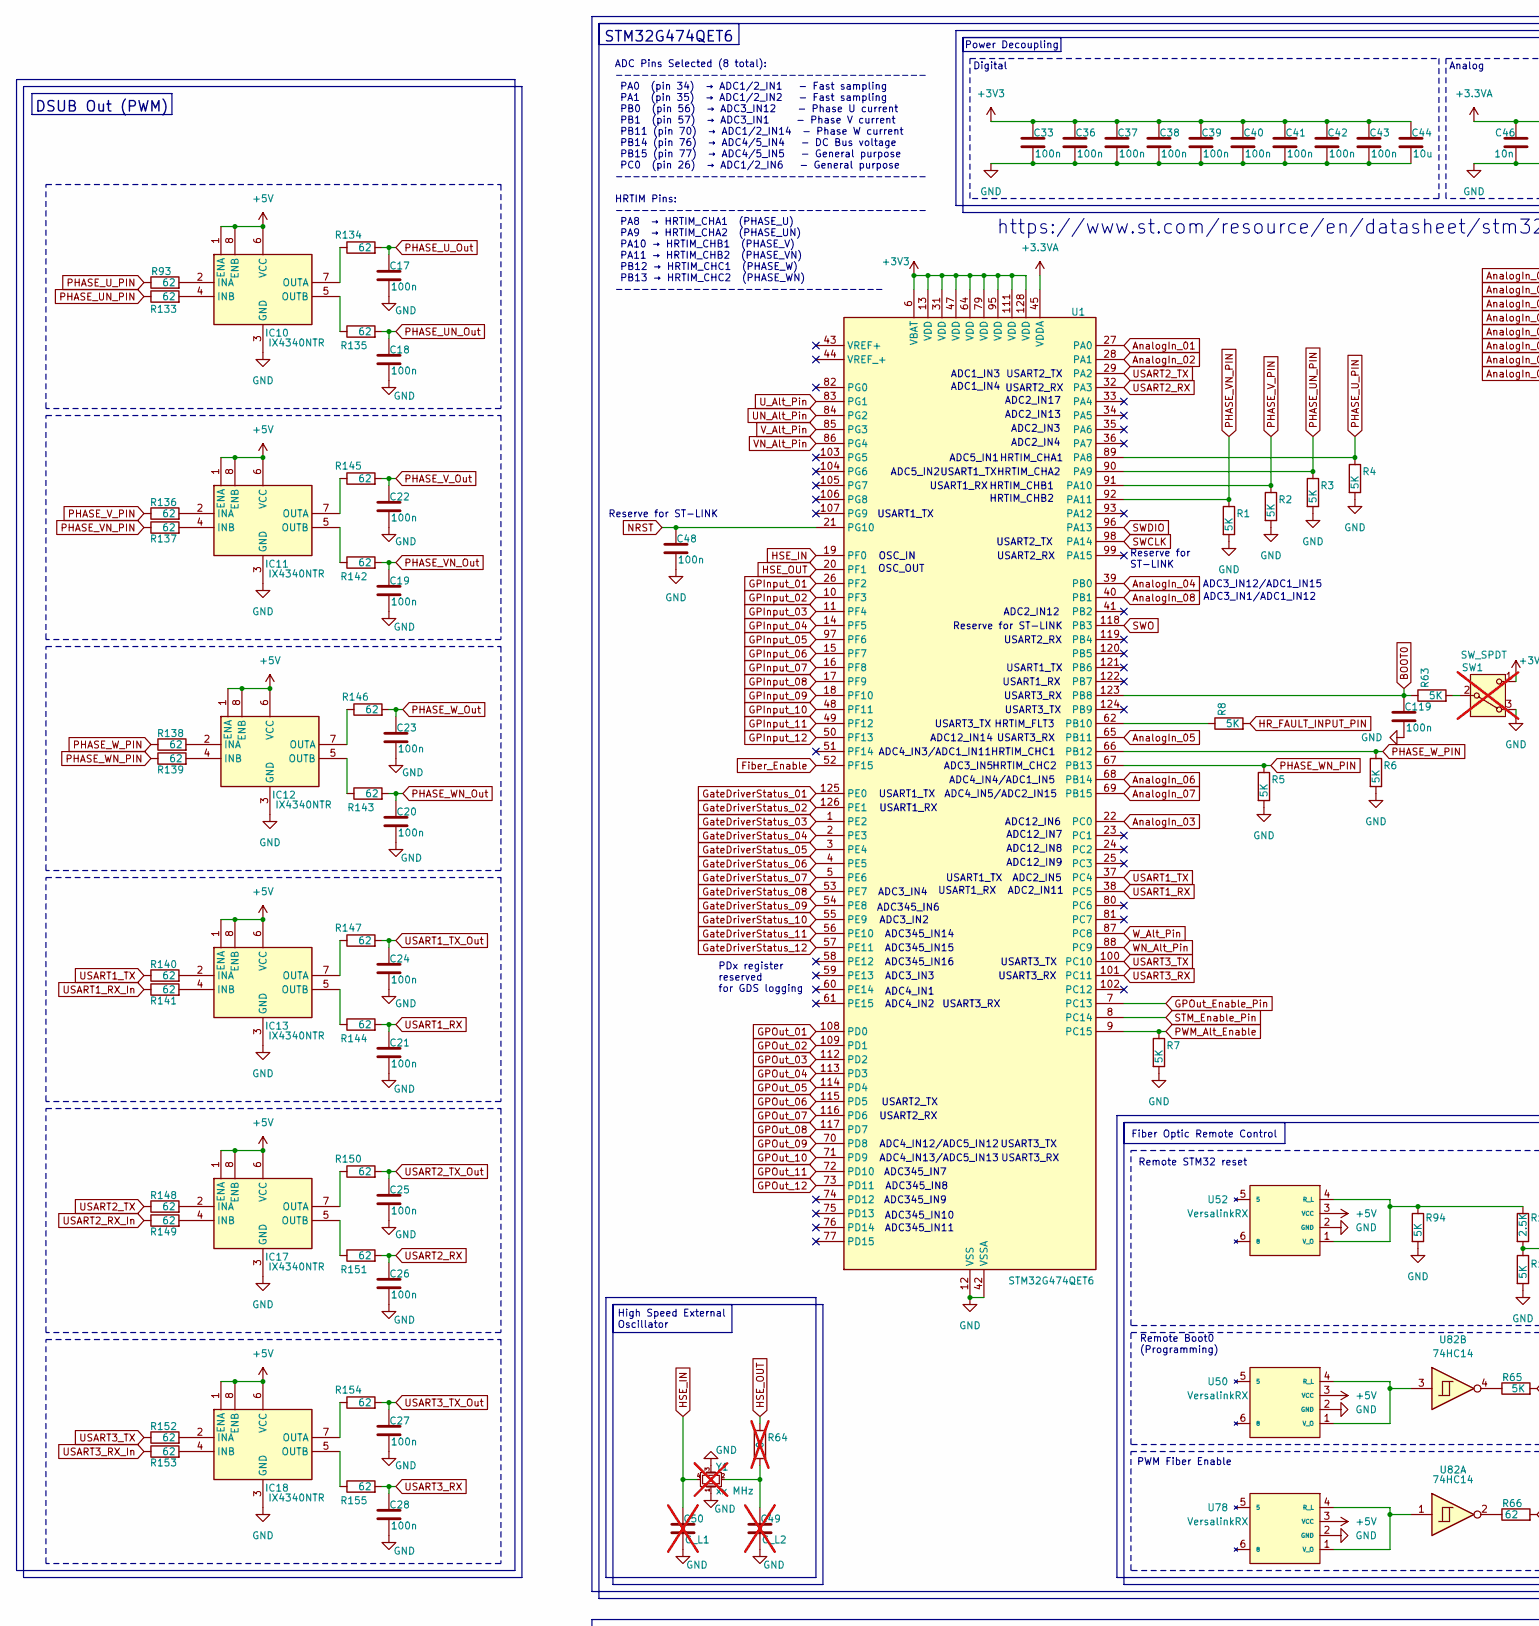
[picture p34: schematic HVPS_Controller_V3.kicad_sch, part in row 1, column 1]

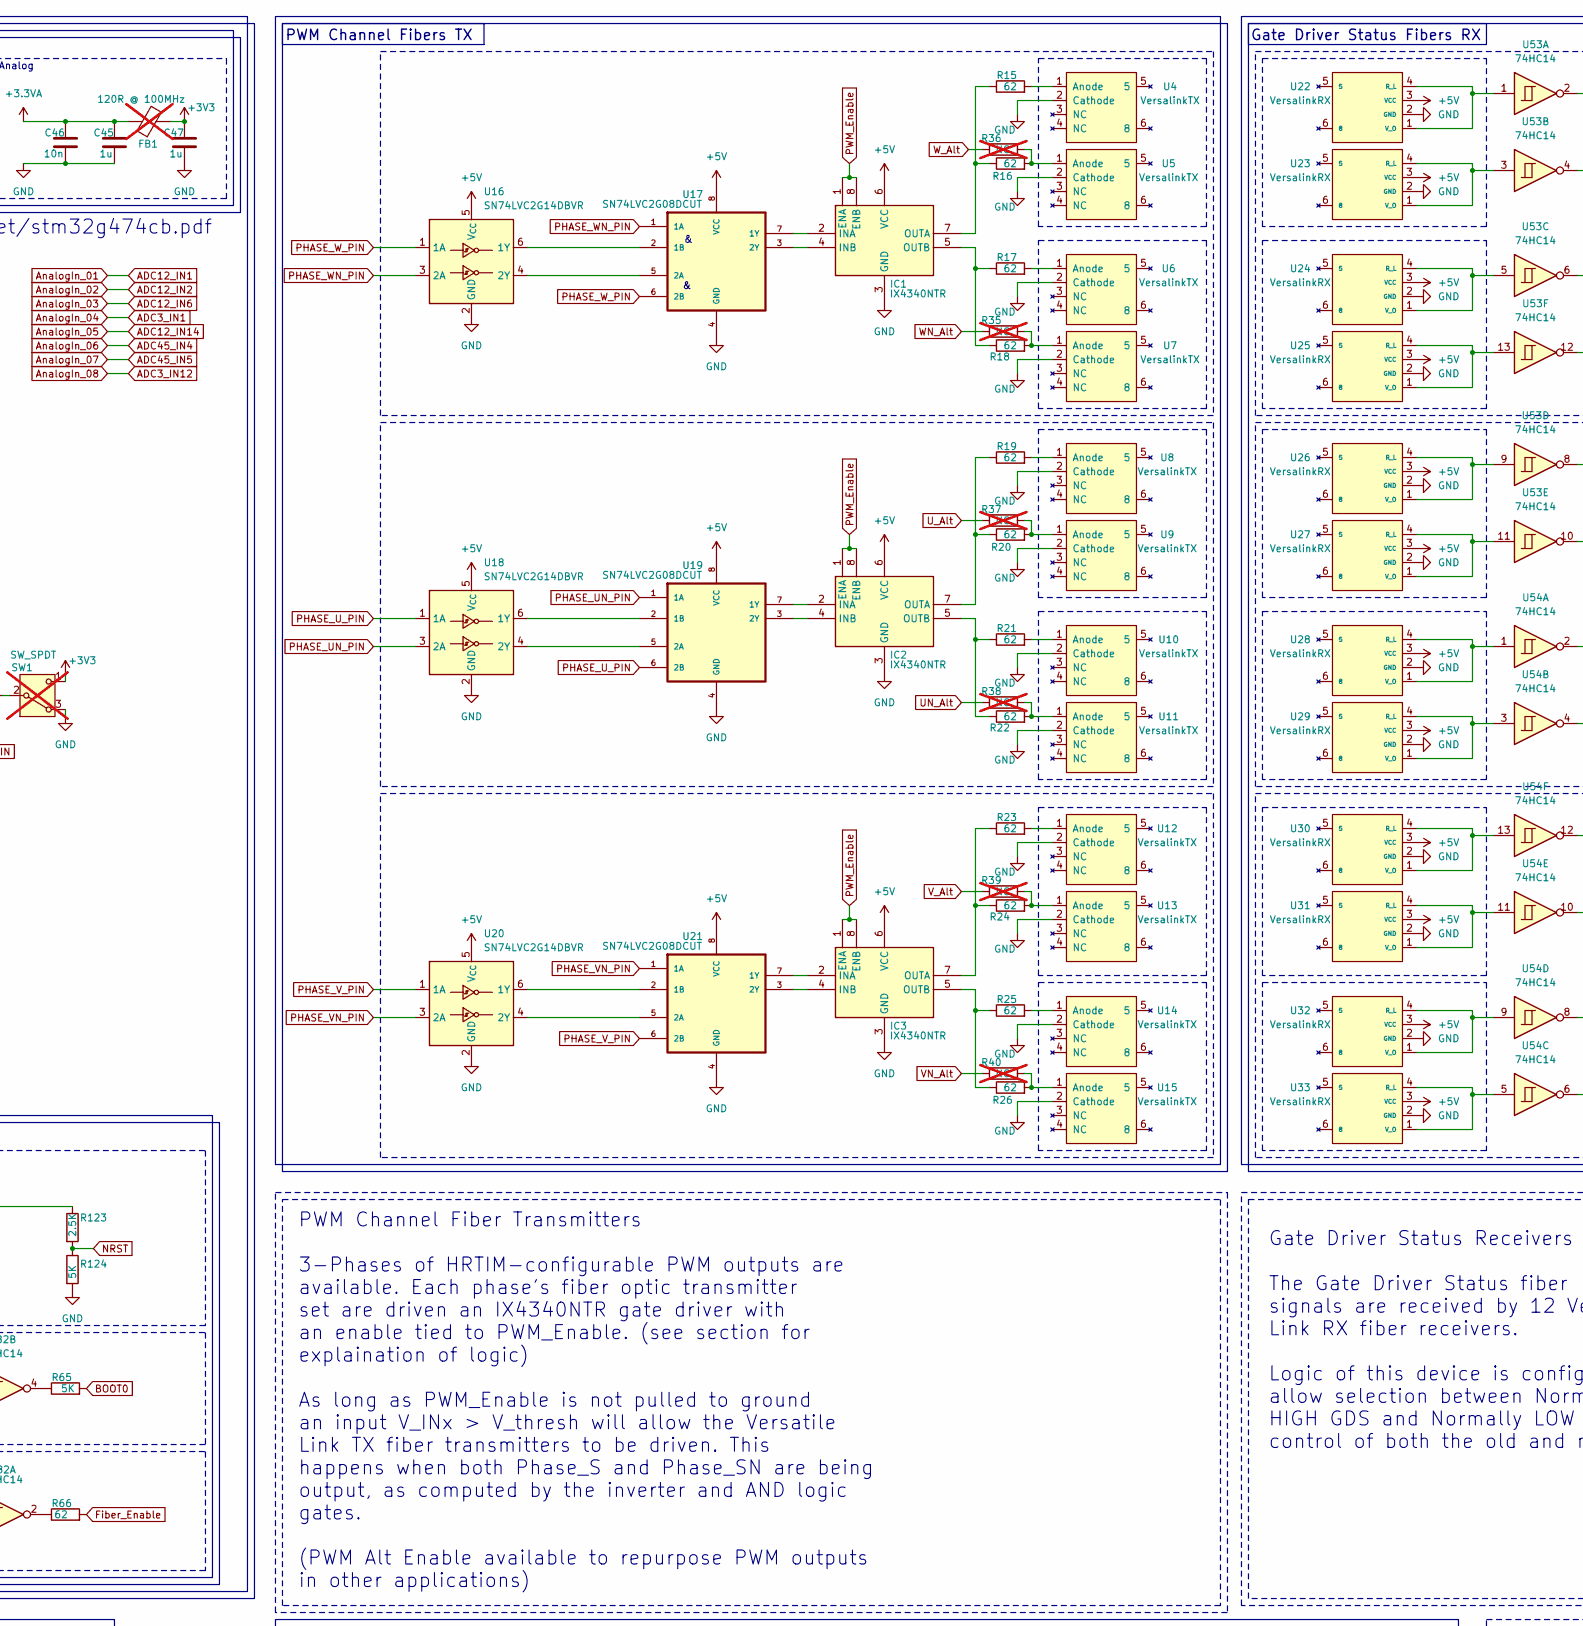
[picture p35: schematic HVPS_Controller_V3.kicad_sch, part in row 1, column 2]

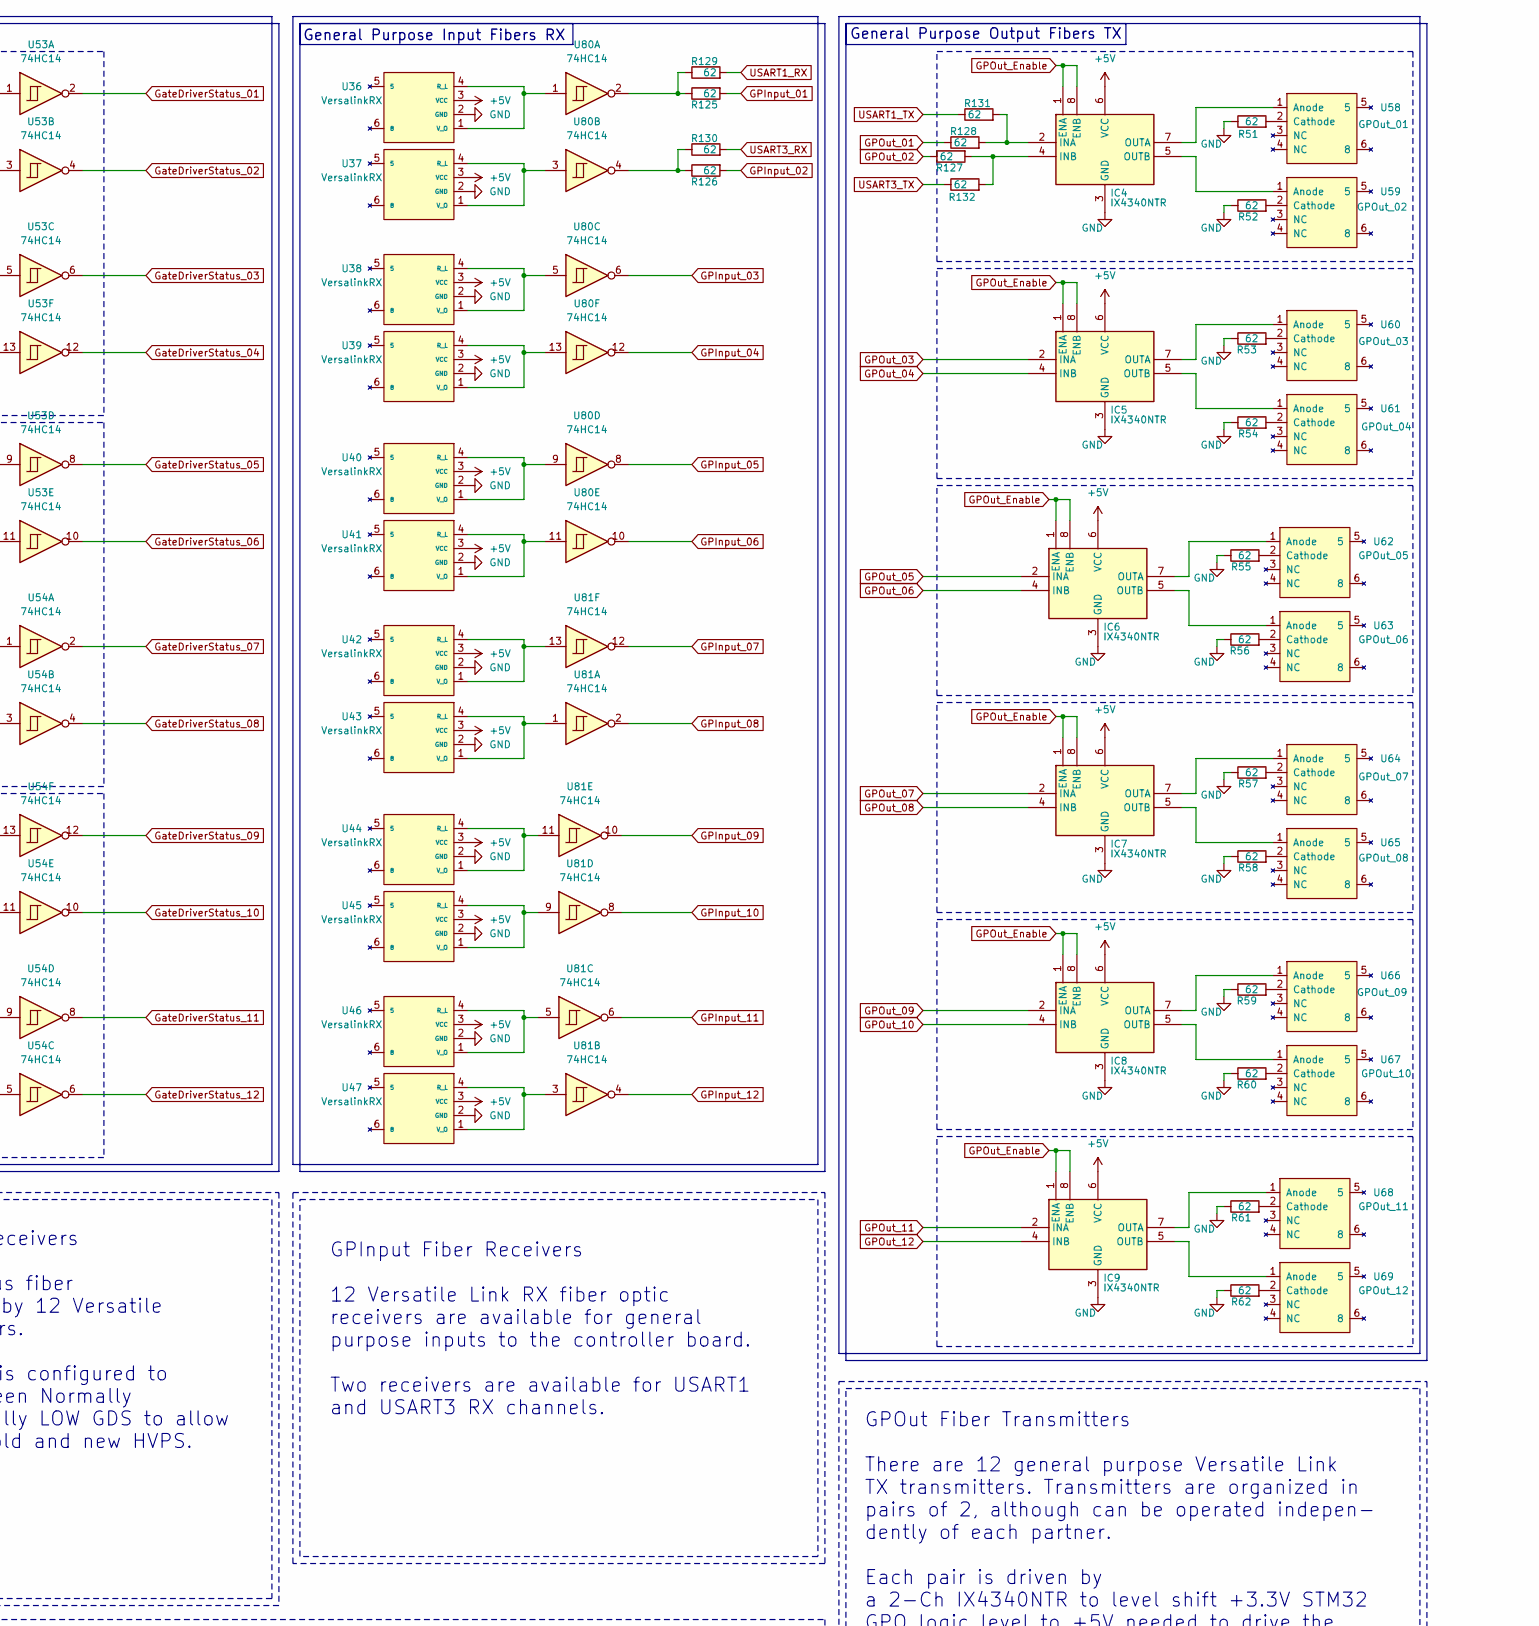
[picture p36: schematic HVPS_Controller_V3.kicad_sch, part in row 1, column 3]

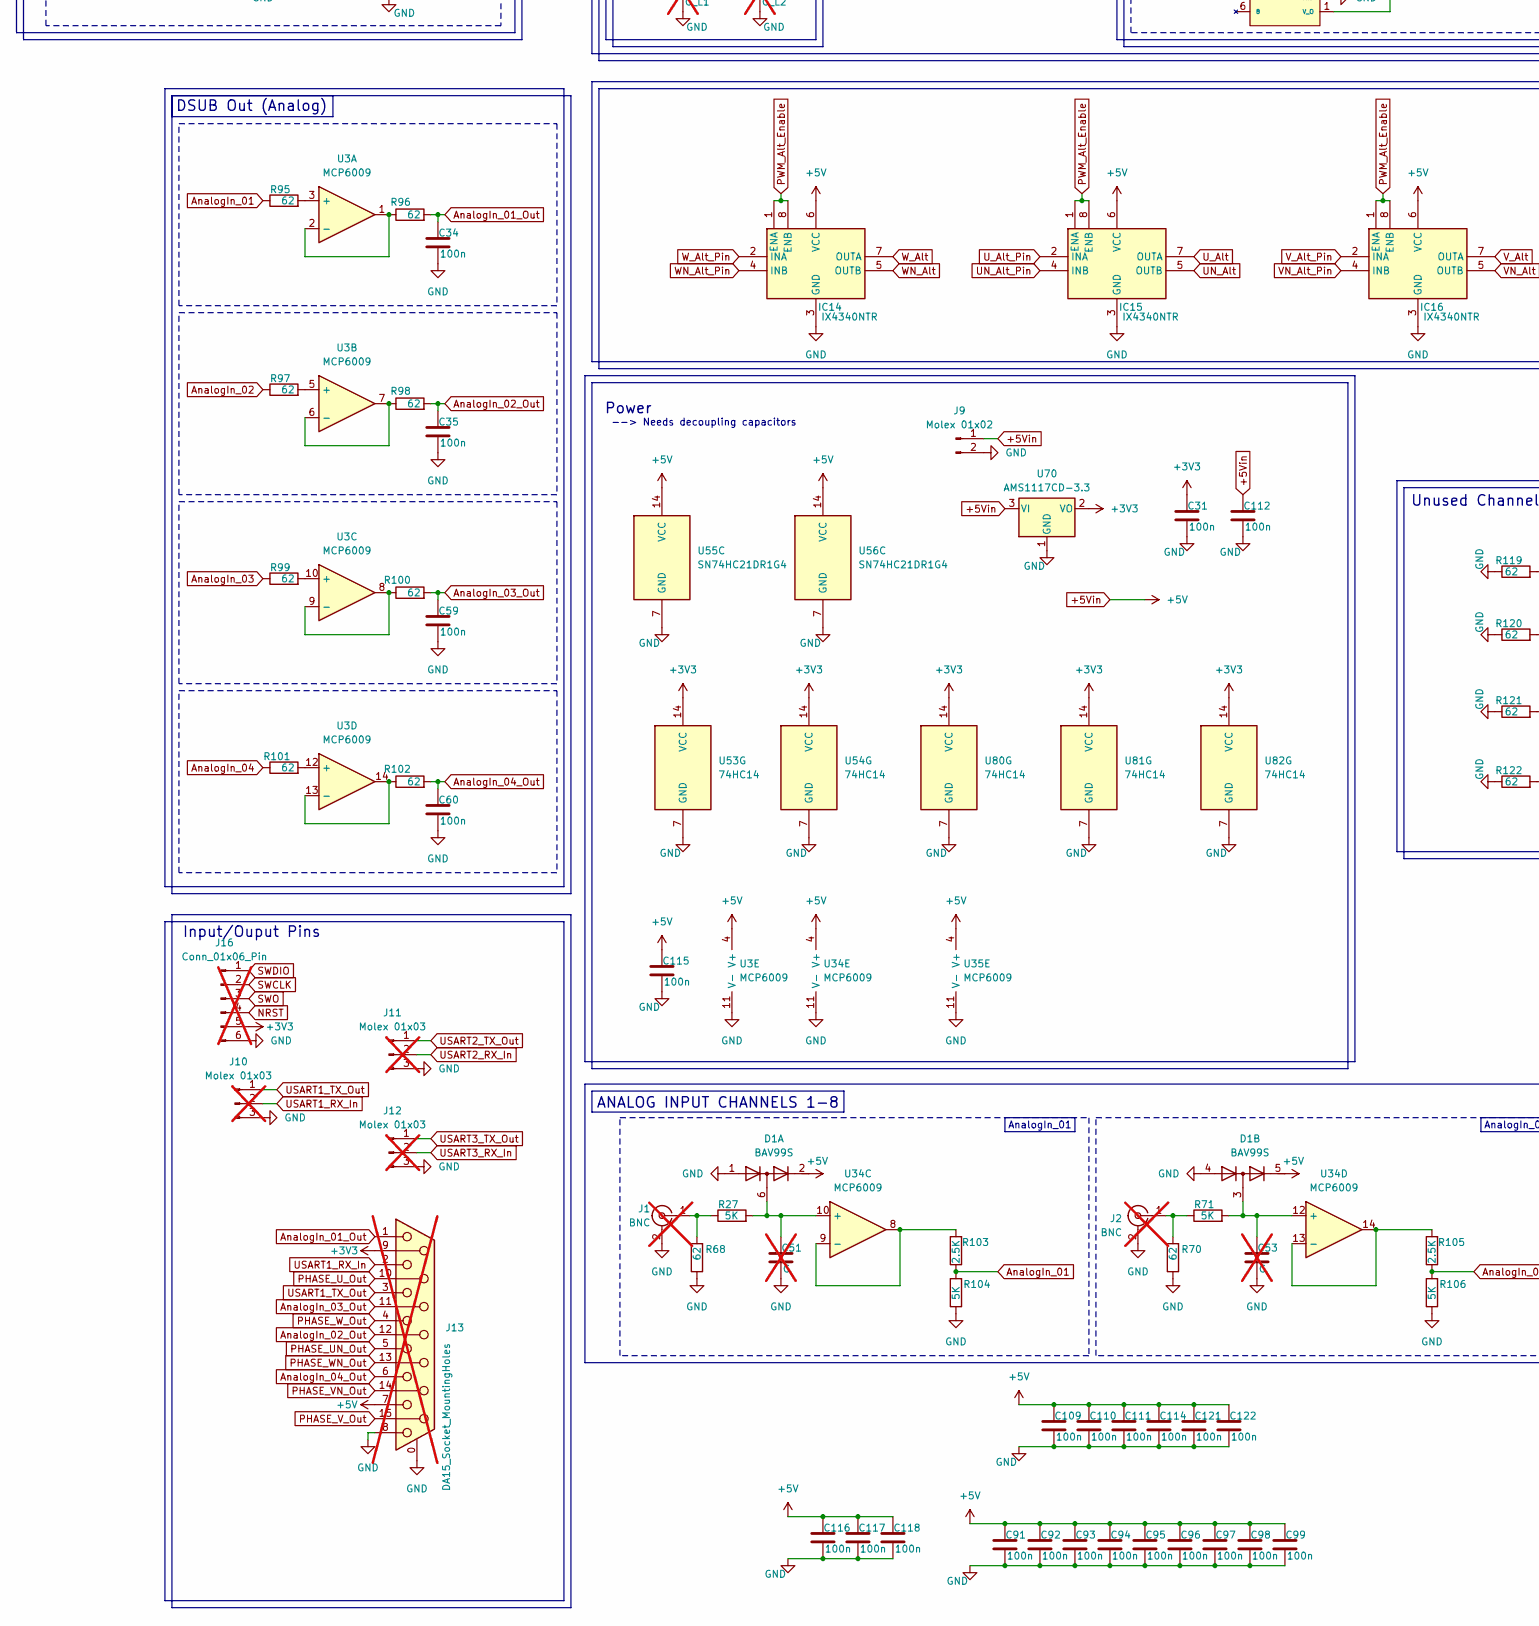
[picture p37: schematic HVPS_Controller_V3.kicad_sch, part in row 2, column 1]

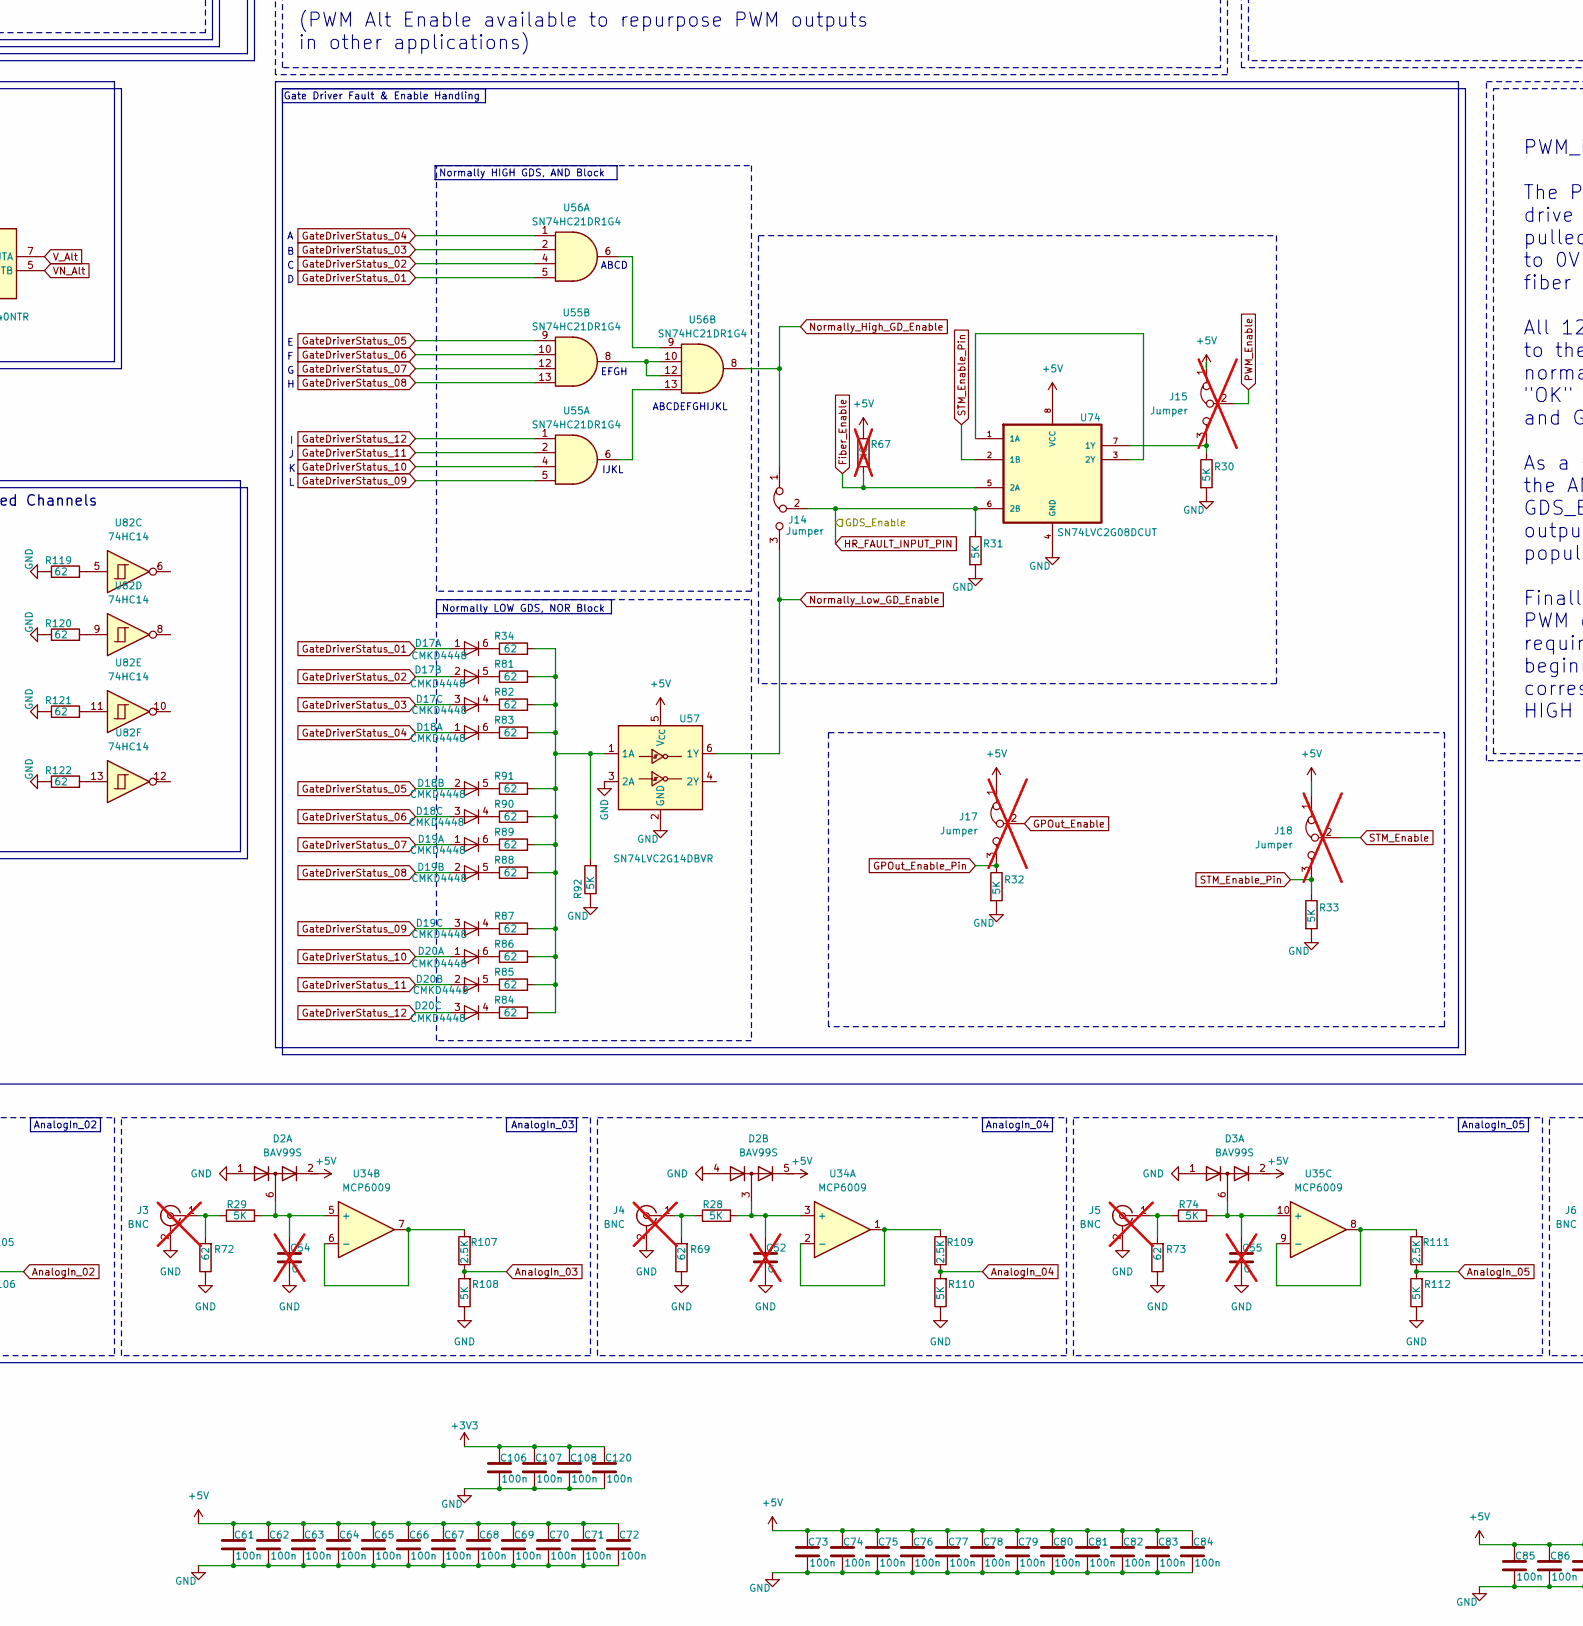
[picture p38: schematic HVPS_Controller_V3.kicad_sch, part in row 2, column 2]

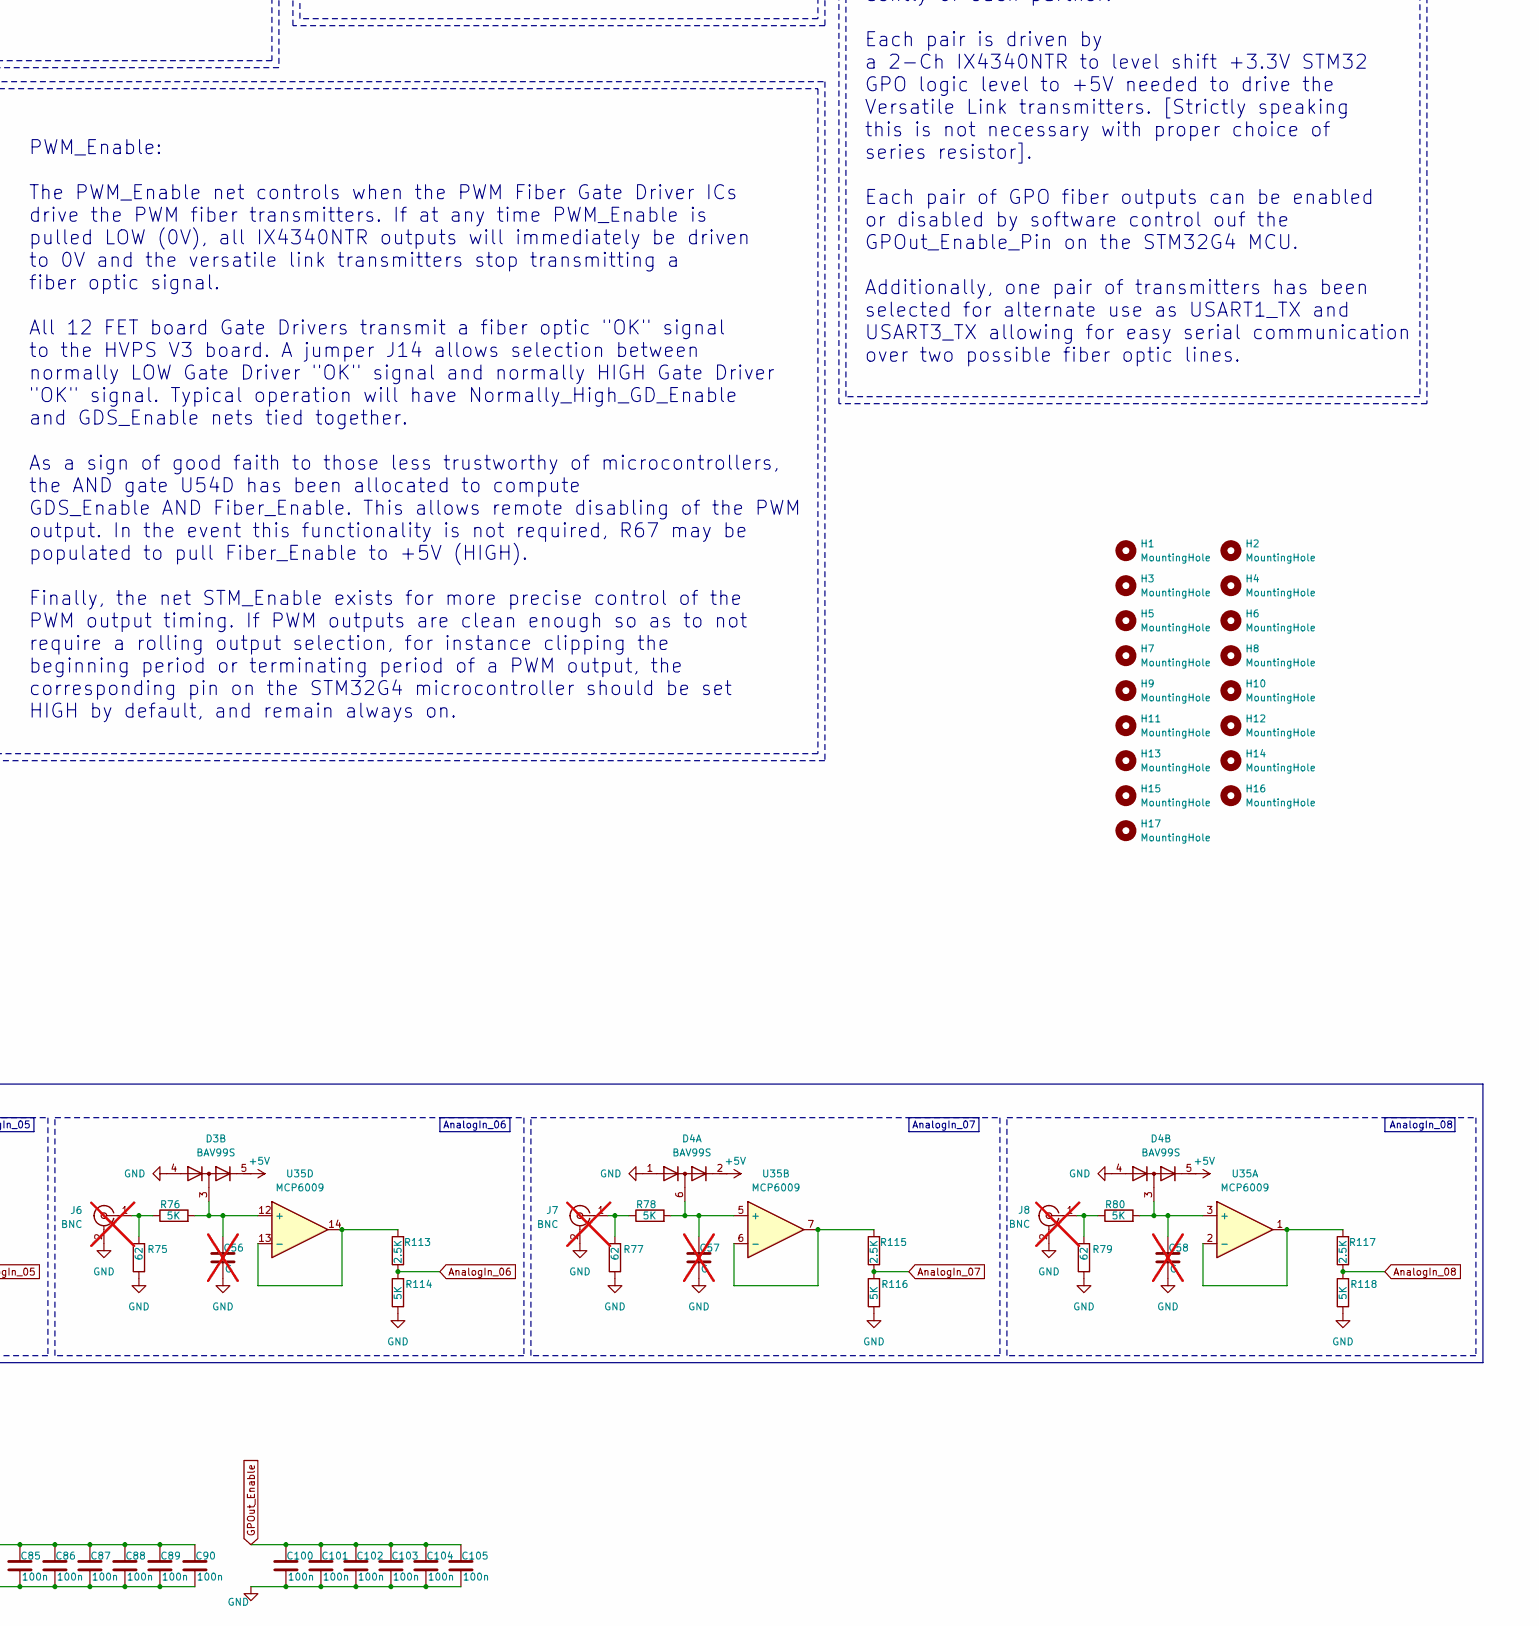
[picture p39: schematic HVPS_Controller_V3.kicad_sch, part in row 2, column 3]

Parts:
C17, C18, C19, C20, C21, C22, C23, C24, C25, C26, C27, C28, C34, C35, C59, C60, C109, C110, C111, C114, C121, C122: 100n; C_1206_3216Metric_Pad1.33x1.80mm_HandSolder
C31, C33, C36, C37, C38, C39, C40, C41, C42, C43, C48, C61, C62, C63, C64, C65, C66, C67, C68, C69, C70, C71, C72, C73, C74, C75, C76, C77, C78, C79, C80, C81, C82, C83, C84, C85, C86, C87, C88, C89, C90, C91, C92, C93, C94, C95, C96, C97, C98, C99, C100, C101, C102, C103, C104, C105, C106, C107, C108, C112, C115, C116, C117, C118, C119, C120: 100n; C_0805_2012Metric_Pad1.18x1.45mm_HandSolder
C44: 10u; C_0805_2012Metric_Pad1.18x1.45mm_HandSolder
C45, C47: 1u; C_0805_2012Metric_Pad1.18x1.45mm_HandSolder
C46: 10n; C_0805_2012Metric_Pad1.18x1.45mm_HandSolder
C49: C_L2; C_0805_2012Metric_Pad1.18x1.45mm_HandSolder; not fitted
C50: C_L1; C_0805_2012Metric_Pad1.18x1.45mm_HandSolder; not fitted
C51, C52, C53, C54, C55, C56, C57, C58: C; C_1206_3216Metric_Pad1.33x1.80mm_HandSolder; not fitted
D1, D2, D3, D4: BAV99S; SOT-363_SC-70-6
D17, D18, D19, D20: CMKD4448; SOT-363_SC-70-6
FB1: 120R @ 100MHz; Ferrite_1206_3216Metric_Pad1.42x1.75mm_BigPads; not fitted
H1, H2, H3, H4, H5, H6, H7, H8, H9, H10, H11, H12, H13, H14, H15, H16, H17: MountingHole; MountingHole_2mm
IC1, IC2, IC3, IC4, IC5, IC6, IC7, IC8, IC9, IC10, IC11, IC12, IC13, IC14, IC15, IC16, IC17, IC18: IX4340NTR; SOIC-8_5.3x5.3mm_P1.27mm; Mouser Part Number 747-IX4340NTR
J1, J2, J3, J4, J5, J6, J7, J8: BNC; BNC_TEConnectivity_1478204_Vertical; not fitted
J9: Molex 01x02; Molex_KK-396_5273-02A_1x02_P3.96mm_Vertical
J10, J11, J12: Molex 01x03; Molex_KK-254_AE-6410-03A_1x03_P2.54mm_Vertical; not fitted
J13: DA15_Socket_MountingHoles; DSUB-15-HD_Pins_Vertical_P2.29x1.98mm_MountingHoles; not fitted
J14: Jumper; PinHeader_1x03_P2.54mm_Vertical
J15, J17, J18: Jumper; PinHeader_1x03_P2.54mm_Vertical; not fitted
J16: Conn_01x06_Pin; Molex_KK-254_AE-6410-06A_1x06_P2.54mm_Vertical; not fitted
R1, R2, R3, R4, R5, R6, R7, R8, R30, R31, R32, R33, R63, R65, R92, R94, R124: 5K; R_0805_2012Metric_Pad1.20x1.40mm_HandSolder
R15, R16, R17, R18, R19, R20, R21, R22, R23, R24, R25, R26, R51, R52, R53, R54, R55, R56, R57, R58, R59, R60, R61, R62, R68, R69, R70, R72, R73, R75, R77, R79, R93, R95, R96, R97, R98, R99, R100, R101, R102, R133, R134, R135, R136, R137, R138, R139, R140, R141, R142, R143, R144, R145, R146, R147, R148, R149, R150, R151, R152, R153, R154, R155: 62; R_1206_3216Metric_Pad1.30x1.75mm_HandSolder
R27, R28, R29, R71, R74, R76, R78, R80, R104, R106, R108, R110, R112, R114, R116, R118: 5K; R_1206_3216Metric_Pad1.30x1.75mm_HandSolder
R34, R66, R81, R82, R83, R84, R85, R86, R87, R88, R89, R90, R91, R119, R120, R121, R122, R125, R126, R127, R128, R129, R130, R131, R132: 62; R_0805_2012Metric_Pad1.20x1.40mm_HandSolder
R35, R36, R37, R38, R39, R40: NC; R_1206_3216Metric_Pad1.30x1.75mm_HandSolder; not fitted
R64: 0; R_0805_2012Metric_Pad1.20x1.40mm_HandSolder; not fitted
R67: NC; R_0805_2012Metric_Pad1.20x1.40mm_HandSolder; not fitted
R103, R105, R107, R109, R111, R113, R115, R117: 2.5K; R_1206_3216Metric_Pad1.30x1.75mm_HandSolder
R123: 2.5K; R_0805_2012Metric_Pad1.20x1.40mm_HandSolder
SW1: SW_SPDT; Molex_KK-254_AE-6410-03A_1x03_P2.54mm_Vertical; not fitted
U1: STM32G474QET6; LQFP-128_14x14mm_P0.4mm
U3, U34, U35: MCP6009; TSSOP-14_4.4x5mm_P0.65mm
U4, U5, U6, U7, U8, U9, U10, U11, U12, U13, U14, U15: VersalinkTX; Versalink-Vertical
U16, U18, U20, U57: SN74LVC2G14DBVR; SOT-23-6
U17, U19, U21, U74: SN74LVC2G08DCUT; SOP50P310X90-8N
U22, U23, U24, U25, U26, U27, U28, U29, U30, U31, U32, U33, U36, U37, U38, U39, U40, U41, U42, U43, U44, U45, U46, U47, U50, U52, U78: VersalinkRX; Versalink-Vertical
U53, U54, U80, U81, U82: 74HC14; SOIC-14_3.9x8.7mm_P1.27mm
U55, U56: SN74HC21DR1G4; SOIC-14_3.9x8.7mm_P1.27mm
U58: GPOut_01; Versalink-Vertical
U59: GPOut_02; Versalink-Vertical
U60: GPOut_03; Versalink-Vertical
U61: GPOut_04; Versalink-Vertical
U62: GPOut_05; Versalink-Vertical
U63: GPOut_06; Versalink-Vertical
U64: GPOut_07; Versalink-Vertical
U65: GPOut_08; Versalink-Vertical
U66: GPOut_09; Versalink-Vertical
U67: GPOut_10; Versalink-Vertical
U68: GPOut_11; Versalink-Vertical
U69: GPOut_12; Versalink-Vertical
U70: AMS1117CD-3.3; TO-252-3_TabPin2
Y1: xx MHz; Crystal_SMD_3225-4Pin_3.2x2.5mm_HandSoldering; not fitted

Connections:
+3.3VA: C45.1, C46.1, FB1.1, U1.45 (VDDA)
+3V3: C31.1, C33.1, C36.1, C37.1, C38.1, C39.1, C40.1, C41.1, C42.1, C43.1, C44.1, C47.1, C106.1, C107.1, C108.1, C120.1, FB1.2, J13.9, J16.5, SW1.1 (C), U1.6 (VBAT), U1.13 (VDD), U1.31 (VDD), U1.47 (VDD), U1.64 (VDD), U1.79 (VDD), U1.95 (VDD), U1.111 (VDD), U1.128 (VDD), U53.14 (VCC), U54.14 (VCC), U70.2 (VO), U80.14 (VCC), U81.14 (VCC), U82.14 (VCC)
+5Vin: C61.1, C62.1, C63.1, C64.1, C65.1, C66.1, C67.1, C68.1, C69.1, C70.1, C71.1, C72.1, C73.1, C74.1, C75.1, C76.1, C77.1, C78.1, C79.1, C80.1, C81.1, C82.1, C83.1, C84.1, C85.1, C86.1, C87.1, C88.1, C89.1, C90.1, C91.1, C92.1, C93.1, C94.1, C95.1, C96.1, C97.1, C98.1, C99.1, C109.1, C110.1, C111.1, C112.1, C114.1, C115.1, C116.1, C117.1, C118.1, C121.1, C122.1, D1.2 (K2), D1.5 (K4), D2.2 (K2), D2.5 (K4), D3.2 (K2), D3.5 (K4), D4.2 (K2), D4.5 (K4), IC1.6 (VCC), IC2.6 (VCC), IC3.6 (VCC), IC4.6 (VCC), IC5.6 (VCC), IC6.6 (VCC), IC7.6 (VCC), IC8.6 (VCC), IC9.6 (VCC), IC10.1 (ENA), IC10.6 (VCC), IC10.8 (ENB), IC11.1 (ENA), IC11.6 (VCC), IC11.8 (ENB), IC12.1 (ENA), IC12.6 (VCC), IC12.8 (ENB), IC13.1 (ENA), IC13.6 (VCC), IC13.8 (ENB), IC14.6 (VCC), IC15.6 (VCC), IC16.6 (VCC), IC17.1 (ENA), IC17.6 (VCC), IC17.8 (ENB), IC18.1 (ENA), IC18.6 (VCC), IC18.8 (ENB), J9.1, J13.7, J15.1, J17.1, J18.1, R67.2, U3.4 (V+), U16.5 (V_{CC}), U17.8 (VCC), U18.5 (V_{CC}), U19.8 (VCC), U20.5 (V_{CC}), U21.8 (VCC), U22.3 (VCC), U23.3 (VCC), U24.3 (VCC), U25.3 (VCC), U26.3 (VCC), U27.3 (VCC), U28.3 (VCC), U29.3 (VCC), U30.3 (VCC), U31.3 (VCC), U32.3 (VCC), U33.3 (VCC), U34.4 (V+), U35.4 (V+), U36.3 (VCC), U37.3 (VCC), U38.3 (VCC), U39.3 (VCC), U40.3 (VCC), U41.3 (VCC), U42.3 (VCC), U43.3 (VCC), U44.3 (VCC), U45.3 (VCC), U46.3 (VCC), U47.3 (VCC), U50.3 (VCC), U52.3 (VCC), U55.14 (VCC), U56.14 (VCC), U57.5 (V_{CC}), U70.3 (VI), U74.8 (VCC), U78.3 (VCC)
ADC3_IN1: R101.1, R109.1, R110.2, U1.39 (PB0)
ADC3_IN12: R117.1, R118.2, U1.40 (PB1)
ADC12_IN1: R95.1, R103.1, R104.2, U1.27 (PA0)
ADC12_IN2: R97.1, R105.1, R106.2, U1.28 (PA1)
ADC12_IN6: R99.1, R107.1, R108.2, U1.22 (PC0)
ADC12_IN14: R111.1, R112.2, U1.65 (PB11)
ADC45_IN4: R113.1, R114.2, U1.68 (PB14)
ADC45_IN5: R115.1, R116.2, U1.69 (PB15)
AnalogIn_01_Out: C34.1, J13.1, R96.2
AnalogIn_02_Out: C35.1, J13.12, R98.2
AnalogIn_03_Out: C59.1, J13.11 (P111), R100.2
AnalogIn_04_Out: C60.1, J13.6, R102.2
BOOT0: C119.1, R63.1, R65.2, U1.123 (PB8)
Fiber_Enable: R66.2, R67.1, U1.52 (PF15), U74.5 (2A)
GND: C17.2, C18.2, C19.2, C20.2, C21.2, C22.2, C23.2, C24.2, C25.2, C26.2, C27.2, C28.2, C31.2, C33.2, C34.2, C35.2, C36.2, C37.2, C38.2, C39.2, C40.2, C41.2, C42.2, C43.2, C44.2, C45.2, C46.2, C47.2, C48.2, C49.2, C50.2, C51.2, C52.2, C53.2, C54.2, C55.2, C56.2, C57.2, C58.2, C59.2, C60.2, C61.2, C62.2, C63.2, C64.2, C65.2, C66.2, C67.2, C68.2, C69.2, C70.2, C71.2, C72.2, C73.2, C74.2, C75.2, C76.2, C77.2, C78.2, C79.2, C80.2, C81.2, C82.2, C83.2, C84.2, C85.2, C86.2, C87.2, C88.2, C89.2, C90.2, C91.2, C92.2, C93.2, C94.2, C95.2, C96.2, C97.2, C98.2, C99.2, C100.2, C101.2, C102.2, C103.2, C104.2, C105.2, C106.2, C107.2, C108.2, C109.2, C110.2, C111.2, C112.2, C114.2, C115.2, C116.2, C117.2, C118.2, C119.2, C120.2, C121.2, C122.2, D1.1 (A1), D1.4 (A3), D2.1 (A1), D2.4 (A3), D3.1 (A1), D3.4 (A3), D4.1 (A1), D4.4 (A3), IC1.3 (GND), IC2.3 (GND), IC3.3 (GND), IC4.3 (GND), IC5.3 (GND), IC6.3 (GND), IC7.3 (GND), IC8.3 (GND), IC9.3 (GND), IC10.3 (GND), IC11.3 (GND), IC12.3 (GND), IC13.3 (GND), IC14.3 (GND), IC15.3 (GND), IC16.3 (GND), IC17.3 (GND), IC18.3 (GND), J1.2 (Ext), J2.2 (Ext), J3.2 (Ext), J4.2 (Ext), J5.2 (Ext), J6.2 (Ext), J7.2 (Ext), J8.2 (Ext), J9.2, J10.3, J11.3, J12.3, J13.0 (PAD), J13.8, J16.6, R1.2, R2.2, R3.2, R4.2, R5.2, R6.2, R7.2, R30.2, R31.2, R32.2, R33.2, R51.1, R52.1, R53.1, R54.1, R55.1, R56.1, R57.1, R58.1, R59.1, R60.1, R61.1, R62.1, R68.1, R69.1, R70.1, R72.1, R73.1, R75.1, R77.1, R79.1, R92.1, R94.2, R104.1, R106.1, R108.1, R110.1, R112.1, R114.1, R116.1, R118.1, R119.1, R120.1, R121.1, R122.1, R124.2, SW1.3 (A), U1.12 (VSS), U1.30 (VSS), U1.42 (VSSA), U1.46 (VSS), U1.63 (VSS), U1.78 (VSS), U1.94 (VSS), U1.110 (VSS), U1.127 (VSS), U3.11 (V-), U4.2 (Cathode), U5.2 (Cathode), U6.2 (Cathode), U7.2 (Cathode), U8.2 (Cathode), U9.2 (Cathode), U10.2 (Cathode), U11.2 (Cathode), U12.2 (Cathode), U13.2 (Cathode), U14.2 (Cathode), U15.2 (Cathode), U16.2 (GND), U17.4 (GND), U18.2 (GND), U19.4 (GND), U20.2 (GND), U21.4 (GND), U22.2 (GND), U23.2 (GND), U24.2 (GND), U25.2 (GND), U26.2 (GND), U27.2 (GND), U28.2 (GND), U29.2 (GND), U30.2 (GND), U31.2 (GND), U32.2 (GND), U33.2 (GND), U34.11 (V-), U35.11 (V-), U36.2 (GND), U37.2 (GND), U38.2 (GND), U39.2 (GND), U40.2 (GND), U41.2 (GND), U42.2 (GND), U43.2 (GND), U44.2 (GND), U45.2 (GND), U46.2 (GND), U47.2 (GND), U50.2 (GND), U52.2 (GND), U53.7 (GND), U54.7 (GND), U55.7 (GND), U56.7 (GND), U57.2 (GND), U57.3 (2A), U70.1 (GND), U74.4 (GND), U78.2 (GND), U80.7 (GND), U81.7 (GND), U82.7 (GND), Y1.1, Y1.3
GPInput_01: R125.2, U1.26 (PF2)
GPInput_02: R126.2, U1.10 (PF3)
GPInput_03: U1.11 (PF4), U80.6
GPInput_04: U1.14 (PF5), U80.12
GPInput_05: U1.97 (PF6), U80.8
GPInput_06: U1.15 (PF7), U80.10
GPInput_07: U1.16 (PF8), U81.12
GPInput_08: U1.17 (PF9), U81.2
GPInput_09: U1.18 (PF10), U81.10
GPInput_10: U1.48 (PF11), U81.8
GPInput_11: U1.49 (PF12), U81.6
GPInput_12: U1.50 (PF13), U81.4
GPOut_01: R128.1, U1.108 (PD0)
GPOut_02: R127.1, U1.109 (PD1)
GPOut_03: IC5.2 (INA), U1.112 (PD2)
GPOut_04: IC5.4 (INB), U1.113 (PD3)
GPOut_05: IC6.2 (INA), U1.114 (PD4)
GPOut_06: IC6.4 (INB), U1.115 (PD5)
GPOut_07: IC7.2 (INA), U1.116 (PD6)
GPOut_08: IC7.4 (INB), U1.117 (PD7)
GPOut_09: IC8.2 (INA), U1.70 (PD8)
GPOut_10: IC8.4 (INB), U1.71 (PD9)
GPOut_11: IC9.2 (INA), U1.72 (PD10)
GPOut_12: IC9.4 (INB), U1.73 (PD11)
GPOut_Enable: C100.1, C101.1, C102.1, C103.1, C104.1, C105.1, IC4.1 (ENA), IC4.8 (ENB), IC5.1 (ENA), IC5.8 (ENB), IC6.1 (ENA), IC6.8 (ENB), IC7.1 (ENA), IC7.8 (ENB), IC8.1 (ENA), IC8.8 (ENB), IC9.1 (ENA), IC9.8 (ENB), J17.2
GPOut_Enable_Pin: J17.3, R32.1, U1.7 (PC13)
GateDriverStatus_01: D17.1 (A), U1.125 (PE0), U53.2, U56.5
GateDriverStatus_02: D17.2 (A), U1.126 (PE1), U53.4, U56.4
GateDriverStatus_03: D17.3 (A), U1.1 (PE2), U53.6, U56.2
GateDriverStatus_04: D18.1 (A), U1.2 (PE3), U53.12, U56.1
GateDriverStatus_05: D18.2 (A), U1.3 (PE4), U53.8, U55.9
GateDriverStatus_06: D18.3 (A), U1.4 (PE5), U53.10, U55.10
GateDriverStatus_07: D19.1 (A), U1.5 (PE6), U54.2, U55.12
GateDriverStatus_08: D19.2 (A), U1.53 (PE7), U54.4, U55.13
GateDriverStatus_09: D19.3 (A), U1.54 (PE8), U54.12, U55.5
GateDriverStatus_10: D20.1 (A), U1.55 (PE9), U54.10, U55.4
GateDriverStatus_11: D20.2 (A), U1.56 (PE10), U54.8, U55.2
GateDriverStatus_12: D20.3 (A), U1.57 (PE11), U54.6, U55.1
HR_FAULT_INPUT_PIN: J14.2, R8.2, R31.1, U74.6 (2B)
HSE_IN: C50.1, U1.19 (PF0), Y1.4
HSE_OUT: R64.1, U1.20 (PF1)
NRST: C48.1, J16.4, R123.2, R124.1, U1.21 (PG10)
unnamed: C49.1, R64.2, Y1.2
unnamed: C51.1, D1.6 (K3A4), R27.2, U34.10 (+)
unnamed: C53.1, D1.3 (K1A2), R71.2, U34.12 (+)
unnamed: C54.1, D2.6 (K3A4), R29.2, U34.5 (+)
unnamed: C52.1, D2.3 (K1A2), R28.2, U34.3 (+)
unnamed: C55.1, D3.6 (K3A4), R74.2, U35.10 (+)
unnamed: C56.1, D3.3 (K1A2), R76.2, U35.12 (+)
unnamed: C57.1, D4.6 (K3A4), R78.2, U35.5 (+)
unnamed: C58.1, D4.3 (K1A2), R80.2, U35.3 (+)
unnamed: D17.6 (K), R34.1
unnamed: D17.5 (K), R81.1
unnamed: D17.4 (K), R82.1
unnamed: D18.6 (K), R83.1
unnamed: D18.5 (K), R91.1
unnamed: D18.4 (K), R90.1
unnamed: D19.6 (K), R89.1
unnamed: D19.5 (K), R88.1
unnamed: D19.4 (K), R87.1
unnamed: D20.6 (K), R86.1
unnamed: D20.5 (K), R85.1
unnamed: D20.4 (K), R84.1
unnamed: IC1.2 (INA), U17.7 (1Y)
unnamed: IC1.4 (INB), U17.3 (2Y)
unnamed: IC1.7 (OUTA), R15.1, R16.1
unnamed: IC1.5 (OUTB), R17.1, R18.1
unnamed: IC2.2 (INA), U19.7 (1Y)
unnamed: IC2.4 (INB), U19.3 (2Y)
unnamed: IC2.7 (OUTA), R19.1, R20.1
unnamed: IC2.5 (OUTB), R21.1, R22.1
unnamed: IC3.2 (INA), U21.7 (1Y)
unnamed: IC3.4 (INB), U21.3 (2Y)
unnamed: IC3.7 (OUTA), R23.1, R24.1
unnamed: IC3.5 (OUTB), R25.1, R26.1
unnamed: IC4.2 (INA), R128.2, R131.2
unnamed: IC4.4 (INB), R127.2, R132.2
unnamed: IC4.7 (OUTA), U58.1 (Anode)
unnamed: IC4.5 (OUTB), U59.1 (Anode)
unnamed: IC5.7 (OUTA), U60.1 (Anode)
unnamed: IC5.5 (OUTB), U61.1 (Anode)
unnamed: IC6.7 (OUTA), U62.1 (Anode)
unnamed: IC6.5 (OUTB), U63.1 (Anode)
unnamed: IC7.7 (OUTA), U64.1 (Anode)
unnamed: IC7.5 (OUTB), U65.1 (Anode)
unnamed: IC8.7 (OUTA), U66.1 (Anode)
unnamed: IC8.5 (OUTB), U67.1 (Anode)
unnamed: IC9.7 (OUTA), U68.1 (Anode)
unnamed: IC9.5 (OUTB), U69.1 (Anode)
unnamed: IC10.2 (INA), R93.2
unnamed: IC10.4 (INB), R133.2
unnamed: IC10.7 (OUTA), R134.1
unnamed: IC10.5 (OUTB), R135.1
unnamed: IC11.2 (INA), R136.2
unnamed: IC11.4 (INB), R137.2
unnamed: IC11.7 (OUTA), R145.1
unnamed: IC11.5 (OUTB), R142.1
unnamed: IC12.2 (INA), R138.2
unnamed: IC12.4 (INB), R139.2
unnamed: IC12.7 (OUTA), R146.1
unnamed: IC12.5 (OUTB), R143.1
unnamed: IC13.2 (INA), R140.2
unnamed: IC13.4 (INB), R141.2
unnamed: IC13.7 (OUTA), R147.1
unnamed: IC13.5 (OUTB), R144.1
unnamed: IC17.2 (INA), R148.2
unnamed: IC17.4 (INB), R149.2
unnamed: IC17.7 (OUTA), R150.1
unnamed: IC17.5 (OUTB), R151.1
unnamed: IC18.2 (INA), R152.2
unnamed: IC18.4 (INB), R153.2
unnamed: IC18.7 (OUTA), R154.1
unnamed: IC18.5 (OUTB), R155.1
unnamed: J1.1 (In), R27.1, R68.2
unnamed: J2.1 (In), R70.2, R71.1
unnamed: J3.1 (In), R29.1, R72.2
unnamed: J4.1 (In), R28.1, R69.2
unnamed: J5.1 (In), R73.2, R74.1
unnamed: J6.1 (In), R75.2, R76.1
unnamed: J7.1 (In), R77.2, R78.1
unnamed: J8.1 (In), R79.2, R80.1
unnamed: J15.3, R30.1, U74.7 (1Y)
unnamed: R65.1, U82.4
unnamed: R66.1, U82.2
unnamed: R119.2, U82.5
unnamed: R120.2, U82.9
unnamed: R121.2, U82.11
unnamed: R122.2, U82.13
unnamed: R125.1, R129.1, U80.2
unnamed: R126.1, R130.1, U80.4
unnamed: R63.2, SW1.2 (B)
unnamed: R8.1, U1.62 (PB10)
unnamed: R95.2, U3.3 (+)
unnamed: R96.1, U3.1, U3.2 (-)
unnamed: R97.2, U3.5 (+)
unnamed: R98.1, U3.6 (-), U3.7
unnamed: R99.2, U3.10 (+)
unnamed: R100.1, U3.8, U3.9 (-)
unnamed: R101.2, U3.12 (+)
unnamed: R102.1, U3.13 (-), U3.14
unnamed: R15.2, U4.1 (Anode)
unnamed: R16.2, R36.2, U5.1 (Anode)
unnamed: R17.2, U6.1 (Anode)
unnamed: R18.2, R35.2, U7.1 (Anode)
unnamed: R19.2, U8.1 (Anode)
unnamed: R20.2, R37.2, U9.1 (Anode)
unnamed: R21.2, U10.1 (Anode)
unnamed: R22.2, R38.2, U11.1 (Anode)
unnamed: R23.2, U12.1 (Anode)
unnamed: R24.2, R39.2, U13.1 (Anode)
unnamed: R25.2, U14.1 (Anode)
unnamed: R26.2, R40.2, U15.1 (Anode)
unnamed: U16.6 (1Y), U17.2 (1B)
unnamed: U16.4 (2Y), U17.5 (2A)
unnamed: U18.6 (1Y), U19.2 (1B)
unnamed: U18.4 (2Y), U19.5 (2A)
unnamed: U20.6 (1Y), U21.2 (1B)
unnamed: U20.4 (2Y), U21.5 (2A)
unnamed: U22.1 (V_O), U22.4 (R_L), U53.1
unnamed: U23.1 (V_O), U23.4 (R_L), U53.3
unnamed: U24.1 (V_O), U24.4 (R_L), U53.5
unnamed: U25.1 (V_O), U25.4 (R_L), U53.13
unnamed: U26.1 (V_O), U26.4 (R_L), U53.9
unnamed: U27.1 (V_O), U27.4 (R_L), U53.11
unnamed: U28.1 (V_O), U28.4 (R_L), U54.1
unnamed: U29.1 (V_O), U29.4 (R_L), U54.3
unnamed: U30.1 (V_O), U30.4 (R_L), U54.13
unnamed: U31.1 (V_O), U31.4 (R_L), U54.11
unnamed: U32.1 (V_O), U32.4 (R_L), U54.9
unnamed: U33.1 (V_O), U33.4 (R_L), U54.5
unnamed: R109.2, U34.1, U34.2 (-)
unnamed: R107.2, U34.6 (-), U34.7
unnamed: R103.2, U34.8, U34.9 (-)
unnamed: R105.2, U34.13 (-), U34.14
unnamed: R117.2, U35.1, U35.2 (-)
unnamed: R115.2, U35.6 (-), U35.7
unnamed: R111.2, U35.8, U35.9 (-)
unnamed: R113.2, U35.13 (-), U35.14
unnamed: U36.1 (V_O), U36.4 (R_L), U80.1
unnamed: U37.1 (V_O), U37.4 (R_L), U80.3
unnamed: U38.1 (V_O), U38.4 (R_L), U80.5
unnamed: U39.1 (V_O), U39.4 (R_L), U80.13
unnamed: U40.1 (V_O), U40.4 (R_L), U80.9
unnamed: U41.1 (V_O), U41.4 (R_L), U80.11
unnamed: U42.1 (V_O), U42.4 (R_L), U81.13
unnamed: U43.1 (V_O), U43.4 (R_L), U81.1
unnamed: U44.1 (V_O), U44.4 (R_L), U81.11
unnamed: U45.1 (V_O), U45.4 (R_L), U81.9
unnamed: U46.1 (V_O), U46.4 (R_L), U81.5
unnamed: U47.1 (V_O), U47.4 (R_L), U81.3
unnamed: U50.1 (V_O), U50.4 (R_L), U82.3
unnamed: R94.1, R123.1, U52.1 (V_O), U52.4 (R_L)
unnamed: U55.6, U56.13
unnamed: U55.8, U56.10, U56.12
unnamed: U56.6, U56.9
unnamed: R34.2, R81.2, R82.2, R83.2, R84.2, R85.2, R86.2, R87.2, R88.2, R89.2, R90.2, R91.2, R92.2, U57.1 (1A)
unnamed: R51.2, U58.2 (Cathode)
unnamed: R52.2, U59.2 (Cathode)
unnamed: R53.2, U60.2 (Cathode)
unnamed: R54.2, U61.2 (Cathode)
unnamed: R55.2, U62.2 (Cathode)
unnamed: R56.2, U63.2 (Cathode)
unnamed: R57.2, U64.2 (Cathode)
unnamed: R58.2, U65.2 (Cathode)
unnamed: R59.2, U66.2 (Cathode)
unnamed: R60.2, U67.2 (Cathode)
unnamed: R61.2, U68.2 (Cathode)
unnamed: R62.2, U69.2 (Cathode)
unnamed: U74.1 (1A), U74.3 (2Y)
unnamed: U78.1 (V_O), U78.4 (R_L), U82.1
Normally_High_GD_Enable: J14.1, U56.8
Normally_Low_GD_Enable: J14.3, U57.6 (1Y)
PHASE_UN_Out: C18.1, J13.5, R135.2
PHASE_UN_PIN: R3.1, R133.1, U1.90 (PA9), U18.3 (2A), U19.1 (1A)
PHASE_U_Out: C17.1, J13.10, R134.2
PHASE_U_PIN: R4.1, R93.1, U1.89 (PA8), U18.1 (1A), U19.6 (2B)
PHASE_VN_Out: C19.1, J13.14, R142.2
PHASE_VN_PIN: R1.1, R137.1, U1.92 (PA11), U20.3 (2A), U21.1 (1A)
PHASE_V_Out: C22.1, J13.15, R145.2
PHASE_V_PIN: R2.1, R136.1, U1.91 (PA10), U20.1 (1A), U21.6 (2B)
PHASE_WN_Out: C20.1, J13.13, R143.2
PHASE_WN_PIN: R5.1, R139.1, U1.67 (PB13), U16.3 (2A), U17.1 (1A)
PHASE_W_Out: C23.1, J13.4, R146.2
PHASE_W_PIN: R6.1, R138.1, U1.66 (PB12), U16.1 (1A), U17.6 (2B)
PWM_Alt_Enable: IC14.1 (ENA), IC14.8 (ENB), IC15.1 (ENA), IC15.8 (ENB), IC16.1 (ENA), IC16.8 (ENB), R7.1, U1.9 (PC15)
PWM_Enable: IC1.1 (ENA), IC1.8 (ENB), IC2.1 (ENA), IC2.8 (ENB), IC3.1 (ENA), IC3.8 (ENB), J15.2
STM_Enable: J18.2
STM_Enable_Pin: J18.3, R33.1, U1.8 (PC14), U74.2 (1B)
SWCLK: J16.2, U1.98 (PA14)
SWDIO: J16.1, U1.96 (PA13)
SWO: J16.3, U1.118 (PB3)
UN_Alt: IC15.5 (OUTB), R38.1
UN_Alt_Pin: IC15.4 (INB), U1.84 (PG2)
USART1_RX: C21.1, R129.2, R144.2, U1.38 (PC5)
USART1_RX_In: J10.2, J13.2, R141.1
USART1_TX: R131.1, R140.1, U1.37 (PC4)
USART1_TX_Out: C24.1, J10.1, J13.3, R147.2
USART2_RX: C26.1, R151.2, U1.32 (PA3)
USART2_RX_In: J11.2, R149.1
USART2_TX: R148.1, U1.29 (PA2)
USART2_TX_Out: C25.1, J11.1, R150.2
USART3_RX: C28.1, R130.2, R155.2, U1.101 (PC11)
USART3_RX_In: J12.2, R153.1
USART3_TX: R132.1, R152.1, U1.100 (PC10)
USART3_TX_Out: C27.1, J12.1, R154.2
U_Alt: IC15.7 (OUTA), R37.1
U_Alt_Pin: IC15.2 (INA), U1.83 (PG1)
VN_Alt: IC16.5 (OUTB), R40.1
VN_Alt_Pin: IC16.4 (INB), U1.86 (PG4)
V_Alt: IC16.7 (OUTA), R39.1
V_Alt_Pin: IC16.2 (INA), U1.85 (PG3)
WN_Alt: IC14.5 (OUTB), R35.1
WN_Alt_Pin: IC14.4 (INB), U1.88 (PC9)
W_Alt: IC14.7 (OUTA), R36.1
W_Alt_Pin: IC14.2 (INA), U1.87 (PC8)

Notes on the sheet:
ADC3_IN2
USART3_RX
ADC345_IN14
Remote STM32 reset
ADC345_IN11
PWM_Enable: The PWM_Enable net controls when the PWM Fiber Gate Driver ICs drive the PWM fiber transmitters. If at any time PWM_Enable is pulled LOW (0V), all IX4340NTR outputs will immediately be driven to 0V and the versatile link transmitters stop transmitting a fiber optic signal. All 12 FET bo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
HRTIM_CHA2
HRTIM_CHB1
ADC2_IN11
ADC2_IN12
USART3_TX
ADC2_IN3
USART2_TX
AnalogIn_04
HRTIM_CHA1
PDx register reserved for GDS logging
ADC345_IN15
ADC3_IN5
ADC4_IN13/ADC5_IN13
ADC1_IN4
Gate Driver Status Fibers RX
DSUB Out (PWM)
ADC345_IN16
ABCD
PWM Fiber Enable
ADC12_IN7
ADC4_IN4/ADC1_IN5
Normally HIGH GDS, AND Block
USART1_TX
Normally LOW GDS, NOR Block
ADC4_IN1
Input/Ouput Pins
ADC4_IN2
Gate Driver Fault & Enable Handling
AnalogIn_08
EFGH
ANALOG INPUT CHANNELS 1-8
ADC12_IN6
Reserve for ST-LINK
AnalogIn_03
ADC1_IN3
GPInput Fiber Receivers 12 Versatile Link RX fiber optic receivers are available for general purpose inputs to the controller board. Two receivers are available for USART1 and USART3 RX channels.
DSUB Out (Analog)
IJKL
HRTIM_FLT3
AnalogIn_02
HRTIM_CHC2
ADC345_IN10
ADC12_IN8
ADC2_IN4
AnalogIn_07
--> Needs decoupling capacitors
HRTIM_CHB2
ADC3_IN4
PWM Channel Fibers TX
USART1_RX
ADC3_IN3
ADC2_IN17
Fiber Optic Remote Control
High Speed External Oscillator
OSC_IN
Power
ADC3_IN1/ADC1_IN12
AnalogIn_05
OSC_OUT
ADC Pins Selected (8 total): ------------------------------------ PA0 (pin 34) → ADC1/2_IN1 - Fast sampling PA1 (pin 35) → ADC1/2_IN2 - Fast sampling PB0 (pin 56) → ADC3_IN12 - Phase U current PB1 (pin 57) → ADC3_IN1 - Phase V current PB11 (pin 70) → ADC1/2_IN14 - Phase W current PB14 (pin 76) → AD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
HRTIM_CHC1
ADC4_IN5/ADC2_IN15
https://www.st.com/resource/en/datasheet/stm32g474cb.pdf
Remote Boot0 (Programming)
ADC2_IN13
ADC3_IN12/ADC1_IN15
ADC345_IN8
ADC345_IN7
Reserve for ST-LINK
ADC12_IN14
ADC345_IN6
ADC2_IN5
ADC12_IN9
Unused Channels
ADC4_IN3/ADC1_IN11
Power Decoupling
ADC4_IN12/ADC5_IN12
USART2_RX
Digital
Analog
General Purpose Input Fibers RX
PWM Channel Fiber Transmitters 3-Phases of HRTIM-configurable PWM outputs are available. Each phase's fiber optic transmitter set are driven an IX4340NTR gate driver with an enable tied to PWM_Enable. (see section for explaination of logic) As long as PWM_Enable is not pulled to ground an input V_I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
AnalogIn_06
Gate Driver Status Receivers The Gate Driver Status fiber signals are received by 12 Versatile Link RX fiber receivers. Logic of this device is configured to allow selection between Normally HIGH GDS and Normally LOW GDS to allow control of both the old and new HVPS.
ADC5_IN1
GPOut Fiber Transmitters There are 12 general purpose Versatile Link TX transmitters. Transmitters are organized in pairs of 2, although can be operated indepen- dently of each partner. Each pair is driven by a 2-Ch IX4340NTR to level shift +3.3V STM32 GPO logic level to +5V needed to drive the Ver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
AnalogIn_01
ADC5_IN2
General Purpose Output Fibers TX
STM32G474QET6
ABCDEFGHIJKL
ADC345_IN9

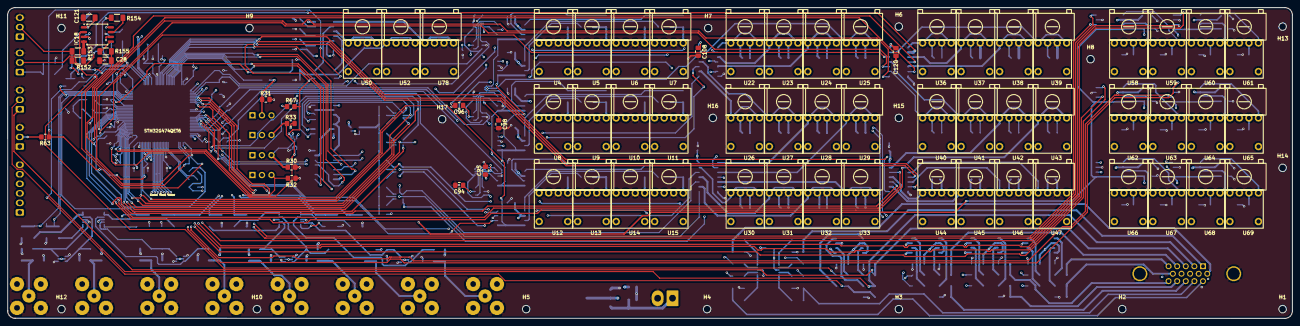
[picture p40: board HVPS_Controller_V3.kicad_pcb from above]

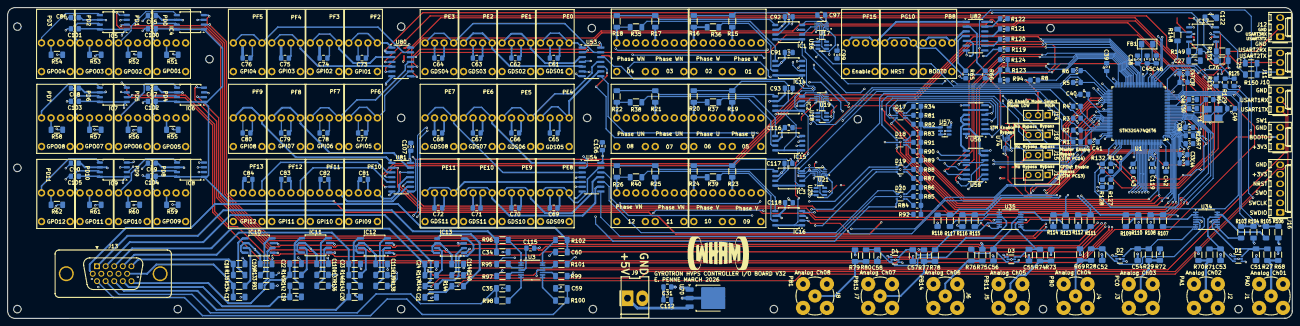
[picture p41: board HVPS_Controller_V3.kicad_pcb from below]

Board: 6 copper layers, 342.1 x 82.8 mm, 376 parts (289 on the bottom side), 272 nets.
