everettpenne/WHAM-CONTROLLERS/firmware/hbridge/Core/Src/main.c

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
/* Includes ------------------------------------------------------------------*/
#include "main.h"

/* USER CODE BEGIN Includes */
#include "app.h"
#include "boot_jump.h"
#include "board_io.h"
#include "boot_diag.h"
#include "hrtim_hw.h"
#include "mcu.h"
#include "uart_hw.h"
/* USER CODE END Includes */

UART_HandleTypeDef huart2;

void SystemClock_Config(void);
static void MX_GPIO_Init(void);
static void MX_USART2_UART_Init(void);
static void MX_HRTIM1_Init(void);
/**
  * @brief  The application entry point.
  * @retval int
  */
int main(void)
{

  /* USER CODE BEGIN 1 */

  /* Must be the very first thing that runs -- before HAL_Init() and
     therefore before any clock/peripheral configuration. See
     boot_jump.c: if cmd_boot() (over USART2) requested a bootloader
     entry on the last reset, this diverts into the ROM bootloader from
     this still-clean, just-reset state and never returns. Otherwise it
     returns immediately (always the case when BOOT_JUMP_FEATURE_ENABLED
     is 0) and startup proceeds normally below -- unconditional on
     purpose, so this call site never needs its own #if. */
  BootJump_CheckAndEnter();

  /* Boot diagnostics (boot_diag.h): keep the previous boot's record for
     the !BOOT banner and start this boot's. */
  BootDiag_Begin();

  /* USER CODE END 1 */

  /* MCU Configuration--------------------------------------------------------*/

  /* Reset of all peripherals, Initializes the Flash interface and the Systick. */
  HAL_Init();

  /* USER CODE BEGIN Init */
  /* Must run immediately after HAL_Init() -- HAL_InitTick() (called
     inside HAL_Init()) sets SysTick to its default TICK_INT_PRIORITY
     (15, the lowest possible), which this overrides. See
     Mcu_SetSysTickHighestPriority()'s own doc comment (mcu.c) for the full
     priority-inversion window this closes -- placed here, as early as
     possible, so nothing between here and HRTIM1_EnableMasterInterrupt()
     (which sets HRTIM1_Master_IRQn's priority, later in USER CODE 2)
     can be exposed to it, however briefly. Ported from the sibling
     PFM-STM32G474 project's main.c, same placement. */
  Mcu_SetSysTickHighestPriority();
  BOOT_DIAG_STAGE(BD_STAGE_HAL_INIT);
  /* USER CODE END Init */

  /* Configure the system clock */
  SystemClock_Config();

  /* USER CODE BEGIN SysInit */
  BOOT_DIAG_STAGE(BD_STAGE_CLOCK);
  /* USER CODE END SysInit */

  /* Initialize all configured peripherals */
  MX_GPIO_Init();
  MX_HRTIM1_Init();
  MX_USART2_UART_Init();
  /* USER CODE BEGIN 2 */
  uart_bind(&uart2, &huart2);
  App_Init();
  BOOT_DIAG_STAGE(BD_STAGE_APP_INIT);
  App_SendBootBanner();
  BOOT_DIAG_STAGE(BD_STAGE_MAIN_LOOP);
  /* USER CODE END 2 */

  /* Infinite loop */
  /* USER CODE BEGIN WHILE */
  while (1)
  {
    /* USER CODE END WHILE */

    /* USER CODE BEGIN 3 */
    App_Poll();
  }
  /* USER CODE END 3 */
}

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
