everettpenne/WHAM-CONTROLLERS/firmware/hbridge/src/config/ctrlr_config.h

#ifndef INC_CTRLR_CONFIG_H_
#define INC_CTRLR_CONFIG_H_

/*
 * ctrlr_config.h
 *
 * The project's one compile-time config file -- board/firmware
 * IDENTITY (HW_BOARD_NAME/REV, FW_VERSION_STRING) and general
 * controller-BEHAVIOR settings (HRTIM_NUM_CHANNELS, GDS_FAULT_POLARITY)
 * together, matching the sibling PFM-STM32G474 project's single
 * supply_config.h. This was briefly split (2026-09-08: identity stayed
 * in version.h, behavior moved here) on the reasoning that identity and
 * behavior are different KINDS of thing -- re-condensed the same day,
 * per project decision, back to one file. version.h no longer exists;
 * don't recreate it.
 *
 * (Module-local, self-contained flags are a further, older exception --
 * e.g. BOOT_JUMP_FEATURE_ENABLED lives in boot_jump.h itself, because
 * that module's whole design point is being independently removable in
 * one place. Don't move flags like that here.)
 */

/* --------------------------------------------------------------------------
 * Board/product identity. HW_BOARD_REV is a placeholder -- set it to
 * match this build's actual PCB silkscreen revision and bump it on
 * every hardware respin so *IDN's report always matches what's
 * physically in hand.
 * -------------------------------------------------------------------------- */
#define HW_BOARD_NAME     "WHAM-HBRIDGE-PFMG474"
#define HW_BOARD_REV      "REVA"

/* Firmware identity. Bump on every release the way the sibling
 * PFM-STM32G474 project does (FW_VERSION_STRING in its
 * supply_config.h). */
#define FW_VERSION_STRING "v0.11"

/* --------------------------------------------------------------------------
 * HRTIM channel count
 *
 * docs/pin_mapping_v4.csv wires out all 6 HRTIM1 channel pairs (A-F /
 * U,V,W,X,Y,Z) on this board. HRTIM_NUM_CHANNELS selects how many of
 * them hrtim.c/pfm.c actually drive, phase-locked and evenly spaced
 * around a shared carrier, as a real compile-time setting
 * (2026-09-08) -- fix it here, rebuild, reflash. It is NOT modifiable
 * at runtime, by design: no variable backs this anywhere, only this
 * #define, so "changing it after the firmware is flashed" isn't a
 * thing that can happen short of building and flashing a different
 * firmware image.
 *
 * Range is 1-5, not 1-6: the HRTIM Master timer has exactly 4 compare
 * registers (MCMP1R-MCMP4R), giving 5 total trigger points (its own
 * PER event + 4 CMPs) -- enough for channels A-E phase-locked to the
 * Master, but not a 6th (F) without a genuinely different (cross-timer)
 * sync scheme. That scheme is NOT implemented here -- the HAL does
 * expose the register support for it (HRTIM_TIMRESETTRIGGER_OTHERx_
 * CMPy, letting one slave timer's reset trigger chain off another
 * slave's compare event instead of the Master's), but it needs new
 * phase math with no existing pattern in this codebase to build from,
 * and was deliberately left as a follow-up rather than bundled into
 * this change -- see AGENTS.md.
 *
 * Channels beyond HRTIM_NUM_CHANNELS (up through Timer F) stay
 * pin/dead-time-reserved but unlocked (ResetTrigger = NONE) and are
 * never started by HRTIM1_PWM_Start() -- exactly how Timers D/E/F
 * behaved before this config existed for the N=3 default. See
 * HRTIM1_FullInit()'s own comments in hrtim.c for the exact mechanism.
 *
 * Raising this value automatically extends the 2026-09-09 HRTIM
 * SET/RESET-collision fix (hrtim.c's HRTIM1_FullInit(), the CMP3-based
 * output SET source) to whichever channels newly become active --
 * verified, not assumed: every place that fix touches (the CMP3
 * compare-register config loop, the per-channel SetSource selector,
 * and HRTIM1_PWM_Start()'s cold-start reforceActive handling) is keyed
 * off this constant, not a hardcoded channel count. No further code
 * changes are needed here when raising N; just re-verify the new
 * channel(s) on real hardware the same way U/V/W were (frequency-ramp
 * table + DSLogic capture -- see docs/changelog.txt), since this fix
 * was derived from real-hardware evidence, not proven in general.
 * -------------------------------------------------------------------------- */
#define HRTIM_NUM_CHANNELS  (3U)

#if (HRTIM_NUM_CHANNELS < 1U) || (HRTIM_NUM_CHANNELS > 5U)
#error "HRTIM_NUM_CHANNELS must be 1-5 -- see the comment above it in " \
       "ctrlr_config.h for why 6 isn't a simple extension of this scheme."
#endif

/* --------------------------------------------------------------------------
 * GateDriverStatus fault polarity (compile-time)
 *
 * GDS_NORMALLY_HIGH -- pins read HIGH in good operation;
 *                      a LOW reading is a fault.
 * GDS_NORMALLY_LOW  -- pins read LOW in good operation;
 *                      a HIGH reading is a fault.
 *
 * Governs both gate_driver.c's GateDriver_CheckFault() (the EXTI-driven
 * fault interrupt on PE0..PE11, see gate_driver.h) and nothing else --
 * GDS? (commands.c) is a raw, polarity-agnostic HIGH/LOW readback and
 * does not consult this value.
 *
 * Set to NORMALLY_LOW per direct confirmation against this board's
 * actual gate driver ICs, 2026-09-08 -- matching the sibling
 * PFM-STM32G474 project's own configured default (GDS_FAULT_POLARITY =
 * GDS_NORMALLY_LOW in supply_config.h), even though that project's own
 * comment calls NORMALLY_HIGH "the safest" choice in the abstract (a
 * disconnected pin reads LOW and immediately trips) -- the actual wiring
 * on real hardware is the deciding fact here, not the abstract argument.
 *
 * Known consequence, confirmed before choosing this value, not
 * discovered by surprise: a GDS? snapshot taken earlier this session
 * showed GateDriverStatus_03 (PE2) already reading HIGH while the other
 * 11 pins read LOW. Under NORMALLY_LOW, that pin is *already* a fault
 * condition -- expect GateDriver_CheckFault() to latch a fault on it as
 * soon as this interrupt is live (very possibly immediately at boot, if
 * that pin is still HIGH by then). That may well be surfacing a real,
 * previously-invisible fault condition, which is the whole point of
 * this feature -- see docs/changelog.txt.
 *
 * Single source of truth, unlike the sibling project's own documented
 * history (supply_config.h's own comment describes GDS_FAULT_POLARITY
 * once being defined twice -- once there, once in gate_driver.h -- with
 * gate_driver.h's #ifndef silently winning the race every time,
 * making the copy in supply_config.h dead). Not a risk here structurally:
 * gate_driver.h includes THIS file rather than defining anything
 * itself, and this is the only place GDS_NORMALLY_HIGH/LOW/
 * GDS_FAULT_POLARITY are ever defined.
 * -------------------------------------------------------------------------- */
#define GDS_NORMALLY_HIGH    (0U)
#define GDS_NORMALLY_LOW     (1U)

#define GDS_FAULT_POLARITY   GDS_NORMALLY_LOW

/* --------------------------------------------------------------------------
 * Supply modes and their limits (added 2026-09-29)
 *
 * The same firmware drives two different H-bridge supplies; the operator
 * selects which one with CONFig:MODE (supply_mode.h) and TABle:STEP is then
 * checked against that mode's range. Values are the older PFM-STM32G474
 * project's own bounds (its supply_config.h, "Section 1a/1b, 3.1"), still
 * correct per the maintainer.
 *
 *   HVPS     PFM-driven:  10-30 kHz carrier, shared 40-60% duty
 *   LIMITER  PWM-driven:  75-125 kHz carrier, per-phase 5-95% duty
 *
 * Duty is checked as compare/period, the same relation the host table
 * builder uses (python/pfm_table_upload.py cmp_from_duty()). The modes only
 * NARROW the hardware envelope (16-bit period, the compare clamp, the
 * 100 ns dead time); they never widen it.
 *
 * VERIFICATION CAVEAT for LIMITER: this project's HRTIM SET/RESET-collision
 * fix (hrtim.c, 2026-09-09) was confirmed on a logic analyzer only up to
 * 100 kHz -- a frequency-ramp capture had found genuinely missing pulses
 * from about 85 kHz upward before the fix. 100-125 kHz is inside the
 * Limiter range but has NOT been scoped on real hardware; do that before
 * relying on it. (Until 2026-09-29 every TABle:STEP above 100 kHz was
 * rejected outright; PFM_MAX_CARRIER_FREQ_HZ below is now the highest
 * frequency any mode allows.)
 * -------------------------------------------------------------------------- */
#define HVPS_FREQ_MIN_HZ          (10000UL)
#define HVPS_FREQ_MAX_HZ          (30000UL)
#define HVPS_DUTY_MIN_PCT         (40U)
#define HVPS_DUTY_MAX_PCT         (60U)

#define LIMITER_FREQ_MIN_HZ       (75000UL)
#define LIMITER_FREQ_MAX_HZ       (125000UL)
#define LIMITER_DUTY_MIN_PCT      (5U)
#define LIMITER_DUTY_MAX_PCT      (95U)

/* Highest carrier frequency any mode allows. */
#define PFM_MAX_CARRIER_FREQ_HZ  LIMITER_FREQ_MAX_HZ

/* --------------------------------------------------------------------------
 * Shot memory (compile-time; change here and rebuild the .bin)
 *
 * A shot is programmed as a time series of setpoints (SHOT:STEP <t_us>
 * <freq_hz> <duty_pct>, shot_profile.h). The firmware linearly interpolates
 * between them one switching period at a time into a small per-period ring
 * table (pfm.c) that the per-period interrupt plays back and a low-priority
 * interrupt keeps refilled, so the shot's length does not depend on the
 * table's size.
 *
 *   SHOT_SETPOINT_MAX     time-series setpoints, 12 bytes each (500 = 6 kB).
 *                         At least 2: t = 0 first, then the shot's end.
 *   SHOT_MAX_DURATION_US  longest shot, and the largest time a setpoint may
 *                         have. Open-loop shots run from about 10 ms to 1 s.
 *   PFM_TABLE_SIZE        the per-period ring (pfm.h), 8 bytes per entry.
 *                         Even. Also the longest table TABle:* can upload
 *                         directly.
 *
 * Sizing PFM_TABLE_SIZE (measured on the simulator, docs/changelog.txt
 * 2026-10-01 and 2026-10-02). The ring is filled before the first period and
 * refilled by a low-priority interrupt that gets only the CPU the per-period
 * interrupt leaves. With the project built at -O2, 100 entries sustain 1 s shots
 * in both modes and every Limiter shot tried at 75-125 kHz, including duty and
 * frequency ramps and a 5 -> 95 % -> 5 % duty triangle over 50 ms at 125 kHz. The
 * one case that still empties it is the most extreme: a step applied EVERY
 * period at 125 kHz (duty 5 -> 95 % in 10 ms); the shot is then stopped with a
 * fault (FAULT:SOURces? TABLE=1) and a ring of ~1,300 entries (10 ms at 125 kHz)
 * holds it. Filling the ring takes ~240 cycles per entry with interrupts masked
 * inside FIRE.
 * -------------------------------------------------------------------------- */
/* External shot trigger: a rising edge on PF15 ("Fiber_Enable") while ARMED starts the shot exactly as FIRE would
   (EXTernal:TRIGger). 1 = on at every boot, like XREX; EXTernal:TRIGger 0 turns it off for a session. */
#define SHOT_TRIGGER_DEFAULT_ENABLED  (1U)

/* The CHARGE output (CHARGE:FREQuency): a 50 % square wave on PG0 for the frequency-to-voltage converter that charges the
   capacitor bank. 0 Hz = off; otherwise whole hertz from CHARGE_MIN_HZ to CHARGE_MAX_HZ. Off at every boot. */
#define CHARGE_MIN_HZ  (1U)
#define CHARGE_MAX_HZ  (100000U)

#define SHOT_SETPOINT_MAX        (500U)
#define SHOT_MAX_DURATION_US     (1000000UL)
#define PFM_TABLE_SIZE           (100U)

/* The ADC sampler (adc.h): the default sampling time, in ADC clocks x10 (475 = 47.5 clocks). The
   operator sets it at run time (CONFig:ADC:SAMPle): a high-impedance source needs a longer one,
   a longer one limits the scan rate. The source impedance of the feedback is not known yet. */
#define ADC_SAMPLE_X10_DEFAULT   (475U)

/* The closed-loop control tick (control_task.h): ticks per second and ADC scans averaged per tick.
   Both are set at run time (CONFig:PIDRate, CONFig:ADC:AVERage). */
#define CONTROL_RATE_HZ_DEFAULT        (10000U)
#define CONTROL_SCANS_PER_TICK_DEFAULT (4U)

/* Closed-loop target profile (target_profile.h): setpoints of the time series of target
   voltages, 8 bytes each. */
#define TARGET_SETPOINT_MAX      (500U)

/* --------------------------------------------------------------------------
 * PFM_Input capture depth (compile-time)
 *
 * PFM_INPUT_MAX_PERIODS is the longest capture, per input, in switching
 * periods (a both-edge capture holds twice that many edges). Each ACTIVE input
 * (PFM_INPUT_ACTIVE_CHANNEL_MASK, pfm_input.h) gets its own array of
 * 16-bit timestamps, so the RAM is
 *     active inputs x (2 * PFM_INPUT_MAX_PERIODS + 2) x 2 bytes
 * -- 60.8 kB for 4 inputs at 3,800. 3,800 holds a 50 ms shot at 75 kHz (3,750
 * periods), the slowest the Limiter runs, and 50 ms at 30 kHz (1,500) with room
 * to spare. 16-bit stamps are enough because a period is always far below 65,536
 * clocks (385 us, 2.6 kHz): differences are taken modulo 65,536.
 * -------------------------------------------------------------------------- */
#define PFM_INPUT_MAX_PERIODS    (3800U)

#if (PFM_INPUT_MAX_PERIODS < 2U) || (PFM_INPUT_MAX_PERIODS > 16000U)
#error "PFM_INPUT_MAX_PERIODS must be 2..16000"
#endif
#if (SHOT_SETPOINT_MAX < 2U) || (SHOT_SETPOINT_MAX > 5000U)
#error "SHOT_SETPOINT_MAX must be 2..5000"
#endif
#if (PFM_TABLE_SIZE < 8U) || (PFM_TABLE_SIZE > 5000U) || ((PFM_TABLE_SIZE % 2U) != 0U)
#error "PFM_TABLE_SIZE must be even and 8..5000"
#endif
#if (SHOT_MAX_DURATION_US < 1000UL) || (SHOT_MAX_DURATION_US > 60000000UL)
#error "SHOT_MAX_DURATION_US must be 1 ms .. 60 s"
#endif

/* --------------------------------------------------------------------------
 * Analog reference (vref.h): the voltage on VREF+, in millivolts, which is the
 * full scale of the ADC inputs (adc.h) AND the DAC outputs (dac.h). This board has
 * no external reference (pin 43 is only a capacitor), so the internal VREFBUF
 * produces it: one of 2048, 2500 or 2900. 2500 needs VDDA of at least ~2.8 V
 * (this board's 3.3VA is fine); 2900 needs ~3.15 V, little margin. ADC:VREF?
 * measures the real value from the internal bandgap and the chip's factory
 * calibration, to check this setting against.
 * -------------------------------------------------------------------------- */
#define ANALOG_VREF_MV          (2900U)

/* --------------------------------------------------------------------------
 * Feedback range for a bipolar output (added 2026-10-02)
 *
 * The Limiter's output swings -Vmax..+Vmax; its divider maps -Vmax to 0 V and
 * +Vmax to the ADC full scale (zero volts at mid-scale), so the ADC never sees
 * a negative voltage. A non-zero value here makes the loop's voltages -- the
 * target, the measurement, CONFig:MAXVolts -- read in real supply volts out of
 * the box (the same as CONFig:FEEDback:RANGE <Vmax> at run time). 0 leaves the
 * feedback uncalibrated (the loop works in ADC volts, scale 1, offset 0), which
 * is also what an HVPS wants. Projected capacitor bank: about 900 V -- left at
 * 0 until the real divider is built and calibrated.
 * -------------------------------------------------------------------------- */
#define FEEDBACK_VMAX_DEFAULT_V (0U)

/* --------------------------------------------------------------------------
 * Saved profiles (flash_profiles, added 2026-10-05)
 *
 * Numbered slots of saved settings in the external W25Q128 (nvstore.h):
 * *SAV / *RCL / CONFig:PROFile:*. Each slot is two alternating "copies" (a save
 * never touches the copy holding the newest valid data, so a power cut mid-save
 * loses nothing); a copy is PROFILE_COPY_SECTORS 4 KiB sectors holding a
 * 48-byte header and the payload. HBRIDGE profiles carry the shot and target
 * time series and the HVPS curve (about 10 KB for 500-point tables), so a copy
 * is 4 sectors (16 KiB): 8 slots x 2 copies x 16 KiB = 256 KiB.
 * XREX uses 1 sector (1 KiB payload) with the same code, in the first 64 KiB of the chip.
 *
 * PROFILE_STORE_BASE gives each product its own REGION of the shared chip: XREX's slots occupy 0..64 KiB,
 * so HBRIDGE starts at 64 KiB. A board that has run both keeps both products' profiles (neither overwrites
 * the other's), and the magic below stops either from decoding the other's.
 *
 * PROFILE_MAGIC tags the PRODUCT: the two controllers share this board and
 * this flash chip, and a profile written by one must never be decoded by the
 * other (field ids overlap). A different magic reads as "corrupt" in the
 * other product's catalog rather than being applied.
 * -------------------------------------------------------------------------- */
#define PROFILE_STORE_BASE      (65536UL)
#define PROFILE_SLOT_COUNT      (8U)
#define PROFILE_COPY_SECTORS    (4U)
#define PROFILE_MAGIC_BYTES     { 'H', 'S', 'P', 'F' }

/* --------------------------------------------------------------------------
 * Front-panel LEDs (led_indicators.h, added 2026-10-07)
 *
 * UART transmit / receive activity and the four operating-state LEDs
 * (PD2, PD3, PF14, PF2, PC3, PC2 -- docs/pin_mapping_v4.csv). Cosmetic only.
 * LED_INDICATORS_ENABLED 0 removes the whole feature (and frees TIM16, TIM17
 * and DMA1 channels 7 and 8, which it uses). LED_ACTIVITY_MS is how long an
 * activity LED stays lit after the last byte (1..6000).
 * -------------------------------------------------------------------------- */
#define LED_INDICATORS_ENABLED  (1)
#define LED_ACTIVITY_MS         (30U)

#endif /* INC_CTRLR_CONFIG_H_ */
