everettpenne/WHAM-CONTROLLERS/firmware/xrex/src/app/control/state_machine.c

/*
 * state_machine.c
 *
 * See state_machine.h for the full design writeup (states, fault
 * types, what's stubbed and what's real).
 */

#include "state_machine.h"
#include "pid.h"
#include "hrtim.h"
#include "gate_driver.h"
#include "pfm.h"
#include "board_io.h"
#include "mcu.h"
#include "xrex_io.h"
#include "fault_mask.h"
#include "telemetry.h"
#include "led_indicators.h"

static SM_State_t     g_state         = SM_STATE_IDLE;
static SM_FaultType_t g_faultType     = SM_FAULT_NONE;

/* The ONLY place g_state is assigned: the state LEDs (led_indicators.h) are
   updated in the same step, so an LED is lit if and only if the machine is
   in that state, whichever context (main loop, EXTI, control interrupt)
   caused the transition. */
static void SetState(SM_State_t s)
{
    g_state = s;
    switch (s)
    {
        case SM_STATE_IDLE:   LedIndicators_ShowState(LED_STATE_IDLE);   break;
        case SM_STATE_ARMED:  LedIndicators_ShowState(LED_STATE_ARMED);  break;
        case SM_STATE_FIRING: LedIndicators_ShowState(LED_STATE_FIRING); break;
        case SM_STATE_FAULT:  LedIndicators_ShowState(LED_STATE_FAULT);  break;
        default:              LedIndicators_ShowState(LED_STATE_NONE);   break;
    }
}

/* External-enable interlock -- PF13, MOVED here 2026-09-17 from PF15
   (Fiber_Enable), per direct instruction: enable and trigger are now
   two independent physical signals on separate pins, not one shared
   wire. See this file's own header comment for the full design.

   ON by default as of 2026-09-22, direct instruction: these are meant
   to be usable-by-default features, not something an operator has to
   remember to opt into every session. REAL CONSEQUENCE, not a paper
   change: PF13 is GPIO_PULLDOWN (board_io.c), so a floating/unwired PF13
   now reads LOW = "not satisfied" by default -- ARM (ArmConditionsMet())
   and SHOT:STARt will both refuse (ERR 13/15) on any bench setup
   that doesn't have the real interlock wired or looped back
   (DIAGnostic:GPOut11 -> PF13, see that command's own doc). Was OFF by
   default 2026-09-16 through 2026-09-21 -- see docs/changelog.txt for
   both entries if reconciling behavior against an older build. */
static uint8_t g_externalEnableRequired = 1U;

/* External trigger (rising edge on PF15 fires a shot while ARMED) --
   see this file's own header comment for the full design.

   ON by default as of 2026-09-22, same direct instruction and same
   reasoning as g_externalEnableRequired above -- these are meant to be
   usable-by-default features. Lower practical impact than the enable
   flag above: this only means a PF15 rising edge will fire an ARMED
   shot; it never BLOCKS anything by itself (SM_Fire() still always
   re-checks the enable interlock regardless of how it's called), and a
   floating/unwired PF15 (also GPIO_PULLDOWN) just never produces a
   rising edge, so an unwired bench setup sees no behavior change from
   this flag alone. UNCOUPLED from g_externalEnableRequired 2026-09-17,
   the same day enable moved to PF13 -- previously turning enable off
   also forced this off (SM_SetExternalEnableRequired()'s old comment),
   a rule that existed only because both features read the SAME
   physical wire; now that they're on separate pins, per direct
   instruction, the two config flags are fully independent. The real
   safety guarantee is unaffected either way: SM_Fire() itself (below)
   still unconditionally re-checks SM_ExternalEnableOk() before ever
   actually firing, regardless of how or when trigger was turned on. */
static uint8_t g_externalTriggerRequired = 1U;

/* Baseline PF15 level for edge detection, meaningful only while
   g_state == SM_STATE_ARMED and g_externalTriggerRequired != 0 --
   captured fresh by SM_Arm() the instant it succeeds, then kept
   current by SM_PollFaults() on every call while still ARMED. See the
   external-trigger design comment (state_machine.h) for why a fresh
   capture at arm-time (not a stale value from a previous cycle)
   matters. RENAMED (not just re-read) 2026-09-17 from
   g_lastExternalEnableLevelWhileArmed -- this was always tracking
   whichever physical pin trigger's edge detection reads, which just
   happened to be the same pin the enable interlock also used before
   today; now that enable and trigger are genuinely different pins,
   the old name would actively mislead (it would sound like it tracks
   PF13, the new enable pin, when it has always meant -- and still
   means -- the trigger pin specifically). */
static uint8_t g_lastExternalTriggerLevelWhileArmed = 0U;

/* GPIO_PULLDOWN in board_io.c's BoardIo_Init() means an unconnected/
   floating PF13 reads LOW here -- the deliberate fail-safe default,
   see this file's header comment. MOVED from PF15 2026-09-17, same
   change as the static above. */
static uint8_t ExternalEnableInputIsHigh(void)
{
    return BoardIo_Read(BOARD_SIG_EXT_ENABLE);
}

/* PF15 (Fiber_Enable) -- trigger-only as of 2026-09-17 (previously this
   pin backed BOTH ExternalEnableInputIsHigh() above and this function,
   since enable and trigger were the same wire). GPIO_PULLDOWN in
   board_io.c means an unconnected/floating PF15 reads LOW -- no spurious
   rising edge from a disconnected trigger wire (see board_io.c's own
   comment on this pin for the fuller reasoning). */
static uint8_t ExternalTriggerInputIsHigh(void)
{
    return BoardIo_Read(BOARD_SIG_EXT_TRIGGER);
}

/* Emergency-stop feature REMOVED 2026-09-21 (PG10 was NRST, not a usable
   GPIO) -- g_emergencyStopRequired/EmergencyStopInputIsHigh()/
   EmergencyStopAsserted() and SM_FAULT_EMERGENCY_STOP are gone. See
   state_machine.h and docs/changelog.txt. */

/* Meaningful only when g_faultType is one of the PER-CHANNEL fault
   types (SM_FAULT_OVERCURRENT/SM_FAULT_ENABLE_OUTPUT/SM_FAULT_ENERPRO
   -- see SM_GetFaultChannel()'s own doc comment, state_machine.h).
   0xFF is the "not applicable" sentinel (never a real channel index).
   Added 2026-09-15 alongside SM_ReportOcpFault(). */
static uint8_t g_faultChannel = 0xFFU;

/* Captured by EnterFault(), before it transitions g_state to
   SM_STATE_FAULT -- lets the fault-type handlers below tell whether
   there was real output in progress (SM_STATE_FIRING) at the exact
   moment the fault was detected, without needing g_state itself (which
   is already SM_STATE_FAULT by the time either handler runs) to carry
   that information. */
static SM_State_t g_stateBeforeFault = SM_STATE_IDLE;

/* DEBUG:FAULT:BYPASS -- added 2026-09-21, direct request: a bench-only
   debug override to run a channel with no real fault-detect signal
   feeding its Water/Temp/Enerpro/OCP inputs (e.g. a controller-target
   build running with no simulator/Transrex physically connected to
   drive those inputs healthy -- they float, and float-as-unhealthy
   trips an instant fault the moment the channel is enabled, blocking
   ANY test of the DRIVE/FEEDBACK path itself). Defaults OFF (0) at
   every boot -- this is a RAM-only flag, never persisted, so it cannot
   silently stay enabled across a power cycle. When ON, EnterFault()
   below (the single funnel every SM_Report*Fault()/SM_PollFaults()
   call already goes through) returns immediately without transitioning
   state, so NOTHING behaves as faulted regardless of source -- Water/
   Temp/Enerpro/OCP/ENABLE_OUTPUT/GENERAL/EXTERNAL_ENABLE
   all pass through this same bypass.

   EXTENDED 2026-09-24, direct request: the bypass now ALSO removes the
   fault-derived restrictions that block state-machine transitions, so
   the device can be operated even while a fault is being measured:
   (1) SM_ClearFault() clears unconditionally (no re-validation of
   PC10/GateDriverStatus/PF13), (2) SM_ExternalEnableOk() reports OK
   (ARM/SHOT:STARt/SOURce:RUN/FIRE no longer refuse on PF13 LOW),
   (3) GateDriver_CheckFault() no longer latches/force-stops on a
   Water/Temp GateDriverStatus fault, (4) FIRE's ERR 6 latched-fault
   check is skipped. NOT bypassed: the HRTIM's own silicon-level PC10
   fault gating (autonomous, not firmware), and the ENA_OUT/CONTACT_OUT
   ARM precondition (an operator-commanded readiness, not a measured
   fault). *** NEVER enable this against a
   real Transrex or any hardware where a real overcurrent/water/temp
   condition is physically possible -- it exists purely so this bench's
   own two-board test rig can validate signal paths (like DRIVE/
   FEEDBACK capture) in isolation, without a full, correctly-wired fault
   loop present. *** */
static uint8_t g_faultBypassEnabled = 0U;

void SM_SetFaultBypassEnabled(uint8_t enabled)
{
    uint8_t wasEnabled = g_faultBypassEnabled;
    g_faultBypassEnabled = (enabled != 0U) ? 1U : 0U;

    /* Turning the bypass OFF returns to normal operation: Water/Temp and
       Enerpro are detected only on a GateDriverStatus pin EDGE (EXTI), so
       a pin that has sat in its fault state the whole time the bypass was
       on would otherwise never be noticed again (no new edge). Re-scan
       once now, the same call app.c makes at boot for the same reason.
       OCP, ENABLE_OUTPUT and PF13 are polled every tick and need nothing. */
    if ((wasEnabled != 0U) && (g_faultBypassEnabled == 0U))
    {
        GateDriver_CheckFault();
    }
}

uint8_t SM_GetFaultBypassEnabled(void)
{
    return g_faultBypassEnabled;
}

/* Every fault MEASURED since the controller last was clear (fault_mask.h's FM_*
   bits), not just the first -- g_faultType above names only the one that
   latched first. Written from the main loop, PID_Update() and the EXTI ISR, so
   every update is under Mcu_IrqDisable(). Zeroed by a successful
   SM_ClearFault(), deliberately NOT by SM_Init() (nothing to clear there).
   Added 2026-11-09, direct request: STATE? reports all of them. */
static volatile uint32_t g_faultMask = 0UL;

void SM_NoteFaults(uint32_t bits)
{
    if ((bits == 0UL) || (g_faultBypassEnabled != 0U))
    {
        return;   /* DEBUG:FAULT:BYPASS: faults are ignored, so none are recorded */
    }
    Mcu_IrqDisable();
    g_faultMask |= bits;
    Mcu_IrqEnable();
}

uint32_t SM_GetActiveFaults(void)
{
    return g_faultMask;
}

/* -- fault-type handlers -- */

/* Called on entering SM_STATE_FAULT with g_faultType == SM_FAULT_GENERAL.
   Currently every fault this codebase can detect routes here -- see
   state_machine.h's own "NOTE TO REVISIT" on why, and SM_PollFaults()
   below.

   POPULATED 2026-09-13, per direct instruction: if the fault hit while
   FIRING (real output in progress, ANY channel, anywhere in its own
   shot profile), every actively-outputting channel immediately begins
   an OPEN-LOOP linear ramp-down to PFM_TURNON_FREQ_HZ (0A) over
   FAULT_RAMP_DOWN_TIME_S seconds (PID_BeginFaultRampDown()/
   ProcessFaultRampDown(), pid.c) -- explicitly NOT via the normal PID
   feedback loop, per direct instruction. PID_Update() keeps ticking
   (g_running stays 1) to drive this ramp forward, one tick at a time,
   until every participating channel reaches the floor, at which point
   pid.c calls PID_Stop() itself (disconnecting every HRTIM output
   unconditionally) and the controller settles into FAULT to wait for
   FAULT:CLEAR -- exactly "disable the HRTIM output channels and wait
   in the FAULT state," per direct instruction.

   If the fault hit while IDLE or ARMED, nothing was actually
   outputting for it to have interrupted -- an immediate PID_Stop() is
   all that's needed (also covers the case where every channel happened
   to already be disabled/idle even during FIRING -- see
   PID_BeginFaultRampDown()'s own "anyParticipating" check). */
static void HandleGeneralFault(void)
{
    if (g_stateBeforeFault == SM_STATE_FIRING)
    {
        PID_BeginFaultRampDown();
    }
    else
    {
        PID_Stop();
    }
}

/* Called on entering SM_STATE_FAULT with g_faultType == SM_FAULT_OVERCURRENT
   -- POPULATED 2026-09-15, per direct instruction. Channel-aware, unlike
   General Fault: if the fault hit while FIRING, `channel`'s own HRTIM
   output is disabled IMMEDIATELY (no ramp for it at all), every OTHER
   currently-enabled channel is stepped down by (100 * 1/N)% of its own
   current output (N = channels enabled at the fault instant, `channel`
   included), and the survivors then ramp on down to PFM_TURNON_FREQ_HZ
   exactly like General Fault -- see PID_BeginOvercurrentRampDown()'s own
   extensive doc comment (pid.h) for the full mechanism, including a real,
   deliberately-not-silently-resolved tension between "simultaneous" and
   the existing hard slew-rate clamp.

   If the fault hit while IDLE or ARMED, nothing was actually outputting
   for it to have interrupted -- PID_BeginOvercurrentRampDown() itself
   falls through to an immediate stop in that case (via the same path
   PID_BeginFaultRampDown()'s own "anyParticipating" check already
   provides), so no separate branch is needed here, unlike
   HandleGeneralFault()'s explicit if/else above. */
static void HandleOvercurrentFault(uint8_t channel)
{
    if (g_stateBeforeFault == SM_STATE_FIRING)
    {
        PID_BeginOvercurrentRampDown(channel);
    }
    else
    {
        PID_SetChannelEnable(channel, 0U);   /* still disable it, even with
                                                  nothing else to ramp */
        PID_Stop();
    }
}

/* Readiness gate for SM_Arm(). Originally a pure STUB (always allowed
   arming); TWO real conditions are now populated: the external-enable
   interlock (SM_ExternalEnableOk(), 2026-09-16 -- ON by default as of
   2026-09-22, see this file's header comment) and every currently-
   enabled channel's ENA_OUT/CONTACT_OUT readiness
   (XrexIo_EnableOutputsReadyToArm(), 2026-09-17). "No fault active" was
   never a separate check to add -- IDLE and FAULT are already mutually
   exclusive states, so SM_Arm()'s own `g_state != SM_STATE_IDLE` guard
   covers it for free.

   Corrected 2026-09-23: NOT still an open TODO, as the comment used to
   claim -- see this function's own closing comment for what's actually
   still deliberately unchecked (gain sanity) and why, and why "profile
   timing configured" turned out not to be a real gap at all. */
static uint8_t ArmConditionsMet(void)
{
    if (SM_ExternalEnableOk() == 0U)
    {
        return 0U;
    }
    /* Enable/contactor output precondition, added 2026-09-17 -- per
       direct instruction, every currently-enabled channel's own
       ENA_OUT/CONTACT_OUT must both be commanded ON before ARM
       succeeds. Pure check, no side effects, gated per-channel inside
       XrexIo_EnableOutputsReadyToArm() itself -- see state_machine.h's
       own enable-output section for the full design. */
    if (XrexIo_EnableOutputsReadyToArm() == 0U)
    {
        return 0U;
    }
    /* Corrected 2026-09-23: the "TODO, populate the rest" this comment
       used to end with overstated what's actually still missing.
       Profile timing being unset is NOT a real gap here -- it's
       already independently, redundantly checked at the next gate
       (PID_ProfileStart(), pid.c, called from SM_Fire()/SHOT:STARt):
       ARM succeeding with no timing configured is harmless, since
       nothing electrical happens on ARM either way (see this
       function's own header comment) and firing still refuses until
       timing is actually set. The one item from the original TODO
       that's genuinely still open is per-channel gain sanity for
       closed-loop channels -- deliberately NOT implemented here: there
       is no universal "wrong" gain value for this check to enforce
       without real domain input on what's actually unsafe for THIS
       plant, so guessing a bound would be worse than not checking at
       all. Flagged, not guessed at. */
    return 1U;
}

/* Shared by SM_PollFaults() AND every SM_Report*Fault() -- the one
   place a fault is actually latched into the state machine, regardless
   of which source/call site noticed it. `channel` is meaningless for
   anything other than the PER-CHANNEL types (SM_FAULT_OVERCURRENT/
   SM_FAULT_ENABLE_OUTPUT/SM_FAULT_ENERPRO -- see SM_GetFaultChannel()'s
   own updated comment, 2026-09-18) -- pass 0xFF (SM_PollFaults()'s own
   call site does) when it doesn't apply, matching SM_GetFaultChannel()'s
   own "not applicable" sentinel. Extended 2026-09-15 to take `channel` --
   previously SM_FAULT_GENERAL was this function's only real caller. */
static void EnterFault(SM_FaultType_t type, uint8_t channel)
{
    if (g_faultBypassEnabled != 0U)
    {
        return;   /* DEBUG:FAULT:BYPASS active -- see g_faultBypassEnabled's
                      own comment above. Bail out before touching ANY
                      state -- every fault type funnels through here, so
                      this one check covers all of them uniformly. */
    }

    g_stateBeforeFault = g_state;   /* captured BEFORE transitioning --
                                        see this variable's own comment
                                        above for why the handlers need it */
    SetState(SM_STATE_FAULT);
    g_faultType    = type;
    g_faultChannel = channel;

    /* Telemetry event (telemetry.h) -- emitted as "!EVT ... FAULT ..." by
       the main loop. We are already inside the caller's Mcu_IrqDisable()
       critical section (SM_PollFaults()/SM_Report*Fault()), and PushEvent's
       own PRIMASK save/restore nests cleanly under it, so this stays a fixed
       few stores with no interrupt-enable side effects. */
    Telemetry_PushFault(type, channel);

    /* Legacy (pfm.c TABLE:STEP/FIRE) output path -- always safed here,
       regardless of fault type or which state pid.c's own state
       machine was in. This path is NOT part of the new IDLE/ARMED/
       FIRING/FAULT model at all (the legacy FIRE command never calls
       SM_Fire()), so it has no ramp-down concept to preserve -- an
       instant stop is correct for it either way. Idempotent/safe to
       call when nothing was running (matching HRTIM1_FaultClear()'s
       own established pattern). The CURRENT (pid.c SOURce:*) output
       path's own stop is now each fault type's OWN responsibility (see
       HandleGeneralFault()/HandleOvercurrentFault(), below) --
       General/Overcurrent Fault's whole point is NOT stopping it
       immediately here, but instead beginning a controlled ramp-down
       that keeps Master's counter running until it finishes.

       *** REAL BUG, FIXED 2026-09-15, confirmed on real hardware ***:
       this used to call the FULL PFM_ForceStop() unconditionally,
       EVERY time, before either handler even ran -- which stops the
       SAME shared HRTIM Master/channel counters a ramp-down needs to
       keep running (HRTIM1_PWM_Stop(), see PFM_ForceStopSoft()'s own
       extensive doc comment, pfm.h, for the full diagnostic). The
       comment directly above THIS one already said the point was "NOT
       stopping it immediately here" -- the code contradicted its own
       stated intent. Fixed: use the SOFT stop (no counter touch) when
       a ramp-down might actually begin (g_stateBeforeFault ==
       SM_STATE_FIRING, for EITHER fault type -- both handlers check
       this same condition before deciding to ramp vs. stop
       immediately); the FULL stop is still correct and unchanged for
       IDLE/ARMED (nothing was outputting, nothing needs the counters
       to keep running). */
    if (g_stateBeforeFault == SM_STATE_FIRING)
    {
        PFM_ForceStopSoft();
    }
    else
    {
        PFM_ForceStop();
    }

    switch (type)
    {
        case SM_FAULT_OVERCURRENT:
        case SM_FAULT_ENABLE_OUTPUT:   /* identical response to OVERCURRENT
                                            (immediate hard-disable of THIS
                                            channel, survivors derated 1/N
                                            and ramped) -- see
                                            state_machine.h's own
                                            SM_FAULT_ENABLE_OUTPUT header
                                            comment for why; only the
                                            reported TYPE differs, same
                                            "distinct type, shared
                                            response" pattern
                                            SM_FAULT_EXTERNAL_ENABLE uses
                                            for HandleGeneralFault() below */
        case SM_FAULT_ENERPRO:         /* RECLASSIFIED 2026-09-18 out of
                                            SM_FAULT_GENERAL -- see that
                                            enum value's own comment
                                            (state_machine.h) for the full
                                            reasoning (Transrex_Controls_
                                            Upgrade doc gives Enerpro the
                                            SAME response as Overcurrent,
                                            not Water/Temp's full stop) */
            HandleOvercurrentFault(channel);
            break;
        case SM_FAULT_GENERAL:
        case SM_FAULT_EXTERNAL_ENABLE:   /* identical response to GENERAL,
                                             see state_machine.h's own
                                             external-enable section for why --
                                             only the reported TYPE differs */
        case SM_FAULT_NONE:
        default:
            HandleGeneralFault();
            break;
    }
}

void SM_Init(void)
{
    SetState(SM_STATE_IDLE);
    g_faultType    = SM_FAULT_NONE;
    g_faultChannel = 0xFFU;
}

SM_State_t SM_GetState(void)
{
    return g_state;
}

SM_FaultType_t SM_GetFaultType(void)
{
    return (g_state == SM_STATE_FAULT) ? g_faultType : SM_FAULT_NONE;
}

uint8_t SM_GetFaultChannel(void)
{
    /* *** REAL BUG, FOUND AND FIXED 2026-09-18, confirmed on real
       hardware via run_simulator_validation.py's ena_contact scenario:
       STATE? was reporting "FAULT ENABLE_OUTPUT 256" (0xFF+1) instead
       of the real 1-based channel -- this function only ever returned
       g_faultChannel for SM_FAULT_OVERCURRENT, unconditionally 0xFF for
       every other type, even though SM_FAULT_ENABLE_OUTPUT (added
       2026-09-17) and now SM_FAULT_ENERPRO (2026-09-18) are BOTH
       per-channel fault types whose own STATE? branches (cmd_state.c)
       have always called this same getter expecting a real channel --
       this widening was simply never made when ENABLE_OUTPUT was added,
       and nothing had exercised a live ENABLE_OUTPUT fault's STATE?
       output against a real per-channel value until the simulator
       provided a clean (non-floating-pin) bench to test it on. */
    SM_FaultType_t type = SM_GetFaultType();
    return ((type == SM_FAULT_OVERCURRENT) || (type == SM_FAULT_ENABLE_OUTPUT) ||
            (type == SM_FAULT_ENERPRO)) ? g_faultChannel : 0xFFU;
}

uint8_t SM_Arm(void)
{
    if (g_state != SM_STATE_IDLE)
    {
        return 0U;
    }
    if (ArmConditionsMet() == 0U)
    {
        return 0U;
    }

    SetState(SM_STATE_ARMED);

    /* External trigger's edge-detection baseline, added 2026-09-16 --
       captured fresh here regardless of whether the trigger feature is
       even on right now (cheap, and avoids a stale value if it gets
       turned on later while already ARMED) -- see the external-trigger
       design comment (state_machine.h) for why arm-time capture
       matters: a signal already HIGH at the moment of arming must NOT
       look like a rising edge on the next poll. Reads PF15 via
       ExternalTriggerInputIsHigh() -- MOVED 2026-09-17 off
       ExternalEnableInputIsHigh() (now PF13) now that trigger and
       enable are separate pins. */
    g_lastExternalTriggerLevelWhileArmed = ExternalTriggerInputIsHigh();

    Telemetry_PushState(SM_STATE_ARMED);

    return 1U;
}

void SM_Disarm(void)
{
    if (g_state == SM_STATE_ARMED)
    {
        SetState(SM_STATE_IDLE);
        Telemetry_PushState(SM_STATE_IDLE);
    }
}

uint8_t SM_Fire(void)
{
    if (g_state != SM_STATE_ARMED)
    {
        return 0U;
    }

    /* Redundant last-line-of-defense re-check, 2026-09-16 -- the
       command layer (cmd_shot_start(), cmd_shot.c) already
       checks SM_ExternalEnableOk() itself first, for a precise error
       message; this catches PF13 (the enable pin, MOVED here 2026-09-17
       from PF15) dropping in the narrow window between that check and
       this call, or any future caller that reaches SM_Fire() directly
       without going through that command handler -- including the
       external-trigger feature's own direct SM_Fire() call, below.
       Returns the same generic 0 as the PID_ProfileStart() failure
       below -- the command layer's own upfront check is what's
       responsible for distinguishing the two reasons for an operator,
       not this function. */
    if (SM_ExternalEnableOk() == 0U)
    {
        return 0U;   /* stays ARMED */
    }

    if (PID_ProfileStart() == 0U)
    {
        return 0U;   /* stays ARMED -- e.g. profile timing never set */
    }

    SetState(SM_STATE_FIRING);
    Telemetry_PushState(SM_STATE_FIRING);
    return 1U;
}

/* ARMED -> FIRING for the PLAIN (non-profile) start path -- added
   2026-09-21 alongside gating SOURce:RUN behind ARM. Same shape as
   SM_Fire() above, but calls PID_Start() (the open-ended, non-profile
   loop -- no shot clock, no auto-completion) instead of
   PID_ProfileStart(). SOURce:STOP (SM_Stop(), below) is what brings it
   back to IDLE. Kept a separate entry point rather than overloading
   SM_Fire() with a mode flag because the two call different pid.c start
   functions and have different completion semantics. */
uint8_t SM_StartPlain(void)
{
    if (g_state != SM_STATE_ARMED)
    {
        return 0U;
    }

    /* Same redundant last-line-of-defense re-check as SM_Fire(): the
       command layer checks this first for a precise error message; this
       catches any future caller that reaches here directly. */
    if (SM_ExternalEnableOk() == 0U)
    {
        return 0U;   /* stays ARMED */
    }

    PID_Start();   /* always succeeds or is already running (idempotent) */
    SetState(SM_STATE_FIRING);
    Telemetry_PushState(SM_STATE_FIRING);
    return 1U;
}

void SM_Stop(void)
{
    /* Deliberately does NOT touch FAULT -- see this function's own
       doc comment in state_machine.h. */
    if ((g_state == SM_STATE_ARMED) || (g_state == SM_STATE_FIRING))
    {
        SetState(SM_STATE_IDLE);
        Telemetry_PushState(SM_STATE_IDLE);
    }
}

void SM_NotifyShotComplete(void)
{
    if (g_state == SM_STATE_FIRING)
    {
        SetState(SM_STATE_IDLE);
        Telemetry_PushState(SM_STATE_IDLE);
    }
}

void SM_PollFaults(void)
{
    /* Critical section: this function runs from BOTH the main loop
       (background context) and PID_Update() (HRTIM1_Master_IRQn, priority
       1, which can preempt the main loop at any instruction). Without a
       guard, the main loop could read g_state (not yet FAULT), get
       preempted right there by the ISR's own call to this function
       completing EnterFault() first (possibly starting a General-Fault
       ramp-down), and then resume and -- since its OWN check already
       passed, before preemption -- call EnterFault() a second, redundant
       time. That second call would see g_stateBeforeFault == SM_STATE_FAULT
       (not SM_STATE_FIRING, since the first legitimate call already
       transitioned it) and take HandleGeneralFault()'s "else" branch,
       calling PID_Stop() immediately and silently replacing the just-
       started graceful ramp-down with an abrupt cutoff. That outcome was
       initially (wrongly) judged "safety-neutral" here -- corrected
       directly: the whole point of a linear ramp instead of an instant
       stop is to avoid inductive/mechanical stress, so silently
       substituting the abrupt path IS the hazard, not a neutral one.

       Mcu_IrqDisable()/Mcu_IrqEnable() (mcu.h) is this codebase's own established
       critical-section pattern (see boot_jump.c). Wrapping the
       entire read-check-transition sequence -- including EnterFault()
       itself -- makes the double-entry race structurally impossible
       rather than merely unlikely: whichever context (main loop or ISR)
       gets here first now runs this whole function to completion before
       the other context's own call can even read g_state. EnterFault()'s
       own work (PFM_ForceStop(), the fault-type dispatch,
       PID_BeginFaultRampDown()) is all fast, non-blocking register/flag
       writes with no dependency on any interrupt firing to complete, so
       it's safe to run with IRQs globally disabled. Calling this from
       inside an ISR (the PID_Update() call site) is fine too --
       __disable_irq() while already inside an ISR is idempotent for the
       brief window this takes, same as boot_jump.c's own unconditional
       use without special-casing ISR vs. main context. */
    Mcu_IrqDisable();

    /* Record every system-wide fault that is present, even when the state
       machine is already in FAULT for another reason (STATE? lists them all).
       A bypassed run records none. */
    if (g_faultBypassEnabled == 0U)
    {
        if (HRTIM1_FaultIsTripped() != 0U)
        {
            g_faultMask |= FM_PC10;
        }
        const uint8_t wasFiring = (g_state == SM_STATE_FIRING) ||
                                  ((g_state == SM_STATE_FAULT) && (g_stateBeforeFault == SM_STATE_FIRING));
        if ((g_externalEnableRequired != 0U) && (wasFiring != 0U) &&
            (ExternalEnableInputIsHigh() == 0U))
        {
            g_faultMask |= FM_EXT_ENABLE;
        }
    }

    if (g_state == SM_STATE_FAULT)
    {
        Mcu_IrqEnable();
        return;   /* already latched -- nothing new to do */
    }

    /* Both existing sources route to SM_FAULT_GENERAL unconditionally
       today -- see state_machine.h's own "NOTE TO REVISIT" comment on
       why, and this function's own header comment for the two call
       sites (main loop + PID_Update()) this reaches from. */
    if ((HRTIM1_FaultIsTripped() != 0U) || (GateDriver_FaultIsLatched() != 0U))
    {
        EnterFault(SM_FAULT_GENERAL, 0xFFU);   /* channel N/A for a system-wide fault */
    }
    /* External-enable interlock (PF13, MOVED 2026-09-17 from PF15),
       added 2026-09-16 -- deliberately gated on SM_STATE_FIRING
       specifically, not IDLE/ARMED too. See state_machine.h's own
       external-enable section for the full reasoning (this is the ONLY
       continuous-monitoring gate point for this interlock; ARM/
       SHOT:STARt cover IDLE/ARMED via their own one-shot checks
       instead). g_state re-read fresh here (not cached from above) so
       this naturally doesn't double-enter if the GENERAL check above
       already transitioned to FAULT this same call. */
    else if ((g_externalEnableRequired != 0U) && (g_state == SM_STATE_FIRING) &&
             (ExternalEnableInputIsHigh() == 0U))
    {
        EnterFault(SM_FAULT_EXTERNAL_ENABLE, 0xFFU);   /* channel N/A, system-wide */
    }

    /* External trigger (PF15), added 2026-09-16 -- see state_machine.h's
       own design comment for the full reasoning. Independent of the
       fault checks above (mutually exclusive in practice: this only
       ever looks at SM_STATE_ARMED, which neither fault branch above
       can leave g_state in). SM_Fire()'s own return value is
       deliberately ignored here -- if it fails (e.g. profile timing
       never set, or the enable interlock -- now PF13 -- isn't
       currently satisfied; SM_Fire() itself still unconditionally
       re-checks SM_ExternalEnableOk() regardless of how trigger got
       turned on, see this file's own SM_Fire() comment), the state
       simply stays ARMED with the baseline now recording HIGH, so this
       genuinely is edge-triggered (needs a fresh falling-then-rising
       transition to try again), not level-triggered (which would
       otherwise retry every single poll for as long as PF15 stayed
       HIGH). Reads ExternalTriggerInputIsHigh() (PF15) -- MOVED
       2026-09-17 off ExternalEnableInputIsHigh() (now PF13), same day
       enable and trigger split onto separate pins. */
    if ((g_externalTriggerRequired != 0U) && (g_state == SM_STATE_ARMED))
    {
        uint8_t level = ExternalTriggerInputIsHigh();
        if ((g_lastExternalTriggerLevelWhileArmed == 0U) && (level != 0U))
        {
            /* Rising edge on PF15 -> fire. Report it over serial so the
               operator can tell a trigger-initiated shot apart from a
               command-initiated one: SM_Fire() already emits
               "!EVT ... STATE FIRING"; this adds the "cause" annotation
               ("!EVT ... TRIGGER FIRING") only when the fire actually
               succeeded (a trigger while not ready / profile timing
               unset stays silent, exactly like a failed SHOT:STARt). */
            if (SM_Fire() != 0U)
            {
                Telemetry_PushTrigger();
            }
        }
        g_lastExternalTriggerLevelWhileArmed = level;
    }

    Mcu_IrqEnable();
}

void SM_ReportOcpFault(uint8_t channel)
{
    if (channel >= HRTIM_NUM_CHANNELS)
    {
        return;   /* defensive -- a real, correctly-wired caller never
                      produces this */
    }

    /* Same critical-section reasoning as SM_PollFaults() above -- see
       that function's own extensive comment. This can eventually be
       called from an ISR (a real OCP pin's EXTI handler, once wired up)
       just like GateDriver_CheckFault() already is, and needs the same
       protection against the same main-loop/ISR race SM_PollFaults()
       itself was fixed for. */
    Mcu_IrqDisable();
    g_faultMask |= (g_faultBypassEnabled == 0U) ? FM_OCP(channel) : 0UL;

    if (g_state == SM_STATE_FAULT)
    {
        /* Already faulted (either type) -- see this header's own "ALSO
           NOTE TO REVISIT" comment (state_machine.h) on why the full
           redistribute-and-ramp sequence does NOT re-run here. Still
           always hard-disables THIS channel's own output unconditionally
           -- cheap, safe, and a real OCP condition must never be left
           connected just because some other channel's fault got here
           first. */
        (void)PID_SetChannelEnable(channel, 0U);
        Mcu_IrqEnable();
        return;
    }

    EnterFault(SM_FAULT_OVERCURRENT, channel);
    Mcu_IrqEnable();
}

void SM_ReportEnableOutputFault(uint8_t channel)
{
    if (channel >= HRTIM_NUM_CHANNELS)
    {
        return;   /* defensive -- a real, correctly-wired caller never
                      produces this */
    }

    /* Same critical-section reasoning as SM_ReportOcpFault() just above --
       this is called from XrexIo_PollEnableOutputFaults() (xrex_io.c) at
       the same tick cadence OCP polling gets, so it needs the same
       protection against the same main-loop/PID_Update()-tick race. */
    Mcu_IrqDisable();
    g_faultMask |= (g_faultBypassEnabled == 0U) ? FM_ENABLE_OUT(channel) : 0UL;

    if (g_state == SM_STATE_FAULT)
    {
        /* Already faulted (any type) -- same reasoning as
           SM_ReportOcpFault() above: a channel with its own
           ENA_OUT/CONTACT_OUT no longer both HIGH must never be left
           connected just because some other channel's (or this same
           channel's own, via a different fault type) condition got here
           first. */
        (void)PID_SetChannelEnable(channel, 0U);
        Mcu_IrqEnable();
        return;
    }

    EnterFault(SM_FAULT_ENABLE_OUTPUT, channel);
    Mcu_IrqEnable();
}

void SM_ReportEnerproFault(uint8_t channel)
{
    if (channel >= HRTIM_NUM_CHANNELS)
    {
        return;   /* defensive -- a real, correctly-wired caller never
                      produces this */
    }

    /* Same critical-section reasoning as SM_ReportOcpFault()/
       SM_ReportEnableOutputFault() above -- this is called from
       xrex_io.c's XrexIo_PollEnerproFaults(), itself called from
       gate_driver.c's GateDriver_CheckFault() in EXTI ISR context, so it
       needs the same protection against a main-loop/ISR race. */
    Mcu_IrqDisable();
    g_faultMask |= (g_faultBypassEnabled == 0U) ? FM_ENERPRO(channel) : 0UL;

    if (g_state == SM_STATE_FAULT)
    {
        /* Already faulted (any type) -- same reasoning as
           SM_ReportOcpFault() above: a channel with a real Enerpro
           condition must never be left connected just because some
           other channel's (or this same channel's own, via a different
           fault type) condition got here first. */
        (void)PID_SetChannelEnable(channel, 0U);
        Mcu_IrqEnable();
        return;
    }

    EnterFault(SM_FAULT_ENERPRO, channel);
    Mcu_IrqEnable();
}

void SM_ReportGeneralFault(void)
{
    /* Same critical-section reasoning as SM_PollFaults()/SM_ReportOcpFault()
       above -- see SM_PollFaults()'s own extensive comment. */
    Mcu_IrqDisable();
    g_faultMask |= (g_faultBypassEnabled == 0U) ? FM_TEST : 0UL;

    if (g_state == SM_STATE_FAULT)
    {
        /* Already faulted -- matches SM_PollFaults()'s own "already
           latched -- nothing new to do" behavior. Unlike
           SM_ReportOcpFault(), there is no per-channel action to take
           here even redundantly -- General Fault has no specific
           channel target. */
        Mcu_IrqEnable();
        return;
    }

    EnterFault(SM_FAULT_GENERAL, 0xFFU);   /* channel N/A for a system-wide fault,
                                                same sentinel SM_PollFaults() uses */
    Mcu_IrqEnable();
}

uint8_t SM_ClearFault(void)
{
    if (g_state != SM_STATE_FAULT)
    {
        return 0U;   /* nothing to clear */
    }

    /* Unconditionally calls PID_Stop() (added 2026-09-13, alongside the
       General-Fault ramp-down): a General/Overcurrent Fault caught
       while FIRING leaves g_running deliberately 1 -- and possibly a
       ramp-down actively in progress -- for as long as
       PID_BeginFaultRampDown()'s own ramp hasn't finished yet (see
       pid.c). Called FIRST, before either FaultClear() below, so the
       shared HRTIM hardware is already fully, unconditionally stopped
       (PID_Stop() -> HRTIM1_PWM_Stop()) by the time they run -- clearing
       a fault mid-ramp is an immediate hard stop, not a resumed ramp.
       Without this call, pid.c's own g_running/g_faultRampActive
       bookkeeping would be left stale (g_running still 1 with nothing
       actually running), which is exactly the 2026-09-11 bug
       (docs/changelog.txt) all over again if left unfixed. Idempotent/
       harmless if the ramp had already finished normally (PID_Stop()
       would have already been called then, by pid.c itself). */
    PID_Stop();

    /* *** REAL BUG, FIXED 2026-09-15 *** -- this function's own
       long-standing comment (now corrected) claimed
       "HRTIM1_FaultClear()/GateDriver_FaultClear() above already
       force-stop HRTIM unconditionally," but neither was EVER actually
       called anywhere in this codebase -- confirmed by a full search,
       not an assumption. Concretely: GateDriver_FaultClear() is the
       ONLY thing that ever resets g_gdsFaultLatched back to 0
       (gate_driver.c); since nothing called it, a GateDriverStatus-
       triggered fault could NEVER actually be cleared via FAULT:CLEAR
       -- GateDriver_FaultIsLatched() below would stay 1 forever,
       forcing a full power cycle to recover from ANY such fault. PC10/
       HRTIM1_FLT6 is likely equally affected (HRTIM fault flags latch
       in hardware until explicitly cleared). Found while investigating
       the separate frozen-ramp bug above (PFM_ForceStopSoft(), pfm.h)
       -- unrelated root cause, same area, real enough to fix alongside
       it rather than leave for later now that it's found. Both
       re-validate their own source before truly clearing (see their
       own doc comments in hrtim.h/gate_driver.h) -- a condition that's
       still physically present re-latches before either call even
       returns, which is exactly what the re-check right below now
       genuinely observes, instead of unconditionally seeing the same
       stale "still latched" state every time. */
    HRTIM1_FaultClear();
    GateDriver_FaultClear();

    /* DEBUG:FAULT:BYPASS extension, 2026-09-24, direct request: with
       the bypass ON, FAULT:CLEAR no longer refuses because the fault's
       physical cause is still present -- the whole point of the bypass
       is to keep operating with a fault measured. The re-validation
       below is skipped entirely (SM_ExternalEnableOk() also returns 1
       under bypass, see its own comment). NOTE this cannot override the
       HRTIM's own PC10/FLT6 silicon-level output gating -- a physically
       tripped PC10 still holds the outputs safe in hardware regardless
       of what this state machine believes. */
    if (g_faultBypassEnabled == 0U)
    {
        if ((HRTIM1_FaultIsTripped() != 0U) || (GateDriver_FaultIsLatched() != 0U))
        {
            return 0U;   /* still faulted -- stays in SM_STATE_FAULT */
        }
        /* External-enable interlock, added 2026-09-16 -- same "only clear
           if the condition is actually gone" philosophy as the two checks
           just above. Only actually gates anything when the interlock is
           turned on -- SM_ExternalEnableOk() itself already returns 1
           unconditionally when g_externalEnableRequired is 0, so this is a
           no-op re-check (never blocks clearing) whenever the feature
           isn't in use. */
        if (SM_ExternalEnableOk() == 0U)
        {
            return 0U;   /* still faulted -- stays in SM_STATE_FAULT */
        }
    }

    SetState(SM_STATE_IDLE);
    g_faultType    = SM_FAULT_NONE;
    g_faultChannel = 0xFFU;
    Mcu_IrqDisable();
    g_faultMask = 0UL;   /* only after the checks above passed: a fault still present stays listed */
    Mcu_IrqEnable();
    Telemetry_PushFaultClear();
    return 1U;
}

void SM_SetExternalEnableRequired(uint8_t required)
{
    /* UNCOUPLED from g_externalTriggerRequired 2026-09-17, same day
       enable (PF13) and trigger (PF15) split onto separate pins -- see
       g_externalTriggerRequired's own comment above for why the old
       "turning this off forces trigger off too" rule no longer applies
       now that they're independent physical signals. */
    g_externalEnableRequired = (required != 0U) ? 1U : 0U;
}

uint8_t SM_GetExternalEnableRequired(void)
{
    return g_externalEnableRequired;
}

uint8_t SM_ExternalEnableOk(void)
{
    if (g_externalEnableRequired == 0U)
    {
        return 1U;   /* interlock not in use -- always "ok" */
    }
    if (g_faultBypassEnabled != 0U)
    {
        return 1U;   /* DEBUG:FAULT:BYPASS (2026-09-24 extension): a low
                        PF13 is treated like any other fault, so it must
                        not block ARM/fire either -- this one function is
                        every ARM/fire/clear gate's shared check. */
    }
    return ExternalEnableInputIsHigh();
}

uint8_t SM_GetExternalEnableInputRaw(void)
{
    return ExternalEnableInputIsHigh();
}

uint8_t SM_SetExternalTriggerRequired(uint8_t required)
{
    /* No longer gated on g_externalEnableRequired -- UNCOUPLED
       2026-09-17, per direct instruction, now that enable (PF13) and
       trigger (PF15) are separate pins. Always succeeds now; kept a
       uint8_t return (rather than void) purely so the command layer
       (cmd_ext_trigger(), cmd_io.c) doesn't need its own signature
       change for what's now an unconditional operation. */
    g_externalTriggerRequired = (required != 0U) ? 1U : 0U;
    return 1U;
}

uint8_t SM_GetExternalTriggerRequired(void)
{
    return g_externalTriggerRequired;
}

uint8_t SM_GetExternalTriggerInputRaw(void)
{
    return ExternalTriggerInputIsHigh();
}
