everettpenne/WHAM-CONTROLLERS/firmware/xrex/src/app/control/state_machine.h

#ifndef __STATE_MACHINE_H__
#define __STATE_MACHINE_H__

#ifdef __cplusplus
extern "C" {
#endif

#include <stdint.h>

/* --------------------------------------------------------------------------
 * state_machine.c
 *
 * Added 2026-09-13, per direct request: an explicit top-level
 * operating-state machine for this controller, sitting above pid.c
 * (the control loop) / hrtim.c (the hardware) / gate_driver.c (one
 * fault source) / pfm.c (the legacy table-based output path) -- the
 * thing that ties them together into one coherent "what is this
 * controller doing right now" answer, queryable over the wire
 * (STATE?) and enforced at the command layer (SHOT:STARt now
 * refuses to do anything unless the machine is actually ARMED).
 *
 * FOUR STATES:
 *
 *   IDLE    -- the normal state: entered at boot (SM_Init()), and
 *              returned to after a shot completes (SM_NotifyShotComplete(),
 *              called by pid.c) or a fault is cleared (SM_ClearFault()).
 *              Every HRTIM channel output is disabled in this state --
 *              nothing outputs a PFM waveform. Also reachable from
 *              ARMED/FIRING via SM_Stop() (an operator abort, SOURce:STOP)
 *              or SM_Disarm() (stand down without firing).
 *
 *   ARMED   -- a readiness gate between IDLE and FIRING, added per
 *              direct request/design discussion (2026-09-13): outputs
 *              are still disabled here, exactly like IDLE -- nothing
 *              electrical changes on entry. What ARMED buys is a
 *              deliberate, separately-confirmable "ready to fire" step
 *              before any real output begins, gated by
 *              ArmConditionsMet() (corrected 2026-09-23 -- no longer a
 *              pure stub, see its own comment for exactly what's
 *              checked and what's deliberately still not). Entered
 *              via SM_Arm() (the `ARM` command); left via SM_Fire()
 *              (`SHOT:STARt`, which only succeeds from here) or
 *              SM_Disarm() (`DISARM`, stand down) or SM_Stop()
 *              (`SOURce:STOP`, abort).
 *
 *   FIRING  -- entered only from ARMED, via SM_Fire(). Every currently-
 *              ENABLED channel (SOURce:ENAble -- a separate,
 *              already-existing per-channel concern, orthogonal to
 *              this system-wide state) gets its HRTIM output connected
 *              and begins the programmed ramp profile
 *              (PID_ProfileStart(), pid.c, unchanged). Returns to IDLE
 *              automatically when the shot completes
 *              (SM_NotifyShotComplete(), called from PID_Update()'s
 *              own existing shot-completion check), or on a manual
 *              SM_Stop() (`SOURce:STOP`) abort.
 *
 *   FAULT   -- entered from ANY other state the instant a fault
 *              condition is detected (SM_PollFaults(), see its own
 *              comment for exactly when this runs) -- per direct
 *              instruction, "no matter which state the supply is in".
 *              Always stops the legacy (pfm.c TABLE:STEP/FIRE) output
 *              path immediately, unconditionally (it isn't part of
 *              this state machine at all -- the legacy FIRE command
 *              never calls SM_Fire() -- so it has no ramp-down concept
 *              to preserve). The CURRENT (pid.c SOURce:*) output path's
 *              own stop is each fault type's OWN responsibility -- see
 *              the two handlers below, only one of which is still a
 *              pure stub. Left only via SM_ClearFault() (`FAULT:CLEAR`,
 *              existing command, extended) -- always back to IDLE,
 *              never directly to ARMED/FIRING; a fresh
 *              ARM+SHOT:STARt is always required after any
 *              fault.
 *
 * TWO FAULT TYPES:
 *
 *   SM_FAULT_GENERAL       -- HandleGeneralFault() (state_machine.c).
 *                              POPULATED 2026-09-13, per direct
 *                              instruction: if the fault hit while
 *                              FIRING, every channel that was actively
 *                              outputting immediately begins an
 *                              OPEN-LOOP linear ramp-down to
 *                              PFM_TURNON_FREQ_HZ (0A) -- no PID/
 *                              feedback correction at all -- over
 *                              FAULT_RAMP_DOWN_TIME_S (ctrlr_config.h)
 *                              seconds, from wherever it actually was
 *                              in its own shot profile (see
 *                              PID_BeginFaultRampDown()/
 *                              ProcessFaultRampDown(), pid.c). Once
 *                              every participating channel reaches the
 *                              floor, its output is disconnected
 *                              (PID_Stop(), unconditional across every
 *                              channel) and the controller settles
 *                              into FAULT to wait for FAULT:CLEAR. If
 *                              the fault hit while IDLE/ARMED (nothing
 *                              was actually outputting), stops
 *                              immediately instead -- nothing to ramp.
 *   SM_FAULT_OVERCURRENT   -- HandleOvercurrentFault() (state_machine.c).
 *                              POPULATED 2026-09-15, per direct
 *                              instruction: unlike General Fault above,
 *                              this is a PER-CHANNEL condition, reported
 *                              for exactly one channel at a time via the
 *                              new SM_ReportOcpFault(channel) (below),
 *                              not detected by SM_PollFaults(). That
 *                              channel's own HRTIM output is disabled
 *                              IMMEDIATELY -- no ramp for it at all, the
 *                              opposite of General Fault's treatment of
 *                              every channel -- while every OTHER
 *                              currently-enabled channel is stepped down
 *                              by (100 * 1/N)% of its own current output
 *                              (N = channels enabled at the fault
 *                              instant, the faulted one included), THEN
 *                              ramps on down to PFM_TURNON_FREQ_HZ over
 *                              FAULT_RAMP_DOWN_TIME_S exactly like
 *                              General Fault -- see PID_BeginOvercurrentRampDown()'s
 *                              own extensive doc comment (pid.h) for the
 *                              full 3-step mechanism. The (100*1/N)% step
 *                              itself deliberately BYPASSES the hard
 *                              slew-rate clamp used by every other output
 *                              write in this codebase (decided 2026-09-15
 *                              after real DSLogic data showed the clamped
 *                              version never actually reached the literal
 *                              percentage) -- see ClampOutputRangeOnly()'s
 *                              comment in pid.c for the full justification.
 *                              If the fault hit while IDLE/ARMED, or the faulted
 *                              channel was the only one enabled, falls
 *                              through to the same "nothing to ramp, stop
 *                              immediately" handling General Fault
 *                              already has.
 *
 *   SM_FAULT_EXTERNAL_ENABLE -- ADDED 2026-09-16, per direct request: a
 *                              real, physical operator/facility
 *                              permissive signal -- PF13 as of
 *                              2026-09-17 (MOVED off PF15,
 *                              "Fiber_Enable", the same day PF15 became
 *                              trigger-only -- see the external-enable
 *                              section further down this file), not a
 *                              hardware fault condition in the
 *                              PC10/GateDriverStatus sense. System-wide,
 *                              same shape as General Fault -- reuses
 *                              HandleGeneralFault() directly (EnterFault()'s
 *                              switch) for an IDENTICAL open-loop
 *                              ramp-down response, reported as its own
 *                              distinct type purely so an operator can
 *                              tell "the interlock dropped" apart from
 *                              "a real HRTIM/gate-driver fault" via
 *                              STATE?. See the external-enable section further
 *                              down this file for the full design
 *                              (opt-in, ARM/SHOT:STARt gating,
 *                              FIRING-only continuous monitoring,
 *                              FAULT:CLEAR re-validation, the deliberate
 *                              GPIO_PULLDOWN fail-safe choice).
 *
 *   SM_FAULT_EMERGENCY_STOP  -- REMOVED 2026-09-21. The emergency-stop
 *                              feature (a PG10 fiber-optic input with an
 *                              immediate, unconditional hard cutoff) was
 *                              removed after PG10 was discovered to be
 *                              electrically tied to NRST (this MCU's
 *                              real reset pin, not a usable GPIO -- see
 *                              board_io.c's BoardIo_Init() comment and
 *                              docs/changelog.txt's 2026-09-17/09-21
 *                              entries). A future E-stop must use a
 *                              genuinely free input pin and should
 *                              re-settle the fail-safe polarity
 *                              question afresh against that pin's real
 *                              idle level.
 *
 *   SM_FAULT_ENABLE_OUTPUT   -- ADDED 2026-09-17, per direct request: each
 *                              Transrex channel's own ENA_OUT/CONTACT_OUT
 *                              fiber OUTPUTS (PG0-PG3/PG4-PG7 --
 *                              XR1-XR4_ENA_OUT/_CONTACT_OUT,
 *                              docs/pin_mapping_v4.csv's "XREX Pin Name"
 *                              column) must both be commanded ON before
 *                              `ARM` will succeed for that channel, and
 *                              staying ON is continuously required once
 *                              ARMED (not just while FIRING -- a
 *                              deliberately WIDER window than
 *                              SM_FAULT_EXTERNAL_ENABLE's FIRING-only
 *                              carve-out above, confirmed directly by the
 *                              user). PER-CHANNEL, unlike
 *                              SM_FAULT_EXTERNAL_ENABLE (system-wide,
 *                              single PF13 signal) -- only
 *                              currently-enabled channels
 *                              (`PID_GetChannelEnable()`) are checked,
 *                              matching the same per-channel-gating
 *                              philosophy already established for
 *                              Water/Temp/Enerpro/OCP (xrex_io.h). NOT
 *                              a hardware-read fault like those, though
 *                              -- ENA_OUT/CONTACT_OUT are OUTPUTS this
 *                              firmware itself drives via
 *                              `XREX:CHANnel:ENAOut`/`CONTactOut`
 *                              (cmd_io.c); this fault type exists
 *                              because an operator could set one, then
 *                              clear it again, while a channel is
 *                              already ARMED/FIRING.
 *
 *                              Reuses HandleOvercurrentFault(channel)
 *                              DIRECTLY for its response (EnterFault()'s
 *                              switch) -- immediate hard-disable of the
 *                              affected channel, survivors derated
 *                              1/N and ramped down exactly like a real
 *                              OCP fault -- reported as its own DISTINCT
 *                              type purely for `STATE?` diagnostics
 *                              (same "distinct type, shared response"
 *                              pattern SM_FAULT_EXTERNAL_ENABLE already
 *                              established for HandleGeneralFault()).
 *                              Do not confuse the NAME with
 *                              SM_FAULT_EXTERNAL_ENABLE -- that is a
 *                              single, system-wide INPUT interlock
 *                              (PF13, an operator/facility permissive
 *                              this firmware reads); this is a
 *                              PER-CHANNEL check of this firmware's OWN
 *                              commanded OUTPUT state. See the
 *                              enable-output section further down this
 *                              file for the full design
 *                              (`XrexIo_EnableOutputsReadyToArm()`,
 *                              `XrexIo_PollEnableOutputFaults()`,
 *                              `SM_ReportEnableOutputFault()`).
 *
 * *** NOTE TO REVISIT, RESOLVED 2026-09-17 *** -- originally: "we will
 * define the mapping here at a later time" for SM_ReportOcpFault(channel)'s
 * real hardware trigger. Now real: XrexIo_PollOcpFaults() (xrex_io.h/.c)
 * polls PF4/PF5/PF8/PF12 (per-channel, per-channel-gated) every
 * PID_Update() tick and once at boot, calling SM_ReportOcpFault(channel)
 * on a real fault -- no EXTI (a real SYSCFG_EXTICR line-sharing conflict
 * with the existing GateDriverStatus EXTI setup ruled that out, see
 * xrex_io.h's own header comment). Water/Temp/Enerpro (the existing
 * GateDriverStatus_01..12 EXTI source) still route to SM_FAULT_GENERAL,
 * per-channel-gated the same way via XrexIo_EvaluateGateDriverFault() --
 * see docs/command_reference.md's XREX:CHANnel:STATus? section for the
 * full architecture.
 *
 * ALSO NOTE TO REVISIT, added 2026-09-15: SM_ReportOcpFault() called a
 * SECOND time (a different channel) while already in SM_STATE_FAULT
 * (from either fault type) does NOT re-run the redistribute-and-ramp
 * sequence -- that only makes sense once, at the instant a fault is
 * first detected (it captures a fresh N and a fresh ramp-start snapshot
 * for whichever channels are still enabled at THAT moment). A second
 * report still ALWAYS immediately hard-disables its own channel
 * unconditionally (a real OCP condition must never be left connected
 * just because some other channel's fault got there first) -- but true
 * simultaneous/overlapping multi-channel OCP, and whether the survivors'
 * ramp should be recomputed mid-flight for a newly-reduced N, is
 * genuinely unresolved. The single-channel case this was actually
 * specified for (direct instruction: "channel 1's OCP fault pin") is
 * fully and correctly handled either way.
 *
 * ALSO NOTE TO REVISIT, PARTIALLY RESOLVED: SM_Arm()'s ArmConditionsMet()
 * is no longer a pure stub -- it now checks the external-enable interlock
 * (SM_ExternalEnableOk(), 2026-09-16) and the enable-output/contactor-
 * output precondition (XrexIo_EnableOutputsReadyToArm(), 2026-09-17, see
 * this file's own enable-output section further down). Still no gain-
 * sanity or other interlock logic beyond those two. AND:
 * FAULT_RAMP_DOWN_TIME_S (ctrlr_config.h, currently 1.0s) is a first
 * guess, not derived from any real Transrex/magnet requirement -- see
 * that macro's own comment.
 *
 * FIXED 2026-09-13 (same day, later still): g_state is read/written from
 * BOTH the main loop (app.c) AND PID_Update() (HRTIM1_Master_IRQn, priority
 * 1 -- can preempt the main loop at any instruction). This used to be a
 * genuine race: the main loop could read g_state (not yet FAULT), get
 * preempted by Master's own regular tick right there, that ISR's own
 * SM_PollFaults() call would detect the same real fault and complete
 * EnterFault() first (possibly starting a General-Fault ramp-down), and
 * THEN the main loop would resume and -- since ITS OWN check already
 * passed, before preemption -- call EnterFault() a second, redundant
 * time, which would see g_stateBeforeFault == SM_STATE_FAULT (not
 * SM_STATE_FIRING) and call PID_Stop() immediately, silently replacing
 * a just-started graceful ramp-down with an abrupt cutoff. This was
 * first (wrongly) judged "safety-neutral" here on the theory that the
 * physical end state ("output off") was unchanged either way -- direct
 * correction: the whole point of a linear ramp instead of an instant
 * stop is to avoid inductive/mechanical stress, so silently substituting
 * the abrupt path for the graceful one IS the hazard, not a neutral
 * outcome. Fixed properly, not just documented: SM_PollFaults() (.c)
 * now wraps its entire read-check-transition sequence -- including the
 * EnterFault() call itself -- in __disable_irq()/__enable_irq() (this
 * codebase's own established critical-section pattern, see boot_jump.c),
 * so whichever context (main loop or ISR) gets there first now runs the
 * whole check-and-transition to completion before the other context's
 * own call can even read g_state. This makes the double-entry race
 * structurally impossible, not merely unlikely -- see SM_PollFaults()'s
 * own comment in state_machine.c for the full reasoning.
 * -------------------------------------------------------------------------- */

typedef enum
{
    SM_STATE_IDLE = 0,
    SM_STATE_ARMED,
    SM_STATE_FIRING,
    SM_STATE_FAULT
} SM_State_t;

typedef enum
{
    SM_FAULT_NONE = 0,     /* meaningful only via SM_GetFaultType() when
                               SM_GetState() != SM_STATE_FAULT */
    SM_FAULT_GENERAL,
    SM_FAULT_OVERCURRENT,
    SM_FAULT_EXTERNAL_ENABLE,  /* added 2026-09-16 -- see the external-enable
                                   section below and this file's own
                                   header comment for the full design */
    SM_FAULT_ENABLE_OUTPUT,    /* added 2026-09-17 -- see the enable-output
                                   section below and this file's own
                                   header comment for the full design.
                                   PER-CHANNEL (like SM_FAULT_OVERCURRENT) --
                                   NOT the same thing as
                                   SM_FAULT_EXTERNAL_ENABLE (system-wide,
                                   a different signal entirely) */
    SM_FAULT_ENERPRO           /* added 2026-09-18 -- RECLASSIFIED out of
                                   SM_FAULT_GENERAL, per direct correction
                                   against docs/Transrex/Transrex_Controls_
                                   Upgrade (1).pdf's own fault table: that
                                   document gives Enerpro faults the SAME
                                   response as Overcurrent (reduce
                                   surviving channels' DEMAND, keep
                                   running), NOT Water/Temp's full-stop
                                   response -- the ORIGINAL 2026-09-17
                                   instruction ("Water, Temperature, and
                                   Enerpro faults are considered general
                                   faults") predates this document being
                                   read and is superseded for Enerpro
                                   specifically; Water+Temp still route to
                                   SM_FAULT_GENERAL, unchanged. PER-CHANNEL
                                   (like SM_FAULT_OVERCURRENT/
                                   SM_FAULT_ENABLE_OUTPUT) -- reuses
                                   HandleOvercurrentFault(channel)
                                   unchanged (see EnterFault()'s switch,
                                   state_machine.c). Detection stays EXTI-
                                   driven (PE0-11 has no line-sharing
                                   conflict, unlike OCP's PF4/5/8/12) --
                                   only the RESPONSE routing changed; see
                                   xrex_io.c's XrexIo_PollEnerproFaults(),
                                   called from gate_driver.c's
                                   GateDriver_CheckFault() alongside the
                                   now-Water+Temp-only general-fault
                                   check. */
} SM_FaultType_t;

/* Called once at boot (app.c), after pid.c's own PID_Init() AND after
 * board_io.c's BoardIo_Init() (which now also configures PF13,
 * external-enable, and PF15, external-trigger -- see those interlocks'
 * own doc comments below). Sets the state to IDLE. Does not touch any
 * hardware itself -- pid.c/hrtim.c's own init already leaves outputs
 * off, and PF13/PF15's GPIO config lives in board_io.c's BoardIo_Init()
 * (matching gate_driver.c's own precedent for plain-input pins: GPIO
 * config in board_io.c, the read/fault logic in the owning module) -- this
 * just makes IDLE the explicit, queryable state from the start. */
void SM_Init(void);

SM_State_t SM_GetState(void);

/* Valid (meaningful) only while SM_GetState() == SM_STATE_FAULT --
 * returns SM_FAULT_NONE otherwise. */
SM_FaultType_t SM_GetFaultType(void);

/* The channel (0-based) a PER-CHANNEL fault was reported for -- valid
 * (meaningful) only when SM_GetFaultType() is SM_FAULT_OVERCURRENT,
 * SM_FAULT_ENABLE_OUTPUT, or SM_FAULT_ENERPRO. Returns 0xFF (never a
 * real channel index) otherwise, including for SM_FAULT_GENERAL/
 * SM_FAULT_EXTERNAL_ENABLE/SM_FAULT_NONE --
 * those are system-wide, not per-channel, so they have no single
 * channel to report here. Added 2026-09-15 alongside
 * SM_ReportOcpFault(), below -- WIDENED 2026-09-18 (real bug, found via
 * real-hardware testing: this returned 0xFF for SM_FAULT_ENABLE_OUTPUT
 * too, even though that fault type's own STATE? branch, cmd_state.c,
 * has always expected a real channel from this same getter -- see this
 * function's own .c comment for the full story) to also cover
 * SM_FAULT_ENABLE_OUTPUT/SM_FAULT_ENERPRO, the two per-channel types
 * added after this function was first written for OCP alone. */
uint8_t SM_GetFaultChannel(void);

/* IDLE -> ARMED. Backs the `ARM` command (cmd_state.c). Returns 1 on
 * success, 0 if the current state isn't IDLE (already ARMED/FIRING/
 * FAULT) or if ArmConditionsMet() (state_machine.c -- external-enable
 * interlock + per-channel ENA_OUT/CONTACT_OUT readiness, not a pure
 * stub since 2026-09-17) refuses. */
uint8_t SM_Arm(void);

/* ARMED -> IDLE, WITHOUT firing -- stand down. Backs the `DISARM`
 * command (cmd_state.c) -- added alongside SM_Arm() as its natural
 * companion (arming is reversible without requiring either a fire or
 * a fault); flag if this isn't wanted. No-op (not an error) if not
 * currently ARMED. */
void SM_Disarm(void);

/* ARMED -> FIRING. Backs SHOT:STARt (cmd_shot.c's
 * cmd_shot_start(), now gated on this) -- calls
 * PID_ProfileStart() (pid.c, unchanged) internally and only actually
 * transitions to FIRING if that succeeds. Returns 1 on success, 0 if
 * the current state isn't ARMED, or if PID_ProfileStart() itself
 * fails (e.g. profile timing was never set) -- state stays ARMED in
 * that case, not FIRING. */
uint8_t SM_Fire(void);

/* ARMED -> FIRING for the PLAIN (non-profile) start path -- added
 * 2026-09-21 alongside gating SOURce:RUN behind ARM. Same contract as
 * SM_Fire() (requires ARMED + SM_ExternalEnableOk()), but calls
 * PID_Start() instead of PID_ProfileStart(): an open-ended loop with no
 * shot clock, brought back to IDLE by SOURce:STOP (SM_Stop()). Returns 1
 * on success, 0 if not ARMED (state stays ARMED). */
uint8_t SM_StartPlain(void);

/* ARMED or FIRING -> IDLE, a manual abort -- backs SOURce:STOP
 * (cmd_control.c's cmd_source_stop(), now also calling this) alongside its
 * existing PID_Stop() call. No-op (not an error) if already IDLE, and
 * deliberately does NOT clear FAULT (see SM_ClearFault() for that --
 * a plain STOP must never be a backdoor out of a real fault latch). */
void SM_Stop(void);

/* FIRING -> IDLE, called by pid.c's PID_Update() at the exact point a
 * profile naturally completes (the shared shot clock reaching its
 * total duration) -- the automatic, no-fault, no-operator-action shot
 * end. Do not call this for a manual abort -- that's SM_Stop(). */
void SM_NotifyShotComplete(void);

/* Checks BOTH existing fault sources (HRTIM1_FaultIsTripped(),
 * GateDriver_FaultIsLatched()) and transitions IDLE/ARMED/FIRING ->
 * FAULT the instant either is set -- per direct instruction, "no
 * matter which state the supply is in". No-op if already in FAULT
 * (nothing new to latch) or if neither source is tripped.
 *
 * Called from TWO places, deliberately, so detection genuinely doesn't
 * depend on what state the machine is in:
 *   1. the main loop (app.c's App_Poll()), every iteration, unconditionally -- covers
 *      IDLE/ARMED, where the HRTIM Master counter (and so pid.c's own
 *      per-tick PID_Update()) isn't even running yet, so nothing else
 *      would ever notice a fault at all before an operator tried to
 *      fire into one.
 *   2. pid.c's PID_Update(), once per Master tick, for FIRING -- the
 *      same call, just also reached at the higher, deterministic rate
 *      an active shot already runs at, rather than waiting for the
 *      main loop's own (currently unbounded, TaskScpi_Poll()-gated)
 *      iteration cadence.
 * *** NOTE TO REVISIT ***: the main-loop polling rate is whatever the
 * loop's own cadence happens to be (currently just TaskScpi_Poll() next
 * to it) -- not a bounded, guaranteed interval. Fine for now (both
 * underlying fault sources already protect themselves independently
 * of this -- PC10 in silicon, GateDriverStatus via its own EXTI edge
 * regardless of when this function next runs), but worth a harder
 * look (a dedicated periodic timer?) if SM_GetState() itself needs a
 * tighter latency guarantee later. */
void SM_PollFaults(void);

/* Reports an OCP (per-channel overcurrent) fault for `channel` (0-based,
 * 0..HRTIM_NUM_CHANNELS-1) -- added 2026-09-15, per direct instruction.
 * Unlike SM_PollFaults() above (which POLLS two system-wide sources),
 * this is a direct REPORT -- the entry point whatever eventually detects
 * a real per-channel OCP condition (an EXTI ISR once real pins are
 * defined, see state_machine.h's own header comment "NOTE TO REVISIT";
 * OCP:TEST:FAULT, cmd_state.c, meanwhile, for verifying this end-to-end
 * on real hardware without needing them) is meant to call, the instant
 * the condition is detected. `channel` out of range is a silent no-op
 * (defensive -- a caller with a real, wired-up pin should never produce
 * one).
 *
 * From IDLE/ARMED/FIRING: transitions straight to SM_STATE_FAULT with
 * SM_FAULT_OVERCURRENT, exactly like SM_PollFaults()'s own EnterFault()
 * path for SM_FAULT_GENERAL, then runs HandleOvercurrentFault()'s
 * channel-aware response -- see state_machine.h's own header comment and
 * PID_BeginOvercurrentRampDown()'s doc comment (pid.h) for the full
 * 3-step behavior (immediate disable for THIS channel, an immediate
 * proportional step-down for the others, then the same graceful ramp
 * General Fault uses).
 *
 * From SM_STATE_FAULT (already faulted, either type): does NOT re-run
 * that sequence -- see this header's own "ALSO NOTE TO REVISIT" comment
 * on why (it only makes sense once) -- but STILL always immediately
 * hard-disables `channel`'s own HRTIM output unconditionally, a cheap,
 * safe action regardless of what else is already in progress.
 *
 * Same __disable_irq()/__enable_irq() critical-section pattern as
 * SM_PollFaults() (state_machine.c), for the same reason: this may
 * eventually be called from ISR context (a real OCP pin's EXTI handler)
 * and needs to be safe against the same main-loop/ISR race that function
 * itself was fixed for. */
void SM_ReportOcpFault(uint8_t channel);

/* Reports a General (system-wide) fault directly -- added 2026-09-15,
 * per direct request for a software way to test the General Fault
 * ramp-down (a shot in progress, an EARLY fault -- e.g. mid-ramp-up,
 * before any channel has reached its plateau -- not just the
 * steady-state/flat-top case OCP:TEST:FAULT has been exercised
 * against so far). Backs the new GENERAL:TEST:FAULT command
 * (cmd_state.c), same software-fault-injection precedent as
 * OCP:TEST:FAULT/SM_ReportOcpFault() above -- there is still no real
 * software path to this otherwise: SM_PollFaults() only ever reaches
 * SM_FAULT_GENERAL by POLLING the two real hardware sources (PC10/
 * HRTIM1_FLT6, GateDriverStatus), and neither can be triggered from a
 * SCPI command.
 *
 * Unlike SM_ReportOcpFault(), takes no channel argument -- General
 * Fault is system-wide by design, exactly like SM_PollFaults()'s own
 * EnterFault(SM_FAULT_GENERAL, 0xFFU) call. A no-op if already
 * SM_STATE_FAULT (matches SM_PollFaults()'s own "already latched --
 * nothing new to do" behavior; there is no OCP-style "still hard-
 * disable something" fallback needed here since General Fault has no
 * per-channel target). Same __disable_irq()/__enable_irq() critical-
 * section pattern as SM_PollFaults()/SM_ReportOcpFault(), for the same
 * main-loop/ISR race protection. */
void SM_ReportGeneralFault(void);

/* FAULT -> IDLE, ONLY if the underlying condition is actually gone --
 * backs FAULT:CLEAR (cmd_state.c's existing cmd_fault_clear(), now also
 * calling this) alongside its existing HRTIM1_FaultClear()/
 * GateDriver_FaultClear() calls (both of which already re-validate
 * their own source before truly clearing -- see their own doc
 * comments). Returns 1 if now clear (state -> IDLE), 0 if still
 * faulted (state stays FAULT, matching GateDriver_FaultClear()'s own
 * "re-latches before this even returns" behavior for a still-present
 * condition) or if not currently in FAULT at all (nothing to clear).
 *
 * *** REAL GAP, added 2026-09-15, not silently left implicit ***: this
 * only re-validates HRTIM1_FaultIsTripped()/GateDriver_FaultIsLatched()
 * -- there is no third check for SM_FAULT_OVERCURRENT, because (see this
 * header's own "NOTE TO REVISIT" above) no real OCP hardware detection
 * exists yet to re-validate against. Concretely: an OCP fault reported
 * via SM_ReportOcpFault() will ALWAYS successfully clear on the very
 * next FAULT:CLEAR, unconditionally, regardless of whether a real,
 * future OCP condition on that channel is still physically present --
 * unlike General Fault, which genuinely re-latches immediately if its
 * sources are still bad. Once real per-channel OCP detection exists,
 * this function needs a matching re-check added alongside the two it
 * already has (mirroring GateDriver_FaultIsLatched()'s own shape,
 * whichever way OCP's real detection ends up presenting a "still
 * latched" query) -- do not assume this file's job here is finished
 * just because SM_ReportOcpFault()/the ramp-down behavior are. */
uint8_t SM_ClearFault(void);

/* --------------------------------------------------------------------------
 * External-enable interlock (PF13 -- docs/pin_mapping_v4.csv, documented
 * "GPInput_12"), added 2026-09-16, MOVED here 2026-09-17 from PF15
 * (Fiber_Enable), per direct instruction: enable and trigger are now two
 * independent physical signals on separate pins, not one shared wire --
 * PF15 keeps ONLY the trigger role from here on (see the external-trigger
 * section directly below). Every behavior/gating rule described here is
 * otherwise UNCHANGED from the original PF15-based design; only the pin
 * moved.
 *
 * A pin the operator reads, not drives -- confirmed GPI in the pin
 * mapping doc (PC14, the pin first proposed for this feature, was
 * rejected: it's documented GPO there, "STM_Enable_Pin" -- the STM32
 * DRIVES that one outward, the opposite direction needed here; PF15 was
 * the correct pin then, PF13 is the correct pin now). Opt-in: OFF by
 * default at boot (SM_SetExternalEnableRequired() was never called, or
 * was last called with 0) -- existing shots/tests are completely
 * unaffected unless this is explicitly turned on.
 *
 * When ON:
 *   1. `ARM` refuses (ArmConditionsMet(), state_machine.c) unless PF13
 *      currently reads HIGH -- folded into that function's existing
 *      generic "arm conditions not met" failure (ERR 13), no new error
 *      code needed for this case.
 *   2. `SHOT:STARt` ALSO re-checks PF13 immediately before
 *      firing (SM_ExternalEnableOk(), below, checked by the command
 *      handler for a precise error -- see cmd_shot_start()'s own
 *      comment -- AND redundantly inside SM_Fire() itself as a last-
 *      line-of-defense, in case some other future caller ever bypasses
 *      the command handler's own check, INCLUDING the external-trigger
 *      feature below, which calls SM_Fire() directly). Closes the real
 *      gap where PF13 could drop in the window between a successful ARM
 *      and the eventual START -- ARM alone is NOT enough to guarantee
 *      this.
 *   3. While FIRING, SM_PollFaults() (below) ALSO checks PF13 every
 *      time it runs (the main loop, AND every real PID_Update() tick --
 *      the same cadence General Fault's own two hardware sources
 *      already get). If PF13 reads LOW while FIRING, enters
 *      SM_STATE_FAULT with SM_FAULT_EXTERNAL_ENABLE -- identical
 *      open-loop ramp-down response to General Fault (HandleGeneralFault()
 *      is reused directly, see EnterFault()'s switch, state_machine.c)
 *      -- reported as a DISTINCT fault type purely for operator
 *      diagnostics (STATE? -> "OK FAULT EXTERNAL_ENABLE"), not a
 *      different physical response. Per direct instruction, this is
 *      checked only while actually FIRING ("if that input is lost
 *      during a shot") -- losing PF13 while merely ARMED (nothing
 *      outputting yet) is NOT itself treated as a fault here; the next
 *      SHOT:STARt attempt will simply fail its own re-check
 *      (item 2 above) instead. Deliberately not decided either way
 *      whether ARMED should also actively fault on PF13 loss -- not
 *      asked for, flagged rather than silently added.
 *   4. `FAULT:CLEAR` (SM_ClearFault(), above) re-validates PF13 is back
 *      HIGH before actually clearing an EXTERNAL_ENABLE fault, same
 *      "only clear if the condition is actually gone" philosophy
 *      already applied to PC10/GateDriverStatus.
 *
 * GPIO_PULLDOWN (board_io.c's BoardIo_Init(), not this project's usual
 * GPIO_NOPULL for actively-driven inputs) is a DELIBERATE fail-safe
 * choice specific to this one signal: an unconnected/floating PF13
 * must read LOW (no permission), never an undefined level that could
 * accidentally read HIGH and silently permit firing. GateDriverStatus's
 * own NOPULL is fine for that pin because floating-read-as-fault is
 * already the safe direction there; the same reasoning would be UNSAFE
 * here, where floating-read-as-enabled would be the dangerous one.
 *
 * *** As a FAULT source, NOT re-checked while IDLE or ARMED other than
 * at the two explicit gate points above (ARM, SHOT:STARt) --
 * only genuinely continuously monitored for FAULT purposes while
 * FIRING. If tighter, always-on FAULT monitoring is ever wanted,
 * that's a real, separate decision to make explicitly, not something
 * to assume was already covered here. *** */

/* Turns the interlock above on (1) or off (0). Persists across shots
 * until changed again or the board reboots (RAM state, like every
 * other runtime config in this project -- SHOT:CURRent,
 * PID:LOOPMODE, etc.) -- NOT saved to non-volatile storage. Backs
 * `EXTernal:ENAble <0|1>` (cmd_io.c). Takes effect immediately: if turned
 * ON while already FIRING, the very next SM_PollFaults() call (at most
 * one PID_Update() tick away) starts checking PF13.
 *
 * UNCOUPLED from the external-trigger feature (below) 2026-09-17, the
 * same day enable and trigger split onto separate pins (PF13/PF15) --
 * previously turning this off also forced trigger off, since both
 * features read the same physical wire; that coupling no longer applies
 * now that they're independent signals, per direct instruction. The
 * real safety guarantee is unaffected: SM_Fire() itself always
 * re-checks this interlock before actually firing, regardless of how
 * trigger was configured. */
void SM_SetExternalEnableRequired(uint8_t required);

/* Current mode, as last set by SM_SetExternalEnableRequired() (1 by
 * default at boot as of 2026-09-22 -- was 0 2026-09-16 through
 * 2026-09-21, see state_machine.c's own g_externalEnableRequired
 * comment and docs/changelog.txt). Backs `EXTernal:ENAble?` (cmd_io.c). */
uint8_t SM_GetExternalEnableRequired(void);

/* 1 if the interlock isn't required at all (SM_GetExternalEnableRequired()
 * == 0 -- always "ok" in that case, matching this feature's opt-in
 * design), OR it IS required and PF13 currently reads HIGH. 0 only when
 * required AND PF13 currently reads LOW. This is the single source of
 * truth `ArmConditionsMet()`/`SM_Fire()` (state_machine.c) both check
 * internally -- also exposed publicly so the command layer
 * (cmd_shot_start(), cmd_shot.c) can give a precise, distinct
 * error message instead of a generic failure, matching the same
 * "distinct failure reasons, reported distinctly" precedent that
 * function's own comment already established for
 * SHOT:TIMing-not-set. */
uint8_t SM_ExternalEnableOk(void);

/* Raw PF13 logic level right now (1 = HIGH, 0 = LOW) -- independent of
 * whether the interlock is even turned on. Diagnostic: lets an operator
 * confirm real wiring/signal presence (`EXTernal:INPut?`, cmd_io.c)
 * before actually turning the interlock on, the same "verify before you
 * rely on it" role PFMIN:DEBUG:RAW?/REG? played for the PF_Input fiber-
 * patching investigation (docs/changelog.txt, 2026-09-15). */
uint8_t SM_GetExternalEnableInputRaw(void);

/* --------------------------------------------------------------------------
 * External trigger (rising edge on PF15, "Fiber_Enable", fires a shot),
 * added 2026-09-16, per direct follow-up request. RESTRUCTURED
 * 2026-09-17, per direct instruction: PF15 now backs TRIGGER ONLY --
 * the external-enable interlock above moved to its own separate pin
 * (PF13). Trigger and enable are independent physical signals from here
 * on, not two facets of one shared wire.
 *
 * ON by default as of 2026-09-22 (was opt-in/OFF 2026-09-16 through
 * 2026-09-21 -- see state_machine.c's own g_externalTriggerRequired
 * comment and docs/changelog.txt). UNCOUPLED from the external-enable interlock
 * 2026-09-17 -- SM_SetExternalTriggerRequired() no longer refuses
 * regardless of SM_GetExternalEnableRequired()'s state (previously it
 * did, back when both features read the same wire and "trigger without
 * enable" was structurally meaningless). This does NOT weaken the real
 * safety guarantee: SM_Fire() (below) still unconditionally re-checks
 * SM_ExternalEnableOk() (PF13) every time it's called, including when
 * called from this trigger's own edge-detection path -- a rising edge
 * on PF15 while PF13 doesn't currently read HIGH (and the enable
 * interlock is on) simply fails to fire, exactly as a manual
 * `SHOT:STARt` would.
 *
 * When ON, and the state machine is currently SM_STATE_ARMED: a
 * LOW-to-HIGH transition on PF15 calls SM_Fire() directly -- the exact
 * same function `SHOT:STARt` itself calls, so every one of that
 * path's own guarantees (the external-enable re-check, the
 * profile-timing-configured check, the resulting FIRING-state fault
 * monitoring) apply identically whether a shot started by operator
 * command or by this trigger. Per direct instruction ("this is the same
 * behavior as running SHOT:STARt"), there is no second/different
 * start path for a triggered shot -- see this file's own investigation
 * into whether a distinct "open-loop start call" exists (it doesn't:
 * open- vs. closed-loop has always been the PER-CHANNEL PID:LOOPMODE
 * flag, checked inside the SAME PID_Update() loop both SOURce:RUN and
 * SHOT:STARt already share -- there was never a second,
 * structurally-open-loop start mechanism to call here, aside from the
 * unrelated legacy pfm.c TABLE:*-and-FIRE path, which this feature does
 * NOT touch). And, per direct instruction 2026-09-17: this only ever
 * fires from SM_STATE_ARMED -- `if (g_state == SM_STATE_ARMED)` in
 * SM_PollFaults() is the ONLY place this trigger can act, no other
 * state.
 *
 * Edge detection: a baseline PF15 level is captured fresh the instant
 * SM_Arm() succeeds (SM_Fire() -- state_machine.c -- also updates it on
 * every SM_PollFaults() call while still ARMED and this feature is on)
 * specifically so a signal that's ALREADY HIGH at the moment of arming
 * does not look like a rising edge on the very next poll -- only a
 * genuine LOW-then-HIGH transition AFTER arming counts. If SM_Fire()
 * itself fails for some other reason (e.g. profile timing never set,
 * or PF13/enable isn't currently satisfied), the state simply stays
 * ARMED with the baseline now recording HIGH -- a real falling-then-
 * rising edge is needed to try again, not just PF15 remaining HIGH;
 * this is an edge-triggered mechanism, not a level-triggered one.
 *
 * Checked from INSIDE SM_PollFaults() (not a separate poll function) --
 * same reasoning as the FIRING-state fault check above: shares that
 * function's already-established call-site guarantee (main loop +
 * every real PID_Update() tick) rather than requiring every caller to
 * also remember a second poll entry point. While merely ARMED (not yet
 * FIRING), the only caller actually reaching SM_PollFaults() is the
 * main loop -- its own iteration rate is unbounded/undocumented (see
 * this file's pre-existing "NOTE TO REVISIT" on that), so trigger
 * latency while ARMED inherits that same, already-flagged limitation;
 * not a new one introduced here. */

/* Turns the trigger feature on (1) or off (0). Returns 1 always, as of
 * 2026-09-17 (previously could return 0/refuse -- see this feature's
 * own header comment above for why that coupling to external-enable
 * was removed). Kept a uint8_t return rather than void purely so the
 * command layer (cmd_ext_trigger(), cmd_io.c) didn't need its own
 * signature change. Backs `EXTernal:TRIGger <0|1>` (cmd_io.c).
 * RAM-only, resets to 0 on reboot, same as every other runtime config
 * in this project. */
uint8_t SM_SetExternalTriggerRequired(uint8_t required);

/* Current mode, as last set by SM_SetExternalTriggerRequired() (0 by
 * default at boot). Backs `EXTernal:TRIGger?` (cmd_io.c). */
uint8_t SM_GetExternalTriggerRequired(void);

/* Raw PF15 logic level right now (1 = HIGH, 0 = LOW) -- independent of
 * whether the trigger feature is even turned on. Added 2026-09-17
 * alongside the PF13/PF15 split -- previously EXTernal:INPut? covered
 * this same pin (it backed both enable and trigger, being the same
 * wire); now that they're separate, this is trigger's own dedicated
 * diagnostic, matching SM_GetExternalEnableInputRaw()'s role for PF13.
 * Backs `EXTernal:TRIGger:INPut?` (cmd_io.c). */
uint8_t SM_GetExternalTriggerInputRaw(void);

/* --------------------------------------------------------------------------
 * Emergency stop -- REMOVED 2026-09-21. The PG10 fiber-optic E-stop
 * feature (SM_FAULT_EMERGENCY_STOP, EMERGency:ENAble/ENAble?/INPut?,
 * SM_SetEmergencyStopRequired()/SM_EmergencyStopOk() and friends) was
 * removed: PG10 turned out to be electrically tied to NRST, this MCU's
 * real reset pin, not a usable GPIO (see board_io.c's BoardIo_Init() comment
 * and docs/changelog.txt). A future E-stop must use a genuinely free
 * input pin and re-settle the fail-safe polarity afresh.
 * -------------------------------------------------------------------------- */

/* --------------------------------------------------------------------------
 * Enable/contactor output precondition (PG0-PG3/PG4-PG7 -- XR1-XR4's own
 * ENA_OUT/CONTACT_OUT fiber outputs, docs/pin_mapping_v4.csv's "XREX Pin
 * Name" column), added 2026-09-17, per direct request.
 *
 * Two commanded OUTPUTS per Transrex channel -- set via
 * `XREX:CHANnel:ENAOut <ch> <0|1>` / `XREX:CHANnel:CONTactOut <ch> <0|1>`
 * (cmd_io.c), owned (pin table, GPIO read/write) by xrex_io.c matching
 * that module's established per-channel-XR-signal charter. Direct
 * instruction: "The controller cannot be armed unless these are
 * outputting prior to the arm signal, and similarly we cannot transition
 * to the ARM state i[f] these are not output."
 *
 * PER-CHANNEL, asked and confirmed directly: only currently-enabled
 * channels (`PID_GetChannelEnable()`) are checked -- running XR1 alone
 * never requires XR2/3/4's ENA_OUT/CONTACT_OUT to be set, matching the
 * exact same per-channel-gating philosophy already established for
 * Water/Temp/Enerpro/OCP (xrex_io.h). A channel's own ENA_OUT AND
 * CONTACT_OUT must BOTH read HIGH to count as "outputting" for that
 * channel -- treated as one combined per-channel condition, not two
 * independently-faultable ones (matches how the request groups them:
 * "these are outputting"/"these are not output", never asking to
 * distinguish which one dropped).
 *
 * 1. **`ARM`** refuses (folded into the existing generic `ERR 13`, same
 *    as the external-enable interlock above) unless EVERY currently-
 *    enabled channel's ENA_OUT+CONTACT_OUT are both HIGH --
 *    `XrexIo_EnableOutputsReadyToArm()` (xrex_io.h), a pure check, no
 *    side effects, called from `ArmConditionsMet()`.
 * 2. **Continuously monitored once ARMED** -- asked directly and
 *    confirmed: unlike SM_FAULT_EXTERNAL_ENABLE's FIRING-only carve-out,
 *    this is checked in BOTH `SM_STATE_ARMED` and `SM_STATE_FIRING` (NOT
 *    `SM_STATE_IDLE` -- nothing is armed yet there, matching the
 *    "precondition for arming" framing, not a general always-on safety
 *    interlock like emergency-stop). `XrexIo_PollEnableOutputFaults()`
 *    (xrex_io.h) does this gating itself (checks `SM_GetState()` before
 *    doing any per-channel work at all) and is called from the SAME
 *    tick cadence `XrexIo_PollOcpFaults()` already gets (app.c's boot +
 *    main loop, and every real `PID_Update()` tick, pid.c) -- reuses
 *    that same call-site pattern rather than inventing a new one.
 * 3. On a fault, `SM_ReportEnableOutputFault(channel)` (below) is called
 *    -- SAME shape as `SM_ReportOcpFault()` (critical-section-protected,
 *    "already faulted -> just hard-disable this channel" short-circuit),
 *    entering `SM_STATE_FAULT` with `SM_FAULT_ENABLE_OUTPUT` and reusing
 *    `HandleOvercurrentFault(channel)` DIRECTLY for the response --
 *    immediate hard-disable of the affected channel, survivors derated
 *    1/N and ramped down exactly like a real OCP fault. See this file's
 *    own header comment on `SM_FAULT_ENABLE_OUTPUT` for why this fault
 *    type is deliberately named/kept distinct from
 *    `SM_FAULT_EXTERNAL_ENABLE` despite the similar name -- they are
 *    unrelated mechanisms (this one: this firmware's own per-channel
 *    OUTPUT state; that one: a single system-wide INPUT interlock, PF13).
 * 4. **`FAULT:CLEAR`** needs NO dedicated re-validation for this fault
 *    type -- matching `SM_FAULT_OVERCURRENT`'s own established precedent
 *    (also no re-check in `SM_ClearFault()`), not an oversight: the
 *    affected channel is already hard-disabled
 *    (`PID_SetChannelEnable(channel, 0)`) by the time `FAULT:CLEAR` is
 *    even considered, so there is nothing still-missing left to block.
 *    The real gate is `ArmConditionsMet()` (item 1 above) at the NEXT
 *    `ARM` attempt -- if the operator re-enables this channel before its
 *    ENA_OUT/CONTACT_OUT are actually restored, arming will correctly
 *    refuse again then.
 *
 * GPIO config (board_io.c's `BoardIo_Init()`): push-pull outputs, driven LOW
 * before being enabled (never glitches HIGH on boot), matching this
 * project's established diagnostic-output convention (`DIAGnostic:GPOut11`/
 * `GPOut12`) -- these ARE the real, permanent per-channel outputs
 * themselves, not a diagnostic stand-in for them. No pull resistor
 * question applies (these are outputs, not inputs). */

/* Entry point called by XrexIo_PollEnableOutputFaults() (xrex_io.c) the
 * moment `channel`'s own ENA_OUT/CONTACT_OUT are found not both HIGH
 * while ARMED or FIRING. Same shape as SM_ReportOcpFault() above --
 * critical-section-protected; if already SM_STATE_FAULT (either type),
 * unconditionally hard-disables `channel`'s own output and returns
 * without re-entering (a real dropped output must never be left
 * connected just because some other channel's fault got here first);
 * otherwise calls EnterFault(SM_FAULT_ENABLE_OUTPUT, channel), which
 * routes to HandleOvercurrentFault(channel) (state_machine.c) for the
 * actual response -- see this file's own SM_FAULT_ENABLE_OUTPUT header
 * comment for why that specific handler is reused. `channel` must be
 * 0-based and < HRTIM_NUM_CHANNELS (out-of-range is a defensive no-op,
 * matching SM_ReportOcpFault()'s own guard). */
void SM_ReportEnableOutputFault(uint8_t channel);

/* --------------------------------------------------------------------------
 * SM_FAULT_ENERPRO -- see this enum value's own comment (above) for the
 * full reclassification reasoning (docs/Transrex/Transrex_Controls_
 * Upgrade (1).pdf's fault table vs. the earlier "general fault"
 * instruction it supersedes for Enerpro specifically).
 *
 * Entry point called by xrex_io.c's XrexIo_PollEnerproFaults() (itself
 * called from gate_driver.c's GateDriver_CheckFault(), EXTI context --
 * NOT polled like SM_ReportOcpFault()/SM_ReportEnableOutputFault(),
 * since PE0-11 has no line-sharing conflict) the moment `channel`'s own
 * Enerpro pin reads faulted (per XR_ENERPRO_FLT_POLARITY,
 * ctrlr_config.h) while that channel is enabled. EXACT same shape as
 * SM_ReportOcpFault()/SM_ReportEnableOutputFault() -- critical-section-
 * protected; if already SM_STATE_FAULT (any type), unconditionally
 * hard-disables `channel` and returns without re-entering; otherwise
 * calls EnterFault(SM_FAULT_ENERPRO, channel), which routes to
 * HandleOvercurrentFault(channel) (state_machine.c) -- the SAME
 * individual-disable + survivors-derate-and-ramp response OCP gets, per
 * the real spec. `channel` must be 0-based and < HRTIM_NUM_CHANNELS
 * (out-of-range is a defensive no-op, matching SM_ReportOcpFault()'s own
 * guard). No dedicated FAULT:CLEAR re-validation needed, same reasoning
 * as SM_FAULT_OVERCURRENT/SM_FAULT_ENABLE_OUTPUT -- the affected channel
 * is already hard-disabled by the time FAULT:CLEAR runs. */
void SM_ReportEnerproFault(uint8_t channel);

/* DEBUG:FAULT:BYPASS (cmd_state.c) -- bench-only debug override, added
 * 2026-09-21. Defaults OFF at every boot (RAM-only, never persisted).
 * When ON, EVERY fault type (Water/Temp/Enerpro/OCP/ENABLE_OUTPUT/
 * GENERAL/EXTERNAL_ENABLE) is silently ignored -- see
 * state_machine.c's own g_faultBypassEnabled comment for the full
 * reasoning and its safety warning. *** NEVER enable against a real
 * Transrex or any hardware where a real fault condition is physically
 * possible. *** */
void SM_SetFaultBypassEnabled(uint8_t enabled);
uint8_t SM_GetFaultBypassEnabled(void);

/* The faults MEASURED since the controller last was clear, as fault_mask.h
 * FM_* bits -- all of them, not only the first one that latched (that one is
 * SM_GetFaultType()/SM_GetFaultChannel()). Backs the ACTIVE= list on STATE?
 * Added 2026-11-09. SM_NoteFaults() records bits (ignored under
 * DEBUG:FAULT:BYPASS; safe from the EXTI ISR); a successful SM_ClearFault()
 * empties the mask, a refused one leaves it. */
void     SM_NoteFaults(uint32_t bits);
uint32_t SM_GetActiveFaults(void);

#ifdef __cplusplus
}
#endif

#endif /* __STATE_MACHINE_H__ */
