everettpenne/WHAM-CONTROLLERS/(commit log)

2026-09-29 Add nvstore: external-flash byte storage for saved settings (step 1)
    Read, 4 KiB sector erase, page-split program with read-back verify, and
    status registers over the W25Q128JVS on QUADSPI, behind a HAL-free
    src/drivers/nvstore.h. Shares the QUADSPI handle from qspi_test.c via the
    new qspi_test_hw.h. Builds on both targets; not yet called from anywhere
    and not yet run against the chip.
2026-09-29 Add QSPI:SELFtest: bench test for the external-flash driver (step 2)
    IDLE-only erase / cross-page program / whole-sector read-back on the last
    sector of the W25Q128JVS, reporting status registers and timings. Written
    and built (both targets' host tests pass), not yet run on hardware.
2026-09-29 Add saved settings profiles: *SAV, *RCL, CONFig:PROFile:* (steps 3-4)
    Eight flash slots hold a snapshot of the operator-configurable settings;
    recall is explicit only and *SAV/*RCL/CLEar are IDLE-only. New
    src/app/settings/ (tagged-record codec, two-copy power-fail-safe slot
    store, capture/apply through the existing setters) and cmd_profile.c;
    ERR 18. Host tests include a power cut at every unit of a save and a
    clear. Builds on both targets; not yet run on hardware.
2026-09-29 Record saved-profile power-cycle result on the simulator
2026-09-30 Add operator-selectable supply mode (LIMITER / HVPS) with frequency and duty limits
    CONFig:MODE LIMiter|HVPS, CONFig:MODE?, CONFig:LIMits?. LIMITER (PWM): 75-125 kHz,
    5-95% per-phase duty; HVPS (PFM): 10-30 kHz, 40-60% duty. Every TABle:STEP is checked
    against the selected mode (ERR 10); boot mode is NONE and table upload is refused
    until a mode is chosen; changing the mode is IDLE-only and discards the table. Replaces
    the fixed 100 kHz carrier ceiling. Host-tested (test_supply_mode.c); host upload tool
    gains --mode. Also makes sync_build_sources.py robust against a stale objects.list.
2026-09-30 Record flash/RAM footprint for the supply-mode build
2026-09-30 PFM_Input raw both-edge capture mode for duty-cycle measurement (PFMIN:EDGes, PFMIN:RAW?)
    Re-explores the 2026-09-08 duty attempts with DMA capture and raw timestamps:
    the old period-doubled failure does not reproduce (see changelog). Also fixes
    the end-of-shot tail flush dropping edges when the DMA position had wrapped.
2026-09-30 PFM_Input: bounded DMA capture into the result array, started before the outputs
    The circular buffer read in chunks by the DMA interrupt starved the last channel
    at 100 kHz with both edges (measured with an event trail): each chunk cost ~24 us
    and four channels asked for more CPU than exists. The capture is bounded, so the
    DMA now fills the result array directly and stops itself -- no per-edge or
    per-chunk work, no tail flush, no stale data. PFMIN:RAW? gains pages and a SUM
    checksum (the ethernet bridge loses characters in long replies). See changelog.
2026-09-30 Memory footprint history for the PFM_Input DMA rewrite
2026-10-01 Time-series shot: SHOT:* setpoints, interpolating generator, 100-entry ring table
    A shot is now uploaded as time/frequency/duty setpoints (t=0 required, linear ramps
    between them, limits checked per setpoint against the supply mode). A generator walks
    the curve one period at a time into a PFM_TABLE_SIZE-entry ring that a low-priority
    software interrupt keeps refilled; a refill that falls behind stops the shot and
    latches a fault. SHOT_SETPOINT_MAX / SHOT_MAX_DURATION_US / PFM_TABLE_SIZE are
    ctrlr_config.h constants. TABle:* remains as a <=100-entry bench path.
    Host-tested (tests/test_shot_profile.c) and the Python port matches it exactly.
    NOT yet run on hardware.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
2026-10-01 Shot profile: make it sustainable at LIMITER rates (O2 hot paths, 3-divide period, FAULT:SOURces?, 1300-entry ring default)
    Measured on the simulator: the refill gets only the CPU the per-period interrupt leaves, and the
    project's -O0 build left too little above ~80 kHz when a step is applied every period. Generator
    and per-period playback path compiled at -O2 (attributes), a 32-bit-only exact period division,
    FAULT:SOURces? to tell an underrun from a hardware fault, PFM:DIAG? ring/refill fields. Default
    PFM_TABLE_SIZE 1300 so every 10 ms LIMITER worst case is generated before the first period.
2026-10-01 Memory footprint history for the shot profile
2026-10-01 Global -O2 build, 3800-period 16-bit PFM_Input capture, 50 ms profile demonstrations
    The project now builds at -O2 (image 74 -> 50 kB); with it the 100-entry ring sustains every
    shot tried except a step per period at 125 kHz. PFM_Input stores 16-bit stamps for the four
    wired inputs only, holds 3800 periods (a 50 ms shot at 75 kHz), and PFMIN:DATA? is paged with
    a SUM like PFMIN:RAW?. python/pfm_profile_demo.py runs and plots the two demonstrations:
    HVPS frequency triangle and LIMITER duty triangle, 4 cycles in 50 ms each.
2026-10-01 Memory footprint history for the -O2 build
2026-10-01 Configure PA4/PA5 as the two DAC outputs, with DAC:OUTPut commands
    DAC1 channels 1 and 2 (AnalogOut_01/02) enabled at 0 V with the output buffer on, driven
    through registers. DAC:OUTPut <1|2> <volts> and DAC:OUTPut? read back the DAC's own output
    register. DAC_VREF_MV is assumed 3.3 V and must be confirmed against the board.
2026-10-01 Memory footprint history for the DAC outputs
2026-10-01 Configure PA0/PA1/PC0/PB0 as ADC inputs; enable the internal analog reference
    AnalogIn_01..04 on ADC1 (registers, calibrated, 16x oversampled), ADC:INPut? and ADC:VREF?.
    This board has no external reference (pin 43 is a capacitor): VREFBUF must drive VREF+, which was
    off, so every conversion read 4095 and the DAC (earlier today) was scaled to a reference that did
    not exist. vref.c enables it; ANALOG_VREF_MV (2.5 V) replaces DAC_VREF_MV/ADC_VREF_MV and is
    verified by measuring VREF+ from the internal bandgap (2.505 V).
2026-10-01 Memory footprint history for the ADC inputs
2026-10-02 Closed-loop control: ADC DMA sampler, PID, target profile, live output, XREX-style commands
    Pure-logic controller (pid_core, feedback, target_profile, closed_loop) host-tested against simulated
    plants for both supplies; TIM6-triggered 7-channel ADC scan into DMA, its block interrupt is the control tick
    (verified 9,999/s); PFM_SOURCE_LIVE applies the controller's step each period; PID:/SOURce:/TARGet:/LOG:/
    CONFig: commands; OVP and feedback-clip faults; a firmware plant model for testing without wiring.
    VREF+ at 2.9 V. On-board outputs are blocked by a bench-side GateDriverStatus fault (PE0/PE8), see the changelog.
2026-10-02 Closed loop: bipolar feedback range (CONFig:FEEDback:RANGE), dead-feedback low-end clip fault, MAXVolts to 10000, closed-loop docs
    The Limiter's feedback divider puts -Vmax at 0 V and +Vmax at full scale, so the loop
    keeps all voltages in its own units. RANGE sets scale/offset in one command; an ADC
    reading at code 0 with a non-zero offset (a dead feedback line) now faults after
    CLIPTime. The earlier bench fault was miscabling; re-verified on the simulator.
2026-10-02 Closed loop: SOURce DAC hardware-in-the-loop feedback (plant model on DAC PA5, real ADC), DACRatio, first real-ADC run
2026-10-02 Loopback test source: duty measured on PFM_Input_01 (TIM2 PWM-input mode) drives the plant model, DAC and real ADC feedback
2026-10-05 HVPS loopback: measured carrier frequency drives the resonance model, DAC and real ADC feedback
2026-10-05 Saved profiles in the external flash: *SAV/*RCL/CONFig:PROFile:*, streamed shot/target/curve tables, power-fail-safe slots (steps 3-4)
    Ported from XREX and generalized (16 KiB copies, streaming writer/reader, product
    magic and flash region, printf-free float text). Settings and tables survive power
    cycles and firmware updates; design and XREX comparison in docs/saved_profiles.md.
2026-10-05 Shared profile code: neutral header, size-independent shared test, check_shared.py and the flash-map doc
    The store, flash driver and float text are now one piece of code with WHAM-XREX-PFMG474.
2026-10-05 Share the profile store and float formatter with WHAM-HBRIDGE-PFMG474
    Streaming writer/reader (header written last), config-driven copy size/region/magic,
    printf-free float text, shared test, check_shared.py and the flash-map doc. The format
    is unchanged: old and new stores produce byte-identical flash images.
2026-10-05 Record flash/RAM footprint for the shared profile store
2026-10-05 Record flash/RAM footprint for the shared SCPI layer
2026-10-07 Add front-panel LEDs: UART activity (timer + DMA turn-off) and operating-state indicators
    Pins PD2 TX, PD3 RX, PF14 IDLE, PF2 ARMED, PC3 FIRING, PC2 FAULT (pin map updated).
    State LEDs are driven only from SetState() in state_machine.c, so an LED is lit iff
    STATE? says so. Activity LEDs are pulsed by uart.c and switched off by TIM16/TIM17
    one-pulse timers raising DMA requests (DMA1 ch 7/8): no interrupt, no polling.
    DIAGnostic:LEDs? reads back the driven LEDs. Shared files are byte-identical in
    both repos (check_shared.py). Verified on the simulator board (HBRIDGE image).
2026-10-07 Record flash/RAM footprint for the front-panel LEDs
2026-10-07 Design: device identity and the per-controller host service; hardware/ and host/ placeholders
2026-10-07 Device identity, step 1: read-only hardware ID (MCU UID, flash unique ID), SYS:ID?, SN=/UID= in *IDN? and the boot banner
    Shared byte-identical in both products (check_shared.py), host-tested, verified on the
    simulator board. Design doc updated: SYS: namespace, identity sectors below the scratch sector.
2026-10-07 Record flash/RAM footprint for device identity step 1
2026-10-07 Device identity, step 2: persistent serial and label in reserved flash sectors, SYS:SERial/LABel/ID:CLEar, provisioning tool and registry
    Also fixes the flash unique-ID read found wrong on hardware (the QUADSPI dummy-cycle field is
    5 bits: 32 wrapped to 0, so the first four bytes of the ID were junk).
    Shared byte-identical in both products; host tests include a power cut at every flash
    operation of an update. Verified on the simulator board (HBRIDGE image).
2026-10-07 Record flash/RAM footprint for device identity step 2
2026-10-07 Host service v1: wham_hub.py, one instance per controller (identity handshake, shared raw client protocol, JSONL log), systemd unit, example config
    Tested against a fake controller (19 host tests) and live against the simulator board through
    the tunnel, including a firmware update and reboot through the service.
2026-10-08 Add the hardware KiCad projects (V3, V4, V4 Rev2) without backups/caches; root .gitignore; note that this repo replaces the standalone ones
    Left out on purpose: KiCad backups and autosaves, production/backups, a 391 MB third-party document
    zip (over GitHub's file limit), and PFM-Controller_V4/PFMV4_Prelim_Files-main (undecided).
    Stops tracking .DS_Store.
2026-10-13 HBRIDGE: independent per-channel duty profiles and three closed loops (U on PA0, V on PA1, W on PB0)
    Open loop: SHOT:STEP takes one duty per phase (or one for all); the generator, the
    live step and the saved profile carry a compare per channel. Closed loop: three loops
    with their own mode, gains, feedback input and calibration, hold setpoint and target
    series (TARGet:STEP takes a voltage per phase); a run may mix closed and open phases.
    Saved profiles keep their old format when the phases are equal. Host-tested; not yet
    verified on hardware.
2026-10-13 HBRIDGE: per-channel profiles and three loops: docs, changelog, worst-case size test, Python port
2026-10-13 Verified per-channel profiles and three loops on the simulator board; SCPI error replies keep their line terminator when long (shared fix, both products)
    Hardware results are in the HBRIDGE changelog and command reference. The over-long-message bug
    was in the shared scpi_util.c; XREX gets the same file and a changelog note.
2026-10-13 Record flash/RAM footprint for per-channel profiles and the SCPI reply fix
2026-10-14 Harden wham_hub so each command gets exactly one reply routed to its sender, dead links, restarts, stalled clients and unidentified boards are handled, and access is limited to listed machines
2026-10-15 Key an unprovisioned board's log directory on its whole chip ID, not the lot digits boards of one batch share
2026-10-22 HBRIDGE: start a shot on a rising edge at PF15 (EXTI interrupt, shared start routine with FIRE), EXTernal:TRIGger commands and tests
2026-10-22 Rebuild the HBRIDGE image with the PF15 shot trigger; record its flash/RAM footprint
2026-10-23 Provision the ECH-HVPS board (WB-0001-8), add the fleet registry, rebuild the HBRIDGE v0.10 image
2026-10-29 HBRIDGE: CHARGE output, a 50 % square wave on PG0 (TIM20 CH1N) for the capacitor-bank charger, any state, v0.11
2026-10-29 Rebuild the HBRIDGE image with the CHARGE output (v0.11); record its flash/RAM footprint
2026-10-29 Hardware: KiCad updates to PFM-Controller V4 and Rev2 (schematic and board), and the downloaded PFMV4 preliminary files
2026-10-30 Operator UI: XREX loop-mode and PID gain controls, shot diagnostics, instant toggle feedback
    - XREX channel cards: open/closed loop toggle, Kp/Ki/Kd inputs, warning when
    closed loop has all gains zero (output sits at the 3 kHz floor), pre-ARM warnings
    - Shot reports explain a flat output, a channel not in the shot, dead feedback
    - A click no longer queues behind a long refresh: queries take the connection
    lock per command; toggles show the controller's OK immediately
    - Ignore harmless connection-reset errors from the browser closing keep-alives
    - Simulator and tests updated (38 pass)
2026-11-04 Name the three bench controllers; add hub configs and the administrator steps
    - Operator UI cards: WHAM-PFM-G474-XREX-CTRL / LMTR-CTRL / ECH-HVPS, with bridge IP, MAC and hub shown on each card
    - host/config/xrex-ctrl.yaml, lmtr-ctrl.yaml, ech-hvps.yaml (ports 5101/5102/5103); ech-hvps holds a placeholder host until its bridge is found
    - docs/bench_devices.md: devices, MACs, and the systemd steps the administrator on andrew must run
2026-11-04 ECH-HVPS bridge is 00:08:DC:74:8D:BB at 192.168.130.250
    The board behind it answers as WHAM-HBRIDGE-PFMG474 v0.10, SN=WB-0001-8, label ECH-HVPS.
    Hub config, UI card and bench_devices.md updated; the administrator step is now just to start the hub.
2026-11-09 Rebuild the HBRIDGE image from the committed tree; record its flash/RAM footprint
    Built from 70e1ac84 with a clean product folder, so *IDN? reports the commit
    without -dirty. Flash 107632 B, RAM 120088 B (the fault bypass added ~0.3 KB).
2026-11-09 XREX: poll Water/Temp/Enerpro like overcurrent; STATE? lists every measured fault (ACTIVE=)
    Gate-driver fault pins were evaluated only on an EXTI edge, at boot and in
    FAULT:CLEAR, so a pin already at fault level when a channel was enabled or
    armed was never seen. They are now polled from the main loop, PID_Update()
    and boot. STATE? while faulted ends with ACTIVE=<list> of every measured
    fault (new fault_mask module, host-tested).
2026-11-09 Rebuild the XREX images from the committed tree; record flash/RAM footprint for the fault polling
2026-11-09 Add the XREX command flowchart (HTML) and its generator
2026-11-09 XREX command flow: render on GitHub (standalone SVG + Markdown page); correct the fault-pin note
2026-11-09 Serial receive can no longer be switched off by an overrun (XREX and HBRIDGE); USART2 priority raised; DIAGnostic:UART?
    Found from the hub log of a LabVIEW shot: valid polls returned ERR 1 during FIRING (bytes lost), then the
    controller stopped answering while still transmitting. The HAL ends the receive on an overrun and nothing
    re-armed it. uart.c now counts errors, drops the partial line and re-arms (also from the main loop);
    USART2 priority 3 -> 2 on XREX (3 -> 1 on HBRIDGE).
2026-11-09 Rebuild the XREX (controller, simulator) and HBRIDGE images from the committed tree; record flash/RAM footprints
2026-11-09 XREX: capture the last refused line (DIAGnostic:UART:REJect?); line counters in DIAGnostic:UART?
2026-11-09 Rebuild the XREX images from the committed tree; record flash/RAM footprint
